miclle/cybertrack/artifact/README.md

# 制作过程与样机展示

33 张照片和 3 段视频，记录零件准备、台架接线、底盘装配、内部布线、头部安装和样机展示。另收录 1 张项目展示封面。最新视频可在 B 站观看，其余两段视频可在本页播放；点击图片可查看原图。

[项目封面](#项目封面) · [视频](#视频) · [零件与台架](#零件与台架) · [底盘装配过程](#底盘装配过程) · [内部布线与头部安装](#内部布线与头部安装) · [样机多角度展示](#样机多角度展示) · [返回项目首页](../README.md)

## 项目封面

CyberTrack 项目展示封面：履带机器人与泡泡

[查看原图](cybertrack-cover.png) · 1365 × 768 PNG

用户于 2026-10-31 提供，用于项目展示与 README 封面；按原文件保存，未裁切或重绘。该图单独作为展示素材，不计入下方 33 张制作照片；实物表现与验证依据见对应照片、视频及[工程记录](../docs/current-status.md)。

## 视频

### 最新样机演示 · 2026-11-01 收录

用户提供的 B 站视频原始文件，仅重命名；文件名中的日期为收录日期。

[在 B 站观看](https://www.bilibili.com/video/BV1BRx466E1b/) · [下载原始视频](cybertrack-prototype-demo-2026-11-01.mp4)

### 样机地面演示 · 6 分钟

样机在地面上的移动、转向与泡泡效果展示，完整时长 6 分 0.6 秒。

https://github.com/user-attachments/assets/127dc3f1-0a8f-4abf-b4e5-f43b6fe16fb7

[下载原始视频](cybertrack-prototype-demo-6min.mp4)

### 面包板与水枪台架 · 16 秒

面包板、供电及水枪支路的台架画面，完整时长 15.7 秒。

https://github.com/user-attachments/assets/1ba10a7c-4fc7-466d-b656-b33c0fb86081

[下载原始视频](breadboard-water-gun-bench-16s.mp4)

## 照片

照片编号是阅读顺序，不代表拍摄时间；原微信文件名中的时间不作为拍摄日期。

### 零件与台架

零件与工具、水枪模块、双电机台架，以及履带框架试装。

<table>
  <tr>
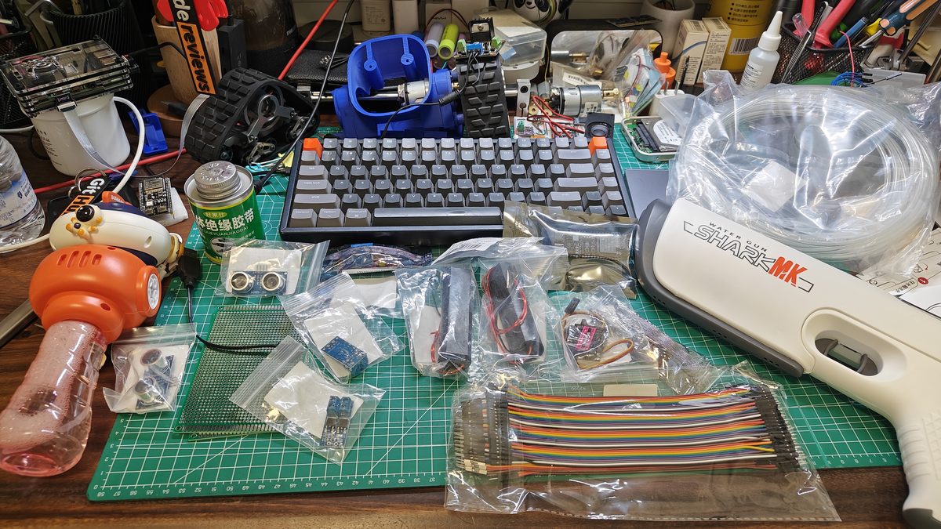
[picture p8: artifact/previews/01-parts-and-tools.jpg]
01 · 零件与工具
    <td width="50%" valign="top"><br>01 · 零件与工具</td>
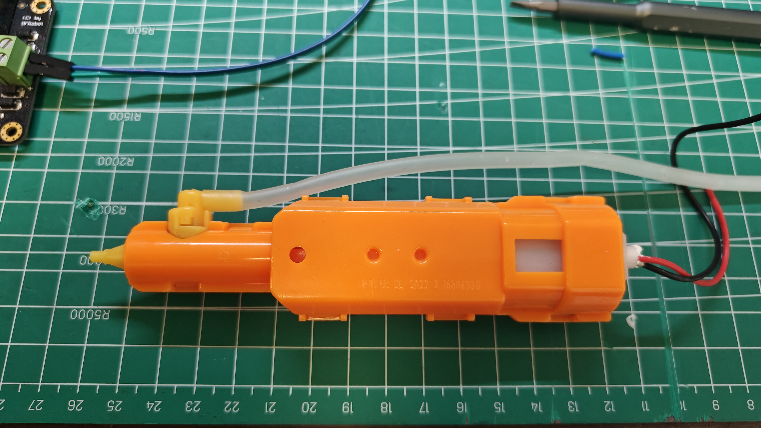
[picture p9: artifact/02-water-gun-module.jpg]
02 · 水枪模块
    <td width="50%" valign="top"><br>02 · 水枪模块</td>
  </tr>
  <tr>
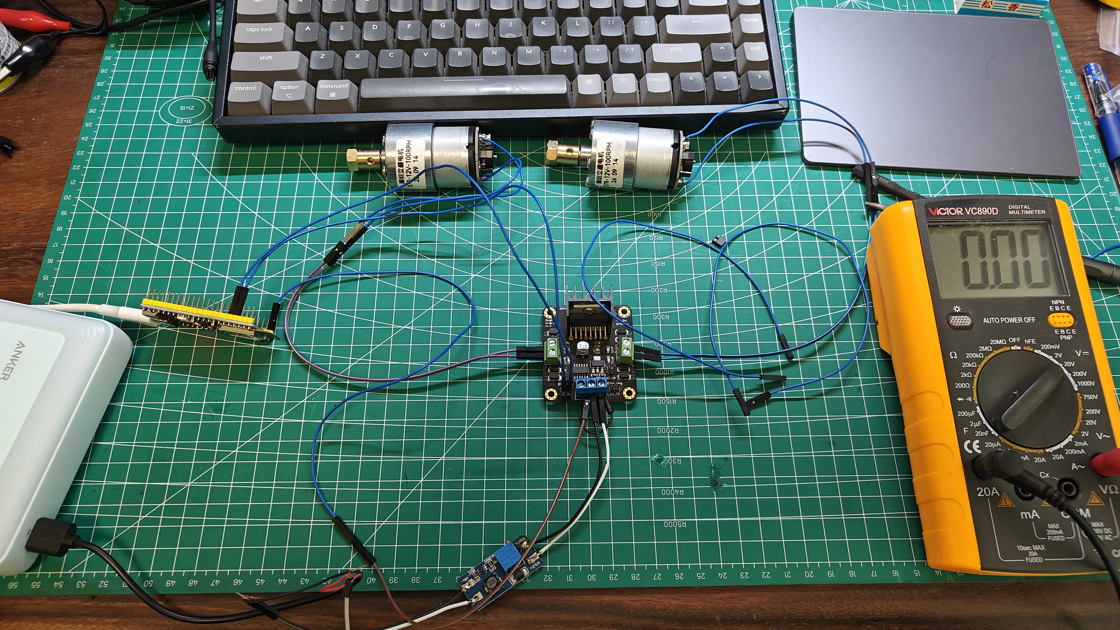
[picture p10: artifact/03-dual-motor-bench.jpg]
03 · 双电机台架接线
    <td width="50%" valign="top"><br>03 · 双电机台架接线</td>
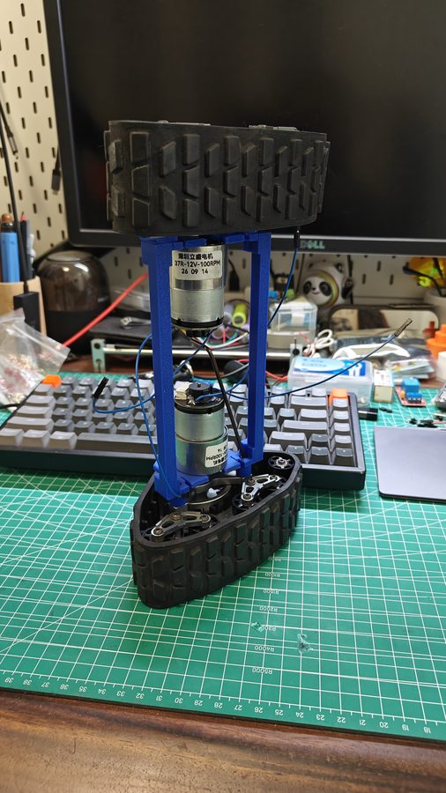
[picture p11: artifact/previews/04-track-frame-upright.jpg]
04 · 履带框架竖放
    <td width="50%" valign="top"><br>04 · 履带框架竖放</td>
  </tr>
  <tr>
    <td width="50%" valign="top"><a href="05-track-frame-top.jpg">05 · 履带与双电机俯视</a><br>05 · 履带与双电机俯视</td>
  </tr>
</table>

### 底盘装配过程

保留不同视角和连续装配步骤，展示底盘内的安装与接线过程。

<table>
  <tr>
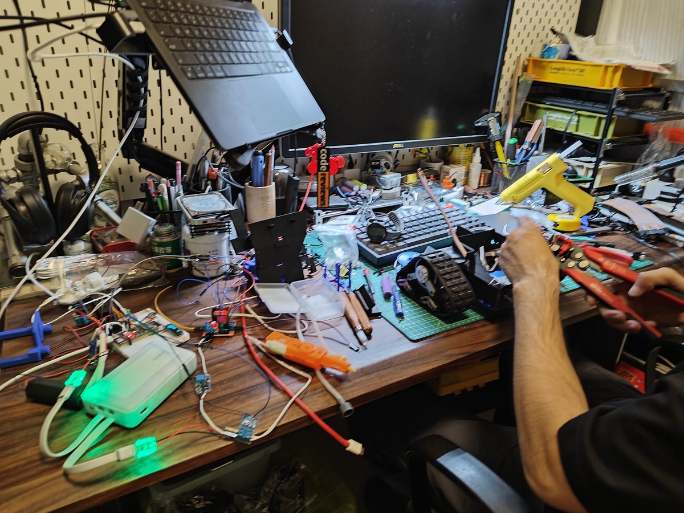
[picture p12: artifact/previews/06-chassis-assembly-01.jpg]
06 · 底盘装配过程 01
    <td width="50%" valign="top"><br>06 · 底盘装配过程 01</td>
    <td width="50%" valign="top"><a href="07-chassis-assembly-02.jpg">07 · 底盘装配过程 02</a><br>07 · 底盘装配过程 02</td>
  </tr>
  <tr>
    <td width="50%" valign="top"><a href="08-chassis-assembly-03.jpg">08 · 底盘装配过程 03</a><br>08 · 底盘装配过程 03</td>
    <td width="50%" valign="top"><a href="09-chassis-assembly-04.jpg">09 · 底盘装配过程 04</a><br>09 · 底盘装配过程 04</td>
  </tr>
  <tr>
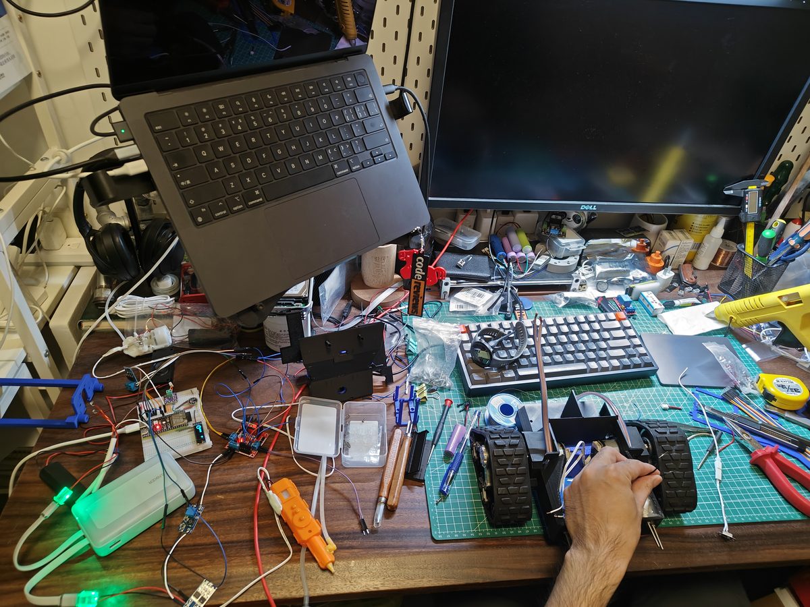
[picture p13: artifact/previews/10-chassis-assembly-05.jpg]
10 · 底盘装配过程 05
    <td width="50%" valign="top"><br>10 · 底盘装配过程 05</td>
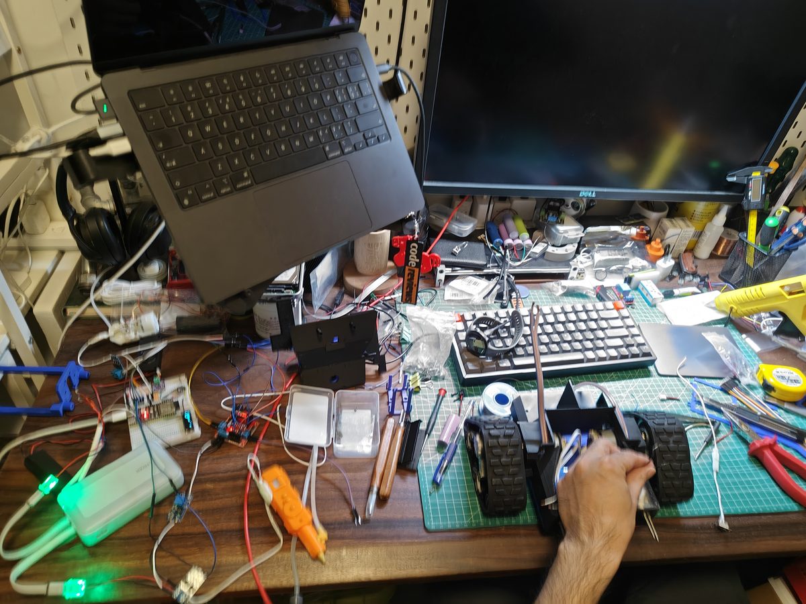
[picture p14: artifact/previews/11-chassis-assembly-06.jpg]
11 · 底盘装配过程 06
    <td width="50%" valign="top"><br>11 · 底盘装配过程 06</td>
  </tr>
  <tr>
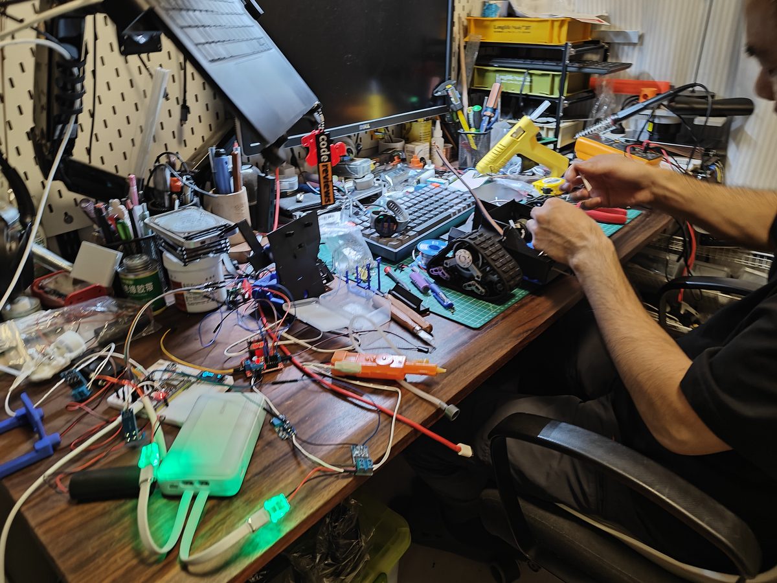
[picture p15: artifact/previews/12-chassis-assembly-07.jpg]
12 · 底盘装配过程 07
    <td width="50%" valign="top"><br>12 · 底盘装配过程 07</td>
    <td width="50%" valign="top"><a href="13-chassis-assembly-08.jpg">13 · 底盘装配过程 08</a><br>13 · 底盘装配过程 08</td>
  </tr>
  <tr>
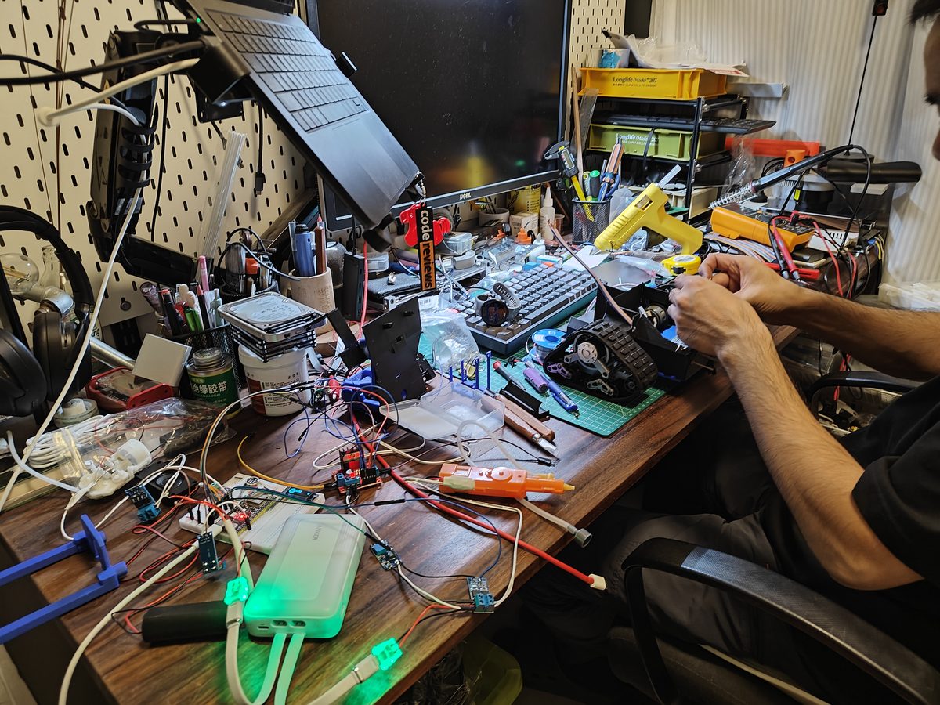
[picture p16: artifact/previews/14-chassis-assembly-09.jpg]
14 · 底盘装配过程 09
    <td width="50%" valign="top"><br>14 · 底盘装配过程 09</td>
    <td width="50%" valign="top"><a href="15-chassis-assembly-10.jpg">15 · 底盘装配过程 10</a><br>15 · 底盘装配过程 10</td>
  </tr>
  <tr>
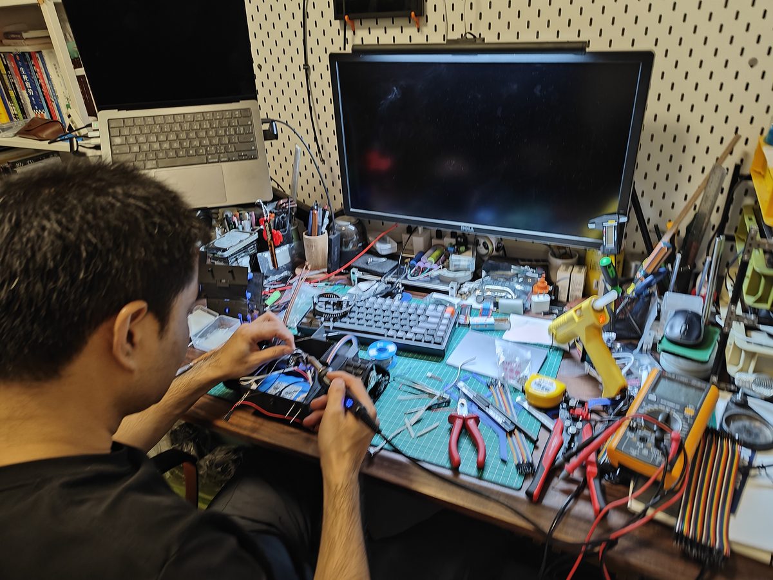
[picture p17: artifact/previews/16-chassis-assembly-11.jpg]
16 · 底盘装配过程 11
    <td width="50%" valign="top"><br>16 · 底盘装配过程 11</td>
    <td width="50%" valign="top"><a href="17-chassis-assembly-12.jpg">17 · 底盘装配过程 12</a><br>17 · 底盘装配过程 12</td>
  </tr>
  <tr>
    <td width="50%" valign="top"><a href="18-chassis-assembly-13.jpg">18 · 底盘装配过程 13</a><br>18 · 底盘装配过程 13</td>
    <td width="50%" valign="top"><a href="19-chassis-assembly-14.jpg">19 · 底盘装配过程 14</a><br>19 · 底盘装配过程 14</td>
  </tr>
  <tr>
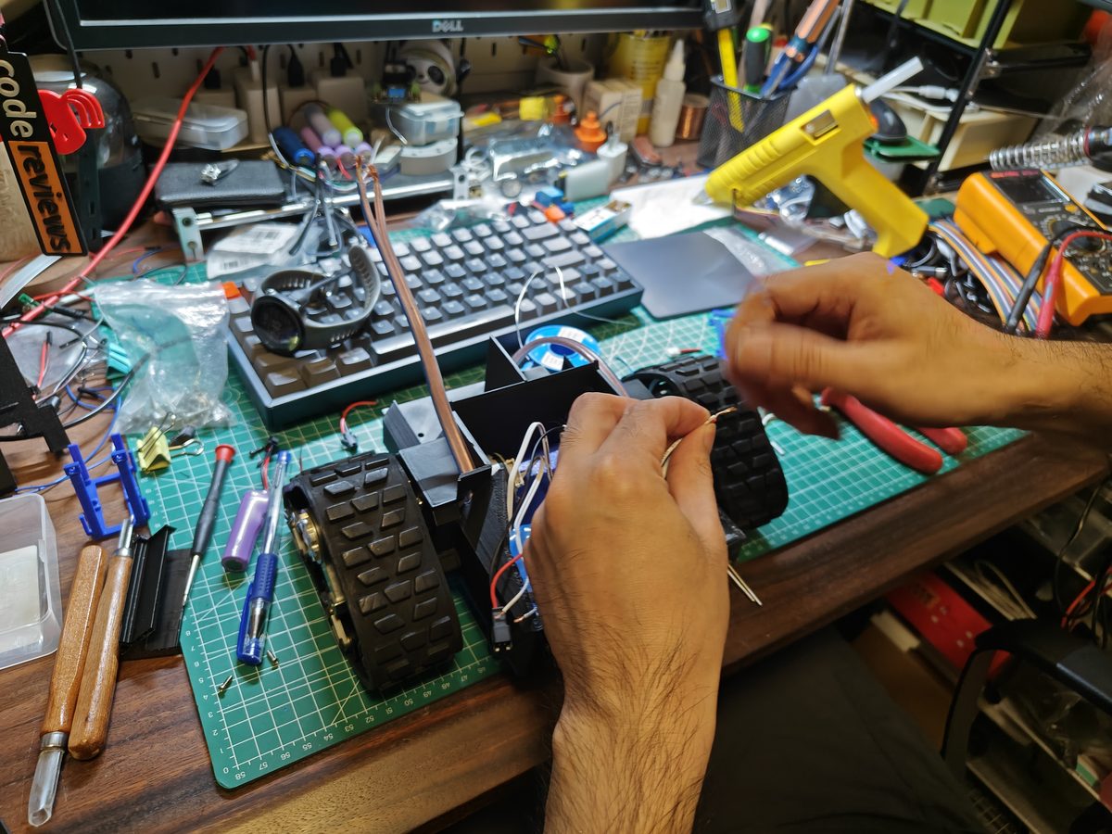
[picture p18: artifact/previews/20-chassis-assembly-15.jpg]
20 · 底盘装配过程 15
    <td width="50%" valign="top"><br>20 · 底盘装配过程 15</td>
    <td width="50%" valign="top"><a href="21-chassis-assembly-16.jpg">21 · 底盘装配过程 16</a><br>21 · 底盘装配过程 16</td>
  </tr>
  <tr>
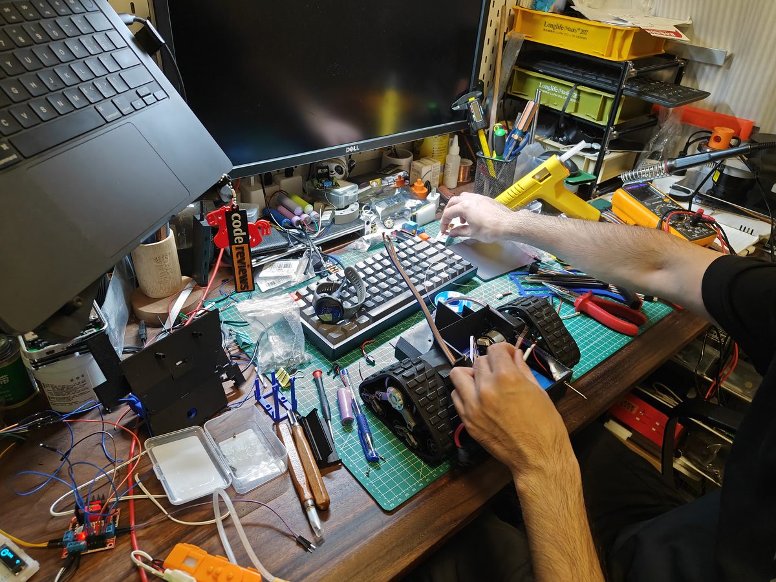
[picture p19: artifact/previews/22-chassis-assembly-17.jpg]
22 · 底盘装配过程 17
    <td width="50%" valign="top"><br>22 · 底盘装配过程 17</td>
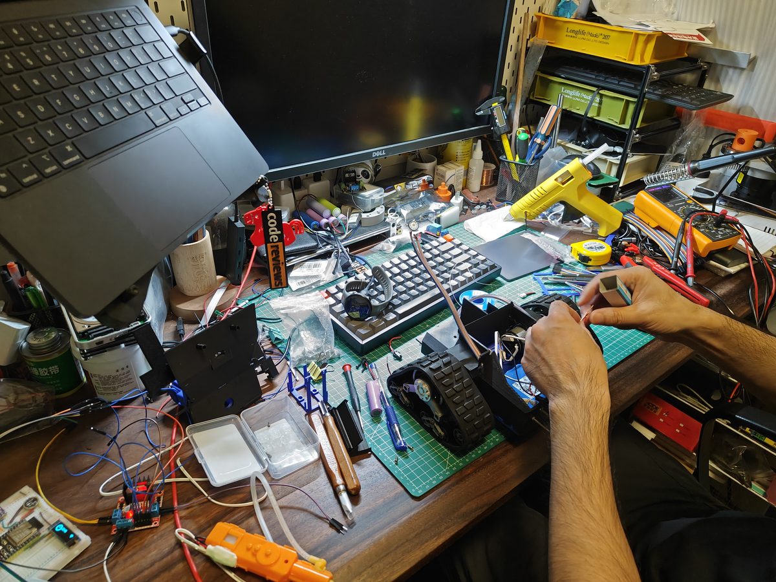
[picture p20: artifact/previews/23-chassis-assembly-18.jpg]
23 · 底盘装配过程 18
    <td width="50%" valign="top"><br>23 · 底盘装配过程 18</td>
  </tr>
</table>

### 内部布线与头部安装

底盘内部布线特写，以及头部面包板与扬声器的安装位置。

<table>
  <tr>
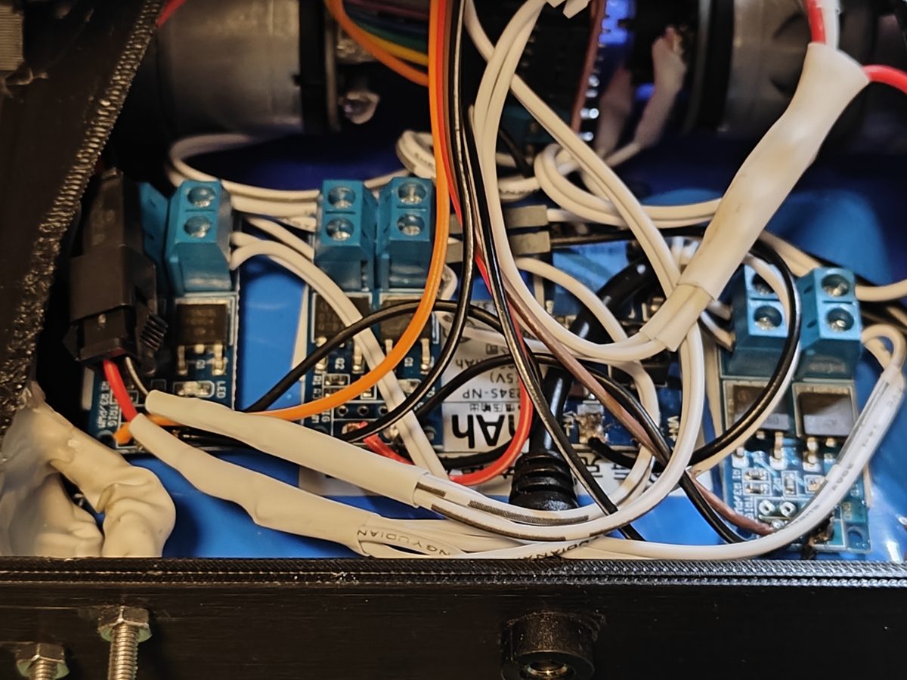
[picture p21: artifact/previews/24-chassis-wiring-detail.jpg]
24 · 底盘内部接线特写
    <td width="50%" valign="top"><br>24 · 底盘内部接线特写</td>
    <td width="50%" valign="top"><a href="25-chassis-wiring-overview.jpg">25 · 底盘内部接线全貌</a><br>25 · 底盘内部接线全貌</td>
  </tr>
  <tr>
    <td width="50%" valign="top"><a href="26-head-breadboard-installation.jpg">26 · 头部面包板与扬声器安装</a><br>26 · 头部面包板与扬声器安装</td>
  </tr>
</table>

### 样机多角度展示

工作台与地面上的样机，从正面、两侧、背面和前上方观察整体布局。

<table>
  <tr>
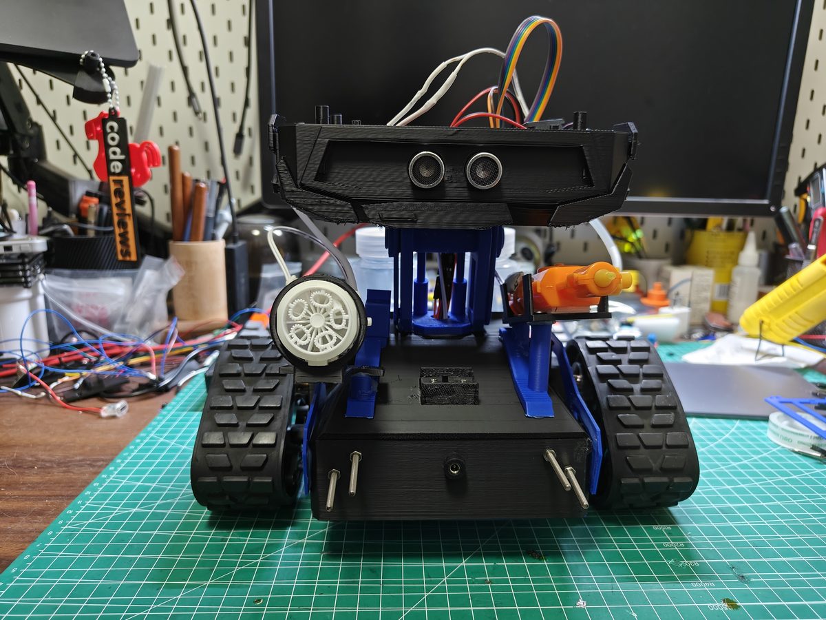
[picture p22: artifact/previews/27-prototype-front-workbench.jpg]
27 · 工作台样机正面
    <td width="50%" valign="top"><br>27 · 工作台样机正面</td>
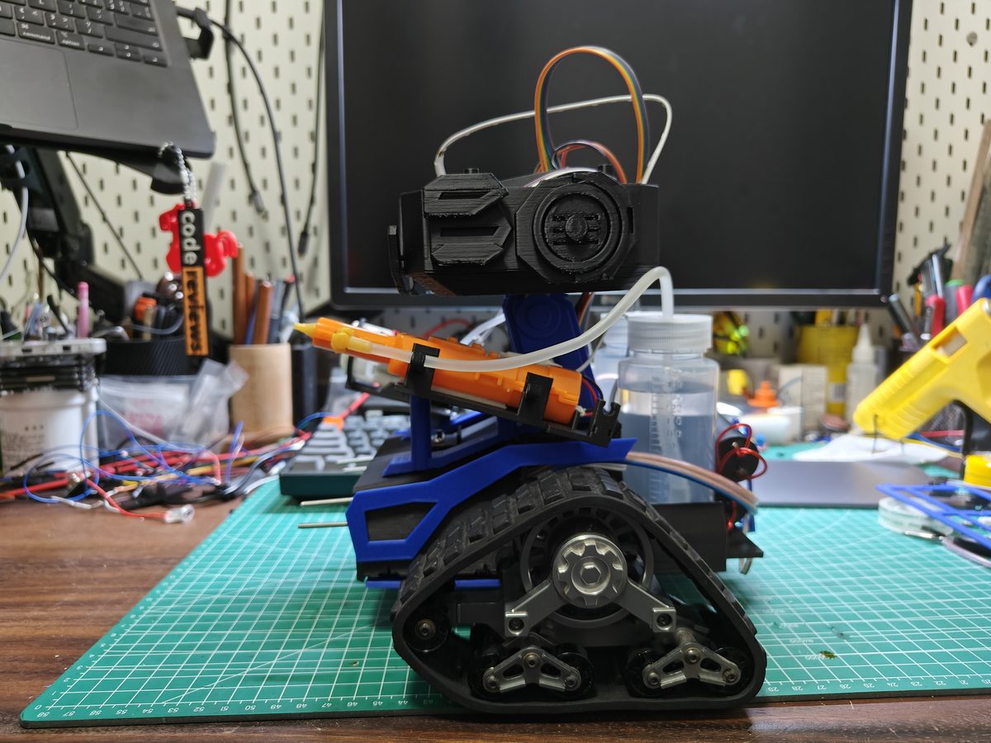
[picture p23: artifact/previews/28-prototype-water-gun-side.jpg]
28 · 样机水枪侧面
    <td width="50%" valign="top"><br>28 · 样机水枪侧面</td>
  </tr>
  <tr>
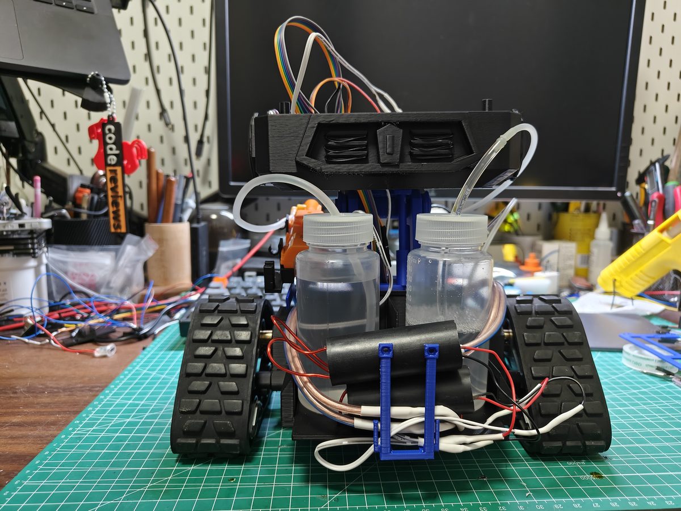
[picture p24: artifact/previews/29-prototype-rear-reservoirs.jpg]
29 · 样机后部双液体瓶
    <td width="50%" valign="top"><br>29 · 样机后部双液体瓶</td>
    <td width="50%" valign="top"><a href="30-prototype-bubble-gun-side.jpg">30 · 样机泡泡枪侧面</a><br>30 · 样机泡泡枪侧面</td>
  </tr>
  <tr>
    <td width="50%" valign="top"><a href="31-prototype-front-floor.jpg">31 · 地面样机正面</a><br>31 · 地面样机正面</td>
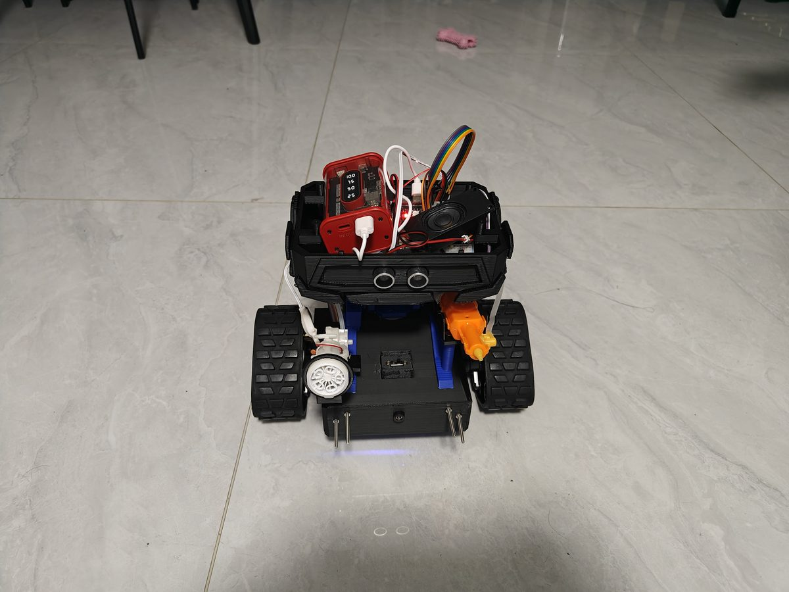
[picture p25: artifact/previews/32-prototype-front-high-angle.jpg]
32 · 地面样机前上方视角
    <td width="50%" valign="top"><br>32 · 地面样机前上方视角</td>
  </tr>
  <tr>
    <td width="50%" valign="top"><a href="33-prototype-rear-floor.jpg">33 · 地面样机背面</a><br>33 · 地面样机背面</td>
  </tr>
</table>

## 原始文件与展示副本

照片和三段原始视频内容保持不变。[素材清单](media-manifest.json)保留原文件名、新文件名、画面说明、字节数和 SHA-256，可回溯并校验文件。

页面使用 `previews/` 中的轻量 JPEG 预览图，按原比例缩至不超过 1200 × 900 像素，不裁切画面；点击预览图可打开原图。

两段播放器均使用 GitHub 附件，保持完整时长与音轨。长视频副本保留原 H.264 / AAC 流，不重新编码，只将 MP4 索引前置并将 H.264 level 标记从 6.0 修正为 3.1。短视频副本将 HEVC 转为 H.264，保留 1280 × 720 分辨率、30 fps 与原 AAC 音轨，并将 MP4 索引前置，以改善浏览器播放兼容性。

影像展示制作过程与当时样机表现；画面不能确定具体固件版本、供电配置、电流、温升或停止时延，不替代[项目验证记录](../docs/verification-plan.md)。
