miclle/cybertrack/firmware/README.md

# 固件

更新：2026-11-01。当前处于样机联调与整机验证阶段；面包板最新记录部署为 **`2.0.3-ct73`**，源码与应用版本一致。[ct73 部署记录](esp32-audio/startup-ct73.json)核对仅应用写入、配置保持、两次启动联网与输出全关，未启动执行器；真人语音、实际动作和整机负载待验。历史 ct21 的四方向反馈继续保留，不代替本轮验收。

当前面包板支持网页与语音控制、行走／喷水／泡泡／点火低压 MOS 四路独立控制、组合动作及狂暴模式；网页冲突优先，BOOT 与全部停止关断各路。电机为 60–100% PWM、默认 100%，左右桥映射为 B／左、A／右。功能与部署见[面包板工程](esp32-audio/README.md)、[局域网控制](../docs/lan-control.md)和[效果控制](../docs/effects-control.md)。逻辑状态不是执行器反馈；低压控制实现不代表高压、绝缘、液体共存或 EMC 验收。

当前功能、工程差异、模块职责、MCP 工具的入参／出参／错误、内部 C API 与板级回调见[固件能力与接口手册](CAPABILITIES.md)。使用时须核对具体工程与版本：当前面包板、历史独立台架与通用控制核心的同名工具、GPIO 和授权规则不能混用。

## 部署、台架与样机证据

| 范围 | 已有记录 | 尚未验证的边界 |
|---|---|---|
| 历史单模块与 ct2–ct6 台架 | 独立电机空载、MOS 五秒喷水；面包板语音状态／停止、喷水、四方向空载及 BOOT 停止，详见下文历史记录 | 旧版本、旧接线和旧电源结果不能直接作为当前整机验收；电流、定量温升、带载停止和失效行为仍需实测 |
| ct7 历史并发台架 | 行走与喷水组合及分开下令、两种独立截止顺序、BOOT 全停与语音停止均有回执和现场反馈，见[并发记录](../docs/validation/bench.md) | 断网现场测试延期；回执中的软件时长不等于实物停止时延，也不证明当前四路组合负载通过 |
| ct13–ct21 功能演进与部署 | 后续加入泡泡／点火、长按、狂暴模式；ct20 提高 PWM，ct21 修正左右桥映射。最新[软件检查](esp32-audio/verification-ct21.json)与[部署记录](esp32-audio/startup-ct21.json)分别保存 | 历史无负载或 HTTP 检查不能替代新占空比的速度、电流、温升及整机故障验证 |
| 当前样机运行 | 已有制作过程、样机实拍和约六分钟落地行走、转向、泡泡展示，另有喷水台架短片，见[影像记录](../artifact/README.md)；ct21 四方向正常另有用户反馈 | 视频未绑定完整固件／电源配置，不能据此确认全部验收项；机械停止距离、完整供电、连续运行、语音噪声及故障矩阵仍开放 |

当前电源基线为辰克 5 V 电池包及 12 V 升压电机支路，历史充电宝的电压／功率观察不沿用为新电源通过。2026-10-27 角色别名、纠错与静默执行规则已更新，真实语音回归仍待完成，见[角色维护与回归](../docs/agent-role.md)。分项证据与整机退出条件统一见[验证计划](../docs/verification-plan.md)。

## 工程范围与历史台架

以下通用核心及无负载工程独立维护；面包板已部署能力不代表通用核心的完整认证、持久化与板级适配已完成。

固件可与机械设计并行推进。当前已实现可在电脑上编译的 C11 控制核心、F1 离线 MCP 协议适配，以及 F2a 与板型无关的启动／运行层、输入处理、有界接收队列、分片／连接流程模拟和假板卡测试，已新增可烧录的[ESP32-S3 无负载检查工程](esp32/README.md)，复用控制核心验证启动与 PSRAM，并接入板载 BOOT 的无负载停止输入；该无负载工程不控制执行器；另见下文独立 MOS 台架的水枪单次实测。独立路线和退出条件见[实施计划](PLAN.md)，消息边界见[协议契约](PROTOCOL.md)，F2b 所需输入见[开发板资料清单](BOARD-INFO.md)。

无负载检查工程固定 ESP-IDF v5.5.1，主控已指定 ESP32-S3 N16R8，见[采购记录 P07](../hardware/procurement.md)。[COREBOARD 原理图、排针和尺寸](../hardware/components/ESP32-S3-N16R8/README.md)已整理；该无负载工程的实物修订版、焊装及后续完整板级适配仍待核对；面包板音频与执行器 GPIO 已在独立工程配置，不能照搬到本工程。Flash／PSRAM 已识别为 16 MB／8 MB，无负载配置为 Flash DIO 40 MHz、PSRAM Octal 40 MHz；具体实测结果见[实物核对](../hardware/components/ESP32-S3-N16R8/physical-verification.md)。

**历史台架（2026-10-25）**：[L298N 电机台架](esp32-motor-bench/README.md)升级为 `0.3.2-l298n-dual-10s`：A 路 GPIO4／5／6→ENA／IN1／IN2，B 路 GPIO7／8／9→ENB／IN3／IN4。`1`／`2`／`3` 选择 A／B／AB 后另发 a 和 f／r（AB 另支持 x／y 两种反向组合）；约 60% PWM，每次 10 秒，组间至少停 3 秒，s／BOOT 或任一路故障关闭两路；重启默认未选择。双路软件测试／编译通过，B 路接线及六脚静态关闭已获用户确认，此前 0.3.1 的 3 秒版 8 组空载组合已获用户确认：单路互不干扰、方向符合预期、正常停止且无异响或异常发热；随后一次双路 BOOT 提前停止及松开不恢复也获用户确认。0.2.1 两次 40%／10 秒反转均正常停止，第二次用户读到母线启动和运行约 12 V，见[40% 反转记录](esp32-motor-bench/reverse-40pct-verification.json)。60%／10 秒反转已获用户确认：启动和运行母线约 12 V，转动比 40% 更快、更顺畅，正常停止，无异响、异常发热或重启，见[60% 记录](esp32-motor-bench/reverse-60pct-verification.json)。电流／定量温升、扭矩及机械带载停止未验收。 用户已确认双路 60%／10 秒空载正转正常启停，启动、运行中及临近停止母线均约 12 V，电机和 L298N 无明显发热、无异响或其他异常；这是万用表读数与主观发热观察，电流和定量温升仍未测。

**历史台架（2026-10-24）**：新增[独立 MOS 台架工程](esp32-mos-bench/README.md)：GPIO4 持续高电平单次 5 秒（0.1.1，用户要求延长），串口 a／g 触发、s／BOOT 停止；主机策略测试和 ESP-IDF 编译通过，已烧录并在引脚空接下取得一次命令及关闭回执。与电机工程互斥使用 GPIO4；用户已观察控制端 0 V→约 3 点几伏→0 V，并确认一次 5 秒正常喷水及自动停止。带载参数、重复性与失电／复位边界仍待验证。

## 本地编译与验证

要求 C11 编译器、CMake ≥3.16，运行测试另需 Python ≥3.9。JSON 解析器已随源码固定版本保存，构建无需联网或硬件。在仓库根目录执行：

```sh
cmake -S firmware -B build/firmware-host -DCMAKE_BUILD_TYPE=Debug
cmake --build build/firmware-host
ctest --test-dir build/firmware-host --output-on-failure
```

Clang／GCC 可在首次配置时加 `-DCMAKE_C_FLAGS='-fsanitize=address,undefined -fno-omit-frame-pointer'`。构建输出位于已忽略的 `build/`；测试使用虚拟时间，不等待真实动作时长。测试记录见[主机验证](tests/README.md)。仅编译 C 库时使用 `-DBUILD_TESTING=OFF`，无需 Python。

## 通用控制核心已实现的边界

本节描述 `src/` 的通用核心。单活动槽位与本地使能契约不用于概括当前面包板的四路并行行为。

- `include/cybertrack/control.h` 与 `src/control.c`：`BOOT → DISARMED → READY → ACTIVE`，停止／故障进入锁定状态；上电无输出，本地使能后才能提交动作。
- 行走、水枪、泡泡共用一个活动槽位，不排队、不组合；本地期限到达时撤销逻辑输出。停止幂等；松开停止或故障消失都不会自行恢复动作。
- 会话断开／替换撤销使能；活动中断线锁定故障。校验动作类型、方向、速度档、时长、会话、序号、开始执行期限及计时溢出；时钟回退撤销输出。
- 限制值为零即能力不可用。测试数值仅为合成用例，不是台架建议值，也不构成可用的硬件配置。
- `include/cybertrack/protocol.h` 与 `src/protocol.c`：MCP 封装、初始化／发现／调用、严格 JSON 参数校验、有界原响应缓存、模拟传输会话与新鲜度门槛。停止优先于缓存及动作时效检查；远程接口不能使能。新解析与缓存重读内存失败会撤销逻辑输出、保留原缓存并要求本地重新使能，已通过逐次分配失败注入。
- `include/cybertrack/runtime.h` 与 `src/runtime.c`：启动先关断、单轮本地事件优先、周期时限与输出应用、条件喂狗、运行层错误锁定及响应抑制。板级回调契约与尚未验证项见[运行层](RUNTIME.md)；没有默认板型实现。

- `inputs.h`／`inputs.c`：逻辑输入去抖、停止／故障立即断言与已观察脉冲锁存；`inbox.h`／`inbox.c`：4 槽消息副本、原始元数据保持、断线优先及溢出关闭。详见[运行层契约](RUNTIME.md)。

- `link.h`／`link.c`：两层分片、连接与握手完成门槛、接收／发送超时、退避重连、发送失败关闭。通过假传输连接实际运行层，契约见[接收边界与连接流程](TRANSPORT.md)。

核心产生逻辑目标，独立协议层负责 JSON 解析，运行层通过板级回调应用目标；无负载检查工程已使用 ESP-IDF 时钟和 FreeRTOS 调度运行控制核心；该无负载工程仅 GPIO0 用作临时停止输入；通用核心的完整运行层、执行器 GPIO／PWM、网络鉴权尚未移植。左右轨道正值均表示车体向前，左转暂定左右反向原地转向；这是通用核心待板级验证的控制策略。通用核心速度档与实际 PWM、速度没有预设换算；面包板 ct21 的映射与四方向反馈见上文。

## 适配层必须遵守的接口契约

以下为通用核心的接入契约，真实认证与持久化后端仍待完成；面包板适配层的当前行为及限制见其工程文档。

1. 控制器由单一任务串行拥有；API 要求有效控制器指针，`ct_submit` 对空请求返回错误。中断和网络回调只投递事件；本地停止／故障事件先于正常动作处理，不能积压在音频或请求队列后面。硬件切断独立有效。
2. 使用本地单调毫秒时钟调用 `ct_tick`，每轮处理事件后应用当前输出；正常完成必须有周期调度，核心本身不创建定时器。最大调度间隔、输出写入耗时、任务卡死及看门狗行为在板级阶段验证，主机测试不能证明 ≤100 ms 停止延迟。
3. 自检成功后调用 `ct_boot_complete`。`ct_local_enable` 仅来自本地明确事件；物理停止持续按下或故障仍存在时禁止恢复。网络禁止调用使能 API。驱动输出失败应调用 `ct_set_fault` 并执行板级关断。
4. `session=0` 表示无连接。使用 `ct_protocol_open` 分配连接代次，`ct_protocol_close` 处理断线；切换时丢弃旧队列，不得把旧请求重新标记为新会话。离线测试可使用合成会话，不能因此放开真实设备。
5. `sequence` 为适配层分配的会话内严格递增序号，不等同于 JSON-RPC ID。F1 已按会话／ID 缓存原响应，重传不会再次提交核心；16 槽响应按 FIFO 淘汰，启动期过滤器跨重连保留，已淘汰／已记录的动作 ID 拒绝，停止仍有效。过滤器可能误拒绝新动作，不能通过清空记录恢复旧命令。跨复位接入必须在首个 CONNECT 前绑定[持久化存储](PERSISTENCE.md)，通过 logged 入口核验独立锚点和恢复日志，先保存 ID／会话、日志与锚点再使用；失败锁定动作，复位不恢复使能或输出。核心独立保留 `CT_REPLAY` 防线。只读／停止不再增加永久位；纯只读 ID 淘汰后可用于新意图。已有历史不可清位，离线迁移只向空白目标完整复制，见[容量策略](CAPACITY.md)；独立锚点控制后端原子切换并拒绝旧版本，见[切换契约](ATOMIC-SWITCH.md)。
6. `expires_at_ms` 来自设备预先签发的窗口时间加 `max_queue_ms`；等于当前时间即过期，首次接收、出队或重试不得刷新。窗口同时绑定原始会话和使能代次，稳定意图 ID 独立于 JSON-RPC ID 并在动作前持久化，换 RPC ID 不能重放。`ct_action_proof` 默认全零；正式认证证据源尚未接入，该核心的真实动作不得开放。动作结束期限独立为接受时间加 `duration_ms`。见[新鲜度与意图契约](FRESHNESS.md)。
7. JSON 类型和数值已在协议层先校验后转换，额外字段拒绝。通用接收队列已实现；独立状态／停止工程已接入 WSS 和平台令牌，动作认证新鲜度及完整硬件凭据保护仍待实现。接入必须遵守[协议契约](PROTOCOL.md)，不能从 JSON 接收可信元数据。
8. 使用运行层时，通过 `ct_runtime_step` 串行传递连接、断线、消息或空闲事件，不绕过运行层直接改动控制器／协议。只有该轮返回 true 后才能发送响应；返回 false 表示运行层已锁定，需处理故障并重新启动。看门狗和物理切断不能由本轮回调成功替代验收。

后续板级工程记录构建环境、依赖版本、板型、电源与引脚映射、编译／烧录／恢复命令。模块职责见[架构](../docs/architecture.md)，平台工具边界见[灵矽接入方案](../docs/architecture.md)。面包板已实现经授权的点火低压 MOS 控制；高压接线、通电及安全验收不由这些软件记录覆盖，边界见[效果控制](../docs/effects-control.md)。

通用核心尚缺的板级输入补齐期间，可按[离线工作清单](PLAN.md#不依赖实物的后续工作)继续推进。解析资源故障、接收边界／连接模拟和长时会话压力验证已完成。跨复位持久化接口与掉电模拟也已完成；命令新鲜度窗口及跨会话意图策略已完成离线测试；独立锚点、原子后端切换与回滚拒绝已完成主机模拟；[本地维护恢复](RECOVERY.md)可转移锚点对应的完整历史，当前快照缺失时可用[独立日志](RECOVERY-LOG.md)恢复精确匹配锚点的完整历史，领取尝试前的过渡日志使候选准备期间也保持恢复证据；首次登记、带日志切换及日志恢复先写目标证据再选择，尚未打开会话或写首份过渡记录时也可恢复，无完整证据时继续锁定；新增[四槽日志冗余](REDUNDANCY.md)，以双份精确证据覆盖单槽损坏及轮换中断，冲突或无当前证据仍锁定；后续接入服务端认证与稳定意图映射、真实存储与锚点驱动及升级迁移契约；音频／升级故障模型按输入条件推进。

## 历史记录：灵矽联网与面包板 ct2–ct5

2026-10-24 新增[独立 ESP-IDF 联网工程](esp32-linx/README.md)，完成设备绑定、WSS／MCP 发现及状态／停止真实调用；[实测记录](../docs/validation/bench.md)包含回执和证据边界。0.1.0 阶段没有动作或音频能力，原 MOS 台架工程单独保留。0.2.0 新增独立的本机单次授权水枪通道，正式核心动作仍关闭；已完成 5 秒自动停止、BOOT 提前停止及松开不恢复的带载功能检查，未开放自主动作或音频。

面包板的[适配层](esp32-audio/README.md)保留“小D”的原语音、OLED 与绑定。ct2 状态／停止语音联调已通过；ct4 增加 GPIO18 五秒输出并取消逐次按键授权，BOOT 仅停止。功率断开信号检查与带载结果分开，此前未喷水已定位为控制端两线接反，用户纠正后反馈测试正常；带载 BOOT 提前停止及松开不恢复已获用户确认，见[面包板喷水记录](../docs/validation/bench.md)。

2026-10-24 后续时长调整：面包板 ct5 改为按用户指定时长执行，单次最多 30 秒，保留 BOOT／语音停止及断线关断；明确要求喷水但未指定时长时默认一次 1 秒，不循环补足超限请求。此调整仅适用于面包板，原固定五秒台架结果保留为历史证据；ct5 语音验证及 30 秒带载边界见[喷水记录](../docs/validation/bench.md)。

## 历史记录：面包板 ct6 集成

ct6 新增 L298N 双路四方向、1–3000 ms 限时／约 60% PWM，与原 GPIO18 水枪互斥；BOOT、停止与断线统一关闭。同板部署迁线及该阶段基本台架联调已完成，四方向空载、实喷启停与 BOOT 停止有该次现场和回执证据；双路通电分别动作无误动观察，收尾功率已断开。当时断网延期，反向互斥、故障边界、定量电气及整机带载尚未验收，见[接线与验证](../docs/validation/bench.md)。

ct6 的跨动作互斥已由 ct7 并行策略替代，约 60% PWM 已由 ct20 提高到约 80%；ct21 已取得装车后四方向正常的用户反馈。上述 ct6 待办属于历史快照，现行未验证项以上文及整体验证计划为准。
