miclle/cybertrack/firmware/esp32-audio/README.md

# CyberTrack 面包板：小D 语音与四路控制

**ct78 应用已部署：已移除泡泡剧场的草稿、编辑、确认、模板、离线排演与 compose 工具。** 语音组合动作、序列调度与停止保护保留。2026-11-03 已[仅应用烧录并核验](../../docs/validation/ct78-deployment.md)，线上角色未同步；下方旧版本段落保留当时证据，不代表现行接口。[本次验证](../../docs/validation/theatre-removal.md)

ct73 候选扩展四路组合／序列及既有别名的成功确认匹配，保留点火超限提示；十二条定向实际 STT 严格 10/12，五条成功组合新增抑制 277 包。70／87 原生夹具、18 组软件检查与完整构建通过，未部署。[范围与失败](../../docs/validation/four-lane-feedback.md)

ct72 候选补齐既有喷水／泡泡／点火别名及狂暴模式的成功确认播放，按通道独立时长核验；复用 88 条真实 STT 轨迹，仅新增抑制普通点火的 64 包，超限提示保留。未部署，规则分析播报仍待修。[范围与证据](../../docs/validation/effect-alias-feedback.md)

ct71 候选增加完整否定句写入拒绝和空闲草稿保护；活动／等待时始终保留全停，修正了按当前文本挡住迟到停止的初版。46 组普通／消毒器、24 次实际 STT 与最终兼容重放、十七组软件检查及构建完成，未部署。[边界与证据](../../docs/validation/negative-input-admission.md)

ct70 候选独立修复机器人 MCP 原始零字符截断，保留十二项工具、字符串步骤、角色及合法停止。16 组准入普通／消毒器回放、88 条历史请求兼容、十六组软件检查和完整构建通过；未部署。[范围与证据](../../docs/validation/mcp-raw-json.md)

ct68 候选增加基于本轮 STT 的泛化动作澄清门禁，拒绝可识别的首次猜测执行，保留草稿编排、查询、全停和可信网页；继续包含 ct67 相对改稿约束。公开工具与角色未改，未部署。[范围和验证](../../docs/validation/vague-action-admission.md)

ct66 候选同步完成 MCP 全停与回执，不留二次排队回调；分配回执失败时仍先关闭输出。公开工具与角色未改，最近部署仍是 ct45。[调度与验证](../../docs/validation/stop-dispatch.md)

ct63 候选扩展普通组合／序列及目标速度的成功确认播放匹配，只有完整原话、参数和成功回执一致才抑制音频。已有 STT 事件回放抑制 216 个新增确认包、保留 397 个状态／否定／澄清包；未部署。[验证与范围](../../docs/validation/plan-feedback.md)

ct62 候选按识别输入代际阻止失败后的自动动作重试／补做，停止与查询保留，新输入恢复；已完成构建与主机回放，未部署。[验证与边界](../../docs/validation/voice-input-guard.md)

ct46 增加短指令成功播报控制、设备状态解释和改稿前读版本检查。[构建与软件证据](verification-ct46.json) · [隔离平台验收](../../docs/validation/lingxi-ct46.md)

**2026-11-01 ct77 已部署：** [普通测距滴声连续确认](../../docs/validation/range-beep-confirmation.md)要求连续三个有效近距样本，过滤孤立／双样本跳值；停车仍立即响应，对话暂缓保留。已仅应用部署，用户已确认偶发滴声明显减少、效果可以。

**2026-11-01 ct75 已部署：** HTTP 控制在 cJSON 解析前复用原始零字符检查，补齐 Unicode 零转义截断缺口。旧版反例、实际 HTTP 原生回归与完整构建已留证；已完成[仅应用部署与无动作 HTTP 检查](../../docs/validation/ct75-deployment.md)，Wi-Fi／用户设置保持，PHY 校准及连接令牌变化单独记录；不修改语音或动作策略。见[校验说明](../../docs/validation/http-zero-admission.md)。

**2026-11-01 ct74 已部署：** 用户选择对话期间暂缓普通滴声、结束按实时距离恢复。普通提示改用独立 PCM、空闲入队与对话／语音包到来时取消，不清空或拒收云端语音；紧急停车告警仍优先。完整构建与音频原生通过；[仅应用部署](../../docs/validation/ct74-deployment.md)、ct73 回退核对、配置保持、两次启动与二十条零输出检查通过，现场听感和偶发滴声另验；见[策略与证据](../../docs/validation/dialogue-range-beeps.md)。

**2026-11-01 ct73 已部署：** 在用户切断执行器功率后仅写 `0x20000` 应用，保存经设备校验的 ct45 回退文件与配置备份；写入前后配置及非应用区校验通过，首启 NVS 仅 WebSocket token 更新，两个已存网络与用户配置保持。两次启动版本／联网、网页全文一致及二十条状态回读通过，零动作；全片读取超时不算完整备份。角色只读核对一致且未修改，实机带载和真人语音待验。见[部署记录](startup-ct73.json)和[验收入口](../../docs/validation/ct73-deployment.md)。

**ct43 历史引入、已随 ct45 部署：** 新增家长上手帮助与只读状态解释，保存最近一次适配器动作回执供网页和语音查询。不会新增启动或自动重试。线上回复另行验证，详见[功能与边界](../../docs/status-explanation.md)和[验证记录](verification-ct43.json)。

**2026-10-30 ct42 已部署：** 距离滴声只取决于新鲜有效距离，不受自动避障开关、前进锁定或行走状态影响；待机、后退和转向也会提示。40–50 cm（不含 50）每 800 ms 一声，小于 40 cm 每 400 ms 一声；至少 50 cm、无效或过期读数安静。自动避障仍默认关闭，只控制小于 15 cm 停前进／至少 20 cm 解锁。 已仅应用烧录、平台 5999 字符保存回读并重启联网；两组 Wi-Fi 和用户配置保持，启动仅刷新 WebSocket 会话令牌。两次开机均默认关闭，HTTP 开关两态通过；18 次有效测距、零驱动失败、零执行器启动，启动日志记录 2 次滴声播放事件。见[验证](verification-ct42.json)和[部署记录](startup-ct42.json)；实际听感、对话并发及停车距离分别验证。

**2026-10-30 ct41 已部署：** 网页新增默认关闭的“自动避障”开关，设备端状态 `proximity.auto_avoidance_enabled` 同时作用于网页、语音单项／组合及序列。仅开启时有效距离小于 15 cm 停止并锁定前进，至少 20 cm 解锁；关闭清除距离锁定但不恢复旧动作。测距和前进滴声保留。设置只保留本次开机，网页重连不重置，重启恢复关闭；本轮已仅应用烧录、平台保存回读并重启联网；两组 Wi-Fi 和用户配置保持，启动时仅 WebSocket 会话令牌刷新。 验证见[ct41 记录](verification-ct41.json)。

ct40 已完成完整编译和仅应用烧录：OLED 待机底行显示当前 `IPv4:8080`，对话结束后恢复；断网清除旧地址，重新联网更新。48 个锁定组件缓存已恢复并核验原哈希，选定 OLED 构建使用其中 47 个（排除仅供其他开发板使用的 image_player），ESP-IDF 为 v5.5.1。应用及非应用区域校验通过，首次启动后 61 条 NVS 记录、两组 Wi-Fi 和整个应用前区域逐字节保持。用户确认手机已能打开控制页面、屏幕 IP 显示正常，测试符合预期。此前网络不可用时进入配网模式，配置回读仍未变化；用户恢复原网络后重启，首次认证超时后自动重试连接第一组并进入正常待机，串口记录零启动／输出全关。语音结束后的地址恢复和反复重连稳定性待验证，见[验证](verification-ct40.json)和[部署记录](startup-ct40.json)。

ct39 已部署：100% 速度下未指定时长的左右转默认改为 880 ms，单项、组合和序列一致；指定／共享时长优先。平台保存回读、应用哈希、配置区保持和重启联网检查通过，启动数为 0；用户随后确认“880 ms 测试效果符合预期”，精确计时与完整语音回归仍待验证。见[验证](verification-ct39.json)和[部署记录](startup-ct39.json)。下方 ct38 的 900 ms 为历史记录。

ct38 已部署：100% 速度下未指定时长的左右转默认改为 900 ms，单项、组合和序列一致；指定／共享时长优先。平台保存回读、应用哈希、配置区保持和重启联网检查通过，启动数为 0；真人语音及实物转向计时待测。见[验证](verification-ct38.json)和[部署记录](startup-ct38.json)。下方 ct37 的 800 ms 为历史记录。

ct37 已部署：语音 100% 速度（含省略速度）的左右转，未指定时长时默认 800 ms，适用于单项、组合及序列每步；明确指定／共享时长优先。平台角色保存回读一致，仅应用烧录、配置区保持并重启联网；11 次状态回读输出全关、启动数 0。真人语音及实物转向计时待验证，见[构建验证](verification-ct37.json)和[部署记录](startup-ct37.json)。

ct36 已部署，将停止阈值改为小于 15 cm、解锁改为至少 20 cm；40–50 cm 每 800 ms 一声，15–40 cm 每 400 ms 一声，近障碍停止后只响三声。见[规则](../../docs/ultrasonic-ranging.md#ct3615-cm-停止阈值)和[验证](verification-ct36.json)。已仅应用烧录并保持配置区、平台角色保存回读一致后重启联网；11 次有效测距、无驱动失败、执行器启动数为 0，设备返回 150／200 mm 阈值，见[部署记录](startup-ct36.json)。2026-10-30 用户确认提示音和距离阈值调整“测试效果符合预期”，已记录于部署文件；定量停车距离及专项回归仍分别记录。

ct35 已部署，将距离语音改为前进时的短提示音：40–50 cm 每 800 ms 一声，30–40 cm 每 400 ms 一声，小于 30 cm 立即停前进并响三声后安静。待机、后退、转向不持续提示；35 cm 解锁不续走保持。已仅应用烧录、配置区保持；平台角色保存并重新打开逐字一致，随后设备重启联网。启动后 11 次测距均有效、驱动失败数及执行器启动数均为 0，见[部署记录](startup-ct35.json)；实机听感待验证。见[规则](../../docs/ultrasonic-ranging.md#ct35前进距离提示音)及[验证](verification-ct35.json)。

ct34 已仅应用部署并保持配置，复位启动后连续有效测距，驱动失败数及执行器启动数为 0；见[部署记录](startup-ct34.json)。本版增加测距冷启动等待、具体故障阶段与 1–8 秒退避恢复；初始化或接收超时不再直接结束任务。清理失败保留资源并明确报告，避免不安全复用。软件验证见[ct34 记录](verification-ct34.json)，一次用户确认的冷上电复测已通过，8 次有效测距且无驱动失败／重启，见[记录](cold-start-ct34.json)；用户随后确认电脑 USB 与独立电池均多次重新上电且测距正常（用户反馈，未逐轮采集遥测），详见[故障与恢复契约](../../docs/ultrasonic-ranging.md#ct34冷启动故障诊断与局部恢复)。角色源和网页布局保持 ct33。

ct33 已部署，配置区保持、平台角色保存回读并重启联网，执行器启动次数为 0；见[验证](verification-ct33.json)与[部署](startup-ct33.json)。新增本地 50／30 cm 提醒和前进保护，覆盖语音、网页和动作序列；声音由独立任务播放，控制任务不等音频。原始有效读数参与判定，35 cm 解锁且不自行恢复。见[规则与验证](../../docs/ultrasonic-ranging.md#ct33本地距离提醒与前进保护)。

2026-10-29 用户确认当前测距与网页优化“测试效果符合预期”，记录于 [ct32 现场反馈](startup-ct32.json)。下方各版本的待测说明保留其当时状态；本次整体反馈不代替电平、测距精度或干扰的定量验证。

**ct32 组间距与底部停止栏已部署（2026-10-29）：** 滑块标签改为“设定速度”；喷水／泡泡／点火／狂暴模式组间增加随窗口高度变化的间距，组内按钮保持。全部停止与状态提示固定在底部并适配安全区，以实际底栏高度为内容预留空间。320×568、375×600、390×667、390×844、1280×720 检查均无滚动条和底栏遮挡；极矮窗口仍可自然滚动。网页回归、构建及应用部署通过，配置区保持、板端页面一致、执行器启动数为 0，见[验证](verification-ct32.json)与[部署记录](startup-ct32.json)。

**ct31 紧凑控制页已部署（2026-10-29）：** 顶部四路固定名称，下方单行仅保留方向／剩余时间、持续、冷却或故障，移除重复动作名称和网页／语音来源。喷水、泡泡六键各排一行；行走速度仍在方向键左上角，测距移至右上角。按可用高度压缩间距，触控区域至少 44 px；320×568、375×600、390×844、1280×720 模拟窗口均无横向／纵向滚动条，320×568 的待命与移动高度一致。不隐藏溢出，文字放大或极矮窗口仍可自然滚动。主机网页回归、构建、仅应用烧录、配置保持及板端页面核对通过，见[验证](verification-ct31.json)和[部署](startup-ct31.json)。

**ct30 距离显示精简已部署（2026-10-29）：** 距离栏仅保留“前方距离”和整数厘米（如 `176 cm`），移除下方说明及“约”前缀；没有有效数据、异常、过期或断线统一显示 `-`。保留 ct29 显示滞回、200 ms 轮询和 500 ms 新鲜度判断，原始测距与提示词不变。网页回归、构建、仅应用烧录、配置保持及板端页面一致性核对通过，见[验证](verification-ct30.json)和[部署记录](startup-ct30.json)。

**ct29 网页优化已部署（2026-10-29）：** 全页禁止选中文字和长按文字菜单；实际行走速度固定在前进键左侧、左转键上方，移除顶部标题中的速度数字。距离显示加入 2 cm 滞回与 350 ms 小变化更新间隔，变化达到 10 cm 立即更新；有效测距时空闲轮询改为 200 ms，异常／超过 500 ms 仍立即清空。控制驱动和 ct28 提示词保持。网页回归、双尺寸布局及构建通过；仅应用烧录、配置保持、网页与启动全关已核对，见[验证](verification-ct29.json)和[部署记录](startup-ct29.json)。手机实物长按及显示体验待用户复测。

**ct28 已部署（2026-10-29）：** 按用户指定的 3.3 V、IO1→TRIG、IO2←ECHO 实现头部测距、网页距离与语音状态查询，不做自动避障。已仅应用烧录、配置区保持、平台角色保存回读并重启联网；实时状态取得有效回波，网页与源码一致。未发送执行器启动请求，真人语音与距离精度待测。见[测距说明](../../docs/ultrasonic-ranging.md)、[验证](verification-ct28.json)及[部署记录](startup-ct28.json)。

ct27 速度控制：默认 100%、60–100% 指定速度、网页实时滑块，运行中语音目标调速，以及每次加减 10 个百分点；软件与构建已通过，提示词已保存回读，已仅应用部署并重启联网。见[速度接口与验证](../../docs/action-sequences.md#速度与时长)。ct26 为上一部署基线。

ct24 在 GPIO18 保留输出并启用输入回读；水路结束后串口 `WATER_PAD` 报告独立数字高低采样、与电机重叠时的采样及关闭电平。采样不改变动作策略，细节及测量边界见[诊断记录](../../docs/action-sequences.md)。现有 `physical_feedback=false` 仍表示没有执行器物理效果反馈；数字引脚读回不是水流或电压测量。

ct23 增加网页“左转＋喷水，各 3 秒”对照入口，调用现有组合 HTTP 接口；语音九工具、角色源、GPIO、230/255 PWM 和调度逻辑沿用 ct22。此版本提供同时启动的网页测试入口，未将现场不喷水问题标记为修复。见[动作序列与现场记录](../../docs/action-sequences.md)。

核对日期：2026-10-29。

**ct27 历史部署：`2.0.3-ct27`**。配置区保持、启动联网、GPIO18 空闲低电平和设备网页一致检查通过；闲置速度 80／60／100% 均接受，59% 拒绝，最终恢复 100%，执行器启动计数为 0。见[验证](verification-ct27.json)和[部署记录](startup-ct27.json)。ct26 滑块及语音加减速已由用户确认；ct27 用户反馈速度测试符合预期，移动中单独“全速”已由串口确认 60% → 100%、方向与原截止不变，见[现场回归](role-full-speed-ct27.json)。其余方向、停止／否定／查询等按分项证据验收。

**ct21 方向修正记录：** 2026-10-27 用户报告基本组装完成，前后正常、左右转相反。输出层将左右履带映射改为 B／左、A／右，保留每路正负极性、204/255 PWM 和逻辑方向语义；网页、语音、组合动作及狂暴模式共用修正。主机与构建结果见[ct21 验证记录](verification-ct21.json)，已仅应用烧录、配置区逐字节保持一致，启动联网与输出全关已核对，部署检查未启动执行器；见[部署记录](startup-ct21.json)。用户随后实测确认左转、右转、前进、后退均正常；该现场反馈不扩展为停止距离、电流和温升验收。

## 当前能力与验证范围

源码与最近记录的应用部署均为 `2.0.3-ct78`，仓库角色候选仍待同步，保留按已保存顺序连接 Wi-Fi，基于 `bread-compact-wifi`／`xiaozhi 2.0.3`，保留语音、OLED、唤醒、音量与说话按键。十一个 `self.tank.*` 工具为 `get_status`、`stop`、`move`、`water`、`move_and_water`、`bubbles`、`ignition`、`frenzy`、`sequence`、`adjust_speed`、`set_speed`，完整参数与状态见[当前接口手册](../CAPABILITIES.md#当前面包板-ct21-接口)。

| 功能 | 当前规则 |
|---|---|
| 前方测距与保护（ct42） | 3.3 V、IO1/TRIG、IO2/ECHO；约 100 ms 采样，500 ms 过期；不足 50 cm 独立滴声；停车开关默认关，开启时 15／20 cm 停前进／解锁，无自动绕行 |
| 行走／转向 | 按指定整数毫秒执行（1–2147483647 ms，协议范围）；默认 100% PWM（255/255），支持 60–100%，1 kHz；B／左、A／右；不提供距离或角度闭环 |
| 顺序与同时 | `sequence` 一次最多 16 步；一步内同时启动、各路独立截止，全步结束并满足间隔后下一步；整单验证，停止／断线／故障／网页抢占取消全部后续步骤 |
| 喷水／泡泡 | 各自定时 1–30000 ms；网页可按住持续，两路互不排斥 |
| 点火低压 MOS | GPIO21 一路控制两只模块，定时 1–5000 ms；关闭后至少间隔本次实际软件 ON 时长，无长按持续接口 |
| 网页与语音 | 自动连接，行走／喷水／泡泡长按独立续租，租期 600 ms、松开停本路；同通道网页优先，保留冷却；行走／喷水／泡泡停止后间隔 200 ms |
| 狂暴模式 | 网页与语音均支持，总时长 1–30000 ms；左转、喷水、泡泡持续，点火最多一秒脉冲与等长关闭间隔；全部停止、BOOT、来源会话失效、断网或故障取消 |
| 反馈与重放边界 | 回执为逻辑状态，`physical_feedback=false`；音频会话内共享 128 个动作 RPC ID，不承诺跨重启持久化防重放 |

当前已基本打印、装配并进入样机联调，[制作与运行影像](../../artifact/README.md)展示落地行走、转向、泡泡及独立喷水台架。ct7 两路并发台架和 ct21 四方向现场反馈已完成；视频没有绑定完整固件／电源配置，不能替代当前四路组合负载、停止距离、电流、定量温升、持续运行或完整断网／复位／OTA／看门狗故障验收。辰克 5 V 电池包与 12 V 升压支路须单独验证，旧电源和 60% PWM 结果不沿用。点火低压软件实现不代表高压、绝缘、液体共存或 EMC 通过；真人口述狂暴模式及最新角色别名／静默规则仍待验证，见[整体验证计划](../../docs/verification-plan.md)与[角色回归](../../docs/agent-role.md)。

ct22 软件验证见[验证记录](verification-ct22.json)。唯一角色源已压缩至平台 6000 字符限制内（5401 字符），保存、重新打开回读一致；设备在保存后重启至 ct22 并联网，真人语音回归仍待执行。PWM 从 204 提至 230 为本轮实现选择，新档位与长时行走的实际速度、停止、电流及温升尚未验证。序列契约和用户示例见[ct22 说明](../../docs/action-sequences.md)。

## 历史部署与阶段记录

以下按版本保留当时行为和证据；其时限、接线候选和未完成描述只适用于相应阶段，当前规则见上表。

**ct20 历史部署：`2.0.3-ct20`**。用户反馈移动偏慢，电机 PWM 由 154/255（约 60%）提高为 204/255（约 80%），频率仍为 1 kHz；前进、后退、转向及狂暴模式共用该值。状态 `logical_outputs.left/right` 同步为 −80/0/80，表示方向与标称占空比，不是实测速度。停止、超时、冷却和失租规则保持。新占空比的实机速度、电流和温升待验证；历史 60% 结果不沿用为 80% 验收。

ct20 主机回归与 ESP-IDF 完整编译通过，见[验证记录](verification-ct20.json)。已仅应用刷写、配置区逐字节保留，启动联网、网页内容与最终输出全关已核对，见[ct20 部署记录](startup-ct20.json)。

**ct15 历史手机布局基线**。针对手机竖屏压缩状态区、方向键和区块留白，保持按钮至少 44 px；在 412 × 800 等五种模拟视口下全页无溢出，见[ct15 部署记录](startup-ct15.json)。仅样式与版本变更，控制逻辑沿用 ct14，手机刷新显示待现场确认。

**ct14 历史功能与无负载验证**。喷水、泡泡各有 1／3／5／10／30 秒和按住持续共六个按钮，三路长按可并行，松开仅停本路。泡泡定时及语音上限为 30 秒；当时点火保持 5 秒／间隔 3 秒，间隔规则已由 ct17 替代。ct14 已仅应用刷写、平台保存回读，实机 HTTP 双路长按超过 30 秒、独立松开／失租与网页操作通过，见[部署记录](startup-ct14.json)。

**ct13 历史部署**。新增泡泡 GPIO17 和双点火共用 GPIO21，两路各最多五秒，四路可独立并行；见[ct13 效果控制](../../docs/effects-control.md)。2026-10-25 已仅应用刷写、保留配置并同步平台角色，见[ct13 部署记录](startup-ct13.json)。以下 ct12 操作说明保留：打开网页自动连接、长按显示计时，没有接管／释放按钮或组合开关；行走和喷水独立、网页与语音并用，冲突网页优先，两路停止后均间隔 200 ms。部署与验证见[局域网控制说明](../../docs/lan-control.md)。

此适配层用于现有 `bread-compact-wifi` 面包板，基于本机已验证的 `xiaozhi 2.0.3`。已完成历史联调的 `2.0.3-ct6` 将双路 L298N 电机与 GPIO18 水枪接入同一灵矽设备，保留语音、OLED、唤醒词、音量和触摸说话按键。用户已确认迁至同一块面包板；已完成仅应用刷写、启动联网及平台角色同步，见[部署记录](startup-ct6.json)；迁线及基本台架四方向／喷水／BOOT 联调已完成，当时实际装车方向标定、断网及完整供电／故障验收尚未完成；ct21 后续已取得装车四方向正常反馈，其余未验证项保留。接线、分阶段检查与最新状态见[电机／水枪集成](../../docs/validation/bench.md)。旧 ct4／ct5 水枪实测保留在[喷水记录](../../docs/validation/bench.md)。

**ct7 历史并发部署**：用户已要求行走和喷水可同时进行。该版本为 `2.0.3-ct7`，独立计时／冷却，增加 `move_and_water` 同时启动工具；BOOT 和停止仍全停。ct7 已仅应用刷写、平台角色回读并重启联网，核心并发台架回归与断功率收尾完成，完整供电／整机验收仍待完成；软件与部署证据见[并发动作说明](../../docs/validation/bench.md)。上段 ct6 及以下历史验收不能替代 ct7 并发实测。

## 来源与配置证据

普通多 Wi-Fi 的本地配置入口为 `secrets/wifi.json`，格式、校验和导入方法见[多 Wi-Fi 配置](../../docs/wifi-configuration.md)。`prepare.py --wifi` 是可选构建入口；填写文件后仍需重新构建和刷入设备。2026-10-30 已部署 `2.0.3-ct39-wifi-order3`，按保存顺序尝试；第一组手机热点已两次连接成功，中间一次认证阶段超时后成功回退第二组。两组配置回读匹配，最终连接第一组，见[构建验证](verification-ct39-wifi-order3.json)和[部署记录](startup-ct39-wifi-order3.json)。热点反复重连稳定性仍待验证。

- 上游：[`78/xiaozhi-esp32`，`e8ed16bb42ed9b199cbc9376011653e5037de8d8`](https://github.com/78/xiaozhi-esp32/tree/e8ed16bb42ed9b199cbc9376011653e5037de8d8)。
- 本机原构建 ELF SHA-256：`f7e8809ce981ee4182fb6c3eb15b20aa785111c7f1e4b1e2f059e4debc813b45`，与面包板完整 Flash 中的应用描述一致；原 `xiaozhi.bin` 的 2,531,056 bytes 也与备份 `0x20000` 起的数据逐字节一致。
- 原 `sdkconfig` 固定在 `sdkconfig.baseline`，其有效配置与 ct2 构建逐项比较无差异；ct3 至 ct6 仅在导出源码配置中将 tick 改为 1000 Hz、任务看门狗改为 2 秒及 panic；原依赖版本在 `dependencies.lock` 中。使用本机原组件缓存的独立副本，避免下架组件引起依赖升级。
- ESP-IDF v5.5.1；ESP32-S3 N16R8；SSD1306 128×32；独立输入／输出 I2S；输入 16 kHz、输出 24 kHz；原唤醒模型保留。
- 原上游 checkout 及其中已有 Kconfig 修改没有被改动。源码导出和构建都在本仓库忽略的 `build/` 下进行。

## GPIO 配置

音频引脚来自原镜像对应的板级源码与配置，执行器引脚来自当前输出驱动；桥身份和完整接线未独立逐线测量，不能以软件配置代替电气验收。

| 用途 | GPIO |
|---|---|
| 麦克风 WS／SCK／DIN | 4／5／6 |
| 扬声器 DOUT／BCLK／LRCK | 7／15／16 |
| OLED SDA／SCL | 41／42 |
| 板载 LED | 48 |
| BOOT：本地停止 | 0 |
| 水枪 MOS TRIG/PWM（ct3 起） | 18 |
| 泡泡 MOS（已部署；有出泡影像，逐线核对及完整电气验收待完成） | 17 |
| 双点火共用 MOS（低压控制已部署；接线与高压验收待完成） | 21 |
| L298N A：ENA／IN1／IN2（ct21 映射右轨） | 8／9／10 |
| L298N B：ENB／IN3／IN4（ct21 映射左轨） | 11／12／13 |
| 按住说话按键 | 47 |
| 音量增加／减少 | 40／39 |

**GPIO4 已被麦克风占用，不能照搬水枪板的 GPIO4 接线或固件。** ct3 取消 BOOT 原对话／启动配网回调，由独立任务读取。待机时先语音唤醒建立会话，明确口述喷水和时长即可请求一次最长 30 秒输出。BOOT 按下即取消／停止，松开不恢复；新的语音指令可在按键释放及冷却结束后再次启动。独立功率切断仍须保留。

上游示例 `LampController` 会占用 GPIO18 并注册开灯工具。本适配不实例化它，ct2 替换为两项 CyberTrack 工具；ct3 由受限喷水任务使用 GPIO18，音频与显示板级定义保持原样。

## ct2 历史工具语义

- `self.tank.get_status`：读取本板 CyberTrack 控制核心的逻辑状态。初始 `DISARMED`；能力全部关闭，`physical_feedback=false`、`actuator_backend=not_installed`。
- `self.tank.stop`：在同一个序列化主任务内调用 `ct_stop`，进入 `FAULT/stopped` 并清除逻辑输出；重复调用仍保持锁定。不终止 TTS、不禁用屏幕，不声称实体停止或已控制另一台设备。
- 两项工具只接受空参数；额外参数在执行前拒绝，schema 标明 `additionalProperties=false`。不提供 GPIO、喷水、行走、泡泡或重新使能工具。
- 回执带本板 MAC、随机启动标识、单调递增请求序号及运行时间，便于对照平台真实工具调用。状态不会在重新开始对话时自动解除停止；重启后仍为不可动作的 DISARMED。
- 复用 `firmware/src/control.c`，通过 `apply_overlay.py` 复制到临时构建目录，不另写一套动作状态机。

## ct5 历史工具语义

- `self.tank.water` 只接受整数 `duration_ms`，范围 1–30000 ms；不再暴露 permit，不要求长按 BOOT。必须是明确的喷水指令；状态查询不会喷水。角色将秒数转换为毫秒，超过 30 秒按 30 秒执行并说明；明确要求喷水但未说明时长时由角色填写 1000 ms，不追问、不沿用历史请求。工具参数仍必须显式提供 duration_ms，固件不自行补默认值。固件拒绝零、负数、非整数和超出 30000 的参数，不自动分段。
- `get_status` 与 `stop` 只接受空参数。状态报告本板水枪逻辑输出，`local_authorization_required=false`、`physical_feedback=false`。主动停止为 `STOPPED/fault=stopped`，不是硬件损坏；故障仍为 FAULT。
- 复用 `esp32-linx/main/water_policy.c` 的截止与冷却策略，新增 `water_request_timed` 接口允许 1–30000 ms；原 `water_request` 的固定 5000 ms 行为不变，授权函数仅在本地请求执行时原子调用，不作为用户操作门槛。`water_guard.h` 校验网络接收时的就绪状态，并为队列创建内部票据；停止、BOOT、断线取消所有待执行票据，超过 5 秒未执行的请求拒绝。
- 同一音频会话最多记住 128 个喷水 RPC ID，重复 ID 拒绝，不逐出旧 ID；表满拒绝进一步喷水，新会话重新开始。内部票据跨会话不复用；不宣称跨重启持久化防重放。
- 独立优先级 10 控制任务每 5 ms 检查 BOOT、连接与期限。截止由本次 duration_ms 决定，上限 30000 ms，活动时不续时，结束后冷却 1 秒。BOOT 释放需稳定 30 ms；松开或恢复网络本身都不启动动作。
- 停止在网络接收时立即关断，再通过主任务返回回执。已检测的 Wi-Fi／WebSocket 断线、复位与升级均关闭输出。活动输出期间控制任务不进行显示、日志、网络或堆分配。

ct3 的逐次物理授权流程和 ct4 的固定五秒要求已被用户明确取消，历史结果保留在[喷水验证记录](../../docs/validation/bench.md)。用户已确认控制线纠正后喷水测试正常，带载 BOOT 提前停止及松开不恢复也已确认。上述结果属于 ct4 五秒配置；ct5 已通过功率断开的 1／7 秒及 40 秒请求限为 30 秒的语音核验，用户确认音频／屏幕正常，不能推导 30 秒带载已通过。真实断网故障矩阵、独立硬件切断和完整供电验收仍未完成，软件输出回执本身不证明有水流。

## ct6 历史工具与统一控制

- 新增 `self.tank.move({"direction":"forward","duration_ms":1000})`。方向仅接受 `forward/backward/left/right`，整数时长 1–3000 ms，固定 1 kHz／8 bit duty=154（约 60%）。角色默认一秒，超三秒请求三秒并说明；不把距离或角度换算成时间。A 候选左、B 候选右，正负极须按车体前进方向核对，当时不是实车标定；ct21 已修正为 B／左、A／右并取得四方向正常反馈。
- `self.tank.water` 保留 1–30000 ms，未说时长填 1000；工具描述与角色统一。两类动作互斥，共用 128 项会话 RPC 记录、内部票据与截止时间；接受一个动作即取消其他已排队票据，忙碌请求不延迟补做。
- `self.tank.stop`、BOOT、已检测的 Wi-Fi／会话断开、重启／升级入口同时撤销两类动作和待执行票据。BOOT 松开稳定 30 ms 后也不恢复；ct6 原电机停止后冷却 3000 ms、喷水停止后 1000 ms；ct12 将面包板两路统一为 200 ms，必须另有新指令。
- GPIO8–13 为 ct6 的面包板分配，后续部署沿用，与独立台架 GPIO4–9 不同。LEDC timer 2／channel 2、3 避开上游 LED／背光的 timer 0、1／channel 0；原 I2S、OLED 与 GPIO18 不变。
- 切换方向前先关闭两路使能及水枪；任何 GPIO／PWM API 错误锁定 `output_fault`，尝试关闭全部输出并将使能重置为普通 GPIO 低，不自动重试动作。
- 控制任务维持优先级 10、5 ms 周期，活动循环没有显示、网络、日志或堆分配。LEDC API 使用带优先级继承的互斥锁串行化，避免在自旋临界区调用可能取 RTOS 锁的驱动。
- 四工具共用状态：`logical_outputs.left/right` 为 -60/0/60 的逻辑方向与标称占空比，`water` 独立布尔值；`move_direction` 为当前方向或 `none`。`remaining_ms` 和 `last_duration_ms` 对应共享动作，`starts_this_boot` 计两类动作；`max_duration_ms=30000` 保留水枪上限，`move_max_duration_ms=3000` 为电机上限。无编码器、水流或物理停止反馈。
- 网络参数严格拒绝缺参、额外参数、非法方向、非整数值与越界时长。动作只有内部 `result=accepted` 才算接受；硬件 API 失败返回 `output_fault`，接受后尚未应用就被本地条件取消返回 `cancelled_before_output`。上游 MCP 外层成功不足以判定动作成功。

## 重现构建

2026-10-30 已恢复本机 ct40 环境，可直接复用导出源码进行增量构建：

```sh
export PATH="/Users/miclle/.espressif/python_env/idf5.5_py3.13_env/bin:$PATH"
source build/toolchains/esp-idf-v5.5.1/export.sh
idf.py -C build/xiaozhi-ct40-src -B "$PWD/build/firmware-ct40" build
```

恢复来源为固定上游提交与仓库锁定的组件哈希。下架的 `image_player 1.1.0~1` 后续从上游历史、原发布清单与 manifest 重建并通过完整哈希核验；它只用于未选中的 `esp-hi`，本次已完成的 OLED 构建未引用它。恢复后的完整缓存位于 `build/xiaozhi-ct40-src/locked_components/`，构建记录见 `verification-ct40.json`。本次没有导入 Wi-Fi 文件；直接使用设备已有配置并保留连接顺序。`prepare.py` 的无 `--wifi` 路径也应用顺序补丁，不重写 NVS。

以下原始导出流程仍需原 ELF 及其组件缓存：

源码导出使用支持 tarfile data filter 的 Python（历史构建使用 3.14）；ESP-IDF 仍固定 v5.5.1。需保留原始源码 checkout、原构建 ELF 及组件缓存；不要求联网下载替代版本。`prepare.py` 要求一个尚不存在的导出目录（默认 `build/xiaozhi-audio-src`，可用 `--target` 指定），不会覆盖已有导出或修改原 checkout。

```sh
# 先激活 ESP-IDF v5.5.1 的 Python 环境与 export.sh。
python firmware/esp32-audio/prepare.py /path/to/original/xiaozhi-esp32 --target build/xiaozhi-ct21-rebuild-src
sh firmware/esp32-audio/test.sh
node firmware/esp32-audio/tests/web_ui_test.mjs
python firmware/esp32-audio/tests/run_mcp_tests.py --source build/xiaozhi-ct21-rebuild-src
python firmware/esp32-audio/tests/run_display_tests.py --source build/xiaozhi-ct21-rebuild-src
idf.py -C build/xiaozhi-ct21-rebuild-src -B "$PWD/build/firmware-ct21-rebuild" build
```

上述目录是重新导出的示例名称，须确保尚不存在；实际版本由 `apply_overlay.py` 设置，本次文档同步未重新构建或烧录。

应用分区是 `ota_0`，起点 `0x20000`、大小 `0x3f0000`，与水枪台架分区不同。更新前需核对设备 MAC、分区表、OTA 选择及已有备份；已有 ct21 部署仅写该应用，不执行完整 `idf.py flash`，不覆盖引导、NVS、OTA 数据或 8 MB assets。

## 验证与观察

`test.sh` 运行 ASan／UBSan 主机检查，验证 ct2 只读核心，以及 ct5 可变时长启动、截止边界与非法时长拒绝、忙碌／冷却拒绝、BOOT／停止取消排队请求、断线、复位、重复 RPC、队列过期和时钟故障。ct7 覆盖独立并发计时／冷却、组合原子拒绝、同路排队取消、另一通道输出连续性，以及实际输出类全部初始化／组合状态转换 API 单故障注入。`run_mcp_tests.py` 从已导出源码提取实际 MCP 校验块，使用 ESP-IDF cJSON 检查参数边界。当前脚本还覆盖四路效果、会话／租约及狂暴模式；ct21 软件报告记录了 56 个输出状态与故障矩阵、网页脚本、MCP／HTTP 检查和 ESP-IDF 构建通过，见[报告](verification-ct21.json)。以上是对应报告的历史测试结果，本次未重跑；不能代替实物停止或完整端到端语音验收。

`monitor.py --port <设备串口> --log build/audio-private/session.jsonl` 只监听和筛选 CT_AUDIO 回执、运行状态及少量启动信息，不发送串口命令，不保存原始串口日志或录音。平台工具记录和用户现场音频／屏幕观察共同构成语音联调证据。详见[验证记录](../../docs/validation/bench.md)。

## 平台角色配置

灵矽智能体管理名称为“CyberTrack”（原名“彩菊”），助手昵称为“小D”；设备绑定沿用。角色介绍以仓库中的 [role-prompt.txt](role-prompt.txt) 为唯一维护源，用于灵矽角色配置的“角色介绍”字段，昵称使用 `{{assistant_name}}`。角色为机灵、友好、利落的 CyberTrack 机器人小助手，聚焦动作与状态，通常一句话回答；去掉“开启／关闭输出”等工程话术，不接明显的背景谈话，不展开无关话题。动作和停止成功后静默执行；仅超限调整、失败、拒绝或结果不确定时简短说明，唤醒与状态查询正常回应。动作别名与受限的“饭店→放电”纠错以角色源为准；均检查真实工具回执，未知能力不假装执行。音色和模型保持现有选择。平台提示保存后需重启设备生效；修改昵称不会更改固件唤醒词“你好小智”。提示词不是固件动作限制的替代品。

维护、平台同步、回滚和语音回归要求见[智能体角色与提示词](../../docs/agent-role.md)。不要在其他文档复制整份角色介绍；此处仅概述行为。

平台意图识别已由分离模式调整为统一模式，用于让聊天模型直接选择工具；原分离模式下泛称“查询状态”曾误选通用设备信息工具。统一模式下相同说法已正确调用 CyberTrack 工具，停止和停止后查询也已实测通过；详见验证记录。这是 ct2 阶段的有限样本结果，不保证所有表达方式。

## 历史网页与模式验证

ct8 当时的测试另覆盖网页租约／控制权、来源切换与语音防重放、短时动作窗口、HTTP Host／Origin／鉴权／限流／读取边界与发送失败释放，以及页面模拟设备交互。测试使用实际会话类、JSON 解析器和 HTTP 处理函数；HTTP 传输／显示由桩替代，不能证明真实 Wi-Fi、手机后台或声音连续性。见[当前记录](../../docs/lan-control.md)。

ct9 新增长按 15 秒的软件连续性、600 ms 截止、续租／松开乱序与重放、BOOT 期间不可签发动作窗口、滑出／指针取消／后台及在途请求取消。语音仍限三秒；长按持续带载与真实松开停止时延尚未验收。

## ct17 狂暴模式

历史版本 `2.0.3-ct17`。网页提供 5／10／30 秒模式，持续左转、喷水、泡泡和 1 秒点火／至少等长间隔，整体截止最多 30 秒；四路均就绪后整体启动，全部停止、BOOT、会话失效、断网及故障取消，不自动恢复。普通点火停止后也至少等待本次实际软件 ON 时长，替代历史固定三秒。ct17 当时未增加语音狂暴入口；ct18 随后增加 `self.tank.frenzy`。协议见[网页说明](https://github.com/miclle/cybertrack/blob/c25b0af729bd216b69779db2bba75f32f9475cdd/docs/lan-control.md#ct17-狂暴模式)，源码哈希、构建和主机证据见 [verification-ct17.json](verification-ct17.json)。

ct17 已仅应用刷写并保留配置；启动／联网、实际页面全文一致、能力字段、手机视口及最终全关／释放均已核对。该次部署检查的实机 `starts_this_boot=0`，未触发狂暴或点火，动作时序证据来自主机测试。见[部署记录](startup-ct17.json)。

## ct18 语音狂暴模式

历史版本 `2.0.3-ct18`，新增 `self.tank.frenzy`，默认五秒、单次最多三十秒，参数仅整数 `duration_ms`。与网页共用调度，语音连接关闭取消；网页心跳／释放不控制语音模式。票据重复、过期、取消或同路忙碌不补做，全部停止仍全关。验证与部署分别见 [verification-ct18.json](verification-ct18.json) 和 [startup-ct18.json](startup-ct18.json)。

ct18 已仅应用烧录、保留配置，并在角色保存后重启联网。启动日志含 frenzy 工具，实机状态包含模式来源／时长字段，页面与源码一致，最终全关并释放，动作启动次数为 0。该模式尚未完成真人口述或完整带载验证。见[部署记录](startup-ct18.json)。

## ct19 网页提示修复

历史版本 `2.0.3-ct19`。底部动作成功提示跟随设备最新状态更新，全部结束后显示“动作已结束。”，并行时显示仍在运行的动作；错误／停止提示不被普通轮询覆盖。该次变更的动作后端及角色源与 ct18 一致；后续 ct20／ct21 和角色更新见当前状态。

ct19 已仅应用烧录并保留配置，启动联网及实际页面与源码一致已核对，最终全关并释放。该次部署检查的实机没有启动执行器；四类按钮提示转换通过本地模拟设备浏览器验证，见[部署记录](startup-ct19.json)。

## ct33 补充验证

运行 `sh firmware/esp32-audio/test.sh`、`node firmware/esp32-audio/tests/web_ui_test.mjs`；导出工程后，再运行 `python3 firmware/esp32-audio/tests/run_mcp_tests.py --source build/xiaozhi-ct33-src` 和 `python3 firmware/esp32-audio/tests/run_audio_tests.py --source build/xiaozhi-ct33-src`。音频测试执行实际导出的方法，控制解码中途和播放排空的并发时序；实物声音、回波稳定性及机械停止另验。
