miclle/cybertrack/firmware/esp32-motor-bench/README.md

# L298N 双电机 GPIO 台架测试

核对日期：2026-10-27。本工程保留独立 COREBOARD 台架源码 `0.3.2-l298n-dual-10s`，下方烧录、供电状态和动作观察均为 2026-10-25 历史，不表示设备现在仍连接或处于该版本。现用面包板已部署 ct21，电机 GPIO8–13、80% PWM；不得套用本页 GPIO4–9。当前辰克电池、接线及未验证项见[电机台架记录](../../docs/motor-bench.md)与[面包板工程](../esp32-audio/README.md)。

2026-10-25 双路 10 秒命令已执行一次：用户确认上电、万用表准备好后，选 AB、使能并仅发一次 f（约 60% PWM）。主机命令到关闭日志约 10.09 秒，收到两路关闭回执，随后追加 s 再确认关闭；未见 BOOT、错误或重启记录。用户已确认双路 60%／10 秒空载正转正常启停，启动、运行中及临近停止母线均约 12 V，电机和 L298N 无明显发热、无异响或其他异常；这是万用表读数与主观发热观察，电流和定量温升仍未测。用户已断开 12 V、USB 保持连接，本次短时空载功能检查通过。见[运行及用户反馈记录](dual-10s-run-verification.json)。下方准备记录保留当时状态。

2026-10-25 双路 10 秒观察版准备完成：用户确认 12 V 断开、USB 保持连接；0.3.2 已通过主机 ASan／UBSan 回归与 ESP-IDF 编译，备份原应用后仅写入新应用，哈希校验通过。启动确认 60%／10000 ms，只发送 s 并收到 `DISARMED outputs=OFF target=NONE`，观察 5 秒无异常，串口保持连接。未发送选择、使能或动作命令，当时尚未执行双路 10 秒电压／发热实测，后续结果见页首。见[启动检查](startup-verification-dual-10s.json)。

当前源码版本 **`0.3.2-l298n-dual-10s`**，ESP-IDF **v5.5.1**，仅用于原 **ESP32-S3 N16R8／COREBOARD 台架板**。GPIO4／5／6 控制 A 路，GPIO7／8／9 控制 B 路；可单独选择 A、B 或 AB。当前所有动作均为 **1 kHz、约 60% PWM（154/256）、10 秒单次脉冲**，没有自动循环。当时按用户要求准备的 AB 双路正转已完成，结果见页首；此前 0.3.1 的 3 秒组合和 BOOT 实测单独保留，不与 10 秒结果合并为带载验收。

2026-10-25 双路 BOOT 检查：用户确认上电准备好后，只发送一次 a／f 请求 AB 正转（约 60%、最长 3 秒）。约 0.65 秒后收到 `DISARMED outputs=OFF target=AB BOOT held`，早于自动截止；松开回执仍关闭，之后超过 5 秒未重新使能，最后追加 s 并确认关闭。以上时间来自主机日志，不是物理停止时延；用户已确认两台在按 BOOT 后提前停止，松开后持续不转，无异常；12 V 已断开，USB 保持连接。本次双路空载 BOOT 提前停止／松开不恢复子项通过。见[本次 BOOT 记录](dual-boot-stop-verification.json)。

2026-10-25 已按用户授权发送一套 8 组组合命令（60% PWM、每组 3 秒），每组均收到关闭回执，最后另发 s 并确认两路关闭，期间未见 BOOT、错误或重启记录。串口观察的命令至关闭日志间隔约 3.01–3.04 秒，组间停顿超过 3 秒；不是物理停止时延测量。用户随后确认 12 V 已断开、USB 保持连接，8 组均正常：单路测试时另一台不转，各组转向符合预期，两台正常停止，无异响或异常发热。本次 60%／3 秒空载组合检查通过；当时双路运行电压、电流、定量温升未测；后续 10 秒电压观察见页首记录；随后完成的 BOOT 提前停止见页首记录；见[组合命令与回执记录](combinations-verification.json)。下方烧录准备段落保留当时状态。

2026-10-25 组合版本烧录检查：用户确认 12 V 断开、两台固定空载、USB 保持连接后，备份原应用并仅写入 0.3.1，哈希校验通过。串口确认 60%／3000 ms，只发送 s 并收到 `DISARMED outputs=OFF target=NONE`，继续观察 5 秒无使能或错误回执，串口保持连接。未发送选择、使能或动作命令；当时尚未执行组合动作，见[本次启动记录](startup-verification-combo.json)。

用户确认两台同规格 12 V、100 rpm 的 37R-520 已固定、输出轴空载、不安装履带，驱动 12 V 已断开。此前单路 200 ms 正转、40%／10 秒反转和 60%／10 秒反转有用户观察记录；这些与已完成的 0.3.1 双路短时检查均不证明双路 10 秒运行或机械带载能力通过。软件验证见 [verification-dual-10s.json](verification-dual-10s.json)，真实烧录／动作另记。独立台架不开放网络／语音，不适用于现有面包板，不冻结整机 GPIO。

2026-10-25 双路烧录检查：用户确认 B 路接线完成、旧 ENB 接地线移除、仅 COM USB 接通且 12 V 断开。仅应用烧录及哈希校验通过，启动为 0.3.0／60%／200 ms，唯一发送 s，收到 `DISARMED outputs=OFF target=NONE`；串口保持连接，未发送选择／使能／方向命令。当时未测六脚静态电压，见[历史启动记录](startup-verification-dual.json)。随后用户已确认六脚上电前后均近 0 V、两台始终不转，见[接线检查](dual-wiring-verification.json)；当时尚未进行 A／B 隔离和双路动作检查。

## 供电与跳帽

- 改线时断开驱动 12 V、ESP32 USB 和其他所有电源。运行时主控先启动、驱动最后上电；结束先断驱动，再拔 USB／复位／重新打开串口。
- **ENA、ENB 常高跳帽都取下**，控制线接实际使能信号针，不接另一侧 5 V 针。双路接线前必须拆掉旧单路方案中的 **ENB→GND 线**；若 IN3／IN4 之前接地，也先移除这些接地线。不能让 GPIO 输出与 GND 短接。
- 此用户实物的独立板载稳压跳帽保留，+12V 输入约 12 V，+5V 输出约 5 V 已获用户万用表观察。**+5V 留空，不接 ESP32 或其他电源**。这是本块板的空载检查，不替代整板额定和温升验证；新板不得只照方位猜接线。
- 建议在 ENA、ENB 各加 10 kΩ 外部下拉；没有外部下拉时，软件无法保证复位／下载／主控失电时低电平，不进行驱动带电的复位或拔 USB 测试。BOOT 是软件停止输入，不能替代独立切断 12 V。
- 动力回流从驱动 GND 直接返回升压电源，不经过 ESP32 排针、USB 或面包板。该轮使用旧充电宝＋MT3608 的 12 V 支路；当前已换辰克 5 V 电池包，仍保留升压支路，但需重新核对输入能力与负载表现。不提高母线补偿驱动压降。
- 只测试两台输出轴空载电机；编码器线分别绝缘、不接，其他执行器不接。该轮旧电源的 5 V／3 A 参数及升压功率预算不能证明双电机额定负载可用，也不适用于辰克电池，见[供电预算](../../docs/power-and-interfaces.md)。

## 接线表

ESP32 以 **GPIO 丝印**定位；下列 J1 编号仅对应[原板图纸](../../hardware/components/ESP32-S3-N16R8/README.md)，不是 GPIO 编号。GPIO8／9 不紧邻 GPIO7。

| ESP32／电源 | L298N | 说明 |
|---|---|---|
| GPIO4（J1-4） | ENA 信号针 | A 路 PWM |
| GPIO5（J1-5） | IN1 | A 路方向 1 |
| GPIO6（J1-6） | IN2 | A 路方向 2 |
| GPIO7（J1-7） | ENB 信号针 | B 路 PWM；拆掉旧 ENB 接地线 |
| GPIO8（J1-12） | IN3 | B 路方向 1 |
| GPIO9（J1-15） | IN4 | B 路方向 2 |
| ESP32 GND | 驱动 GND | 与动力电源负极共地 |
| 电机 A 两根动力线 | OUT1、OUT2 | 两端都不是固定地 |
| 电机 B 两根动力线 | OUT3、OUT4 | 两端都不是固定地 |
| MT3608 OUT+／OUT− | +12V／GND | 可直接切断 12 V；+5V 留空 |
| 电脑 USB | ESP32 COM USB | UART0，115200 baud |

接线完成后，先仅 USB 启动、驱动保持断电，检查 ENA、IN1、IN2、ENB、IN3、IN4 对驱动 GND 均近 0 V。确认后主控保持运行、两台电机固定且轴空载，再给驱动上电；两台均应保持不转，复测六个控制脚及 +5V。若任一电机自行转动，立即断开 12 V。用户在单路已测过的 ENB 接地状态，不能代替新 GPIO7 控制 ENB 的上电检查。

## 命令与 10 秒观察流程

| 单独发送的字符 | 行为 |
|---|---|
| `1` | 选择 A，撤销已有使能，不动作 |
| `2` | 选择 B，撤销已有使能，不动作 |
| `3` | 选择 AB，撤销已有使能，不动作 |
| `a` | 已选通道时打开 3 秒使能窗口；输出仍关闭 |
| `f`／`r` | 在使能窗口内启动所选通道，一次 10 秒、约 60% PWM |
| `x`／`y` | 仅 AB 已选且已使能时，x=A 正 B 反、y=A 反 B 正；其他选择拒绝并撤销使能 |
| `s`／按 BOOT | 同时关闭两路并撤销使能；松开 BOOT 不恢复 |

启动后 `target=NONE`，必须先选通道。选中的通道在正常停止后保留，但每次动作必须重新 `a`；重启后恢复 NONE。运行中收到通道选择、方向或其他非换行字符都停止两路，不执行切换；冷却至少 3 秒，期间请求不会排队。不能粘贴 `3af`，必须逐个发送并检查回执。

1. 驱动断电下打开串口，确认 `BENCH READY 0.3.2-l298n-dual-10s A=4/5/6 B=7/8/9 PWM=1000Hz/60% pulse=10000ms`。只发 `s`，应为 `BENCH DISARMED outputs=OFF target=NONE`。
2. 完成上述六路静态电压检查，接好并固定两台空载电机，主控稳定运行后再给驱动上电，两台均应不转。
3. 本次仅准备一次双路正转：单独发送 3、检查 target=AB，再单独 a、检查 ARMED，3 秒内发送 f；运行最长 10 秒。用户确认上电且两台不转后才执行，不自动重试或连跑全部组合。
4. 在 12 V 断开时将万用表置直流电压档，黑表笔接驱动 GND、红表笔接 +12V，固定表笔避免短路；记录启动、运行和临近停止的母线电压。观察两台转动、停止与异常，若有测温仪可记录驱动散热器及电机外壳运行前后的温度和环境温度。无温度数值时只记录主观异常，不能称为定量温升通过。两次动作之间至少停 3 秒且两轴完全停稳；实际重复前仍需结合温度和用户观察。无转动、错误通道、异响、掉压、重启或异常发热时立即停止并断开 12 V，中止剩余组。BOOT／s 同时停止两路；主机执行组序列时发现 BOOT、提前停止、错误、重启或回执缺失，应中止剩余组而不是重新使能。
5. 本次动作结束先断开 12 V，再处理 USB／串口；断电后再检查发热，避免接触运动件或可能烫手的散热器。10 秒空载观察不能证明热稳态或履带带载能力。固件自身只接受单次动作，不内置自动顺序循环。

下表仅为可用命令参考，不是本次自动执行顺序；所有动作键均已改为 10 秒上限。

| 编号 | 组合（电气方向） | 逐个发送 |
|---|---|---|
| 1 | A 正，B 停 | 1 → a → f |
| 2 | A 反，B 停 | 1 → a → r |
| 3 | A 停，B 正 | 2 → a → f |
| 4 | A 停，B 反 | 2 → a → r |
| 5 | A 正，B 正 | 3 → a → f |
| 6 | A 反，B 反 | 3 → a → r |
| 7 | A 正，B 反 | 3 → a → x |
| 8 | A 反，B 正 | 3 → a → y |

`f` 对所选桥分别设置 IN1/IN2 或 IN3/IN4 为 1/0，`r` 为 0/1；未选桥保持禁用且方向输入为 0。AB 的 f／r 取相同电气方向，x／y 取相反电气方向；是否对应机器人前进或转向取决于安装与接线，当前不声明车体方向映射。两路 PWM 依次更新，不声明物理严格同步启动。停止采用禁用桥，电机可能滑行。

## 编译与软件验证

```sh
export IDF_PYTHON_ENV_PATH=/Users/miclle/.espressif/python_env/idf5.5_py3.14_env
. /Users/miclle/esp/esp-idf/export.sh
idf.py -C firmware/esp32-motor-bench -B "$PWD/build/firmware-l298n-dual-10s" \
  -D SDKCONFIG="$PWD/build/firmware-l298n-dual-10s/sdkconfig" build
python3 firmware/esp32-motor-bench/tests/run_host_tests.py
```

构建目录独立保留，不覆盖单路 0.2.x 镜像。烧录前必须驱动及其他负载断电，并核对目标串口和现有分区表；备份原应用，优先仅写应用，不做全片擦除或 eFuse 修改。打开／切换串口可能复位，因此也必须驱动断电。

主机 ASan／UBSan 测试编译实际 `motor_bench.c`，模拟两路 PWM、六 GPIO、UART、BOOT 和时钟；检查 A／B 隔离、全部 8 种组合的 10 秒截止及第 9 秒 BOOT／s 提前停止、选择撤销使能、冷却、运行中切换拒绝、停止和松开不恢复、UART 故障、两个通道的初始化／方向／PWM／停止失败，以及一侧持续停止 API 失败时两侧 GPIO 回收。实物 API 持续故障仍需人工切断供能；模拟不证明物理停止时延或复位默认关闭。

任一路失败时尝试关闭两路 PWM，再回收两路使能 GPIO 并清零四个方向输入，锁定错误循环，不自动重启。正常停止先尝试禁用两桥，再改变任何方向输入。1 秒任务看门狗不能替代独立断电；串口断开也不保证被立即检测，动作仍受正常调度下 10 秒期限约束。

新验证见 [verification-dual-10s.json](verification-dual-10s.json)。以下 0.2.x 记录只属于历史单路测试；旧版 ENB 接地和 IN3／IN4 留空不能用于当前双路接线。Q05 和 V02–V04 保持未完成。

## 2026-10-25 原 0.2.0 驱动断电下烧录与启动／关闭检查

用户确认接线完成、ENB 接 GND、IN3／IN4 留空，L298N 12 V 已断开，原 N16R8 通过 COM USB 连接电脑。本机核对串口无其他进程占用、源码和应用哈希匹配已通过的测试记录；读取板上分区表，与新构建逐字节匹配。先备份将被覆盖的 245760 字节应用扇区，再以 115200 baud、esptool 4.12.dev2、no-stub 将 245360 字节应用写至 0x10000，收到 `Hash of data verified`。bootloader、分区表和 eFuse 未写入。

驱动持续断电，受控复位后读取：

```text
BENCH READY 0.2.0-l298n-bench GPIO4=ENA GPIO5=IN1 GPIO6=IN2 PWM=1000Hz/40% pulse=200ms
BENCH DISARMED outputs=OFF
```

第二行是唯一发送的串口字符 `s` 的回执；没有发送 `a`、`f`、`r`。之后观察 5 秒未见再次启动或错误，结束后关闭串口。结构化证据与本机日志哈希见 [startup-verification.json](startup-verification.json)；原 [verification.json](verification.json)保留烧录前的软件验证快照。

这只证明应用烧录、启动及软件关闭回执。未测 GPIO／ENA 实际电压，未给驱动接通 12 V，未测试电机、BOOT 实体输入或带载停止；不能把 `outputs=OFF` 当成电气／机械验收。后续重新打开串口仍需驱动电源断开。

## 2026-10-25 200 ms 首测及 10 秒观察版本

用户报告：ESP32 3V3 约 3.3 V；驱动独立供电时 +12V 约 12 V、+5V 约 5 V，无异常；恢复控制线并给驱动上电后 ENA／IN1／IN2／ENB 均接近 0 V。电机固定、输出轴空载，先保持不转，随后明确授权一次 200 ms、约 40% PWM 点动。串口只发送一次 a 和 f，收到自动 DISARMED／outputs=OFF；用户断开 12 V 后确认电机短暂转动后停下，无异响或其他异常。见 [first-pulse-verification.json](first-pulse-verification.json)。上述是用户现场观察和串口回执，不是波形、电流、温升或机械停止时延测量。

用户随后要求测试反转并将观察时长延长至 10 秒。0.2.1 保持原接线、PWM 和停止路径，只把每次 f／r 的期限调整为 10000 ms；每次仍须 a 使能，并在 3 秒内单独发送方向键，停止后至少等 1 秒且轴完全停稳。主机回归覆盖两个方向的 10 秒截止及第 9 秒的 s／BOOT 提前停止；烧录和实物动作分别记录，不继承 200 ms 首测结论。

在用户确认 12 V 已断开、USB 保持连接后，已备份旧应用扇区并仅写入 0x10000 起的 0.2.1 应用，哈希校验通过，bootloader／分区表／eFuse 未写入。重新启动后确认 `pulse=10000ms`，只发送一次 `s` 并收到 `DISARMED outputs=OFF`，串口保持连接；未发送使能、正转或反转。见 [startup-verification-10s.json](startup-verification-10s.json)。该次烧录检查没有执行动作；之后的两次反转见下方记录。

## 2026-10-25 40% 反转结果与 60% 对比版本

0.2.1 两次反转均分别发送一次 a／r 并收到自动关闭回执。用户首次确认方向相反、约 10 秒后停下，无异响、异常发热或重启；第二次专门观察母线电压，用户确认启动和运行均基本保持 12 V，正常停止且无异常，每次结束均已断开 12 V。万用表不能排除短暂压降，也未测扭矩／电流／温度，见 [reverse-40pct-verification.json](reverse-40pct-verification.json)。

0.2.2 按用户要求把 duty 从 102 调至 154（8 bit，约 60%），正反转都适用；维持 1 kHz、单次 10000 ms、3 秒使能及至少 1 秒冷却，必须轴完全停稳才能换向。60% 对比需重新观察母线、方向、停止和异常情况，不继承 40% 的实物结果。

0.2.2 已在用户确认 12 V 断开时备份旧应用扇区并完成仅应用烧录，哈希校验通过。启动确认 `PWM=1000Hz/60% pulse=10000ms`，只发送 s 并收到 `DISARMED outputs=OFF`，串口保持连接；该次启动检查未发送使能或方向命令；后续 60% 实物对比见下方记录。见 [startup-verification-60pct.json](startup-verification-60pct.json)。

60% 对比：单独发送一次 a／r，收到 `DISARMED outputs=OFF`；用户随后确认 12 V 已断开，启动和运行母线均基本保持 12 V，较 40% 转动明显更快、更顺畅，正常停下，无异响、异常发热或重启。见 [reverse-60pct-verification.json](reverse-60pct-verification.json)。该反馈只覆盖此次空载反转及万用表观察，不代表已测扭矩、温度、电流、启动瞬态或带载停止，也不替代 BOOT／双通道验收。
