miclle/cybertrack/hardware/model/drive-fit-fixture/l298n-gap-study/README.md

# L298N 与 30 mm 电机尾部间距布局检查

> 后续输入已更新：用户确认插线后厚 28.5 mm，本目录 27.5 mm 初步研究仅作历史记录。当前固定、接线和模型见[0.57 紧凑支架](../../l298n-compact/README.md)。

2026-10-26。输入是用户实测：两台电机相对尾部最近硬质凸起（含编码器／接头）的净距为 **30 mm**。用户已确认 VF01 的电机／履带静态试配没有问题。此目录是独立布局研究，未修改正式总装和部件资产，不提供可打印支架或制造放行。

## 检查结论

优先候选为 **L298N 绕整机 Z 轴转 90°，让 27.5 mm 厚度朝两台电机；安装架改为前后端导向／底部承托，取消现有两侧夹紧结构和旧顶盖吊柱**。电机、履带固定位置保持。

| 项目 | 结果 |
|---|---|
| 原驱动板朝向 | 横向 43.5 mm，在本次居中尾部检查盒下发生重叠；不是对实物接触位置的断言 |
| 原托架直接随板转 90° | 横向仍占 41.5 mm，不能沿用 |
| 驱动板平放到电机上方 | 检查的 Z70.5…98 mm 位置与顶盖、线束及颈架打印件相交 |
| 新竖装朝向 | 板卡 X−13.75…13.75、Y−21.25…22.25、Z32…78.2 mm |
| 前后导向／承托候选 | 外包络 27.5 × 47.2 × 50.7 mm；单一有效实体，体积 1,935 mm³；没有固定螺钉和夹持锁定机构 |
| 静态及向下取出 | 在假设范围内无实体重叠；拆底盖及其螺钉后，板卡＋承托候选沿 −Z 连续 80 mm 扫掠无重叠；不包含待设计的安装紧固件、真实插头和线束 |
| 最近名义余量 | 居中尾部检查盒每侧 1.25 mm；电池检修盖、底盖、底盘各 0.5 mm；功能模块托盘 0.75 mm |

前端导向柱需沿整个高度避让电池检修盖，只有底部开缺口仍会阻挡下取。本候选前导向厚 1.2 mm、后导向厚 2 mm，底部承托厚 1.8 mm；这些是空间分配，未验证打印强度。旧吊柱从研究中的顶盖形状移除，新吊接／锁紧机构尚未设计；不能把导向承托候选称为已经完整固定的安装架。

## 实测与假设边界

- 后续用户报告两台电机从安装面到尾部凸起均为 **57 mm**，支持按对称安装面居中布置。CAD 安装面 X±73，相距 146 mm，按两侧 57 mm 推导净距为 **32 mm**；与直接测得的 30 mm 相差 2 mm。测量精度和实物安装面间距未确定，继续采用较小的 **30 mm** 检查，不直接归因于打印收缩。
- 研究继续用 X15…26.2 与 X−26.2…−15 的盒子表示尾部占用；相对 57 mm 长度与名义安装面得到的 X±16 尾端，每侧额外向内预留 1 mm；Y±18.5、Z31.5…68.5 沿用旧电机外包络作为检查假设，并非编码器尺寸。实际凸起、接头可能超出这个范围。
- 若间隙中心偏移 c 而驱动板不跟随，最小横向名义余量为 `1.25 − |c| mm`。偏移 1.25 mm 即无余量，相等的 57 mm 报值支持居中候选，但不提供测量误差范围。调整板卡位置后应重跑全部检查。
- L298N 的 46.2 × 43.5 × 27.5 mm 为此前用户提供的整体尺寸，是否包含全部端子、散热器及焊脚仍待核对。前后导向与实际 PCB 安全接触区也待确认。
- 转向后，原来面向左右的电机端子改朝前后，现有接线预留不能原样沿用。下沿电源／控制插头、顶部散热空间与实际工具路径仍待补齐。
- 原有 L298N 布局／安装架的几何通过记录基于旧电机占位，不能作为本次实物尾部间距下的完整适配证据。

## 测量口径（两台均已反馈 57 mm）

保持电机装在 VF01 上，尺子与电机长轴平行。起点是 **蓝色支架贴着金属电机的安装面**，终点是 **朝中间伸出的最远硬质编码器／接头端部**；不计蓝板厚度、输出轴和可弯电线。照片上方电机从蓝板向下量，下方电机从蓝板向上量。分别记录两个长度，用于确定 30 mm 间隙中心，而不是再次量两尾之间的 30 mm。

## 文件与复现

- [原生布局研究](L298N-30mm-layout-study.FCStd)：两只原电机占位、假设尾部检查盒、转向板卡及导向承托候选，未加入完整周边总装。
- [审计记录](audit.json)：源模型 SHA-256、原方案／备选碰撞、候选间隙、连续扫掠、保存回读与源文件未变检查。
- [生成脚本](../../../../scripts/check_l298n_measured_gap.py)：在 FreeCAD Python 中导入并运行 `build()`；只读主总装，输出到本目录。

没有更新 BOM 或正式布局决定：本轮没有替换采购件，推荐调整尚未冻结。独立长度已补齐，沿用 30 mm 保守间隙。完整吊接／夹紧、接线和工具空间设计仍待完成；2 mm 尺寸闭合差保留为试配核对项，再输出局部试配件。

[57 mm 尺寸核对记录](dimensional-reconciliation.json)保留推导与实测差别；此前 `audit.json` 是原检查快照，未改写其几何检查输入或时间证据。
