miclle/cybertrack/hardware/procurement.md

# 硬件采购清单

核对日期：2026-10-27。商品链接及原始资料由用户提供；本表区分商品资料、已有实物／使用记录与订单状态。当前电源是辰克 5 V 电池包，P11 A110M 仅保留历史；当前控制器沿用现有面包板，不把 P07 独立台架板的购买链接当成整组订单证明。

已有[打印、基础装配和样机运行影像](../artifact/README.md)，不再统一记为采购准备阶段。未提供的订单数量、价格、实购选项和到货清点继续保留为未确认；影像不能确认各器件的商品 SKU，也不绑定完整固件／供电配置。台架分项及样机运行不等于完整电气、机械或整机验收。

历史网页核对：2026-10-23 已通过浏览器读取 P01–P07、P09–P11 共十项商品页及相关参数图、P07 技术附件和 P11 使用说明。逐项参数、来源、原图及冲突见[采购网页核对记录](procurement-web-review.md)。P08 淘宝页被站点安全策略拦截，详情未读取。网页所选项不等于订单规格；商家标称不等于实物验收。P07 的本地资料及已完成的实物／ROM 核对另见[板卡记录](components/ESP32-S3-N16R8/README.md)，当时的网页核对不替代或撤销这些证据。

## 商品记录

下列链接是已归档的来源，不表示当前在线库存、价格或选项；本次未重新核价或执行采购。P 编号保持原记录，辰克替换电源及未编号物料另列，避免覆盖 P11 历史。

| 编号 | 用户提供的名称／规格 | 商品链接 | 关联 BOM | 采购数量 | 订单／到货状态 |
|---|---|---|---|---|---|
| P01 | 大功率 MOS 管场效应管 | [京东 10228983831884](https://item.jd.com/10228983831884.html) | H14，水枪／泡泡／共用点火三路开关 | 未提供（设计需求3块） | 已有 JZ-MOS 实物照片和水枪台架；泡泡有运行影像；订单、库存及三块逐一核对未完成 |
| P02 | 继电器模块 | [京东 10230035601565](https://item.jd.com/10230035601565.html) | H14，功率开关候选 | 未提供 | 未提供 |
| P03 | MG90S 9G 经典舵机 14 克升级金属齿轮款 180 度 | [京东 10228541898631](https://item.jd.com/10228541898631.html) | H18 | 未提供 | 未提供 |
| P04 | 超声波测距模块 | [京东 10229075026760](https://item.jd.com/10229075026760.html) | H19 | 未提供 | 已有用户提供的探头尺寸；订单／到货清点未提供，未接入固件测距 |
| P05 | 电弧脉冲直流 1000KV 脉冲逆变式发生器点火线圈模块 | [京东 10229050271068](https://item.jd.com/10229050271068.html) | H11 | 未提供 | 未提供 |
| P06 | DC-DC 升压模块 MT3608 2A 升压板 | [京东 10229848918045](https://item.jd.com/10229848918045.html) | H13 | 未提供（设计需求1块） | 已有实物尺寸及调至12 V的历史台架记录；订单／数量未提供，完整负载能力未验收 |
| P07 | ESP32-S3 开发板 N16R8（Type-C 接口／已焊排针） | [天猫 1004509737151 · SKU 5996933277834](https://detail.tmall.com/item.htm?id=1004509737151&skuId=5996933277834) | H06，独立台架板资料 | 订单数量未提供 | 已有实物、照片及 USB／ROM／PSRAM 核对；当前面包板整组与该板分开识别 |
| P08 | 履带 | [淘宝 617360208971](https://item.taobao.com/item.htm?id=617360208971) | H01 | 未提供 | 样机已有履带装配与运行影像；订单、实购规格及与此商品的对应关系未确认 |
| P09 | 一体高压脉冲连发水枪 | [京东 100219050685](https://item.jd.com/100219050685.html) | H09 | 未提供 | 已有拆出枪体照片／实测尺寸、喷水台架及样机安装记录；订单数量与完整适配未确认 |
| P10 | 电动泡泡机 | [京东 100330535866](https://item.jd.com/100330535866.html) | H10 | 未提供 | 已有主体照片、更新尺寸和样机出泡影像；订单数量与完整适配未确认，见[部件记录](components/bubble-gun/README.md) |
| P11 | 历史 ANKER A110M 充电宝；120 × 73 × 31.5 mm、373 g 为原资料 | [京东 100219039159](https://item.jd.com/100219039159.html) | 原 H12，已由辰克电池替换 | 未提供 | 旧电源资料及台架保留历史；订单／数量未提供，不作为当前电源采购选型 |
| P12 | DC-DC 降压电源模块；型号待核实 | [淘宝 559262129625](https://item.taobao.com/item.htm?id=559262129625) | H14，水枪／泡泡3.7 V支路 | 订单数量未提供（当前使用需求2块） | 已有5 V输入／3.7 V输出反馈；2026-10-26用户确认两块已集成到各自枪体，完整带载能力仍待验 |
| P13 | 何健弓 L298N 电机驱动板模块 | [京东 10231029535273](https://item.jd.com/10231029535273.html) | H03，替换 DF-MD V1.3 | 未提供（BOM 需求 1 块） | 已有实物照片及用户台架反馈；未提供订单／数量 |
| P14 | 150 mL透明储液瓶；商品图下直径48.8 mm、含盖高114 mm | [京东 100222905645](https://item.jd.com/100222905645.html) | H23，清水／泡泡液独立瓶 | 未提供（设计需求2只） | 已有商品尺寸图及样机双瓶背包影像；P14订单／实物对应关系未确认，见[部件记录](components/bottle-150ml/README.md) |

[BOM](BOM.md) 中 H11 的需求数量为 2 个、H13 为 1 个、H06 当前为一套现有面包板、H09 和 H10 各为 1 套，不等于本次订单数量。P01、P12 当前用途已定：三块 MOS 分别控制水枪、泡泡、两只点火共用一路，两块降压板分别用于双枪；这些是需求／使用记录，不换算为未提供的订单数量。水枪历史台架采用 P01 在前、P12 在后，P02 仍未分配负载。

H01 需要左右各一组履带组件；P08 商品按单侧还是左右成套销售、是否包含轮组和安装件尚未确认，因此不直接将需求数量换算为下单数量。

P07 新链接替代原京东采购链接，页面标注 DevKitC-1；用户补充的板级原理图标注 ESP32-S3-COREBOARD，包内另有 V1.4 图纸，不能直接当作乐鑫官方板的同版资料。`ESP32-S3开发板.pdf` 实际为芯片规格书 v2.2，已与板级原理图分开记录。

## 当前替换电源与未编号物料

| 关联 BOM／图纸 | 已知状态 | 订单与选型缺口 |
|---|---|---|
| H12 辰克电池 | 2026-10-25 用户已替换旧电源；[铭牌及实物照片](components/ck-5v-battery/README.md)：CK18650-1234S-NP、5 V，用户尺寸116 × 70.5 × 19.5 mm | 购买链接、订单数量／价格未提供；持续／峰值输出、保护、接头用途／极性与重量待核，不沿用 A110M 的45 W／15 W／373 g |
| H15／SW1 拨动开关 | 已有[照片与尺寸](components/power-switch/README.md)，A1 为低电流请求触点设计候选 | 型号、直流额定、三脚触点关系及订单未确认，不能据外形选为主功率开关 |
| H15／SW2 执行器切断 | 用户已确认只切执行器供能、主控继续运行 | 型号、额定、安装位置、残余储能及恢复行为未验收；订单未提供 |
| H15a／SW3 外接 BOOT | 常开自复位干接点跨 GPIO0／GND 的设计需求 | 按钮型号、低电流触点、螺纹／尺寸及实物安装未确认；不计为已购买 |
| H16 现有螺丝／其他紧固件 | 冠盖4颗＋托盘4颗采用用户现有 Ø2.5／含帽长8.6／帽径3.9×厚1 mm螺丝 | 已有螺丝不等于 M2.5 机牙定型；导孔与保持力待验；其余数量按现行 BOM 核对，不叠加历史压框／嵌件 |
| R1–R6、R7–R9、F1–F7、U2／U3 | R1–R6 六路电机下拉已选10 kΩ、±1%、至少0.1 W，封装目标0603；其余仍待定 | [A1 参数清单](schematic/parameter-confirmation.md)是设计依据，未提供采购或安装完成记录；ERC／网表通过不等于元件定型或制造放行 |

当前使用[29件 Lean打印包](model/lean-print/README.md)；三块 MOS 改胶固、两块降压板在枪体内，五个旧效果板压框取消。L298N 支架采用0.57底盖承载方案，候选螺钉／螺母见[BOM H22](BOM.md)。打印件、需求数量与采购订单分开统计，历史34件及各版紧固件合计不作为现行补购清单。

## 电机与旧驱动板到货历史（2026-10-24）

以下驱动板到货与台架反馈仅属于旧 DF-MD，不转移到 P13；37R-520 的到货记录保留。2026-10-25 当前 H03 已改为[何健弓 L298N](components/L298N/README.md)，旧板退出选型并保留故障记录。

2026-10-24 用户确认 H02／37R-520 与 H03／DF-MD V1.3 已到货，并选择充电宝＋MT3608 开始首轮台架准备。未提供本次到货数量和新的购买链接，不据此关闭版本、跳线、针序或供电验证。接线前输入及单电机测试顺序见[电机台架准备](../docs/validation/bench.md)。用户随后确认有万用表，MT3608 输出已调至 12 V，电机已测试能转；独立断电手段、DF-MD 驱动及负载能力仍待核实。

## P13 驱动板替换（2026-10-25）

**替换与历史台架记录。** 当前仍选用P13；后续ct21四方向获用户确认，0.57采用28.5 mm插线包络及底盖承载支架。下方早期分项与尺寸不代替当前完整负载和接线空间验收。

用户指定何健弓 L298N 模块替换 DF-MD V1.3。商品页包含 TB6612FNG 混合详情，不能作为所选 L298N 参数依据。用户已提供实物照片并报告供电／静态关闭电压正常，一次 200 ms 空载转动后停止无异常；用户于 2026-10-25 补充长 46.2 × 宽 43.5 × 高 27.5 mm，尺寸包含范围与孔位、额定电流、定量温升及机械带载能力待补；双路空载和 BOOT 实测见台架记录，见[部件记录](components/L298N/README.md)。H03 需求仍为 1 块；本任务未执行下单，实际订单和数量未提供，不沿用旧板到货或故障结论。

## 与设计衔接

当前分配以[接线总表](../docs/wiring.md)和[电源接口](architecture/README.md)为准，低压控制已部署至 ct21；下表保留商家标称、历史局部修订与实测的区别，未确认项不因已有样机而关闭。

| 编号 | 当前记录的用途／约束 | 后续需核对 |
|---|---|---|
| P13 | 何健弓 L298N；用于左右两台有刷电机，H03 当前选型 | 核实整板供电／稳压跳线、两路使能与四路输入、3.3 V 兼容、默认关闭、尺寸包含范围／孔位／散热；旧 DF-MD 台架程序不可直接使用 |
| P01 | 成品双 MOS 模块；页面标称 DC 5–36 V、3.3–20 V 高电平触发、PWM 0–20 kHz，33 × 17 mm／4.9 g；实物 JZ-MOS 的[六类端子](components/jz-mos/README.md)已确认 | 具体芯片、实物高度／孔位、3.3 V 驱动损耗、默认状态、感性负载保护及散热条件 |
| P02 | 页面选中 1 路 5 V 红板；系列图标称光耦、高低触发可选，50 × 25 × 18.5 mm | 实物 5 V 版本与图中 24 V 丝印冲突；逻辑阈值、线圈电流、默认状态及直流感性负载能力 |
| P03 | 页面选中 MG90S、14 g 金属齿轮、180 度款；安装位置和用途未定 | 实购版本、供电、运行／堵转电流、外形、输出花键、舵盘与安装孔；不得套用同页 SG90 等其他型号参数 |
| P04 | 页面选中 HC-SR04 单芯片 3–5.5 V；通用详情标称 2–400 cm、15°、45 × 20 × 15 mm；2026-10-24 用户提供[双圆柱 Ø16、总宽 42、离面板高 10.3 mm](components/ultrasonic/README.md)，中心距推导为 26 mm | 0.26 CAD 按前脸外表面暂定高度基准，双圆柱已更新；实物面板基准与整板包络待补；通用图的 3.3–5 V／5 V 与所选版本不同；核对实物供电、ECHO 电平、孔位及用途，不默认自动避障 |
| P05 | 当前为前方双火花需求、本体在背包两侧；早期输入3–6 V，后续用户指定共用一块 MOS、5 V、单次最多5秒 | 用户于 2026-10-24 更新尺寸为 Ø25.5 × 70 mm、2 个圆柱包络预装，未补充测量依据；页面选中“1000KV”，参数表却写“400KV”，尺寸及功率单位混乱；真实封装、引线、输出及正式资料仍未核实；GPIO21低压控制已部署，A1仍保持JP2断开、U10／J9不安装，高压验收未完成 |
| P06 | MT3608 已用于历史12 V电机台架，当前仍保留该升压支路 | 页面标称输入 2–24 V、输出 5–28 V；尺寸表 36 × 17 mm 与图中 30 × 17 mm 冲突；用户后续实测37 × 18 × 6 mm，见下方尺寸补充。12 V 连续／瞬态能力、效率、散热及保护待核实，“2A”无工况条件 |
| P07 | 已收到正反面照片，用户实测 63.6 × 28.2 × 13.2 mm；双 USB 枚举和 ROM 存储识别见[实物核对](components/ESP32-S3-N16R8/physical-verification.md) | 实物 PCB 版号、稳压器／串口桥完整型号、GPIO3／IN-OUT 焊装与射频通路；无负载启动与 PSRAM 读写已通过；COM 连接／高速读取异常原因、供电能力和安装净空仍待核对 |
| P08 | 对应左右履带组件，用于车体行走 | 具体规格、单侧／成对售卖、套装内容、尺寸、材料、驱动接口与安装孔；核对与轮组、track-mount 及联轴器的匹配，不因商品链接认定尺寸一致 |
| P09 | 对应前向喷水口与脉冲喷水需求；名称按“一体高压脉冲连发水枪”记录 | 页面选中可自吸水全自动脉冲款，整枪 392 × 62 × 155 mm、约 350 mL；2026-10-24 用户拆解实测发射枪长 138.5 × 最粗处宽 33.2 × 厚 24.6 mm、带管宽 38.5 mm，前端较细，见[尺寸与照片](components/pulse-water-gun/README.md)；独立模型保持不变；历史0.18采用上仰5°，后续0.39改为15°；已有喷水台架及安装影像，完整倾斜工况及滴液倒流未验；用户于 2026-10-24 确认工作电压 3.7 V；分段轮廓、允许电压范围／电流、既定5 V→MOS→枪体内P12→3.7 V支路的带载参数、接口、扳机依赖和完整关断行为仍待核实，14 m 射程仅为商家宣传 |
| P10 | 对应前部泡泡机；用户于2026-10-24确认正面看左泡泡、右水枪，沿用自带风扇需求 | 页面选中旋转太空泡泡机充电款，整件 90 × 90 × 235 mm、USB 充电；用户于 2026-10-24 确认工作电压 3.7 V；2026-10-24 用户补充[主体尺寸与 4 张照片](components/bubble-gun/README.md)：枪口最外端 Ø31.5 mm、历史总高 35.8 mm、总长 67 mm；2026-10-26尾壳高更新为35.9 mm（不含6.8 mm薄片），承托至尾顶42.7 mm为推导；历史0.15改为正面看左侧前置泡泡枪，保留水枪所在一侧；0.18 改为整体前圆环＋后25长／6宽、前10宽阶梯槽，当时两枪上仰5°候选，后续改15°；泡泡枪用胶辅助固定，已有样机出泡影像；薄片高6.8不额外下凸，枪口底离平面4.7与原总高推导存在0.4差异，宽35.8与固定面仍为假设；主体最大宽度、端点／凸起范围与安装管线空间待测；允许电压范围、电流、液箱、风扇、倾斜限制及排液待核实 |

**旧 A110M 历史资料（2026-10-23，已替换）：** 用户补充当时 H12／P11 充电宝资料：购买链接为[京东 100219039159](https://item.jd.com/100219039159.html)，外形长 120 × 宽 73 × 厚 31.5 mm，产品净重 373 g。尺寸由用户提供；当时独立读取页面确认 ANKER A110M、74 Wh、净重标称 373 g，页面尺寸另写 119.9 × 73.4 × 31.4 mm，与现有尺寸并列保留。说明书给出 USB-C 单路最高 45 W，但多端合计仅 5 V／3 A／15 W；完整档位见[网页核对记录 P11](procurement-web-review.md#p11--h12anker-a110m-充电宝)。实际输出能力、协议协商、端口线缆空间及重量仍需实测。用户要求重充电宝放在较低位置，并确认输出口位于 120 × 31.5 mm 长侧面；具体端口 X/Z、插头与按键位置仍待测。当时 CAD 保持已认可的前下方低位平放位置，不代表已完成实物安装或稳定性验收。

MG90S 的采购记录不自动确定头舱旋转或喷水口俯仰方案；超声波模块也不自动确定避障策略。补充用途后，再同步机械布局、接口和固件需求。

后续可在本表补充所选规格、实际数量、含税单价、订单日期及到货核验；不记录账号、收货地址、支付信息等个人资料。

## 2026-10-24 降压与 MOS 台架补充

**历史记录。** 以下保留首次测试条件；后续已有5秒喷水／自动停止、面包板集成和并发分项，见[MOS台架](../docs/validation/bench.md)与[集成记录](../docs/validation/bench.md)。这些结果不转移为辰克电池或整机四路负载验收。

P12 的两张用户附件、端子和选压说明已保存至[降压板记录](components/dc-dc-buck/README.md)。商品页被站点安全策略拦截，未读取。该阶段实测反馈为 5 V 输入、3.7 V 输出，不是最初讨论的 3.3 V；负载有无、输出电流和持续时间尚未提供，不认定带载能力通过。用户选择首测 3.7 V 水枪，并确认 ESP32 已与 DF-MD 断开、引脚无连接线。MOS 端子资料补读及分阶段执行见[MOS 台架记录](../docs/validation/bench.md)。

用户进一步澄清水枪台架供电顺序为 **5 V→P01 MOS→P12 降压至 3.7 V→水枪**。MOS 接在降压板前，撤销此前 MOS 由 3.7 V 供电的假设；该澄清不改变器件数量，不表示已完成带载验收。

## 液路使用方式补充（2026-10-24）

**历史需求确认，现行沿用分支与未验证项。** 此处液路护口不等于后来取消的上下独立电气线束护口。

用户确认P09水枪和P10泡泡枪均可自吸，整机0.28统一采用顶部插入吸管，取消后部及舱侧穿管。该确认属于用户输入，不改写商品页原始规格证据；顶部护口、固定、通气防溅件和泡泡管真实规格仍需选型／试配，不新增外置泵采购项。

## 2026-10-25 成品储液瓶候选（P14／H23）

**历史商品资料。** 样机已有双瓶背包装配影像，但未据此确认P14订单、材料或逐项尺寸／保持力验收。

用户指定两只150 mL瓶子，补充[京东100222905645](https://item.jd.com/100222905645.html)及[商品尺寸原图](components/bottle-150ml/reference/jd-100222905645-150ml-dimensions-20261025.png)。图示规格为150 mL透明，下直径48.8 mm、含盖高114 mm、瓶口内径30 ± 0.2 mm、贴标高82.4 mm、总重量18 ± 1.5 g；均为商品图标称，未实测。网页本次不可访问，未核验在线选项或页面参数；品牌、材料、订单及到货状态仍未提供。

48.8 mm仅标注为下直径，不能据此确认整瓶／瓶盖最大外径；贴标高不等于已确认的夹持长度。0.35完整圆柱包络保持原建模假设，本次仅更新文档，不重建CAD。来源和原图哈希见[部件记录](components/bottle-150ml/README.md)；螺钉、软垫、瓶盖接管与补气防溅件仍为候选，详见[BOM H23](BOM.md)。

### P06 尺寸补充（2026-10-25）

用户实测 MT3608 长37×宽18×厚6 mm，独立包络及回读见[部件记录](components/MT3608/README.md)。用于 L298N 的12 V电机支路；本次不新增数量、订单或电气验收。
