miclle/cybertrack/docs/mechanical.md

# 机械设计基线

当前0.50将点火模块桶座与完整环带合并到双瓶背包，移除顶部倒L压件及分体紧固件，见[一体收纳说明](effects-mount.md)。保留0.49将左右镂空底座侧框后端各延长30 mm，见[后伸记录](#049-左右镂空底座侧框后伸)；0.48已更新[新电池、前舱入线与第三块MOS](ignition-routing.md)，原0.47外沿路线撤销；0.42已合入[背包外侧夹持与薄承板固定](effects-mount.md)，保持前斜坡外表面；保留[0.41面包板浅托盘](breadboard-tray.md)：整组100×85×36包络、侧耳浅托盘，头部外形保持。沿用[0.39双枪上仰15°](#039-双枪上仰15)，保留[0.37头舱整体上移25 mm](#037-头舱整体上移25-mm)。下文各历史修订中的绝对高度保留当时基准；当前头舱各坐标较0.36增加25 mm，现行接口位置见[装配说明](assembly.md)。

## 外形与布置

CyberTrack 采用具有角色感的机器人轮廓：左右双履带作为行走底座，分层固定颈架托起切面头盔，头舱下方颈架左侧布置朝前发射枪，后背共用壳体整合两个液体区，两路吸管均从液舱顶部插入，经两侧连接前置双枪；正面看左泡泡、右水枪；新5 V电池包暂沿用前下方平放，头舱电子区与后背液体区分开。前方效果线位置及前舱入线通孔为机械候选，完整高压接口未定。

首版采用固定朝前喷水口和固定头舱是当前假设；MG90S 的具体用途未定，旋转／俯仰机构待明确。初步概念允许用明确标注的空间分配假设探索外形，但不据此冻结外壳、接口或打印文件。

## 部件资料与布局基准

布局输入为 [37R-520 电机资料](../hardware/components/37R-520/README.md)、[track-mount 安装件](../hardware/components/track-mount/README.md)和[采购清单](../hardware/procurement.md)中各模块的实物尺寸。整机长度、宽度、高度、履带间距和电机轴高尚未定版，需在部件资料补齐后确定。

设计坐标约定为 **X 向左、Y 向后、Z 向上**，前方为 −Y；尺寸单位 mm。左右名称以车体朝前时为准。独立部件导入总成时显式记录放置变换，不把部件局部坐标当作整机坐标。

track-mount 的参考记录为 65 × 38 × 11 mm，测量值、推导值与缺口形状假设见其尺寸文档。该尺寸不是底盘净空或整机包络，实物试配仍需单独完成。

## 部件与安装约束

- **履带**：保持每条履带本身的尺度与轮组相对关系；新布局如需改变左右间距，应整体平移模块并同步电机安装，不能拉伸履带造型。实购物料的齿形啮合、张力和承载能力待验证。
- **电机**：37R-520 的偏心出轴、前安装孔、编码器尾部和线缆空间都是约束。图纸标称与尺寸占位不能直接用于加工定版。
- **track-mount**：保留独立模型及尺寸记录，区分测量值、计算值和缺口形状假设；先做试配。
- **底盘／检修盖**：根据安装基准、装配顺序和维护路径设计机器人承载底板、液体仓、电子仓和上壳。
- **联轴器／紧固件**：图片中的名义尺寸不是确认过的配合规格；螺纹深度、啮合量、工具路径和防脱待测。

## L298N 驱动板尺寸输入（2026-10-25）

用户提供何健弓 L298N（H03／P13）模块尺寸：**长 46.2 × 宽 43.5 × 高 27.5 mm**，见[部件记录](../hardware/components/L298N/README.md)。0.33 独立包络按原始长宽高建模，整机竖装使长沿 +Z、宽沿 −X、高沿 −Y；尺寸是否包含散热器、焊脚及端子突出部分待确认。孔径／孔距待实测，0.34 已增加可拆托框及线缆／通风／维护候选空间；整机位置为 X±21.75、Y−4…23.5、Z32…78.2 mm，实物安装未验收。

## 扬声器尺寸输入（2026-10-24，历史独立布局）

0.40改用整组面包板包络，下列独立占位、距离及专项仅为历史证据，不证明当前组内适配。

用户提供扬声器尺寸：**长 69.5 × 宽 31.5 × 高 16.5 mm**，同步记录于 [BOM H08](../hardware/BOM.md)。CAD 的 `AudioModule` 已替换为该扬声器矩形包络，长沿 X、宽沿 Y、高沿 Z；保留原音频区的 XY 中心及 Z146 底面，范围 X±34.75、Y−72.75…−41.25、Z146…162.5 mm。

[扬声器专项检查](../hardware/model/archive/reports/speaker-fit-audit.json)确认包络完全位于头舱内，无实体或预留空间重叠；距托板 0.5 mm、头壳最近约 2.482 mm、前部面罩 5.25 mm、上方剩余电子占位 5.5 mm、天线审查区 3.15 mm。以上为 CAD 名义距离，安装孔位、线缆及接口突出范围、固定垫与声孔仍待确定；不代表实物安装或声学验收。新包络完全包含于旧音频占位内，未扩大原维护路径包络；本次没有重新执行整机拆卸路径检查。

## 超声波模块尺寸输入（2026-10-24）

用户提供双圆柱 **Ø16 mm、总宽 42 mm、离面板高 10.3 mm**，见[原始尺寸与结构化记录](../hardware/components/ultrasonic/README.md)。按等径圆柱并排、42 mm 为两端外沿总宽推导，中心距 **26 mm**、圆柱间净距 **10 mm**。10.3 mm 保留用户“离面板高度”的定义；基准面尚未明确，不作为整模块总厚度。

0.26 CAD 已用 Ø16 × 10.3 mm 双圆柱替换旧造型，占位中心 X±13、Z163 mm。后端暂按前脸外表面 Y−81 mm，前端 Y−91.3 mm；此面板基准是布局假设。原孔补回并改为双 Ø16.6 候选孔，单边间隙 0.3 mm；状态条移到 Z172.5…173.5 mm。详见[专项检查](../hardware/model/ultrasonic-fit-audit.json)。PCB 长宽厚、探头相对板边位置、安装孔及背面／接头空间仍未建模，整板固定与实物安装待核对。

2026-10-25 补充[0.41 超声波与面包板集成](ultrasonic-head.md)：借用通用45×20平面预算，增加候选1.6 mm PCB、4 mm背面、接头与Ø4线束空间。向后10 mm接头与面包板冲突；假设探头内退3.5 mm、接头向上，静态可共存。整盘拆出还需托盘前缘中央49×2 mm让位并先收置线束。头壳、孔位、冠盖外形保持，探头突出量改变。原始部件尺寸不改；候选已合入0.41，但不能替代实测板型、安装基准与固定设计。

## 采购网页新增尺寸输入

2026-10-23 [网页核对](../hardware/procurement-web-review.md)得到商家尺寸：P01 MOS 33 × 17 mm（高度缺失）；P02 一路红板 50 × 25 × 18.5 mm、Ø3.1 孔、孔距 44.5 × 20.5 mm；P04 通用 HC-SR04 图 45 × 20 × 15 mm（与所选单芯片版对应待核对）；P06 MT3608 长度 30／36 mm、宽 17 mm 两种图表冲突。当时均未替换实物安装基准。2026-10-25 MT3608 已有用户实测37×18×6 mm，当前包络按实测更新，见[独立部件](../hardware/components/MT3608/README.md)。

P09 完整水枪长 392 × 宽 62 × 高 155 mm、约 350 mL；P10 完整泡泡机 90 × 90 × 235 mm。这些是带壳玩具尺寸，不是拆出的泵、风扇或液箱尺寸，不能装作已匹配旧Ø32×70 mm液体占位（0.28另扣除Ø8吸管通道，0.35已用150 mL成品瓶包络替换）。内部组件包络、独立控制和拆装方案未明确前，不冻结背包／前脸或打印文件。

P11 页面尺寸 119.9 × 73.4 × 31.4 mm、净重 373 g；现有用户尺寸和 CAD 为 120 × 73 × 31.5 mm。保留两种来源，本次不改 CAD；应核对实物最大包络、线缆和净空，尤其网页宽度比当前包络大 0.4 mm。

## 水枪拆解实测输入（2026-10-24）

用户拆出发射枪实测长 138.5 × 最粗处宽 33.2 × 厚 24.6 mm，带水管宽 38.5 mm；前端较细，分段尺寸未测，见[部件尺寸与照片](../hardware/components/pulse-water-gun/README.md)。这些是发射枪尺寸，不是储水区尺寸；0.12 已独立安排发射枪与喷水储水区并更新软管候选，详见文末；固定、线尾和实际软管弯曲空间仍需另加；长度端点、宽厚对应面、接口和孔位仍需核实。

## 泡泡枪主体尺寸输入（2026-10-24）

用户提供枪口最外端圆形直径 **31.5 mm**、主体总高度 **35.8 mm**、总长度 **67 mm**，见[部件记录、结构化尺寸与 4 张原图](../hardware/components/bubble-gun/README.md)。枪口直径不等于主体最大宽度；尺寸端点及凸起包含范围、安装基准、管线弯曲与插拔空间仍待核实，不从照片比例推算。该主体与完整商品及独立液箱分开记录，尺寸归档时未修改 CAD；随后新增0.14主体候选，见下节，实物适配仍未验证。

### 0.14 历史尾部主体候选（已由0.15替代）

已生成[独立泡泡枪模型与专项记录](../hardware/components/bubble-gun/README.md)，按原始三项尺寸建模；宽35.8及内部轮廓为假设。原出口端中心 (24,91,76) 的完整审查包络与7个对象干涉；保留液舱，改为外置枪口端中心 (24,153,81)，朝+Y。完整空间 X6.1…41.9、Y86…153、Z60.95…96.75 无超阈值重叠，最近0.95 mm；后抽100连续扫掠与其他17组维护路径对它的检查通过。整机长增至282 mm。

本轮未设计固定件或真实线管，原后护甲开孔保留，密封与排液待设计。结论只适用于假设宽度的主体空间，不是实物安装通过。

## 后续建模顺序

1. 充电宝外形已知 120 × 73 × 31.5 mm，产品净重 373 g（用户转述商品参数，见[采购记录 P11](../hardware/procurement.md)）；继续核对实物重量，补其端口及线缆空间；补齐履带、升压板、水枪、泡泡机及音频件尚缺的尺寸、重量和安装基准；何健弓 L298N（P13）已有上述用户尺寸，继续补尺寸包含范围、重量和孔位。
2. 先放双履带及动力组件，再放重件、液体容器和模块维护路径；检查满液与空液两种重心。
3. 角色外壳围绕真实组件布局生成，喷水口及头舱不进入履带运动区，后出风口远离电子仓开口。
4. 水箱与泡泡液容器独立，提供加注、拆洗、排液和软管弯曲空间；评估倒车、坡度和转向时的溅液路径。
5. 检查电机装入、履带固定螺钉工具路径、检修盖拆出与电源拔插，不只检查静态碰撞。
6. 保存新整机后重新回读，检查几何有效性、包络、干涉和装配路径；随后才生成打印候选。

## 初步整机模型（2026-10-23）

已生成 [CyberTrack.FCStd](../hardware/model/CyberTrack.FCStd) 及[视图和验证记录](../hardware/model/README.md)。双履带、电机、轴、联轴器及安装件来自独立动力部件包，左右分别整体沿 X 平移 +14／−14 mm，内部相对位置和尺度不变，旧底盘与检修盖不进入新模型。原始混合参考和旧提取脚本已从项目移至系统废纸篓，可恢复；保留忽略规则，生成器不依赖原目录。

造型 0.6 保留切面头盔、暗色双探头、分体眉甲和颊甲，将头壳宽度由 136 增至 164 mm、前端向 −Y 延伸 16 mm；头颈整体下沉 4 mm，头壳底面 Z=136 mm，喷水口调整至 X=44、Z=145 mm。颈部仍采用固定开窗双层支架、阶梯横梁套和后斜撑；前舱上缘内收，前部顶盖降低 20 mm，侧框与前护甲随低轮廓重建。后脑保留内嵌护框与封闭浅槽饰条并匹配新宽度；沿用共用切面背包、中央脊甲和斜面底座后护甲。顶部两个封闭造型翼只是外观，不是火花模块外壳、电极或安装接口。参考与取舍见[造型方向](style-direction.md)。

0.6 保留已认可的低位电源布局：120 mm 沿 X、73 mm 沿 Y、31.5 mm 沿 Z，在 X±60、Y−96…−23、Z33…64.5 的前下舱平放。左右动力整体外移各 14 mm，电机、联轴器和安装耳同步；前舱下部宽 132 mm；上缘两侧切斜收窄，前缘顶盖 Z69…72，向颈架 Z90…93、后背 Z94…97 过渡。两个液体假设包络各 Ø32 × 70 mm，保持 X=−24／+24、Y=49、Z43…113；电子区原位保留，音频区由电源上方移入头舱 X±36、Y−75…−39、Z146…167，保留 72 × 36 × 21 mm 分配。旧电源假设包络不再使用。除充电宝外形外，未知模块尺寸仍是设计分配，见[模型说明](../hardware/model/README.md)；真实一体模块可能要求重新调整布局。没有实现液路穿过颈架、线束、密封、舵机或活动关节。颈部的轴套和斜撑均是固定概念结构，套筒不代表新增液压或电动推杆。

0.7 保持上述头壳、前脸、颈架、前舱和五个设备包络原位，重做中央检修盖为阶梯隆起装甲，增加向外下倾的左右顶甲、低矮中央脊甲及封闭后部错层饰片。侧面原护板上叠加上、下太阳穴护甲及半环外护弧，保留圆形内芯尺寸。所有新增外观均位于原整机宽 228 × 长 202.5 × 高 203 mm 范围内；头部最大宽度约 179 mm、头壳宽 164 mm、壳底 Z=136 mm 不变。装甲分缝和饰片不代表已设计的密封或通风结构。

0.8 在上述外观内深化检修结构：电源下取托盖及独立插头检修小盖、整体上取冠盖和设备托板、独立补液盖及 Ø14 通道、中央干区线束和侧边喷水软管。充电宝的长侧面有输出口为用户新确认信息，设计朝后；具体端口位置与插头仍待实测。完整操作顺序、紧固候选和路径检查范围见[结构与装配候选](assembly.md)。

充电宝包络中心仍为 Z=48.75 mm，电源与五个原设备占位未移动，整机外包络不变。新的孔、支座、护口及补液通道是装配候选；连续拆装扫掠、手部／工具空间、实际重量、满／空液稳定性、液体隔离、密封及真实器件适配仍未通过。

## 主控实测包络输入

ESP32-S3 到货板由用户实测为含天线总长 63.6 × 板宽 28.2 × 焊针后总高度 13.2 mm，见[实物核对](../hardware/components/ESP32-S3-N16R8/physical-verification.md)。后续主控实体布局采用该整板包络，另外预留固定、USB 插头、线缆弯曲和射频净空；不把原图纸 63.39 × 27.94 mm 当作实物外形。该数据不等于主控／驱动／电源共用电子分配区尺寸；0.9 保留原电子分配区，尚未用该实测数据建立独立的主控安装结构。

## 0.9 电弧模块预装包络

按用户于 2026-10-24 指定的 Ø20 × 80 mm 暂定外形，在头舱左右各放置一个圆柱。轴线沿 Y，起点分别为 (±68.5, -66, 158)，末端 Y=14；两包络的 Z 范围为 148…168。此尺寸不是厂商确认或实物测量。顶部脊翼仍为装饰，不是电极。

为保持托板上取，主托板宽度由 118 调整为 116 mm，左右边缘各收窄 1 mm；四个原固定孔中心不动，主控和音频分配区及充电宝位置不动。模块占位与托板通道的几何余量仅用于碰撞检查，不是电气安全间距。先拆冠盖和托板，再将左右占位各向中间移动 24.5 mm、上提 85 mm；该动作不含固定件和引线。模块夹持、独立隔舱、绝缘、引线出口与实际检修均未设计定版。

## 0.10 顶部效果位置

两条后掠脊翼改为带封闭凹槽的护框，左右中心线 X=±51.5，单处外包络 16 × 47 × 11 mm，Y=-16…31、Z=192…203。槽平面 8 × 25 mm，浅色衬面配橙色端部标识，形成可辨认的顶部效果区域。仅局部调整侧顶甲与护框的接合面；头身比例、整机外包络、原固定孔位、内部双模块及低位电源不变。

全部新增件随冠盖整体拆装；凹槽、标识和护框尺寸均为造型分配，不是电极或放电间距，不新增高压引线及驱动。材料、固定工艺、防护与绝缘未定。图纸新增第 13 页的局部轴测、俯视尺寸和维护说明。

## 0.11 实测主控与小托架

主控按实测63.6 × 28.2 × 13.2 mm横向放置，USB朝−X、天线朝+X，范围X−39.6…24、Y−23.1…5.1、Z163.6…176.8。PCB、针排及端口层高为设计假设，不作为完整实物重建。原主控／驱动／电源大占位拆分为独立主控和前上方70 × 25 × 13 mm待定区；后者尚未证明可装入实际驱动、升压和开关板。音频区原位不动。

大托板原四孔保持，后缘局部扩至Y=17，新增四柱支承小托架。两排母座候选承接焊针，增加带0.5间隙的可拆防脱压架，不在开发板上增孔。母座／针排只采用图纸排距，不假定触点与机械接口已经匹配。直头USB、尾线导向、天线审查区和拆卸顺序见[装配说明](assembly.md#esp32-s3-主控托架与维护)。

全部外观零件、低位电源、履带、音频及电弧模块保持原位；天线与USB服务空间独立于实体碰撞检查。图纸第14–15页补主控总包络、固定候选、局部分解及服务空间。尚需实测PCB面高度、排针长度／排距、USB中心与插头包络、天线边界和实际RF通路，再做母座与防脱试块。

## 0.11.1 电弧模块尺寸修订

用户于 2026-10-24 将外形更新为直径 25.5 mm、长度 70 mm，替代 0.9 的 Ø20 × 80 mm 占位，未补充测量依据。两个模块保留原轴线 X=±68.5、Z=158、前端 Y=-66，长度沿 +Y，末端变为 Y=4；Z 范围 145.25…170.75，X 范围分别为 55.75…81.25 与 −81.25…−55.75。

新包络与头壳相交，右模块另与两处 USB 线尾审查区相交约 6.485 mm³；原静态检查、电子托板／左右模块／两路 USB 共五组拆卸路径及主控服务空间检查未通过；旧版本的通过记录不适用于新尺寸。0.11.1 仅更新尺寸和证据，不修改头壳、托板或其他部件；该版布局及拆卸路径待重新设计。固定、引线和通电集成仍未设计。

## 0.11.2 双模块布局与拆卸路径

保留 Ø25.5 × 70 mm，两轴线改为 X=±65.5、Z=156.5、Y=-66…4，各向内移 3 mm、下移 1.5 mm；X 范围为 52.75…78.25 与 −78.25…−52.75，Z143.75…169.25。主托板宽 116 → 104 mm；四个固定点及内部支柱由 X±55 改为 X±49.5，Y=-30／0 不变，以保留托板上取通道。主控与 USB 审查区、音频、低位电源及外轮廓保持不变。

在先移去冠盖、断线／拔 USB、移去设备托板之后，每只模块先抬升 2 mm，向内平移 24.5 mm，再继续上提 83 mm；总上提 85 mm。先抬升用来避开留在下壳上的托板支柱。双模块各检查 24 个离散姿态及三段裸圆柱连续平移扫掠，另一只模块保留作障碍物。静态、USB 线尾审查、13 组维护动作共 184 个离散姿态及这两条连续扫掠通过 CAD 检查。其他维护组仍仅为离散姿态；模块夹持、引线、工具空间、结构强度与实物操作尚未验证。

本轮原生模型最短几何距离：两模块到头壳均为 0.75 mm，右模块到两处 USB 线尾审查区均为 0.55 mm；这些数值未扣除实物尺寸公差、夹具或受力变形，也不是电气安全间距。

## 0.12 水枪实测包络与布局

[独立水枪模型](../hardware/components/pulse-water-gun/PulseWaterGun.FCStd)依据用户实测长 138.5、最粗处宽 33.2、厚 24.6、带管宽 38.5 mm 建立；前段较细，分段长度、喷嘴和接头形状均为示意假设，未从照片反推接口尺寸。矩形最大包络沿全长单独检查，不利用假设的缩径判定通过。

原前脸喷口位置 (44, -89, 145) 的两种横截面朝向均与头壳、音频区、托板、左侧电弧模块等相交。0.12 候选将总成放在头舱下方、颈架左侧：喷嘴端中心 (52, -117, 117)，前方 −Y，长沿 Y、宽沿 X、厚沿 Z、接管朝 +X；最大包络 X35.4…73.9、Y−117…21.5、Z104.7…129.3。此朝向和长度端点是布局假设，安装前需核实。

取消原短喷口并封回前脸相关开孔；软管沿颈架前下方横穿至水枪侧面，绕开本地停止按钮占位。充电宝、履带、主控、音频、电弧模块和托板位置不变。含水枪整机包络为宽 228 × 长 213 × 高 203 mm，比 0.11.2 向前多 10.5 mm。

最大包络无超阈值重叠；最近几何距离为颈架端盖 1.40 mm、背包壳约 2.53 mm、头壳 6.70 mm，不含管路连接面，不是制造或电气安全余量。断开软管及未建模引线、释放待设计夹持后，沿 −Y 抽出 150 mm 的完整包络连续扫掠通过；其余 13 组维护动作的整段包围盒扫掠对水枪包络也通过。静态、USB／天线及 14 组 192 姿态检查通过，详见[模型记录](../hardware/model/README.md)。

固定支架、引线、软管内外径与真实弯曲半径、测量误差、密封和承载仍未确定；当前是空间布局候选，不是完整可安装总成或打印定版。

## 0.13 水枪托架、线管预留与拆装（历史基准）

当前姿态见文末 0.18；以下尺寸按上仰前模块坐标表达。

为加入夹持结构和尾线转弯，水枪相对 0.12 向左外移 3 mm、向前移 12 mm，喷嘴端中心改为 **(55, -129, 117)**。最大带管包络 X38.4…76.9、Y−129…9.5、Z104.7…129.3；整机宽 228 × 长 225 × 高 203 mm。原始部件 FCStd、STEP、照片及部件回读保持不变，水枪在整机中仅更新刚体放置；主控、托板、电弧模块、音频、充电宝和履带不移动。

固定候选采用前开口托架、两道侧拆压盖和软垫。托架底板厚 3 mm（Z100.7…103.7），左肩梁新增两个 Ø10 一体立柱，基座螺钉中心 X42.5、Y−60／−18；两个 M3 级螺钉将托架固定到立柱。压盖中心 Y−62／−10，各用一个朝外操作的横向 M3 级螺钉；内侧插在压唇下，松开后沿 +X 抽出。上、下垫各 1 mm，内侧垫 0.6 mm，均为未压缩的名义接触；不在水枪原壳钻孔，也不采用照片中用途未知的孔。

压盖与上垫侧抽通道名义间隙 0.2 mm，后止挡距枪尾 0.5 mm。后止挡下托片保持 3 mm 厚，与枪底留 1 mm；前向保持仍依赖压盖软垫摩擦，夹紧力、脉冲载荷、防滑、软垫耐水和打印公差未验证。螺钉与嵌件只有简化几何，长度、螺纹、材料、嵌入工艺和紧固扭矩未定。

水管外径暂按 4 mm、中心弯曲半径 8 mm，以相切直线／圆弧表达，另检查直径 8 mm 的路线空间。路线改从颈架前下方 Y−80、Z99.5 横穿，在枪外侧接到示意接头；湿舱通过孔候选直径 9 mm。侧接管另留沿 +X 退出 30 mm、直径 16 mm 的操作包络。

尾线束暂按 Ø3、中心弯曲半径 8 mm，从枪尾向后再转至外侧，另留 Ø8 路线空间。候选插头包络为 16 × 10 × 10 mm，沿 +X 拔出 16 mm；尾线开放导向鞍有扎带槽，扎带和实际抗拉方式待选。路线预留在导向鞍处允许有意夹持区重叠，实际 Ø3 线束仍单独检查；不能据此证明抗拉。

拆卸顺序：断电排液 → 断开水管和尾线插头、释放导向鞍扎带 → 两颗压盖螺钉向 +X 退出 20 mm → 两道压盖连上垫向 +X 抽出 50 mm → 枪体沿 −Y 抽出 150 mm。若需拆空托架，先从前方用短臂内六角拆下两个基座螺钉，再上提 2 mm、向 +X 移出 60 mm。压盖批头预留 Ø10 × 30；基座内六角预留端部 Ø3、杆部 Ø6、前伸臂 40 mm，仅覆盖工具杆，不包含手掌和把手转动。

当前 603 对静态候选、17 组共 224 个离散维护姿态、USB／天线、水枪最大包络、8 项线管／工具服务空间均通过 CAD 检查。水枪前抽、两颗压盖螺钉和两组压盖／上垫连续扫掠，以及空托架分材料块的保守连续扫掠通过；其余 13 组维护动作对水枪最大包络的整段包围盒检查通过。线管柔性变形、手部可达、夹持强度、密封和实物操作均未验收，详见[整机回读](../hardware/model/readback.json)。

## 0.18 双枪上仰与整体圆环

正面看左泡泡、右水枪，两枪采用上仰 5° 候选，水枪旋转后整体前移 10、下移 4 mm 避让头壳。泡泡枪口中心 (−55, −126.65, 115.75)，水枪口中心 (55, −137.16, 122.61) mm；朝前方向为 (0, −0.996195, 0.087156)。肩梁承托面与紧固孔随倾角重建，储液端保持，枪侧软管重接。独立枪体资产不变。

[部件与固定说明](../hardware/components/bubble-gun/README.md)记录整体环孔径 34、外径 39、厚 3 mm，径向间隙 1.25，无分缝和前环螺钉；保留两颗基座紧固。后槽名义 6×25、前宽 10，净宽 6.4／10.4，前段长 19 为假设；增加槽端导入斜面和前后止挡。槽底垫 0.6。用户使用热熔胶／胶水辅助固定，胶点保持可清除并避开内部运动件；胶材、兼容性及保持力未验证。

先断电排液、清胶、断开插头和软管，再在模块坐标中绕圆环中心抬尾 15°、后退 10、上抬 3、向 −X 移 90；反向安装。主体路径检查 102 个离散姿态（转动 0.5°、后移／抬升 0.5 mm、侧移 2 mm），不作为连续转动证明。空底座卸两颗螺钉后沿倾斜底板法向抬 6、向 −X 移 90；螺钉与底座另做保守连续扫掠。前环不需要工具。

泡泡管 Ø4、尾线 Ø3、中心 R8，各留 Ø8 空间；接管沿模块后方拔 25，插头向 −X 拔 16。水枪仍按完整最大包络沿枪轴前方取出 150；双压盖侧拆方式保持。停止按钮前方 Ø12 指端空间保持，不包括整手。所有装拆位移均随所属模块坐标变换，世界位置见报告 `gun_pitch`。

平放时枪口底离平面 4.7 mm 是用户测量，薄片 6×25×6.8 不向下额外凸出；31.5+4.7=36.2 与原总高 35.8 的 0.4 差异保留。倾斜后不将 4.7 当作世界竖直间距。前底轮廓、薄片偏置、真实宽度、工作倾角、出泡／喷水、滴液倒流、胶粘和结构强度均待实测。

检查数量与结果以[当前回读](../hardware/model/readback.json)为准；CAD 检查不代表制造或实物装配验收。

## 0.19 移除旧后部滴液唇

泡泡枪前置后，按用户确认移除旧后向出口下方的滴液唇，并取消后护甲对应布尔切槽，恢复该处连续表面。后部液管通孔、前置双枪及线管保持原布局；此修改不构成湿舱排液设计或密封验证。前部停机滴液／倒流和后部湿舱最低点排液仍待验证，变化范围见[逐对象核对](../hardware/model/archive/reports/rear-drip-removal-audit.json)。

## 0.20 后护甲小型穿板孔

旧后向泡泡出口 Ø31 圆孔补回，仅留同轴 Ø9 液管穿板孔候选：轴向 +Y，中心 X24、Z76，护甲 Y74…82 mm。现有候选 Ø4 液管和 Ø8 路线预留不变，孔壁到路线预留单边余量 0.5 mm；孔径不是已选护套或密封件的安装规格。两枪与液舱保持；实际管径、护套装配、密封、防磨与湿舱排液仍待验证。见[逐对象及穿孔检查](../hardware/model/archive/reports/rear-hose-port-audit.json)。

## 0.21 后部遗留清理与对称切面

泡泡液舱侧壁旧 Ø25 出口收为同轴 Ø9 管孔候选，轴向 +Y、X24／Z76；外护甲 Ø9 孔及液管路线保持。液舱管孔是几何预留，接头、密封和防磨未定。后底座移除单侧 `RearBaseInset` 与三条 `RearBaseLouver`，补回对应护甲凹槽，使主造型切面对称；单侧功能管孔保留。后脑、上部双嵌板、中央脊甲及底部饰条保持。

生成代码取消旧泡泡出口短颈、扩口、护框的先建后删流程及旧枪位重算；当前装配不再维护已退出的后向出口。当前变化见[后部清理核对](../hardware/model/archive/reports/rear-symmetry-audit.json)，历史布局证据仍保留在历史报告。

## 0.22 按裸枪实测截面收紧支架

夹持尺寸采用裸枪最粗处 **宽 33.2 × 厚 24.6 mm**，总长仍为 138.5 mm；**带管宽 38.5 mm 只用于管路和外部避让，不作为夹具宽度**。保留现有双枪上仰 5°、水枪枪口中心 (55, −137.16, 122.61) mm、安装柱及管线位置。

上仰前的模块坐标中，外侧夹壁由 X77.5 收至 X72.2，压盖及横向紧固件同向收进 5.3 mm。两侧硬壁净距 34.4 mm，左右各贴 0.6 mm 软垫后净距为 33.2 mm；上下硬面净距 26.6 mm，各贴 1 mm 软垫后净高为 24.6 mm。主底板由宽 44.7 收为 39.4 mm，压盖由宽 45.5 收为 40.2 mm；尾线导向支臂仍向外延伸，不把其外廓计作夹持宽度。两道夹持带中心仍为 Y−62／−10，底板仅承托粗段，喷嘴和前端接管不被夹住；粗段起止和实际接触面仍需实测。

校核分开进行：完整 138.5 × 33.2 × 24.6 mm 裸枪长方体检查夹具及整机；完整 138.5 × 38.5 × 24.6 mm 带管长方体检查夹具以外的整机障碍，示意接头另查。前抽路径分别以裸枪长方体、接头包围盒做连续扫掠，并保留带管长方体对外部障碍的连续扫掠。该结果不证明未知接头位置或任意沿程 38.5 mm 宽截面都能穿过夹具；前端接头轴向位置是照片建模假设。

两道夹持带均从保存几何回读软垫间宽 33.2、高 24.6 mm。侧拆压盖、枪体前抽、空托架拆卸及线管／工具预留重新检查，结果见[整机回读](../hardware/model/readback.json)。软垫按未压缩名义接触建模，未把零间隙当作已实现预紧；材料、公差、夹紧力、反复拆装与带液防滑仍需试块验证。旧 0.18 支架 STL 是历史试配件，不包含本次收窄；该试打包及专用导出脚本已于 2026-10-25 移除，可从 Git 提交 `b83c388` 查阅。当前支架须按现行模型重新导出并验证。

## 0.23 水枪底部双面软胶固定

本节为历史记录，挡板与水管按下文 0.24 更新。

用户选择用双面软胶直接固定水枪底部。取消两道侧拆压盖、横向螺钉／嵌件、压盖工具空间、高夹壁与上／侧软垫；保留开放式底托、两处后定位挡、尾线导向鞍及两颗 M3 级底托基座螺钉。基座螺钉只固定底托，不锁住枪体；后挡仅定位，枪体保持力由胶粘承担。

底托主板 **宽 35.2 × 长 74 × 厚 3 mm**，相对 33.2 mm 裸枪宽度每侧外伸 1 mm；尾线支臂另计。两片胶区各暂按 **31.2 × 20 × 1 mm**，模块坐标中心 Y−62／−10，避开基座螺钉的 Ø6 操作孔。1 mm 是厚度假设，未选胶带型号；参数 `ADHESIVE_THICKNESS` 改变底托高度与安装承托面以保持枪位，改厚度后须重新检查。两胶区与示意枪底名义接触面积约 595.73／598.82 mm²，这只是 CAD 接触面积，不是粘接强度。

现有水枪位置、5°上仰、泡泡枪、后部结构和线管路线保持。拆卸顺序为：断电排液 → 断管断线并释放导向鞍 → **充分解除底部粘接** → 沿倾斜底板法向抬起 2 mm → 沿枪轴前方取出 150 mm。若拆空底托，再卸基座两螺钉，沿底板法向抬 2 mm、向 +X 移出 60 mm。脱胶方法、剥离力、工具及手部可达没有通过本次几何检查。

完整 138.5 × 38.5 × 24.6 mm 带管最大矩形对底托与整机进行静态及两段连续扫掠，不再需要给压盖单独排除宽度。当前 727 对静态检查、16 组 232 个离散维护姿态、主控／双枪专项均通过，水枪的 6 项线管／基座工具空间和空底托保守连续扫掠通过。胶的真实厚度、表面适配、耐水、温度、脉冲载荷下保持力及重复拆装待实测；不能把底托无碰撞当作固定性能通过。旧带压盖 STL 和 0.22 检查记录仅作历史参考。

## 0.24 左右定位挡板与外侧托管座

用户要求保留左右挡板，底部继续采用双面软胶，不恢复压盖、横向紧固或侧垫。两对挡板位于模块坐标 Y−62／−10，各长 12、高 20、厚 2 mm；净宽 **34.4 mm**，相对实测 33.2 mm 枪体每侧留 **0.6 mm**。主底板调整为 **38.4 × 74 × 3 mm**；胶厚仍暂按 1 mm，枪位与 5°上仰保持。

用户新提供水管外径 **5 mm**。在外侧前挡板增加一体托管座：槽径 **5.6 mm**、轴向长 **6 mm**、外径 **8.6 mm**，上方开口，名义径向余量 **0.3 mm**。托座中心为模块坐标 (78.2, −64, 117)，背面紧贴外侧挡板，不设伸出支臂；喷水管全程按 Ø5 重建，绕外侧回到托座再接枪前侧。中心弯曲半径 8 mm 仍是假设，泡泡管 Ø4 保持。

拆卸时断电排液，断开接管并将软管从托座向上提起，断尾线、释放导向鞍，充分解除底部粘接后，沿模块 +Z 抬 2、沿 −Y 前抽 150 mm。空托架连同挡板和托管座卸基座螺钉后上提 2、向 +X 移出 60 mm。托管座是开放承托，未设置卡扣，不作为抗拉固定验收。

重新检查完整裸枪 138.5 × 33.2 × 24.6 mm 对夹具和整机，完整带管 138.5 × 38.5 × 24.6 mm 对夹具以外整机，示意接头单独检查；以上分别进行静态和解除粘接后的两段连续扫掠。Ø8 路线审查区只在托管座处允许有意重叠，实际 Ø5 管仍参与全机碰撞检查；托座处 6 mm 直管段另做向上 10 mm 的精确连续扫掠，不能据此证明整条软管的柔性拆卸。接头轴向位置、公差、抗折、胶粘保持和实物拆装仍待核实。

## 0.25 双托管槽与一体尾线导向鞍

按用户补充，在外侧后挡板也增加托管槽，与前托槽同为 Ø5.6、长6 mm、上方开口且紧贴挡板。两槽中心采用模块坐标 (78.2, −64, 117) 与 (78.2, −12, 117)，间距52 mm；喷水管实测Ø5，从接头沿水枪外侧经过两个托槽，再向后接回液舱，取消底部横穿和下方回绕。中心R8仍为待试配的设计假设；后方横接段抬到Z130候选以避开尾线导向鞍、插头操作区和颈架。

尾线开放导向鞍与扎带槽直接融合到 `WaterGunCradle`，取消独立 `WaterGunLeadGuide` 对象，开放槽和两条扎带槽保留。底托、左右挡板、后定位挡与尾线导向鞍成为一个实体，枪体仍靠底部双面软胶固定。两处水管托槽分别保留CAD名称用于审查，制造合并需包含 `WaterGunHoseSupport` 和 `WaterGunHoseSupportRear`。

拆卸先断管并从两个上开口槽释放软管，再断尾线、释放扎带和底部粘接，随后沿模块+Z抬2、沿−Y前抽150 mm。分别检查两个托槽处6 mm直管段上提10 mm的连续扫掠；尾线Ø8审查区只豁免一体导向鞍的具体材料，底托其余区域和实际Ø3线束仍检查。完整软管柔性拆装、胶粘与扎带保持力、公差及实物适配尚待验证。

## 0.27 后护甲单体镜像确认（历史，管孔由0.28封回）

`RearBaseArmor` 的前后截面统一从 +X 半侧参数镜像生成。前截面 Y74：最大宽94、高63（Z34…97）；后截面 Y82：最大宽84、高53（Z40…93）；前后深度8 mm。X=0是镜像面，中央脊甲座保持居中。只有Ø9液管孔按实际功能保留在X24、Z76。

原0.26单体几何已满足镜像对称，本次将其固定为生成规则和保存回读门槛。核对时只在分析副本补孔，再比较整实体、16个完整表面与顶点；覆盖轮廓、各斜面和脊甲座。图纸第22页增加单体背视、侧视和镜像基准；检查不是制造或强度验收。

## 0.28 顶部插管与完整对称后护甲

用户确认两枪均可自吸。水枪吸管轴线X−24／Y49、泡泡吸管X24／Y49，沿+Z从顶部拔插；模型管端Z45，相对原舱底基准Z40留5 mm，尚未确定真实储液底面及最低可用液位。顶部既有Ø14补液通道保留，导向塞、外盖和把手新增同轴Ø9贯通候选孔；Ø8路线预留到孔壁最小0.5 mm。喷水管Ø5为实测，泡泡管Ø4、两路R8弯曲仍为假设。

喷水顶部中心线升至Z149、经Y70和X99转向前枪；泡泡升至Z161、经X−99转至前枪，两路错层。水枪后托槽前的转弯移至模块Y6，以保留托槽处直管；两托槽与枪体位置保持。背面不布管：后护甲Ø9孔、泡泡舱侧孔及水舱／共用壳体侧向走管切口全部补回。后护甲完整实体关于X=0镜像对称，无孔洞豁免。液体区占位扣除Ø8吸管通道，仅表示空间分配，不是实测容量。

开任一补液盖前须抽出两路顶部吸管；随后沿原上6、后12、再上34 mm路径取盖。CAD检查覆盖移除管路后的盖组，未模拟软管柔性抽出或手部操作。自吸能力不代表当前吸程、首次引液、漏气、液位范围、通气防溅、管口固定及倒流已验证。顶部接口仍为候选，不是完整密封／可制造液箱。

## 0.29 动力固定与前后等宽底盘

2026-10-25 用户要求保留 Trackduck 的电机／底盘／履带固定方式和接口参数，左右动力各外移14 mm不变；随后确认下部前后统一132 mm宽，上缘保留切面收腰。0.28的四个独立长安装耳和Ø40避让孔未构成完整固定结构，已由本节取代。

`LowerTub`将两侧电机端面固定板、履带连接柱、上半电机护罩和连接壁融合为一个实体。后侧下部外缘X±66，Z48以上斜收，Z76回到X±48；原前电源位置、上部头舱、颈架、双枪和后护甲保留。下底盘的132宽不包含向履带伸出的功能固定座；整机仍宽228。

[只读接口基准](../hardware/components/drive-interface/README.md)只保存参考功能端部及示意螺钉，不保存整套旧底盘。端面X±73、板厚4、齿轮箱中心Z50、输出轴中心Z57、Ø31分度圆和Ø3.4孔保持；每侧四个完整承压座配四颗端面示意螺钉，下方两孔被13 mm向下开槽切开，不计承压座。端面固定承担电机壳体反扭矩，底部盖不承担电机安装孔。

TrackMount最近面X±87，端面间距14；前后孔距56.2、中心Z37.4。连接柱保留Ø3.4通孔、Ø5.8×3沉孔和Ø6.2送入通道；四颗履带示意螺钉与来源几何一致。前侧经电源拆出空间装入，后侧隔板补局部通道，不能仅靠同轴通孔推定装得进去。

左右各新增一个独立电机检修盖，外缘X±67.3，位于履带最内侧X±68以内。中部底板Z28…30.8、厚2.8；四个凸台上端Z38与固定底盘承压。左盖孔中心为X22.5/Y±16、X64/Y±22，右盖X取负；Ø3.4通孔、Ø5.8沉孔、Ø2.6×8候选底孔沿用参考紧固参数，盖形及固定点适配当前空间。盖和螺钉均可直接下取，不依赖拆掉另一侧动力。

电源包络保持X±60、Y−96…−23、Z33…64.5；托盖后排螺钉由Y−34移到−40，前排仍−85、X±63.5不变，为前履带螺钉装入槽保留壁厚。新增20处M3级示意紧固：电机端面8、履带4、盖8；连同已有28处，共48处候选固定点（不含履带内部参考紧固件），不能据此直接采购。

[生成模块](../scripts/drive_mount.py)与[独立检查](../scripts/drive_mount_check.py)分别负责重建及保存实体核对；[专项报告](../hardware/model/archive/reports/drive-mount-0.29-audit.json)区分参考差集、承压座、连通性、完整履带采样、连续扫掠、工具杆和反例。几何连接不代表强度：材料、打印方向、四座受力、螺纹拔出、防松、振动／疲劳、蠕变、真实电机尾部及线缆空间仍须实测。

## 0.30 一体底盖与内退电机托座

按用户授权优化维护：保留动力30件的几何和左右各14 mm外移、132 mm等宽下部，以及电机端面X±73、PCD31/Ø3.4、轴线Z57、履带面X±87和56.2孔距。电机固定端面板从一体底盘中分离，变为`MotorCarrierL/R`；原四颗电机端面螺钉不移位，随电机托座取出。履带固定柱、托座轴向止挡及承力外框留在`LowerTub`。

每侧托座有前后两处底部锁紧点，左右镜像：左前X64.5/Y−32.8/Z32、左后X28/Y23.8/Z34。侧轨、前低位外伸耳和后承压垫为一个实体，前耳从电源内托架局部缺口下方通过。底盘内腔及上部局部护罩为28 mm内退、80 mm下取留出空间；所有螺钉、材料、截面承载和定位公差仍为候选。

四块外部检修盖合并为一块`BottomServiceCover`：X±65.8、Y−96.8…40、Z26…28.8，六处固定X±63、Y−75/−55/37。盖底比0.29下降2 mm；履带最低几何平面仍为Z0。电源包络X±60、Y−96…−23、Z33…64.5不变；内部独立承托架Z31…32.8，增加中间连接肋并为电机托座前耳避让，四处电源固定位置保持。底盖不承托电源或履带。

0.30结构现由0.31取代；当前路径前提与操作步骤见[装配说明](assembly.md#032-简化一体底盘与电机维护)。真实联轴器释放、编码器尾部、线束停放及手柄空间仍需实物核对。生成与检查分别见[drive_service.py](../scripts/drive_service.py)、[drive_service_check.py](../scripts/drive_service_check.py)；0.29的固定接口基准仍为只读，不覆盖部件资产。

0.30电源内托架的四颗螺钉增加Ø7/Ø2.8×0.5 mm候选承压垫圈，扩大螺钉头到托架的承压面积；托架下取通道同步清除旧台阶。垫圈规格、材料和实物承载待试配。

## 0.31 一体承力框架与紧凑端板

0.30的细长托座由本节取代。取消两条长53、截面3.9×4的侧条和前后远端固定耳，尤其移除1 mm前耳连接片。`MotorEndPlateL/R`只保留电机端面和两个短脚：X向60…77（右侧镜像），总长17；端面基准仍X±73、厚4、PCD31/Ø3.4，每侧四个完整电机座。端板上部Y±20.7、Z44…72，下部收窄为Y±16，避让固定承压台阶；两脚Z31…37，在锁紧孔周围保持6 mm厚且无头部沉孔。

`LowerTub`包括连续侧壁、斜收肩部、顶梁、脚部承压台阶及外侧止挡。侧壁主要区X63.2…77、Y±20.7…±27、Z43…67；顶部收窄以避让履带上缘，顶梁Z72…75。两侧承压面、顶面与端板名义接触，外侧止挡限制向外轴移。锁紧点X±64.5/Y±19.5、台阶Z37；M3级螺钉夹紧厚脚并参与向内防脱，Ø2.6盲底孔与简化螺杆长度待定工艺验证。

前后下底盘仍宽132 mm，无需加宽。电机、轴、联轴器、履带安装件及完整履带30件位置／几何保持，仍相对来源左右各14 mm外移。电源、内托架、一体检修盖及上部组件保持原位。移开线束并解除联轴器锁定后，电机连端板、轴和四颗端面螺钉内退28、下取80；两侧完整履带和电源不拆。新形状必须以当前保存实体重新检查，不能继承0.30路径结果。

当前为结构及装配候选：零名义间隙接触没有计入材料、公差和预紧；连续框架和加厚短脚不等于强度验收。反扭矩、冲击、疲劳、螺纹保持和实物拆装仍未验证。参见[0.31历史动力专项](../hardware/model/archive/reports/drive-mount-0.31-audit.json)与[0.31历史范围审计](../hardware/model/archive/reports/drive-service-0.31-change-audit.json)。

新增承压台阶保留原履带螺钉内侧Ø6.2头部／工具通道，避免一体加强后阻断初装。履带螺钉内退35.5再下取80，前颗需先拆电源；本侧完整履带向外60按1 mm采样。电机端面螺钉在履带总成未装时可向外装卸；这些初装检查与日常电机免拆履带的路径分别记录。

左右电机组件内退和下取的保守整组包围盒扫掠，到充电宝／内托架的名义间隙下界分别为0.2／0.4 mm；退轴后轴端到履带内缘为1 mm。这些余量未扣除制造误差和变形，尤其0.2 mm不能当作已通过工艺公差的实物装配保证。

## 0.32 简化一体底盘

用户明确选择一体化优先，接受换电机前移开本侧履带。电机固定面直接融合入`LowerTub`，取消两只独立端板、4颗端板锁紧螺钉、端板短脚、承压台阶及外侧止挡配合。原电机端面X±73／厚4、PCD31／Ø3.4、四完整安装座、13宽下开槽和全部履带接口保持；左右动力仍各外移14，底盘前后132等宽。

为可拆托座增加的两道跨舱横梁不再生成。`FrontBulkhead`和没有设备安装点的水平内隔板`BatteryRoof`取消；外顶盖`KeelLid`保留。`RearBulkhead`后湿舱隔板、`WetDivider`双液舱中央隔板、电源内托架及其承托条／固定柱／垫圈均保留，按范围审计核对几何不变。保留这些承托件是为了现有部件的支承，不凭材料强度假设取消。

维修前先断线、拆一体盖和电源内托架，为前履带螺钉腾出操作通道；本侧履带两螺钉内退35.5再下取80，履带总成向外60。移去4颗电机端面螺钉后，电机连轴沿原XY位置直接下取80；不再存在内退端板动作及其0.2 mm电源侧通道要求。详细步骤见[当前装配说明](assembly.md#032-简化一体底盘与电机维护)。

材料／打印方向／变形／螺纹／疲劳及实物工具仍待验证；未以“3D打印材料强度足够”替代承载证据。模型、图纸和[当前动力报告](../hardware/model/drive-mount-audit.json)只证明对应范围内的几何、固定面及装配路径。后湿舱隔板保留不等于真实液体隔离或密封验收。

### 电机输出端与下开槽间隙

2026-10-25 用户提供穿过固定面开口的电机输出端外径 **Ø11.9 mm**，并确认保留 **13 mm** 槽宽及顶部 **Ø13 mm** 圆弧。总名义间隙为 **13 − 11.9 = 1.1 mm**；居中时单边名义间隙为 **0.55 mm**。

此处为输出端避让／下取通道，电机仍由每侧四颗端面螺钉固定；不是紧配合定位孔。间隙未扣除打印误差、收缩、翘曲及装配偏心，需实物试配。Ø11.9 mm 为用户提供值，不替代商家标称的 Ø6 mm D 轴尺寸；本次未改写只读动力部件几何或改变 0.32 模型。

## 0.33 L298N 下部干舱竖装候选（历史基线）

独立完整矩形包络位于两台电机之间、后湿舱隔板前方；头舱电子分配不足以容纳该尺寸。下部平放会碰到原电源线占位，竖装后仅调整 `PowerCableRoute` 在干舱内的走线：Y=−14 上升至 Z=84，再到 Y=6 接原颈架通道。充电宝、插头占位、动力、外壳与后湿舱隔板保持原几何。

板卡与两台电机各相隔 4.45 mm，与后湿舱隔板相隔 1.5 mm，与底盖相隔 3.2 mm；最近为电源插头占位，间距 1.0 mm。几何检查见[专项报告](../hardware/model/l298n-fit-audit.json)，0.33 当时固定孔、支架、连接器朝向及散热所需空间尚未确定。这里的竖装只规定总包络方向，不推定内部散热器的位置。

裸包络拆卸方向为 −Z，下取 80 mm，前提是移去底盖和 6 颗底盖螺钉，并断开真实驱动线束、释放后续固定件；当前模型仅证明刚性包络的可达路径。其他维护动作保持原有前置条件。实物装拆、公差、热与液体隔离另验收。

## 0.34 L298N 可拆托框与吊架

正反面[原始照片](../hardware/components/L298N/reference/photos.json)确认四角孔、上端散热器、两侧电机端子、下沿电源／控制接口及背面焊脚。沿用 0.33 完整包络和位置，散热器端朝上、元件面朝前。孔径、孔距、PCB 平面和焊脚高度未测，设计四点可调边缘压块，不用照片比例补定板孔。所有夹垫接触点均需与实际 PCB 安全边缘核对。

`KeelLid` 增加两根一体吊柱及顶部止挡；独立 `L298NCarrier` 以两颗 M2.5 级螺钉固定在吊柱底部。托框底板厚 2 mm，后导柱截面 3×4 mm；背面中央开放，四角后挡垫、两片下沿垫及四片侧压垫为绝缘软垫候选。四颗 M2 级侧压螺钉在机外调节。顶部止挡距完整板卡包络 0.8 mm，不以散热器作为正常压紧面。

底盖增加两处 Ø5.6 螺钉头避让孔和两处 5×5 进风口；顶盖增加两处 5×3 排风口。进风总面积 50 mm²、排风总面积 30 mm²，空气预留与接线预留无体积交叠；这些是几何分配，不是风管、风量或温升证明。开口没有防水结构，后湿舱隔板未开孔。

左右电机端子各留 3.25 mm 宽侧廊，下沿电源／控制接口区为 32×11.5×10 mm；端子在托框抽出后接线／拧紧。实际线径、弯曲半径、插头和手指空间未确认。含托框和夹件的名义最小净距：电机各 2.96 mm、后隔板 0.50 mm、底盖 0.40 mm、充电宝 6.26 mm、原电源线 1.00 mm。后隔板及底盖间隙需要公差和实物试配。

[支架专项](../hardware/model/l298n-mount-audit.json)检查连续下取、锁紧件退出、直杆批头、底部接线入口、支承接触和四处通风开口；[变更范围](../hardware/model/l298n-mount-change-audit.json)对比 0.33。材料、螺纹、保持力、振动、防松、温升、实际接触与制造均未验收。

## 0.35 两只 150 mL 成品瓶背包

历史方案；当前结构及维护步骤由下方0.36替代。

2026-10-25 用户指定两个成品瓶，单瓶容量150 mL、直径48.8 mm、含盖高114 mm。按完整圆柱建立保守外包络；容量是用户提供的产品参数，不由外圆柱体积反推。最大直径是否包含瓶盖、瓶肩轮廓、尺寸公差、材料及瓶口尚未实测。旧Ø32×70液体空间分配被替代。

两瓶轴线X=−28／+28、Y=65，底Z40、含盖顶Z154；背包外壳X±58、Y35…95、Z34…158，上盖Z158…161、把手最高Z168，中央背脊至Y97。下湿舱地板延伸至X±58、Y31.5…95、Z31…34，顶盖后湿区同步避让；后湿舱隔板、中央隔板、头舱、前置双枪、电源和动力基准保留。前置驱动板仍在干舱，未变更其夹持或接口。

每瓶采用独立开窗底托（导向内径50.8）、1 mm底垫、两道1 mm侧向环垫及4 mm上限位垫。底托2颗M3级螺钉固定到湿舱底板；上盖另2颗M3级螺钉。孔、嵌件、软垫与瓶体接触均为候选，不能用CAD相切证明预紧、摩擦力或防松。后壳设两个20 mm宽指槽；每盖螺钉预留Ø8×50垂直工具空间。

喷水外管从(−28,65,154.5)进入顶部候选接口，上段Z181；泡泡外管从(28,65,154.5)进入，上段Z193。喷水Ø5为用户实测，泡泡Ø4及两路中心弯曲R8为假设。瓶内Ø8通道仅作为隐藏的审查空间，不削切完整瓶体包络，也不虚构瓶盖开孔；瓶盖接管、补气和防溅密封待瓶口资料后设计。

断电并抽出、移开两路软管；卸目标上盖2颗螺钉，上盖连上垫向上取出50 mm；从后指槽抓取瓶子，沿+Z抽出150 mm，在机外补液和清洗。底托维护先取瓶及底垫，再卸底托2颗螺钉。图示爆炸位移只用于读图。静态、整瓶连续抽出、盖板保守连续扫掠及工具空间结果见[双瓶专项报告](../hardware/model/archive/reports/bottle-backpack-0.35-audit.json)，整机回归见[回读报告](../hardware/model/archive/reports/bottle-backpack-0.35-readback.json)。

两瓶满液按水密度估算约300 g，不含瓶体与固定件，泡泡液密度未测；满／空和单侧耗空时的质心、倾覆、履带承载、软管真实拆装、首次引液、清洗、液体隔离和密封均待实物验证。本轮不作制造或儿童使用放行。

0.35最终CAD检查：整机外包络228 × 234.331 × 203 mm，较任务前长度增加12 mm、宽高不变。双瓶专项及整机静态、既有维护、驱动板／动力／双枪／主控／扬声器／超声波／后护甲／顶部供液检查均通过；[范围审计](../hardware/model/archive/reports/bottle-backpack-0.35-change-audit.json)记录27个原对象变化、26个新增、19个旧湿舱对象删除，其余287个原对象几何不变。历史维护路径采用各自离散或连续方法，未将采样结果升级为连续证明。FCStd为几何依据，STEP继续仅作布局交换。

### 150 mL瓶商品来源补充（2026-10-25）

用户补充P14 [京东商品100222905645](https://item.jd.com/100222905645.html)及[尺寸原图](../hardware/components/bottle-150ml/README.md)。图示下直径48.8、含盖高114、瓶口内径30±0.2、贴标高82.4 mm，总重量18±1.5 g；均为商品图标称，未实测。48.8不是已确认的整瓶最大外径，贴标高不是已确认的夹持段长度。0.35几何及原CAD检查结果保持不变；瓶盖和肩部实际外形需另核，不能以新增图片推定已有包络已覆盖所有凸出部位。

## 0.36 低位开放双瓶护舱

用户确认露出瓶口／瓶盖的低位方案。护舱外壳仍为X±58、Y35…95，Z34…124，外形116×60×90 mm；较0.35外壳124 mm降低34 mm。取消原上盖和把手后，打印护舱最高点由Z168降至Z124；以同一外壳底面Z34计算，含原盖／把手的高度由134降为90 mm。装瓶后的顶部仍为Z154，相对外壳底面总高120 mm，缩短的是护舱而非瓶体。瓶底仍为Z40、完整含盖顶Z154，外露包络30 mm；护舱覆盖瓶底以上84 mm。商品图82.4 mm是贴标高，不据此认定瓶肩高度或实际夹持长度。

清水瓶移到X=+28，泡泡液瓶移到X=−28，Y均65；两路分别向对应枪侧引出，上部中心线Z174，不横跨另一瓶。瓶子数量、容量、完整包络和两处安装位置的集合不变。底盘、前置双枪及其夹具、电源、电子与L298N结构不因本轮重新布局。

保留每瓶内径50.8的开窗底托、1 mm底垫与两道1 mm侧垫、两颗底托M3级候选紧固。取消打印上盖、上限位垫、把手、盖螺钉和嵌件。每瓶增加一条12×1 mm环绕绑带候选，位于Z108…120，经底托前侧导槽定位；后部搭接及拉片从护舱缺口操作。绑带依赖张紧与摩擦保持，**不是刚性向上止挡**，CAD相切不证明预紧和保持力。12×1为宽厚布局候选，实际采购长度、搭接长度和材料待试配。

日常补液意图无需拆螺钉：断电并处理残液 → 抽出并收置目标吸管 → 解开并收置目标绑带 → 从后侧抓取瓶体，向上抽出150 mm → 移到机外旋开原瓶盖补液、擦干后复装。另一瓶、绑带及其软管保留。盖上接头与通气结构尚未定，当前采用抽出吸管的维护候选，不宣称真实瓶盖已支持该动作或可原位旋盖。底托维护则需先取出瓶体和底垫，再卸其两颗底托螺钉。

[专项检查](../hardware/model/bottle-backpack-audit.json)覆盖完整瓶体静态相交、150 mm精确圆柱连续上取、保留另一管路的净距、目标软管仍连接时阻挡的负向检查、后抓取及绑带操作空间、底托螺钉／工具、名义承托接触。柔性抽管、绑带剥离／收置、手部握持与满瓶保持力未模拟；最大瓶径、肩盖实形、密封和稳定性仍需实物确认。整机证据见[回读](../hardware/model/readback.json)，范围见[0.35→0.36审计](../hardware/model/bottle-backpack-change-audit.json)。

0.36最终回读：328个对象有效，909对静态布尔检查无超阈值相交，16组既有维护共200个离散姿态及各专项检查通过；两瓶各自的150 mm连续上取与独立管路条件通过，另一侧管路最小净距分别29.6／29.1 mm。范围审计为32个对象变化、6个新增、18个移除、290个原对象几何不变。50张预览图和29页A3 PDF已同步；第9页为低位护舱与单瓶拆装，第23页为同侧供液。STEP回读有效且882个实体数量一致，但体积差0.262796 mm³超过0.01 mm³阈值，继续仅作布局交换，以FCStd为几何依据。

## 0.37 头舱整体上移25 mm

2026-10-25 用户要求头部整体上移25 mm，颈架与斜撑同步调整，并检查双瓶、管路及拆装空间。头壳、前脸、冠盖、托板、主控、扬声器、两只被动模块和USB／天线审查区共106个对象刚性上移；头舱尺寸及内部相对位置保持。固定颈架下部基准保持，开窗侧板延长，横梁和鞍座上移；斜撑重新确定倾角并延长，套筒下端沉入基座，鞍座两侧各扩1 mm接至侧板。中央电源线束上端延长25 mm，底部插头与L298N避让段原位。

头壳底面Z136→161，顶部Z203→228；含盖瓶顶仍为Z154，高度基准差7 mm。整机外包络为228 × 234.331 × 228 mm。双枪、双瓶、底盘、电源及动力保持，范围之外202个对象逐件几何比较不变；19个颈部对象及1条电源线束属于允许调整范围，部分下部连接柱仍原位。没有新增或删除对象，见[范围核对](../hardware/model/head-lift-change-audit.json)。

以下是完整头舱实体／设备包络至目标对象的最短几何距离；不包含头舱USB／天线服务空间，后者另作专项检查。瓶体仍是暂定Ø48.8×114完整圆柱，实际最大盖径未测。

| 检查对象 | 0.36名义净距 | 0.37名义净距 |
| --- | ---: | ---: |
| 清水瓶／泡泡液瓶 | 各7.60 mm | 各18.62 mm |
| 喷水实际Ø5管包络 | 6.81 mm | 20.73 mm |
| 泡泡候选Ø4管包络 | 9.05 mm | 10.93 mm |
| 喷水Ø8管路审查区 | 5.31 mm | 19.23 mm |
| 泡泡Ø8管路审查区 | 7.05 mm | 8.93 mm |
| 单瓶上取150 mm的连续扫掠空间 | 各4.60 mm | 各4.60 mm |

两瓶仍可在只移开目标吸管和绑带后沿+Z上取150 mm，另一瓶及其管路保留；本次重新检查连续圆柱扫掠、底托螺钉与工具、后抓取及绑带拉片空间。加高改善了安装状态下的净距，未扩大上取路径的前后水平间隙。实际抽管、柔性软管／绑带收置及整手操作仍未模拟。

最终保存回读328个对象有效，889对静态布尔检查无超阈值重叠，16组200个离散维护姿态及既有双枪、双模块、主控、驱动板、动力、扬声器、超声波、双瓶等专项通过。连续与离散检查仍分别表述，未将采样升级为连续证明。新增8处支撑接口的名义面接触核对通过；这不证明紧固、刚度或强度。检查见[0.37头舱间隙](../hardware/model/archive/reports/head-lift-0.37-audit.json)、[整机回读](../hardware/model/readback.json)和[范围核对](../hardware/model/head-lift-change-audit.json)。

模型、STEP、50张视图、同尺度前后对比及30页PDF已更新；第30页汇总本轮高度和间隙。STEP回读882个有效实体、包络一致，但体积差0.247529 mm³超过0.01阈值，继续仅供布局交换，以FCStd为几何依据。瓶盖／肩部最大外径、线管实物弯曲、颈架振动与强度、满／空／单侧空瓶稳定性、制造及物理装拆均未验收。

## 0.38 双枪上仰10°

按用户要求小幅增加两枪仰角，本轮由5°调整为10°候选。旋转中心及水枪前移10 mm参数保持；取消原下移4 mm，避免抬角后底托尾部与顶盖干涉。枪体、底托、胶垫、紧固件、尾线及模块服务预留随动，肩梁支柱顶面与孔轴重建，软管瓶端保持、枪端重新衔接；泡泡侧外部管段中心线由Z100降至96，避开插头拔出空间。独立枪体资料保持，已接受的头舱加高25 mm和颈架不变。

| 项目 | 水枪 | 泡泡枪 |
| --- | --- | --- |
| 喷口中心XYZ，mm | (55, −134.48, 136.03) | (−55, −123.81, 121.27) |
| 相对5°方案喷口增高 | 13.42 mm | 5.52 mm |
| 完整枪体审查包络至头舱 | 23.32 mm | 31.55 mm |
| 完整枪体审查包络至颈架 | 9.40 mm | 34.91 mm |
| 完整枪体审查包络至底盘顶盖 | 6.86 mm | 12.48 mm |

两枪前向单位向量为(0, −0.984808, 0.173648)。上述净距来自名义包络，不含制造公差，水枪底托至顶盖2.49 mm仍须实物试配。[保存几何范围核对](../hardware/model/archive/reports/gun-pitch-0.38-audit.json)确认46个枪组对象按5°→10°刚性变换、276个范围外对象不变；另重建2件肩梁及4件管路／审查区，没有新增或删除对象。两处肩梁与底托的名义接触面积约126.26／108.42 mm²，无体积重叠；接触面积不等于承载、胶粘或螺钉强度验收。

拆装步骤仍在倾斜前的模块坐标中定义，再变换至整机坐标。水枪先断电排液、断管断线、充分脱胶，沿底板法向抬2 mm后向枪前取出150 mm；空底托另退两颗螺钉、抬2后向+X移60。泡泡枪先清胶断管线，模块内抬尾15°、后退10、上抬3、向−X移90；其102姿态属于离散采样，未视为连续旋转证明。单瓶取出仍先移开自身吸管与绑带，另一瓶及管路保留。

实际水流射程、泡泡输出与飘行、允许工作倾角、滴液／倒流、软管弯曲、防拉脱、胶粘保持及实物拆装待试验；不能据CAD结果认定射程已增加。制造及物理装配未放行。

泡泡管实际包络至插头操作空间净距3.18 mm，Ø8管路审查区至同一空间1.18 mm，均无体积重叠；该值未包含真实接头、手部或软管变形。

最终保存回读328个几何对象有效，897对静态、16组200个离散维护姿态及双枪、双瓶、顶部供液、主控、动力等既有专项通过。水枪脱胶后取出与空底托维护采用各自连续扫掠，泡泡主体仍为102个离散采样；双瓶各自150 mm连续上取通过。头舱至两瓶18.62 mm、至喷水／泡泡管20.73／10.93 mm保持。50张视图、同尺度对比及31页A3评审PDF同步，第31页为仰角变化。STEP回读882个有效实体、包围盒一致，但体积差0.246789 mm³超过0.01阈值，继续仅供布局交换，原生FCStd为几何依据。

## 0.39 双枪上仰15°

用户已确认保留15°方案；两枪由10°改为15°安装候选，独立枪体资料不变。水枪旋转后仍前移10 mm，竖向偏移从0改为+3 mm，避免底托尾部逼近顶盖；泡泡外侧固定管段中心线从Z96降至94，以让出插头外拔空间。肩梁承托面、孔轴和枪端管路随姿态调整，头舱加高25 mm、颈架、底盘、双瓶与动力保持。

水枪喷口中心(55, −131.00, 148.17)，泡泡枪口中心(−55, −120.49, 126.52) mm；相对10°方案分别增高12.15／5.25 mm。前向单位向量均为(0, −0.965926, 0.258819)。安装与取出步骤沿用各自模块坐标，再按15°变换；泡泡主体抬尾15°的拆装动作是相对模块的另一旋转，不与安装仰角混用。

实际水流射程、出泡与飘行、倾斜带液运行、滴液／倒流、胶粘保持、柔性软管和实物拆装待验证；不认定15°一定射得更远，也不作为制造放行。10°候选证据保留在[0.38审计](../hardware/model/archive/reports/gun-pitch-0.38-audit.json)，当前范围检查见[0.39审计](../hardware/model/gun-pitch-audit.json)。

取瓶与水枪的交叉检查改用完整圆柱沿世界Z轴的连续扫掠，并在水枪局部坐标中核对。15°下旧方法把旋转后的圆柱及上取路径扩成轴对齐长方体，出现假重叠；新方法先确认瓶体等于完整名义圆柱、路径保持轴向，再构造解析扫掠。原双瓶专项继续独立检查。正向路径通过，真实阻挡反例能检出，非轴向路径会拒绝采用该证明；其余维护组仍用原保守AABB方法。

0.39最终保存回读328个对象有效，899对静态、16组200个离散维护姿态及既有专项全部通过。范围核对为46个枪组对象随姿态变换、276个范围外对象不变；两件肩梁及四件管路／审查区另行重建，无新增或删除对象。水枪／泡泡枪完整审查包络至头舱14.12／28.05 mm，水枪底托至顶盖2.94 mm；泡泡管本体至插头操作空间2.59 mm、Ø8审查区仅0.59 mm。肩梁与底托名义面接触129.38／107.93 mm²，无体积重叠；这些值不证明实际固定强度或手部操作。

模型、50张视图、10°／15°同尺度对比和31页A3评审PDF同步；第31页展示本轮仰角变化。整机外包络约228 × 228.517 × 228 mm。STEP回读882个有效实体，体积差0.246565 mm³仍超过0.01阈值，继续仅供布局交换，FCStd为几何依据。

## 0.40 面包板浅托盘

按用户批准的100×85×36整组包络重建头舱托盘；主体105×90、内区101×86、底厚2.5、围边高3，四孔X±57、Y−40／−5。外形、冠盖和其他机构保持，电弧模块暂不布置。尺寸、拆装、证据和未决项统一见[浅托盘记录](breadboard-tray.md)。

## 0.43 四块效果板固定

在0.42基础上补充浅凹座、四个独立防脱压框、8颗M2级候选螺钉及局部低压接线空间；头壳、背包夹持和前斜坡保持。板卡压框只覆盖假设空白边缘；承板沉台使电源上方最小名义余量为2 mm。详细候选尺寸、拆装顺序和证据见[说明](effects-mount.md)。

## 0.45 底盘前方效果线外观

按用户要求在底盘前方左右各加入两根封闭端效果线及根部护套。四根线沿前护甲斜边错开、向前略微上翘；线径、长度和护套均为造型假设，未开穿壳孔或设计内部高压路径、电极、驱动。原有412个对象保持，仅新增8个外观对象。位置、预览与CAD检查见[布局记录](effects-mount.md#2026-10-25-前方效果位置需求)。原装配PDF尚未同步0.45。

## 0.46 前方效果线加长

用户要求线再长一点，四根线的前伸长度由18增至28 mm，上翘斜率仍为4/18，因此抬高约6.22 mm；根部、护套、线体外观直径和其他零件保持。具体尺寸及边界见[布局记录](effects-mount.md#2026-10-25-前方效果位置需求)。

## 0.47 点火线走线空间（已撤销）

本节只记录被用户否定的历史候选，0.48已替代。用户提供单线外径1.5 mm，前端外观线同步修正；保留前伸28 mm、根部与护套。新增6个半透明走线空间，沿两侧外沿绕行，未开壳体孔或设计实体护盖。模块端接入与实际弯曲条件未定；底托侧拆前须移开本侧未来线束与护盖。方案比较、名义间隙与检查边界见[路线记录](ignition-routing.md)。

## 0.48 替换电源与前舱入线

采用用户尺寸116×70.5×19.5 mm的新电池包，原XY中心及底高保持为设计假设，顶部降12 mm。点火线不绕履带上方，前舱肩部入壳后从前脸出来；新增第三块P01独立托架。机械空间、拆装前提及未验项目见[详细记录](ignition-routing.md)。

## 0.49 左右镂空底座侧框后伸

用户要求左右镂空侧框向后多延长一些。本轮对 `KeelSideFrameL/R` 对称后伸30 mm：后端从Y8到Y38，延至背包前缘附近；保留原前部轮廓及镂空，厚度1.5 mm、最高Z90不变。后伸量为设计候选，非用户指定尺寸；每侧新增体积585 mm³，不删减原侧框材料。没有移动履带、电机、背包、点火路线或新增MOS安装位。

[专项视图](../hardware/model/side-frame-extension.png)以橙色突出侧框、半透明履带显示内侧结构；[侧视](../hardware/model/side-frame-extension-side.png)可查看后端轮廓。[变更检查](../hardware/model/side-frame-extension-audit.json)核对只修改两侧框、保留438个其他对象，以及与实体／预留空间的间距。整机静态、原维护姿态及动力／效果专项见[保存回读](../hardware/model/readback.json)。新增后段距履带肩齿最近0.5 mm，与原侧框最小名义间距相同；距点火走廊约4.92、背包壳8 mm。0.5 mm未计履带变形、打印偏差或装配误差，不代表实物间隙验收。材料、1.5 mm薄壁强度和实物公差尚未验收。

## 0.51 六组合并打印

按用户减少碎小件的要求，整合枪托、背包、底盘隔板、冠盖和固定颈架；冠盖四处连接筋、横梁间隙填平、颈架孔顶薄桥及湿舱内部接缝连桥为新增材料，双枪底托和背包三组只做布尔融合。具体范围、打印分件与保留拆装边界见[合并说明](print-consolidation.md)。头部下壳饰件及侧框留待后续打印工艺比较。

## 0.53 折面顶盖中央电源开关

按用户实测尺寸建立独立部件，并在原 `KeelLid` 中加入一体安装座、11.2 × 6.4 mm本体通孔和前后护边。用户明确不放左右侧面；本候选不改头部，孔组中心X0／Y−64，安装面Z81.1 mm。外部固定、上取维护与公差假设见[电源开关安装说明](power-switch.md)。

## 0.55：15根线净径10穿线通道

上下护口及颈架限位桥净径改为10 mm，下护口外径12.4/安装孔12.6；上护口随R10头部弯道成形。主线束从中央颈部经Z166板下到X60后上行至Z194，避免面包板包络，头壳/托盘做局部让位。PP06及源/交付FCStd、整机STEP同步，专项连续扫掠和维护回归见[报告](../hardware/model/cable-passage-audit.json)。PP02既有冲突与整机未通过状态保留，实物/强度/电气未验，详见[说明](cable-passage.md)。

## 0.56 泡泡枪尾壳高度

2026-10-26，用户确认尾壳35.9 mm不含底部薄片6.8 mm，并要求更新正式模型。薄片、前底部、枪口及15°安装变换保持；沿用承托面局部Z89.55，尾壳从Z96.35到Z132.25，总高度42.7为推导。主壳宽23／长44、外侧6×22凸部和内部避让仍是假设；原35.8总高作为历史输入留存。

只更新`BubbleGunGearcase`及高度随之变化的审查包络；六件合并打印件不改。保存回读、范围比较及当前尾壳静态检查见[专项报告](../hardware/model/bubble-tail-height-audit.json)。尾壳距槽壁0.30、右肩梁10.40、顶盖17.75、头壳24.38 mm；这些是名义CAD间隙。原PP02圆环与前枪壳仍相交约65.113 mm³，拆装路径未重新通过，不能据此作为实物或制造放行。

## 0.57 L298N 紧凑固定与接线

按用户 57／57 mm 电机长度、30 mm 直接尾距及 28.5 mm 插线厚度形成[固定与接线候选](../hardware/model/l298n-compact/README.md)。板卡 X±14.25、Y−21.25…22.25、Z36…82.2；名义尾部余量每侧 0.75 mm。修改局限于 L298N、底盖锁紧孔和顶盖吊柱／排气口；动力接口不变。PCB 接触、材料强度、线束柔性维护及热验证仍待实物。

### 2026-10-26 第 6 盘局部修正

效果板承板 9 处和点火 MOS 托架 2 处零厚度相切连接补为半径 0.35 mm 局部实体连接；孔位及 PCB 接触面保持。前舱侧甲/嵌条合并，薄胶背面让位 0.15 mm；双瓶识别条厚 0.8 mm。上下线束护口按用户要求从源档/交付模型移除。原五盘 22 件几何逐项保持，见[保护检查](../hardware/model/completion-print/native-preservation.json)和[补齐交付](../hardware/model/completion-print/README.md)。
