miclle/cybertrack/hardware/procurement-web-review.md

# 采购网页核对记录

核对日期：2026-10-23。对应[采购清单](procurement.md) P01–P11。已读取九个京东商品页及 P07 天猫商品页；P08 淘宝页被浏览器站点安全策略拦截，未读取详情。以下为**页面所选 SKU、商家参数与图示**，不新增订单、到货、实测或适配验收结论。P07 已有独立任务记录的实物／ROM 核对证据，继续以其板卡记录为准。没有把同页其他选项、评论中的尺寸或通用器件参数作为所选商品规格。

相关原图和充电宝说明书保存在 [procurement-2026-10-23](reference/procurement-2026-10-23/)，原始文件未修改，厂商标识及第三方权利保留。[来源与 SHA-256 清单](reference/procurement-2026-10-23/sources.json)记录每个保存文件的原始 URL。未保存账号、地址、购物车、订单或支付信息。网页价格受促销、会员及地区影响，未作为采购成本或成交价。

## 逐项资料与剩余缺口

### P01 / H14：双 MOS 功率开关模块

来源：[京东 10228983831884](https://item.jd.com/10228983831884.html)，京朔元器件专营店；选项“开关驱动模块”，属于成品模块，而非单只裸 MOS 管。

- 详情图标称：工作电压 DC 5–36 V；数字高电平触发 DC 3.3–20 V；支持 0–20 kHz PWM。
- 商家宣称常温持续电流 15 A、功率 400 W、辅助散热下最大 30 A；没有对应温升、导线／端子、占空比和保护条件，不能据此批准项目负载。
- 尺寸图：33 × 17 mm，质量 4.9 g；未给高度和安装孔基准。原图见来源清单 P01。
- 2026-10-24 补读已归档原图：控制焊盘可见 `GND` 与 `TRIG/PWM`；图示为双 MOS 并联的一路功率开关，不是两路独立控制。当前存档的详情图在“接线图”标题处结束，没有四个螺丝功率端子的定义，该次读取时实物端子仍须核对。用户随后提供[实物正反面](components/jz-mos/README.md)，已补齐 VIN+／VIN−／VOUT+／VOUT− 与控制端标识；实物证据独立存档，不修改商品原图。
- 待核实：MOS 型号、3.3 V 驱动下损耗、输入悬空／复位默认状态、感性负载保护和实物通断关系。网页“支持单片机”不等于 ESP32 板级接口已经验证。

### P02 / H14：1 路 5 V 红板继电器

来源：[京东 10230035601565](https://item.jd.com/10230035601565.html)，京朔元器件专营店；当前选项“1路 5V 红板”。

- 对应“一路红板”详情标称：光耦输入，触发电流 5 mA，可用跳线选择高／低电平触发；接口为 DC+、DC−、IN，以及 NO、COM、NC。这里仅记录接口名称，不指定实物针序或 GPIO。
- 图示外形 50 × 25 × 18.5 mm；4 个 Ø3.1 mm 孔，孔距 44.5 × 20.5 mm；图中声明手工测量存在误差。
- 详情宣称常开触点最大 DC 30 V／10 A、AC 250 V／10 A。缺少直流电机／泵负载的降额、寿命和浪涌条件；本项目不据此使用交流市电。
- 同页混有 12 V 低电平板、汇科 3 A 小板及多路板；一路红板示意照片的继电器本体印有 24 VDC，而所选商品为 5 V。不能把该照片当作实购线圈电压证明，也不能将其他小板的 3.3 V 触发说明移用到红板。
- 待核实：实物 5 V 版本、线圈耗流、3.3 V 逻辑阈值、上电／断线默认行为及负载分配。页面“断线不动作”为商家宣称，V04 仍需实测。

### P03 / H18：MG90S 180 度金属齿轮舵机

来源：[京东 10228541898631](https://item.jd.com/10228541898631.html)，京朔元器件专营店；选项“MG90S 14克升级金属齿轮款 180度”。

确认的商品描述为 MG90S、14 g、金属齿轮、180 度。“9G”同时出现在混合商品标题中的 SG90 描述，不能覆盖所选 MG90S 的质量记录。详情含 SG90、MG995／MG996R、DS3218 及其他微型舵机的参数表；明确写有 MG90S 与 SG90 安装尺寸略有不同。已保存这一说明及 SG90 参数表，后者只用于说明版本混用，不作为 MG90S 参数。

未取得可明确归属该 MG90S 选项的完整供电、堵转电流、扭矩和安装尺寸表；不套用 SG90 的 3–7.2 V、尺寸或其他舵机的电流。用途、数量、花键、舵盘附件和实物角度范围仍待核对。

### P04 / H19：HC-SR04 单芯片宽电压模块

来源：[京东 10229075026760](https://item.jd.com/10229075026760.html)，京朔元器件专营店；选项“HC-SR04 单芯片 宽电压 3-5.5V”。

- 通用详情图标称供电 DC 3.3–5 V、工作电流 15 mA、声学频率 40 kHz、量程 2–400 cm、测量角度 15°、测距精度可达 3 mm。
- 接口描述为 VCC、TRIG、ECHO、GND；TRIG 至少 10 µs 高脉冲，ECHO 为反映往返时间的 TTL 脉冲。实物针序及 ECHO 高电平幅值没有得到验证。
- 详情图尺寸 45 × 20 × 15 mm；作为候选包络资料，孔径及安装基准仍需实测。
- **版本冲突**：选项 3–5.5 V，详情参数 3.3–5 V，接线示意又写 5 V 且展示多芯片板。以上通用参数是否全部适用于“单芯片”版本待核实。不得以宽电压供电推定 ECHO 对 ESP32 的 3.3 V 输入安全。
- 测距用途及数量待用户明确；没有新增自动避障需求。

### P05 / H11：顶部效果模块

来源：[京东 10229050271068](https://item.jd.com/10229050271068.html)，京朔元器件专营店；选项“1000KV 高压发生器”，混合标题列 3–6 V 输入。

页面结构化参数却写型号“400KV”、外形 `0.65*0.26*0.22m`、重量 10 g、“功率”字段填 `3-6v`、“输出电流”填“无”。型号、单位和字段含义均存在问题，不自行修正小数点或将“无”解释成零电流。只登记商品身份和冲突；不将这些数值写为真实高压输出或封装尺寸，不形成高压接线、驱动或共装通电方案。原有单次 ≤5 s 是用户需求，不能由此推定安全。

### P06 / H13：MT3608 2A 升压板

来源：[京东 10229848918045](https://item.jd.com/10229848918045.html)，京朔元器件专营店；选项“MT3608 2A升压板（1只）”，不是同页 Micro USB、Type-C 或 SX1308 选项。

- 参数表／对应单板图：输入 2–24 V，输出标称 5–28 V；表下建议输出在 26 V 内使用。输入输出为焊盘。
- 表格将“2A升压板”输出电流写作“最大不能超过2A”，效率“大于93%”，但没有给出输入电压、输出电压、负载或散热条件。不能作为 12 V 连续 2 A 或实际效率保证。
- **尺寸冲突**：表格中无 USB 的“2A升压板”尺寸为 36 × 17 mm，对应 MT3608 单板图标注 30 × 17 mm；高度未给。不能选择其中一个数值冻结安装。2026-10-25 用户实测37×18×6 mm，当前[实物包络](components/MT3608/README.md)采用此值；网页原标注保留。
- 表格没有为 MT3608 明确承诺短路／过流保护；这些栏位只在 SX1308 列写“有”。不能移用另一芯片／板卡的保护功能。
- 待补：实物接头／焊脚与固定接触面、12 V 输出连续／启动能力、效率、温升、限流／欠压／掉电行为。选项中“1只”为销售包装描述，不是本次已下单数量。

### P07 / H06：ESP32-S3 N16R8

来源：[天猫商品 1004509737151／SKU 5996933277834](https://detail.tmall.com/item.htm?id=1004509737151&skuId=5996933277834)，欣薇旗舰店；选项 N16R8、Type-C、已焊排针，参数标注 DevKitC-1。

页面《ESP32-S3开发板.pdf》的[实际附件](https://itemcdn.tmall.com/attachment/icoss23833859548a67d5d3f11e22b5)已读取，封面为**乐鑫《ESP32-S3 系列芯片技术规格书》版本 2.2**，并非开发板原理图。与仓库已有[同名 PDF](components/ESP32-S3-N16R8/ESP32-S3开发板.pdf)的 SHA-256 一致：`8ccabd678b12afbc1f0e2650441d8acfb2e08f34855c032758e69fcda66764c4`。未重复覆盖原件。

页面还提供 [ESP32-S3 使用说明](https://www.bilibili.com/opus/1118333192381661202)与[开发板资料包](https://pan.baidu.com/s/1V5mnqy6XUB72in4goWnwVA?pwd=8889)入口；本次仅记录入口，未读取这两个外链内容。并行任务已完成[板卡资料与实物核对](components/ESP32-S3-N16R8/README.md)：两份 COREBOARD 原理图、尺寸图、实物照片及用户测量，双 USB 枚举和 ROM 存储识别已有记录。实物 1117 稳压器与图纸 U3 标注不同，PCB 修订、部分焊装及射频通路仍待核对。本次仅新增网页附件与本地芯片 PDF 的同一性证据，不把已经取得的板级资料列回缺失，也不以商品描述冻结项目 GPIO 或实际运行配置。

### P08 / H01：履带

来源：[淘宝 617360208971](https://item.taobao.com/item.htm?id=617360208971)。此次浏览器因站点安全策略拒绝读取详情；没有使用其他商品参数替代。规格、左右成套数量、轮组／安装件内容、尺寸、材料、驱动孔和与现有动力组件的匹配仍未知。

### P09 / H09：贝思奈全自动脉冲水枪

来源：[京东 100219050685](https://item.jd.com/100219050685.html)；已核对选中“【可自吸水】全自动脉冲水枪”。详情称“第五代脉冲水枪”，材质 ABS＋电子元件，储水约 350 mL，整枪标注长 392 × 宽 62 × 高 155 mm。图中说明为商家手工测量，具体以实物为准。

这是带壳、扳机和储水结构的完整玩具；本次未取得内部泵／电机总成尺寸、输入电压、启动／运行电流、连接器、软管口径及安装孔。商品“连发”与“自动吸水”不证明拆出内部部件后直接通电即可按项目要求自行脉冲喷水，扳机和内部控制依赖需核实。

详情另有 3 L/min 吸水、最远 14 m、满电射击 1000 次／60 min 续航及 IPX7 宣传；未提供对应测试报告，不用作本项目性能、防水或续航验收。结构化包装清单却写“公主城堡玩具屋”，类别写“抽拉型”，与所选商品明显不符，列为页面资料冲突，不作为套装内容。

### P10 / H10：贝思奈旋转太空泡泡机

来源：[京东 100330535866](https://item.jd.com/100330535866.html)；已核对选中“【新款】旋转太空泡泡机-充电款”。本次页面显示该选项暂时售完，只记录读取时状态，不推定已有订单。

详情称“太空泡泡棒”，ABS，USB 充电，整件 90 × 90 × 235 mm；带旋转 UFO／DIY 配件，背面一键启动、电动旋转出泡。原图已保存。

USB 充电不等于内部电机工作电压为 5 V，也不证明支持边充边运行。待补内部风扇／出泡总成、电池及控制板的额定数据、启动／运行电流、液瓶容量、内部包络、安装、倾斜和停机排液条件。现有“自带风扇、尾部后吹”仍为项目需求，网页外观和出泡宣传不构成该方向的整机验收。

### P11 / H12：ANKER A110M 充电宝

来源：[京东 100219039159](https://item.jd.com/100219039159.html)，Anker 京东自营旗舰店；页面选中双 C 线、2 万毫安／45 W、蓝色。参数表主色系却写“白色系”，因此颜色按选中项记录，订单／实物另核对。

- 页面型号／认证型号 A110M；电芯容量 20000 mAh、额定能量 74 Wh，另列“额定容量 12000 mAh”但该字段未附测试电压／电流，不能直接换算 12 V 输出容量。
- 净重 373 g，与用户转述一致，仍未实物称重。页面尺寸 119.9 × 73.4 × 31.4 mm；用户给定及 CAD 使用 120 × 73 × 31.5 mm。分别记录来源，不用网页数值覆盖用户测量或悄然修改 CAD。
- 商品页的[使用说明 PDF](https://storage.360buyimg.com/guarantee/5096b3ce2be211f1b9aa0c42a1bf7619.pdf)已完整读取，保存为 [P11-A110M-manual.pdf](reference/procurement-2026-10-23/P11-A110M-manual.pdf)。共 5 页，以下规格见第 5 页；PDF 未见明确型号／版本标记，与 A110M 的关联来自该商品页，需与实物说明书核对。

| 项目 | 说明书标称 |
|---|---|
| 内部电池容量 | 10000 mAh、7.4 VDC、74 Wh，两颗电芯串联；与“电芯容量 20000 mAh”口径不同 |
| USB-C 自带线／USB-C 端口输入 | 5 V／3 A、9 V／3 A、12 V／2.5 A、15 V／2 A，最大 30 W |
| USB-C 自带线／USB-C 端口输出 | 5 V／3 A、9 V／3 A、10 V／2.25 A、12 V／3 A、15 V／3 A、20 V／2.25 A，最大 45 W |
| USB-A 输出 | 5 V／3 A、9 V／2 A、10 V／2.25 A、12 V／1.5 A，最大 22.5 W |
| 多端输出合计 | **5 V／3 A，最大 15 W** |
| 连接／低负载说明 | 两条自带 USB-C 线，另有 USB-C 和 USB-A 口；说明书小电流模式用于 USB-A 低功耗设备，双击电源键启用／退出 |

说明书未给出各快充档位的具体协议映射、重新协商时序、小电流模式保持时长、关断阈值、输出回灌／制动承受能力。不能把标称 45 W 当作普通 USB 接线自动可用的功率，也不能把两端各 3 A 相加。

## 对现有设计的影响

1. **电源预算存在明确缺口**：若从 5 V 端或多端模式供电，15 W 上限按现有 85% 升压效率假设仅剩 12.75 W，低于双电机商家额定点 13.2 W，尚未计驱动、主控和效果。即使假设效率 93%，也只有 13.95 W；该效率不是实测，余量不足以支持整机通过。后续需核对单路协商取电／分配方案与 MT3608 12 V 工况；本次不改变既定“充电宝＋升压”方向，不新增接线或 GPIO。
2. **效果整件不能视为当前占位内的模块**：P09 长 392 mm，P10 高 235 mm；已有液体空间各 Ø32 × 70 mm 只是设计分配。拆取内部部件或重新布置需后续明确，当前不修改 CAD 或确认可装配。
3. **可用于准备核对，不能冻结接口**：MOS、继电器和测距模块已有页面参数；供电／逻辑阈值、默认状态、真实尺寸和版本仍需到货核对。各实物、电气、制造及儿童使用验收状态不变。

## 文档验证

18 个新增原始文件的 SHA-256 已逐一回读一致，10 份本次文档中的 68 个本地链接目标均存在；结果见[回读记录](reference/procurement-2026-10-23/readback.json)。`git diff --check` 通过。未运行硬件测试，也未修改 CAD、固件或既有部件原件。
