miclle/cybertrack/hardware/schematic/parameter-confirmation.md

# 原理图待确认参数与测量清单

修订 A1 · 2026-10-26。本页把已有证据、设计选择和实物待测项分开，供逐批补齐；不要求一次测完，也不据此启动任何现场动作。原理图、PDF 与工程入口见 [README](README.md)。

## 先提供这四组信息

| 优先级／编号 | 需要你提供什么 | 已经知道什么，不必重复 | 用来确定什么 |
|---|---|---|---|
| P0 / E01 | 辰克电池包的**持续输出电流、峰值电流及允许持续时间、保护阈值／恢复方式**；厂家确认的输出口／充电口用途、连接器型号及极性 | CK18650-1234S-NP、标注 5 V、116 × 70.5 × 19.5 mm 和容量已归档；不需重测外形 | F1／F3–F7、U2／U3、输入线束与总功率预算；容量不能代替电流能力 |
| P0 / E02 | 拨动开关的型号／购买规格、**直流额定电压与电流**；全断电后给三个焊脚临时标 A／B／C，记录每挡哪两脚导通。若已有独立断电器件，也提供型号 | 外形、挂耳、安装位置已知；**SW2 只切执行器，主控继续运行**已由你本轮确认 | SW1 触点映射、主电源控制与 SW2 选型；开关承载能力不能由外形或蜂鸣器推断 |
| P0 / E03 | 全部电源和负载断开后，记录每种 JZ-MOS 的 `VIN−↔控制GND`、`VIN+↔VOUT+`、`TRIG↔控制GND` 的电阻／通断，注明表笔方向和稳定读数；记录 P12 **EN 的现有接法、ADJ／固定焊盘状态、是否有可调电位器** | MOS 端子丝印、单路双 MOS、P12 端子含义和目标 3.7 V 已知；不要照外观补推芯片或直接桥接 3.3 V 档 | R7–R9、输入偏置、受控负极、P12 保留接法；电容和半导体会影响阻值，单次蜂鸣不等于原理图 |
| P0 / E04 | 已有低压测试若记录过：各支路输入端的电压、静态／运行电流、启动峰值及持续时间，按下表填写；没有测过可先写“未测” | 双电机额定点 13.2 W 是商家资料推导；旧电源短时空载和喷水观察不等于新电池实测 | 保险、开关、连接器、导线、铜宽和散热。先取得单路资料，再设计后续同源／并发验证 |

E01 优先向卖家取得对应型号说明，不需要通过主动触发电池短路、过流或深度放电去“测保护阈值”。E02／E03 只做断电识别；先断开电池、USB 和负载，确认电容已放电。若接头用途仍未知，不先猜充电／输出口再上电。

E04 是数据需求表，不是立即操作指令。后续低压测量按已有台架流程另行安排；电流档不能并接在电源两端。普通万用表可记录稳定读数，但不能把刷新缓慢的显示峰值记为启动瞬态。没有示波器或电流采集工具的项目保持未测。

| 低压支路 | 测量位置 | 需要记录的工况／数值 |
|---|---|---|
| 主控及原音频／OLED | 主控 `5Vin/GND` 支路输入 | 启动／联网、待机、语音播放时的 V、A；供电来源及线长 |
| MT3608＋L298N＋双电机 | 升压板 5 V 输入，同时记录 12 V 母线 | 单电机及双电机分别启动／运行的输入 A、母线最低 V；注明空载／实际载荷与持续时间，不用长时间堵转取数 |
| 水枪 MOS＋P12 | MOS 5 V 输入及 P12 输出对本路负极 | 启动／运行电流、3.7 V 带载值、停止后的残余输出／实际停止时间；液路工况另记 |
| 泡泡 MOS＋P12 | 同上，单独一套支路 | 同上；不沿用水枪的读数 |

**不要求点火模块带电测量。** 该支路继续保持 JP2 断开、实际负载未接；其厂商低压输入规格、允许工作周期等资料可补录，但本清单不安排高压接线或通电。此支路未放行前，不以零电流假设把整机四路预算判为通过。

## 随后补齐的实物信息

| 编号 | 信息／检查 | 影响与边界 |
|---|---|---|
| E05 | P13 L298N：断电后核对 ENA／ENB 跳帽两针中的信号针和 +5 V 针；控制端到芯片输入的连通、是否另有上拉；后续仅在已安排的低压台架核对主控断开、复位、失电时六路电平 | 六路 10 kΩ 是已选设计值，**未关闭整板默认关闭验证**。照片可辨识控制列顺序，不足以指定跳帽列上下两针的电气身份 |
| E06 | 若有必须复用的插头／线束，提供型号、端子方向和现有线规；后续记录实际安装后的长度与维护余量 | 若没有复用要求，连接器系列与设计针序由设计阶段选定，不需要你先替工程选型号；电流额定依 E04 |
| E07 | 当前开发板用到的针脚做最终逐线／通断核对；若要插接到载板，再测两排针距、针长、板底器件及插座高度 | 本轮已按现有照片补齐位置表，不再要求重拍来辨认同一批丝印。供应商 2.54 mm 节距／25.4 mm 排距不能替代当前板插接试配 |
| E08 | 原麦克风、功放、OLED 和按键的具体型号、供电电压与附加脚连接；扬声器阻抗／功率 | **保留现有整组接线时不阻塞本次模块级图**；只有重制头舱音频／显示载板时才需完整重建，不能把当前信号边界 X1 当成实际连接器 |
| E09 | 实物可用安装高度、突出焊点、接头和工具空间、线束弯曲及拆装余量 | PCB 板框／孔位先由现有 FCStd 布局设计，再与实物核对；不要求用户先设计板框。外包络不能自动生成模块焊盘或安装孔 |
| E10 | SW2 切断后的执行器残余电压、真实停机时间、主控是否维持运行；恢复供能时是否误动作 | 已冻结“只切执行器”的功能分支，器件和故障行为仍待验证。电机 EN 低是自由滑行停止，不是主动制动 |

## 本轮已直接完善的内容

| 对象 | A1 处理 | 证据类别／限制 |
|---|---|---|
| U1 外部引脚 | 给当前使用的 23 个引脚补上 `Lxx/Rxx` 位置，原理图 pin ID 仍为 `IO8` 等信号身份 | 当前面包板照片可见丝印／排针位置；不是通断或焊盘尺寸验收 |
| R1–R6 | 选为 **10 kΩ、±1%、额定功率至少 0.1 W**；封装目标 0603，原理图仍不带生产封装 | 基于 L298 芯片 TTL 输入参数的设计定值，需 E05 验证整板输入偏置与默认关闭 |
| SW2 | 从候选功能改为**用户确认：只切执行器供电，主控继续运行** | 本轮用户确认；开关型号／额定及残余储能仍未验 |
| SW3 | 保留常开自复位干接点，跨接 GPIO0 与 GND，不新增未经核实的外部 RC | 既有要求、板载 BOOT 和当前固件上拉；实际按钮型号／低电流触点待选 |
| L298N 接口 | 补充照片可见控制列顺序、跳帽核对限制及“EN 低为自由滑行”说明 | 照片与 ST 芯片资料；不表示整板机械／电气验收 |
| R7–R9、F1–F7、U2／U3 | 保留 TBD，并关联 E01–E05 的具体缺口 | 不把 L298 的电阻定值套到未知 JZ-MOS 输入，也不从电池容量选保险 |

### U1 当前用到的排针位置

观察方向：**元件面朝观察者、天线向上、两个 USB 向下**。L 为左排、R 为右排，从天线端到 USB 端依次计数 1–22。这是本图采用的位置代号，不是另一个新插头的针序。依据：[当前面包板原图](../components/breadboard/front-20261025.jpg)；供应商原理图仅交叉核对，不转移另一块板的实物验收。

| 用途 | 信号／位置 | 用途 | 信号／位置 |
|---|---|---|---|
| 主控供电 | 5Vin / L21；GND / L22 | 外接 BOOT | GPIO0 / R14 |
| 电机 A | ENA: IO8 / L12；IN1: IO9 / L15；IN2: IO10 / L16 | 电机 B | ENB: IO11 / L17；IN3: IO12 / L18；IN4: IO13 / L19 |
| 水枪 | IO18 / L11 | 泡泡／点火低压预留 | IO17 / L10；IO21 / R18 |
| 麦克风 | WS: IO4 / L04；SCK: IO5 / L05；DATA: IO6 / L06 | 功放 | DATA: IO7 / L07；BCLK: IO15 / L08；LRCK: IO16 / L09 |
| OLED | SDA: IO41 / R07；SCL: IO42 / R06 | 说话／音量 | IO47 / R17；IO40 / R08；IO39 / R09 |

### R1–R6 的定值依据

[ST L298 数据手册 DS0218 Rev 5](https://www.st.com/resource/en/datasheet/l298.pdf)表 4 给出输入／使能低电平上限 1.5 V、高电平下限 2.3 V，低电平输入电流列为 −10 µA，高电平输入电流最大 100 µA。按该表条件和电流量级估算：

- `10 µA × 10 kΩ × 1.01 = 0.101 V`，作为单个直接 TTL 输入的下拉选值依据。
- 以 3.3 V 与最小阻值 9.9 kΩ 计算，GPIO 额外下拉负担约 `0.333 mA`；加上表中 100 µA 输入电流约 `0.433 mA`。
- 按 3.6 V 校核电阻，`3.6² / 9900 ≈ 1.31 mW`，低于所选至少 0.1 W 的额定值。

这些是**设计计算，不是实测读数**。ST 表中条件与实际整板、温度、上电顺序可能不同；只有确认 P13 没有额外强上拉或缓冲、且实测电平符合要求后，才能完成整板验收。[ESP32-S3 数据手册](https://www.espressif.com/sites/default/files/documentation/esp32-s3_datasheet_en.pdf)的 VOH/VOL 注明高阻负载条件，本设计不拿其空载 VOH 保证外接负载下的电平。下拉靠近 L298N 接收端布置；任何输入被 MCU 持续驱高时，下拉都不能代替 SW2 切断。

## 可直接回填的记录

```text
E01 电池：持续 __ A；峰值 __ A / __ ms；来源 __；保护恢复 __；输出口 __；极性 __。
E02 拨动开关：型号 __；DC 额定 __ V / __ A；左挡导通 __；右挡导通 __；其他挡位 __。
E03 MOS：型号／数量 __；VIN−-控制GND __ Ω；VIN+-VOUT+ __ Ω；TRIG-GND __ Ω（表笔方向 __）。
    P12：水枪 EN __ / 调压状态 __；泡泡 EN __ / 调压状态 __。
E04 单路读数：负载 __；供电来源 __；测点 __；电压 __ V；运行 __ A；启动峰值 __ A / __ ms；仪表 __。
E06 需要复用的接插件／线束：__（没有则写“无，由设计选型”）。
```

本页记录资料缺口与闭合条件，执行进度仍以 [TODO](../../TODO.md) 为准；没有数据的项保持空白，不填估算值冒充测量。
