miclle/cybertrack/docs/decisions.md

# 设计决策与待补资料

| 决策 | 对制作和开发的影响 |
|---|---|
| 以双履带作为行走方式，固定头舱与前置双枪 | 造型采用分层切面头盔、颈架与低底盘。正面看左侧吹泡泡、右侧喷水，双枪按 15° 仰角候选试配。 |
| 头部保留整组面包板 | 麦克风、扬声器、屏幕和 ESP32-S3 共用可拆托盘。跨舱线束按净径 10 mm、15 根线预算，装配件以 FCStd 为准。 |
| 辰克 5 V 主供电，电机单独升压至 12 V | 主控与执行器分域，水枪和泡泡分别从受控支路降至 3.7 V。电流、温升、保护值和独立切断能力需实测。 |
| 云端理解意图，本地处理动作 | 灵矽通过受限 MCP 工具请求动作。网页同通道优先，本地 BOOT 与全停可中止，重连后需新指令。明确执行请求才调用动作工具；仅讨论或预览不启动。 |
| 普通测距提示连续确认（2026-11-01） | 用户选择保留滴声、过滤偶发跳值；连续 3 个有效近距样本才开放普通提示，重复控制 tick 不累加；远距、无效、过期或采样间隔超过 500 ms 后重新确认。停车仍使用单个新鲜读数。[ct77 修正与部署](validation/range-beep-confirmation.md) |
| 对话期间暂缓普通测距提示（2026-11-01） | 普通提示改为空闲 PCM 通知，对话和语音到来时撤未播放通知；结束只看实时距离，不补播。紧急停车告警仍抢占，距离阈值和动作保护不变。[ct74 候选](validation/dialogue-range-beeps.md) |
| 固定枪体与可拆背包 | 清水瓶保留，泡泡液瓶已撤出当前 CAD，替代供液容器待选。两侧桶座内径 35 mm。 |
| 两只点火线圈共用一个低压控制接口 | 软件单次最多 5 秒。A2 禁用该支路装配，高压、绝缘、液体共存及 EMC 待评估。 |

供电和连接关系见[硬件架构](../hardware/architecture/README.md)，机械依据见[装配指南](assembly.md)，角色和控制规则见[软件架构](architecture.md)。

ct62 候选把失败后的重试／补做约束放在设备端：按识别输入代际检查准入和回调，失败撤销待执行票据，查询与停止保留。新输入不清空 RPC 去重表，不更改已接受动作的截止时间。公开工具与角色源不变；网络迟到请求的关联限制及离线证据见[失败隔离](validation/voice-input-guard.md)。

ct68 候选进一步约束可识别的泛化动作：本轮 STT 没有命中动作／方向词时，执行器与调速回调返回 `action_unspecified`。这层只拒绝猜测执行，不给命中的词授权；查询、全停与可信网页保留。词义、否定、引用和指代归属未被完整解析。[边界与证据](validation/vague-action-admission.md)

2026-11-01 用户决定完整移除泡泡剧场。其组合效果与语音序列重叠，编辑与版本确认的成本尚无独立使用价值支持。保留共享序列调度、停止与失败隔离；移除专用接口、网页和离线编辑器。[实现与验证](validation/theatre-removal.md)

## 待补资料表

样机装配与运行进展不自动补齐尺寸和定量性能。Q03／Q04 的早期夹持及5°描述为历史；现行使用15°枪座、修正后的 PP02 和 Lean 固定方案。Q06 的独立裸板布局已由面包板整组替代，仍需验证真实接头、固定与装壳无线性能。

已从[采购网页](../hardware/procurement-web-review.md)取得十项页面资料，以下开放项优先补网页未提供的实物、工况和对应版本证据，不需要重复提供同一购买链接。

| 优先级／ID | 资料 | 最少内容 | 解锁的工作 |
|---|---|---|---|
| P0 / Q01 | 替换电池包 | 辰克CK18650-1234S-NP／5 V、116×70.5×19.5 mm已记录；输出电流、质量、接头、软线与保护行为待核，旧A110M限制不迁移 | 功率预算、固定、走线和重心 |
| P0 / Q02 | MT3608 升压板 | 已有商品链接；页面已选无 USB MT3608，标称输入 2–24 V；用户实测 37×18×6 mm；待核安装接口、“2A”条件、12 V 连续／峰值输出、保护及散热 | 驱动电源设计 |
| P0 / Q03 | 一体高压脉冲连发水枪 | 已有商品链接；页面已选可自吸水脉冲款，整枪 392 × 62 × 155 mm／约 350 mL；拆出发射枪实测长 138.5 × 宽 33.2 × 厚 24.6 mm、带管宽 38.5 mm 已记录；用户已确认工作电压 3.7 V；待补前段／喷嘴／接头／孔位、允许电压范围／电流、储水与液路及扳机／启停行为，0.12 已完成 CAD 包络与抽出路径检查；0.13 已补固定、线管及工具空间候选；继续核对夹持接触面、真实线管、材料、预紧和实物适配 | 喷水模块、前脸与液路结构 |
| P0 / Q04 | 电动泡泡机 | 已有商品链接；页面已选旋转太空充电款，整件 90 × 90 × 235 mm；用户已确认工作电压 3.7 V；用户于 2026-10-24 补充[主体尺寸与 4 张照片](../hardware/components/bubble-gun/README.md)：枪口最外端 Ø31.5 mm、总高 35.8 mm、总长 67 mm；0.15 改为正面看左侧前置泡泡枪，保留水枪所在一侧；0.18 改为整体前圆环＋后25长／6宽、前10宽阶梯槽，两枪上仰5°候选，泡泡枪用胶辅助固定；薄片高6.8不额外下凸，枪口底离平面4.7与原总高推导存在0.4差异，宽35.8与固定面仍为假设；待补最大宽度、测量端点／凸起范围、固定及管线空间、允许电压范围、内部总成电流、液箱与风扇、安装与倾斜限制 | 前部固定、出风与排液 |
| P0 / Q05 | 实物电机、L298N 驱动板、履带 | P13 已有照片、用户供电／静态电压、200 ms 正转及两次 40%／10 秒反转反馈，第二次反转母线约 12 V；0.2.2 的 60% 空载反转获用户正常反馈、母线约 12 V；用户已提供外形尺寸，0.3.2 双路软件回归／编译通过，B 路接线及六脚静态关闭已获用户确认；此前 0.3.1 的 3 秒版 8 组空载方向、隔离及正常停止已获用户确认，双路空载 BOOT 提前停止及松开不恢复已获用户确认，用户已确认双路 60%／10 秒空载正转正常启停，启动、运行中及临近停止母线均约 12 V，电机和 L298N 无明显发热、无异响或其他异常；这是万用表读数与主观发热观察，电流和定量温升仍未测；现已有 VF01 静态试配、样机装配影像及 ct21 四方向正常反馈；28.5 mm 插线包络、30 mm 尾距和底盖承载支架已建模；电流／定量温升、安装孔位、承载与带线检修待补 | 装车持续带载与维护验证；旧 DF-MD 证据独立留档 |
| P0 / Q06 | ESP32-S3 N16R8 主控板和音频 | 已收到正反面与实测三维外形，完成双 USB 枚举、芯片及存储识别、无负载启动和 PSRAM 读写；按[开发板清单](../firmware/BOARD-INFO.md)继续核对 PCB 版号、器件／焊装差异、射频通路、COM 初次连接及高速串口读取异常；0.11 主控布局待补 PCB 厚度与层高、排针长度、双 USB 中心、直头插头及线尾尺寸、母座固定和天线范围；停止和音频器件待补 | 无负载启动与零逻辑输出通过；F2b 实体关闭、停止与调度时限尚未验证 |
| P1 / Q07 | 产品目标 | 使用年龄、室内外、地面、最大尺寸／重量、期望速度／续航、预算 | 外观比例与验收目标 |
| P1 / Q08 | 喷水口／头舱自由度与 MG90S 用途 | 固定或需要旋转／俯仰；已列 MG90S 用于何处、数量及接口尺寸 | 确定机构与舵机布局 |
| 独立门槛 / Q09 | 火花模块正式资料 | 已有商品链接；待补实购规格、真实输出及储能／残余电荷、输入电流、封装、额定工作条件、供应商安全文件 | 决定是否继续评估；不阻塞普通低压功能 |
| P1 / Q10 | 超声波测距模块 | 页面已选 HC-SR04 单芯片；已记录[用户双圆柱尺寸](../hardware/components/ultrasonic/README.md)：Ø16、总宽 42、离面板高 10.3 mm，推导中心距 26 mm；0.26 CAD 已替换双圆柱并调整前脸，面板基准暂按 Y−81 外表面；待补实物面板基准、PCB／孔位／接头包络；2026-10-29 已指定 3.3 V、IO1/TRIG、IO2/ECHO，网页／语音测距；现行版本另有默认关闭的前进保护；版型冲突、数量及 ECHO 实物电平待核 | ct28 起已部署；实物电气和布局验收另行完成 |
| P0 / Q11 | MOS 管与继电器模块 | P01 已补 JZ-MOS 实物正反面及端子，首测负载为 3.7 V 水枪；P02 页面选中 1 路 5 V 红板；待完整器件型号、继电器实物版本、数量、最终负载分配、逻辑阈值、默认状态、散热／保护及直流感性负载额定条件 | 功率开关与接口设计 |

## 已发现的资料冲突

1. 历史旧板（已退出当前选型）：DF-MD 文件所在资料类别为 V1.3，原理图标题栏却为 V1.4；在线页面逻辑供电条目也分别出现 6–12 V 和 6.5–12 V。以实物版本与对应原理图确认，不能直接拍板跳线或接线。
2. 电机编码器同图两套六针定义互相冲突；电机动力端、编码器 VCC／GND／A／B 必须核实。
3. L 形电机支架图有 `6-Ø3` 与 `6-M3.5` 两种标注；它是可选附件资料，不等于 track-mount。
4. 六角联轴器图中“12 mm”对边／对角基准不清，中心孔“4 mm”不能直接认定 M4。
5. 安装件缺口深度与对称性未实测；尺寸 JSON 明确保留建模假设，不能由 CAD 反推成实物测量。
6. ESP32-S3 商品页称 DevKitC-1，图纸称 COREBOARD／V1.4，实物未见明确 PCB 版号；罩体为 S3 N16R8，稳压器标记 1117 3.3V 与图纸 U3 不同。用户实测整板含天线 63.6 × 28.2 × 13.2 mm 优先于图纸外形；双 USB 已分别枚举，COM 首次失败、翻转重插成功，原因待复查。GPIO35–37 保留给八线 PSRAM。详见[实物核对](../hardware/components/ESP32-S3-N16R8/physical-verification.md)。
7. 采购网页新增冲突：MT3608 尺寸表 36 × 17 mm／单板图 30 × 17 mm；HC-SR04 选项 3–5.5 V／通用图 3.3–5 V／接线图 5 V 且版型不同；继电器所选 5 V／系列图本体 24 V。详见[逐项记录](../hardware/procurement-web-review.md)。MT3608 当前实物包络已由2026-10-25用户实测37×18×6 mm取代网页尺寸假设。
8. P05 所选“1000KV”／参数表“400KV”，尺寸与功率单位异常；P09 包装清单写“公主城堡玩具屋”；P11 所选蓝色／参数表白色系。以上不通过自行猜测修正。
9. P07 页面名为“开发板”的 PDF 实为芯片规格书 v2.2；P11 页面尺寸 119.9 × 73.4 × 31.4 mm 与用户／CAD 的 120 × 73 × 31.5 mm 不同。保留证据来源，不自动更改板卡或 CAD。
10. P13 选中 L298N，但已读取详情图含 TB6612 说明；不混用其电压、接口、尺寸或程序。

ct70 独立提取原始 JSON 零字符拒绝，不推广未采纳的数组 schema。WebSocket／MQTT／SDK 字符串入口在参数准入前检查，错误归入本轮失败；合法停止与原字符串步骤保留。仅为编码边界防护，不代替意图解析。[证据与限制](validation/mcp-raw-json.md)

ct71 对有限完整否定句拒绝新写入，只在完全空闲时拦截误停清稿。初版试图拒绝活动状态下的否定 stop，但迟到请求缺少原始语句编号，已由五项停止优先反例否决；最终活动／等待全停、BOOT 和可信网页保留，不把定向模型成绩替代原验收。[证据](validation/negative-input-admission.md)
