miclle/cybertrack/docs/ultrasonic-ranging.md

# 头部超声波测距与前进保护

## ct77：普通滴声等待连续近距确认（已部署，用户确认听感改善）

2026-11-01 用户反馈偶发误判滴声太吵，并选择保留提示、过滤偶发跳值。普通滴声改为连续 3 个不同采样时刻的有效读数都小于 50 cm 后才允许播放；正常约 100 ms 采样时，从首个近距样本到确认约 200 ms，不是实测扬声器延迟。达到 50 cm、无效、未采样或过期立即撤销普通提示资格；相邻采样时刻倒退或间隔超过 500 ms 时从首个样本重新确认。相同快照的 5 ms 控制循环不重复计数。

确认后沿用 40–50 cm 每 800 ms、小于 40 cm 每 400 ms 的节奏；重新确认不重置已有节拍，不补播。ct74 的对话暂缓仍生效。避障继续直接使用原始新鲜读数，不等待三个样本；不足 15 cm 停前进、至少 20 cm 解锁不续走，停车三连音保持优先。网页／语音仍报告原始测距。

[实现与验证](validation/range-beep-confirmation.md)。这是声音抗偶发跳值措施，不证明传感器准确；连续错误近距仍可能提示。以下为历史版本与证据。

## ct42：距离提示音独立于开关与行走

普通滴声只看新鲜有效距离，待机、前进、后退、转向及前进锁定时均适用，不受自动避障开关影响：

| 有效距离 | 普通滴声 |
|---|---|
| 至少 50 cm | 安静 |
| 40–50 cm（不含 50） | 每 800 ms 一声 |
| 小于 40 cm（含小于 15 cm） | 每 400 ms 一声 |
| 未采样、无效或超过 500 ms | 停止普通滴声，不播放过期事件 |

开关、方向及停止状态变化不重置普通滴声节拍。自动避障开启时，小于 15 cm 仍立即锁定／停止前进，至少 20 cm 解锁但不续走；实际停前进的三连音优先，占用当前提示节拍，随后按距离继续滴声。关闭开关不自动恢复动作。声音沿用设备音量和现有本地优先播放路径，云端不重复提醒。

主机测试覆盖两种开关状态下的待机／后退／转向、距离边界、节拍、失效读数、停车三连音后恢复滴声，以及原网页／语音／序列保护；音频队列、MCP／HTTP 和完整构建通过，见[ct42 验证](../firmware/esp32-audio/verification-ct42.json)。已仅应用烧录、平台 5999 字符保存回读并重启联网；两组 Wi-Fi 和用户配置保持，启动仅刷新 WebSocket 会话令牌。两次开机均默认关闭，HTTP 开关两态通过；18 次有效测距、零驱动失败、零执行器启动，启动日志记录 2 次滴声播放事件。见[部署记录](../firmware/esp32-audio/startup-ct42.json)。日志事件不等于实际听感或对话并发验收；下方章节保留旧版行为与证据。

## ct41：自动避障开关（已部署）

网页速度滑块下方新增“自动避障”。每次开机默认关闭，不写入 NVS；浏览器刷新、释放、重连及语音／Wi-Fi 断线不会重置本次开机的设置。停止、BOOT、动作到期和断线停止仍生效。

- 关闭：距离读数不停止或锁定前进；已有距离锁定清除，已停止动作、旧长按和取消的序列不恢复。测距显示和查询保持；前进时小于 40 cm 每 400 ms 一声，40–50 cm 每 800 ms 一声，不播放停车三连音。
- 开启：沿用 ct36 阈值，严格小于 150 mm 停止并锁定前进，至少 200 mm 解锁；无效／过期样本不解锁。开启时已有新鲜近距离读数，会在同一请求回执前执行保护并撤销前进输出。后退／转向及独立效果保持原规则。
- 状态由设备端统一维护，网页长按、语音 `move`／`move_and_water` 及 `sequence` 共用；不存在独立语音开关。语音仅查询或遵循设置，修改开关在网页完成。
- HTTP `POST /api/action` 使用 `{"operation":"set_auto_avoidance","sequence":1,"window":1,"enabled":true}`，字段恰好四个，`enabled` 必须为 JSON 布尔值；沿用会话认证、一次性序号与状态窗口。回执 `proximity.auto_avoidance_enabled` 表示当前设置，`forward_blocked` 表示实际锁定。`capabilities.forward_protection=true` 表示支持此能力；历史 `capabilities.auto_avoidance=false` 仍表示不支持自动绕行，不是开关值。

主机控制、HTTP／MCP 和网页回归见[ct41 验证](../firmware/esp32-audio/verification-ct41.json)。已仅应用部署、平台角色保存回读一致并重启联网；网页和 HTTP 开关两态验证、18 次有效测距／零驱动失败／零执行器启动通过。两组 Wi-Fi 和用户配置保持，启动时仅 WebSocket 会话令牌刷新，见[部署记录](../firmware/esp32-audio/startup-ct41.json)。真人语音及带载停车待验证。下方为版本沿革。

## ct36：15 cm 停止阈值

用户将最短停止距离由 30 cm 调整为 15 cm。有效距离严格小于 150 mm 时立即停止并锁定前进，正在前进则响三声；恰好 15 cm 不新触发停止。解锁阈值同步为至少 200 mm（20 cm），保留 5 cm 回差，需新指令才可继续前进。

普通提示音保持仅前进时播放：40–50 cm（不含 50）每 800 ms 一声，15–40 cm（不含 40）每 400 ms 一声。有效样本、无效读数不解锁、独立效果及动作序列取消规则保持。状态接口同步 `stop_below_mm=150`、`release_mm=200`，网页沿用服务端锁定状态。

软件验证见[ct36 记录](../firmware/esp32-audio/verification-ct36.json)。ct36 已仅应用部署、配置区保持，平台角色保存回读一致后重启联网；11 次测距均有效、驱动失败数与执行器启动数均为 0，设备状态确认停止／解锁阈值为 150／200 mm，见[部署记录](../firmware/esp32-audio/startup-ct36.json)。2026-10-30 用户确认当前提示音和阈值调整“测试效果符合预期”，反馈已追加至部署记录；未提供定量停车距离或专项冷启动／对话并发结果。下方 ct35／ct33 阈值及待测项仅代表历史版本。

## ct35：前进距离提示音

本地距离语音改为短促提示音，仅在逻辑前进状态下提示；待机、后退和转向安静，不因障碍物在 30／35 cm 附近变化反复播报。

| 有效前方距离 | 提示与保护 |
|---|---|
| 至少 50 cm | 安静 |
| 40–50 cm（不含 50） | 每 800 ms 一声 |
| 30–40 cm（不含 40） | 每 400 ms 一声 |
| 小于 30 cm | 立即停止并锁定前进；若当时正在前进，快速响三声后安静 |

每声为 1400 Hz、80 ms 正弦音，边缘淡入淡出；三连音间隔 60 ms。声音复用现有扬声器及本地优先音频路径，不使用 TTS，不增加硬件。播放时沿用本地优先规则，会短暂打断云端音频；尚未实现混音。音量沿用设备设置，静音时不能听到。

5 ms 控制循环在推进后续动作步骤前更新前进保护，普通滴声再按动作截止、BOOT／断线等停止后的逻辑方向决定是否发声。距离小于 30 cm 的停止不等待声音，至少 35 cm 解锁但不续走；无效距离不解除已锁定前进。仅查询或已受阻的前进请求不会产生三连音。连续提示不补发错过的节拍，40 cm 附近切换间隔、短暂无效或远距离尖峰不会重置同次前进的节拍而连响。

测距无效、离开提示范围或停止前进后，不再产生普通滴声并取消尚未播放的普通声音；已开始的一声可播完。停车三连音为一次完整声音，不被随后待机状态清除。单槽队列严重提示优先，普通事件超过 250 ms、停车事件超过 1 秒直接丢弃，避免音频启动或阻塞后补播旧提醒。

本节取代 ct33 的距离语音和 5 秒播报冷却规则；30／35 cm 动作保护、测距冷启动恢复和网页保持。ct35 已仅应用烧录并保持配置区，平台角色保存后回读与仓库一致，随后重启联网；11 次测距均有效、驱动失败数与执行器启动数均为 0，启动日志未出现距离声音事件，见[部署记录](../firmware/esp32-audio/startup-ct35.json)。软件验证见 [ct35 记录](../firmware/esp32-audio/verification-ct35.json)，实机音量、节拍及对话并发听感待验证。

## ct34：冷启动故障诊断与局部恢复

2026-10-30，用户确认接线仍为 3V3/GND、IO1/TRIG、IO2/ECHO；独立 5 V 电池和电脑 USB 供电均出现冷上电后距离一直为 `-`，等待 10–20 秒不恢复，按 RST 后正常。在用户保留故障的同一次启动中，连续五次查询（运行约 35–38 秒）得到 `driver_error`、采样时间为空，执行器启动数为 0，见[ct33 故障记录](../firmware/esp32-audio/cold-start-failure-ct33.json)。这证明测距驱动进入故障，不足以区分初始化错误与 80 ms 接收完成超时，也不单凭此判定电池或模块损坏。

ct34 只修复测距生命周期，不改变引脚、电源方案、采样换算、网页平滑或 50／30 cm 前进保护：

- 首次 TRIG 拉低并配置后等待 1000 ms 再建立接收通道；这是容错选择，不是已测得的模块启动时间。
- GPIO／RMT 初始化或接收调用失败，以及 80 ms 没有接收完成通知，均立即撤销有效距离并记录具体阶段。成功清理后按 1、2、4、8 秒退避（上限 8 秒）重建接收通道；获得有效样本后回到 1 秒退避基线。
- 恢复顺序为 TRIG 拉低、禁用旧接收、删除旧通道、清除完成队列，然后等待重试。任务固定 CPU1，使安装的接收中断与任务在同一核，旧 ISR 返回后才会清队列；采样缓冲区贯穿任务生命周期。依据本地 ESP-IDF 5.5.1 的接收禁用／删除实现，旧通道停止前不复用缓冲区和完成队列。
- 清理失败时保留缓冲区及任务、停止重试并报告清理阶段，避免释放仍可能被接收器使用的内存或反复分配新通道。任务创建失败同样明确报告，不重启整机。其他动作任务、语音和网页继续各自原逻辑。
- `echo_high`／`no_echo`／`invalid_echo` 等普通测量无效仍按原周期继续检查，不触发密集重建；本方案不切断模块电源，也不能保证修复物理卡高的 ECHO。

`distance.driver` 是诊断对象，与当前 `distance.error` 分开：

| 字段 | 含义 |
|---|---|
| `last_failure` | 最近失败阶段；无历史为 `none`，可能为 `trig_low`、`trig_config`、`rx_create`、`echo_pull`、`rx_callback`、`rx_enable`、`rx_receive`、`trig_high`、`trig_end`、`rx_timeout`、`trig_cleanup`、`rx_disable`、`rx_delete`、`task_create` |
| `error_code`／`failed_at_ms` | 最近 ESP 错误数值及本次启动内的发生时间；接收完成超时为 `ESP_ERR_TIMEOUT` |
| `failures`／`restarts` | 失败次数／清理后进入新初始化尝试的次数，饱和计数 |
| `retry_delay_ms` | 当前故障安排的退避间隔；开始重试、恢复接收或停止自动恢复时为 0，不是倒计时 |
| `recovering` | 正在等待或尝试恢复；成功完成接收后为 false，即使样本是无回波等无效结果 |

最近故障记录在恢复后保留，不能把历史 `last_failure` 当作当前故障。当前距离是否可用仍只看 `valid/error/age_ms`。恢复期间不报旧距离，不能解除已锁定前进，也不恢复被取消动作。

主机故障注入验证瞬时初始化／接收失败恢复、持续失败退避、迟到完成事件清除、清理失败不重用资源，以及恢复期间旧数失效；原网页、MCP／HTTP、音频优先队列和动作保护回归通过。见[ct34 验证](../firmware/esp32-audio/verification-ct34.json)。ct34 已仅应用部署、配置区逐字节保持，复位启动后连续有效测距，驱动失败数及执行器启动数为 0，见[部署记录](../firmware/esp32-audio/startup-ct34.json)。随后用户确认完全断电再上电且未按 RST；新启动标识下，运行约 22.5–27.1 秒期间 8 次读取均有效（1417–1725 mm），驱动失败／重启计数为 0，执行器启动数为 0，见[一次冷启动复测](../firmware/esp32-audio/cold-start-ct34.json)。本次直接正常采样，没有触发自动恢复；该次遥测对应的电源来源未注明。随后用户确认电脑 USB 与独立电池均已多次重新上电且测距正常，反馈已保存于冷启动记录的 `user_followup`；具体次数未量化，也未逐轮采集遥测。两种供电的重复冷启动已获用户实测确认，实机故障恢复路径及原故障具体原因仍未验证。

## ct33：本地距离提醒与前进保护

2026-10-29 用户追加授权：有效前方距离 **小于 50 cm 语音提醒，小于 30 cm 语音提醒并停止前进**。ct28 的“只查询、不参与动作”约束在这一范围内由本节取代；仍不自动后退、转向、绕行或恢复动作。接线、采样与网页数字显示方式保持。

- 使用原始有效样本（20–4000 mm、年龄不超过 500 ms），不经过网页平滑。严格小于 500／300 mm 触发；恰好 50／30 cm 不新触发对应档。
- 小于 30 cm 后锁定前进，所有网页、语音、组合与序列入口共用限制。当前前进立即撤销，两路电机 PWM／方向输出关闭，取消长按续租及旧行走票据。前进中的序列取消后续步骤；未开始的前进步骤若仍锁定，整步不启动，序列取消。独立效果及当前步骤已启动的效果按各自原截止结束；后退、原地转向保留。
- 有效距离恢复至至少 35 cm 才解锁，需新的按键或语音指令，不恢复原截止、长按或取消的序列。锁定后无回波、异常、过期不能解锁；开机尚无有效距离时不凭空锁定。单个传感器失效和盲区因此不构成完整防撞保护。
- 普通提醒在有效距离恢复至至少 55 cm 后重新准备；各档播报至少间隔 5 秒，小于 30 cm 的升级提醒不受上一档冷却限制。停前进不受语音冷却影响。直接进入 30 cm 内只播严重档；持续停留不循环播报。
- 两段固定本地合成语音分别为“前方不足五十厘米，请注意。”和“前方太近，停止前进。”，无须联网或模型生成。单槽队列合并待播报事件，严重档优先；音频任务独立于 5 ms 控制任务。播报时清除排队的云端声音，暂时丢弃新到的普通播放包，播完恢复普通音频接收；不改变语音连接和动作归属。音量沿用设备设置，静音时无法听到提醒。
- 状态增加 `capabilities.forward_protection=true` 和 `proximity={forward_blocked,warn_below_mm:500,stop_below_mm:300,release_mm:350}`；受阻启动返回 `obstacle_blocked`，序列取消亦记录该结果。`auto_avoidance=false` 仅表示没有自动绕行；保护能力单独标识。网页只禁用前进，长按被撤销时释放本路，不因该正常停止释放其他网页通道。

名义采样周期约 100 ms，加回波收集和调度时间；5 ms 是控制任务周期，不是从障碍出现到机械停住的实测时延。声音可在前一段提醒完成后播出，停止无需等待音频。阈值、实物停车距离及正在说话时的听感需要现场验证。软件测试见[ct33 验证](../firmware/esp32-audio/verification-ct33.json)，已完成仅应用烧录、配置区保持和保存角色后的重启，见[部署记录](../firmware/esp32-audio/startup-ct33.json)。启动检查中 128／144 mm 样本对应前进锁定，后续 366／375 mm 样本对应解锁；执行器启动计数为 0。日志出现严重档播报调度，不代表听感通过。采样中间歇出现 `echo_high`，原因尚未定位，不能由本轮回执宣称稳定防撞。

## ct28 接入历史

2026-10-29，用户指定按 **3.3 V 供电、IO1 → TRIG、IO2 ← ECHO** 实现测距、网页显示和语音查询，不做自动避障。后续授权部署后，`2.0.3-ct28` 已仅应用烧录、平台角色保存回读并重启联网；配置区保持一致，实时状态取得有效回波。源码验证见[验证记录](../firmware/esp32-audio/verification-ct28.json)，部署与回执见[部署记录](../firmware/esp32-audio/startup-ct28.json)。

## 接线与证据范围

| HC-SR04 端 | 面包板端 | 设计用途 |
|---|---|---|
| VCC | 3V3 | 使用主控侧稳压 3.3 V，不接 5Vin、12 V 或效果 MOS 输出 |
| GND | GND | 主控共地 |
| TRIG | IO1 | 输出，初始化先置低，单次约 12 µs 高脉冲 |
| ECHO | IO2 | 输入，内部下拉；本轮按用户指定直连方案实现 |

这是已选的软件接入方案，不是实物接线或电平验收。GPIO 数字不是排针序号；按实物丝印核对。四根线在头部内连接，不增加头部至底盘信号线。主控侧 3V3 余量、实物针序、TRIG 阈值、ECHO 峰值、失电状态和装壳声学仍待核实；不要保留 ECHO 直连而将模块改成 5 V 供电。2026-10-30 已在 [A2 原理图第 6 页](../hardware/schematic/README.md)同步 3V3／GND／GPIO1／GPIO2 支路；原 A1 工程包作为历史保留。图纸和 ERC／网表检查不替代上述实物电平与接线验收。

[商品页](https://item.jd.com/10229075026760.html)选项为单芯片宽电压 3–5.5 V，参数图写 3.3–5 V，背面接线图却为多芯片／5 V；2026-10-28 已重新读取。页面没有明确该版本 ECHO 在 3.3 V 供电下的高电平幅值。供电范围是商家规格，3.3 V 直连为本次实施选择，均不能替代波形或对应版本电路证据。已有[原图归档与冲突记录](../hardware/procurement-web-review.md#p04--h19hc-sr04-单芯片宽电压模块)保持。

机械仍沿用[向上接头与托盘让位候选](assembly.md#头舱与穿线)，实际固定、针座与线束需核对。

## 采集与故障处理

- 独立 FreeRTOS 任务，优先级 2；不持有动作控制锁，不在优先级 10 的 BOOT／停止任务中等待回波。
- ESP-IDF 5.5.1 RMT RX 使用 1 MHz 时基、48 符号缓冲，过滤小于 2 µs 的毛刺；电平持续 25 ms 时结束接收。参考[官方 RMT 接口](https://docs.espressif.com/projects/esp-idf/en/v5.5.1/esp32s3/api-reference/peripherals/rmt.html)。没有新增外部驱动依赖。
- 初始化后等待 100 ms；采集周期目标约 100 ms，相邻触发至少间隔 100 ms，不因调度延迟补发密集脉冲。TRIG 脉冲由 GPIO 和 12 µs 短延时生成，实际脉宽及停止响应仍需设备波形验证。
- 接收完成最多等待 80 ms，覆盖回波及尾部低电平的结束判定。没有回波通常由 RMT 空闲结束报告；驱动没有按时完成则停用测距任务、关闭 TRIG、释放 RMT，并报告 `driver_error`，不会重启主控或锁死动作通道。
- 只接受一个连续高脉冲；多脉冲、缓冲填满、超过 10 ms 才到达的回波均判异常。采样前或结束时 ECHO 为高，报告 `echo_high`。未接模块与没有反射物不能仅凭超时区分。
- 使用名义声速 343 m/s：`distance_mm = round(echo_us × 343 / 2000)`。有效范围候选为 20–4000 mm，未做温度补偿或实物标定。毫米是传输单位，不宣称毫米精度或实物完整覆盖 4 m。
- 每次失败立即覆盖上一读数。超过 500 ms 的样本失效；不保留旧距离冒充实时值，不将无回波解释为无障碍。时间戳取 TRIG 脉冲结束的单调时钟。

驱动、解码与状态序列化分别在 [ultrasonic.cc](../firmware/esp32-audio/ultrasonic.cc) 和 [distance_reading.h](../firmware/esp32-audio/distance_reading.h)。ct28 当时保持 ct27 动作策略；ct33 开始距离参与上述前进保护，采集方式保持。

## 网页与语音接口

保留十一个工具。语音复用 `self.tank.get_status({})`，不增加动作工具；HTTP 状态和各动作回执均附带同一测距快照，读取不触发同步测量或等待回波。

```json
{
  "capabilities": {"distance": true, "auto_avoidance": false},
  "distance": {
    "valid": true,
    "distance_mm": 1000,
    "error": "none",
    "sampled_at_ms": 1200,
    "age_ms": 40,
    "echo_us": 5831,
    "max_age_ms": 500,
    "min_mm": 20,
    "max_mm": 4000,
    "auto_avoidance": false
  }
}
```

上例为契约示例，不是实机数据。`capabilities.distance` 表示固件有驱动，不证明模块已连接或正常。`physical_feedback=false` 继续表示没有执行器效果反馈，测距单独看 `distance`。

| `distance.error` | 含义 |
|---|---|
| `none` | 本次回波在候选量程内且样本新鲜 |
| `not_ready` | 尚未得到首次采样 |
| `no_echo` | 没有有效高脉冲，不代表前方畅通 |
| `echo_high` | 触发前或完成后 ECHO 仍为高 |
| `invalid_echo` | 多脉冲、迟到回波或缓冲溢满 |
| `out_of_range` | 回波宽度对应距离不在 20–4000 mm |
| `driver_error` | 任务、GPIO、RMT 初始化／运行或完成等待失败 |
| `stale` | 样本超过 500 ms 或时钟顺序不合法 |

无效时 `valid=false`、`distance_mm=null`；尚无采样时 `sampled_at_ms`、`age_ms` 和 `echo_us` 为 null。`echo_us` 在收到异常宽度时可保留用于诊断，不能当有效距离。`sampled_at_ms` 为本次尝试时间，不是“上一次成功”的时间。

ct31 网页在方向键右上角显示“前方距离”，与左上角的行走速度并列，有效值取整厘米；此前独立距离行已合并以减少页面高度。ct29 显示优化：相对当前显示值不足 2 cm 的变化保持显示；2–9 cm 变化最多每 350 ms 更新一次，达到 10 cm 立即更新，不使用缓慢追赶大变化的平均值。每个有效新样本仍更新新鲜度，错误／过期立即清空并重置显示滞回。启用测距时空闲轮询间隔从 500 ms 调为 200 ms，为样本年龄及网络往返留出余量；后台、断线、长按续租与停止策略保持。该滞回仅用于网页，原始测距与语音回执不变。ct30 进一步移除距离副文案与“约”前缀：有效时仅显示整数和 cm（如 `176 cm`），无回波、异常、未启用、过期和断线统一显示 `-`，原因仍保留在状态接口中。除了服务端年龄，网页保守计入整个请求往返时间，并设置本地过期定时器；后台恢复或迟到回执不能长期保留旧值。测距错误本身不新增锁定；ct33 已有前进锁定时，错误不解除该锁定。

唯一[角色源](../firmware/esp32-audio/role-prompt.txt)加入“前面有多远／测一下距离”查询规则：只引用最新成功回执中有效且不超过 500 ms 的距离，除以 10 换算厘米并说“大约”；否则说“暂时没有有效距离”。不沿用上轮对话数值、不判断道路畅通、不识别物体、不把前向距离当移动里程、不启动自动避障。为保留平台 6000 字符限制，压缩了介绍与重复示例，原动作边界保持。

## 验证与后续部署

主机测试覆盖 2 cm／4 m 边界、换算、噪声／无回波／高电平、缓冲满、500 ms 边界、64 位时钟、实际驱动适配层故障清理，以及网页旧版本兼容、乱序／延迟回执、本地过期、断线清除和不产生动作请求。沿用现有动作、MCP／HTTP 和网页回归；ESP-IDF 编译检查新驱动与原工程资源／依赖的静态兼容。通过范围见[ct28 验证记录](../firmware/esp32-audio/verification-ct28.json)。这些不是声学、电平或实机实时性验收。

已完成应用烧录、平台 5966 字符提示词保存回读及保存后重启联网。连续八次查询取得 1756–1764 mm 有效读数，释放会话时为 533 mm；无尺量参考，不能由数字变化推定精度。全部检查回执逻辑输出关闭、启动计数为 0，设备网页与源文件一致。真人语音查询仍待回归。首次硬件验证先断开执行器功率：核对 3.3 V 及 ECHO 波形、10／30／100 cm 平面目标、拔除模块与遮挡、无目标／斜面／软物体，再比较装壳前后及语音播放／Wi-Fi 期间的有效率、延迟、重启和停止响应。电机与其他低压负载干扰另分阶段验证；不包含高压点火测试。本轮未发送执行器启动请求，也未进行真人语音或带载测试。

## 用户测试反馈（2026-10-29）

部署后用户确认“测试效果符合预期”，作为本轮测距功能的现场反馈记录。未提供具体语音表达、网页／语音分项结果及对应回执，因此不将各语音边界用例全部标记通过；尺量精度、电平、装壳声学和负载干扰验证继续保留。见[部署与反馈记录](../firmware/esp32-audio/startup-ct28.json)。

## ct29 网页部署（2026-10-29）

全页禁选文字和文字长按菜单，实际速度固定在前进键左侧、左转键上方；短屏也保持该布局。模拟浏览器 390×844 与 320×667 在待命／移动时页面高度及全停按钮位置一致，无横向溢出。已完成网页回归、构建和仅应用烧录，提示词不变；实物手机手势与显示体验待复测。见[验证](../firmware/esp32-audio/verification-ct29.json)及[部署记录](../firmware/esp32-audio/startup-ct29.json)。

ct30 已完成网页回归、构建及仅应用部署；配置区保持、设备页面与源码一致，未启动执行器。见[部署记录](../firmware/esp32-audio/startup-ct30.json)。

## ct32 用户验收反馈（2026-10-29）

用户确认当前测距接入与网页优化“测试效果符合预期”，并授权提交和推送。此项记录整体验收反馈；具体异常、断线、不同手机安全区及定量电气／精度测试仍按各自证据判断。见[ct32 记录](../firmware/esp32-audio/startup-ct32.json)。
