miclle/cybertrack/docs/readme-status-20261027.md

# 2026-10-27 首页状态归档

历史文字，仅描述当时状态；链接已调整至当前归档位置。当前见 [current-status.md](current-status.md)。

## 当前状态

截至 **2026-10-27**，项目已进入**样机联调与整机验证阶段**。已有基本组装样机，制作过程及多角度实拍已归档，[6 分钟运行视频](#样机演示)展示了地面移动、转向和泡泡效果。最近一次有记录的面包板部署版本为 **`2.0.3-ct21`**，用户已现场确认前进、后退、左转、右转均正常；机械设计与打印包继续迭代，见[模型入口](../hardware/model/README.md)。

已有语音、水枪及停止功能的分项台架记录，四路控制与组合模式已有软件实现。样机照片、运行视频和四方向现场反馈分别记录了对应进展；整机供电、持续带载、停止性能和完整故障验收仍未完成，视频中的固件与供电配置也尚未逐项核对。

| 模块 | 已有进展 | 尚待验证／证据入口 |
|---|---|---|
| 语音交互 | 保留“小D”语音、OLED 和设备绑定；已有状态、停止及行走／喷水联调记录 | 新增泡泡、点火、狂暴模式的真人语音回归待完成；[角色维护](../docs/agent-role.md) · [语音记录](../docs/audio-board-validation.md) |
| 行走与喷水 | 样机视频已有地面移动与转向；ct21 修正左右履带映射后，用户确认四方向正常。水枪启停、BOOT 提前停止及 ct7 并发与独立截止已有台架记录 | 持续带载、不同工况方向回归、定量电流／温升、停止时延与距离仍待验证；[ct21 部署及现场反馈](../firmware/esp32-audio/startup-ct21.json) · [集成台架](../docs/breadboard-integration.md) · [并发记录](../docs/concurrent-actions.md) |
| 局域网控制 | 行走／喷水／泡泡长按、独立定时、四路全停与语音并用；动作结束后的页面提示已修复；ct21 部署已核对启动联网、页面与源码一致及输出全关 | ct21 部署检查未启动执行器；装车后的语音／网页并用、失联及故障回归仍需完整验证；[使用说明](../docs/lan-control.md) · [部署记录](../firmware/esp32-audio/startup-ct21.json) |
| 泡泡与点火 | 样机视频已有实际出泡画面；泡泡独立 MOS、双点火共用一块 MOS 的低压控制固件已实现，四路可并行、分别限时 | 泡泡持续运行、定时与提前停止、新通道接线仍待系统核验；底盘前方双火花的高压接线、安全、绝缘、液体共存及 EMC 未验收；[运行视频](#样机演示) · [效果控制](../docs/effects-control.md) |
| 狂暴模式 | 网页和语音均可请求限时组合：左转、喷水、泡泡及间歇点火，最长 30 秒 | 动作时序证据来自主机测试，真人口述与带载待验；[模式说明](../docs/lan-control.md#ct17-狂暴模式) · [语音接入](../docs/lan-control.md#ct18-语音启动) |
| 机械与打印 | 已有履带底盘、双枪、头部面包板及双瓶背包的基本组装样机和制作过程照片；CAD 与打印包持续迭代 | 实物装配记录不等于全部打印件验收；材料、朝向、支撑、公差、紧固、拆装和承载仍待系统验证；[制作与样机照片](../artifact/README.md#照片) · [现行模型与打印包](../hardware/model/README.md) · [历史合并检查](../hardware/model/print-consolidation-audit.json) |
| 电源 | 已换为辰克 5 V 电池包，保留 12 V 升压电机支路；水枪和泡泡工作电压为 3.7 V | 新电池输出、分线保护、组合负载与续航待核；旧电源台架结果不迁移；[电源方案](../docs/power-and-interfaces.md) · [电池资料](../hardware/components/ck-5v-battery/README.md) |

实拍记录制作与运行表现，用户反馈确认相应现场现象；主机测试覆盖软件逻辑，CAD 检查核对所建几何关系，台架记录只覆盖对应版本与工况。这些证据不能互相替代，也不构成完整的整机制造、电气或儿童使用验收。

接下来围绕现有样机收敛三方面：补齐打印件实物适配、紧固与拆装验证；测量新电源及各支路的电流、温升、停止性能和组合负载；完成装车后的方向、液路、语音与网页故障回归。具体任务与验收条件统一维护在 [TODO](../TODO.md) 和[实施及验收计划](../docs/verification-plan.md)。
