miclle/cybertrack/docs/power-and-interfaces.md

# 电源与硬件接口

**ct28 测距候选（2026-10-29）：** 用户指定由头部主控侧 3V3 给 HC-SR04 供电，IO1/TRIG、IO2/ECHO，接入网页和语音查询；不做避障；后续已授权并完成 ct28 烧录与平台更新。3V3 电流余量、实物 ECHO 电平和针序尚未验证；不改为 5 V 后保持 ECHO 直连。A1 未增加此支路，详见[测距说明](ultrasonic-ranging.md)。

ct27 新增速度控制：默认 100% PWM、60–100% 指定速度、网页动态滑块、语音目标调速和 10 个百分点加减；序列步骤可选 `speed_percent`。当前源码契约与验证见[速度控制](speed-control.md)，ct27 已仅应用部署并保持配置；下方历史速度描述不适用于 ct27。

2026-10-28 源码候选 ct22 将 PWM 提至 230/255（约 90%），行走按指定时长执行并支持序列；GPIO、1 kHz、电源拓扑和 BOM 无变更。ct22 已仅应用部署并保持配置；新占空比及长时动作的电流、母线、温升与停止另验，见[动作序列](action-sequences.md)。

核对日期：2026-10-27。当前电源基线为辰克 5 V 电池包，面包板最新有记录的固件部署为 `2.0.3-ct21`。基本打印、装配与样机运行已有记录，ct6／ct7 台架分项及 ct21 四方向反馈不等于当前电源或完整整机电气验收；见[集成记录](breadboard-integration.md)、[并发记录](concurrent-actions.md)和[样机影像](../artifact/README.md)。影像未绑定完整固件／供电配置。

[模块级原理图 A1](../hardware/schematic/README.md)已完成 ERC 与网表静态检查，供审图使用；输入保护 U2、主电源控制 U3、MOS 下拉和保险等仍有待定项。SW2 已确认只切执行器供能、主控继续运行，器件额定与实际切断行为未验收。下文分别记录当前方案、历史台架和未验证项。

2026-10-26 安装位置更新：水枪、泡泡枪的 P12 降压模块已由用户集成到各自枪体；底盘至枪体携带 MOS 控制后的 5 V，枪体内降至 3.7 V。此次仅变更机械布置，不改变已记录的 5 V→MOS→降压→负载顺序；12 V 电机升压模块仍在底盘。新枪体内位置、外露引线、接头及带载温升未提供测量，不据此增加假定几何。

2026-10-25 电源替换记录：用户已用[辰克5 V可充电锂电池包](../hardware/components/ck-5v-battery/README.md)替代原A110M充电宝；型号CK18650-1234S-NP、用户尺寸116×70.5×19.5 mm。新电源输出电流、保护、接头用途／极性及带载能力未知，铭牌容量不能证明供电预算。12 V电机升压方向保留；下文旧A110M参数与台架记录均为更换前证据，不迁移至新电源。

用户新增两只点火线圈共用一块P01、由ESP32-S3控制的需求；[CAD仅布置安装位](ignition-routing.md)。ct13 起已增加并部署 GPIO21 低压控制，当前 ct21 沿用；点火实际接线及高压验收仍未完成，见[效果控制](effects-control.md)；未实现高压接线。总输入电流、启动瞬态与MOS保护／关断能力需另评估。

历史 L298N 台架（2026-10-25）：H03 为 [P13／何健弓 L298N](../hardware/components/L298N/README.md)，充电宝＋MT3608 的 12 V 方向保留，旧 VD／VS 与 E1／M1 接法停用。[0.3.2 双路台架](../firmware/esp32-motor-bench/README.md)临时分配 A=GPIO4／5／6→ENA／IN1／IN2、B=GPIO7／8／9→ENB／IN3／IN4，约 60% PWM、单次 10000 ms，必须显式选择 A／B／AB 并使能。接 B 路前移除旧 ENB 接地线及可能存在的 IN3／IN4 接地线。六脚上电前后关闭电平已获用户确认，此前 0.3.1 的 3 秒版 8 组空载组合的单路隔离、方向与正常停止已获用户确认，用户已确认双路 60%／10 秒空载正转正常启停，启动、运行中及临近停止母线均约 12 V，电机和 L298N 无明显发热、无异响或其他异常；这是万用表读数与主观发热观察，电流和定量温升仍未测；以下是已有单路观察。用户报告静态 +12V 约 12 V、+5V 约 5 V、空闲 ENA／IN1／IN2／ENB 近 0 V；两次 40%／10 秒反转正常停止，第二次启动和运行母线均约 12 V。稳压跳帽保留、使能跳帽拔掉，+5V 不接 ESP32；60%／10 秒空载反转时，用户报告启动及运行母线仍约 12 V、转动更快更顺畅并正常停止，无异常。普通万用表未排除瞬态掉压，当前面包板已配置 GPIO8–13，不能套用本段独立台架 GPIO；复位默认关闭和电流／温升仍待验证。

历史 DF-MD 台架反馈（2026-10-24）：用户报告充电宝此前反复自动断开，更换输出口后重新供电。已按原参数再次发送单次点动并收到固件关闭回执；电机是否转动及新端口是否持续供电待观察。断开原因尚未确定，不将其直接等同于低负载策略或过流保护，供电验收仍未通过。

2026-10-24 用户确认：水枪和泡泡机的工作电压均为 **3.7 V**。这是用户提供的参数，尚未提供允许电压范围、启动／运行电流或完整定量带载测量结果。两支路按 3.7 V 规划供电，P12 降压板已有 3.7 V 输出记录，2026-10-26 用户确认已集成到各自枪体；保护器件及完整带载能力待核实，不直接接 5 V USB 或 12 V 电机母线。用户已澄清水枪台架实际为 5 V → P01 MOS → P12 降压至 3.7 V → 水枪。P01 接在降压板前，5 V 位于其商家标称 5–36 V 范围内；此前将 MOS 放在 3.7 V 侧的假设撤销。用户已确认本次 5 秒正常喷水、结束自动停止；开关损耗、降压启动与关断残余输出、带载电压／电流及温升仍待测量。

2026-10-24 用户报告新增 P12 降压模块接线测试得到 **5 V 输入／3.7 V 输出**，负载工况尚未提供；原图与选压方式见[部件记录](../hardware/components/dc-dc-buck/README.md)。本次按 3.7 V 效果电源记录，不作为 3.3 V 主控电源。用户选择水枪作为首个 MOS 测试负载，控制信号与开关验证见[MOS 台架测试](mos-bench.md)。

## 供电结构

ct24 诊断仅额外启用 ESP32 GPIO18 的数字输入缓冲，原输出能力、接线、驱动和 PWM 不变。板端高低采样用于核对喷水控制脚，不测量水枪支路电压、电流或 MOS 导通，详见[诊断边界](action-sequences.md)。

2026-10-28 用户确认当前执行器接法：电机升压板、水枪、泡泡枪、点火模块均共用同一个 5 V 电池输出。当天单独喷水正常，左转与喷水重叠时未出水，停转后才出水；固件记录两路同时活动且独立到期。共用输出、分线／回流压降及水枪支路输入列为优先测量对象，尚未确定根因，不能认定电池故障或并发供电通过。其他效果支路未在这组试验中启动，主控当前供电方式未确认。见[现场记录](action-sequences.md#2026-10-28-并发喷水现场反馈未解决)。

```text
辰克 5 V 电池包（输出口、极性与能力待核）
  └─ 输入保护／主电源控制与分配（A1 的 U2／U3 待选）
       ├─ 主控保护／检修断开 → 面包板 5Vin → 原音频／屏幕电路
       └─ SW2 独立执行器切断（功能已定，器件及实测未完成）
            ├─ 支路保护 → MT3608 升压 → 12 V → L298N → 左右电机
            ├─ 支路保护 → 水枪 P01 MOS → 枪体内 P12 → 3.7 V 水枪
            ├─ 支路保护 → 泡泡 P01 MOS → 枪体内 P12 → 3.7 V 泡泡机／自带风扇
            └─ 点火低压预留：5 V → 共用 P01 → 两只模块的需求
                 A1 审图装配保持 JP2 断开，U10／J9 为 DNP，不含高压接线
```

这是当前功能分支及 A1 设计边界，不是已完成接线或通电放行图。三块 MOS 各控制一路，两块 P12 分别位于水枪／泡泡枪体内；实际端接、线束、支路保护与额定值仍需核对。SW2 的残余储能、真实停止时间及恢复供能行为待测；BOOT 软件停止不能代替独立切断。见[原理图参数清单](../hardware/schematic/parameter-confirmation.md)。

辰克电池的接头用途、输出电流、保护及充电要求尚未完整核实，不能继承旧充电宝的端口档位或功率。主控仅使用已核实的稳压 5 V 入口，不能把 12 V 或未经确认的电池端子接入；不并联多个电源输出，USB 与外部 5Vin 的隔离／反灌仍待验证。

## 面包板与电机共用充电宝（2026-10-25）

本节保留更换电源前的已记录方案和链接锚点；新电源仅延续5 V分支方向，接头与实测结果不继承。

用户选择从充电宝同一 **5 V 输出**并联分出主控和电机升压两路，面包板日常通过 `5Vin + GND` 供电，省去主控端 Type-C 电源插头。此处“面包板”指当前集成 ESP32-S3、麦克风、功放和 OLED 的整组硬件；平台历史名称“彩菊”不是板卡型号。用户提供的[正面照片与针位核对](audio-board-validation.md#2026-10-25-面包板供电针位照片)支持识别电源脚，尚无本次改线或共用电源运行结果。

```text
充电宝 +5 V ──┬──→ 面包板主控 5Vin
              └──→ MT3608 IN+
充电宝 GND ───┬──→ 面包板主控 GND
              └──→ MT3608 IN−

MT3608 OUT+（调至 12 V）──→ L298N +12V
MT3608 OUT− ─────────────→ L298N GND
面包板主控 GND ──────────→ L298N GND（保留控制共地）
```

- 在电源分线处并联，主控与升压模块各有正负供电线；电机功率电流不经过主控排针、面包板电源轨或细控制地线。分线连接器、线径、额定电流与固定方式待选。
- 主控只接稳压 5 V，不接升压后的 12 V，不把 5 V 接到 `3V3`／GPIO；L298N 的 `+5V` 端仍不连接主控。麦克风、屏幕、功放沿用现有供电接线，不改接到新增的 5 V 分支。
- 共用一个充电宝不等于并接多个 USB 输出口；保持端口输出为 5 V，不使用会把该共用输入升至 9 V／12 V 的快充触发方式。
- 改线先断开全部电源；主控引脚供电时拔掉电脑 USB，USB 烧录前断开外部主控 5 V 并断开执行器功率。照片不能证明 USB 隔离或反灌保护，尚不支持双源同时供电。
- 保留电机／水枪功率支路独立断电手段。首次验证仍先让主控启动并确认输出关闭，再接执行器功率，收尾先断执行器；本图未画出开关和保护器件，不代表已选型。共同电源一次上电时的默认关闭、欠压及复位行为尚未验证。
- 水枪仍按 5 V→MOS→降压至 3.7 V→水枪连接；MOS 输出侧负极不得额外接回充电宝负极或主控 GND，避免绕过低侧开关。本次不改变其他效果支路。

同源后，电机启动和音频峰值会共同占用充电宝电流预算。下方 A110M 的 5 V／3 A 限制仅适用于旧电源；双电机输入预算仍需与新电池额定输出重新核对；不能用此前主控由电脑 USB 供电时的台架结果证明本方案稳定。首次先验证主控独立启动、联网、OLED 与语音播放，再分阶段接电机功率，记录主控入口 5 V、12 V 母线、输入电流、重启／断音／保护关断及温升。普通万用表读数不排除瞬态跌落；共用电源、带载、反复工作及完整故障验收均待完成，见[验证计划](verification-plan.md#面包板共用-5-v-电源专项2026-10-25)。

## 旧 A110M 页面说明书的供电限制（历史）

[商品页说明书](../hardware/reference/procurement-2026-10-23/P11-A110M-manual.pdf)第 5 页列出：USB-C 自带线／端口输出 5 V／3 A、9 V／3 A、10 V／2.25 A、12 V／3 A、15 V／3 A、20 V／2.25 A，最大 45 W；USB-A 输出 5 V／3 A、9 V／2 A、10 V／2.25 A、12 V／1.5 A，最大 22.5 W。**多端同时输出总计仅 5 V／3 A、15 W。**输入最大 30 W，与输出额定值分开。

单路快充档位需匹配协议协商，不能由普通接线自动取得。当时未选择协议取电器，采用充电宝＋升压方向；这些端口限制只适用于已替换的 A110M。说明书的小电流模式针对 USB-A 低功耗设备，双击电源键启用／退出；关断阈值、保持时间、端口插拔重协商及制动回灌行为仍待核实。

标称能量 74 Wh；说明书分别列电芯容量 20000 mAh 和电池组 10000 mAh／7.4 V，两者不能当作 12 V 容量。页面另列额定容量 12000 mAh，未附条件，不用于续航结论。

## 初步功率预算

下表引用 [37R-520 资料](../hardware/components/37R-520/README.md) 中 12 V、100 rpm、60∶1 对应行，实物版本仍待确认。

| 工况 | 两台电机电流之和 | 按 12 V 计算的电机输入功率 |
|---|---:|---:|
| 商家空载点 | 0.14 A | 1.68 W |
| 商家额定负载点 | 1.10 A | 13.20 W |
| 商家堵转点 | 2.80 A | 33.60 W |

堵转点仅用于保护与瞬态预算参考，不是持续运行工况，不要求以长时间堵转做试验。真实起动和转弯负载用受控短时测试测量。

`P_输入 ≈ (P_电机 + P_驱动损耗) / η_升压 + P_其他支路折算到输入端`

`I_输入 ≈ P_输入 / V_电池输出`

**计算示例，非选型结论**：若端口为 5 V、升压效率为 85%，仅把额定电机功率折算到输入端，就得到 `13.2 / 0.85 / 5 ≈ 3.11 A`；堵转标称点约 `33.6 / 0.85 / 5 ≈ 7.91 A`。二者均未计驱动损耗、主控和效果负载。5 V / 3 A 端口在这个假设下不能覆盖额定电机输入预算。**旧 A110M 的历史预算**：其说明书列出的 5 V 单路及多端总输出均有 15 W 上限；按上述效率计算输出仅 12.75 W，低于双电机额定点 13.2 W。不能以“充电宝 45 W”消除这一工况缺口；该结论是旧电源的资料预算，不是实物试验，也不适用于输出能力尚未知的辰克电池。

所选 L298N 对应的 L298 功率级存在压降和发热，**12 V 母线不代表电机端始终获得 12 V**。实测电机端电压、启动能力和温升后决定是否满足目标；不自行升高母线来补偿压降。芯片参数及限制见 [ST 数据手册](https://www.st.com/resource/en/datasheet/l298.pdf)。

容量与输出能力分别核对。续航估算使用 `有效能量 Wh / 平均输入功率 W`，有效能量受端口转换、低电量切断及负载影响；电池标称 mAh 不能直接当作 12 V 输出容量。当前不承诺续航时间。

## 需要补齐的电源数据

| 项目 | 必要数据 | 判定目的 |
|---|---|---|
| 辰克 5 V 电池包 | CK18650-1234S-NP、116 × 70.5 × 19.5 mm 已记录；持续／峰值输出电流及时间、保护阈值／恢复、接头用途／极性、重量与负载能力待核 | 确定输入保护、开关、保险及持续供电预算；不沿用 A110M 的参数 |
| MT3608 升压板 | 已选页面无 USB MT3608；标称输入 2–24 V、输出 5–28 V；用户实测37×18×6 mm，见[部件记录](../hardware/components/MT3608/README.md)；待核安装接口、“2A”工况、12 V 连续／峰值电流、效率曲线、散热、限流及欠压 | 启动、转弯与组合负载时是否掉压 |
| 电源线缆、接头与检修 USB | 额定电流、长度、压降、接头锁定与拔插空间 | 避免接口发热与接触中断 |
| 何健弓 L298N（P13） | 实物版本、整板电源入口、稳压及使能跳线、5 V 端方向、保护与散热器 | 不套用旧板 VD／VS 接法；未核实前不把 5 V 端并接 USB／ESP32 电源 |
| 水枪／泡泡机 | 用户已确认均为 3.7 V；待补允许电压范围、静态／运行／启动电流、允许连续工作时间 | 分配支路、开关、连接器和保护 |

后续验证需覆盖辰克电池满电与低电量、单／双电机启动、差速转向、效果启停、语音播放及 Wi-Fi 发射。检查升压启动、掉电重启、空闲自动关断、输出回灌／制动行为及热状态；具体测试方法按器件资料制定。

## 当前信号资源与待接入接口

| 接口 | 当前分配／资源 | 验证范围与缺口 |
|---|---|---|
| 双电机 | A：GPIO8／9／10→ENA／IN1／IN2；B：GPIO11／12／13→ENB／IN3／IN4 | ct6 已迁线并取得台架分项；ct21 为 A／右、B／左、约 80% PWM，四方向获用户确认；定量电气和默认关闭未验收 |
| 水枪／泡泡／点火低压 | GPIO18／17／21，各控制一块 MOS；点火两模块共用一路 | 固件已部署；水枪有台架、泡泡有影像，完整接线与负载另验；点火高压边界不变 |
| 麦克风／功放／OLED | I²S 输入 GPIO4／5／6，输出 GPIO7／15／16；OLED GPIO41／42 | 原音频／显示功能已有观察；具体模块供电与辅助脚尚未逐线核实 |
| 停止／电源控制 | 板载 BOOT 为 GPIO0；外接 SW3 为 GPIO0／GND 常开干接点方案；SW2 只切执行器供能 | 板载 BOOT 有分项结果；外接按钮、SW1／SW2 型号、触点及实际关断未验收，软件停止不能代替切断 |
| 双编码器 | 预期四路输入，未分配 GPIO | AB 针序、供电和输出电平待核，未接入闭环 |
| 超声波测距 | ct28 候选 IO1/TRIG、IO2/ECHO、3.3 V | 网页／语音查询，无避障；已部署，实物电平与针序待核 |
| MG90S／继电器 | 当前无整机 GPIO 分配 | 用途、针序、电平与负载尚未确定 |
| 电源监测 | 未选电压／电流传感器 | 无已确认 ADC／总线分配，不声明电量或过流遥测 |

完整端点与音频按键见[接线总表](wiring.md)。A1 的 R1–R6 已选为 10 kΩ、±1%、至少 0.1 W，属于六路电机下拉的设计值；尚未证明实物已安装或启动／失电默认关闭。MOS 的 R7–R9、F1–F7 及 U2／U3 仍待定，不能用电机下拉选值替代 MOS 输入验证。

[ESP32-S3 板卡记录](../hardware/components/ESP32-S3-N16R8/README.md)已补齐 COREBOARD 原理图与排针连接。N16R8 的 GPIO35–37 为八线 PSRAM 占用；GPIO19／20、43／44、48 分别涉及原生 USB、串口桥和 RGB，GPIO0／3／45／46 为启动绑带；这是独立 COREBOARD 板卡的资源约束，当前面包板 GPIO0 沿用 BOOT 停止输入。USB1／USB2 经二极管到 5 V 网，实物照片的稳压器标记为 1117 3.3V，与图纸 U3 不同；双 USB 枚举和 ROM 识别已通过，但 J1-21 的 IN-OUT 旁路焊装仍需确认；本次不批准多电源并接。当前面包板 GPIO 已按固件配置列于上表，但实物版本、焊装、逐线连接与外设默认状态仍须核对。[ESP32-S3 官方资料](https://www.espressif.com/en/products/socs/esp32-s3)仅证明芯片能力，不证明任意开发板引脚均可使用。

P01 为双 MOS 成品模块，页面标称 5–36 V、3.3–20 V 高电平触发和 0–20 kHz PWM；P02 页面选中 1 路 5 V 红板，光耦／高低触发切换为系列说明。P01 已用于历史水枪台架并取得一次 5 秒正常喷水／自动停止的用户观察，P02 负载尚未分配；仍需验证 3.3 V 逻辑阈值、默认关闭、驱动损耗和保护；不可仅凭商家 15 A／30 A 或触点 10 A 宣称负载适配。MG90S 供电及峰值电流仍缺少对应版本依据。

P04 选项为 HC-SR04 单芯片 3–5.5 V；通用图列 TRIG／ECHO、15 mA、2–400 cm，但同时存在 3.3–5 V 和 5 V、多芯片示意，不能冻结实物针序或直接认定 ECHO 的 3.3 V 兼容性。先核实电平再决定电平转换与 GPIO。P09／P10 网页资料对应完整玩具；用户已于 2026-10-24 确认水枪和泡泡机工作电压均为 3.7 V，允许电压范围和启动电流仍待核实；“USB 充电”不作为内部电机 5 V 额定值。

## 液体、干扰与前方火花效果

水枪、泡泡液分仓；排液不流经电池、电源板或主控，补液与清洗先断电。泡泡前吹需在姿态变化、停机与余液状态下验证，不将出风方向当作防水等级。

火花模块商品标称“1000KV”未获实测或正式技术资料支持，不将其写入绝缘设计额定值。3–6 V 只描述输入，≤5 秒只描述单次时间；输出电流、储能、残余电荷、占空比、触及防护及对无线／音频／控制器的影响仍未知。此部分待具备相关能力的人员评估；当前低压系统通电验证排除高压模块。

## 面包板水枪台架（2026-10-24）

**历史记录。** 以下描述该阶段方案或实测，不代表当前电源、完整线束或整机验收；仍有效的未验证项继续保留。

与原 GPIO4 水枪台架区分：`bread-compact-wifi` 面包板 GPIO4/5/6 为麦克风，7/15/16 为扬声器，41/42 为 OLED；本轮仅选择空闲排针 IO18 接 MOS TRIG/PWM、面包板 GND 接控制 GND。原水枪板控制线移除，不连接 MOS 输出侧负极到面包板地，以免绕过低侧开关。保留原 5 V→MOS→3.7 V 降压→水枪支路，不将功率电源并入面包板电源脚。

ct4 接受明确语音五秒请求，不再要求逐次 BOOT 授权；BOOT0 仅提前停止，松开不恢复，断线关闭输出。改线、烧录与复位时保持 MOS 5 V 断开。ct3 控制信号升高／归零已有用户测量反馈，此前 5 V 接回后未喷水；用户已确认 IO18 与 GND 在 MOS 控制端接反，纠正后测试正常。MOS 输入测得 5 V，带载 BOOT 提前停止及松开不恢复已确认，输出电压数值仍未提供，详见[面包板喷水记录](audio-water-validation.md)。该分配不冻结整机 GPIO，软件回执不等于负载得电。

2026-10-24 后续时长调整：面包板 ct5 改为按用户指定时长执行，单次最多 30 秒，保留 BOOT／语音停止及断线关断；明确要求喷水但未指定时长时默认一次 1 秒，不循环补足超限请求。此调整仅适用于面包板，原固定五秒台架结果保留为历史证据；ct5 语音验证及 30 秒带载边界见[喷水记录](audio-water-validation.md)。

## 顶部自吸液路接口（0.28）

**历史记录。** 以下描述该阶段方案或实测，不代表当前电源、完整线束或整机验收；仍有效的未验证项继续保留。

水枪和泡泡枪均可自吸（用户于2026-10-24确认），各自吸管从液舱顶部插入，经两侧连接前枪；后护甲和舱侧不再保留管孔。两路不合并，供电与控制接口保持原约定。喷水管外径5 mm为实测，泡泡管外径4 mm、中心弯曲半径8 mm、顶部贯通孔9 mm及路线预留8 mm为候选；孔径不是已选接头规格。

顶部通道穿过盖、导向塞和把手，仍需选择护口、固定及通气防溅方案，不能用封死储液舱的方式阻断补气。开任一盖前先处理残液并抽出两路吸管。真实吸程、接口气密性、干管起吸、液位范围、停机倒流、抗折及柔性拆装待实测；本轮没有增加外置供液泵。

## 0.33 驱动板机械布置与线束占位

**历史记录。** 以下描述该阶段方案或实测，不代表当前电源、完整线束或整机验收；仍有效的未验证项继续保留。

L298N 独立包络竖装于两台电机之间，见[部件布局](../hardware/components/L298N/README.md)。`PowerCableRoute` 保留原电源插头占位与头颈段，仅将下部 Ø6 示意线束改为 (0,−14,50) → (0,−14,84) → (0,6,84) → (0,6,142) → (0,−5,142) mm，以绕开新包络。此处不定义驱动板端子方向、GPIO、导线规格或电气连接；真实板卡引线、最小弯曲半径、固定与热隔离仍待验证。

## 0.34 接线与通风空间候选

**历史记录。** 以下描述该阶段方案或实测，不代表当前电源、完整线束或整机验收；仍有效的未验证项继续保留。

照片确认 L298N 散热器端在上、电机端子在两侧、电源／控制接口在下沿；板在整机中元件面朝 −Y。两侧预留 3.25 mm 宽引线廊，下沿预留 32×11.5×10 mm 接口区；断线入口朝底部，端子螺钉在托框抽出后操作。它们是几何空间，尚未用实际导线、插头或弯曲半径核验，不改变上文台架接线。

底部总 50 mm² 进风口与顶部总 30 mm² 排风口连接无遮挡空气预留；后湿舱隔板保持，开口未防水。CAD 无干涉不代表散热充分，需在实际供电、载荷、外壳和环境条件下验证温升。见[支架检查](../hardware/model/l298n-mount-audit.json)。

## 2026-10-25 面包板 L298N／水枪集成候选

**ct6 历史方案，后续已完成迁线及基本台架分项。** ct21 仍沿用六路 GPIO，但已采用约 80% PWM 和 A／右、B／左映射；互斥由 ct7 取代。

同一面包板候选分配 A=GPIO8/9/10、B=GPIO11/12/13，水枪 GPIO18 保留；两路 EN 跳帽取下，L298N +5V 不接主控电源脚，原电机 12 V 与 MOS 5 V 功率支路保留。改线／刷写时两功率均断开，不能照搬原电机台架 GPIO4–9。完整接线、逻辑共地、低侧 MOS 边界和分阶段验收见[集成记录](breadboard-integration.md)。ct6 互斥只限制动作，不等于两支路同时接电的预算、回灌或干扰验证通过。

## 2026-10-25 ct7 并发动作变更

**历史变更与分项完成记录。** ct7 后续已完成两种独立截止顺序、BOOT 与语音停止的并发台架；完整新电源与当前四路组合负载仍未验收。

ct7 允许电机与水枪同时负载，接线、GPIO 与既有 12 V／5 V→MOS→3.7 V 支路不变。本次用户授权功能并发；此前双路接电但分别动作的记录不能证明同时负载电源预算、回灌或干扰通过。见[并发动作说明](concurrent-actions.md)。

## 2026-10-25 ct8 局域网接口

**历史记录。** 以下描述该阶段方案或实测，不代表当前电源、完整线束或整机验收；仍有效的未验证项继续保留。

同一 ESP32-S3 增加 HTTP 8080 网页控制，页面、状态及动作均由设备提供，沿用现有 Wi-Fi 和 GPIO。新增网络会话不改变 L298N／MOS 接线、功率电压或时长上限；网页和语音共用输出与停止路径。接口与来源切换见[局域网控制](lan-control.md)。音频、网页和动作并行时的资源、停止时延及供电仍需板上验证。

## 2026-10-25 ct9 按住行走

**历史记录。** 以下描述该阶段方案或实测，不代表当前电源、完整线束或整机验收；仍有效的未验证项继续保留。

ct9 允许网页持续按住行走超过三秒，GPIO、约 60% PWM 和供电不变；语音限时不变。持续负载的电流、驱动温升、母线及停止表现未验收，既有三秒台架证据不替代长时间行走验收。详见[局域网控制](lan-control.md)。

## 0.40 面包板托盘的线束边界

**历史记录。** 以下描述该阶段方案或实测，不代表当前电源、完整线束或整机验收；仍有效的未验证项继续保留。

面包板整组按100×85×36规划，端口、屏幕／音频位置和天线边界待实物输入；旧裸板的USB／天线机械预留不再代表当前布局。头端Ø6候选电源线经托盘后部10 mm宽槽到板后侧；颈部以下路线保持。拆盘须断电并断开／收置对外线束，板内跳线可保留。槽与路线不代表真实接头、弯曲半径、应力释放或供电通过；不改变GPIO及固件接口。0.40当时未迁移电弧模块；0.42仅将本体和机械夹持移至背包外侧，不改变本文件的电气接口。见[浅托盘](breadboard-tray.md)。

## 0.42 效果模块机械位置

**历史记录。** 以下描述该阶段方案或实测，不代表当前电源、完整线束或整机验收；仍有效的未验证项继续保留。

[背包外侧本体夹持及底盘薄承板](effects-mount.md)已合入机械模型；两块MOS与两块降压板按水枪／泡泡枪各一套规划。未新增GPIO、针序、高压接线、驱动或启用流程；板卡端子、实际线束、绝缘与液体共存仍待核实。机械检查不提升既有电气验收等级。

## 0.43 效果板局部接线预算

**历史记录。** 以下描述该阶段方案或实测，不代表当前电源、完整线束或整机验收；仍有效的未验证项继续保留。

四块低压板的内外端预留候选接线区，中央5×4通道和两侧Ø3空间用于局部布线；方向、尺寸与实际端接尚未测量。不修改既有GPIO、MOS先于降压的台架拓扑或高压边界；未定义连接器针序、线径与电流额定值。拆盘先断开对外线束；见[机械边界](effects-mount.md)。

## ct13 固件接口候选（2026-10-25 后续）

**历史候选已部署。** 此标题保留旧链接；软件不再处于未刷写状态，当前 ct21 继续使用 GPIO17／21。

泡泡 GPIO17、两只点火共用 GPIO21 为新增源码分配；用户确认点火直接使用 5 V，单次最多 5 秒。泡泡仍为 3.7 V，独立 P01／降压支路待核；三路 MOS 分配详见[效果控制](effects-control.md)。四路软件允许同时运行，不等于辰克电池包、两只线圈总电流、MOS 保护／关断或整机同时供电通过。上文“未分配 GPIO／未实现驱动”属于此前机械范围，ct13 已完成低压 MOS 控制部署；泡泡后续已有样机出泡影像，逐线核对和完整电气验收仍未完成，点火高压接线与通电验收未完成。

## 2026-10-26 电源拨动开关

H15新增用户指定的[拨动开关](../hardware/components/power-switch/README.md)，实测机械尺寸已补齐到安装候选所需范围；0.53安装在[折面顶盖中央](power-switch.md)，靠近电池，本体下方保留局部线尾空间。型号、直流额定能力与三个焊脚的通断关系仍未知。后续 A1 已将 SW1 表达为低电流请求触点候选，主电源控制 U3 待选；SW2 的“仅切执行器”功能已确认，不能把两者当作同一已验器件。需核对实际电流与开关规格后确定连接，独立执行器供能切断验收保持未完成。

## 外接BOOT软件停止输入（2026-10-26）

外接常开自复位干接点连接面包板GPIO0与GND，与板载BOOT并联；低有效，固件已有输入上拉和全部动作停止处理。不能接5 V或MOS开关后的负极。选型必须适合低电流逻辑输入。0.54[机械与走线候选](boot-button.md)将按钮置于右肩内侧，线对经颈架后缘及中央通道到头舱后槽；板内GPIO0/GND末段、端子与接头须结合实物完成。GPIO0上电／复位低电平可能进入下载模式，按钮不是独立供能切断。已有板载 BOOT 分项不等于外接按钮已安装；外接接线、器件和带电验证仍无完整记录。

## 0.55：15根线共用通道（2026-10-26）

原13根跨头部/底盘清单加外接BOOT GPIO0/GND双线，按15根规划；净通道Ø10，BOOT包含在总空间预算内。原后槽终点改为头舱左侧X60/Y6/Z194，底盘交接位X0/Y6/Z84，末端排针/分线器仍待实物。图中点火两根仍悬空预留；不改变 ct13 以后已部署的低压控制或高压验收边界。材料、线径、接头、供电和EMC未验证，见[通道说明](cable-passage.md)与[15根接线图](diagrams/head-chassis-wiring-13.html)。

## ct20 电机占空比（2026-10-26）

ct20 历史部署将面包板电机 PWM 提高至 204/255（约 80%），GPIO8–13、1 kHz 频率及现有电源拓扑保持，BOM 无变更。状态方向／标称占空比为 −80/0/80。ct20 已仅应用刷写并保留配置；历史独立台架与面包板的 60% 电压、启停和主观温升记录不作为 80% 的供电验收，新档位带载电流、母线及温升待测。
