miclle/cybertrack/docs/lan-control-ct9.md

> ct9 历史记录；本文“当前”及验证状态均指 2026-10-25 的 ct9 阶段。当前 ct21 行为与未验证项以[局域网控制](lan-control.md)为准。

# ct9 局域网网页控制：按住行走

2026-10-25：用户要求在现有 ESP32-S3 上增加手机网页、定时动作、实时状态和全部停止，保留语音。随后用户要求方向键按住持续行走、松开停止。当前源码版本 `2.0.3-ct9`，替代未部署的 ct8 定时方向键；已完成软件验证、ESP-IDF v5.5.1 编译、仅应用分区烧录及平台角色回读。**实机无负载 HTTP／桌面网页通过；真实手机与语音现场联调待反馈，带载验收未完成**。ct7 已部署及台架记录、ct8 软件报告保留，不转移为 ct9 验收。

## 使用方式

1. 设备连接原有 Wi-Fi；手机位于同一可互通局域网。ESP32-S3 使用 2.4 GHz，手机可以处于路由器桥接的 5 GHz；访客隔离／客户端隔离会阻止访问。
2. 联网时 OLED 的消息区和本地串口 `CT_WEB` 显示 `http://<设备 IP>:8080`；既有语音消息可能覆盖屏幕显示。DHCP 换地址后使用新地址。
3. 浏览器打开该地址，直接点击“连接并接管”，无需配对码。设备必须没有活动动作，也不能已有另一网页控制者；拒绝时不抢占或排队。
4. 按下前进／后退／左转／右转即请求行走，持续按住维持同一方向；松开、移出原按钮、触控取消、丢失指针捕获或键盘焦点时立即发送行走停止请求。支持触屏、鼠标以及聚焦方向键后的空格／Enter；按键自动重复不会再次启动。一次只接受一个方向，换向须先松开，保留停止后 3 秒冷却。
5. 喷水仍选择 1／3／5／10／30 秒，单独点击执行。勾选“按方向键时，同时喷水”后，按下时原子启动持续行走与一次定时喷水；续租不续喷。松开仅停止行走，已开始的喷水继续至原截止时间；全部停止／后台／失联关闭两路。
6. 未行走时状态约每 500 ms 刷新；按住时由每次续租回执刷新，显示“按住行走”，不将 600 ms 租期显示成用户动作时长。底部“全部停止”、BOOT 和语音停止始终可以结束两路。关闭页面、锁屏、切后台或行走中窗口失焦会尝试停止并释放，重连／返回不自动续走，须重新接管并按下。

“松开停止”表示浏览器立即发出停止请求、设备处理后关断；网络和机械惯性使其不能等同于零延迟实体停车。停止包丢失时由设备端 600 ms 行走续租截止兜底，实际响应与停车时延待板上测量。

只支持 IP 地址访问，当前版本不启用 mDNS。8080 与原配网 HTTP 服务及控制端口分离。页面、CSS、JS 内嵌应用，无 CDN、字体下载、App 或独立服务器。取得 Wi-Fi 地址后，网页功能独立于云端语音会话；本地互联网断开仍可操作的设计需板上验证，云端语音仍依赖互联网。

## 控制权与输出约束

- 连接成功即取得单网页控制权。接管会取消应用队列里尚未执行的语音票据；原音频会话的已见 RPC ID 历史保留。网页序号独立，不占用语音的 128 项记录表。
- 网页接管期间语音对话、查询状态、全部停止保持；语音动作拒绝。网页释放后，已建立的语音会话可接受新的明确动作；没有语音会话时按原方式唤醒，不补做旧命令。
- 云端音频通道关闭／错误只撤销语音入口；网页接管时不因此停止网页动作。Wi-Fi 断开关闭两路、撤销网页会话并清除语音在线状态。重启／OTA 入口锁定全部动作；OTA 失败也不会自行恢复，需正常恢复流程。
- 网页控制权心跳租约 **2000 ms**；持续行走另有更短的 **600 ms** 截止。两者均由原优先级 10、5 ms 控制任务检查。控制权租约过期时停止并释放；行走租约过期时停止两路并取消长按，控制权可保留至原 2000 ms 截止。两者均取消相关待执行请求。停止响应仍受调度、驱动及硬件影响；2000 ms 是软件策略期限，不能声称是已实测的实体停止时延。
- 按住行走：浏览器等待上次回执后约 **150 ms** 发下一次续租；一次最多一个续租请求在途，短请求超时 400 ms。续租必须携带当前 `hold_id` 与设备回执的单次 `renewal`，重复或旧续租不能延长期限。600 ms 到期关闭两路且作废长按，状态心跳本身不能续走；续租只更新电机截止时间，不重复初始化 PWM、不增加启动计数、不改变喷水时长。停止后的迟到续租不能重启动作。
- 每次有效状态心跳签发新的 `window`；动作必须匹配当前窗口，且距签发不足 **1500 ms**。持续行走的开始请求进一步要求窗口年龄不足 600 ms。窗口只使用一次；动作序号必须严格递增，失败请求也消费序号。不缓存后补、自动重试或断线重放。STOP／BOOT 使已有窗口失效，防止滞留命令在停止后启动。
- 语音及保留的定时 HTTP 行走／转向仍为 1–3000 ms、约 60% PWM；网页长按在有效续租期间允许超过三秒持续运行，约 60% PWM 不变，连续带载／温升尚未验收。喷水 1–30000 ms。两路独立截止，行走冷却 3000 ms、喷水冷却 1000 ms；定时动作不续时，长按只延长当前同方向租期，不运行中换向；组合须全部就绪，否则整体拒绝。
- HTTP、语音、BOOT 共用同一带优先级继承的互斥锁与输出驱动。网页响应在释放锁后编码／发送，截止任务不做网络、显示、日志格式化或堆分配。HTTP 请求不进入语音应用任务队列。
- `logical_outputs`、方向、剩余时间、冷却等均为固件逻辑状态，无轮速／水流反馈。30 秒仍是软件上限，不代表完成 30 秒连续带载验收。GPIO、供电支路及高压实现边界保持原样。

## HTTP 接口

所有 API 均为 POST，`Content-Type: application/json`、`X-CyberTrack-Client: 1`；接管接口外还需要 `X-CyberTrack-Token: <token>`。只接受设备当前 STA IPv4 的 `Host: <IP>:8080`；提供 Origin 时必须精确同源。无 CORS／OPTIONS 放行，不支持通过域名或反向代理访问。

| 路径 | 请求体 | 行为 |
|---|---|---|
| `GET /` | 无 | 内嵌控制页面，不嵌入会话令牌 |
| `/api/pair` | `{}` | 无需 PIN，空闲时接管；返回 `result=ok`、128 bit 随机十六进制 `token` |
| `/api/state` | `{}` | 核验现有租约、续心跳、签发新窗口，返回状态；已超时的租约不能续活 |
| `/api/action` | 下列严格参数 | 校验当前来源、序号／窗口、类型／范围后执行；开始动作须 `result=accepted`，续租须 `renewed`，松开停止须 `ok` |
| `/api/stop` | `{}` | 全部停止并作废旧窗口，保留网页控制权；不受动作序号／窗口门槛约束 |
| `/api/release` | `{}` | 全部停止，释放控制权并撤销令牌 |

原定时动作与 `drive_start` 共有字段为 `operation`、`sequence`、`window`，其中后二者是 1–4294967295 的整数；序号由浏览器在该会话内递增，窗口来自最近一次状态响应。其他字段：

| operation | 额外必填字段 |
|---|---|
| `drive_start` | `direction`；可选 `water_duration_ms`（整数 1–30000）。没有行走时长参数；成功时 `drive_hold_id=sequence` |
| `drive_renew` | 只传 `operation`、`hold_id`、`renewal`，后二者为非零 uint32；不传 sequence/window/direction。成功必须 `result=renewed`，回执提供下一次 renewal |
| `drive_stop` | 只传 `operation`、`hold_id`；无窗口期限门槛，记录已取消的开始序号，避免松开包先于启动包到达后误启动。旧 hold 的松开包不停止较新的 hold；正常成功 `result=ok` |
| `move` | `direction`（forward/backward/left/right）、`duration_ms`（整数 1–3000） |
| `water` | `duration_ms`（整数 1–30000） |
| `move_and_water` | `direction`、`move_duration_ms`（整数 1–3000）、`water_duration_ms`（整数 1–30000） |

缺失、额外、重复字段及非整数／越界值拒绝。请求体最多 384 bytes，逐段接收，接收／发送 socket 超时为 1 秒；服务器最多两个客户端连接，配置栈 8192 bytes。超时不是端到端延迟保证，短时阻塞仍由独立租约任务兜底。

状态沿用 ct7 回执，并增加 `control_owner`（web/voice/none）、`window`、`move_cooldown_ms`、`water_cooldown_ms`、`boot_held`，ct9 另增加 `drive_hold_id`（0 表示未长按）、`drive_renewal`、`drive_lease_ms=600`。长按时 move_remaining_ms 是续租剩余，move_last_duration_ms 为初始 600 ms 租期，不表示总行走时长；语音仍按原定时语义读取自己的回执。`request_sequence` 是所有回执共享的启动期计数；页面忽略晚到的旧回执。会话令牌不出现在语音状态或动作日志中；轮询状态和持续行走续租不逐条打印日志。

HTTP 400 表示参数／请求体错误，401 表示无效或过期会话，403 表示 来源不符，409 表示接管失败，429 表示接管限流（全局最多每秒一次尝试）。通过传输验证后的动作拒绝可返回 HTTP 200，仍须检查 `result`：`stale_request`、`duplicate_request`、`not_ready_or_busy`、`drive_cancelled`、`output_fault` 等不表示执行成功。发送回执失败时尝试释放当前网页会话，无法检测的丢包由租约处理。前端发生请求异常后停止续心跳并尝试释放，不自动重试动作。

按用户的开发阶段要求，本版取消配对码：同一局域网内能访问设备的客户端均可在空闲时接管，没有身份认证。保留同源检查和内存会话令牌，用于单页面控制权、停止与续租，不作为局域网访问身份限制。采用 HTTP，无 TLS；页面令牌不写 URL、cookie 或 localStorage。

## 源码与构建

- [网页](../firmware/esp32-audio/web/index.html)：手机布局、连接、轮询、定时动作、全停、可见性／离线处理。
- [HTTP 服务](../firmware/esp32-audio/web_server.cc)、[参数校验](../firmware/esp32-audio/web_request.h)：设备页面与严格 API。
- [会话策略](../firmware/esp32-audio/control_sessions.h)：来源协调、租约、窗口、序号、失联及停止。
- [动作适配](../firmware/esp32-audio/cybertrack_tools.cc)：共用锁、截止任务、输出与状态快照；[动作策略](../firmware/esp32-audio/action_guard.h)保留原时限并分离语音票据与输出许可编号。
- [导出脚本](../firmware/esp32-audio/apply_overlay.py)：将网页生成为 Flash 常量 `web_page.h`，复制新源文件，版本 ct9；原上游 checkout 不修改。

重现步骤见[音频固件构建](../firmware/esp32-audio/README.md#重现构建)。构建目录为 `build/xiaozhi-ct9-src`／`build/firmware-ct9`，完整日志在 `build/ct9-build.log`。只有在核对实际设备、两路功率状态、分区和备份后才部署；不直接使用完整 `idf.py flash` 覆盖引导、NVS、OTA 数据或 assets。本轮已在用户确认电机 12 V／水枪 5 V 两路功率断开、USB 连接的条件下烧录和测试逻辑输出；未进行带载动作。

## 验证证据与待测

本轮软件结果：

- `sh firmware/esp32-audio/test.sh`：ASan／UBSan，通过既有状态／水枪／并发输出回归及新会话测试。新增长按覆盖 15 秒持续续租且只有一次启动、600 ms 精确截止、状态心跳不能续走、重复／迟到续租、先松开后启动的取消标记、旧松开不停止新动作、停止／BOOT／Wi-Fi／关闭／时钟回退作废长按、松开只停电机与冷却。此前覆盖离线局域网逻辑、语音关闭不打断网页、接管前票据取消且语音历史保留、不同来源输出许可不冲突、精确租约／窗口边界、序号重放、停止／BOOT 取消窗口、组合原子拒绝、Wi-Fi／关闭／时钟回退／输出故障。
- `python3 firmware/esp32-audio/tests/run_mcp_tests.py --source build/xiaozhi-ct9-src`：实际导出 MCP 参数块、实际网页 JSON 解析器、实际 HTTP 处理函数均通过 ASan／UBSan。HTTP 测试的传输／时钟／显示为桩，覆盖 Host／Origin、会话核验、无 PIN 接管及限流、独占接管、令牌更新与撤销、部分／超长／失败读取、非法 JSON 和响应发送失败释放。
- `node firmware/esp32-audio/tests/web_ui_test.mjs`：运行实际页面脚本，DOM／fetch 使用桩；覆盖启动回执前松开、续租在途时全停、触控取消、后台中断长按、旧回执不覆盖停止、断网显示未知、后台／接管竞态、会话过期及不自动重试／接管。测试需 Node.js，无额外 JS 依赖。
- 浏览器使用独立本地模拟后端：空格持续按下约 1.8 秒后松开，观察启动／续租／停止请求；鼠标持续按下约 4 秒（超过原三秒上限），同时启动十秒喷水，松开后行走为零、喷水剩余约六秒。模拟日志约 1814／4011 ms 不是实物停止时延。界面预览保存在 `build/ct9-ui/control-preview.png`，为模拟设备，不是板上运行。
- ESP-IDF v5.5.1 完整交叉编译与应用分区大小检查通过。最终镜像大小／SHA-256 与证据摘要见[软件报告](../firmware/esp32-audio/verification-ct9.json)。

尚未完成：OLED 地址可读性、真实手机 Safari／Chrome、触屏长按／滑出／多指、锁屏／后台计时行为、Wi-Fi 断开／重连与 AP 隔离、声音／唤醒／显示功能回归、网页与音频并行的内部堆余量／栈高水位／socket 峰值、真实停止时延及带载验收。无公网或 TLS 部署验收。

角色维护源已加入网页控制权规则，已按[角色同步流程](agent-role.md)保存到平台并回读一致，其他设置保持。接管期间语音动作拒绝／语音全停、释放后新动作及不补做旧请求的现场回归待反馈。

## ct9 部署与实机无负载复测

2026-10-25：已备份 ct7 应用及头部配置区，确认板卡、分区与 OTA 选择后，仅写入 `0x20000` 的应用。首次刷写后头部 128 KiB 与备份逐字节一致；首次启动后正常云端配置流程刷新了 websocket token，最终回读其余 59 个 NVS 条目、引导、分区、OTA 与 PHY 数据不变。没有擦除配置或写入 assets。修复许可编码后的有 PIN 中间镜像为 2,596,640 bytes，SHA-256 `c7743c2d85557a87f71e0207e9b4a359d4d7ca660fed02497471126f44b74133`；随后用户要求取消 PIN，最终镜像见部署记录。

首次实机动作被拒绝，定位到启用 newlib-nano 时不支持 `%032llx`，内部许可文本因此不合法。改为直接生成固定宽度十六进制编号，保留完整 64 位计数；主机与实际 HTTP 处理函数回归、重新编译和重刷后的实机复测通过。此问题说明主机通过不代表板上行为已验证。

真实设备 HTTP：持续行走日志约 4169 ms，续租只有一次启动；松开停止行走而定时喷水仍活动，全停关闭两路；不发送续租时两路在软件计时 603 ms 关闭，迟到续租拒绝。桌面浏览器连接实机后长按约四秒并松开，页面收到停止回执，串口记录约 3892 ms 逻辑活动；已释放控制权。以上是固件计时／回执，不是 GPIO 波形、机械停车时延或手机触屏证明。详细记录见 [startup-ct9.json](../firmware/esp32-audio/startup-ct9.json)。

用户随后要求取消配对码，已移除网页输入、固件校验、PIN 生成及显示并重刷。无 PIN 最终镜像 2,595,280 bytes，SHA-256 `7c1b86d99285d500ab406cfcc2cf2ceee6e84006c6186806928c15b60cf91654`；此次刷写前后头部配置区完全一致。实际设备无 PIN 一键接管／释放和完整 HTTP 长按／停止复测通过；手机与语音现场反馈仍待记录。

手机首次现场反馈为“操作、显示正常”，两路功率保持断开。串口确认四方向短动作与两次一秒喷水已接受并停止；方向活动仅 82–156 ms，不能作为四秒长按或后台停止通过。语音状态查询成功，首次语音行走发生在网页仍接管时，未启动；释放后语音行走、实际音频回复和手机长按需继续核对。
