miclle/cybertrack/docs/motor-bench.md

# 电机台架准备与历史记录

核对日期：2026-10-27。独立 L298N 台架的静态检查、单／双路空载运行和 BOOT 提前停止已完成相应分项，后续已迁至现有面包板并进入装车联调。当前源码与最新有记录的部署为 `2.0.3-ct21`；本页保留旧台架的接线、版本和原始观察，不把旧电源或空载结果转为整机验收。

## 当前进展与适用接线

| 阶段 | 已完成记录 | 适用范围 |
|---|---|---|
| 独立 L298N 台架（2026-10-25） | 0.3.1 的8组空载方向／单路隔离、双路 BOOT 提前停止及松开不恢复；0.3.2 的一次双路约60%／10秒正转，母线约12 V、无明显发热 | 独立 N16R8 板，A=GPIO4／5／6、B=GPIO7／8／9；普通万用表及用户观察，未测电流或定量温升 |
| ct6 面包板集成 | 电机六线迁至 GPIO8–13；四方向空载、GPIO18 水枪及 BOOT 分项完成 | 当时约60% PWM、互斥策略和供电条件，见[集成记录](breadboard-integration.md) |
| ct7 行走／喷水并发 | 组合与分开下令、两种独立截止顺序、BOOT 全停及语音停止已有台架记录 | 不等于当前四路组合负载或完整故障验收，见[并发记录](concurrent-actions.md) |
| ct21 装车联调 | 沿用 ct20 的204/255（约80%）PWM，修正 A／右、B／左；用户确认前进、后退、左转、右转正常 | [软件报告](../firmware/esp32-audio/verification-ct21.json)与[部署／现场反馈](../firmware/esp32-audio/startup-ct21.json)分开记录；桥身份未独立逐线核对，停止距离与定量负载未验 |
| 样机展示 | 已有打印、基础装配、落地移动与转向[影像](../artifact/README.md) | 影像未绑定完整固件／供电配置，不作为全部工况通过 |

当前面包板 A 路为 **GPIO8／9／10→ENA／IN1／IN2**，B 路为 **GPIO11／12／13→ENB／IN3／IN4**，1 kHz、8位 PWM。原独立台架 GPIO4–9 不能套用到面包板，GPIO4／5／6 已用于麦克风、GPIO7 用于音频输出。当前接线与跳帽边界见[接线总表](wiring.md)，旧程序的串口 a／f／r、10秒期限及人工使能流程不代表面包板控制接口。

当前主电源为辰克5 V电池包，MT3608→12 V→L298N 支路保留；旧 A110M 的端口能力、约12 V观察及主观温升不迁移到新电池。[A1 原理图](../hardware/schematic/README.md)已选 R1–R6 为10 kΩ、±1%、至少0.1 W的设计值；SW2 已确认只切执行器、主控继续运行，但电阻实际安装、器件额定、默认关闭及真实切断仍未验收。BOOT 软件停止不代替独立供能切断。

## 当前未完成项

- 辰克电池输出／保护、MT3608 负载能力、输入与电机端电压电流、启动瞬态、回灌、定量温升及热稳态；12 V母线不代表电机端始终为12 V。
- 当前约80% PWM的持续／重复带载、实际速度、转向负载、定量停止延迟与滑行距离；既有四方向反馈只关闭基本方向分项。
- 上电、复位、下载、主控失电／欠压、恢复供能及故障状态下的真实输出；SW2 独立切断、外接 BOOT 实物接线和恢复行为。独立串口台架的 s 带载提前停止仍无完整验证，不能用面包板语音停止替代。
- 编码器针序／电平／计数、联轴器锁紧、履带张力与磨损、线束检修及完整安装验证；真实断网停止／重连不恢复仍延期。

Q05、V02–V04 及整机验收保持开放，见[验证计划](verification-plan.md)。本次仅同步文档，未重新接线、烧录或触发动作。

## 独立 L298N 台架历史（2026-10-25）

以下“当前”“本次”“尚未执行”及 USB／功率通断状态均指对应记录时刻；后续完成结果见本页当前汇总与各阶段收尾，不表示设备此刻状态。原始时间、占空比和观测数值保持，未通过项目不回填为通过。

2026-10-25 双路 10 秒命令已执行一次：用户确认上电、万用表准备好后，选 AB、使能并仅发一次 f（约 60% PWM）。主机命令到关闭日志约 10.09 秒，收到两路关闭回执，随后追加 s 再确认关闭；未见 BOOT、错误或重启记录。用户已确认双路 60%／10 秒空载正转正常启停，启动、运行中及临近停止母线均约 12 V，电机和 L298N 无明显发热、无异响或其他异常；这是万用表读数与主观发热观察，电流和定量温升仍未测。用户已断开 12 V、USB 保持连接，本次短时空载功能检查通过。见[运行及用户反馈记录](../firmware/esp32-motor-bench/dual-10s-run-verification.json)。下方准备记录保留当时状态。

2026-10-25 双路 10 秒观察版准备完成：用户确认 12 V 断开、USB 保持连接；0.3.2 已通过主机 ASan／UBSan 回归与 ESP-IDF 编译，备份原应用后仅写入新应用，哈希校验通过。启动确认 60%／10000 ms，只发送 s 并收到 `DISARMED outputs=OFF target=NONE`，观察 5 秒无异常，串口保持连接。未发送选择、使能或动作命令，当时双路10秒电压／发热观察尚未执行；后续已完成一次空载观察，见上方运行记录。见[启动检查](../firmware/esp32-motor-bench/startup-verification-dual-10s.json)。

2026-10-25 双路 BOOT 检查：用户确认上电准备好后，只发送一次 a／f 请求 AB 正转（约 60%、最长 3 秒）。约 0.65 秒后收到 `DISARMED outputs=OFF target=AB BOOT held`，早于自动截止；松开回执仍关闭，之后超过 5 秒未重新使能，最后追加 s 并确认关闭。以上时间来自主机日志，不是物理停止时延；用户已确认两台在按 BOOT 后提前停止，松开后持续不转，无异常；12 V 已断开，USB 保持连接。本次双路空载 BOOT 提前停止／松开不恢复子项通过。见[本次 BOOT 记录](../firmware/esp32-motor-bench/dual-boot-stop-verification.json)。

2026-10-25 已按用户授权发送一套 8 组组合命令（60% PWM、每组 3 秒），每组均收到关闭回执，最后另发 s 并确认两路关闭，期间未见 BOOT、错误或重启记录。串口观察的命令至关闭日志间隔约 3.01–3.04 秒，组间停顿超过 3 秒；不是物理停止时延测量。用户随后确认 12 V 已断开、USB 保持连接，8 组均正常：单路测试时另一台不转，各组转向符合预期，两台正常停止，无异响或异常发热。本次 60%／3 秒空载组合检查通过；当时双路运行电压、电流、定量温升未测；后续 10 秒电压观察见页首记录；随后完成的 BOOT 提前停止见页首记录；见[组合命令与回执记录](../firmware/esp32-motor-bench/combinations-verification.json)。下方烧录准备段落保留当时状态。

2026-10-25 组合版本烧录检查：用户确认 12 V 断开、两台固定空载、USB 保持连接后，备份原应用并仅写入 0.3.1，哈希校验通过。串口确认 60%／3000 ms，只发送 s 并收到 `DISARMED outputs=OFF target=NONE`，继续观察 5 秒无使能或错误回执，串口保持连接。未发送选择、使能或动作命令；当时尚未执行组合动作，见[本次启动记录](../firmware/esp32-motor-bench/startup-verification-combo.json)。

2026-10-25 双路烧录检查：用户确认 B 路接线完成、旧 ENB 接地线移除、仅 COM USB 接通且 12 V 断开。仅应用烧录及哈希校验通过，启动为 0.3.0／60%／200 ms，唯一发送 s，收到 `DISARMED outputs=OFF target=NONE`；串口保持连接，未发送选择／使能／方向命令。随后用户已确认六脚上电前后均近 0 V、两台保持不转；当时尚未进行 A／B 隔离和双路动作检查，见[启动记录](../firmware/esp32-motor-bench/startup-verification-dual.json)。六脚静态供电检查见[接线记录](../firmware/esp32-motor-bench/dual-wiring-verification.json)，组合动作及后续用户反馈见页首记录。

## 独立双路台架历史：0.3.2（2026-10-25）

用户要求进入双电机测试，并确认两台同规格 12 V、100 rpm 的 37R-520 均已固定、输出轴空载、不装履带，12 V 已断开。[独立台架接线与流程](../firmware/esp32-motor-bench/README.md)：A=GPIO4／5／6→ENA／IN1／IN2，新增 B=GPIO7／8／9→ENB／IN3／IN4；第二台接 OUT3／OUT4，先全断电移除旧 ENB 接地线，两使能跳帽仍取下，独立稳压跳帽保留，+5V 不接 ESP32。GPIO8 是 J1-12、GPIO9 是 J1-15，按 GPIO 丝印定位。

0.3.2 启动 target=NONE，单独 1／2／3 选 A／B／AB，确认回执后另发 a，再在 3 秒内单独 f／r；AB 另支持 x=A 正 B 反、y=A 反 B 正。按用户组合观察需求，保持约 60% PWM，单次 10 秒、组间至少停 3 秒且轴完全停稳。该阶段原计划仅做一次 AB 双路正转10秒电压与发热观察，后续已完成并取得用户反馈，不沿用此前 8 组测试顺序，不循环或重试；固件自身不自动连跑。BOOT、提前停止、错误、重启或回执缺失中止剩余组。s／BOOT 和任一路故障关闭两路，运行中不能换通道或换向；电气方向不保证对应车体方向。

主机策略、实际六 GPIO／双 PWM 回归及交叉编译已通过，见[软件验证](../firmware/esp32-motor-bench/verification-dual-10s.json)。接线、烧录、B 路及双路物理检查分别记录；此前单路的方向、停止和母线观察不转移为双路通过证据。现有供电预算不支持直接宣称双电机额定负载通过，该阶段仅覆盖空载。六脚静态供电检查见[接线记录](../firmware/esp32-motor-bench/dual-wiring-verification.json)，组合动作及后续用户反馈见页首记录。

## 以下为单路 L298N 历史记录

以下 0.2.x 的三根控制线、ENB 接地及 10 秒时长只描述当时单路测试，不是后续独立双路或当前面包板接线。

## L298N 选型与单路台架历史（2026-10-25）

L298N 仍为当前选型；以下0.2.x接线与观察属于单路历史，不恢复旧 ENB 接地或套用到面包板。原27.5 mm裸板尺寸记录保留；后续安装采用[0.57 的28.5 mm插线包络与底盖支架](../hardware/model/l298n-compact/README.md)，不等于散热或装配验收通过。

用户指定以[何健弓 L298N 电机驱动板模块](../hardware/components/L298N/README.md)替换 DF-MD V1.3，关联 H03／P13。用户已提供实物照片，报告完成供电／静态控制电压检查及一次空载 200 ms 转动后停止；用户另提供长 46.2 × 宽 43.5 × 高 27.5 mm，数量、尺寸包含范围／孔位、额定电流及散热能力仍待核实。旧板故障与点动结果不转移到新板。

[L298N 台架程序与完整接线说明](../firmware/esp32-motor-bench/README.md)当时版本为 **0.2.2-l298n-bench**：原 ESP32-S3 N16R8 台架板 GPIO4→ENA、GPIO5→IN1、GPIO6→IN2；ENB 接 GND，IN3／IN4 本轮留空且 B 路不接电机，两路常高使能跳帽取下；独立板载稳压跳帽保留，+5V 不连接 ESP32。

程序每次先 `a`，3 秒内单独 `f`／`r` 请求一次 1 kHz、约 60% PWM、**10 秒**动作，之后冷却 1 秒且须等轴完全停稳；BOOT／s 停止、松开不恢复，先撤销 ENA 再改变双方向输入。10 秒来自用户在 200 ms 首测后的观察需求，不是新板持续负载能力验收。以上引脚仅为此独立台架分配，不冻结整机 GPIO，也不适用于现有面包板。

2026-10-25 用户报告：驱动独立及恢复控制线后的 +12V 约 12 V、+5V 约 5 V；ENA／IN1／IN2／ENB 均接近 0 V。0.2.0 发送一次 a／f 后收到自动关闭回执，用户确认电机短暂转动后停下、无异响或其他异常，并断开 12 V，见[首测记录](../firmware/esp32-motor-bench/first-pulse-verification.json)。随后按用户要求将期限改为 10 秒，0.2.1 主机 ASan／UBSan 策略、实际任务模拟 I/O、早期／第 9 秒停止及五处 API 故障回归和 ESP-IDF v5.5.1 编译通过，见[软件验证](../firmware/esp32-motor-bench/verification-10s.json)。0.2.1 已在驱动断电时完成[应用烧录及启动／s 关闭检查](../firmware/esp32-motor-bench/startup-verification-10s.json)，串口保持连接。随后用户已确认两次 40%／10 秒反转正常停止，首次方向与正转相反、无异响／异常发热／重启；第二次启动和运行母线基本保持 12 V，见[40% 反转记录](../firmware/esp32-motor-bench/reverse-40pct-verification.json)。按请求升级 0.2.2 至约 60% PWM，主机回归／编译以及[驱动断电下的烧录／启动／s 关闭检查](../firmware/esp32-motor-bench/startup-verification-60pct.json)均通过；随后完成一次 60%／10 秒反转，用户确认启动及运行母线约 12 V、较 40% 更快更顺畅并正常停止，无异响、异常发热或重启，且已断开 12 V，见[60% 记录](../firmware/esp32-motor-bench/reverse-60pct-verification.json)。带载 BOOT、电流／温升、扭矩和复位默认关闭未验收。

进入通电前需核实所选 L298N 的电源入口、5 V 端方向、稳压跳帽在 12 V 下的允许状态、使能信号针及 3.3 V 兼容，落实可独立切断供能。缺少外部下拉时只按主控先启动／驱动最后上电、驱动最先断电的台架顺序执行；不做驱动带电的复位／拔 USB 验收。本段是历史单路条件；独立双路工程入口见其 README，当前面包板以文首接线表和固件记录为准。

Q05、V02–V04 继续跟踪新板实物；当时沿用37R-520、充电宝＋MT3608的12 V母线及先单电机空载顺序；当前已换辰克电池并完成基本装车运行，完整负载与供电仍待验。旧方案如下，仅作历史记录。

## DF-MD 历史记录（已退出当前方案）

以下仅保存 2026-10-24 的旧板准备、接线及试验过程，所有“本轮／当前／后续”均指当时的旧 DF-MD 测试，不是新 L298N 或当前面包板的操作步骤。后续“首轮范围”至“结果记录”均属此旧板历史，DF-MD 保持断电、断线；未执行的按钮方案不因留档恢复为现行计划。完整点动、未转动及稳压异常反馈见[历史台架工程](../firmware/esp32-motor-bench/df-md-history.md)。

历史起始记录：2026-10-24。用户确认 DF-MD V1.3 和 37R-520 已到货，并选择充电宝＋MT3608 作为首轮测试电源。到货数量、标签、针序及电气状态尚未核验。用户随后确认有万用表、已将 MT3608 输出调至 12 V，且电机已测试能够转动；测试接法、负载、电流和持续时间未提供。当时尚未烧录电机程序；后续已烧录并点动，用户报告未转动及稳压通路异常，完整过程见[旧台架记录](../firmware/esp32-motor-bench/df-md-history.md)。

## 历史执行方案：DF-MD GPIO 单次点动

用户随后说明没有按钮和 10 kΩ 电阻，明确要求直接使用 ESP32-S3 GPIO 测试。已新增[独立台架程序、接线及烧录步骤](../firmware/esp32-motor-bench/df-md-history.md)：GPIO4 → E1，GPIO5 → M1；另一通道 E2／M2 接地。串口人工 a 后 f／r 触发一次约 40%、10000 ms 脉冲（0.1.2；按用户要求从 200 ms、1 秒逐次延长，用于万用表读数），BOOT／s 撤销使能。没有外部下拉时严格要求主控先启动、驱动电源后接通，驱动电源先断开；启动前／复位／失电电平未获保证。下方按钮方案保留为未执行的历史方案，本轮不采用。0.1.1 已烧录并执行 1 秒点动，用户报告 E1 短暂约 1.3 V、电机两端仍为 0 V且未转动；0.1.2 已在驱动断电下烧录，串口确认 10000 ms 配置和关闭状态，尚未执行 10 秒动作，实物驱动测试尚未通过。

## 首轮范围

**DF-MD 历史记录（已停用）。** 以下条件、计划和结果仅用于追溯旧板，不是当前测试步骤。

只接一台固定牢靠、输出轴无负载的电机，先测一路，再换另一台／另一路；暂不安装履带，不连接编码器及其他执行器。先验证默认关闭、短时单向转动、限时停止和本地断电，再验证停稳后的反转。双电机与整机带载另行验证。

现有 [ESP32 工程](../firmware/esp32/README.md)为 `0.2.0-boot-stop-check`，没有执行器 GPIO／PWM 或本地使能入口；本轮另建独立 GPIO 台架工程。BOOT 无负载停止通过不代表电机可直接接上运行；RST 和 BOOT 都不能替代独立切断电机供能。

## 接线前需要的实物信息

**DF-MD 历史记录（已停用）。** 以下条件、计划和结果仅用于追溯旧板，不是当前测试步骤。

| 项目 | 当前证据 | 下一步 |
|---|---|---|
| 驱动板 | 用户报告 DF-MD V1.3 到货；归档原理图标题为 V1.4 | 按用户要求先依据官方文档核对 VD／VS／GND 与跳线；丝印或布局不符时暂停对应接线，不以照片作为统一前置条件 |
| 电机 | 用户报告 37R-520 到货；资料为 12 V／100 rpm／60∶1 | 核对铭牌与六针插头朝向；确认两根动力线，不能按冲突资料猜线色 |
| 升压与供电 | 用户选定充电宝＋MT3608 | 用户确认有万用表且输出已调至 12 V；核对取电端口，独立断电手段仍需落实 |
| 主控 | 已完成启动、PSRAM、BOOT 无负载输入测试 | 沿用已验证 COM USB 供电／日志通路；电机信号 GPIO 待上述接口核实后分配 |

编码器资料的两套六针定义冲突见[电机记录](../hardware/components/37R-520/README.md)。仅确认动力线后才接 H 桥输出；未使用的编码器导线分别绝缘悬空，暂不供电、不接 GPIO。电机动力线中的任何一根都不能永久接 GND。

## 供电和控制连接边界

**DF-MD 历史记录（已停用）。** 以下条件、计划和结果仅用于追溯旧板，不是当前测试步骤。

以下只规定连接关系，不能替代按到货版型核对后的端子接线图：

- 充电宝选定端口 → MT3608 的已核实输入；MT3608 输出 → 保护及可独立操作的电机支路断电开关 → 驱动板电机电源端。
- 驱动板逻辑供电入口及跳线单独核对。[DFRobot 官方资料](https://wiki.dfrobot.com/dri0002)列 VD 为逻辑电源输入、VS 为电机电源，短接跳线会共用电源；页面对短接条件写“小于 12 V”，不能据此替到货板决定 12 V 时的跳线状态。VD 也不是 ESP32 的 3V3 输出接口。
- 主控先由电脑 COM USB 单独供电。主控 GND 与驱动控制地／电源公共地连接；电机大电流回路不经过 ESP32 排针、USB 线或面包板。连接前确认各电源地之间无异常电位差。
- 只连接已核实的控制信号和公共地；不把驱动板电源输出、MT3608 的 12 V 或未知高电平接入 ESP32 的 3V3、5Vin 或 GPIO。主控与驱动电源正极不并接。
- 官方接口 E1／E2 为 PWM 使能、M1／M2 为方向，E 为低时停止。到货板核对后落实两路使能在 MCU 未上电、复位和下载期间的硬件下拉／禁用措施，测量默认电平和反灌；不能只依赖软件初始化或内部下拉。
- [L298 官方数据手册](https://www.st.com/resource/en/datasheet/l298.pdf)的 TTL 输入说明只证明芯片接口特性，不能替代板上全部输入电路的 3.3 V 兼容核对。使能低停止不保证输出轴瞬时停住。

电源预算沿用[电源与接口](power-and-interfaces.md)：双电机商家额定点为 13.2 W，尚未计驱动与升压损耗；A110M 多端合计 15 W 和 MT3608 的“2A”均不能作为双电机供电已通过的证据。本轮单电机空载是缩小测试范围，不是已证明供电能力足够。

## 历史候选：按钮手动单通道测试（本轮不采用）

用户明确要求按文档继续。以下使用 [DFRobot 官方接口说明](https://wiki.dfrobot.com/dri0002)（2026-10-24 再次查阅），以实物可辨认的 VD／VS／GND、E1／M1、E2／M2 丝印为定位依据，不凭照片左右位置接线。文档控制高电平下限为 2.3 V，支持用 3.3 V 做手动输入测试；这不声明实物已经测通。

这是独立的手动直流逻辑测试，不运行项目动作程序，不分配 GPIO。ESP32 只通过 COM USB 供电并提供 3V3 和信号公共地。动作来自人工按下测试按钮；没有软件超时，不能作为固件停止验收。后续 PWM 测试仍按下一节实施。

全部断电后接线：

| 来源／端点 | 接到 |
|---|---|
| MT3608 OUT+（实测 12 V，不超过 12 V） | 经可直接断开的供电连接，分两支接 DF-MD 的 VS 和 VD |
| MT3608 OUT− | DF-MD 电源 GND |
| ESP32 GND | DF-MD GND；动力电流由前一条电源回线承担 |
| 已试转的电机两根动力线 | DF-MD 第一通道的两个电机输出螺丝端子 |
| DF-MD 控制排针 M1 | GND（首轮方向） |
| DF-MD E1 | 经 10 kΩ 电阻接 GND，保持默认低；另经常开瞬时测试按钮接 ESP32 的 3V3 |
| DF-MD E2、控制排针 M2 | GND；第二路电机输出不接 |

取下连接 VD／VS 的供电选择跳帽，采用上表分别供电接法；两根正线必须来自同一 MT3608 输出，不能各接独立电源。VD 是板上逻辑稳压器的输入，不是 3.3 V 控制信号。控制排针 M1 和电机输出端子不是同一接口。

1. 电机先不接，按钮保持松开。先上驱动电源，再接 ESP32 COM USB；万用表直流电压档检查 VD／VS 对 GND 约 12 V、E1 对 GND 约 0 V。按住测试按钮时 E1 约 3.3 V，松开回到约 0 V。未达到时不进入转动测试。
2. 全部断电后接单电机，固定机身、输出轴无负载。保持按钮松开，按同一顺序上电，电机应不转。若自行转动，立即断开驱动电源，核对通道和使能接线。
3. 人工短按测试按钮，首次约 0.5 秒即松开：按下时转动、松开时撤销驱动，轴可能继续滑行。此时是使能全开的短时测试，不是低占空比 PWM。无法可靠松开／断电时不做此步骤；不要用裸线反复碰接代替按钮和下拉。
4. 完全停稳并全部断电后，将控制排针 M1 从 GND 改接 ESP32 3V3，重复短按，电机应反转。每次重接前全断电；不要在转动中切换方向。
5. 结束时先松开按钮，再断驱动电源，最后断 USB。下一轮可以同样方式单独测 E2／M2 对应通道，原通道使能保持接地。

接线中不使用 ESP32 的 5Vin，12 V 不进入主控。编码器暂不接。若没有测试按钮或 10 kΩ 下拉，先完成电源端核对，保留 E1／E2 直接接地；不把使能悬空当作关闭。异常声响、无转动、升压保护重启或异常发热立即断电；不延长点动来尝试克服故障。

## 后续 GPIO／PWM 测试顺序和进入条件

**DF-MD 历史记录（已停用）。** 以下条件、计划和结果仅用于追溯旧板，不是当前测试步骤。

1. **全部断电核对**：拍照并标记实物版本、跳线、线序和极性；固定电机，移除输出轴上的松散附件。先确定额定匹配的线束、保护及可触及的电机断电开关。未确认动力线时不做试接。
2. **仅测升压板**：ESP32、驱动板和电机均与升压输出断开。核对输入极性，用万用表直流电压档测 MT3608 输出并调到 12.0 V；不假设电位器旋转方向，不按圈数估计电压。断电、重新上电后复测。空载稳定只关闭空载检查项，不代表能带电机。
3. **无电机验证控制链**：完成驱动版型、电源入口与跳线核对后，再接驱动逻辑和主控信号，保持电机输出端空置。测试程序必须上电不转、人工本地使能、一次有限时动作、停止锁定；不能循环自动正反转。测两路使能在上电、主控失电、复位、下载和停止时均保持禁止，并检查控制端无异常回灌。
4. **接单电机短时点动**：第 3 步通过后全断电接线；确认独立切断可用，再人工使能并请求一次低占空比短脉冲。首轮候选上限为 200 ms，具体 PWM 频率／占空比由实物与程序共同确定；这是测试参数，不是电机额定性能。无转动、异响、掉压或保护重启立即停机，不持续加占空比或反复堵转尝试。
5. **记录并逐项扩大**：记录电源输入、升压输出、驱动与电机端电压、电流及温升；测试超时／停止／复位不恢复动作。停稳后再改变方向。先分别测两台电机和两路驱动，随后再决定是否进入双电机测试。禁止运行中直接换向、为补偿驱动压降提高 12 V 母线或长期堵转。

万用表用于静态电压和极性检查，不能证明启动瞬态／PWM 波形通过。电流测量需正确串联和选择量程；电流档不得直接跨接电源。若缺少波形或电流测量设备，相应项目保持未测。出现供电重启或异常发热即中止本轮并查因，不借重新上电自动恢复动作。

## 结果记录

**DF-MD 历史记录（已停用）。** 以下条件、计划和结果仅用于追溯旧板，不是当前测试步骤。

| 项目 | 记录内容 | 当前结果 |
|---|---|---|
| 到货 | 型号、数量、标签和照片 | 用户确认两类器件到货；其余待补 |
| 电源 | 端口／取电方式、输入与输出电压、空载重启、负载及仪器 | 用户报告万用表已调到 12 V；负载压降、重启及瞬态未测 |
| 接线 | 实物版本、跳线、动力线、信号 GPIO、使能下拉和断电开关 | 未核实 |
| 默认关闭 | 上电、复位、下载、主控失电和供电恢复时的实体输出 | 用户报告接线后 E1／E2 对地均为 0 V；启动／复位等动态工况未测 |
| 单电机 | 通道、转向、PWM、时限、电压／电流／温度 | 用户此前报告电机单独测试可转；本次 DF-MD 一次 40%／200 ms 命令后用户报告未转，手转时驱动指示灯亮；原因待排查，电流／温升未测 |
| 停止 | 软件关断、独立切断、滑行、松开／复位不恢复动作 | 未测 |
| 编码器 | 针序、电源、输出电平和手转计数 | 本轮不接；未测 |

测试时追加日期、固件版本／哈希、仪器、环境和原始日志位置。仅在真实执行后更新通过状态；对应 Q05、V02、V03、V04，当前均不因到货而关闭。

用户随后授权一次串口点动；旧串口进程已结束，重连后出现启动日志，本次在使能前中止，未发送动作。须先断开驱动 12 V 再恢复稳定连接，详见[中止记录](../firmware/esp32-motor-bench/df-md-history.md)。

## 2026-10-25 后续：面包板集成

用户确认上述独立双电机＋L298N 测试已完成，选择迁至灵矽面包板，与 GPIO18 水枪集成。新 ct6 分配 A=8/9/10、B=11/12/13，与本页原台架 4/5/6、7/8/9 不同；原台架程序及记录保留。新接线、固件／平台部署和物理检查以[集成记录](breadboard-integration.md)为准，迁线及本轮基本台架功能检查已完成，后续 ct7 已完成并发台架，ct21 用户已确认装车四方向正常；持续带载、停止距离与定量电气验收仍未完成。
