miclle/cybertrack/docs/breadboard-integration.md

# 面包板集成：当前状态与 ct6 台架历史

核对日期：2026-10-27。当前源码与最新有记录的部署为 **`2.0.3-ct21`**，已完成基本打印、装配并进入样机联调。ct6 的迁线及单项台架、ct7 的行走／喷水并发台架均已有记录；当前八个 MCP 工具、四路控制、网页长按及狂暴模式见[固件接口](../firmware/CAPABILITIES.md#当前面包板-ct21-接口)。

| 集成进展 | 已有证据 | 证据边界 |
|---|---|---|
| ct6 同板集成 | 电机六根控制线迁至面包板 GPIO8–13，与 GPIO18 水枪共用设备；四方向空载、喷水及 BOOT 停止分项完成 | 历史约 60% PWM、互斥策略和当时供电条件，不作为当前四路负载验收 |
| ct7 并发台架 | 组合与分开下令、两种独立截止顺序、BOOT 全停及语音停止，见[并发记录](concurrent-actions.md) | 跨动作互斥要求已被替代；同路拒绝现场回归、定量电气和完整故障验收仍开放 |
| ct21 装车方向 | 输出层改为 A／右、B／左，保留每路前后极性和 ct20 的约 80% PWM；仅应用部署、配置保持，用户随后确认前后左右均正常 | 部署检查未启动执行器；桥身份未独立逐线核对，反馈不等于停止距离、电流或温升验收 |
| 当前样机 | [制作与运行影像](../artifact/README.md)已展示装配、落地行走／转向、泡泡及喷水台架 | 视频未绑定完整版本／电源配置，不能据此确认完整整机验收 |

ct21 的[软件检查](../firmware/esp32-audio/verification-ct21.json)与[部署／现场反馈](../firmware/esp32-audio/startup-ct21.json)分别保存。当前 GPIO 和供电以[接线表](wiring.md)、[电源方案](power-and-interfaces.md)为准；辰克 5 V 电池包替代旧充电宝，12 V 升压电机支路保留，旧电源结果不沿用。行走／喷水／泡泡间隔现为 200 ms，点火等本次实际软件 ON 时长；旧文中的三秒／一秒冷却属于 ct6／ct7 阶段，跨动作互斥只适用于 ct6。

## 当前仍待验收

- **网络与语音**：真实断网停止、重连不恢复仍按用户要求延期；现行同路忙碌／冷却拒绝、时长边界、重复／过期请求、排队撤销及最新角色别名／静默规则的完整现场回归仍待完成。ct7 已有语音停止分项，不等于所有通道或场景通过。
- **停止与故障**：定量停止延迟／滑行距离、功率接通时主控复位、失电、欠压、看门狗和独立供能切断。既有 BOOT 和语音结果不覆盖完整故障矩阵，万用表不能排除短脉冲。
- **装车与负载**：四方向基本功能已获用户确认，落地运行已有影像；实际速度、持续／重复负载、停止距离及当前四路组合负载仍需验证，桥身份和完整布线仍需逐线核对。
- **供电与环境**：辰克电池及当前接线的电压、电流、启动瞬态、回灌、定量温升、液体共存与 EMC；完整三十秒连续喷水、泡泡负载及点火开关适配仍未验收。短时无异常不等于整机电气或儿童使用验收，边界见[效果控制](effects-control.md)及[整体验证计划](verification-plan.md)。

本次只同步文档，未重新构建、烧录、接线或触发动作。

## ct6 历史集成范围

以下为 2026-10-25 的 ct6 计划、台架汇总与现场流水，保留当时参数和观察。“当前”“下一项”“尚未完成”均指对应记录时刻；后续完成项以文首和该阶段收尾为准，未通过／缺失回执的尝试不回填为通过。历史 USB／功率状态不代表设备现在的供电状态。

日期：2026-10-25。用户确认两台电机＋L298N 独立测试已完成，选择把六根控制线迁至现有 `bread-compact-wifi` 面包板，与 GPIO18 水枪共用灵矽 CyberTrack 设备；后续统一称“面包板”。软件目录 `firmware/esp32-audio/`、协议字段 `cybertrack_audio_board` 保持兼容，不代表另一块设备。

历史 `2.0.3-ct6` 的部署、迁线及该阶段基本台架联调已完成：语音控制双电机四方向、水枪定时启停与 BOOT 提前停止均有本次记录；两路功率同时接通、分别动作时未观察到另一机构误动。收尾状态全部关闭、启动计数 5；用户已断开 L298N 12 V 与 MOS 5 V，USB 保持连接。断网测试延期，整机带载与完整电气验收仍未完成。

## ct6 历史结果汇总（2026-10-25 收尾）

证据分为用户现场电压／运动／喷水观察、设备回执及平台工具记录；设备没有编码器或出水反馈，软件关闭不等于测得机械停止延迟。详细数据见[部署与实测记录](../firmware/esp32-audio/startup-ct6.json)，下文保留完整过程及不一致记录。

| 检查 | ct6 历史结果与范围 |
|---|---|
| 部署及平台 | ct6 应用刷写校验、配置保留、角色回读一致；声音与 OLED 正常 |
| 功率断开信号 | 七路待机近零；ENA／ENB 约 1.95 V，方向高电平约 3.25 V，MOS 高电平 3.18 V；定时归零及 IN1／IN3 转向组合符合预期，非 PWM 波形验收 |
| 停止与否定 | MOS／ENA／ENB 控制信号 BOOT 提前归零、释放不恢复；MOS 语音停止回执提前关闭；本句否定指令未触发动作 |
| 互斥 | 喷水中行走请求到达设备后工具失败，启动计数不增、ENA 为低、未补做；平台未显示具体 busy 码。反向互斥未实测 |
| 电机带电 | 固定空载前进／后退／左转／右转短时启停；A／B 相对前进方向符合组合。双路带电 BOOT 最终补测记录 reason=BOOT、动作持续 460 ms，用户确认两台停转且未恢复 |
| 水枪带电 | 一秒实喷自动停止；实喷 BOOT 提前停止回执持续 670 ms，用户确认停止且未恢复 |
| 两路供电、分别动作 | 电机动作时水枪不喷，喷水时两电机不转，声音／屏幕正常；仅本轮短时功能观察，不是电源预算、热或同时动作验收 |
| 上电与收尾 | 功率断开时 MOS 上电观察保持低；14:45:51 状态 ok／DISARMED／fault=none，left=0、right=0、water=false、remaining_ms=0、starts=5。用户确认两路功率均已断开，USB 保留 |

电机 BOOT 曾有一次 deadline 回执、一次观察器断开缺失回执；保留为未通过／无法核实的尝试，最后独立补测才完成原因核对。流水记录中的历史“待执行”描述以本汇总及后续证据为准。

ct6 收尾时未完成的反向互斥已被 ct7 并发要求取代，不再作为当前待测要求；ct7 后续已有带载语音停止分项，ct21 后续已有装车四方向反馈。定量停止、供电、故障及环境缺口继续保留在文首，不能因后续功能演进自动视为通过。

## 证据与实施边界

本节为 ct6 历史范围；下列“首版”和未开放能力不描述 ct21。

- 独立电机台架：用户已确认 8 组空载组合方向／隔离／正常停止、双路 BOOT 提前停止与松开不恢复，以及双路约 60%／10 秒空载启停和母线约 12 V；无明显发热／异响。电流和定量温升未测，见[原记录](motor-bench.md)。
- 水枪：ct4 有五秒喷水、到期停止和 BOOT 提前停止现场结果；ct5 有功率断开的可变时长语音检查；30 秒带载未验收，见[原记录](audio-water-validation.md)。
- 本次把已知功能整合到同一控制器，不把上述结果转移成新接线或整机行走通过。首版行走单次 1–3000 ms、固定约 60% PWM，喷水维持 1–30000 ms；两类动作互斥。没有组合负载、避障、距离／角度闭环、泡泡或高压控制。

## 后续供电变更（2026-10-25，待改线验证）

**历史方案记录。** 旧充电宝选择已被辰克 5 V 电池包替代，主控与升压支路同源供电的完整验证仍未完成。以下保留当时改线意图，不将其记为当前配置已实测通过。

用户选择充电宝同一 5 V 输出并联供主控 `5Vin/GND` 和 MT3608 输入，主控日常不插 Type-C。针位、分支图、独立功率断电、USB 供电切换及验证顺序统一见[电源方案](power-and-interfaces.md#面包板与电机共用充电宝2026-10-25)。以下历史记录中的电脑 USB 供电状态不改写；新方案尚未实测，原短时联调不能替代同源供电验收。

## 面包板接线候选

**ct6 历史迁线方案。** 后续迁线与基本信号检查已完成；下文 A／左、B／右只属当时假设，ct21 已改为 A／右、B／左。当前四路引脚与完整待核项见[接线表](wiring.md)，本节不作为再次迁线指令。

先断开 L298N 12 V 和 MOS 5 V，再断开主控供电后迁线；不带电插拔。原台架控制器的六根控制线全部移除，不把两块 ESP32 输出并联。

| 面包板 GPIO／端点 | 连接 | 说明 |
|---|---|---|
| IO8 | L298N ENA | A 路使能 PWM |
| IO9 | L298N IN1 | A 路方向 1 |
| IO10 | L298N IN2 | A 路方向 2 |
| IO11 | L298N ENB | B 路使能 PWM |
| IO12 | L298N IN3 | B 路方向 1 |
| IO13 | L298N IN4 | B 路方向 2 |
| GND | L298N GND | 逻辑共地，电机回流走原功率线 |
| IO18 | MOS TRIG/PWM | 保留原水枪控制线 |
| GND | MOS 控制 GND | 保留原控制地，不接输出侧负极 |

GPIO8–13 在已固定的板级源码中未被麦克风、扬声器、OLED、按键或 LED 使用，仍须确认实物排针空闲与丝印。GPIO4/5/6 是麦克风，GPIO7/15/16 是扬声器；不可沿用独立台架的 4/5/6 与 7/8/9 分配。

L298N ENA／ENB 常高使能跳帽均保持取下，沿用已测试的独立稳压跳帽状态；L298N +5V 不接面包板 5V／3V3。电机维持原 12 V 支路；水枪维持 5 V→MOS→3.7 V 降压→水枪。MOS 输出侧负极不额外接输入负极／面包板 GND，避免绕过低侧开关。不得将 12 V 或 3.7 V 接到 GPIO。

A 接 OUT1／OUT2，候选为车体左电机；B 接 OUT3／OUT4，候选为车体右电机。这里左右是机器人自身视角。`forward` 对应 A、B 的 IN1／IN3 高及 IN2／IN4 低；镜像安装时两侧轴从外部看可能相反。必须空载核对每侧带动车体向前的方向；需要交换某电机两根输出线时先断开所有电源。台架“正转”不自动等于车体前进。

两路使能没有外部下拉的既有条件仍需保留：面包板先启动并确认关闭，驱动功率最后接通、最先断开；内部下拉不能证明复位、启动前或失电时保持关闭。本轮不做功率带电的刷写／复位测试。

## 灵矽工具及停止

**ct6 历史接口。** 下列四工具、约 60% PWM、互斥和冷却参数保留供核对原回执；当前八工具与并行策略见[当前接口](../firmware/CAPABILITIES.md#当前面包板-ct21-接口)。

| 工具 | 参数 | 行为 |
|---|---|---|
| `self.tank.get_status` | `{}` | 查询两路电机、水枪、剩余时间及故障 |
| `self.tank.stop` | `{}` | 立即取消全部动作与排队请求，两路使能／方向和 MOS 关闭 |
| `self.tank.move` | `direction`、`duration_ms` | `forward/backward/left/right`；1–3000 ms；约 60% PWM |
| `self.tank.water` | `duration_ms` | 1–30000 ms；保留原 MOS 水枪 |

角色将明确动作但未说时长的请求设为一秒；超限只请求单次上限并说明，不分段补足。左／右为两电机反向的原地转向，不是角度控制。电机结束或停止后冷却三秒，水枪一秒；冷却时间不代表实测轴已停稳。两类动作互斥，忙碌请求拒绝且不排队补做。BOOT、停止和已检测断线均关闭所有动作，释放／重连不会恢复。

共享 128 项会话 RPC ID 记录和内部票据：一次接受会取消同时排队的其他请求；停止／断线取消旧票据，队列超过五秒拒绝。无跨复位持久化保证。输出 API 出错锁定，尝试全关，不自动重启或重试动作。状态、时限、错误字段详见[面包板适配](../firmware/esp32-audio/README.md)与[接口手册](../firmware/CAPABILITIES.md#面包板-ct6-接口)。

## ct6 历史验证顺序

以下是当时拟定的步骤，已执行部分见收尾和流水；不是要求回刷 ct6 或重做全部测试。跨动作拒绝与禁止同时动作已被 ct7 替代，当前缺口见文首。

1. 现场确认 L298N 12 V 与 MOS 5 V 均断开，GPIO8–13 空闲；两电机固定空载、不装履带，准备好能独立拔断功率的入口。断主控电源后迁线，接回面包板 USB，功率仍保持断开。
2. 识别面包板的串口／MAC／当前应用及 OTA 分区，保留原 ct5 备份；只更新核对后的应用分区，保留 NVS、设备绑定、OTA 数据和音频资源。启动核对 `ct6`、`READY` 和状态为全部关闭。不能给另一块台架板刷入此镜像。
3. 将 [role-prompt.txt](../firmware/esp32-audio/role-prompt.txt) 完整同步到现有 CyberTrack 的角色介绍并重新读取比对。昵称、音色、模型及绑定不改。按[角色流程](agent-role.md)重启加载；此时功率仍断开。
4. 功率断开：核对六路电机信号与 MOS 空闲为低；语音“查询状态”“前进一秒”“后退半秒”“左转”“右转五秒”“喷水”“喷水七秒”“停止”，验证参数、截止、回执与信号。另测行走中喷水拒绝、喷水中行走拒绝、否定句不动作、BOOT 提前停止及释放不恢复、断线停、旧请求不补做。状态／停止不应触发新动作，音频／OLED 保持正常。
5. 仅电机 12 V 接通、MOS 5 V 仍断开：从一次一秒空载动作开始，核对 A／B 与左右方向、到期停止和 BOOT 同停；每次等待轴完全停稳且至少三秒。方向异常或回执缺失先断功率，不连续试错。迁至面包板后的母线电压、音频干扰、电流与温升另记。
6. 断电机 12 V，只接水枪功率，重复一秒喷水、正常停止和 BOOT 提前停止。之后是否两支路同时接电须结合电源预算与前述结果单独安排；本版仍禁止动作同时运行。落地／履带带载另行验证。

## 软件验证

以下命令、导出目录及覆盖项记录 ct6 当时的验证；当前脚本已随功能演进，不能用当前源码重跑后声称复现 ct6。当前构建入口见[面包板工程](../firmware/esp32-audio/README.md#重现构建)，本次未重跑历史测试。

`sh firmware/esp32-audio/test.sh`：ASan／UBSan 的历史只读状态、水枪策略、统一动作策略及真实 GPIO／PWM 输出类测试。覆盖四方向、边界、冷却、互斥、同批票据取消、BOOT／停止／断线、过期／会话隔离与各初始化／启动／停止 API 单故障。

`python firmware/esp32-audio/tests/run_mcp_tests.py --source build/xiaozhi-ct6-src`：从实际导出代码提取 MCP 校验块，链接 ESP-IDF cJSON，检查类型、范围、方向、缺参／额外／重复字段和伪造内部票据。

ESP-IDF 编译与应用哈希记录见 [ct6 软件报告](../firmware/esp32-audio/verification-ct6.json)。主机模拟和交叉编译不是设备语音、电气、时延或实体停止验收。

## ct6 现场流水（历史快照）

以下逐条保留 2026-10-25 当时的下一步、临时未完成状态、原始数值及补核过程；迁线、四方向空载、喷水与 BOOT 分项后来已完成，不把流水中的等待描述重新列为当前任务。

## 现场准备确认（2026-10-25）

用户已确认 L298N 12 V 与 MOS 5 V 两路功率均断开，面包板 GPIO8、9、10、11、12、13 均空闲。尚未收到迁线完成确认；当前主机未枚举到 ESP32 串口，等待面包板数据连接。已复核 ct6 二进制及报告所列源码哈希一致，尚未执行设备读取、刷写、平台角色同步或动作。

## ct6 刷写与平台同步（2026-10-25）

用户确认两路功率断开、GPIO8–13 空闲，并连接面包板。COM 上两次 RAM stub 上传校验失败，未擦写 Flash；ROM 读取配置区成功。用户改接原生 USB 后 stub 上传及读取正常，完成 0x3f0000 字节 OTA0 分区备份，并确认应用前缀与已保存 ct5 镜像逐字节一致。

仅写入 0x20000 起的 ct6 应用，2,551,904 字节，esptool 哈希校验通过；写入前后 0x8000..0x1ffff 的 98,304 字节完全一致，引导、NVS、OTA 数据与 assets 未写入。12:27:26（上海时间）观察到 ct6、SSD1306 初始化与四工具 READY，12:27:31 联网待机；此观察期未见错误或重启。没有发送串口动作命令。

用户在内置浏览器登录原账号后，已保存 CyberTrack 新角色并重新打开逐字比对一致。保留当前昵称“小D”、音色“少年梓辛/Brayan”、deepseek-v4-flash、统一意图识别和设备绑定；音色是本次读取现状，未恢复成历史音色。设备页已上报 ct6。启动及平台证据见[部署记录](../firmware/esp32-audio/startup-ct6.json)。

迁线尚未确认；两路功率保持断开。下一项为用户语音“查询状态”，核对回执、声音与屏幕，再安排断电迁线和功率断开的控制电平检查。

### ct6 首次状态工具回执

12:27:54 与 12:28:03（上海时间）记录两次真实 `self.tank.get_status`，均返回 `ok`、`left=0/right=0/water=false`、`starts_this_boot=0`，能力包含 move 与 water。`STOPPED/stopped` 为停止状态，无 output_fault／clock_fault。此证据确认设备端状态工具联通及无动作目标，不代替引脚电压测量；声音／屏幕仍待用户反馈，尚未执行动作。

### 用户声音／屏幕反馈

用户确认 ct6 声音和屏幕正常，报告回复为“我是小 D，你的机器人小助手。”。该句是自我介绍，不作为状态问答通过；前述两次 get_status 回执仅证明工具调用成功，尚未与本次现场听到的句子建立对应。后续先唤醒并等待响应，再单独说“查询状态”以核对完整语音路径。迁线尚未收到完成确认。

### 状态问答对应关系核实

随后只读核对灵矽本设备 12:27–12:28 会话：自我介绍对应“你好，小智。”；12:27:54 与 12:28:03 的“检查一下状态。”均调用 `self_tank_get_status({})`，分别在 12:27:56 和 12:28:05 回复“待命中。”，与设备串口两条关闭状态回执对应。因此本次状态查询的转写→工具→平台回答子项通过，无需重复或修改提示词。用户确认声音／屏幕正常；动作、迁线、控制电平及带载验证仍未完成。

### 迁线完成，进入控制信号检查

用户确认已完成迁线，只接回面包板 USB，L298N 12 V 与 MOS 5 V 均保持断开。重新连接只读串口观察器，日志为 `build/audio-private/ct6-wiring-session.jsonl`；不通过串口复位或发动作。下一项先测 L298N ENA／IN1／IN2／ENB／IN3／IN4 对控制 GND，以及 MOS TRIG/PWM 对控制 GND 的静态电压；尚未取得读数，不认定实物信号检查通过。

### 迁线后静态信号检查

用户按直流电压档测量后报告“全部接近 0 V”：L298N 的 ENA／IN1／IN2／ENB／IN3／IN4 对 L298N GND，以及 MOS TRIG/PWM 对控制 GND，共七路。仅面包板 USB 供电，L298N 12 V 和 MOS 5 V 保持断开。精确电压未提供；此项为迁线后静态关闭信号检查，不包含动态 PWM、默认关闭的复位／失电边界或带载启停。下一项只做一次前进 3000 ms 的 ENA 控制电平观察。

### ENA 动态信号检查

用户保持两路功率断开，对 L298N ENA／GND 测得动作期间约 1.95 V，约三秒后自动归零，小D回复“好，前进三秒。”。串口于 12:42:10 接受一次 forward／3000 ms，left=60、right=60、water=false、starts=1；12:42:13 记录 deadline、software_on_ms=3000、outputs=OFF。此项确认 ENA 万用表电平变化及本次语音／工具／截止链路，不是 PWM 波形测量或电机带载验收；日志时长不是物理停止时延。下一项在相同断电条件下测 ENB，一次前进三秒；该工具仍同时请求两路，只有表笔观测目标切换到 B 路。

### ENB 动态信号检查

用户保持两路功率断开，测得 ENB 对 L298N GND 动作期间约 1.95 V，约三秒后自动归零，小D回复“好，前进三秒。”。串口于 12:43:28 接受 forward／3000 ms，left=60、right=60、water=false、starts=2；12:43:31 记录 deadline、software_on_ms=3000、outputs=OFF。本次 ENB 控制电平与截止检查通过，不扩展为方向脚、PWM 波形或电机／驱动带载通过。下一项固定表笔于 IN1／GND，分别观察一次前进与一次后退三秒，中间关闭后至少等待三秒；预期前进约 3.3 V、后退保持近 0 V，两者结束均归零。

### IN1 前进通过，后退执行证据待补

用户报告 IN1 前进时 3.25 V、三秒后归零；后退时全程近 0 V，结束后保持 0 V，两路功率仍断开。串口记录 12:44:23 forward／3000 ms accepted、starts=3，12:44:26 deadline／software_on_ms=3000；平台对应“前进3秒。”及正常回执。核对时平台和串口均未出现 backward 转写／调用／接受记录，因此只确认前进电平与截止；后退低电平保留为用户观察，不能据此认定后退请求已执行。下一步保持表笔在 IN1／GND，重新唤醒后明确请求一次“后退三秒”，核对回执及观察后再换 IN2。

### IN1 后退回执补核通过

用户重新唤醒后说“后退三秒”，小D回复“好，后退三秒。”，IN1 全程及结束后均接近 0 V；两路功率仍断开。串口于 12:46:47 接受 backward／3000 ms，left=-60、right=-60、water=false、starts=4、fault=none；12:46:50 记录 deadline、software_on_ms=3000、outputs=OFF。本次已补齐真实后退执行证据，与前次前进 3.25 V 后归零的观察合并，IN1 在这两次动作中的方向电平检查通过。此项仍只覆盖功率断开的信号检查。下一项测 IN2（GPIO10）对 L298N GND：后退三秒预期约 3.3 V 后归零，结束后至少等待三秒，再前进三秒预期全程近 0 V。

### IN2 前进／后退信号检查通过

用户报告 IN2 后退时约 3.25 V、三秒后归零；前进全程及结束后接近 0 V，小D分别回复“好，后退三秒。”“好，前进三秒。”，两路功率仍断开。串口于 12:48:45 接受 backward／3000 ms、left=-60／right=-60、starts=5，12:48:48 到期关闭；12:48:58 接受 forward／3000 ms、left=60／right=60、starts=6，12:49:01 到期关闭。两次均 water=false、fault=none，关闭记录均为 deadline／software_on_ms=3000／outputs=OFF。IN2 本次方向电平检查通过，不代表驱动带电或电机运动验收。下一项测 IN3（GPIO12）对 L298N GND：前进三秒预期约 3.3 V 后归零，结束后至少等待三秒，再后退三秒预期全程近 0 V。

### IN3 前进／后退信号检查通过

用户报告 IN3 前进时约 3.25 V、三秒后归零；后退全程及结束后接近 0 V，小D分别回复“好，前进三秒。”“好，后退三秒。”，两路功率仍断开。串口于 12:50:02 接受 forward／3000 ms、left=60／right=60、starts=7，12:50:05 到期关闭；12:50:11 接受 backward／3000 ms、left=-60／right=-60、starts=8，12:50:14 到期关闭。两次均 water=false、fault=none，关闭记录均为 deadline／software_on_ms=3000／outputs=OFF。IN3 本次方向电平检查通过，不代表驱动带电或电机运动验收。下一项测 IN4（GPIO13）对 L298N GND：后退三秒预期约 3.3 V 后归零，结束后至少等待三秒，再前进三秒预期全程近 0 V。

### IN4 前进／后退信号检查通过

用户报告 IN4 后退时约 3.25 V、三秒后归零；前进全程及结束后接近 0 V，小D分别回复“好，后退三秒。”“好，前进三秒。”，两路功率仍断开。串口于 12:50:54 接受 backward／3000 ms、left=-60／right=-60、starts=9，12:50:57 到期关闭，software_on_ms=2999；12:51:06 接受 forward／3000 ms、left=60／right=60、starts=10，12:51:08 到期关闭，software_on_ms=3000。两次均 water=false、fault=none，关闭原因均为 deadline、outputs=OFF。IN4 本次方向电平检查通过；至此 ENA／ENB 与 IN1–IN4 的上述功率断开信号观察均符合预期，不代表 PWM 波形、转向、驱动带电或电机运动验收。下一项保持两路功率断开，测 MOS TRIG/PWM（GPIO18）对 MOS 控制 GND，语音“喷水三秒”，预期约 3.3 V 后自动归零。

### MOS 三秒控制信号检查通过

用户报告 MOS TRIG/PWM 对控制 GND 待机接近 0 V，语音“喷水三秒”后升至 3.18 V，约三秒后自动归零，小D回复“好，喷水三秒。”，两路功率仍断开。串口于 12:52:00 接受 water／3000 ms，left=0／right=0、water=true、starts=11、fault=none；12:52:03 记录 deadline／software_on_ms=3000／outputs=OFF。本次 MOS 控制电平及喷水工具截止检查通过，不代表 MOS 带电或水枪实喷验收。下一项保留同一表笔位置和功率断开条件，语音“喷水五秒”，观察电平升高约一秒后按住 BOOT 约一秒再松开，核对提前归零、关闭原因及松开后至原定五秒结束再多两秒均不恢复。该停止检查尚未执行。

### MOS BOOT 提前停止及释放不恢复

用户报告小D回复“好，喷水五秒。”，电压升高后按下 BOOT 即归零，松开后持续接近 0 V，超过原定五秒仍未恢复；两路功率保持断开。串口于 12:53:18 接受 water／5000 ms，left=0／right=0、water=true、starts=12、fault=none；12:53:19 记录 ACTION_OFF reason=BOOT、software_on_ms=1250、outputs=OFF，确认提前关闭由 BOOT 触发。1250 ms 是软件动作持续时间，不是按键响应时延。核对时日志最后事件为 12:53:21，未见后续启动回执；超过原定时长不恢复的证据来自用户电压观察。本项仅确认功率断开的 MOS 控制信号停止，未覆盖实际喷水或电机停止。下一项测 ENA 对 L298N GND，语音“前进三秒”，电压升高后约半秒至一秒按住 BOOT 约一秒再松开，观察提前归零及超过原定三秒后不恢复；ENB 后续单独检查。

### ENA BOOT 提前停止及释放不恢复

用户报告小D回复“好，前进三秒。”，ENA 电压升高后按下 BOOT 即归零，松开后持续接近 0 V，超过原定三秒仍未恢复；两路功率保持断开。串口于 12:55:14 接受 forward／3000 ms，left=60／right=60、water=false、starts=13、fault=none；12:55:15 记录 ACTION_OFF reason=BOOT、software_on_ms=1515、outputs=OFF，确认提前关闭由 BOOT 触发。1515 ms 是软件动作持续时间，不是按键响应时延。核对时日志最后事件为 12:55:17.251，未见后续启动回执；超过原定时长不恢复的证据来自用户电压观察。本项仅确认功率断开的 ENA 停止信号，不扩展为 ENB 实测或电机机械停止。下一项将红表笔换至 ENB，黑笔保留 L298N GND，在相同功率断开条件下重复一次“前进三秒”及 BOOT 提前停止，观察释放后不恢复。

### ENB BOOT 提前停止及释放不恢复

用户报告小D回复“好，前进三秒。”，ENB 电压升高后按下 BOOT 即归零，松开后持续接近 0 V，超过原定三秒仍未恢复；两路功率保持断开。串口于 12:56:02 接受 forward／3000 ms，left=60／right=60、water=false、starts=14、fault=none；12:56:03 记录 ACTION_OFF reason=BOOT、software_on_ms=1145、outputs=OFF。1145 ms 是软件动作持续时间，不是按键响应时延。核对时日志最后事件为 12:56:05.901，未见后续启动回执；释放后不恢复同时有用户电压观察。本次 ENB 控制信号停止检查通过；至此 MOS、ENA、ENB 均分别观察到 BOOT 提前归零且释放不恢复，不代表同时采样、带载停止或停止时延验收。下一项保持功率断开，表笔移回 MOS 控制 GND／TRIG，语音“喷水十秒”，电压升高后说“停止”（需要时重新唤醒），核对 self.tank.stop、提前归零及不恢复；不按 BOOT，以区分停止来源。

### 语音停止工具提前关闭 MOS

用户报告先回复“好，喷水十秒。”，说“停止”后回复“已停止。”；MOS 电压在十秒到期前归零，之后持续接近 0 V、没有恢复，两路功率仍断开。串口于 12:56:53 接受 water／10000 ms、starts=15；12:57:01 实际调用 self.tank.stop，返回 ok、STOPPED、left=0／right=0／water=false，starts 仍为 15。12:57:02 记录 ACTION_OFF reason=stop、software_on_ms=8221、outputs=OFF。fault=stopped 为正常停止状态；8221 ms 是动作持续时间，不是语音停止响应时延。核对至日志最后事件 12:57:05.158，未见后续启动回执。此次功率断开的 MOS 语音停止检查通过。下一项测 ENA 对 L298N GND：请求“喷水二十秒”，回复后立即请求“前进三秒”，在喷水仍活动的窗口核对忙碌拒绝、ENA 保持低；随后语音停止，继续观察至原定二十秒结束后两秒，检查无排队补做。二十秒仅用于功率断开时留出语音操作窗口，不代表该时长带载通过。

### 喷水期间行走请求未执行，无补做观察

用户报告喷水二十秒后请求前进三秒，小D提示正在喷水、不能同时行走；随后停止获确认，ENA 全程及超过原定二十秒均接近 0 V，两路功率仍断开。设备于 12:58:08 接受 water／20000 ms、starts=16，12:58:19 收到 self.tank.move（RPC 20）。平台对应参数为 forward／3000 ms，显示“MCP工具调用失败”，随后回复“现在正在喷水，行走和喷水要分开操作，暂时不能前进。”；没有 move accepted 回执。结合已部署源码的忙碌 Claim 拒绝路径、喷水仍活动的时间窗口及动作计数未增，符合固件忙碌拒绝，非仅角色自行拒绝；平台未显示具体 busy 错误码，不将其记为已读到结构化 busy 回执。

12:58:28 喷水以 deadline 自动结束，software_on_ms=20001；12:58:37 才收到 stop 并返回 ok、全部关闭、starts 仍为 16。核对日志至 12:58:40.829 未见补做启动。此次停止晚于喷水截止，不重复计作提前停止通过。本项仅覆盖喷水期间请求行走及 ENA 低电平观察；反向互斥与 ENB 的独立测量未覆盖。下一项保持两路功率断开，测 IN1 对 L298N GND：左转三秒应保持近 0 V；关闭后至少等三秒，再右转三秒，应升至约 3.3 V 后归零。随后检查 B 路转向信号。

### IN1 左／右转向信号检查通过

用户报告 IN1 左转全程及结束后接近 0 V，右转时约 3.25 V、三秒后归零，小D分别回复“好，左转三秒。”“好，右转三秒。”，两路功率仍断开。串口于 13:00:03 接受 left／3000 ms、left=-60／right=60、starts=17，13:00:06 到期关闭；13:00:15 接受 right／3000 ms、left=60／right=-60、starts=18，13:00:18 到期关闭。两次均 water=false、fault=none，关闭记录均为 deadline／software_on_ms=3000／outputs=OFF。IN1 本次左右转向电平符合预期，不代表 B 路实测或实车转向通过。下一项测 B 路 IN3（GPIO12）对 L298N GND：左转三秒预期约 3.3 V 后归零，结束后至少等待三秒，再右转三秒预期全程近 0 V。

### IN3 左／右转向信号检查通过

用户报告 IN3 左转时约 3.25 V、三秒后归零，右转全程及结束后接近 0 V，小D分别回复“好，左转三秒。”“好，右转三秒。”，两路功率仍断开。串口于 13:01:02 接受 left／3000 ms、left=-60／right=60、starts=19，13:01:05 到期关闭；13:01:11 接受 right／3000 ms、left=60／right=-60、starts=20，13:01:14 到期关闭。两次均 water=false、fault=none，关闭记录均为 deadline／software_on_ms=3000／outputs=OFF。IN3 本次转向电平符合预期；结合此前 IN1 的独立测量，A／B 两路所测方向脚符合左右反向的逻辑，不代表同步波形、其余转向引脚或实车转向验收。下一项保持两路功率断开，表笔移至 MOS 控制 GND／TRIG，待机后语音“不要喷水，也不要前进”，观察至回复结束后五秒均为低，再语音“查询状态”，核对全关及 starts=20 未增加；否定指令检查尚未执行。

### 否定指令未触发动作

用户说“不要喷水，也不要前进”后，小D回复不会执行，查询状态回复“待命中。”；MOS 控制电压全程接近 0 V，两路功率仍断开。核对 13:01:15 后至日志最后事件 13:02:13.539，仅见 13:02:11 的 get_status，返回 ok、DISARMED、left=0／right=0／water=false、fault=none、starts_this_boot=20，与此前计数一致，未见 move／water 调用。本句否定指令不动作检查通过，不扩展为所有自然语言情形或所有引脚瞬态验证。下一项保持功率支路断开和 MOS 表笔位置不变，面包板 USB 断开五秒再接回，观察启动至联网待机控制电压是否保持近零；用户反馈后重新连接只读串口并核对新启动状态。此项尚未执行，万用表无法排除短暂毛刺。

### USB 重新上电及只读串口恢复

用户确认面包板 USB 断开五秒后接回，启动至联网待机期间 MOS 电压一直接近 0 V，声音、屏幕正常，L298N 12 V 与 MOS 5 V 仍断开。旧观察器已退出，重新在 /dev/cu.usbmodem1101 打开只读观察器，日志为 build/audio-private/ct6-repower-session.jsonl，未发送串口应用命令。13:04:21 收到 2.0.3-ct6、SSD1306 初始化与四工具 READY（GPIO18=LOW、BOOT=stop_all）；13:04:25 收到联网记录，13:04:26 进入 idle。以上时间为观察器接收时间，不作为实际断电／上电时刻。用户电压观察与启动日志已记录；新启动 get_status、boot_id 和 starts_this_boot=0 仍待语音查询确认。本项不排除短暂毛刺，也未测其余引脚的上电过程。

### 重新上电后的状态回执核实

用户唤醒并说“查询状态”，小D回复“待命中。”。13:05:03 的 get_status 返回 ok、left=0／right=0／water=false／bubbles=false、starts_this_boot=0、remaining_ms=0；boot_id 为 9a70ce8ecf859bbd，与此前 17957fcb941ef355 不同，确认新启动。STOPPED／stopped 为正常停止状态，不是 output_fault。结合此前用户 MOS 电压观察，此次上电后状态核对完成；并不扩展为全部引脚上电无毛刺或带载验收。后续断网停止检查需先明确面包板使用手机热点还是路由器 Wi-Fi，以便安排网络中断而保持 USB 和两路功率断开条件不变。

### 用户调整顺序：断网延期，先分支带电测试

用户明确要求断网后续再测，先开始电机和水枪测试。断网停止／重连不恢复保留为延期未验收，不作为本轮已通过项。接下来仅接通已独立测试的 L298N 12 V 支路，MOS 5 V 保持断开；面包板保持 USB 供电、联网待机，两电机固定空载、不装履带，功率断开入口可直接操作。上电待机确认不自转、声音／屏幕正常后，只请求一次“前进一秒”，观察两路启动、方向、约一秒断驱动后的停转及面包板是否重启。异常时先切断 12 V，不用语音停止替代独立断电，不带电改线。

电机结果核对后先断 12 V，再单独接原 MOS／3.7 V 降压水枪支路，安排一秒喷水；两路暂不同时接通，不进行落地行走。当前尚未收到功率接通或带电动作结果；反向互斥等其他未覆盖项继续保持未完成，不因调整顺序视为通过。

### 首次分支带电：双电机一秒启停通过

用户确认仅接通 L298N 12 V、MOS 5 V 仍断开；待机两电机不自转，语音“前进一秒”后两台均转动并约一秒后停止，小D回复“好，前进一秒。”，声音／屏幕正常且未重启。串口于 13:08:18 接受 forward／1000 ms，left=60／right=60、water=false、fault=none、starts=1；boot_id 仍为 9a70ce8ecf859bbd。13:08:19 记录 deadline／software_on_ms=1000／outputs=OFF。两台电机单次短时带电启停与回执对应通过；用户未报告各自旋转方向，不能认定车体前进方向已校准，也未测带载、电流、温升或组合供电。

当前最后确认功率状态为电机 12 V 接通、水枪 5 V 断开。下一步先断 L298N 12 V，保留面包板 USB，再仅接通原水枪 5 V→MOS→3.7 V 降压→水枪支路。水枪固定、喷口对准接水容器并避开电路，按既有供水方式准备；待机确认不喷水后仅请求一次“喷水一秒”，观察实际出水、约一秒后停止、声音／屏幕及有无重启。异常先断 MOS 5 V，不带电修改接线；该支路切换及水枪结果尚待用户反馈。

### 水枪单支路一秒实喷通过

用户确认电机 12 V 已断开、仅 MOS 5 V 接通，待机不喷水；“喷水一秒”后正常实喷并约一秒后停止，小D确认一秒，声音／屏幕正常且未重启。日志中 13:09:17、13:09:42、13:13:41、13:14:23、13:15:47 共五次 water／1000 ms accepted，starts 从 2 到 6，每次均 left=0／right=0、fault=none，并于约一秒后记录 deadline／software_on_ms=1000／outputs=OFF；boot_id 始终为 9a70ce8ecf859bbd。平台逐次核对均有新的“喷水一秒”转写及对应工具调用，不是将五次记作一次或自动重试。用户实喷反馈未逐次定位，不据此声称五次物理重复性验收。

本轮一秒实喷启停检查通过。下一项维持电机 12 V 断开、仅 MOS 5 V 接通，水枪固定且对准接水容器；请求一次“喷水三秒”，看到实际喷水约一秒后按住 BOOT 约一秒再松开，观察提前停止及超过原定三秒再多两秒仍不恢复。不必等待语音回复结束才按键；异常持续喷水时直接断 MOS 5 V。本轮实际喷水的 BOOT 停止尚待验证。

### 水枪实喷 BOOT 提前停止通过

用户确认“喷水三秒”后正常实喷，约一秒时按下 BOOT 即停止，松开后无恢复，超过原定三秒未再喷水，声音／屏幕正常；电机 12 V 仍断开，仅 MOS 5 V 接通。14:26:40 接受 water／3000 ms，left=0／right=0、water=true、fault=none、starts=7、boot_id=9a70ce8ecf859bbd；同一分钟记录 ACTION_OFF reason=BOOT、software_on_ms=670、outputs=OFF，明确早于三秒截止。670 ms 是软件动作持续时间，用户“约一秒”为现场估计，两者均不是按键至停喷延迟测量。核对时日志尾为 14:26:42.977，未见后续启动；超过原定时长不恢复来自用户实喷观察。本轮水枪单次带电 BOOT 停止及释放不恢复通过，不扩展为组合供电或定量停止性能。

下一项先断 MOS 5 V，再仅接通 L298N 12 V，面包板 USB 保持连接；两电机固定空载、不装履带。待机不自转后请求一次“前进三秒”，看到两电机转动约半秒至一秒后按住 BOOT 约一秒再松开，分别观察两台是否提前停转及超过原定时长再多两秒不恢复。异常先断 12 V；本轮双电机带电 BOOT 停止尚待验证。

### 双电机带电 BOOT 检查：回执显示到期关闭，需补核

用户确认 MOS 5 V 已断开、仅 L298N 12 V 接通，前进三秒时两台转动，按下 BOOT 后均提前停止、释放后超过原定三秒也无恢复，声音／屏幕正常。然而串口 14:28:00 接受 forward／3000 ms、left=60／right=60、water=false、fault=none、starts=8、boot_id=9a70ce8ecf859bbd，14:28:03 记录的关闭原因为 deadline，software_on_ms=2996，outputs=OFF，并非 BOOT。核对至日志尾 14:30:43.923 未见后续启动。

保留用户观察，但本次只能确认动作关闭与无恢复，不能将关闭归因为 BOOT；也不能仅据此判定按键硬件故障。双电机带电 BOOT 提前停止仍待核实，暂不进入后退检查。保持既有单支路供电和固定空载条件，再做一次“前进三秒”，一看到电机开始转动即按住 BOOT，不等语音回复、不额外等待一秒，保持约一秒后松开；观察两台停转及超过原定时长后不恢复，再核对关闭原因。若按键后任一台持续转动则直接断 12 V。

### 双电机 BOOT 补测：现场停止正常，串口观察中断

用户报告重新请求前进三秒，两台一开始转动即按住 BOOT，均立即停止、释放后超过原定三秒未恢复，声音／屏幕正常；MOS 5 V 仍断开，仅 L298N 12 V 接通。核对发现 ct6-repower-session.jsonl 最后事件仍为 14:30:43.923，没有本次新动作记录；观察器进程已退出，退出码 1，错误为 serial read failed: [Errno 6] Device not configured。端口 /dev/cu.usbmodem1101 当前可见，但观察器未自动恢复。

因此保留本次实物观察，关闭原因暂无法从日志确认；上一轮 deadline 记录不能套用于这次补测。日志缺失不等于按键或电机故障。当前电机功率仍由用户确认接通，尚未重新打开串口；下一步先断 L298N 12 V、保持 MOS 5 V 断开及面包板 USB 连接，再恢复只读观察器并核对状态，之后安排必要的补核。

### 线材限制下调整为双支路供电准备，观察器已恢复

用户说明现有 Type-C 分别供给 12 V 升压→L298N 与 MOS 5 V 水枪支路，因线材限制希望两路均通电。后续调整为两路功率可同时接通、动作仍逐项且由固件互斥；水枪保留原 3.7 V 下游降压，不能把调整顺序视为组合电源通过。用户随后确认两路功率已断开、面包板已接电脑。

只读观察器重新打开 /dev/cu.usbmodem1101，日志为 build/audio-private/ct6-dual-power-session.jsonl。14:37:56 收到 ct6，14:37:57 收到 SSD1306 与四工具 READY、GPIO18=LOW，14:38:01 联网，14:38:02 进入 idle。未发送串口应用命令；以上均为接收时间。当前两路功率保持断开，下一步语音查询状态以确认新会话全部输出关闭及启动计数，再安排接回两路功率、核对待机无自转／喷水及电机 BOOT 补测。此前缺失的 BOOT 日志无法通过此次重连追溯补齐；断网检查仍延期。

### 双支路通电前状态核实完成

用户查询状态得到“待命中。”，再次确认两路功率仍断开。14:38:37 get_status 返回 ok、STOPPED／stopped、left=0／right=0／water=false／bubbles=false、remaining_ms=0、starts_this_boot=0，boot_id=de51ee2dde9cd107。stopped 为正常停止状态；新启动状态全关已核实，观察器仍在运行。

下一步保留面包板与电脑 USB 连接不动，接回 L298N 12 V 与 MOS 5 V 两路既有功率支路；水枪固定朝接水容器、两电机固定空载、不装履带。先观察约五秒，确认无自转、无喷水且音频／屏幕正常，才请求一次“前进三秒”。看到电机开始转动即按住 BOOT 约一秒后松开，不等语音回复，分别观察两台提前停转、松开后至原定三秒结束再多两秒无恢复，水枪应始终不喷水。任一异常先断两路功率，不拔面包板 USB，以保留日志。此双支路通电与补测尚未执行，不能预记通过。

### 双支路供电下双电机 BOOT 提前停止补核通过

用户确认两路功率已接通，待机无电机自转、无喷水；前进三秒后两台转动，立即按下 BOOT 均停止，释放后超过原定三秒仍未恢复。水枪始终未喷水，声音／屏幕正常，USB 全程连接电脑。14:39:19 接受 forward／3000 ms，left=60／right=60、water=false、fault=none、starts=1、boot_id=de51ee2dde9cd107；随即记录 ACTION_OFF reason=BOOT、software_on_ms=460、outputs=OFF。此次明确补齐 BOOT 提前关闭回执，与实物停止观察一致。460 ms 为软件动作持续时间，不是按键至机械停止延迟；此前 deadline 和日志缺失两轮仍保留原记录，不回填为通过。

本次双支路供电、仅电机动作的短时测试通过，不等于完整组合电源、电流、温升或带载行走验收。当前两路功率均通电，下一项保持接线和 USB 不变、两电机固定空载、水枪对准接水容器，待轴停稳且距停止至少三秒后，仅请求一次“喷水一秒”。观察实际喷水后自动停止、两台电机全程不转以及音频／屏幕正常；此项尚未执行。

### 双支路供电下一秒喷水，电机保持静止

用户报告小D回复“好，喷水一秒。”，水枪正常喷水并约一秒后停止，两台电机全程不转，声音／屏幕正常，两路功率仍接通、USB 始终连接电脑。14:40:02 接受 water／1000 ms，left=0／right=0、water=true、fault=none、starts=2、boot_id=de51ee2dde9cd107；14:40:03 记录 deadline／software_on_ms=1000／outputs=OFF。本次单独喷水及电机保持静止与回执一致，不等于活动中请求另一动作的互斥验证，也不是完整组合供电验收。

下一项维持两路功率及 USB、固定空载和接水条件，停止后至少等待三秒，仅请求一次“后退一秒”，分别比较 A／B 电机与各自此前前进时的转向是否相反，并观察约一秒后停止、水枪全程不喷水。比较基于同一电机同一观察方向；未确认的方向不要猜测，也不据台架反转推定车体前进方向已校准。

### 双支路供电下一秒后退及反转观察通过

用户报告“后退一秒”后，两台电机均与各自此前前进时方向相反，约一秒后停止，水枪全程未喷水，小D回复“好，后退一秒。”，声音／屏幕正常，两路功率接通、USB 一直连接电脑。14:43:05 接受 backward／1000 ms，left=-60／right=-60、water=false、fault=none、starts=3、boot_id=de51ee2dde9cd107；随后记录 deadline／software_on_ms=1000／outputs=OFF。本次固定空载反转及定时停转符合预期，不等于车体前进方向或落地行走验收。

下一项仅请求一次“左转一秒”：A 路（OUT1／OUT2）预期与其此前前进方向相反，B 路（OUT3／OUT4）预期与其此前前进方向相同，约一秒后均停止，水枪不喷水。保持两电机固定空载和既有供电／USB，待轴停稳且距停止至少三秒再请求；A／B 按输出端子辨认，不按观看时的视觉左右推定，也不在通电时触碰或调整接线。

### 双支路供电下一秒左转方向组合通过

用户报告“左转一秒”后，A 路与此前前进方向相反，B 路与此前前进方向相同，两台约一秒后停止，水枪未喷水，小D回复“好，左转一秒。”，声音／屏幕正常，两路功率仍接通、USB 一直连接电脑。14:44:42 接受 left／1000 ms，left=-60／right=60、water=false、fault=none、starts=4、boot_id=de51ee2dde9cd107；14:44:43 记录 deadline／software_on_ms=1000／outputs=OFF。本次固定空载左转指令的方向组合和截止符合预期，不等于实车左转或转角验收。

下一项待轴停稳且距停止至少三秒，仅请求一次“右转一秒”：A 路（OUT1／OUT2）预期与此前前进方向相同，B 路（OUT3／OUT4）预期与此前前进方向相反，约一秒后两台停止、水枪全程不喷水。保持既有固定空载条件、两路供电和 USB，不带电改线。

### 双支路供电下一秒右转方向组合通过，进入收尾

用户报告“右转一秒”后，A 路与此前前进方向相同，B 路与此前前进方向相反，两台约一秒后停止，水枪未喷水，小D回复“好，右转一秒。”，声音／屏幕正常，两路功率仍接通、USB 一直连接电脑。14:45:13 接受 right／1000 ms，left=60／right=-60、water=false、fault=none、starts=5、boot_id=de51ee2dde9cd107；14:45:14 记录 deadline／software_on_ms=1000／outputs=OFF。本次固定空载右转指令的方向组合和截止符合预期。

本轮基本带电台架功能已有前进／后退／左转／右转、喷水定时启停及电机／水枪 BOOT 停止的分项证据，双支路供电下分别动作未观察到另一机构误动。下一项收尾：语音“查询状态”，核对全部输出关闭、remaining_ms=0、本启动 starts=5；随后断开两路功率，保留 USB 以读取回执，等待用户确认实际断电。当前不能记为已断电。断网测试依用户要求延期，反向互斥（行走中请求喷水）、全部边界语音回归、定量电源／温升及履带带载、实车方向验收仍未完成；不重复已通过短时动作来替代这些未测项。

### 本轮收尾状态与物理断电确认

14:45:51 get_status 返回 ok、DISARMED、fault=none，left=0／right=0／water=false／bubbles=false、remaining_ms=0、starts_this_boot=5，boot_id=de51ee2dde9cd107。用户听到“待命中。”并确认 L298N 12 V、MOS 5 V 均已断开，USB 仍连接电脑。状态查询未增加启动计数；软件输出全关与物理断电分别由回执和用户确认支撑。本轮基本台架功能联调收尾，未完成项见文首汇总，未进行提交或推送。
