miclle/cybertrack/docs/current-work-handoff.md

# Current Work Handoff

当前状态已更新为 [34 件六盘项目](../hardware/model/print-ready/CyberTrack-Ready-6plates.3mf)，当前 Bambu Studio 窗口为 CyberTrack-Ready-6plates。第6盘补齐12件，预计1小时30分、59.87 g；前五盘模型、工艺及G-code保持。用户明确取消上下两个线束护口，已从源档/交付模型移除。56处路径检查和GUI回读通过；外观件薄胶装配，详见[补齐记录](../hardware/model/completion-print/README.md)。以下五盘交付过程作为历史保留。

- **Status:** complete
- **Updated:** 2026-10-26
- **Repository:** /Users/miclle/github/miclle/cybertrack
- **Branch / Base:** main / main
- **Transfer:** local-only；未提交、未推送，保留其他任务修改

## Current delivery

用户要求处理剩余 PP01／PP02／PP03／LC04、修复问题模型、优化时间并追加到现有 Bambu Studio 项目。已完成：[22 件五盘项目](../hardware/model/print-ready/CyberTrack-Ready-5plates.3mf)在当前 Bambu Studio 窗口打开。第 5 盘共 4 件，预计 5 小时 24 分、264.39 g；全包约 21 小时 13 分、887.85 g。已观察到用户的第 1 盘正在打印；没有发送、暂停或停止打印。

## Changes and evidence

- PP02 保留安装孔／枪体位置，增加同心 Ø32.8 下缘避让，与原 Ø32 偏心孔形成复合孔口；静态枪壳最小间隙 0.65 mm。枪体相对底座 102 个离散拆装姿态无碰撞，不扩大成整机线束／手部维护验收。
- LC04 以两根 3 mm 内向筋连接原悬空安装柱，3 实体变为 1。四件均有效、单连通，当前静态实体／设备包络不相交。源档其他 432 个对象、交付模型其他 267 个对象签名保留。
- 0.28 mm、3 墙；PP01 保留 0.5 mm 经典墙线，其余三件 0.6 mm Arachne。33 个截面路径检查通过；无切片警告、执行路径碰撞检查，首层和所有层边界通过。保留失败候选记录，不把最快失败配置交付。
- 先用 GUI Save As 保存四盘当前快照；其几何／摆放／对象工艺与原四盘一致，保留设备及耗材参数同步变化。Save As 省略的原四盘 G-code 经验证后恢复，最终字节未变；只切片第 5 盘。
- 新项目已打开。GUI 保存回读 26 个网格体（22 件＋4 修改体）坐标最大差 3.87e-6 mm。正式文件保留缓存 G-code；GUI 检查快照不作为打印主交付。

见 [remaining-print](../hardware/model/remaining-print/README.md)、[五盘审计](../hardware/model/print-ready/five-plate-delivery-check.json)、[现场快照检查](../hardware/model/print-ready/current-snapshot-check.json)。整机 STEP 虽有效且实体数量一致，仍有 55.61 mm³ 体积差；FCStd 与本次单件打印导出为几何依据。实物公差、支撑清理、试装、承载和层向强度未验收。

## Preservation and operational notes

主工作区有大量并行任务未提交修改，不能整体回滚／暂存。原生修改前备份在 hardware/model/remaining-print/baseline。新增／调整的脚本已 py_compile，git diff --check 通过。没有新增提交或推送。

Bambu Studio 锁屏时 CLI 生成 G-code 可正常完成，导出带缩略图的 3MF 会等待图形环境；已停止仅属于本任务的等待进程。解锁后旧 GUI 曾在打印对话框内无响应，用户随后重启，当前只保留响应正常的新实例。未强制关闭用户进程。不要通过 AX 点击盘名称做普通选择，可能触发编辑和重复“盘 1 (…)”包装；正式磁盘文件的盘名正确，最后已重新打开正式五盘文件。后续先检查用户最新状态，不覆盖未保存操作。

FreeCAD 1.1.4 与 Bambu Studio 02.08.04.57；本任务已完成，无待接续实现。后续按实物反馈继续。
