miclle/cybertrack/docs/ultrasonic-head.md

# 0.41 超声波与面包板共存候选

**0.58 打印更新：** 超声波前脸面板和状态条已合入 PP07 整体头壳，探头孔仍为 Ø16.6、中心距 26 mm。冠盖和面包板托盘独立；拆除这两件、收置线束并解除模块固定后，候选传感器可后退 11 mm 再上提 70 mm，连续包络对新头壳无干涉。实际 PCB、针座及固定方法仍待确认，详见[头壳打印说明](head-shell-print.md)。以下为原候选尺寸依据。

2026-10-25。按用户要求将向上出线和托盘前缘让位合入主总装及图纸。头壳、前脸孔位、冠盖和四个托盘固定点保持；未实测部分继续标注为候选。独立U01研究副本已由本页、正式生成脚本和主模型专项报告替代。

本页保留0.41头部结构记录；0.43主总装保持这些头部几何，底盘增加板卡防脱压框与局部接线空间，见[当前结构](effects-mount.md)与[范围审计](../hardware/model/effect-board-change-audit.json)。

## 证据和假设

| 项目 | 数值 | 依据与边界 |
|---|---|---|
| 两探头 | Ø16、外沿总宽42、离“面板”高10.3 mm | [用户尺寸原话](../hardware/components/ultrasonic/dimensions.json)；“面板”是PCB还是机器人前脸尚未明确 |
| 中心距 | 26 mm | 由42−16计算；不是独立测量 |
| 通用商品整模块 | 45×20×15 mm | [P04页面归档](../hardware/procurement-web-review.md#p04--h19hc-sr04-单芯片宽电压模块)；所选单芯片版与通用多芯片图不一致，不能确认为实物尺寸 |
| 候选PCB | 左右45×上下20，厚1.6 mm | 45×20借用通用整模块的平面占位；1.6、板中心、板边与探头相对位置均为设计假设 |
| 背面元件占位 | 左右45×上下20，向后4 mm | 明确的空间预算；没有从标称总厚15反推元件高度 |
| 向后接头对比 | 左右12×后伸10×上下10 mm | 接头与服务占位假设，非实际插头 |
| 向上接头候选 | 左右12×前后6×向上8 mm | 顶边位置、方向、尺寸均待选型／测量；不表示现有板能够换向 |
| 线束候选 | Ø4空间管，向左侧交接区绕行 | 中心线和包络半径是设计预算；不证明线材弯曲半径、端接或实际面包板端口 |

没有从产品图片比例测量PCB或针座，也没有覆盖厂商原始资产、实物尺寸记录或电气接口。

## 安装基准的分支

0.40主总装把10.3 mm临时解释为“从机器人前脸表面量起”，探头后端Y−81、前端Y−91.3。若实物的10.3实际从PCB面量起，把PCB前表面也放在Y−81，会使PCB与现有前脸实体重叠。

0.41采用另一种**待确认假设**：PCB前表面位于Y−77.5，即前脸内表面Y−78后方0.5 mm。两个探头同步沿+Y内退3.5 mm，经原Ø16.6孔穿出；中心X±13、Z188不变，露出机器人前脸的长度变为6.8 mm。头壳、面板孔、冠盖外形不变，但探头突出量改变，不能说所有外观尺寸都不变。

PCB范围X±22.5、Y−77.5…−75.9、Z178…198；背面元件到Y−71.9。假设探头、PCB、背面器件相加总深度为15.9 mm，**不强行套进来源不确定的15 mm通用标称**。探头与PCB相接只代表候选基准一致，焊脚、真实连接和固定方式未建模。

## 共存结果

前脸内表面到面包板前缘共有8 mm前后空间。候选PCB前间隙0.5＋板厚1.6＋背面4，共占6.1 mm，剩余1.9 mm。若要求至少1 mm名义间距，背面元件预算不得超过4.9 mm；这个上限仍未扣实际公差和变形。

- PCB和4 mm背面占位可与100×85×36面包板静态共存，PCB到前脸0.5 mm、背面到面包板1.9 mm、背面到托盘上缘1 mm。
- 向后预留10 mm接头会侵入面包板8.1 mm，交叠972 mm³，不能按此候选直接装入。
- 顶边12×6×8接头占位可避开面包板；最紧处约为前脸0.5 mm、冠盖0.90 mm。Ø4线束候选沿前上方绕至X54、Y−58的侧边交接区，到面包板1.5 mm、到冠盖约1.60 mm。
- 该路线只到待定交接区，**没有确认与面包板实际接口连通**。端接共有体积归接头，线束包络从接头出口起，不通过忽略碰撞对来放行。

## 拆装条件

静态能放下不等于能把面包板整盘取出。原托盘前缘比面包板前缘多伸出2.5 mm，整盘上提时会扫到候选背面元件和向上接头；不能沿用0.40“已建模部件无阻挡”的结果覆盖新增超声波包络。

主模型的`ElectronicsTray`已增加**前缘让位**：前缘中央宽49 mm、向内2 mm，即X±24.5、Y−72.5…−70.5，去除该处底板和围边。四个固定点、托盘后槽、面包板位置和头部壳体外形保持。主模型只保留采用的几何；旧托盘、后插头等反例由检查脚本临时生成，不留为重复模型对象。

候选拆装次序：

1. 断电并移去冠盖，断开／收置外接线及超声波线束，释放四颗托盘螺钉。
2. 使用前缘让位后的托盘，面包板整组沿+Z上提85 mm；超声波PCB与接头占位可留在前脸位置。保持线束原路径会阻挡，必须先收置。
3. 若要拆超声波，待面包板整盘取出后，释放尚未设计的模块固定件，再将模块向后移11 mm使探头离开前脸孔，随后上提70 mm。

刚性包络检查覆盖整盘连续保守扫掠、超声波后退／上提连续扫掠；圆柱后退沿轴向精确延长，上提采用精确圆柱平移扫掠。保持面包板时先后退超声波会碰撞，是顺序反例。真实固定件、手指、线缆插拔与可抓握位置仍未建模；这不是实物拆装通过。

保存回读、静态和拆装结果见下列正式报告；检查覆盖四个探头分色实体、四处Ø8×90 mm工具杆、整盘和模块的连续扫掠，以及五类新增冲突反例。范围审计逐对象比较0.40：只允许四个探头分色实体内退、托盘前缘让位及四个候选占位新增，其他几何均须保持。

## 文件与复现

- [主总装](../hardware/model/CyberTrack.FCStd)、[总装与检修图纸](../hardware/model/CyberTrack-assembly-and-service.pdf)：第11–12页托盘与拆装、第18页探头、第25页共存候选；I组图卡标注各探头分色对象与未实测模块包络。
- [整机回读](../hardware/model/readback.json)、[超声波集成专项](../hardware/model/ultrasonic-integration-audit.json)、[完整探头检查](../hardware/model/ultrasonic-fit-audit.json)、[托盘专项](../hardware/model/breadboard-fit-audit.json)。
- [0.40→0.41范围审计](../hardware/model/ultrasonic-integration-change-audit.json)：保留头壳、前脸、冠盖、侧耳及后槽的几何比较证据。
- [共存布局](../hardware/model/ultrasonic-coexistence.png)、[侧视](../hardware/model/ultrasonic-side.png)、[整盘取出](../hardware/model/ultrasonic-service.png)。蓝色PCB、橙色背面元件、紫色接头、黄色线束、绿色面包板；侧视隐藏头壳，不是新开孔。
- [正式集成与专项生成脚本](../scripts/ultrasonic_integration.py)，由[整机生成入口](../scripts/build_tank.py)调用；[范围审计入口](../scripts/audit_ultrasonic_change.py)需提供保存的0.40基线。

```sh
PYTHONPATH=/Applications/FreeCAD.app/Contents/Resources/lib /Applications/FreeCAD.app/Contents/Resources/bin/python scripts/build_tank.py --render
```

结论限于候选空间。PCB／探头基准、实际板厚与背面深度、针座方向、接头尺寸、线材弯曲及板端位置仍须确认，模块固定件和手部空间仍待设计。不据此增加GPIO接线、供电或避障行为；制造、声学、RF、电气和实物安装均未验收。

## 0.41 验证与清理

0.41检查：309个几何对象保存回读有效；827对静态布尔检查无超阈值重叠；9组共96个离散维护姿态及既有专项通过。另有整盘／4颗螺钉连续扫掠、4处工具杆、超声波先后退11再上提70的连续扫掠；3个托盘反例及5个超声波集成反例均检出预期阻挡。范围审计确认300个保留对象几何不变，4个探头分色实体内退3.5、托盘仅前缘49×2让位，新增4个候选占位。头壳、前脸、冠盖、四个固定点和后槽保持。

当前图纸与主模型同步，全部对象图卡见第30页系统索引。0.41历史STEP为865实体，体积差约0.258 mm³；当前STEP数据见整机回读。交换格式仍不宣称几何等价，以FCStd为依据。

已清理19个被替代文件（独立U01模型、自动备份、报告、说明、5张视图、旧研究脚本及7张旧头部预览，另含2个已验证输出的自动备份），移除清单与哈希见[清理记录](../hardware/model/ultrasonic-cleanup-audit.json)。原始部件资料、历史范围证据、其他机构研究及并行固件工作保留。
