miclle/cybertrack/docs/breadboard-tray.md

# 0.41 面包板整组浅托盘

**0.55更新：**主线束已改为净径10、托盘下方转向左侧并在X60/Y6/Z194上行交接；原后槽保留但不再承载主线束上行。下文0.41后槽路线和间隙为历史记录，新路径与维护检查见[通道专项](cable-passage.md)。

2026-10-25。用户要求保留现有面包板与 ESP32-S3、扬声器、麦克风、小屏幕的接线，按左右 **100 × 前后85 × 高36 mm** 整组包络规划，保持头部外形，暂不考虑电弧模块。本页替代旧裸板托架、独立扬声器和电弧模块在头舱内的安装说明。

本页保留0.41头部结构记录；0.43主总装保持这些头部几何，底盘增加板卡防脱压框与局部接线空间，见[当前结构](effects-mount.md)与[范围审计](../hardware/model/effect-board-change-audit.json)。

100×85为用户提供的面包板平面尺寸；36为用户批准的规划高度，尚不是包含所有元件、插头和线束的实测总高。模型不虚构组内板卡、屏幕和音频器件位置，也不将原裸ESP32-S3的供应商资料套作现有面包板的安装接口。

0.41已将[超声波向上出线候选](ultrasonic-head.md)合入主模型和PDF，并增加托盘前缘中央49×2 mm让位；四个固定点和后槽保持。取盘前必须断开／收置超声波线束。新增包络及拆装已纳入本版检查，实物接口与模块固定仍待确认。

## 布局与固定

| 项目 | 0.41候选 |
|---|---|
| 整组包络 | `BreadboardEnvelope`；X−50…50、Y−70…15、Z174…210 |
| 浅托盘 | `ElectronicsTray`；主体105×90，内区101×86，单边0.5设计余量 |
| 承托与围边 | 底面Z171.5、承托面Z174，底厚2.5；围边高3，到Z177 |
| 四处侧耳 | 总宽122；孔X±57、Y−40／−5；孔距114×35，通孔Ø3 |
| 支柱与紧固件 | 四柱Ø7与头壳内部融合，上承台Z171.5；4颗M2.5级候选螺钉及嵌件，非采购定型 |
| 前缘让位 | 中央宽49、向内深2，X±24.5、Y−72.5…−70.5；去除底板及围边，避开超声波模块的上提扫掠 |
| 后部走线槽 | 宽10，X±5、Y1…17.5，向后开口；槽局部进入板底投影，其他底面承托保留 |
| 头端电源线 | Ø6假设包络，从颈部经(0,6,170)、(0,19,170)转到(0,19,190)，由板后侧进入组件 |
| 外形 | 冠盖、前脸、侧甲及头壳外部曲面保持；沿用0.40内部四柱，0.41头壳完整几何不变；探头突出量改变 |

旧小托架、排母、防脱压架、四个托板旧固定点、独立扬声器和前上方电子占位撤出当前模型；组内设备统一由完整包络表示。0.40当时移除了两个电弧圆柱；0.42本体已转至背包外侧机械夹持区。冠盖脊翼及非通电标识保留外观，不表示电弧功能已集成。

浅边只限制横向滑动。板底厚度与可接触边缘尚未知，不增加可能压住元件／跳线的假定压片。两处底座边缘防脱固定需在实物确认后细化；当前不能据此放行振动、翻转或行走试验。托盘材料、柱根强度、打印方向、嵌件和螺钉有效啮合未验证。

## 拆装顺序

1. 断电，卸4颗冠盖螺钉；整体冠盖沿+Z上取65 mm。
2. 断开并收置超声波及其他对外线束，保留面包板内部跳线；实际插头和松弛长度待试装。附近液管按既有整机维护前置条件收置。
3. 从板外四处侧耳上方操作，卸下4颗托盘螺钉；各沿+Z退出20 mm。
4. 承托托盘，连面包板整组沿+Z上提85 mm。不要通过跳线提拉；实际抓握空间另验。
5. 装回时先检查后槽线束没有夹在承台、孔位或冠盖分缝中，固定托盘后再接线并合盖。

上提路径不要求把组内元件逐一拆下，但不承诺对外线束不断开即可整盘取出。原裸板的USB拔插和天线审查区已撤销，不能沿用它们的通过结论；屏幕观察、麦克风收音、扬声器出声、USB插拔和整机RF需要现有实物布局输入。

## 几何证据与交付物

- [整机保存回读](../hardware/model/readback.json)：对象有效性、原生保存一致性、STEP交换检查、整机静态及既有维护回归。
- [浅托盘专项](../hardware/model/breadboard-fit-audit.json)：托盘／整组静态检查；整盘向上85 mm的连续保守扫掠；4颗螺钉连续退出；4处Ø8×90直工具杆；承台接触与3个反例。
- [0.41范围与外形核对](../hardware/model/ultrasonic-integration-change-audit.json)：逐对象比较0.40，头壳完整几何保持；[0.40历史范围审计](../hardware/model/breadboard-change-audit.json)保留原内部支柱变更依据。
- [布局](../hardware/model/breadboard-layout.png)、[俯视](../hardware/model/breadboard-top.png)、[托盘](../hardware/model/breadboard-tray.png)、[工具](../hardware/model/breadboard-access.png)、[上提](../hardware/model/breadboard-service.png)。
- [图纸来源与检查记录](../hardware/model/breadboard-drawing-audit.json)：现行修订号、来源哈希及视觉检查记录；[全对象覆盖记录](../hardware/model/assembly-annotation-audit.json)包含逐项页码。
- [总装及检修PDF](../hardware/model/CyberTrack-assembly-and-service.pdf)：第6页冠盖／托盘孔位、第10页面包板布局、第11页浅托盘、第12页整盘拆装；第18页探头、第25页超声波共存；H组图卡逐项标注面包板和托盘紧固关系。

0.40历史结果：305个几何对象回读有效；815对静态检查无超过0.01 mm³重叠；9组维护共96个离散姿态通过，另有整盘及4颗螺钉连续扫掠、4处工具杆与3个反例通过。289个保留对象几何不变；头壳差异局限于内部支柱，外部曲面差异为0。

整组包络到冠盖名义最小净距4 mm。后槽线束到头壳约1.16、到托盘约2.22 mm。后槽线束与面包板最小1 mm；其直角折线路径仅用于空间分配，不证明真实线缆弯曲或接头适配。连续扫掠使用包含全部规定姿态的保守棱柱并集；通过代表该刚性运动不穿透保留几何。工具只检查直杆，不含手柄、手指或扭矩操作。

反例要求保留冠盖或托盘螺钉时检出阻挡，以及组件高度增加5 mm时检出冠盖干涉。几何结果不能代替实物适配、制造公差、材料强度、线束应力释放、防脱保持、声学、RF、电气或儿童使用验收。

0.40历史STEP回读实体数865、包围盒吻合；体积差约0.258 mm³，超过0.01 mm³严格比较阈值，因此仍仅用于布局交换，以FCStd为几何依据。

## 0.41 验证与清理

0.41检查：309个几何对象保存回读有效；827对静态布尔检查无超阈值重叠；9组共96个离散维护姿态及既有专项通过。另有整盘／4颗螺钉连续扫掠、4处工具杆、超声波先后退11再上提70的连续扫掠；3个托盘反例及5个超声波集成反例均检出预期阻挡。范围审计确认300个保留对象几何不变，4个探头分色实体内退3.5、托盘仅前缘49×2让位，新增4个候选占位。头壳、前脸、冠盖、四个固定点和后槽保持。

当前图纸与主模型同步，原32页中的重复展示／历史对比已合并清理，逐项装配图卡按第30页索引查阅。0.41历史STEP为865实体，体积差约0.258 mm³；当前STEP数据见整机回读。交换格式仍不宣称几何等价，以FCStd为依据。

已清理19个被替代文件（独立U01模型、自动备份、报告、说明、5张视图、旧研究脚本及7张旧头部预览，另含2个已验证输出的自动备份），移除清单与哈希见[清理记录](../hardware/model/ultrasonic-cleanup-audit.json)。原始部件资料、历史范围证据、其他机构研究及并行固件工作保留。
