miclle/cybertrack/docs/style-direction.md

# CyberTrack 造型方向 0.10

2026-10-24 更新。用户明确纠正：玩具只使用履带，不必具有传统坦克外形；喷水、泡泡、语音等有个性的功能应共同形成鲜明角色。**当前采用履带交互机器人方向**，不再用传统炮塔、宽甲板和外伸枪管组织整机。

## 当前主参考

[用户第五张机甲参考](https://www.pinterest.com/pin/464855992806179472/)在浏览器中已查看：蓝灰色大头舱、橙色机械节点、外露关节和独立行走机构形成角色轮廓。Pin 页面显示发布者 Franky Von Reichenbach，但未核实原始作者身份。只采纳视觉语言，未下载原图、复制品牌或导入原作品模型。

0.3 已建立独立头舱、前倾固定颈架、双履带底座与后背双液体舱。用户认为仍偏呆萌，要求头部、机械连接和底座具有更强的机甲层次。0.4 按此反馈重建三个区域的实际几何，保留功能布局与动力基准。

## 0.5 后部统一与实测电源布局

用户认可 0.4 的前部方向，本轮主要深化背部。后脑采用六边内嵌框、中央脊甲、分体上护甲和封闭浅槽饰条。两个液体舱纳入共用切面背包，色彩缩减为维护盖和背部小识别条；斜面底座后护甲、中央脊梁、内凹饰板延续前胸的造型语言。0.15 按用户确认将泡泡枪放到正面看左侧，水枪保持画面右侧原位；两枪口前缘齐平，泡泡枪略低。0.18采用无分缝整体圆环＋后端阶梯槽，取消方框与后跨壳压盖；两枪同为上仰5°候选，水枪旋转后前移10、下移4 mm避让头壳，胶辅助固定。0.19移除旧后部滴液唇并补回其切槽；0.20补回旧出口 Ø31 大圆孔，仅留 Ø9 液管穿板孔候选，恢复后护甲大面。0.21取消后底座单侧饰板及三条盲槽、补回凹槽，使左右切面对称，保留实际需要的单侧管孔；泡泡液舱旧大孔同步收为Ø9候选。密封、前部滴液及湿舱排液仍待验证。

用户同时提供充电宝实测外形 **120 × 73 × 31.5 mm**，旧前下方假设舱放不下。用户进一步说明充电宝较重，0.5 因而采用前下方平放：120 mm 横向、73 mm 前后、31.5 mm 高，包络中心降到 Z=48.75 mm。两侧履带、电机及连接件分别整体外移 14 mm，为加宽前舱留出空间；两个液体区维持较低位置，继续纳入紧凑的共用背包。实测尺寸与布局假设分别记录，不以外观统一推导实物装入、重心稳定或液体隔离通过。

## 0.6 收紧前舱与强化头身比例

用户认可充电宝低位平放位置，但认为前舱宽大、头部偏小。本轮保留电源完整包络、两侧动力和后部液体布局；把前舱的音频占位移入头舱，为前部顶盖降低 20 mm 留出空间。前舱下部继续容纳 120 mm 宽的充电宝，上半部两侧向内切斜，前端采用低矮分体护甲，肩梁与镂空侧框沿新折面重建。

头壳最大宽度从 136 增至 164 mm，前端向前延伸 16 mm，头颈整体下沉 4 mm；同步重做宽前脸、侧面太阳穴护板及后脑分层。探头与耳部圆件保留直径，扩大头盔体量而不放大拟人眼睛。头部侧舱最大宽度约 179 mm，对应 132 mm 的前舱下部宽度，改变头轻底重的视觉比例。音频与主控的内部占位分别保留原尺寸，器件和声学仍待实测。

## 0.7 顶部装甲起伏与侧面叠层

保持 0.6 头身比例、前脸位置与低位电源布局。原有大面积平顶改以中央隆起检修装甲、低脊、左右外倾分片甲和后部错层饰片组织高低关系；分缝露出下层头壳，后掠脊翼继续控制最高点。太阳穴增加上、下叠层护片，原有暗色侧板从中露出；耳舱增加半环外护弧，形成护板、圆环、内芯的深浅关系。新细节控制在原有头部宽度及整机最高点以内，未扩张整机包络。

0.8 已建立整体冠盖上取方式，装甲连接工艺与密封仍待细化；后部饰片具有封闭底衬，不据此认定散热效果。

## 0.10 顶部双效果位置

将两条后掠脊翼拓宽为深色切面护框，顶部内凹槽配浅色封闭衬面、前斜面橙色条与后端橙色标识，让两处效果位置在外观上可辨认。保留原最高点、头身比例及低位电源，当时内部 Ø20 × 80 mm 模块占位保持原位（0.11.1 已按最新输入改为 Ø25.5 × 70 mm，0.11.2 已内移／下移解决 CAD 干涉，外轮廓不变）；新增几何归入冠盖维护组。槽及标识仅用于被动造型，没有电极、高压接线或驱动设计。

## 前部造型语言

- **头部**：壳体由多个切角截面连接成形，顶冠与下颌收窄；外层折线眉甲、六边内框、后退的传感器面板形成深度。缩小暗色探头、取消亮色圆眼圈，0.12 将完整发射枪移至颈架左侧、封回原喷口，减少眼睛与嘴的拟人表情。颊甲、侧面护罩、阶梯圆环和条孔内芯共同形成机械层次。
- **颈部**：保留头部下方空间，露出前倾开窗承力板、薄外层加强板、层间连接柱、横梁轴套及后斜撑。全部是固定几何，没有增加动作轴或推杆采购项。
- **底座**：保留中央设备分仓，外围采用切角轮廓、斜面肩梁、镂空侧框、六边胸部格栅和左右分体护甲；向履带基座收拢，延续头部折面语言。
- **轮廓与配色**：低后掠脊翼替代竖起双角，蓝灰色压暗，橙色集中在连接节点和识别条；后背保留液体区分色。

参考图中的双足、手臂及动作自由度未被引入。

## 功能驱动的造型

- **嵌入式双探头面板**对应 P04 超声波模块的候选位置，以窄深色面板代替发光大圆眼。用户于 2026-10-24 提供探头 Ø16、双圆柱总宽 42、离面板高 10.3 mm，按外沿总宽推导中心距 26 mm；0.26 已替换原中心距 58 mm 的造型占位，整体居中并把状态条移至探头上方；双孔 Ø16.6 为候选。离面板高度暂按前脸外表面解释，实物基准、安装孔径与整板形式待确认，见[尺寸记录](../hardware/components/ultrasonic/README.md)；不是摄像头或屏幕需求。
- **颈架左侧水枪**按实测总尺寸在 0.12 放入头舱下方，保持向前脉冲喷水；原前脸位置存在干涉，旧短喷口取消。软管候选已绕开停止按钮，外径与弯曲仍待实测；0.12 整机向前增加 10.5 mm；0.13 为压盖和尾线再前移 12 mm、外移 3 mm，现长 225 mm，外壳比例及其他设备位置不变。
- **头舱音频区域与两侧护罩**表达语音交流功能，实际器件及数量待选，不因两个侧面外观重复购买硬件。
- **共用背包内的双侧液体舱**分别表达喷水与泡泡液体区，泡泡从前部圆形枪口排出；0.36采用两只150 mL、Ø48.8×114含盖的成品瓶完整包络；90 mm低位护舱仅包住下部，顶部包络外露30 mm，后侧留抓取与绑带操作空间；水枪与泡泡枪主体保持前置。瓶肩、瓶盖接口及实物适配仍待确认。
- **低位平放电源区**按实测外形在前下方布置，音频区已移入头舱前部，主控等电子区原位保留。重量、满／空液体状态、前移后的整机质心及稳定性需要验证。
- **后掠脊翼效果位**通过护框、封闭凹槽和橙色标识表达顶部双效果位置；内部模块为暂定圆柱包络。两者均为被动占位，没有电极、高压接线或驱动，未实现放电功能。
- **外露颈架**当前是固定结构，MG90S 用途仍未确定，不能由圆形端盖推断可转动或舵机承载能力。

主色为蓝灰、深灰及橙色，液体舱用青色和紫色区分。移除 0.2 的宽肩甲板、前伸八角喷水头、外侧护甲及传统车体分层；原有履带、电机、轴、联轴器与安装件保持各侧尺度及内部相对位置，左右分别整体沿 X 外移 14 mm。

## 前两轮参考记录

以下四张均已在浏览器逐张查看，作为探索记录保留。它们不再把整机限定为工程车或坦克，也没有提供本项目的接口尺寸。

| 参考 | 曾采用的视觉要素 | 当前状态 |
|---|---|---|
| [黑色履带概念车](https://www.pinterest.com/pin/668714244706611936/) | 深色整块舱与集中前脸 | 保留深色前脸语言，弃用车体轮廓 |
| [がとりんぐ三等兵的履带运输车](https://www.pinterest.com/pin/614952524126964374/) | 分色、外露机械、模块组合 | 保留模块分区思路 |
| [ZUGV-1，Jinyi Zhu](https://www.pinterest.com/pin/563442603391992902/) | 紧凑工程车与侧护甲 | 0.2 曾使用；用户认为仍像传统坦克，0.3 已替换 |
| [An Improbable Future 概念车](https://www.pinterest.com/pin/554294666652569623/) | 米白／橙色舱体、顶部模块；页面标注 AI modified | 保留强调色思路，不沿用其舱体布局 |

0.7 造型已经提交保留。0.8 仅在原外形内增加检修分缝、紧固孔、承托及通路；头身比例、整机外包络及电源位置保持不变，详见[装配候选](assembly.md)。

当前模型、尺寸及验证边界见[模型说明](../hardware/model/README.md)。静态几何检查不能证明动态净空、实际模块适配、供电、液体、电气或使用安全。

0.27明确后护甲本体的X=0镜像基准：除实际单侧液管孔外，轮廓、斜面及中央脊甲座均镜像对称。图纸第22页显示单体，避免相邻部件或观察角度影响判断。

0.28将两路自吸管统一改为顶部插入、经侧面连接前枪，封回全部后护甲及舱侧管孔。后护甲轮廓、斜面和中央脊甲座成为完整镜像对称实体；顶部错层管路为功能候选，固定、防磨与实物外观仍待试配。此前“保留单侧液管孔”的描述为历史版本。
