miclle/cybertrack/docs/mos-bench.md

# ESP32-S3 与 MOS 模块台架测试

更新：2026-10-24。用户要求记录降压模块并开始 ESP32 控制大功率 MOS 模块的测试。P12 降压板已有用户报告的 5 V 输入／3.7 V 输出，原图、接线标识、选压说明与证据边界见[部件记录](../hardware/components/dc-dc-buck/README.md)。

## 当前状态

- 测试对象为采购 P01 双 MOS 成品开关模块，不能直接按裸 MOS 管栅极接线。
- 已准备[独立本地串口台架工程](../firmware/esp32-mos-bench/README.md)：临时 GPIO4，高电平触发，当前 0.1.1 单次 5000 ms（用户要求从 1 秒延长）；默认关闭，BOOT／s 停止，不接网络，不自动重试。
- 主机策略测试和 ESP-IDF 编译已通过；用户确认引脚空接后已烧录 MOS 镜像并通过写入哈希校验。已读到 MOS READY，并在引脚空接下完成一次 a／g、到期关闭及 s 回执；控制端电平已有用户观察；用户已确认本次 5 秒试喷正常喷水并自动停止；后续 BOOT 带载测试中按下立即停喷、松开不恢复，功率参数与保护仍待验证。原电机台架源码与历史记录保留。
- DF-MD 的既有记录包含稳压通路异常，保持断电、断线。MOS 测试不能借用 DF-MD 的输出电源或共用其控制接线。
- 当前实际顺序为 **5 V→P01 MOS→P12 降压至 3.7 V→水枪**，由用户澄清。P01 位于 5 V 侧，处于商家标称 5–36 V 范围内；此前 MOS 位于 3.7 V 侧的假设撤销。本次喷水及自动停止已获用户确认；供电电气参数、关断延迟与其他工况仍待验证。

## 已有接口证据与开始条件

1. 用户随后提供[实物正反面照片](../hardware/components/jz-mos/README.md)，已确认板背 JZ-MOS、VIN+／VIN−／VOUT+／VOUT− 和控制端 TRIG/PWM／GND，补齐此前商品截图缺失的端子定义。资料写双 MOS 并联，是一路开关。照片走线与低侧开关相符，实际通断、感性负载保护和后置降压板的启动／关断仍待核实。
2. 用户已选择 3.7 V 水枪为首测负载。先做无负载 GPIO 测量，再按实物接口和保护条件接水枪，不以 3.7 V 读数代替开关适配。
3. 用户已确认 ESP32 与 DF-MD 断开，ESP32 引脚无任何连接线；本次在该状态下复用 GPIO4 并烧录。后续接线或重连时重新核对当时的负载供电状态。

## 分阶段操作

### A. ESP32 无负载控制信号

只保留主控 COM USB，GPIO4 暂不接 MOS；降压板 3.7 V 不接 ESP32 电源或 GPIO。烧录后取得当前版本 `MOS READY 0.1.1`，发送 s 取得 `MOS DISARMED outputs=OFF`。测 GPIO4 对 ESP32 GND 的静态低电平。

在稳定串口上先单独 a，收到 ARMED 后 3 秒内单独 g：输出一次约 3.3 V 高电平，正常调度下 5 秒后回到低电平（0.1.1；此前 0.1.0 为 1 秒）。记录启动前、动作期间、结束后的读数和回执。普通万用表不能验证实际脉宽；读不到不能直接判 GPIO 故障，不自动延长或重复。s／BOOT 停止、松开不恢复另行验证。串口回执不是实际电压或电气时序证据。

### B. 当前实际接线：MOS 在降压板之前

用户澄清实际为 5 V→MOS→DC-DC 降至 3.7 V，并确认水枪已接在降压输出、供水准备好。此前建议的“降压板→MOS→水枪”顺序不适用于本轮，不要求把 MOS 输入改成 3.7 V。下面按丝印核对：

| 来源 | 接到 |
|---|---|
| 5 V 电源正极／负极 | MOS VIN+／VIN− |
| ESP32 GPIO4／GND | MOS TRIG/PWM／控制 GND |
| MOS VOUT+ | 降压板 IN+ |
| MOS VOUT− | 降压板 GND |
| 降压板 VO+（已调至 3.7 V）／GND | 水枪电源正极／负极 |

按照片推断为低侧开关。降压板 GND 和水枪负极位于 MOS 输出侧，**不能再连接 ESP32 GND、VIN−或另一路电源负极**，否则可能绕过开关；ESP32 GND 只接控制地。负载电流不经过主控。所有焊接／改线在断电下进行。

用户没有 100 Ω 电阻并明确要求直接测试，因此不再安排阻性测试负载，也不把购置电阻作为继续试喷的条件。水枪固定、供水就绪，电子板与水隔离；保留独立拔断 5 V 的手段。控制高电平窗口不等于喷水时长：降压板启动需要时间，输入／输出电容可能使关断后仍有短时输出；记录真实喷水和停止表现。感性负载保护、启动电流、温升与长时可靠性仍未验收。本轮不连接高压效果模块。

### C. 实物记录

逐次记录实际负载、接线、供电、电流／温升观测、GPIO 高低读数、负载两端电压、导通及停止表现。追加负载供电前先确认主控已启动且关闭；先切断负载供电，再复位、拔 USB、重连串口或烧录。内部下拉不保证启动／复位／失电关闭，BOOT 和软件期限不替代独立断电。

| 检查项 | 当前结果 |
|---|---|
| P12 输入 5 V、输出 3.7 V | 用户已报告；负载工况未提供 |
| ESP32 GPIO4 低／高／恢复低 | 用户报告接入 MOS 控制端后静态 0 V；一次 1 秒命令及关闭回执已取得；用户观察到约 3 点几伏，并确认结束回到 0 V；仅完成本工况下控制电平观察 |
| MOS 默认关断、导通压降、截止行为 | 用户确认接回 5 V 后保持停止、5 秒试喷结束后自动停止；压降及复位／失电边界未验 |
| P01 的供电顺序 | 已澄清为 MOS 5 V 输入、后置降压至 3.7 V；此前 3.7 V 直供假设撤销 |
| 水枪／泡泡机启动、停止、供电稳定性 | 用户确认本次 5 秒正常喷水并自动停止，单次功能检查通过；1 秒结果未单独确认，泡泡机未测 |

不据程序编译、串口回执或单次电压读数关闭 V04／V05／V06、P2 或 F2b。

## 2026-10-24 控制端接线后的首次 1 秒测试

用户确认 GPIO4→TRIG/PWM、GND 两根控制线已接好，MOS 功率输入未供电、水枪未连接；TRIG/PWM 对 GND 静态实测 0 V，并授权一次 1 秒测试。

16:16:29（Asia/Shanghai）起复用现有 `cybertrack-mos` 串口，未重新打开串口、复位或烧录。s→DISARMED，a→ARMED，仅发送一次 g，收到 DISARMED，追加 s 再次获得 `MOS DISARMED outputs=OFF`。固件配置为持续高电平 1000 ms；电脑观察命令至关闭回执约 1050.8 ms，含通信／日志读取延迟，不是实测电气脉宽。

记录：本机 `build/mos-bench-private/control-signal-20261024-161629.json`。用户随后反馈测试期间电压升至“3 点几伏”，记录为近似观察，不补定为精确 3.3 V，也不作为波形／脉宽测量；用户随后确认结束回到 0 V，完成该次 0 V→约 3 点几伏→0 V 的观察；指示灯未报告；没有重试，没有接通功率输入或水枪，不据回执认定 MOS 功率开关或水枪验证通过。

## 历史方案：MOS 功率输入静态检查（已被后置降压拓扑替代，不执行）

控制信号在 MOS 功率输入未供电、水枪断开的条件下已完成用户电压观察；不等于 MOS 带电或带载验证。用户要求继续，下一步保持水枪与 VOUT+／VOUT− 断开，仅核对 3.7 V 输入后的静态状态。

降压模块先断电再接线：P12 VO+→MOS VIN+，P12 GND→MOS VIN−，保留 GPIO4→TRIG/PWM 及 ESP32 GND→控制 GND。避免带电改线；若焊接或接线需要断开主控，先在功率电源断开下恢复 USB／串口并确认关闭，再接通降压板输入。功率电源最后接通，3.7 V 不接 ESP32 3V3。

在模块端测 VIN+ 对 VIN−（预期接近先前调好的 3.7 V）和 TRIG/PWM 对控制 GND（未发动作时预期接近 0 V）；异常掉压、发热或控制端电压异常时先切断降压板输入。这是在低于商家 5 V 下限的探索，不改写额定范围。当前尚无这一步接线或测量结果，不发送新的 g 动作。

开关输出在无负载时可能悬空，不能把空载输出电压当作可靠的导通／截止证据。后续可先使用已知阻性测试负载，例如 100 Ω、至少 0.5 W 的电阻跨 VOUT+／VOUT−：3.7 V 时理论电流约 37 mA、功率约 0.137 W；这是测试设计值，未确认用户持有或执行。接水枪前仍需核对感性负载保护与实际电源能力。

## 2026-10-24 MOS 上电后的单次命令

用户随后报告“MOS 已接通 5V”，说明没有 100 Ω 电阻并要求直接测试。按用户要求省略阻性负载步骤，不把购买／增加电阻作为继续测试的必需条件。此处 5 V 是用户最新报告，未取得 MOS VIN 的独立实测读数，不能仍按此前 3.7 V 计划记录为已执行。水枪沿用最近一次明确确认的未连接状态，用户没有报告新接入；执行前已说明本轮只测上电 MOS，若 VIN 为 5 V，接入 3.7 V 水枪前须断电改用相应供电，MOS 本身不降压。

16:21:48（Asia/Shanghai）起复用现有串口，s→DISARMED、a→ARMED，仅发送一次 g（固件 1000 ms），收到 DISARMED，追加 s 再次确认软件关闭。未重新打开串口、复位、烧录或自动重试。电脑观察 g 至关闭回执约 1031.2 ms，含通信与读取延迟，不是实测电气脉宽。

本机记录：`build/mos-bench-private/powered-mos-20261024-162148.json`。指示灯是否亮后熄灭等待用户观察，实际输出导通／截止与水枪启停仍未验证。未据命令回执认定功率开关通过。

## 2026-10-24 后置降压澄清与首次水枪命令

用户澄清降压板接在 MOS 后，随后明确确认水枪已经接在 3.7 V 输出、供水准备好，并授权一次 1 秒试喷。因此本轮实际为 5 V→MOS→DC-DC→3.7 V 水枪；此前担心水枪直接承受 MOS 的 5 V 输出不适用于这条接线。保留此前单次命令记录，但不将其负载状态推定为新的水枪结果。

16:23:20（Asia/Shanghai）起复用持久串口，s→DISARMED、a→ARMED，仅发送一次 g（0.1.0，1000 ms），收到到期 DISARMED，追加 s 再次取得关闭回执。电脑观察 g 至回执约 1033.5 ms，含通信／日志读取延迟，不是实际 GPIO 脉宽或喷水时间。未重连、复位或重复动作。记录：本机 `build/mos-bench-private/water-gun-20261024-162320.json`。

用户随后反馈“1s 太短，可以 5s”，未明确描述喷水／停止结果，不据此认定试喷通过。0.1.1 将单次期限改为 5000 ms，保留 3 秒使能、单次触发、1 秒冷却、s／BOOT 停止。用户已确认 MOS 的 5 V 断开、ESP32 USB 保持连接，允许更新；烧录和启动结果另记，接回供电后才执行 5 秒动作。

## 2026-10-24 5 秒版本与一次试喷命令

0.1.1 主机 ASan／UBSan 与 ESP-IDF 编译通过；在用户确认 MOS 5 V 断开下烧录并校验，串口确认 `pulse=5000ms` 和关闭回执，详见[工程记录](../firmware/esp32-mos-bench/README.md)。首次端口占用已解决，没有在供电接回后复位或重连。

用户确认 5 V 已接回、水枪保持停止、供水就绪并授权一次 5 秒试喷。16:27:40（Asia/Shanghai）起复用连接完成 s→DISARMED、a→ARMED、一次 g→到期 DISARMED、s→DISARMED。电脑观察动作命令至回执约 5049.5 ms，非实测电气或机械时间。本机日志：`build/mos-bench-private/water-gun-5s-20261024-162740.json`。

用户随后明确反馈：“水枪正常喷水，5 秒结束后也自动停止了”。结合本次命令／关闭回执，记录为本接线和固件配置下的单次喷水及自动停止功能检查通过。本轮不再自动触发；带载输出电压、电流、温升和停止延迟仍未测量，不代替 MOS 失电／复位关断或独立供能切断验收。

### 本次已确认结果

| 项目 | 结果与依据 |
|---|---|
| 测试日期／命令时间 | 2026-10-24 16:27:40（Asia/Shanghai）；用户在本次对话随后确认物理结果 |
| 实际供电顺序 | 用户确认 5 V→P01 JZ-MOS→P12 DC-DC 降至 3.7 V→水枪 |
| 控制程序 | ESP32-S3，0.1.1-mos-bench；GPIO4 持续高电平，单次软件窗口 5000 ms |
| 初始状态 | 用户确认供水就绪，接回 5 V 后水枪保持停止 |
| 喷水 | 用户现场观察：正常喷水 |
| 到期停止 | 用户现场观察：5 秒窗口结束后自动停止 |
| 软件证据 | 单次 g 后取得 DISARMED，追加 s 再取得关闭回执；没有循环或重试 |
| 结论 | 本次单次喷水／到期自动停止功能检查通过；V05 部分完成 |

电压 3.7 V 来自此前用户降压读数，并非本次带载电压曲线；5000 ms 是固件控制窗口，并非精密测得的喷水持续时间。未测启动／运行电流、掉压／纹波、温升、反复启停寿命、关断残余输出／滴液、当时尚未验证的 BOOT／s 带载提前停止、复位／失电与独立切断；后续 BOOT 子项结果见下节。本次不关闭完整 V04／V05、P2、F2b 或整机电气／安全验收，不扩展到泡泡机。

## 2026-10-24 BOOT 带载提前停止

沿用 ESP32-S3 `0.1.1-mos-bench`、GPIO4 高电平触发及 5 V→P01 JZ-MOS→P12 降压至 3.7 V→水枪的接线。复用已建立的串口，取得新的关闭回执后，按用户要求执行一次 5000 ms 上限的喷水命令，由用户在喷水过程中按 BOOT。本次未烧录、重连或复位，也没有自动重试。

测试脚本于 16:49:02.970（Asia/Shanghai）开始，预留 10 秒准备；约 16:49:13.062 发送唯一一次 g，约 16:49:15.477 收到 `MOS DISARMED outputs=OFF BOOT held`，早于 5 秒期限。随后发送 s，再次收到 `MOS DISARMED outputs=OFF`。原始命令与回执保存在本机忽略目录 `build/mos-bench-private/boot-stop-20261024-164918.json`，其中 physical_result 为采集时的待确认状态；现场结论由用户随后在本次对话中补充。

用户明确反馈：“按下 BOOT 就立即停止喷水了，松开后也没有恢复”。据现场观察和 BOOT 关闭回执，**本次带载 BOOT 提前停止、松开不自动恢复功能检查通过**。

| 检查项 | 本次结果 |
|---|---|
| 喷水过程中按 BOOT | 用户观察到立即停止喷水；固件报告 `BOOT held` 并关闭输出 |
| 松开 BOOT | 用户观察到没有自行恢复喷水 |
| 最终软件状态 | 追加 s 收到 DISARMED／outputs=OFF |
| 时间边界 | g 至 BOOT 关闭回执约 2415.5 ms，包含喷水等待、人手按键及串口开销；不是按键到停止的延迟 |
| 验证状态 | V04／V05 的本次带载 BOOT 子项通过，整体仍部分完成 |

“立即”是用户现场观察，未用仪器测量按键、电气关断和水流停止之间的延迟，不能换算为毫秒保证。s 在本轮用于关闭后的状态确认，没有验证 s 带载提前停止。重复性、复位／失电、独立供能切断、带载电流／电压、温升及残液／滴液仍待验证。
