miclle/cybertrack/firmware/BOARD-INFO.md

# 开发板资料最小清单（Q06 / F2b）

更新：2026-10-23。主控为[采购记录 P07](../hardware/procurement.md)的天猫 SKU 5996933277834：ESP32-S3 N16R8、Type-C 接口、已焊排针。用户补充资料已读取，完整结果见[COREBOARD 板卡记录](../hardware/components/ESP32-S3-N16R8/README.md)。本文件只保留当前进度与剩余输入，不再把已有原理图、引脚图和尺寸图列为缺失。

## 已收到并完成资料回读

| 项目 | 已有证据 | 后续边界 |
|---|---|---|
| 板级原理图 | COREBOARD／V1.4 图纸与实物照片均已读取；实物稳压器为 1117 3.3V 标记，与图纸 U3 不同 | 仍不能认定完全匹配 V1.4；PCB 版号和器件／焊装待核 |
| 引脚 | J1／J2 各 22 针表；GPIO35–37 为 N16R8 八线 PSRAM 占用 | 不是 CyberTrack 外设 GPIO 分配表 |
| 存储 | ROM 查询识别 ESP32-S3 rev v0.2、16 MB Flash、封装内 8 MB PSRAM（AP_3v3）；Flash eFuse 为 quad／3.3 V | ESP-IDF v5.5.1、Octal 40 MHz 初始化及 6 MiB 六模式读写通过；非全容量／长时测试 |
| 下载／复位 | USB 与 COM 分别枚举；COM 通过 no-stub ROM flash-id 查询及自动复位流程 | 已经 COM 115200 烧录并核验哈希、复位启动通过；高速读取曾报串口数据错误 |
| 尺寸 | 用户实测含天线总长 63.6 × 板宽 28.2 × 焊针后总高度 13.2 mm；图纸尺寸另存 | 固定方式、孔径、USB 插头与射频净空仍待验证 |

## 第一批：实物匹配与无负载启动

| 资料／核对 | 最少内容 | 用于确定 |
|---|---|---|
| 完整板名与正反面 | 正反面已收，罩体见 S3 N16R8、背面 ESP32-S3，未见明确 PCB 修订号；可见 PCB 天线与同轴座 | 继续核对完整板级版本及射频通路，不能由通用标记认定原厂 WROOM 身份 |
| 焊装选项 | GPIO3 的 USB-OTG／USB-JTAG 支路、IN-OUT 旁路、稳压与串口桥器件标识 | 启动默认状态、供电与反灌路径 |
| 主控供电与 USB | 本次仅 USB 连接；两接口枚举成功，COM 初次未枚举、翻转重插后成功 | 核对接触／方向、供电器件与旁路实际装配；枚举不代表电源带载通过 |
| 存储与启动检测 | ROM 查询与无负载固件烧录、启动和 PSRAM 读写已完成；未写 eFuse；详见[实物核对](../hardware/components/ESP32-S3-N16R8/physical-verification.md) | 无负载工程通过；后续验证完整运行层、停止输入、调度与看门狗 |

原理图、排针和标称存储资料已足以开展板级适配准备；实物匹配、本地停止与验证仍是 F2b 的退出条件。无负载工程固定 ESP-IDF v5.5.1，项目外设 GPIO 尚未分配，执行器能力全零。

## 第二批：开启真实本地停止输入前

| 资料 | 最少内容 | 解锁的工作 |
|---|---|---|
| 本地使能与停止器件 | 准备用板载按键还是外接按键；已有器件型号／照片；尚未决定则注明 | 按键资源、输入极性和去抖设计；不默认占用启动按键 |
| 独立停止方案 | 是否已有切断执行器供能的开关／电路，其型号与额定资料；仅软件按键不等于供能切断 | 停止接口与默认关闭的实物验收计划 |
| 主控供电与当前连接 | 计划用哪个接口供电；目前是否接了扩展板或其他外设，分别是什么；若未连接则注明 | 避免供电冲突和已占用接口误分配 |

不要求用户自行指定 GPIO。依据已整理的排针与保留资源，结合实物焊装和外围器件形成项目 GPIO 分配表。

## 可以稍后补，不阻塞无音频启动

麦克风、功放、扬声器的具体型号；开发板三维外形已实测，安装方式、USB 插头与天线净空用于后续机械适配。电机、MOS、继电器及液体模块资料用于 F3 单模块台架，不要求为了建立无负载启动工程一次补齐全部 BOM。

本板图纸已区分 CH343P 桥接 USB1 与原生 USB2；下载流程另参考[乐鑫串口连接说明](https://docs.espressif.com/projects/esp-idf/en/stable/esp32s3/get-started/establish-serial-connection.html)。不根据 USB 接口外形或通用芯片资料推定这块板的走线。

## 收到资料后的交付顺序

1. 用实物与已整理的图纸核对版本、焊装和接口，补齐版本化板卡记录。
2. 已固定无负载工程的 ESP-IDF v5.5.1、Flash DIO／PSRAM Octal 40 MHz 及 COM 下载配置；继续保留执行器能力全零。
3. 实现真实时钟、输入、输出关断和看门狗适配，检查构建内存占用。
4. 经授权的实物验证记录复位／启动默认状态、停止输入、实际任务延迟、看门狗行为和关断结果；通过后再进入各自负载台架。

不要把主机运行层检查或成功编译记为实物停止、电气或使用安全验收。
