miclle/cybertrack/hardware/schematic/CyberTrack-schematic.pdf

1 | 2 | 3 | 4 | 5 | 6 | 7 | 8

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
Size: A3 | Rev: A1 | F Date: 2026-10-26
KiCad E.D.A. 10.0.7 | Id: 1/5

### Title: CyberTrack / Power and isolation

File: CyberTrack.kicad_sch

Sheet: /

CyberTrack

MODULE INTERCONNECTION SCHEMATIC - NOT FOR FABRICATION

Retain existing ESP32-S3 board; TBD items are unresolved

Pin IDs identify signals, NOT physical header positions

ESP32-S3 and BOOT 文件: control.kicad_sch | Reserved ignition LV 文件: ignition-lv.kicad_sch Water and bubbles 文件: effects.kicad_sch Motor drive 文件: drive.kicad_sch

1

1

1 | 2

2 F6

TBD

1

GND GND

IN+ IN+ | OUT+ | OUT+ REQ_A REQ_A | REQ_B REQ_B

U3

MASTER POWER / TBD

A

A | B

B SW1

MASTER REQUEST / CONTACTS TBD

1

1 | 2

2 F4

TBD

1

1 | 2

2 F1

RATING TBD

IN+ IN+ | OUT+ | OUT+
RETURN RET | U2

PROTECTION / TBD

1

1

1 A

A | B

B JP1

CTRL SERVICE LINK

A

A | B

B SW2

ACTUATOR ISOLATOR / TBD

1

1 | 2

2 F2

TBD

1

OUT+ | OUT+
OUT- | OUT- BT1

CK18650-1234S-NP / 5 V

1

1 | 2

2 F7

TBD

1

1 | 2

2 F3

TBD

1

1 | 2

2 F5

TBD

5V_SYS

GND_SYS

5V_ACT

5V_SYS

5V_CTRL

5V_BUBBLE_IN

5V_ACT

GND_SYS

5V_ACT | 5V_IGN_FUSED

5V_SYS

5V_CTRL | 5V_MOTOR_IN

5V_ACT

5V_BUBBLE_IN

5V_ACT | 5V_MOTOR_IN

5V_WATER_IN

GND_SYS

GND_SYS

5V_WATER_IN

PWR_FLAG marks intended supply paths for ERC only; it is not measured power evidence.

OPEN JP1 for USB service. Do not power USB and 5Vin together.

All four action groups may run concurrently.
Fuse / wire / connector ratings require a measured input budget.

BATTERY: output polarity / continuous current / protection not verified. Charging port excluded.

### 01 POWER INPUT AND DISTRIBUTION

SW1: low-current request candidate; contact mapping TBD.
Do not route the total load through the unverified slide switch.
U2/U3: selection, thresholds, reverse current and fail-off design are unresolved.

A1 design candidate. Protection / switching blocks are NOT implemented circuits.

SW2: ACTUATORS ONLY; controller remains powered (confirmed).
Device rating TBD; no MCU required to open. Re-arm / stored energy unverified.

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
### Title: CyberTrack / ESP32-S3 and BOOT

File: control.kicad_sch

Sheet: /ESP32-S3 and BOOT/

CyberTrack

MODULE INTERCONNECTION SCHEMATIC - NOT FOR FABRICATION

Retain existing ESP32-S3 board; TBD items are unresolved

Pin IDs identify signals, NOT physical header positions

MIC_WS_[L04] | IO4 MIC_SCK_[L05] | IO5 MIC_DATA_[L06] | IO6 AMP_DATA_[L07] | IO7 AMP_BCLK_[L08] | IO15 AMP_LRCK_[L09] | IO16 VOLUME_DOWN_[R09] | IO39 VOLUME_UP_[R08] | IO40 OLED_SDA_[R07] | IO41 OLED_SCL_[R06] | IO42
TALK_INPUT_[R17] | IO47 U1B

Existing ESP32-S3

A

A | B

B SW3

BOOT / NO MOMENTARY

AMP_BCLK AMP_BCLK

AMP_DATA AMP_DATA | AMP_LRCK AMP_LRCK | MIC_DATA MIC_DATA | MIC_SCK MIC_SCK | MIC_WS MIC_WS | OLED_SCL OLED_SCL | OLED_SDA OLED_SDA | TALK_INPUT TALK_INPUT VOLUME_DOWN VOLUME_DOWN

VOLUME_UP VOLUME_UP

X1

RETAINED ASSEMBLY

5Vin_[L21] 5Vin | GND_[L22] GND | BOOT_/_IO0_[R14] IO0 | MOTOR_A_EN_[L12] | IO8 MOTOR_A_IN1_[L15] | IO9 MOTOR_A_IN2_[L16] | IO10 MOTOR_B_EN_[L17] | IO11 MOTOR_B_IN1_[L18] | IO12 MOTOR_B_IN2_[L19] | IO13 BUBBLE_EN_[L10] | IO17 WATER_EN_[L11] | IO18
IGNITION_EN_[R18] | IO21 U1A

Existing ESP32-S3

MOTOR_B_IN1

5V_CTRL

GND_SYS

IGNITION_EN

BUBBLE_EN

WATER_EN

GND_SYS

MOTOR_A_EN

MOTOR_B_IN2

MOTOR_A_IN1

MOTOR_A_IN2

MOTOR_B_EN

BOOT_STOP_N U1A and U1B are the SAME board. USB, regulator, reset, radio and on-board LED remain inside U1.

Source: action_outputs.h + cybertrack_tools.cc (ct19).
Retained peripherals: bread-compact-wifi/config.h.
Firmware pin identity does not prove physical wiring.
A1: no PCB transfer; see parameter-confirmation.md (E01-E10).

X1 is a LOGICAL interface, not a new 11-pin connector. Existing mic / amplifier / OLED / buttons retain their wiring. Peripheral power and auxiliary pins are not reconstructed.
Do not infer module VCC or speaker grounding from this sheet.

BOOT: dry contact to system ground; parallel to on-board BOOT. It stops software actions. It does NOT isolate actuator power. Holding BOOT during reset may select ROM download mode.
No external pull-up / RC values are frozen here.

PIN ID: IO8 = GPIO8; [L12] = photo-based header position. Component side facing you, antenna UP, USB DOWN.
L/R rows counted 1-22 from antenna to USB; verify continuity. No new encoder / ultrasonic / servo GPIO allocation.

### 02 EXISTING DEVELOPMENT BOARD AND RETAINED PERIPHERALS

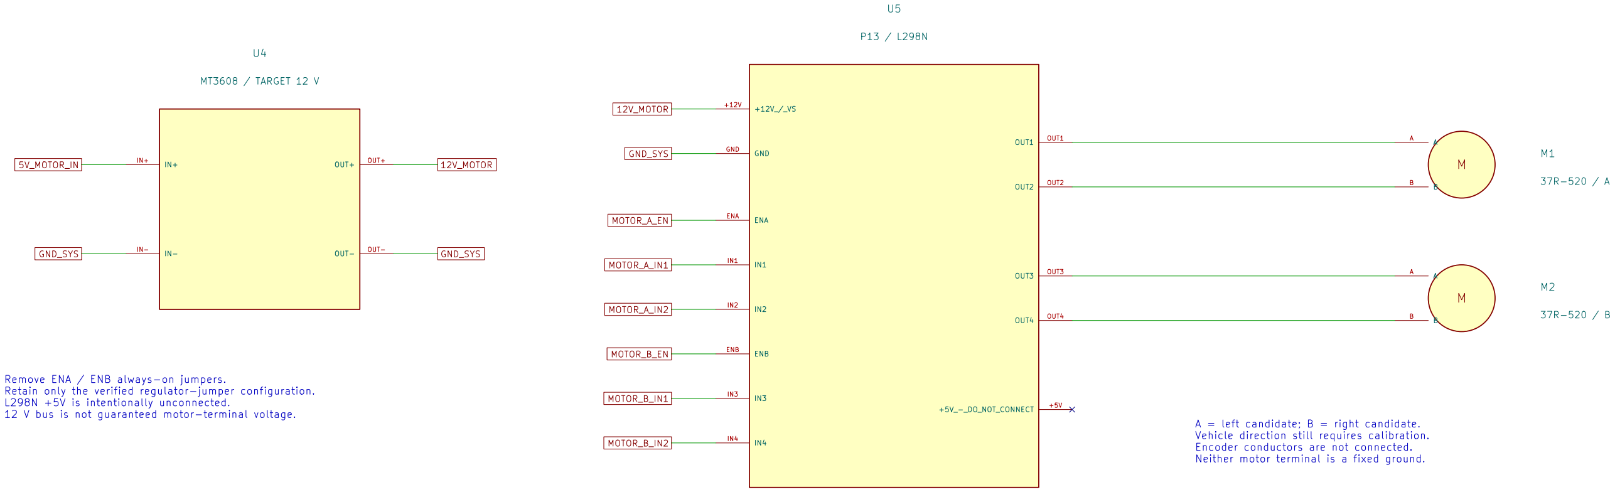
[picture p58: figure]
OUT+; OUT-; OUT- U4; MT3608 / TARGET 12 V; +5V_-_DO_NOT_CONNECT; ENA ENA; ENB ENB; GND GND; OUT1; OUT1 OUT2; OUT2 OUT3; OUT3 OUT4; OUT4 U5; MOTOR_B_IN1; MOTOR_B_IN2; 12V_MOTOR; 5V_MOTOR_IN; GND_SYS; MOTOR_A_EN; MOTOR_A_IN1; MOTOR_A_IN2; MOTOR_B_EN; Vehicle direction still requires calibration. Encoder conductors are not connected.; Remove ENA / ENB always-on jumpers.; L298N +5V is intentionally unconnected.

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
### Title: CyberTrack / Motor drive

File: drive.kicad_sch

Sheet: /Motor drive/

CyberTrack

MODULE INTERCONNECTION SCHEMATIC - NOT FOR FABRICATION

Retain existing ESP32-S3 board; TBD items are unresolved

Pin IDs identify signals, NOT physical header positions

1

1 2

2 R1

10k 1%

1

1 2

2 R5

10k 1%

1

1 2

2 R4

10k 1%

1

1 2

2 R3

10k 1%

1

1 2

2 R6

10k 1%

1

1 2

2 R2

10k 1%

MOTOR_A_EN | MOTOR_B_IN1
GND_SYS | GND_SYS

MOTOR_B_EN

GND_SYS | GND_SYS

MOTOR_A_IN1

MOTOR_B_IN2

MOTOR_A_IN2

GND_SYS

GND_SYS

R1-R6: 10k, 1%, >=0.1 W; target 0603. At L298 inputs; actual module bias / reset state still need E05.
ST L298 Table 4 sizing: 10 uA x 10.1k = 0.101 V; added GPIO load at 3.3 V <= 0.433 mA (table conditions). Photo control columns L to R: ENA, IN1, IN2, IN3, IN4, ENB; jumper contact identities need continuity check.
EN LOW = free-running stop, not active braking. Pull-downs cannot stop a GPIO stuck HIGH. Keep SW2 independent. New-supply current, thermal and reverse-energy tests pending; see parameter-confirmation.md for limits.

A = left candidate; B = right candidate.

Neither motor terminal is a fixed ground.

Retain only the verified regulator-jumper configuration.

12 V bus is not guaranteed motor-terminal voltage.

### 03 EXTERNAL BOOST CONVERTER AND DUAL H-BRIDGE

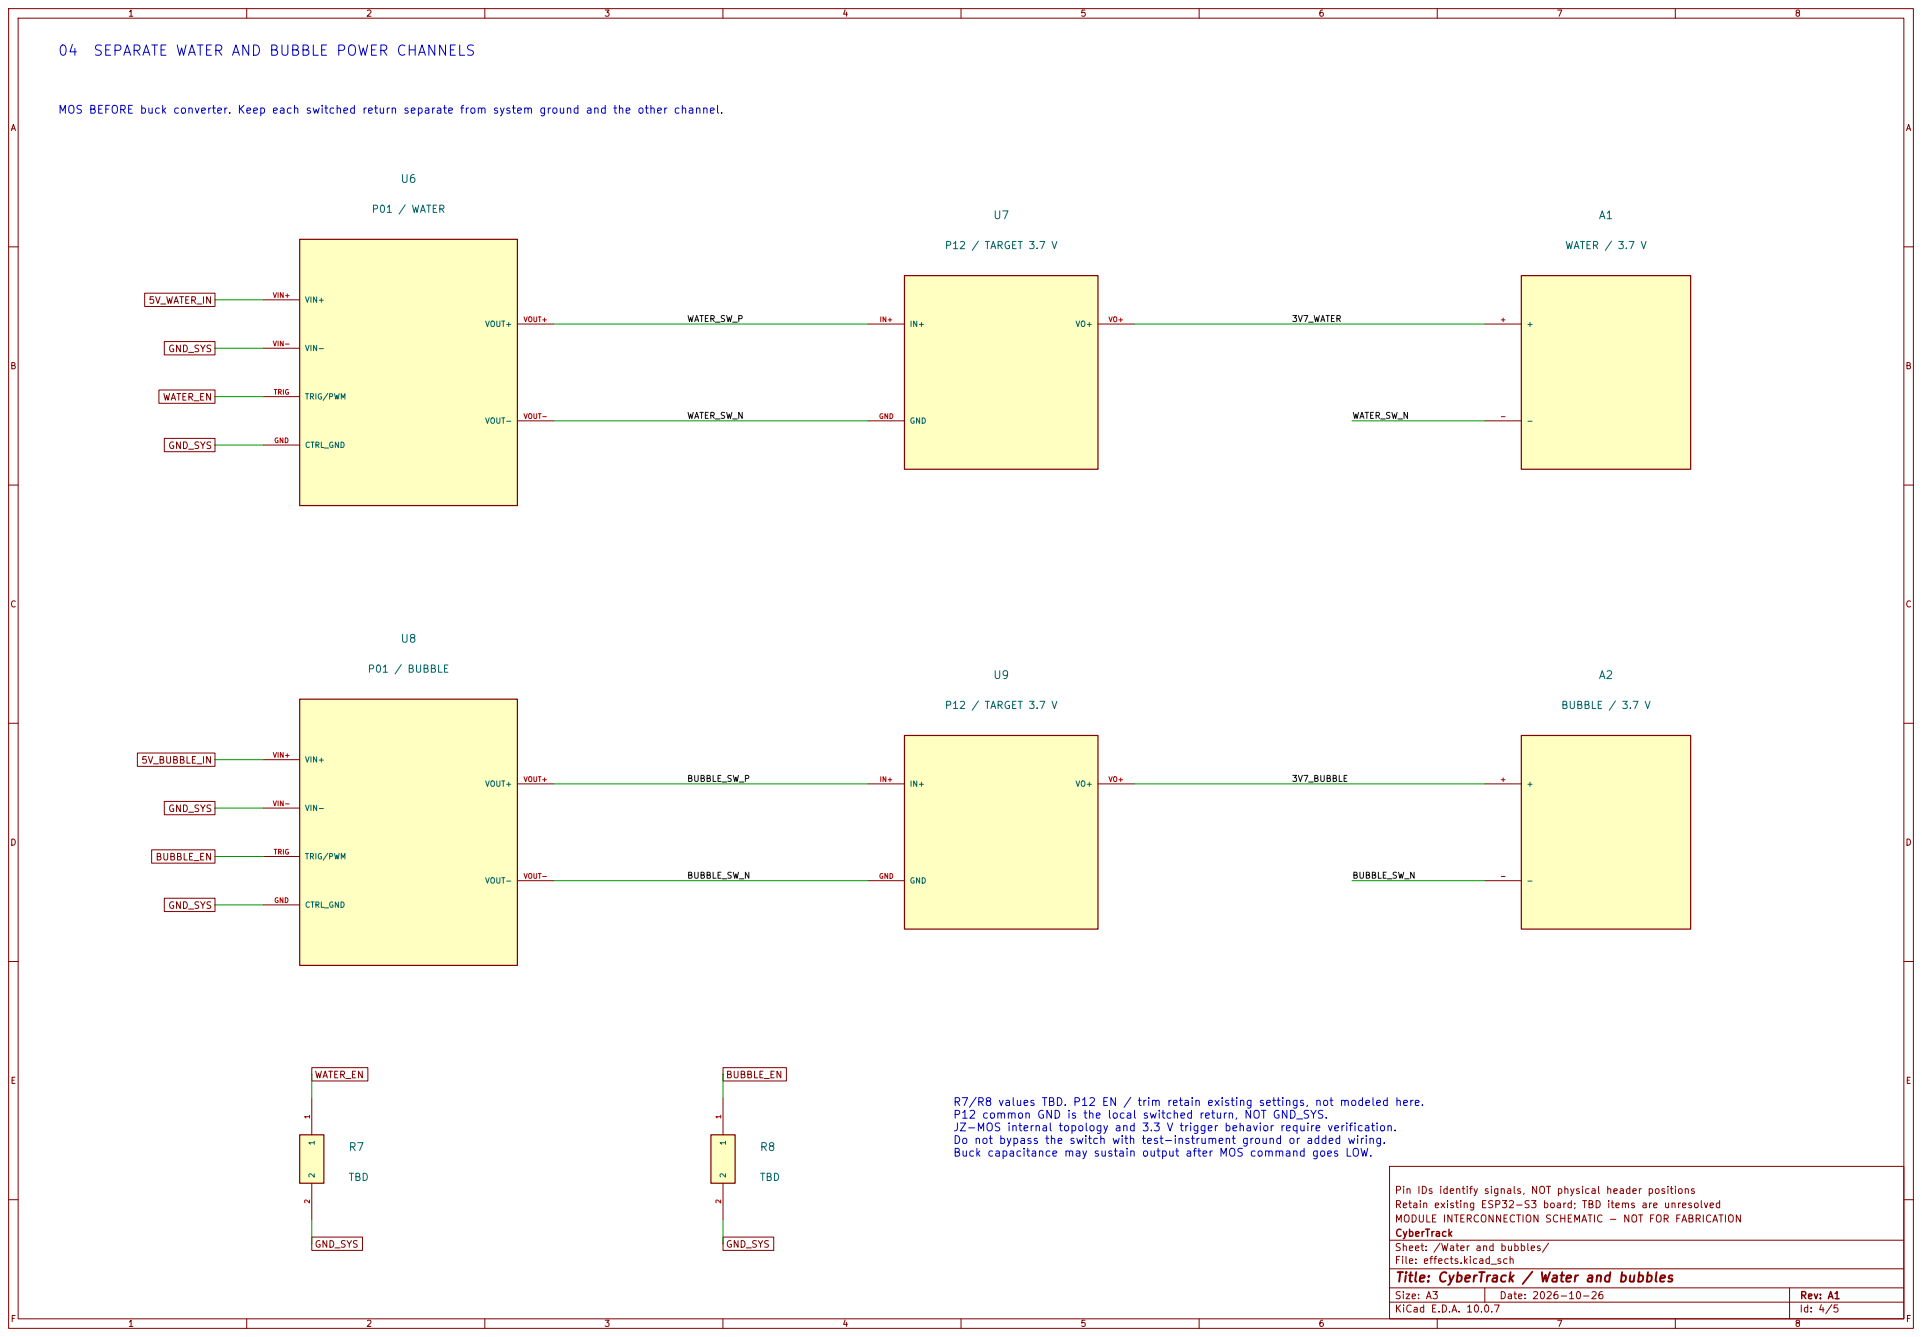
[picture p59: page 4]

04 SEPARATE WATER AND BUBBLE POWER CHANNELS

MOS BEFORE buck converter. Keep each switched return separate from system ground and the other channel.

P12 common GND is the local switched return, NOT GND_SYS.
JZ-MOS internal topology and 3.3 V trigger behavior require verification.
Do not bypass the switch with test-instrument ground or added wiring.
Buck capacitance may sustain output after MOS command goes LOW.

Pin IDs identify signals, NOT physical header positions
Retain existing ESP32-S3 board; TBD items are unresolved
MODULE INTERCONNECTION SCHEMATIC - NOT FOR FABRICATION
CyberTrack
Sheet: /Water and bubbles/
File: effects.kicad_sch
Title: CyberTrack / Water and bubbles

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
### Title: CyberTrack / Reserved ignition LV

File: ignition-lv.kicad_sch

Sheet: /Reserved ignition LV/

CyberTrack

MODULE INTERCONNECTION SCHEMATIC - NOT FOR FABRICATION

Retain existing ESP32-S3 board; TBD items are unresolved

Pin IDs identify signals, NOT physical header positions

1 A

A | B

B JP2

DNP / LEAVE OPEN

LV+_ONLY +

LV-_ONLY - | J9

LV RESERVE / DNP

CTRL_GND GND

TRIG/PWM TRIG

VIN+ VIN+

VIN- VIN-

VOUT+ | VOUT+
VOUT- | VOUT- U10

P01 / COMMON CONTROL / DNP

1

1 2

2 R9

TBD

5V_IGN_FUSED

5V_IGN_ISOLATED

IGNITION_EN

5V_IGN_ISOLATED | 5V_IGN_ISOLATED

GND_SYS

IGNITION_EN

GND_SYS

GND_SYS

IGNITION_SW_P

IGNITION_SW_N Firmware: GPIO21, single action <= 5 s; cooldown >= elapsed software ON time.

These are software rules, NOT thermal protection or physical stop evidence. R9 value, protection, input current, cut-off and EMC remain unresolved. PWR_FLAG is an ERC declaration for the optional supply, not a populated link.

JP2 OPEN and output harness absent for initial validation.
U10/J9 marked DNP in this review assembly.
One control channel is reserved for the shared MOS requested for two modules. Output pin numbers are logical +/- only; no connector or current rating is frozen.

No ignition-module HV circuitry, electrodes or HV wiring is included. This sheet authorizes no energization.

### 05 IGNITION LOW-VOLTAGE INTERFACE - DISABLED
