miclle/cybertrack/tools/lingxi-solution/README.md

# 灵矽参考材料包

ct78 已移除表演编辑与预览，参考包不再包含离线排演页面。旧 compose 语料和回放只用于复算历史证据，不代表当前工具或角色能力。

在仓库根目录执行 `python3 scripts/package_lingxi_solution.py`，生成 `output/lingxi-solution/` 下的本地 ZIP；不会上传、发布或更改灵矽账号。解压后从 `START_HERE.md` 开始。主持人另开 `tools/family-study/observer.html` 记录体验。在解压目录运行 `python3 scripts/review_lingxi_reference.py`，可离线核对清单所列文件并分别重算历史基线与 ct57 工具定义各两组真实平台调用的成绩，输出各自的偏差用例编号。`firmware_host_scores` 单列 ct61 原话＋完整固件主机的语义 78/80、编排 6/8，保留首次超时 C005 和额外查询 C008。解压重算仍显示未完成编号与未达门槛，不会用诊断重跑代替失败。三次并发冲突的回执审阅和各主机清单随包提供，完整 RPC 控制重放仍需完整 checkout。返回码 0 表示重算结果与原记录一致。

[明确文件清单](files.json)包含方案章节、亲子上手卡、现用工具契约、角色源、文本／口述用例、采集模板、语义评分器、停止记录分析器、工程修改记录工具、硬件架构、电源预算及模型辅助设计接入记录。`MANIFEST.json` 记录 Git 提交、所选文件是否存在未提交修改、清单之外各交付文件的 SHA-256、源码候选与最近部署应用各自的字节数和哈希。相同输入生成相同字节；已有输出不覆盖。

本包是参考材料，不是完整源码、可刷写固件或完整 CAD 分发。为控制材料范围，不含凭据、设备身份、录音、固件二进制或大体积模型；其他设计资料通过完整仓库继续阅读。文本名单需要人工复核，打包器不会证明任意文件内容都不含敏感信息。当前名单选用无账号配置的工程资料，不采集运行日志和本地 secrets。

198 件整机的本地界面与原生位置修改／恢复已有独立记录；整机宿主卡片消息闭环已完成；真实灵矽隔离文本联调及其失败项见[当前角色回归记录](../../docs/validation/lingxi-role-5991.md)，不能将工具准确率替代回复语义通过。家庭体验和硬件验收仍待完成。开发者可从此包开始检查能力契约、运行语义评分器、停止记录分析和电源预算；新增执行器必须在本地设备重新实现与验证，不由复制角色自动获得。

工程修改记录的开始／结束命令依赖完整 CyberTrack Git checkout；本参考包不包含 `.git`。模型辅助设计已从 CyberTrack 中拆出为 [SolidCue](https://github.com/miclle/solidcue)，使用时从其独立仓库获取源码；完整 CyberTrack checkout 中的 `scripts/solidcue.py prepare` 会按锁定版本下载到 `build/solidcue-src/`。整机扩展及修复已迁回 SolidCue 0.9.3；本包只含说明、锁定引用、来源、许可证与验证记录。测试使用独立临时仓库，不代表实际工程效率样本。

[ct57 完整回归](../../docs/validation/lingxi-ct57-full.md)与历史基线独立保存。包内 `scores` 是历史成绩，`candidate_scores` 是 ct57 工具定义的记录成绩，后者的回执仍由静态隔离夹具提供。

隔离联调的脚本、诊断集和说明随包提供；包内 `replay/` 只保留评分所需的元数据、用例编号、完成标记和工具调用。打包时逐一核对原始捕获哈希与语料哈希；完整回复与逐轮轨迹从仓库验证记录阅读。工具描述导出依赖完整 checkout 与 prepared 固件源码，联网捕获另需在获授权环境准备依赖和现有设备认证；包内不包含认证信息，也不会自动连接设备。

参考包另附[历史编排说明对照](../../docs/validation/history/compose-routing.md)、两份工具定义和十二次会话的审阅摘要。诊断版出现一次未给秒数就缩短草稿，未采纳。其原始压缩轨迹和完整离线诊断命令需要源码 checkout；包内固定集重算仍保留原成绩。

[模型选型记录](../../docs/validation/model-parameters.md)也随包提供：`qwen_scores` 复算 68/80 与 7/8，并列出漏停与禁止调用；`doubao_compose_scores` 复算 3/8，保留 C002、C007 的畸形参数失败。豆包的二十条语义是诊断子集，不是完整 80 条成绩。当前平台已恢复原 DeepSeek 配置。

ct62 的[单次识别失败隔离](../../docs/validation/voice-input-guard.md)及构建、主机来源和回放摘要已随包提供。八组合成边界与四条历史请求回放中，C005 拒绝后转用 sequence 被拦截，零启动。它们是设备控制候选的离线证据，不是新的模型成绩；`doubao_compose_scores` 继续保留原禁止调用。重跑控制回放需要完整 checkout、prepared 固件与主机编译器；该包仅核对保存材料的完整性。

参考包现在另以 `spoken_stt_review` 复算[真实 STT 驱动主机](../../docs/validation/ct62-stt-host.md)的二十条合成语音。十九条正常结束且工具匹配，V017 喷水没有结束事件，继续记未完成；转写十九条匹配。包内保留语音评分所需的文字与编码摘要，事件及实际 MCP 控制回放需要完整 checkout 和同摘要二进制。

ct63 的[组合／序列与目标速度播放匹配](../../docs/validation/plan-feedback.md)另有候选构建与离线回放摘要。同一批 STT 事件新增抑制 216 个确认包，397 个状态／否定／澄清包保留，30 条合成不一致均保留音频。未新增模型会话，不覆盖此前语音成绩或未完成 V017；重跑播放策略需要完整 checkout 与同版 C++ 回放器。打包器要求当前源码候选的构建记录实际包含在清单内。

[成功回执收敛试验](../../docs/validation/compact-model-receipts.md)没有进入主线：离线工具文本字节减少约 61%，八条平台编排却为 5/8，C006 误调用停止并清除草稿。`compact_receipt_scores` 保留这些失败；实验补丁、来源清单和复核工具供独立研究，该试验结束后恢复 ct63。

[停止说明对照](../../docs/validation/stop-negation.md)的 ct65 诊断未采纳。第七组 `stop_negation_scores` 重算语义 77/80、编排 6/8；V064 误停和 V079 擅自前进仍标为禁止调用，八条明确停止正确不会抵消失败。包内附十二条补充语料与复核脚本；原始轨迹及完整控制重放仍需 checkout，该试验结束后恢复 ct63。

ct66 引入的[即时停止回执](../../docs/validation/stop-dispatch.md)已附八组实际 MCP 调度回放、分配失败及十三组统一检查摘要。公开工具与角色未改；包内核对这些文件的完整性，完整控制回放需 checkout。它不新增模型评分，七组既有文本和 STT 未完成记录保持，最近部署仍为 ct45。

[状态话术十四次对照](../../docs/validation/stop-role-qualifier.md)未采纳，原角色已恢复。包内附审阅、历史角色快照及[灵矽联调复现材料](../../docs/validation/platform-tts-feedback.md)，它们不新增第八组完整成绩；原始压缩轨迹和完整 MCP 重放仍需 checkout，材料尚未代发。

ct67 的[历史相对改稿记录](../../docs/validation/history/relative-draft-duration.md)及语料、十三组原生回放、二十条真实 STT 定向审阅已随包提供。终态 20/20 与严格调用 14/20 分列，六条额外查询保留，在线样本没有触发实际澄清拒绝；拦截依据为原生协议／历史请求回放。原始两轮压缩轨迹和完整二进制控制复核仍需 checkout。它不替代旧二十条语音或真人指标，也不新增完整固定集成绩。

ct68 的[含糊动作门禁](../../docs/validation/vague-action-admission.md)附二十六组原生对照和二十条真实 STT 审阅：严格调用 16/20，终态 20/20，三次在线猜测执行被拒绝，八条含糊输入零启动。模型错误与一次多余查询继续保留，不将设备拒绝计作语义正确。包内只核对这些文本材料完整性；原始两轮压缩轨迹与完整控制重放仍需 checkout，不新增第八组固定成绩，不替代真人或板上验收。该记录对应 ct68 候选，最近记录部署仍为 ct45；当前候选以包内版本表为准。

[意图分流角色对照](../../docs/validation/intent-routing-role.md)另附原／候选角色快照、72 次调用与播报审阅及恢复回读。两组均 29/36，各有禁止调用，停止静默均 0/6，未采纳。该文本主机仅使用占位识别输入，不运行真实 STT 词类门禁；原始轨迹与完整控制重放需 checkout。本包核对材料完整性，七组固定文本成绩及旧 STT 未完成记录保持不变。

[模拟识别原话](../../docs/validation/capture-recognized-input.md)改进已随包提供：新文本采集默认注入原话，分别复核旧占位、新模拟文本和真实 STT。二十四条新会话终态匹配，严格调用 20/24；两次猜测动作拒绝和两次多余查询分列，不当作 ASR 或新固定集成绩。包内含输入来源单测，原始轨迹与完整控制重放仍需 checkout。

[原生数组步骤对照](../../docs/validation/native-step-inputs.md)另附两组共 176 次文本审阅、工具／角色快照、构建与恢复记录及可回读的 26 文件实验补丁。基线 77/80、5/8，候选 75/80、4/8，全部回执和终态重放一致；候选未采纳，试验结束时恢复 ct68；当前候选以包内版本表为准，最近部署仍为 ct45。包内核对所存文本材料完整性，不新增固定评分组；原始压缩轨迹、完整 MCP 重放与诊断重建需要 checkout 及对应主机。新增线格式校验的离线测试也随包提供，实际捕获参数不通过语义夹具转换“修正”。

[ct70 原始 JSON 准入](../../docs/validation/mcp-raw-json.md)另附 16 组实际 MCP 与消毒器回放、旧 ct68 对照、原始 SDK 入口说明及 88 条历史请求兼容记录。工具与角色保持，候选未部署，原七组模型成绩及 STT 未完成记录不变。包内核对材料完整性；控制／SDK 回放需完整 checkout 与工具链。

[ct71 否定输入保护](../../docs/validation/negative-input-admission.md)附最终 46 组普通／消毒器摘要、初版五项停止反例、24 次真实 STT 和最终兼容审阅。严格工具 23/24、控制状态 24/24，一次误停被拒绝；活动／等待全停保留，过程播报及原固定模型门槛不变。原生完整记录和原始平台事件无损压缩留在源码仓库，包内仅校验文本材料完整性；不新增固定评分组。

[ct71 完整语音回归](../../docs/validation/full-stt-ct71.md)另以 `full_speech_scores` 复算原 80／8 条合成普通话经真实 STT 的结果，严格工具 77/80、6/8；八条明确停止正确，V064 禁止调用仍失败。逐字转写 76/80、8/8，三条数字书写与一条同音分别说明，不把它直接称为整机识别率。最小重放保留实际识别文字、完成标记和工具，不含原始音频或完整 RPC 事件。七组历史文本及旧 STT 的未完成 V017 保持，不用新采集覆盖。

[ct72 效果播放](../../docs/validation/effect-alias-feedback.md)提供构建、逐包及合成不一致摘要；完整 88 条原事件仅新增抑制普通点火 64 包。包内核对材料，C++ 包级播放和完整控制重放需完整 checkout；没有新平台会话或设备部署。评分器及本地中继测试交付后，参考包现有 98 项离线测试，完整源码现为 124 项。

[协议字段／none 对照](../../docs/validation/tts-protocol-observation.md)随包提供摘要与恢复依据：17 条定向会话不增加完整评分，none 候选统一异常且漏停，已恢复原 low。表情 thinking 不能作为内部推理过滤器；完整字段／RPC 回放仍需 checkout 与固定主机。

[模型工具轮中继原型](../lingxi-relay/README.md)的源码、环境变量名配置样例、本地 HTTP／SSE 夹具测试及未采纳依据已随包提供。17 项新增测试只使用回环服务，不访问外部模型或设备；工具后分析、工具轮必要限制和缓冲时延门槛继续保留，不新增模型成绩。

[ct73 四路组合播放](../../docs/validation/four-lane-feedback.md)附十二条实际 STT 的定向摘要：严格 10/12、逐字转写 11/12，F004 共享时长及 F010 识别／漏调用失败保留。五条匹配成功组合新增抑制 277 包，五十条不一致保留音频，原 88 条计数不变；本包核对摘要，完整 RPC／包级重放需 checkout 与固定二进制，不增加完整模型评分组。

[离线配置核对工具](../../docs/validation/nvs-config-review.md)随包提供，使用本机 ESP-IDF 解析已有未加密 NVS 快照。默认报告所有差异；本包只含合成夹具和脱敏比较报告，不含 SDK 或设备配置，未设置 `IDF_PATH` 时对应测试跳过。它不连接设备或更改部署。
