miclle/cybertrack/docs/agent-role.md

# CyberTrack 智能体角色与提示词

2026-11-03 用户后续授权已完成 [ct78 仅应用部署](validation/ct78-deployment.md)。本次未修改或重新回读平台角色；下述 5999 字符角色仍是待同步候选，语音失败项不因烧录关闭。

2026-11-01 完成[停止与时长定向修正](validation/ct78-stop-duration.md)：最终角色两轮定向集均 16/16，原 35 轮回归中的 S01／T04 已通过；完整集仍为 33/35，保留“快一点”漏调用与 STT 丢失“先别执行”两项阻塞。试验结束恢复原平台 5991 字符角色并重开核对，无设备操作。

**当前源码角色：5999 字符，ct78 候选，尚未正式上线。** 停止先分清对象，每次新动作停止指令均须取得本轮 stop 回执；时长依次取明确值、同一步共享值和默认值。组合动作、序列、暂不执行和拒绝后的新输入规则保留。最近线上回读仍为旧 5991 字符角色，须在剩余问题收敛后与 ct78 固件配套验收。下方旧版本联调为历史证据。[移除剧场](validation/theatre-removal.md) · [首次回归](validation/ct78-voice-regression.md)

历史 5991 字符角色明确区分正在执行的序列与未开始的草稿，并要求先检查三个网页长按标识，再判断是否有固定结束时间。保存前核对线上旧角色，保存后重新打开并逐字校验；该次纯角色同步后的面包板仍为 ct45，八份回执均为零启动、输出全关。[平台与设备记录](../firmware/esp32-audio/role-cancel-hold-ct45.json) · [原话和失败记录](validation/status-role-focus.md)

5917 字符版本按问题选择要播报的状态。只问方向或速度时只回答该项，询问剩余时长时以回执采样时刻为准；网页长按的租期不能当作预计停止时间。控制台保存并重开回读 5917 字符，原面包板应用 ct45 已重启并回到待机。[平台回读与原板检查](../firmware/esp32-audio/role-query-focus-ct45.json)

**上一次 ct45 联调反馈修正（2026-10-31）：** 角色调整为 5998 字符，SHA-256 `79662d7d2e4540a6f448a0b2330cecad2ba49f0ee2d59d1430f5279f96a677ac`。补充非法草稿直接拒绝、含糊时长澄清、旧回执不猜停止原因及解除保护不续走；压缩重复说明以满足 6000 字符上限。平台保存重开逐字一致，设备仅重启、未重烧，输出全关且零启动，见[角色同步记录](../firmware/esp32-audio/role-feedback-ct45.json)。[本轮复测](validation/lingxi-ct45-role-feedback-20261031.md)工具为 77/80，编排 5/8；成功静默、部分解释和新表达仍未通过，不以保存成功代替验收。

2026-11-01 角色只读回读与原 5991 字符源一致，设备现已部署 ct75（本次沿用 ct74 的平台回读记录，未新回读或保存）；[ct74 本地音频修正](validation/dialogue-range-beeps.md)按用户选择在对话期间暂缓普通滴声，未修改角色源或工具定义。最新真人后台保留状态未先查询及多余结尾等问题；软件音频修正不等于模型语义已通过。

## 维护源与名称

完整角色介绍的唯一维护源为 [role-prompt.txt](../firmware/esp32-audio/role-prompt.txt)，已纳入 Git 跟踪。该文件是可直接粘贴到灵矽“角色介绍”字段的 UTF-8 纯文本，不添加版本标题、维护说明或测试记录。版本和差异由 Git 管理；本页记录维护流程，其他文档只链接原文，不复制正文。

| 项目 | 当前约定 |
|---|---|
| 灵矽智能体管理名称 | CyberTrack，原名“彩菊”，沿用现有面包板绑定 |
| 助手昵称 | 小D，角色中的 `{{assistant_name}}` 对应平台昵称 |
| 固件唤醒词 | “你好小智”；更改管理名称或昵称不会更改唤醒词 |
| 角色 | 机灵、友好、利落的双履带机器人小助手，主要响应指令、报告状态 |
| 当前能力 | ct78 源码为十一个工具（含独立距离提示音及可选前进保护）、四路独立控制、网页与语音并用及狂暴模式；见[当前接口](../firmware/CAPABILITIES.md#当前面包板-ct21-接口)，分项证据不等于完整现场回归 |

历史联调中的“彩菊”指当时的智能体名称，不批量改写历史证据。ct2 阶段的音色名称“彩菊姐姐”与智能体名称是不同配置，当时未随重命名修改；后续音色变更见版本沿革，最新平台回读为“少年梓辛/Brayan”。

ct55 在调速票据被拒绝时提供请求时刻的未移动、Wi-Fi 离线、语音链路离线或关机状态。选择错误信息与请求票据共用控制锁，其他拒绝保留通用说明。角色按明确回执回答，模糊错误不能推断具体原因。[构建检查](../firmware/esp32-audio/verification-ct55.json)

ct62 候选在设备端按识别输入隔离失败：本轮失败后拒绝后续动作、调速与改稿，查询和停止可用，新输入恢复。角色仍须解释拒绝、不自动重试；新增防护不能代替首个工具的意图判断或抑制虚假回复。角色源与公开工具参数保持不变，未新增平台保存或设备部署。[验证与限制](validation/voice-input-guard.md)

ct63 候选进一步核对普通组合、序列和目标速度的完整原话、工具参数与成功回执，匹配后抑制确认音频；不发起动作或改变角色。已有二十条事件的五条新增匹配抑制 216 个确认包，397 个状态／否定／澄清包保留，30 条不一致变体均不静默。[范围与回放](validation/plan-feedback.md)

ct61 播放策略扩展明确时长的喷水／泡泡短句，要求本次唯一工具参数、成功回执的操作与时长均匹配。支持的时长书写范围见验证记录，未知或多意图原话保留语音；超限和时长不符不会静默。喷水说明同时区分 1 ms 下限和未指定时的 1000 ms 默认值。[构建检查](../firmware/esp32-audio/verification-ct61.json)

ct60 的泡泡工具说明强调先将超三十秒请求的参数设为 30000，不能以口头说明上限代替合法参数。设备端范围校验继续拒绝越界，捕获工具可用同段 MCP 校验代码核对参数。[构建检查](../firmware/esp32-audio/verification-ct60.json)

ct57 将绝对与相对调速的票据拒绝作为明确的工具结果返回。传输 `isError=false`，内部 `result=rejected`，不能判断为动作成功。未分配票据时直接返回，不进入动作回调。原有角色源和接受条件继续适用。[构建检查](../firmware/esp32-audio/verification-ct57.json)

ct56 的调速工具说明要求按明确错误中的状态解释，通用错误只说明未确认，拒绝后不建议试动。线上回复另见[原因解释对照](validation/speed-rejection.md)。

ct54 的调速工具说明区分单独“全速”和“全速前进”。单说“全速”等四种明确短句时，设备核对本轮调速请求、100% 目标、成功回执中的实际设置和故障字段，再抑制随后的语音确认。多工具调用、提前开始的回复及拒绝继续交给播放通道。[候选构建与检查](../firmware/esp32-audio/verification-ct54.json)

ct51 候选在设备播放端识别明确的全停短句，包括“停止行走”“取消序列”和“取消正在执行的表演”。只有当前调用、回执操作和成功结果匹配，且无异常时，才抑制后续确认音频。“不要取消序列”、取消未开始的草稿、故障或尚未收到成功回执的回复继续交给播放通道。[候选构建与检查](../firmware/esp32-audio/verification-ct51.json)

## 修改与平台同步

2026-11-01 [精简角色对照](validation/concise-role.md)已完成：首轮严格调用改善，但复测漏停并虚假回复已停止，候选未采纳。仓库与平台恢复原 5991 字符角色，保存重开逐字一致，模型参数未变；没有重启设备。[最新平台恢复记录](../firmware/esp32-audio/role-concise-restored-ct75.json)

1. 先编辑 `role-prompt.txt`，说明要改善的行为，并检查工具名称、参数、单位和回执字段是否与[面包板实现](../firmware/esp32-audio/README.md)一致。语气优化不能无意改变执行条件、时长或停止语义。
2. 审阅原文差异。保留真实回执优先、失败不自动重试、普通动作默认一次 1 秒（100% 速度的左右转默认 880 ms）、狂暴模式默认 5 秒；行走按指定时长（协议整数毫秒范围 1–2147483647）、喷水／泡泡及狂暴模式最多 30 秒、点火最多 5 秒、四路独立计时、同路忙碌拒绝、本地停止优先和未接入能力不假装执行等约束。实际能力发生变化时，连同相关实现、说明和验证项一起更新。
3. 在用户授权的配置同步范围内，将原文完整复制到现有 CyberTrack 智能体的“角色介绍”，保存后重新打开，逐字核对（仅忽略末尾换行）。不要覆盖昵称、音色、模型或设备绑定等无关配置。平台操作与 Git 提交、推送分别遵循用户授权。
4. 平台直接修改也必须回存同一文件，并先比较差异；有两边并行修改时合并语义，不盲目覆盖任一侧。禁止只在控制台维护正式版本。
5. 按平台提示重启设备加载配置，再做相关语音回归。记录提示词 Git 提交或 SHA-256、固件版本、验证日期、受测表达、工具回执和用户现场观察；区分“仓库已修改”“平台已核对”“设备已验证”。

纯角色调整通常无需烧录；提示词不会自动随固件构建部署到灵矽。固件工具描述也是模型输入，变更时应检查与角色规则的冲突。ct6 历史变更曾将工具描述与角色统一为明确动作未说时长时传入 `duration_ms=1000`；该阶段已记录指定时长、四方向、状态／停止、否定及单向互斥；跨动作互斥已被 ct7 并发取代；默认时长、上限等完整语音回归仍待补齐。提示词不能取代固件参数校验、截止计时、BOOT 提前停止和断线停止。

## 语音回归清单

下表是预期，不是已通过记录。动作相关测试先保持 L298N 12 V 和 MOS 5 V 功率供电均断开，结合工具回执和设备日志核验；仅查看聊天回复不足以证明工具执行。带载测试另按[喷水验证记录](validation/bench.md)准备和记录。

| 用户表达／场景 | 预期行为 |
|---|---|
| “你叫什么名字？”／“小D” | 自称小D或简短回应，不调用动作工具 |
| 单纯唤醒／呼唤连续数次 | 每次只用一句自然回应，适当变化，不连读多条例句，不调用状态或动作工具，不声称已自检 |
| 唤醒并说“发射”／“检查状态” | 直接处理请求，不先加问候；动作成功静默执行，状态先查询再回答 |
| 待命／主动停止后／多路活动／持续动作／狂暴模式的状态查询 | 按最新回执自然组织一到两句；待命不等于硬件全部正常，活动通道分别报时，持续动作不编造截止时间，狂暴模式按模式字段报告 |
| 状态查询失败／冷却／故障／缺少电量或液位数据 | 如实说明，不用“准备好了”等话术掩盖异常或编造数据，不主动重复查询 |
| “走的是哪个方向？”／“还要走多久？” | 先查询，前者只答实际返回的方向，后者说明查询时对应通道的剩余量；已停时如实说明 |
| “查询状态” | 调用状态工具，依据最新回执简短回答，无喷水调用 |
| “喷水”／“喷一下”／“再喷水” | 一次水工具调用，明确传入 1000 ms，不追问、不沿用上次时长 |
| “喷水七秒”／“喷水半秒” | 分别传入 7000／500 ms，按指定时长调用，成功后静默 |
| “喷水四十秒” | 只请求 30000 ms，说明单次最多三十秒，不分段续喷 |
| “停止”／“停止所有动作” | 立即调用停止，不先查询；再查状态应与停止回执一致 |
| “不要喷水”／“现在有没有喷水？”／明显背景谈话 | 不触发喷水；状态问句只查状态 |
| “停止说话” | 结束回复，不误作喷水请求 |
| “前进”／“后退半秒”／“左转”／“右转五秒” | 一次 move，分别 forward/1000、backward/500、left/880、right/5000；按原时长执行 |
| “左转”／“右转”／“全速左转”／“100% 速度右转” | 空闲时一次 move，left/right、880 ms、100%；全速带方向按规则先查状态 |
| “80% 速度左转”／“60% 速度右转” | 一次 move，对应速度、1000 ms |
| “左转一秒”／“全速右转半秒” | 一次 move，分别 1000／500 ms，不改为 880 ms |
| “左转并喷水”／“前进五秒，然后右转并喷水” | 组合／后续序列步：转向 880 ms、喷水 1000 ms，各自截止 |
| “右转，同时喷水两秒” | 明确共享时长，两路均 2000 ms |
| 80% 转向中说“全速” | set_speed=100，保留原截止，不重新计时 880 ms |
| “向前一米”／“左转九十度” | 说明只能按时间控制，请用户给出时长，不擅自换算 |
| “边走边喷” | 一次 move_and_water，默认 forward、两路各 1000 ms；成功后静默，查询时再报各自状态 |
| 行走中请求喷水／喷水中请求行走 | 只请求另一通道，已有动作的时长和输出不变 |
| 同路仍活动时重复请求／组合请求遇一路忙碌 | 拒绝，不续时、不换向、不部分执行或补做 |
| “不要前进”／“现在在转吗？” | 不触发行走，后者只查状态 |
| “吹泡泡”／“点火” | 分别调用 bubbles／ignition，默认 1000 ms；明确请求才动作，不能把工具接受当成实测出泡或火花 |
| “发射”／“开炮”／“放电”（含“一下”） | 分别按喷水／吹泡泡／点火理解，调用 water／bubbles／ignition，各一次 1000 ms |
| “发射三秒”／“开炮十秒”／“放电两秒” | 分别请求 water/3000、bubbles/10000、ignition/2000 |
| “发射四十秒”／“开炮四十秒”／“放电八秒” | 分别限为 30000／30000／5000 ms，说明上限，不分段或续时 |
| “停止发射”／“停止开炮”／“停止放电” | 立即调用统一 stop，不先查询或启动动作 |
| “不要发射”／“不要开炮”／“不要放电” | 不启动任何动作 |
| “还在发射吗”／“开炮结束了吗”／“现在在放电吗” | 仅调用状态工具，按对应通道实际回执回答 |
| “发射是什么意思”／引用或背景谈话中的“开炮”“放电” | 不触发动作；不把别名理解为其他能力或狂暴模式 |
| “闪电”／“护盾”／“打火”／“电击”及各自“一下” | 各一次 ignition/1000，成功静默，不启动狂暴模式 |
| “开枪”／“射击一下”／“开枪射击” | 一次 water/1000，同义词不重复调用，成功静默 |
| “护盾两秒”／“电击八秒”／“射击四十秒” | ignition/2000、ignition/5000、water/30000；后两项只说明上限 |
| “停止电击”／“关闭护盾”／“停止射击” | 直接统一 stop，成功静默 |
| “不要闪电”／“别打火”／“不要开枪” | 不启动动作 |
| “护盾结束了吗”／“还在射击吗” | 只查状态，再正常回答 |
| 对机器人说“饭店”／“饭店一下”／“饭店两秒”／“开启饭店” | 仅独立动作短句且无餐饮语义时纠正为放电，分别 ignition/1000、1000、2000、1000，成功静默 |
| “饭店八秒”／“不要饭店”／“停止饭店”／动作语境中的“还在饭店吗” | 分别限为 ignition/5000 并说明、无动作、统一 stop、仅查状态 |
| “去饭店”／“找饭店”／“附近的饭店”／“饭店吃饭”／“饭店是什么意思” | 不触发动作；不将餐饮、词义、引用或背景谈话纠正为放电 |
| “闪电是什么意思”／天气闪电／游戏护盾／含义不明的饭店句子 | 不触发动作，必要时只澄清 |
| “前进并射击”／“开枪并开启护盾” | 前者一次 move_and_water，各1000；后者 sequence 一步 water_ms=1000、ignition_ms=1000；整单接受后静默，拒绝不拆分补做 |
| 前进／喷水／吹泡泡／点火／组合／狂暴模式／停止成功 | 不输出确认文字或播报，不把“静默”等字样作为回复；仍检查回执，失败不能静默 |
| “前进并发射” | 一次 move_and_water，forward、两路各 1000 ms；不得额外启动点火 |
| “吹泡泡八秒”／“点火八秒” | 泡泡请求 8000 ms；点火仅请求 5000 ms 并说明上限、不分段，停止后等实际通电时长的间隔内拒绝新点火 |
| “不要吹泡泡”／“现在在点火吗？” | 不启动；状态问句只查询 |
| “发射”／“开炮”／“放电”成功回执 | 原名和所有别名成功后均静默；调用前不确认，结束后不播报 |
| 一次请求多种动作／同一请求出现重复回执 | 成功后静默；仅汇总异常或限制，不因重复回执再次执行或播报 |
| “发射四十秒”成功／“停止”成功 | 前者仅说明“单次最多三十秒。”，后者静默，不另加动作确认 |
| 网页在线但没有动作时发出语音指令 | 不因网页在线自行拒绝，按正常规则调用工具并检查回执 |
| 网页持续行走／喷水／泡泡期间语音查询状态 | 根据非零 hold_id 说明对应动作持续运行，不把短租期读作总剩余时间或承诺即将结束 |
| 网页占用同路时语音请求／持续动作期间语音停止 | 依据实际回执简短说明占用，不自动补做；停止始终直接调用统一 stop |
| 工具拒绝、超时或结果不确定 | 不声称成功，不自动重试；不把指令接受说成实测出水 |
| 行走或喷水中按 BOOT，随后松开 | 本地提前停止且不恢复，以设备和现场结果为准 |

所有回答保持简短、与机器人角色相关；不出现“已开启输出”“已关闭输出”等面向用户的工程话术。无需每次修改都重跑全表，按改动选择相关用例；改变动作理解或参数映射时，至少覆盖状态、默认时长、指定时长、上限、停止和否定表达。

### ct28 测距语音待测

- “前面有多远／测一下距离”：仅 `get_status({})`；有效毫米值换算厘米并报“大约”，不触发动作。
- 无回波、未接模块、信号异常、数据超过 500 ms、旧固件缺字段：答暂时没有有效距离，不沿用上一轮数字，不说前方畅通。
- “前面有障碍就停”：说明在网页开启自动避障；不声称已切换。“自动绕开”：说明无自动绕行，不建立动作循环；明确“停止”仍直接调用 stop。
- 网页开关关闭／开启后分别语音请求前进、边走边喷和含前进的序列：按同一设备状态执行；开启时近距离拒绝／停止前进，独立效果保留。关闭及距离恢复不补做旧动作。
- 待机、后退、转向或前进锁定时，分别开启／关闭自动避障并靠近物体：设备只按有效距离滴声，云端不重复提醒；仅开启时停车，关闭后旧动作不恢复。
- “自动避障开了吗”：只查 get_status，按 proximity.auto_avoidance_enabled 回答；缺字段不猜。
- 行走中询问距离不续时、不换向；否定、引用、背景谈话不启动动作。原停止、全速和组合规则保留；平台保存回读及设备重启完成，口述回归待做。

## 回滚

通过 `git log -- firmware/esp32-audio/role-prompt.txt` 查看历史，提取需要的旧版本并与当前原文比较。确认仍兼容当前固件工具和动作限制后，按上述同步流程恢复平台配置并验证；不要为回滚提示词重置整个工作区或设备配置。已保存的旧提示词不代表与新固件自动兼容。

ct65 [停止说明对照](validation/stop-negation.md)未采纳：角色未改，虽八条明确停止直接正确，固定语义仍有误停和含糊请求擅自前进。说明、候选版本已恢复 ct63，后续继续核验模型工具准入与过程播报，不以提示词替代设备守卫。

ct66 [即时停止回执](validation/stop-dispatch.md)只调整固件调度，公开工具、角色及平台配置不变。校验后的 stop 同步完成并回复，不因新识别轮次误报失败或留下二次停止回调；旧动作和查询继续隔离。这不是新的模型语义或真人静默成绩，候选未部署。

[状态话术限定对照](validation/stop-role-qualifier.md)临时为状态段增加六字，角色 5991→5997→5991，十四次定向会话后恢复。停止静默仍为 0/3、C008 仍有过程文字，没有采纳或扩大固定集；原始误改和恢复证据均保留。

ct68 [含糊动作门禁](validation/vague-action-admission.md)对有限的泛化动作类别返回 `action_unspecified` 与 `clarification_facts`，要求澄清具体动作而不换工具补做。拒绝不意味着原有动作已停止，也不是草稿保存回执。明确停止保持优先。角色和十二项公开工具未改，未部署；模型误停和过程播报继续待修。

[意图分流角色对照](validation/intent-routing-role.md)临时将角色 5991→5990→5991，72 次文本会话后未采纳；严格匹配均 29/36，候选仍擅改半秒且停止仍有 TTS 确认。仓库、平台保存回读和原参数均已恢复，未重启或刷写；这些是占位输入的主机诊断，不是实际 STT 门禁或真人成绩。

[原生数组研究](validation/native-step-inputs.md)曾将序列参数说明从字符串改为数组（5991 → 5994 字符）。完整固定集退步，未采纳；源码角色与平台保存重开均恢复为原 5991 字符。没有新增设备重启或部署记录，不能把实验角色当作当前契约。

ct70 的原始 JSON 零字符拒绝不修改角色或十二项工具；畸形请求锁定本轮失败，模型不得换工具补做。现有输入代际隔离、合法停止与新输入恢复保留，原误停和过程播报门槛未因此关闭。[验证](validation/mcp-raw-json.md)

ct71 返回 `input_negated`／`negation_facts` 时，本次写入或空闲误停没有执行；不得称停止／保存成功或换工具补做。原角色与公开工具定义不变。设备活动／等待时仍优先全停，不能依最新文本推断迟到 RPC 的原始意图。[实际 STT、失败初版与最终边界](validation/negative-input-admission.md)

[ct71 原 80／8 完整语音链路](validation/full-stt-ct71.md)使用原 5991 字符角色，前后只读回读一致，无平台保存或设备重启。严格工具 77/80、6/8，设备拒绝一次否定误停；停止确认、改稿旁白和规则分析仍存在。思考参数的页面值不能代替模型真实请求和扬声器验收。

ct72 [效果确认播放](validation/effect-alias-feedback.md)只扩展已有角色别名和模式的端侧匹配，不改角色或工具。普通点火的 64 个确认包可抑制；超限、拒绝、澄清和 C005 规则分析仍保留。没有平台保存或设备重启，不能当作模型已遵守静默规则。

[协议字段／none 对照](validation/tts-protocol-observation.md)未改角色；候选参数导致八条统一异常，已恢复原值并新连接核验停止。通过页面修改时，应等待模型对话框真正关闭后再保存，看到“配置保存成功”并返回列表后重开回读；编辑框显示新值或点击返回不构成保存证据。设备原会话与新建隔离会话分别记录，本轮不以参数保存冒充设备重启或刷写。

[模型工具轮中继](validation/llm-tool-round-relay.md)是未采纳的本地原型，仓库角色、十二项工具及平台配置未改。它不改变意图或设备授权；工具后分析与工具轮必要限制仍需独立验收，不得用中继隐藏文字来宣称模型语义正确。真实接入继续遵守保存、重开回读、版本关联和分层回归流程。

ct73 [四路组合播放](validation/four-lane-feedback.md)不改角色或工具，仅按既有动作别名扩展端侧匹配。定向集的共享时长误解和“护盾／互顿”转写失败独立保留，不以抑制确认代替模型语义，不增加新的同音纠错。平台前后只读核对一致，没有保存或设备重启。
