miclle/cybertrack/docs/current-status.md

# CyberTrack 当前状态

ct78 应用已于 2026-11-03 [仅应用部署](validation/ct78-deployment.md)，两次启动联网及二十条零输出回读通过。仓库 5999 字符角色仍待同步；平台最近记录为 2026-11-01 恢复的旧 5991 字符角色，本次未修改或重新回读平台。[停止与时长修正](validation/ct78-stop-duration.md)的两轮定向语音集均 16/16，原 S01／T04 已通过；完整集仍为 33/35，“快一点”漏调用及 STT 丢失“先别执行”后误启动继续保留。固件更新不代表角色或语音验收通过。[剧场退役](validation/theatre-removal.md)

核对日期：2026-11-03。机器可读版本入口为 [firmware/current.json](../firmware/current.json)，检查命令 `python3 scripts/check_firmware_current.py`。`last_recorded_deployment` 保留应用部署记录，独立的 `last_recorded_role_sync` 记录角色回读关联或后续纯角色同步，避免将重启冒充烧录。检查器核对源码版本与构建记录，以及角色同步所对应的已部署版本。可用下列命令分别核对两份本地应用文件的字节数和 SHA-256。省略参数时只检查记录；两种方式均离线运行。

```sh
python3 scripts/check_firmware_current.py --source-bin build/firmware-ct78/xiaozhi.bin --deployed-bin build/firmware-ct78/xiaozhi.bin
```

| 项目 | 当前依据与状态 |
|---|---|
| 源码基线 | `2.0.3-ct78` 应用已部署，角色候选待同步：移除独立剧场、草稿、compose 与网页编辑／确认；保留语音组合、序列、四路独立截止及停止保护，新增仅讨论／暂不执行的有限拒绝检查。继承 ct77 测距提示连续确认及现有音频、协议保护。 |
| 最近记录的部署 | [ct78](../firmware/esp32-audio/startup-ct78.json)；2026-11-03 仅应用写入、配置保持、两次启动联网及二十条零输出回读通过；未更新平台角色 |
| 最近角色核对 | [2026-11-01 回归后恢复](validation/evidence/ct78-stop-duration/platform-restored.json)：原 5991 字符角色保存重开逐字一致，模型参数未变；ct78 部署时未新增平台回读 |
| 软件验证 | [ct78 本地构建与回归](../firmware/esp32-audio/verification-ct78.json)，[范围与边界](validation/theatre-removal.md)；旧版本记录保留在各验证专题，不作为新角色或现行模型验收。 |
| 角色 | [唯一角色源](../firmware/esp32-audio/role-prompt.txt)，5999 字符候选，尚未同步；平台最近回读仍为旧 5991 字符角色。 |
| 运动 | 四方向，60–100% PWM、默认 100%；全速转向省略时长为 880 ms，其他普通动作默认 1000 ms；无编码器里程计 |
| 并发与序列 | 四路独立截止，序列最多 16 步；步骤内并发，步骤间串行；取消不恢复 |
| 测距 | IO1/TRIG、IO2/ECHO，约 100 ms 采样、500 ms 过期；无效不报旧距离 |
| 距离提示音 | ct77 连续 3 个有效近距样本才提示，远距／无效／过期重置确认；已部署，用户确认偶发滴声明显减少。小于 50 cm 提示；40–50 cm 每 800 ms，小于 40 cm 每 400 ms；与动作及停车开关独立 |
| 前进保护 | 网页开关默认关闭；开启时小于 15 cm 停前进／至少 20 cm 解锁，解锁不续走；无自动绕行 |
| 网页 | `http://<设备 IP>:8080/`；单网页会话，长按租期 600 ms；同通道网页优先 |
| 电源 | 辰克 5 V 电池包、12 V 升压电机支路；旧电源测试不迁移 |
| 机械 | [当前模型](../hardware/model/README.md)，Lean／Ready 各 27 件、6 盘；须按各自说明切片 |
| 实物 | 已有样机及分项现场反馈；当前整机持续负载、停止性能、可靠性及完整语音回归未验收 |
| 只读帮助 | ct43 引入、ct45 已部署[上手与回执解释](status-explanation.md)，不自动执行或重试；线上隔离解释已运行，发现猜测和恢复表述偏差；见[联调结果](validation/lingxi-ct45-20261031.md) |
| 剧场退役 | ct78 已删除独立编辑入口和草稿协议；设备已更新 ct78；角色同步及配套验收仍待完成。 |
| 新改进 | [执行计划](improvement-plan.md)，部署不等于实物验收 |

ct45 部署检查的 39 条状态／操作回执全部输出关闭、动作启动计数为 0；草稿创建、单步修改、旧版本拒绝、删除、取消、停止／会话释放失效及重连不恢复通过。未提交有效表演确认，未触发执行器。提示音调度日志不是听感验收；电平、机械停止及效果反馈继续以专项实测为准。2026-10-31 用户暂时无法配合实机测试。

2026-11-01 用户恢复现场配合；[ct73 部署与第一轮验收](validation/ct73-deployment.md)已进入实机阶段。两次启动各十条状态回读输出全关、启动计数为 0，网页与源码逐字节一致；写入前后配置及非应用区校验通过，首启后仅 WebSocket token 更新。随后已取得架空行走、BOOT 提前停止及首条真人语音的分项反馈，见下文；量化停止、完整语音回归及组合负载仍未完成；ct74 听感的后续反馈与用户跳过项见下文。

2026-11-01 首项架空行走诊断未通过：60% PWM、500 ms 前进有一次 accepted／逻辑动作，但用户明确反馈两侧履带均未转动。用户随后确认手机为 100%；同样 500 ms 定时请求在 100% 下复核，两侧转动并随后停止。60% 未转原因未定；已全停并保留[完整失败及参数／路径对照入口](validation/ct73-deployment.md#首项现场结果未通过)，未增加正式停止矩阵通过数。

ct73 架空单路 BOOT 诊断：截止前检测到按下与逻辑全关，松开后约三秒状态保持全关；用户确认实际立即停下且松开未恢复。它是单次功能观察，不代替双来源矩阵、机械停止时延或距离测量。

旧版本参数及证据保留在各专题的历史章节；当前能力以本页、[接口手册](../firmware/CAPABILITIES.md)与源码交叉核对。

2026-11-01 [ct74 部署](validation/ct74-deployment.md)完成：用户断开执行器功率后仅应用更新，ct73 回退核对、配置保持、两次启动及二十条零输出状态通过；角色只读回读一致。第一轮用户确认空闲有滴声、监听／回复暂缓且回复不卡；结束恢复、移远不补播及再次靠近三项由用户选择跳过，本轮不再请求，不计验收通过。空旷偶发滴声和完整停止矩阵未关闭。

2026-11-01 [历史设备草稿回归](validation/history/device-drafts-20261101.md)完成 27 次请求：保存、单步修改、旧版本／窗口／序号拒绝、会话释放及租期到期均符合预期；23 条控制状态零启动、输出全关。最近部署记录 ct74，本轮未独立读取运行版本；开机时刻估算与部署记录存在偏移，原因未知。有效表演及跨来源现场项目仍未验收。

2026-11-01 [ct75 部署及 HTTP 校验](validation/ct75-deployment.md)完成：两次启动、二十条零输出回读与二十二次无动作协议请求通过。首次 NVS 比较失败已保留；复核两个 Wi-Fi／用户设置保持，变化仅有连接令牌和 PHY 校准数据，校准变化原因未定。不重开已跳过的听感项目。

## 统一软件检查

真实灵矽隔离文本联调：首轮 76/80，角色修正后 77/80（96.25%），8 条编排仍匹配 5 条；只读解释 4/8 满足全部要求，45 条成功静默均未达成。见[最新复测](validation/lingxi-ct45-role-feedback-20261031.md)。无前缀诊断单独保留，未替代首轮成绩。真实设备网页、草稿 300538 ms 到期和六类非法输入拒绝均保持零启动。完整边界见[联调记录](validation/lingxi-ct45-20261031.md)。

运行 `python3 scripts/verify_improvements.py --source build/xiaozhi-ct78-src` 可复核当前适用的本地软件检查；具体命令和证据见 [ct78 退役验证](validation/theatre-removal.md)。当前停止矩阵为 13 类场景，每类五个偏移；不再包含已退役的网页表演序列。历史十八组检查、124 项测试及 88 条语料成绩按其采集版本保留，不替代当前直接动作回归。

模型设计工具已从 CyberTrack 中拆出，由 [SolidCue](https://github.com/miclle/solidcue) 独立维护，本仓库保留接入与验证资料。整机扩展及相关修复已迁回 SolidCue 0.9.3，具体提交见 [lock.json](../tools/solidcue/lock.json)。[迁回回归](../tools/solidcue/verification-migration-20261101.json)覆盖软件测试、198 件模型副本的无界面原生修改／保存重开／恢复，以及隔离服务同步；下述桌面与 GUI 验收仍为旧内置 0.9.2 的历史证据，不作为 0.9.3 的新验收。要检查外部模型设计工具，请在依赖已准备的环境运行 `python3 scripts/verify_improvements.py --source build/xiaozhi-ct78-src --model-design`。执行锁定上游提供的测试、插件 bundle 和合成宿主界面回归；统一报告记录外部仓库版本及其源码哈希，排除依赖、研究数据及生成文件。命令不安装插件、不调用正在运行的模型服务，也不代表桌面宿主消息或 FreeCAD GUI MCP 已验收。首次依赖准备见[模型设计工具](../tools/solidcue/README.md)。

模型辅助设计的[真实 GUI 验收](../tools/solidcue/verification-gui-20261031.json)已完成：198 件整机中冠盖上移 8 mm 后恢复，修改与恢复均经 FreeCAD GUI MCP 保存重开核对；同一本地页面更新到 r7，正式模型未改。无界面快照材质顺序修复通过 GUI 回读。后续[真实宿主卡片验收](../tools/solidcue/verification-host-20261031.json)已完成评论保存／宿主接受、MCP 读回与回执，以及同一卡片 r7 → r8 → r9 更新／恢复。随后[真实消息驱动验收](../tools/solidcue/verification-message-20261031.json)完成：尚未处理的 r9 评论通过 `mcp_app` 独立触发本轮，冠盖上移 4 mm 后恢复，GUI 保存重开与同一卡片 r9 → r10 → r11、最终回执均通过。I11 接入已验收；单次真实链路不代表制造或实物通过。

ct62 [真实 STT 合成上行](validation/ct62-stt-host.md)二十条中十九条正常结束且工具匹配，喷水一条未收到结束事件；转写十九条匹配。全部输入事件、MCP 回执与终态离线重放一致。播放策略抑制 248 个确认包，组合／序列和目标速度仍有 216 个确认包待处理。该记录使用无设备主机，不更新板上 ct45 或真人成绩；完整改进测试现为 81 项通过。

ct63 [组合与目标速度播放匹配](validation/plan-feedback.md)复用上述二十条真实 STT 事件，新增抑制 216 个确认包，总计 464 个；397 个状态／否定／澄清包保留，30 条合成不一致均不静默。十二组软件检查和完整构建通过，未新增平台会话或部署。前段 ct62 包数与未完成 V017 保留为历史依据。

随后[成功回执收敛试验](validation/compact-model-receipts.md)虽减少约 61% 样本回执字节，平台编排仅 5/8，且 C006 误调用停止，因此不采纳。实验 ct64 仅保留源码补丁和证据，没有进入当前候选或部署；当时恢复 ct63。采集器新增显式继续未完成批次的选项，失败记录与默认中止行为保留。

[停止说明对照](validation/stop-negation.md)也未采纳：ct65 诊断语义 77/80、编排 6/8，八条明确停止直接正确，但 V064 误停、V079 擅自前进；106 次文本会话全部结束。本次说明和版本恢复至当时 ct63，角色未改、未刷写。十二组软件检查含 86 项改进测试通过，不能替代模型禁止调用门槛。

ct66 [即时停止回执](validation/stop-dispatch.md)完成八组调度回放及回执分配失败注入。旧版已立即关输出，但排队回调可能误报输入变化或再次停止；新版同步完成并回复，旧动作／查询继续隔离。十三组本地检查和完整构建通过，公开工具与角色未改，未部署。

[状态话术限定对照](validation/stop-role-qualifier.md)完成十四次实际平台文本会话：两组严格匹配均为 6/7，三条停止均仍有 TTS 确认，候选仍含英文／规则分析。六字限定未采纳，仓库与平台原 5991 字符角色均已恢复并重开回读；ct66 候选、ct45 部署记录保持。

历史 ct67 [相对改稿门禁](validation/history/relative-draft-duration.md)将可识别且整句未量化的相对请求在设备端要求澄清，同轮补做隔离、查询／全停及可信网页保留。十三组原生回放通过；二十条合成上行的真实 STT 与终态均匹配，严格调用 14/20，六条多查状态。在线样本未尝试修改，实际拦截依据为原生回放。最终十四组检查与完整构建通过；意图／数值归属、过程播报及现场验收仍未完成，未部署。

ct68 [泛化动作门禁](validation/vague-action-admission.md)补充首次猜测执行约束：二十六组原生通过；二十条真实 STT 合成上行均结束、转写与同观测时刻终态均匹配，严格调用 16/20。三次在线猜测动作被拒绝，八条含糊请求零启动；另一次多余查询及过程／停止确认播报仍待修。完整构建与十五组软件检查通过；普通明确口令和创意草稿保留，未部署。

[意图分流角色对照](validation/intent-routing-role.md)的 72 次原话文本诊断未采纳：两组严格工具均 29/36，各有一次禁止调用；候选仍猜半秒，明确停止静默均 0/6。已恢复平台和仓库原角色及参数，ct68／ct45 不变。本批主机使用占位识别文本，ct67／ct68 的真实 STT 门禁不参与；完整路径不能由主机标签推断。

[文本模拟识别输入](validation/capture-recognized-input.md)已接入采集器，默认文本主机先等待输入，再注入原话，与历史占位和真实 STT 分开标记。二十四条新会话及终态均完成／匹配，严格调用 20/24，两次猜测动作被拒绝、两次多查状态保留；另复核旧占位和 STT 样本，未改写历史成绩。十五组软件检查含 93 项通过；固件、角色、平台配置及 ct45 部署不变。

## 原生数组研究收尾（2026-11-01）

[ct69 原生数组对照](validation/native-step-inputs.md)两组共 176 次文本会话完成，基线 77/80、5/8，候选 75/80、4/8；完整回执／终态均复算一致，候选因两组退步及禁止调用未采纳。十六组诊断软件检查通过不能抵消模型失败。主线源码已恢复 ct68，平台 5991 字符原角色和模型参数保存重开一致，板上最近记录仍为 ct45；实验以经 26 文件回读的补丁保留。独立 JSON 截断准入修复、误停、过程播报与原现场项目继续待完成。

ct70 独立完成[原始 JSON 截断准入修复](validation/mcp-raw-json.md)：普通及消毒器主机的 16 组通过，旧 ct68 同矩阵有 11 项不满足新约束；既有 88 条平台请求的回执和终态保持。完整构建和十六组统一检查通过，工具与角色未改，未部署；不提升原模型语义或现场成绩。

ct71 的[否定输入保护](validation/negative-input-admission.md)完成最终 46 组普通／消毒器、迟到／等待停止、分配失败和 BOOT 检查；24 次实际 STT 定向会话严格 23/24、控制状态 24/24，一次误停被拒绝。活动停止拒绝初版因五项反例撤回，最终版对全部实际捕获回执／终态复算一致。工具与角色未改，未部署；原模型语义、活动否定、过程播报和现场验收继续未完成。

[ct71 原 80／8 完整语音链路](validation/full-stt-ct71.md)已执行一次：全部结束，严格工具 77/80、6/8；八条停止正确，V064 误停被拒绝，V033／V075 多查询。四条逐字转写差异中三条是数字书写、一条“调／掉”同音，不能混称四条识别失败。88 条完整回执／终态均重放一致；包级回放发现普通点火仍放行 64 个确认包。固件／平台不变，原模型、播报与现场门槛继续未完成。

ct72 [效果确认播放](validation/effect-alias-feedback.md)复用完整 88 条实际 STT 轨迹，仅新增抑制普通点火的 64 个确认包；其余 85 条逐例计数保持，所有超限提示保留。81 条合成不一致均保留音频，原生夹具涵盖既有别名、模式及并发通道时长。源码候选更新，板上仍 ct45，模型语义及过程播报仍未完成。

最新[灵矽参考材料包](../tools/lingxi-solution/README.md)单列 `full_speech_scores` 复算 ct71 原 80／8 语音成绩，附 ct72 播放摘要；最近参考包 98 项包内离线测试通过；完整源码现有 124 项测试通过。历史文本及 ct62 未完成 V017 保留，包内最小评分轨迹不包含完整 RPC 事件。

[协议字段与参数对照](validation/tts-protocol-observation.md)完成 8+8 条实际 STT 和恢复后的独立停止：`action=thinking` 不能区分有效限幅提示；临时 none 导致统一异常并漏停，未采纳，原 low／角色已保存重开恢复。原固定集与 ct72／ct45 版本保持，过程播报仍未解决。

[模型工具轮中继原型](validation/llm-tool-round-relay.md)完成 17 项本地 HTTP／SSE 与策略测试，尚未采纳或接入平台。工具后分析仍放行，工具轮限幅文字也可能丢失，整轮缓冲时延未测；未更新模型成绩、固件或部署。

参考材料包已纳入中继源码、配置样例及 17 项回环 HTTP／SSE 测试，解压后共 98 项离线测试。样例只含环境变量名，原模型评分与未采纳条件保持，材料包不启动或绑定线上服务。

ct73 [四路组合播放匹配](validation/four-lane-feedback.md)完成十二条定向实际 STT：严格工具 10/12、逐字转写 11/12、完整回执／终态重放一致，新增抑制五条成功组合的 277 包，50 条不一致均保留。F004 共享时长误解、F010 识别与漏调用保留；原 88 条播放计数不变，18 组软件检查与构建通过，未部署。

参考包已纳入 ct73 十二条定向语音的摘要、失败、来源和播放对照；仍为 98 项包内测试，完整控制／音频包重放需要 checkout 与固定二进制，不新增完整评分组。

2026-11-01 用户再次暂缓实机验收，继续离线语义优化；ct76 未刷写。[精简角色对照](validation/concise-role.md)未采纳并恢复原配置；定向成绩不替换原固定集，未增加实际 STT／扬声器或实物成绩。
