miclle/cybertrack/docs/action-sequences.md

# 行走调速与动作序列

一次请求可以让行走和喷水同时开始、分别结束，也可以编排最多 16 步。普通语音直接请求动作。不提供编辑、保存或预览表演；“只预览”“先别执行”等请求不得转成动作。

## 速度与时长

2026-10-30 ct39 已部署：未说时长时，100% 速度（含省略速度）的左右转默认 880 ms；60–99% 转向、前进／后退及其他普通动作仍默认 1000 ms。单项、组合及序列每步均适用，明确指定或同一步明确共享的时长优先；组合中的喷水默认仍为 1000 ms。平台保存回读一致、设备仅应用更新并重启联网；用户确认 880 ms 测试效果符合预期，完整语音回归仍待逐项验证，见[角色维护](agent-role.md)及[部署记录](../firmware/esp32-audio/startup-ct39.json)。

`speed_percent` 为 60–100 的整数，省略为 100。`以 80% 的速度前进五秒` 对应 forward、5000 ms、80；`以 60 的速度左转三秒` 对应 left、3000 ms、60。最快为 100，不能把百分比当作实测轮速、距离或转角。超范围、非整数或无明确数值的绝对速度先澄清，不擅自截断。0 不作为移动速度；停止仍走统一停止或网页松开。

电机频率仍为 1 kHz，8 bit duty 使用 `(speed × 255 + 50) / 100` 整数换算：60 → 153、70 → 179、80 → 204、100 → 255。默认由 ct25 的 230 提至 255。同方向调速只更新 LEDC 占空比，不拉低使能、不改方向或脉冲其他通道；换向仍先关闭两路使能。任何输出 API 失败仍锁定全停。GPIO18 诊断保留。60% 下限来自用户动力不足的现场反馈，并非定量轮速或负载校准。

## 语音工具

| 工具 | 速度参数 | 行为 |
|---|---|---|
| `self.tank.move` | 可选 `speed_percent`，默认 100 | 指定速度执行原定时长 |
| `self.tank.move_and_water` | 可选 `speed_percent`，默认 100 | 仅影响行走，喷水保持原定时长 |
| `self.tank.sequence` | `steps_json` 每步可选 `speed_percent` | 五个动作字段仍必填；各步速度独立，省略为 100；全句指定速度由提示词填入各行走步骤 |
| `self.tank.set_speed` | 唯一字段 `speed_percent`，60–100 整数 | 直接设置当前移动目标速度；不启动、不改方向、不续时、不影响其他通道 |
| `self.tank.adjust_speed` | 唯一字段 `delta_percent`，仅允许 10 或 −10 | 对当前移动增减 10 个百分点，结果限制在 60–100；不启动、不改方向、不续时、不影响其他通道 |

“加速、加快速度、快一点”调用一次 `adjust_speed`／10；“减速、减慢速度、慢一点”调用一次／−10。例如 70 → 80，不是乘 1.1；100 加速仍为 100，60 减速仍为 60。接受后静默，拒绝不重试。停止或序列等待间隔中拒绝，不能用 `move` 补启动。票据绑定当前行走的启动计数及语音会话，重复 RPC、停止后迟到、跨步骤迟到均不能再次调速。

调速适用于当前语音、网页和狂暴模式的移动；序列只改变当前步骤，后续步骤保持原定速度。网页正在行走时，语音加减速同步更新网页速度偏好和显示，但不更新长按租期，仍由原网页续租或松开停止。语音启动新移动仍遵循网页同路优先；当前移动的绝对及相对调速均允许此交互。

“减速到 60%”“加速到 80”“速度调到 70”调用一次 `set_speed` 设置目标，不连续调用相对调速，不重新启动行走。单独“全速／最快／最大速度／调到全速”均调用 `set_speed` 设置当前速度 100%，不追问方向或时长；空闲时不启动。“全速前进／后退／左转／右转”先查询状态：空闲调用 `move` 启动对应方向，左右转默认 880 ms、前进／后退默认 1000 ms，显式时长优先；正在同方向移动只调到 100%，原截止不变；不同方向不自动停止换向。仅明确移动语境的“全速后台”按后退纠错；软件后台等语境不触发动作。

## 网页滑块

方向键上方新增“网页速度”滑块，范围 60–100%，新网页控制会话默认 100；重新连接恢复默认，不写入 NVS。闲置时设置仅影响后续网页动作，不启动电机；网页行走或狂暴模式中设置立即修改其电机输出，不改变到期时间、长按 ID／续租序号、动作启动计数或效果输出。语音自己的指定速度与序列步骤不会被闲置网页的偏好覆盖。

滑块每次以新鲜状态窗口提交 `POST /api/action`：

```json
{"operation":"set_speed","sequence":1,"window":1,"speed_percent":80}
```

须使用现有会话令牌及 Host／Origin 校验；整数、字段数、窗口与请求序号校验不变。此操作返回 `ok`，不是启动动作的 `accepted`。不增加单独端点。快速拖动只保留最新待提交值，串行提交；停止、隐藏、断线使过时请求失效，不重试或回放。持续行走的续租不等待滑块请求。

状态提供 `speed_min_percent=60`、`speed_max_percent=100`、`capabilities.speed_control=true`、`web_speed_percent` 和 `move_speed_percent`。后者为当前行走设置百分比，未移动为 0；`logical_outputs.left/right` 为带方向的 −100…100 设置值。滑块依据设备回执同步，移动状态额外显示当前百分比。旧固件缺少能力时滑块禁用。

## 序列工具与执行契约

`self.tank.sequence` 仅接收字符串 `steps_json`，内容为 1–16 个步骤组成的 JSON 数组。上游工具属性仅支持标量，因此使用 JSON 字符串；调用时应正规 JSON 编码，不直接传数组。每步必须包含以下五个动作字段，仅另可选填行走速度 `speed_percent`，不接受缺失、重复或额外字段：

| 字段 | 范围／语义 |
|---|---|
| `direction` | forward/backward/left/right；本步不行走时为 none |
| `move_ms` | 0 或 1–2147483647；none 时必须为 0，否则必须大于 0 |
| `water_ms` | 0–30000 |
| `bubbles_ms` | 0–30000 |
| `ignition_ms` | 0–5000 |

0 表示本步不用该通道，各时长必须为整数；每步至少一个通道。字符串最多 4096 字节，拒绝尾随内容。先校验整单再签发会话内一次性票据；执行前复验，并要求四路均空闲、冷却结束且没有网页活动通道或狂暴模式。单次接受保留四路，期间新的独立语音动作拒绝；网页正常连接、心跳和释放不会取消语音序列，有效网页动作请求优先取消整单并返回 `voice_preempted`，不会立即启动网页动作，需间隔结束后新指令。

同一步所有通道在同一互斥区更新、同一轮应用输出，逻辑上原子接受或拒绝；GPIO 写入仍是顺序 API 调用，不承诺物理边沿严格同步。各通道独立截止；全部停止并满足冷却后才开始下一步。行走／喷水／泡泡停止后至少间隔 200 ms；点火关闭间隔至少等于实际软件 ON 时长。步骤间隔由设备控制，不需要模型等待或再发工具调用。控制循环只访问固定 16 步存储，无 JSON 解析或堆分配。延迟 tick 不补赶遗漏动作或缩短间隔。

统一停止、BOOT、语音连接关闭、Wi-Fi 丢失、关机／升级入口、输出故障、时钟倒退及网页抢占均取消当前和全部后续步骤；松开／恢复连接不恢复。票据过期、重复、取消及忙碌不自动重试。不能借序列分割一个超限效果或擅自循环。

## 回执与验证边界

`result=accepted` 仅表示序列开始。状态含 `sequence_active`、`sequence_step`（从 1 开始）、`sequence_steps`、`sequence_result`（idle/running/waiting/completed/cancelled）及 `sequence_max_steps=16`。间隔中仍为 ACTIVE；最后一步结束即 completed，不要求等待最终冷却结束。历史进度保留供查询，新序列开始时重置。`remaining_ms` 只代表当前通道的最大剩余时长，不能作为整条序列倒计时。网页显示序列执行、等待或取消状态。

## 现场记录

ct24 直接语音组合与后续并发步骤均观察到喷水。左转一秒、喷水三秒时，两路分别在 1001 ms 和 3001 ms 关闭。另一次运行中语音停止取消了后续步骤。首次出水仍观察到轻微滞后，精确时差与原因待测。[现场日志](../firmware/esp32-audio/field-ct24.json)

ct27 现场反馈确认运行中调速生效。单独说“全速”时记录到 60% → 100%，行走启动计数和原截止时间保持。ct39 的全速左右转默认时长获得用户反馈，地面转角和停止距离另行量测。[ct27 调速记录](../firmware/esp32-audio/role-full-speed-ct27.json) · [ct39 部署与反馈](../firmware/esp32-audio/startup-ct39.json)
