miclle/cybertrack/docs/improvement-plan.md

# CyberTrack 产品改进执行计划

2026-11-01 范围变更：I06／I07 已由用户取消；下方逐版本记录为历史证据，不要求恢复已退役功能。

启动日期：2026-10-31。目标是让陌生用户容易上手、语音准确、玩法可重复、整机可靠，并将 SolidCue 接入原生 CAD 设计流程。项目名称继续使用 CyberTrack。

用户已授权本计划的实现、关联文档、必要验证及分阶段提交；2026-10-31 后续更新目标，明确增加分阶段 Git 推送授权。公开发布、部署或代发招募消息不由推送授权自动扩展。2026-10-31 用户确定首批用户为家长陪同的亲子用户，并说明暂时无法配合实机测试，因此先完成独立的软件与设计工具工作，现场项保持待验证。高压点火接线及通电测试不在本计划范围内。

2026-11-01 用户恢复现场配合，确认主控独立供电并在切断执行器功率后明确授权 ct73 部署。现已完成仅应用写入与无动作回读；[现场阶段](validation/ct73-deployment.md)继续采集短动作、停止、语音组合与负载，不改变原退出条件。

## 执行与完成条件

状态以本表为准，TODO 链接本计划；当前交付依据与缺失条件见[交付核对表](validation/delivery-audit-current.md)。软件实现、主机测试、平台配置、设备部署、真人体验和物理验收分别记录。文档或测试工具完成不能将对应实机项标为完成。

| ID | 范围及交付物 | 完成条件 | 当前状态 |
|---|---|---|---|
| I01 | 首批用户定位、5 人体验脚本与结果表 | 至少 3 人主动重复同一玩法；形成实际定位判断 | [离线观察单与按家庭统计方法](validation/README.md#从五份原始观察复核两项指标)已具备；实际五组试用与定位判断待现场 |
| I02 | 开机到首次动作的上手卡、状态与故障指引 | 5 人中至少 4 人在约定网络条件下 3 分钟内独立使用并停止 | 上手卡与网页帮助已随 ct45 部署；设备页面回读通过，真人项待完成 |
| I03 | 80 条文本语义用例、20 条真人语音用例及独立评分器 | 固定集工具参数准确率 ≥95%；禁止动作样本误启动 0；真人另报 | 最新[原 80／8 合成普通话全链路](validation/full-stt-ct71.md)为 77/80、6/8，八条明确停止正确，V064 模型禁止调用仍失败。[ct73 定向播放](validation/four-lane-feedback.md)12 条严格 10/12，不替换固定集；真人拾音、成功静默和扬声器待验。历史对照与当前缺口统一见[交付核对表](validation/delivery-audit-current.md) |
| I04 | 按来源区分的停止／断网／恢复矩阵、采集与分析工具 | 每条件至少 5 次；旧动作不恢复；输出及机械停止分开测 | ct45 与 ct51 的[17 类固件回放](validation/stop-trials.md#已部署版与候选版的固件主机回放)各通过五个触发时刻；网页静默断线在租期内仍可能进入下一步。现场记录按配置独立统计，当前为空 |
| I05 | 电源、续航、成本记录及计算工具 | 3 次相同典型流程的真实记录；额定限制明确，成本有来源 | 已有电源预算、同工况续航汇总、采购实付与报价分账及 [Lean 六盘耗材／机时估算](../hardware/model/lean-print/README.md#打印一套需要多少耗材)；实际料价、采购、装配与三次续航实测待补 |
| I06／I07 | 已取消：独立表演编排及模板 | 2026-11-01 用户决定退役，不再作为交付门槛 | 组合动作与序列保留；见[退役验证](validation/theatre-removal.md) |
| I08 | 基于真实回执的“为什么没动”解释 | 原因覆盖、缺数据不猜测、无额外启动／重试 | 只读帮助已部署；ct47 三轮定向回复均正确说明驱动故障处置、步骤间等待和草稿喷水限制。[ct49 时序对照](validation/lingxi-ct49.md)中三次时长回复均标明采样时刻，[新角色](validation/status-role-focus.md)三轮方向原题均只答前进，后退与速度问法仍会多报另一项。[ct50 三轮对照](validation/lingxi-role-5991.md)中长按结束时间解释 3/3，定时动作仍推测播报时已停。真人和实物反馈待验。[故障定向记录](validation/lingxi-ct47.md) |
| I09 | 补液、清洁、取瓶、电池及线束维护基线 | 最慢两项耗时降低 ≥30%；10 次拆装与故障记录 | 当前整机已回读[清水瓶上提 150 mm 路径](../hardware/model/water-bottle-service.json)，清水管需先收妥。[维护计时与拆装分析](validation/README.md#维护与修改效率)区分实物、模拟和来源不明的观察。真实记录为空，最慢两项及结构修改须待实物基线 |
| I10 | 当前版本真源、统一检查、修改效率记录 | 当前／历史不混淆；命令可复现；5 次真实修改数据 | 当前版本、源码／部署应用摘要检查、十八组统一检查与分阶段交付已具备。37 条技术记录闭合，完整实际效率样本仍为 0/5；未知人工／等待／返工字段不以提交间隔补算。[本轮核对](validation/delivery-audit-current.md) |
| I11 | 仓库内模型设计工具、整机评论与位置研究、单件参数修改／恢复 | FCStd 为依据；独立副本；版本／目标／非目标校验；本地 UI 与宿主卡片证据分列 | 已完成接入验收：0.9.2、198 件整机，真实宿主消息独立触发 GUI 修改／保存重开／恢复，同一卡片 r9 → r10 → r11 及最终回执通过；源码、截图与历史单件验证已交付 |
| I12 | 电源、保护、噪声／回流、接口、部件造型及最佳实践硬件架构 | 完成 H01–H06 交付与检查；电气／装配／负载实测独立验收 | 架构、电源预算工具、接口／回流及来源矩阵已交付；实物／定值待验证 |
| I13 | 灵矽实体机器人解决方案章节、参考交付包与分层证据 | 明确平台价值、真实链路及可复制方法；实际调用／家庭体验分别验证 | [参考包](../tools/lingxi-solution/README.md)可分别复算七组历史文本与完整 STT 评分，保留禁止调用、漏停、超时及畸形参数；98 项包内测试通过。模型失败、家庭和实际效果仍待收敛；[当前核对](validation/delivery-audit-current.md) |

## 灵矽解决方案主线（I13）

2026-10-31 用户强调比赛主要目的是为灵矽提供解决方案。CyberTrack 的 AI 交互以灵矽为基础，不能在展示中淡化平台关联。新增[独立方案章节](lingxi-solution.md)，覆盖亲子场景、语音到设备链路、工具与角色契约、云端／本地职责、硬件与维护、分层验证、可复用交付包、推广假设与平台反馈建议。

交付条件：README 有醒目独立章节；事实与规划分列；参考接入／角色／设备／硬件／验证材料能相互追溯；实际平台调用与用户体验证据另行完成。原方案、规划功能和对平台的建议不混写，不声称官方认证或合作。

## 硬件架构专项（I12）

2026-10-31 用户追加：架构设计同时覆盖软件和硬件，纳入电源规划／管理、元器件造型及有来源的社区硬件架构实践。本专项是持续目标的组成部分，与 I04／I05／I09／I11 交叉引用，不另立一套验收真源。

| 子项 | 明确交付物 | 退出条件 |
|---|---|---|
| H01 电源架构 | 当前 5 V 电池、主控、12 V 电机和效果支路的电源树；静态／启动／组合负载预算；未知项清单 | 每个预算标明实测／规格／推导／假设；不得用容量或模块广告功率代替供电通过 |
| H02 电源管理与保护 | 上电默认关闭、欠压／复位行为、主控保活与独立执行器断电、保险／反接及连接器选型依据 | 与现有 A2 图纸、实际模块版本和待选 U2/U3 一致；定值／封装未确认不标制造放行 |
| H03 噪声与回流 | 电机／效果／音频供电与地回流图、去耦位置、线束分区及测点 | 不跨接受控 MOS 回流；噪声假设有可区分的测量方案；软件日志不代替电源波形 |
| H04 接口与维护 | 接口控制表、实际针序／电压／方向／线径／端接／应力释放、独立拆装单元 | 接线表、原理图、固件和 CAD 引用一致；未知实物针序不猜定 |
| H05 元器件造型 | 部件包络／真实外形／禁布与维护空间分层，机械参数来源与公差记录；SolidCue 单件适配 | 只读部件不覆盖；FCStd 为依据；不从照片比例补接口尺寸；装配验证与几何检查分列 |
| H06 最佳实践与取舍 | 官方设计指南、开源社区参考的来源／版本／许可与采纳矩阵 | 每项写适用条件、实际采纳点和验证方式；不复制未知来源设计或把参考平台参数直接移植 |

实物缺失项保持待验，先交付架构、接口、预算计算及检查工具。硬件接线、采购、制板与高压测试不因规划条目自动执行；依现有授权和证据分阶段推进。

## 分阶段交付

1. **基线与验证入口**：I10，收敛当前能力，保留历史记录，建立阶段证据。
2. **上手、语义与回执解释**：I02、I03、I08，同时准备 I01、I04、I05、I09 的真实采集材料。
3. **模型辅助设计工具**：I11。支持整机可见形状预览、评论、静态零件位置研究及单实体参数修改；任意草图、约束装配和跨版本拓扑编辑不在当前支持范围。
4. **组合动作与停止回归**：保留直接语音序列，核验并发截止、取消与不恢复；I06／I07 已取消。
5. **硬件架构与设计收敛**：I12，联合 I04／I05／I09／I11，先形成电源树、预算、接口与部件建模依据，再决定实际器件或结构变更。
6. **现场收敛**：完成前述现场项目及实际结构改进；用户具备条件后执行，不提前声称总体目标完成。

每阶段提交仅包含本范围文件，并记录检查命令、结果及限制。编译与主机检查不自动刷写设备或更改在线角色。当前已部署版本见[当前状态](current-status.md)，源代码发生变化时须更新候选状态。

## 产品与原创性

家长负责首次连接、动作启动和停止，孩子可参与命名、语音互动和观看；具体年龄与使用环境待用户研究明确。首轮亲子体验不包含点火；当前样机不宣称已通过儿童使用验收。

核心体验围绕小D 的角色、履带与泡泡效果；电路工作台和芯片模拟器不是本阶段产品目标。SolidCue 是用户已有的独立工具，本项目新增价值是将空间评论、原生修改、回读和恢复接入 CyberTrack 单件设计；不将既有上游能力描述为本项目从零实现。

用户体验指标是探索目标，未达标应修改假设而非补造结果。性能和成本以实测与实际采购为准；不得凭百分比 PWM 承诺轮速、角度或位移。

## 阶段 1 验证（2026-10-31）

`python3 scripts/verify_improvements.py --source build/xiaozhi-ct42-src` 已通过版本元数据、差异格式、现有控制主机回归、实际 MCP／HTTP 适配和实际音频适配检查。日志位于本地忽略目录 `output/improvements/checks/20261030T161832987845Z/`（UTC）。本阶段未改固件行为、未重新交叉编译、未部署或触发执行器。历史能力原文保留在 `firmware/CAPABILITIES-history.md`。

## 阶段 2 材料与评测入口（2026-10-31）

已提供[亲子上手卡](quick-start.md)、[验证材料](validation/README.md)、80 条文本工具语义用例、20 条口述引用及评分器。`python3 -m unittest discover -s tests/improvements -v` 的 5 项测试通过：缺例／重复拒绝、禁止动作单独门槛、名称与默认值归一、参数类型区分、口述索引完整性。合成数据仅用于评分器单元测试，不是模型识别结果；线上模型与家庭试用尚未运行。README 已突出已实现及规划亮点。

## 阶段 3 SolidCue 原生接入（2026-10-31）

已交付[固定版本与操作入口](../tools/solidcue/README.md)。独立电池承托垫研究件通过原生参数修改／恢复、旧指纹拒绝、六面映射和版本拒绝；生产 FCStd 哈希未变。插件构建／bundle 协议检查通过。真实桌面评论、原生工具调用与同卡片更新待 FreeCAD MCP 连接和插件重载，不以合成评论代替。

## 阶段 5 硬件架构初版（2026-10-31）

已交付[硬件架构](../hardware/architecture/README.md)与带证据来源的电源预算工具，覆盖 H01–H06 的设计资料。对照 A2 保留 U2/U3、保护定值、SW2 额定及实际针序等未闭合项；未知电流不会按零计入，也不从电芯容量推续航。真实数据六场景均显示数据不足，算术／缺项／重复计入／非有限值／峰值比较回归通过。未改生产模型、原理图定值或现场接线。

## 灵矽参考材料交付（2026-10-31）

`python3 scripts/package_lingxi_solution.py` 通过明确文件清单生成本地 ZIP，包含角色、能力契约、上手卡、语义评测、硬件与 SolidCue 接入材料，附逐文件哈希与证据范围；不上传、不部署。清单隔离、路径与符号链接拒绝、哈希和确定性测试通过。该材料包不含完整源码／CAD 或真实模型／家庭验收结果，完整方案按 I01–I13 继续推进。

## 阶段 2 交互与状态解释（2026-10-31）

ct43 候选新增[上手帮助与状态解释](status-explanation.md)，将当前状态和最近动作请求分开陈述，不猜测未细分原因、不启动或重试。固定记录及实际 Reply 回归、网页原脚本与三种视口浏览器检查通过；完整编译与文件哈希见固件证据。ct42 仍是最近记录部署，本次不更新平台角色或刷写。

## 阶段 6 现场记录分析入口（2026-10-31）

I04 新增[停止记录与离线分析](validation/stop-trials.md)：17 个来源／阶段案例，每配置各 5 次；输出延迟、机械停止与距离独立统计，来源隔离错误和旧动作恢复单独报告。相同事件不得换编号充当多次，缺测不按零值，软件模拟不计物理覆盖，五条成功不能掩盖额外失败或未闭合记录。9 项新增合成回归通过，含 85 条空白记录生成和已有文件保护；仓库真实记录为空，不能将工具交付视为现场验收完成。参考材料包已包含分析器及其测试。

## 阶段 1 工程记录补齐（2026-10-31）

I10 新增[实际修改记录](validation/engineering-log.md)：开始时记录当前提交和 UTC，结束时绑定新提交与验证文件哈希；同一提交不重复计数，不覆盖旧记录，不把墙钟时间当人工或模型等待。7 项新增回归覆盖缺值、重复、时钟倒退、哈希变化与证据缺失。历史阶段未实际计时，保持未知，当前完整样本为 0，不声称效率改善比例。

同轮复核 SolidCue：固定 checkout／构建可用，FreeCAD RPC 拒绝连接；桌面工具报告 Mac 锁屏。已请求解锁后继续检查，未修改生产模型或重建已有研究件。桌面卡片与同卡片原生修改／恢复仍待完成。

## 阶段 3 实际插件安装（2026-10-31）

发现此前只构建而未安装 SolidCue。本轮已将固定 checkout 登记为本机 marketplace，安装并启用 0.8.0，启动使用 CyberTrack 独立目录的本地服务。新增[实际安装检查](../tools/solidcue/README.md)，核对缓存字节、13 个工具、UI 资源和实时状态；未调用写工具，文档仍为空。FreeCAD RPC 仍未连接，本对话尚无重载后的 SolidCue 工具，真实卡片不以 SDK 协议通过替代。安装过程已开始真实工程计时，未观测的人工／模型等待仍留空。

## 早期验收快照（2026-10-31）

[逐项交付核对](validation/delivery-audit-20261031.md)保留 I01–I13 的全部完成条件。ct45 源码／二进制与验证记录匹配，SolidCue 已安装并完成协议检查；真实平台、家庭、停止、供电和维护记录仍缺，完整工程样本 0/5。桌面锁屏与 FreeCAD RPC 未连接已连续复核；需恢复桌面连接及后续现场条件才能推进剩余关键路径。此段记录当时条件。此后模型设计已通过本页 I11 所列宿主验收，灵矽真实平台隔离联调见 I03 和 I08。

## 整机模型辅助设计扩展（2026-10-31）

用户追加要求：README 聚焦 CyberTrack 自身价值，使用完整整机在工具中调整的真实截图。I11 扩展为整机浏览、按零件／面评论、独立研究副本原生位置调整与恢复；静态零件不宣称任意尺寸可参数化。源码位于 `tools/model-design/`，保留来源和 Apache-2.0 许可证；原单实体 STEP 验证接口继续保留。

新增退出条件：完整可见整机实载、真实卡片评论绑定目标、FreeCAD 原生修改、非目标零件保持、同卡片更新／恢复、原始 FCStd 哈希不变、README 真实操作截图。整机网格只作设计预览，不以此宣称 STEP 往返、干涉、装配或制造通过。

### 整机本地闭环与交付证据

0.9.2 已安装。198 个可见零件加载；在实际本地 UI 保存冠盖评论，FreeCAD 主机进程执行 Z=0 → 8 → 0 mm；MCP 发布使同一页面更新 r3 → r4 → r5。保存后回读确认全部原生指纹恢复，其他 197 件预览不变，正式 FCStd 哈希不变。整机截图进入 README，29 项核心测试、打包、合成宿主界面与实际安装协议检查通过。见[验证记录](../tools/solidcue/verification-assembly-20261031.json)。

- [x] 仓库内交付源码、固定来源和许可证，完整整机本地展示与真实截图。
- [x] 版本绑定评论、原生位置修改、同一本地页面更新、保存回读与恢复。
- [x] 解锁并恢复 FreeCAD RPC；真实 GUI MCP 修改／恢复后保存、重开，198 个指纹和 217 个显示状态一致；本地页面 r5 → r6 → r7。修复无界面快照材质归档顺序并以真实 GUI 回读验证，见[GUI 记录](../tools/solidcue/verification-gui-20261031.json)。
- [x] 重载 0.9.2，实际宿主卡片保存冠盖评论、显示消息已被接受；经 MCP 显式读回与回执后，GUI 修改／恢复发布到同一卡片 r7 → r8 → r9，保存重开及非目标校验通过。README 使用宿主 r8 实拍，见[宿主记录](../tools/solidcue/verification-host-20261031.json)。
- [x] 真实 `mcp_app` 消息独立触发尚未处理的 r9 冠盖评论；原生 Z=0 → 4 → 0 mm，GUI 保存重开、197 件非目标保持、原卡片 r9 → r10 → r11 及最终 AI 回执通过。迟到的已完成 r7 评论只核对历史并回执，未重复执行。见[消息驱动验收](../tools/solidcue/verification-message-20261031.json)。I11 在上述已声明的静态零件位置研究范围内完成；不扩张为任意参数化或制造验收。
- [ ] 亲子体验、供电、停止、维护与儿童使用现场验收继续按原表推进；截图与 CAD 检查不替代这些验收。

## 统一软件检查扩展（2026-10-31）

I10 增加 `--model-design`，将仓库内模型设计核心测试、插件打包和合成宿主界面纳入统一检查；准备树与工具依赖先校验，源码哈希排除依赖、研究数据和生成物。`python3 scripts/verify_improvements.py --source build/xiaozhi-ct45-src --model-design` 的 10 项命令全部通过，报告记录 64 个模型工具源码文件，见本地 `output/improvements/checks/20261031T013311167713Z/report.json`。无效准备树在执行前拒绝且不产生半成品报告。此记录不增加真实平台、桌面宿主或现场验收结论。

## ct45 部署与无动作设备验收（2026-10-31）

用户明确授权继续部署与灵矽联调。已核对原 ct42、分区与 OTA 选择，备份应用／配置，仅写 `0x20000` 应用区；回读校验通过，其余 Flash 区域保持。两组 Wi-Fi 及用户配置保持，启动仅刷新 WebSocket 令牌。5994 字符角色保存重开逐字一致，其他可见配置保持。两次启动联网、设备网页源码及 39 条零启动回执已核对；草稿创建、单步修改、旧版本拒绝、删除、取消、停止／释放失效及重连不恢复通过。见[部署证据](../firmware/esp32-audio/startup-ct45.json)。未提交有效表演确认；平台模型调用、真人与带载项目不因此关闭。

## ct45 平台隔离联调与设备补验（2026-10-31）

[完整记录](validation/lingxi-ct45-20261031.md)保留固定集、无前缀诊断、夹具缺陷修正及逐条回复审阅。真实设备草稿在 470 次采样后按五分钟失效，六类非法输入拒绝，始终零启动。80 条工具匹配达标不关闭成功静默／解释语义；编排仍未达标，后续以针对性修正和完整回归收敛，不放宽评分。

## ct45 角色反馈修正（2026-10-31）

5998 字符角色已保存回读并重启，固件仍为原 ct45。草稿禁用通道拒绝与含糊时长澄清的实际行为改善；版本查询顺序、静默和部分故障解释仍未通过，见[修正与独立复测](validation/lingxi-ct45-role-feedback-20261031.md)。纯角色同步与固件烧录分别记录，不能因同步成功关闭模型验收。

## 停止说明对照（2026-10-31）

I03／I06／I13 的 ct65 说明诊断已完成 106 次隔离文本会话。固定语义 77/80、编排 6/8，八条明确停止正确；出现 V064 误停和 V079 含糊请求擅自前进，因此未采纳。主线恢复 ct63，平台角色不变、未部署；十二组软件检查通过不代表模型门槛通过。[原始记录、恢复及下一步](validation/stop-negation.md)

## 即时停止回执修复（2026-10-31）

I04／I08／I10 增加 ct66 候选：已校验的全停同步完成并回复，不再留下第二次排队回调。八组实际 MCP 调度、回执分配失败与十三组统一检查通过；十二项公开定义与角色不变。旧动作／查询代际隔离保持，最新部署仍为 ct45；模型含糊误动作与实体停止验收未完成。[证据与命令](validation/stop-dispatch.md)

## 相对改稿设备约束（2026-10-31）

I03／I06／I08 增加 ct67 候选，对可识别且无量化片段的相对改稿要求澄清，同轮补做隔离继续有效。十三组原生回放、十四组软件检查通过；二十条定向合成语音转写／终态均匹配，严格调用 14/20，在线未尝试猜测修改。量化归属、未知表达、误调停止和过程播报仍待修，不将该门禁当作完整意图理解；候选未部署。[范围、证据与复核](validation/history/relative-draft-duration.md)

## 泛化动作的首次执行约束（2026-10-31）

I03／I04／I08 增加 ct68 候选，针对可识别的泛化动作类别拒绝首次猜测执行，保留草稿编排、查询、全停和可信网页。二十六组原生、十五组软件检查与完整构建通过；二十条定向合成语音实际转写和终态均匹配，严格调用 16/20，三次猜测执行在回调被拒绝。模型猜测和一次多余查询仍是失败；词语归属、误停、过程播报及部署／现场验收继续未完成。[范围与复核](validation/vague-action-admission.md)

## 意图分流角色对照（2026-10-31）

I03／I06／I08 的 72 次文本对照未采纳。两组严格匹配均 29/36；基线误停清稿，候选误猜半秒，停止均不静默。原角色与参数已保存恢复；ct68 候选与 ct45 部署不变。下一阶段优先改进工具输入结构及播报出口的定位，继续保留所有原验收门槛。[完整边界](validation/intent-routing-role.md)

## 文本诊断输入链路（2026-10-31）

I03／I06／I10 增加模拟识别原话，实际主机语义门禁现参与新的文本诊断；历史占位、模拟原话、真实 STT 分别标识。二十四条会话复算一致、预期终态均匹配，严格工具 20/24，两次猜测动作被拒绝，另两次多查询；模型失败保留。十五组检查及 93 项改进测试通过。后续验证编排数组 schema 与实际解析，原模型、部署及现场退出条件不变。[实现与边界](validation/capture-recognized-input.md)

## 原生数组步骤评估（2026-11-01）

I03／I06／I10／I13 的[结构化步骤研究](validation/native-step-inputs.md)已完成：两组各 80／8 条真实平台文本会话，均使用模拟识别原话及固定实际 MCP 主机；基线 77/80、5/8，候选 75/80、4/8，完整回执及终态全部重放一致。候选不满足事先不退步门槛，未采纳，主线恢复 ct68、平台恢复原角色与参数。诊断源码、构建、软件证据和全部失败保留；JSON 零字符截断准入另行提取验证。原语义、播报、设备及家庭退出条件不变。

I03／I04／I06／I10 的 [ct70 编码准入修复](validation/mcp-raw-json.md)已独立交付候选：16 组普通／消毒器回放通过，原 SDK 字符串入口和 88 条历史兼容有证据；构建和十六组软件检查通过。参数／草稿不因零字符前缀被误接受，合法停止保留；未部署，原模型及现场退出条件不变。

I03／I04／I06／I10／I13 的 [ct71 否定输入保护](validation/negative-input-admission.md)完成最终 46 组原生／消毒器和 24 次真实 STT 定向验证。严格工具 23/24、控制状态 24/24；活动停止拒绝初版因五项反例撤回，最终重放全部捕获一致。只完成否定写入与空闲草稿保护，活动／等待全停保留；原固定集、过程播报、部署与现场退出条件保持。

I03／I06／I13 的[原 80／8 语音链路](validation/full-stt-ct71.md)已完成：合成普通话经真实 STT，固定实际 ct71 主机，全部结束，严格工具 77/80、6/8，八条停止通过；88 条完整回执／终态复算一致。V064 误停被拒绝仍计失败，数字书写与“调／掉”同音分别说明，模型、扬声器和现场退出条件不变。

I03／I08／I10 的 [ct72 效果播放匹配](validation/effect-alias-feedback.md)已补齐既有别名及模式，并改用通道独立时长；完整 88 条回放仅新增抑制普通点火 64 包，81 条不一致保留音频。模型、角色与平台不变，最近部署仍 ct45，规则分析和物理验收继续未完成。

I03／I06／I13 增加[协议字段与 none 对照](validation/tts-protocol-observation.md)，候选不兼容表现和恢复证据均保留；`action=thinking` 不作为音频过滤依据，过程播报仍需模型与 TTS 之间的明确出口，原退出条件不变。

I03／I06／I13 的[工具轮播报中继原型](validation/llm-tool-round-relay.md)已完成本地 HTTP／SSE、完整工具参数及工具结果闭环测试；尚未配置真实模型／托管。最终分析、必要限制和时延反例作为采纳门槛，17 项本地测试不关闭原目标。

I03／I08／I10 的 [ct73 四路组合播放](validation/four-lane-feedback.md)已完成候选：70／87 原生、十二条实际 STT（严格 10/12）、新增抑制 277 包及五十条不一致保留；原 88 条计数、工具、角色与平台不变。十八组检查及构建通过，F004／F010 和过程播报继续失败，未部署，不关闭模型与现场门槛。

I04／I10 的 [ct75 HTTP 零转义校验](validation/http-zero-admission.md)补齐网页请求被 cJSON 截断为合法前缀的缺口；旧版原生反例和修正后的 HTTP 回归保留，完整构建通过。软件阶段结束时源码候选 ct75、设备为 ct74；ct74 首轮对话听感反馈及用户跳过的后三项记录保持，该阶段未安排重测或新部署。

2026-11-01 用户随后授权 ct75 仅应用部署，已完成[配置比较、两次启动和 22 次无动作 HTTP 检查](validation/ct75-deployment.md)。首启的严格 NVS 比较失败保留，复核 Wi-Fi／用户设置保持、PHY 校准与连接令牌变化明确列出；合法查询／取消／空闲停止可用，未重新安排已跳过的听感检查，也未扩大物理验收。
