miclle/cybertrack/docs/lingxi-solution.md

# 灵矽亲子机器人解决方案

ct78 已移除独立表演编辑与预览；下方 ct45–ct77 评测均为旧版本历史证据，不代表 ct78 已完成线上语音验收。

CyberTrack 的 AI 交互基于灵矽。项目面向家长陪同的亲子用户，把灵矽的语音与智能体能力连接到可观察、可停止、可维护的实体机器人，探索从对话体验到硬件产品交付的完整路径。本章是比赛方案主线；技术接入细节见[灵矽接入](architecture.md)和[角色维护](agent-role.md)。

以下区分当前实现、开发计划和对平台的建议。不代表灵矽官方产品承诺、认证、商业合作或量产验收。

## 1. 从“能聊天”到“共同创作”

核心场景是家长和孩子共同提出、理解并观看机器人行为。当前源码支持语音对话、状态查询、行走、喷水、泡泡与组合动作；一句话可表达先后与同时关系，由本地序列执行器调度。

灵矽承担自然语言理解、角色表达与工具选择，CyberTrack 将其转为有限、可验证的设备行为。价值假设是让不懂编程的家庭也能参与机器人创作，而不是要求孩子记忆全部按钮或开发接口。通过五组家庭的独立上手与主动重玩行为验证，尚未获得这些用户结果。

## 2. 当前实际接入链路

```mermaid
flowchart LR
  Family[家长与孩子的语音] --> Device[ESP32-S3 音频设备]
  Device <--> Lingxi[灵矽语音与智能体]
  Lingxi --> MCP[同一设备会话的 MCP 工具]
  MCP --> Guard[设备参数校验／来源仲裁／截止与取消]
  Web[手机局域网网页] --> Guard
  Stop[本机 BOOT／全部停止] --> Guard
  Guard --> Outputs[履带与效果低压控制]
  Guard --> Receipt[逻辑回执与测距状态]
  Receipt --> Lingxi
  Device --> Expression[扬声器／OLED]
```

日常设备路径不需要电脑代理或另建用户云服务。电脑用于开发、验证及 SolidCue 辅助设计，不能将设计工具的存在误写成机器人运行依赖。

现用 `esp32-audio/` 基于固定小智版本，保留设备绑定、音频、OLED 与唤醒路径，提供十一个 `self.tank.*` 工具。当前部署依据见[状态入口](current-status.md)；独立联网台架的认证与许可机制不是当前面包板的部署事实。

## 3. 让模型调用稳定落地：明确的能力契约

| 问题 | CyberTrack 的做法 | 可复用交付物 |
|---|---|---|
| 自然语言有别名、否定、引用和歧义 | 角色规定语义与默认值，模型只选择受限业务工具；含糊时澄清 | 版本化角色源、80 条工具语义回归集 |
| “先做／同时做”容易被多次调用打乱 | 一次提交有界序列，设备负责步骤内并发与步骤间时序 | 序列参数、解析、取消与独立截止测试 |
| 网络或模型重试可能重复动作 | 参数、来源、请求时效及会话内重复校验；失败不自动补做 | 工具返回约定与过期／重复测试 |
| 返回成功容易被理解为物理完成 | 区分传输成功、请求接受、逻辑运行和物理反馈 | 状态字段、错误分类与真实结果话术 |
| 云端延迟不应阻塞本地停止 | BOOT、截止、断线处理与近距离保护在设备执行 | 本地控制实现和实机验收矩阵 |

上述机制限制的是软件行为，不能替代器件保护或物理停止性能验收；现用会话防重放不承诺跨启动持久化。

## 4. 家长陪同体验与角色设计

家长负责连接、启动、停止与设备管理，孩子参与提议、修改和观看。首次亲子流程不含点火或狂暴模式。具体年龄、场地、隐私说明与适用性需通过后续研究和实物验收确定；不能因角色友好或使用陪同就宣称儿童使用通过。

对灵矽落地的贡献是可复用的场景角色、工具约束、家庭上手卡和异常对话素材，进度见[执行计划](improvement-plan.md)。

## 5. 软件与硬件共同定义可交付的设备

模型工具表达“移动”“吹泡泡”等业务能力，不暴露任意 GPIO。电机驱动、电源分域、受控回流、保护、线束和维护结构由设备工程约束。更换模块时，须同步接线、固件、原理图、部件模型与验证，不以提示词掩盖电气差异。

[I12 硬件架构专项](../hardware/architecture/README.md)已交付电源树、负载预算工具、保护与断电、音频噪声、接口和部件造型的设计资料；定值与实物证据继续闭合。SolidCue 接入提供带位置与版本的三维评论和受限原生修改，服务硬件迭代；它是设计工具，不是灵矽现有云端 CAD 功能。

这使解决方案可以交付“设备能力契约＋角色＋参考硬件＋验证方法”，而不止一段提示词和演示视频。

## 6. 联网、异常与日常使用

当前已实现普通多 Wi-Fi 按顺序尝试、OLED 地址、局域网网页控制及断线停止规则。云端语音和局域网页面是并列入口，云端不可用时不能假装继续完成 AI 对话；已有局域网条件下的网页控制另按实际连接状态使用。

ct43 引入的[基于真实回执的“为什么没动”网页解释](status-explanation.md)已随 ct45 部署：按确定规则报告已知占用、冷却、受阻、取消或异常，不自动启动或重试。灵矽语言解释另有隔离诊断，仍发现原因猜测和恢复暗示；不能把网页确定规则的通过外推为模型已经遵守。工程采集需要区分设备联网、云端会话、模型工具选择、控制接受和物理输出，才能定位灵矽落地过程中具体在哪一层失败。

## 7. 用可复现证据帮助方案推广

| 验证层 | 记录什么 | 不应替代什么 |
|---|---|---|
| 文本工具评测 | 模型标识、角色哈希、输入上下文、工具名／参数、禁止动作错误 | 真人语音识别、物理执行 |
| 合成普通话上行 | 同一批原话分别比对平台转写和工具调用，定位同音字、额外查询和播报问题。[20 条实测](validation/synthetic-uplink.md)、[单说“全速”的工具与播放对照](validation/full-speed.md)、[明确拒绝信息的解释对照](validation/speed-rejection.md)、[拒绝结果返回格式](validation/admission-envelope.md) | 麦克风收音、方言、扬声器和实机动作 |
| 真人语音 | 识别文本、噪声条件、工具与回执、分段时延 | 任意家庭和全部口音泛化 |
| 本地主机／编译 | 参数、并发、取消、断线及真实适配代码测试 | 带载、温升、停止距离 |
| 设备与硬件 | 固件版本、电源／负载、输入与输出时间、异常和测量方法 | 量产及儿童使用认证 |
| 用户体验 | 独立上手、求助次数、主动重玩、家长使用场景与顾虑 | 已证实的购买意愿或商业规模 |

历史 5991 字符角色配合 ct45 工具，固定集严格匹配 78/80，八条明确停止均直接全停，编排匹配 7/8。[历史角色回归](validation/lingxi-role-5991.md)

较早一次 ct45 角色复测中，固定文本的工具匹配为 77/80，编排为 5/8，状态解释为 4/8。真人语音与整机动作另行验证。样例、回执和失败原因见[复测记录](validation/lingxi-ct45-role-feedback-20261031.md)。

ct46 将执行回执转为设备端可验证的播报判断，并用同一组输入重复检验灵矽选工具的稳定性。336 条隔离文本会话及失败样例见[ct46 联调记录](validation/lingxi-ct46.md)。ct47 在设备回执中给出草稿通道及驱动故障处理说明，后续 48 次定向会话的结果见[ct47 联调记录](validation/lingxi-ct47.md)。

## 8. 可复用方案包与推广路径

已提供[参考材料打包工具](../tools/lingxi-solution/README.md)，通过明确清单导出角色、契约、评测和架构资料，并附文件哈希与证据范围。评审者可在解压目录执行 `python3 scripts/review_lingxi_reference.py`，离线复现两组工具调用成绩并定位失败用例。固件构建和最近部署的版本及哈希分别列在包内清单中。

1. **体验包**：家长上手卡、角色介绍、三个短表演、可见的取消／停止方式与演示脚本。
2. **设备接入包**：固定上游版本、工具能力清单、参数及回执、GPIO／电源／接口说明和安装配置。
3. **验证包**：文本／真人用例、主机检查、固件与提示词版本、故障矩阵和实际证据。
4. **设计包**：FCStd、打印清单、原理图、BOM、维护说明与 SolidCue 整机模型上的零件点选、原生修改与恢复。

推广顺序为现有样机 → 小规模陪同体验 → 维护与成本收敛 → 可复现参考方案；教育活动、展览互动或其他执行器变体作为后续验证方向，不将其列为已经支持的产品。价格、付费方式和批量成本需要实际数据，不预设市场规模或成本节省比例。

[完整固件主机](validation/firmware-host.md)把平台工具选择连到同版参数门、MCP 回调和控制守卫，用原话输入复核接受、拒绝、计时及终态。对灵矽接入者，工具与角色可在电脑上先完成协议和逻辑联调，再进入现场采集。十一组软件检查与实际平台原话回归分别记录，当前为语义 78/80、编排 6/8，三次网页并发改稿均拒绝旧版并保留新稿。参考包可离线重算两组成绩，保留超时和未达门槛；完整控制回放仍需完整 checkout。硬件观察仍单独验收。

[模型选型对照](validation/model-parameters.md)复用相同角色、工具与控制主机，分别检查工具准确率、明确停止、禁止动作、草稿变化和回复语义。定向六次通过后，完整回归仍暴露漏停和含糊误启动，因此未采纳新模型并恢复原配置。参考包保留这些失败，可离线重算，帮助接入者把模型配置验证纳入工程交付；真实音频与设备表现继续分开验收。

ct62 的[输入失败隔离](validation/voice-input-guard.md)进一步把失败后不重试／补做放到设备端；即使模型换用另一项合法工具，当前轮次也不能继续启动。历史 C005 请求回放已拦截 sequence 补做，查询与停止仍保留；真实输入时序与首个调用的意图准确率须另外验证。

## 9. 给灵矽平台的反馈建议（非当前平台事实）

- 提供可导入导出的角色、工具契约和版本绑定，减少平台配置与固件不一致。
- 提供无执行器的工具试运行与回归环境，允许捕获模型调用而不驱动硬件。
- 在日志中关联设备会话、模型调用、设备接受和完成／取消回执，方便定位延迟及失败。
- 支持按设备实际能力展示工具，清楚表达“未连接／未验证／暂不可用”。
- 为方案提供分层验收模板、异常样例与参考硬件版本，避免把演示通过当成可交付。

本轮[真实隔离联调](validation/lingxi-ct45-role-feedback-20261031.md)进一步暴露两类需求：工具参数正确仍可能伴随重复播报；设备本地不恢复，语言却可能暗示自动续走。建议平台把工具调用、执行回执和对外播报分开记录，提供可验证的成功静默机制；原因与恢复条件优先来自确定的设备状态契约，模型表达不得覆盖“不自动恢复”等事实。禁止动作、绕过确认、错误恢复暗示分别设验收门槛，不用平均准确率抵消。

以上为基于 CyberTrack 开发过程提出的待验证建议，不声称平台已有或将承诺提供，也不擅自向第三方发送反馈。

## 可交给平台复核的联调反馈

现有[过程播报与含糊改稿复现材料](validation/platform-tts-feedback.md)提供原话、角色／工具／参数、实际 MCP 回执、TTS 与音频事件、草稿终态和复核命令。十四次对照已恢复原配置，不将临时角色保存当成部署或修复。材料明确区分平台播报出口、模型语义与设备守卫，供协作定位；尚未代发外部工单。

ct67 [历史相对改稿记录](validation/history/relative-draft-duration.md)补充一个可复用分工：实际 STT 形成有限的未量化相对请求标记，本地在修改前拒绝猜测，拒绝事实供模型追问，家长网页确认继续独立。十三组原生回放与二十条实际 STT 审阅分列；量化归属、未知表达、误调停止和过程播报仍未解决，不将局部门禁宣传为完整自然语言理解。

ct68 的[首次含糊动作保护](validation/vague-action-admission.md)进一步给出“灵矽理解、设备核验、回执澄清”的实际例子：二十条合成语音经过真实 STT 与实际 MCP 主机，三次模型猜测前进均被设备拒绝，八条含糊输入零启动；严格调用仍为 16/20，错误没有被守卫效果抵消。普通明确动作保留。开发者可以复用输入代际、拒绝事实和分层回归方法，不能把有限中文词类当作通用语义引擎。

建议平台在工具请求中携带对应 STT 的输入编号，并将拒绝原因、追问文本和播报事件串联起来，方便区分“模型未澄清”“设备已拦截”和“播报仍误导”。当前本地守卫只能关联设备已收到的输入代际，网络迟到请求的原话归属仍需协议支持。这是接入建议，尚未向平台提交，也不声称现有平台已提供。

[意图分流角色对照](validation/intent-routing-role.md)又提供一个不应采纳的实例：72 次文本会话没有提升严格调用，候选仍擅改半秒且朗读过程，原配置已恢复。交付材料区分工具判断、设备拒绝与语音出口，并明确占位识别输入不等于 STT 已参与。可复算失败和如实注明覆盖范围，也是让灵矽方案可维护的一部分；不能用角色已保存或单项示例更短代替产品验收。

[模拟识别输入](validation/capture-recognized-input.md)补齐了可复用的诊断环节：原话在新文本主机中形成输入代际和局部语义标记，与实际 ASR 分开标识。二十四条平台会话复算一致，两次模型猜测被设备拒绝；严格工具仍为 20/24。开发者能在不接执行器时检查控制回执，再独立验证 ASR 和现场效果，避免把占位主机误当成完整语音链路。

## 模型与播报出口的本地研究

[工具轮播报中继原型](../tools/lingxi-relay/README.md)把带工具的中间轮与普通最终回复分开，提供实际 HTTP／SSE、本地两轮工具结果闭环与失败不重试验证，供研究灵矽自定义 LLM 的播报出口。它尚未接入平台，日常设备路径保持直连；需要推理历史的模式、最终分析文字、必要限制保留和额外时延仍是采纳门槛。夹具和真实模型效果分列，[已知反例](validation/llm-tool-round-relay.md)保留，不能作为已修复或已部署的方案承诺。
