miclle/cybertrack/docs/concurrent-actions.md

# 面包板并发动作：当前状态与 ct7 台架历史

核对日期：2026-10-27。当前源码与最新有记录的部署为 **`2.0.3-ct21`**，支持行走、喷水、泡泡、点火低压 MOS 四路独立控制及有界狂暴模式。ct7 已完成行走／喷水的基本并发台架；下文保留它的原始回执和现场反馈，不能作为当前四路完整验收。

## 当前并发规则与进展

| 项目 | 当前状态 | 与 ct7 历史的区别 |
|---|---|---|
| 普通定时动作 | 行走 1–3000 ms；喷水／泡泡 1–30000 ms；点火 1–5000 ms，四路独立 | ct7 只有行走／喷水；当前泡泡与点火接口已部署 |
| 电机与间隔 | 1 kHz、204/255（约 80%）PWM，B／左、A／右；行走／喷水／泡泡间隔 200 ms，点火等本次实际软件 ON 时长 | ct7 约 60% PWM、A／左与 B／右假设、行走三秒／喷水一秒冷却均为旧规则 |
| `move_and_water` | 两路均就绪才整体接受，独立到期关闭；参数仍为 `direction/move_duration_ms/water_duration_ms` | 保留 ct7 原子接受语义，不承诺电气边沿精确同步 |
| 网页与模式 | 三路长按可并行，喷水／泡泡失租只停本路，行走失租撤销网页来源动作；网页／语音狂暴最多三十秒 | 普通定时语音不续时；点火无长按接口。狂暴的有界循环不是普通动作自动重试 |
| 停止与来源 | BOOT／全部停止／Wi-Fi 断开全停；网页／语音会话关闭取消相应来源，模式按来源取消；松开／重连不恢复 | ct7 仅语音两路规则不能概括当前来源隔离 |
| 回执 | `logical_outputs.left/right` 为 −80/0/80，另有 water/bubbles/ignition；后端为 `concurrent_motor_effects_bench` | `remaining_ms` 为四路最大剩余值；模式另读 `frenzy_remaining_ms`，`physical_feedback=false` |

完整规则与参数见[当前接口](../firmware/CAPABILITIES.md#当前面包板-ct21-接口)、[局域网控制](lan-control.md)和[效果控制](effects-control.md)。普通同路定时请求仍不续时、不排队；会话内 128 项 RPC 记录不提供跨启动持久化防重放。2026-10-27 角色别名及成功静默规则已更新，真实语音回归仍待完成，见[角色维护](agent-role.md)。

ct21 已仅应用部署并保留配置，启动联网、输出全关已核对，部署检查未启动执行器；用户随后确认前进、后退、左转、右转正常，见[部署与反馈](../firmware/esp32-audio/startup-ct21.json)。当前基本打印和装配已完成，[样机影像](../artifact/README.md)展示落地运行、转向、泡泡及喷水台架；影像未绑定完整版本／电源配置，不能代替新电源、约 80% PWM 和四路组合负载验收。

当前待验收项见文末。以下 ct7 参数、软件测试与回执均为历史证据；流水中的“下一项”“尚未执行”和供电状态仅指当时，不要求重做后文已有结果的分项。本次只同步文档，未重新构建、烧录或触发动作。

## ct7 历史变更（2026-10-25）

2026-10-25：用户要求取消行走与喷水之间的互斥。此决定替代 ct6 的跨动作拒绝规则，ct6 已完成的台架记录保留为历史证据。ct7 当时不改接线、功率上限、速度或通用控制核心；只升级现有面包板适配与灵矽角色。

## 行为

**ct7 历史行为。** 当前时限、冷却、占空比和新增通道以上文为准。

- 行走／转向 1–3000 ms，固定约 60%；喷水 1–30000 ms。各自独立计时与冷却（行走 3000 ms，喷水 1000 ms）。
- 一路活动或冷却不阻止另一路新动作；同一路仍拒绝续时、重复启动和运行中换向，不排队补做。
- `move`、`water` 保留原入参。新增 `self.tank.move_and_water`，参数仅为 `direction`、`move_duration_ms`、`water_duration_ms`，分别使用原范围。两路都就绪才一起接受；任一路忙碌、冷却或参数错误，整个组合拒绝，不执行一半。
- 组合工具在同一次固件回调中启动两路，而非等待两次云端调用；不声明电气边沿精确同步。缺时长的明确组合请求由角色各填 1000 ms，“边走边喷”未说明方向默认前进。
- BOOT、语音“停止”（包括只说停止喷水／行走）、已检测断线、重启／升级及输出 API 故障仍关闭全部动作并取消待执行票据。松开／重连不恢复。此版没有独立停止某一路的工具。
- 同一会话共享 128 项 RPC ID 记录，票据绑定目标通道；启动只取消与本次通道重叠的排队票据，另一通道票据可执行。5 秒过期、跨会话票据失效、表满拒绝保持。

## 输出与回执

本节描述 ct7 输出和回执结构，保留两路字段、旧后端名与历史日志语义。

输出驱动仅修改变化的通道：开始／结束喷水不重设电机使能，电机开始／结束不拉低 MOS。变更电机方向时先关两路 EN；任一 GPIO／PWM API 错误仍锁定并尝试全部关闭。

| 字段 | ct7 含义 |
|---|---|
| `logical_outputs.left/right`、`water` | 可同时非零／为 true；没有轮速和水流反馈 |
| `capabilities.move_and_water` | true，组合启动工具可用 |
| `move_remaining_ms`、`water_remaining_ms` | 两路各自剩余时间 |
| `move_last_duration_ms`、`water_last_duration_ms` | 两路各自最近一次接受的时长 |
| `remaining_ms` | 两路剩余时间的最大值，兼容汇总字段，不用于单路倒计时 |
| `last_duration_ms` | 最近接受请求的时长；组合请求取两时长最大值 |
| `starts_this_boot` | 两路启动次数之和，单路请求加 1，组合请求加 2 |
| `log_events_dropped` | 非阻塞关闭日志队列溢出数量；非零时日志证据可能不完整 |
| `actuator_backend` | `concurrent_motor_water_bench` |

控制任务仍为 5 ms 周期和优先级 10。关闭事件包含 `channel=move/water`、原因、该路软件运行时间以及关闭时另一通道状态；通过固定长度、非阻塞队列交给低优先级日志任务，避免一路停止时串口阻塞另一路截止检查。日志时间不是实物停止时延。

## 验证状态

以下为 ct7 的历史软件及台架结果，软件检查未在本次文档同步中重跑；当前软件与构建证据另见[ct21 报告](../firmware/esp32-audio/verification-ct21.json)。

主机 ASan／UBSan 已通过两种加入顺序、独立截止／冷却、组合原子拒绝、同路拒绝、票据与停止／BOOT／断线／时钟故障。真实输出类的组合状态转换矩阵检查另一通道不被重写，逐个注入初始化和状态转换 API 故障并核对全部关闭。导出 MCP 校验块链接 ESP-IDF cJSON，检查组合与单项参数边界、缺参、额外字段和内部票据注入。

设备应用刷写与平台同步已完成。ct7 核心并发台架回归已完成：组合及分开下令、两种独立截止顺序、BOOT 全停与语音停止均有固件回执和用户现场反馈。15:16:46 收尾回执确认输出全关、启动计数 20，用户确认两路功率已断开。完整供电与其他验收仍开放，详见文末。断网现场测试按用户要求延期。

两种独立截止顺序先取得功率断开软件回执，随后已完成对应带载观察；按用户要求跳过重复断电电压测量。ct7 当时尚无电流、温升、欠压、落地带载行走和液体／EMC 验收；后续已有样机落地运行及 ct21 四方向反馈，定量负载、停止和环境验收仍未完成。

## 部署记录

**ct7 历史部署。** 下文保存当时版本、镜像、角色哈希及设备状态，不是 ct21 的部署说明。

已按用户最后确认的两路功率断开状态进行更新。设备身份、分区表及 OTA 选择与 ct6 一致；完整备份 0x3f0000 字节应用分区，前缀与已部署 ct6 镜像逐字节一致。仅写入 0x20000 起的 ct7 应用，2,555,424 字节，esptool 哈希校验通过；0x8000..0x1ffff 配置区前后逐字节一致，未写引导、NVS、OTA 数据或 assets。

灵矽角色已保存并重新打开，与仓库原文一致，昵称小D、音色少年梓辛/Brayan、模型 deepseek-v4-flash 等配置保留。保存后重启，14:59:11 观察到 ct7、SSD1306 和五工具 READY，含 move_and_water、concurrent=true；14:59:17 联网待机。未发送任何串口动作命令；部署当时尚未进行实际同时负载，后续语音台架结果见下文。

证据：[软件报告](../firmware/esp32-audio/verification-ct7.json)、[部署记录](../firmware/esp32-audio/startup-ct7.json)。私有备份位于忽略的 secrets/ct7-20261025；提示词 SHA-256：`abe532fe83e95d92d2e77221041a70d993c2b86a8525e479f85de1f35338d0fd`。

## 首次组合语音回执（两路功率断开）

2026-10-25 15:05:56，用户说“同时前进一秒并喷水三秒”，小D回复“好，前进一秒，同时喷水三秒。”用户确认两路功率仍断开、USB 持续连接，声音和屏幕正常。

串口记录 `self.tank.move_and_water`，RPC 5、请求序号 1、启动标识 `2ab7aa942de75849`，结果 `accepted`，行走 1000 ms、喷水 3000 ms，逻辑输出 `60/60/true`，`fault=none`，启动计数 2（组合两路各加 1）。接受回执中日志丢弃计数为 0。

- 15:05:57：`channel=move reason=deadline software_on_ms=1003 move=OFF water=ON`。
- 15:05:59：`channel=water reason=deadline software_on_ms=3003 move=OFF water=OFF`。

已核对行走先关闭、喷水继续并随后独立到期关闭的软件回执；这些时长不是实物停止时延。本次未测 GPIO 连续性，也未给功率支路通电。下一项为“同时前进三秒并喷水一秒”，核对相反截止顺序；之后继续输出测量、BOOT 全停与同路拒绝回归。

## 相反截止顺序回执（两路功率断开）

2026-10-25 15:06:40，用户说“同时前进三秒并喷水一秒”，小D回复“好，前进三秒，同时喷水一秒。”用户确认两路功率仍断开、USB 持续连接，声音和屏幕正常。

同一启动标识 `2ab7aa942de75849`，RPC 6、请求序号 2，组合请求 `accepted`，行走 3000 ms、喷水 1000 ms，逻辑输出 `60/60/true`；`fault=none`，启动计数 4，接受回执中日志丢弃计数为 0。

- 15:06:41：`channel=water reason=deadline software_on_ms=1001 move=ON water=OFF`。
- 15:06:43：`channel=move reason=deadline software_on_ms=3002 move=OFF water=OFF`。

两种独立截止顺序的软件回执均已核对；未据此确认 GPIO 电压连续性或实物停止时延。下一项保持功率断开，测 MOS 控制端相对共地的电压，使用前进 1 秒／喷水 3 秒组合，观察行走关闭时 MOS 是否仍保持高电平并在喷水到期后归零。万用表观察不能排除短暂毛刺。

## 首次同时通电动作（15:09）

用户要求跳过重复断电测量，进入短时同时通电台架测试；MOS／ENA／ENB 并发电压连续性测量尚未进行，不记为通过。2026-10-25 用户确认 L298N 12 V、MOS 5 V 均接通，待机不自转、不喷水；说“同时前进一秒并喷水一秒”后两台电机和水枪同时动作，约一秒后全部停止，小D回复“好，前进一秒，同时喷水一秒。”声音和屏幕正常、未重启，USB 持续连接。

15:09:07 接受 `move_and_water`，请求序号 3，行走／喷水均 1000 ms，逻辑输出 `60/60/true`，启动计数 6，`fault=none`，日志丢弃计数为 0。启动标识仍为 `2ab7aa942de75849`。两路关闭事件均为 `reason=deadline software_on_ms=1002 move=OFF water=OFF`；打印时间不同不代表物理停止先后。

本次证据支持一次短时同时带载动作及自动停止，不代表电流、供电波形、温升、反复带载或落地行走验收。下一项为同时前进／喷水三秒，动作刚开始立即按 BOOT，核对两路提前停止、松开不恢复与 `BOOT` 停止原因；随后验证带载下不同截止时间。

## 同时带载 BOOT 全停（15:09:46）

用户说“同时前进三秒并喷水三秒”，观察到两台电机与水枪同时动作，立即按 BOOT 后全部停止；松开后及超过原定三秒均未恢复。两路功率仍接通、USB 持续连接，声音和屏幕正常。

请求序号 4 的组合请求接受，两路时长均 3000 ms，启动计数 8，启动标识仍为 `2ab7aa942de75849`，`fault=none`，接受回执中日志丢弃计数为 0。两路关闭事件均明确记录 `reason=BOOT software_on_ms=388 move=OFF water=OFF`。388 ms 是软件动作持续时间，不是 BOOT 停止响应时延。截至日志 15:09:50.194609，未见此后新增动作接受记录；超过原期限未恢复由用户现场观察支持。

下一项继续同时带载下的独立停止：前进 1 秒／喷水 3 秒，确认电机先停而喷水持续到三秒；随后核对相反顺序。无须重做已完成的逐路断电测量。

## 带载行走先停、喷水继续（15:10:57）

用户确认两路功率接通、USB 持续连接，说“同时前进一秒并喷水三秒”后，两台电机约一秒后停止，水枪继续至约三秒后停止；小D回复“好，前进一秒，同时喷水三秒。”声音和屏幕正常。

组合请求序号 5 接受，启动标识仍为 `2ab7aa942de75849`，启动计数 10，`fault=none`，接受回执中日志丢弃计数为 0。关闭事件为：

- `channel=move reason=deadline software_on_ms=1002 move=OFF water=ON`。
- `channel=water reason=deadline software_on_ms=3002 move=OFF water=OFF`。

带载下电机先停、喷水继续的现场观察与回执一致；未测电气波形、电流或温升。下一项为前进 3 秒／喷水 1 秒，验证喷水先停时电机继续转动。

## 带载喷水先停、行走继续（15:11:55）

用户确认两路功率接通、USB 持续连接，说“同时前进三秒并喷水一秒”后，水枪约一秒后停止，两台电机继续至约三秒后停止；小D回复“好，前进三秒，同时喷水一秒。”声音和屏幕正常。

组合请求序号 6 接受，启动标识仍为 `2ab7aa942de75849`，启动计数 12，`fault=none`，接受回执中日志丢弃计数为 0。关闭事件为：

- `channel=water reason=deadline software_on_ms=1000 move=ON water=OFF`。
- `channel=move reason=deadline software_on_ms=3000 move=OFF water=OFF`。

至此两种带载独立截止顺序均有现场观察与固件回执支持，同时带载 BOOT 全停也已核对。下一项检查分开下令：先喷水，在喷水活动期间另发前进一秒，核对单项工具能加入另一活动通道；该项尚未执行。同路拒绝仍只有本版主机测试证据，未记为现场通过。

## 分开下令重叠运行与语音停止（15:12–15:14）

用户报告十秒喷水因请求延迟，来不及说停止就到期；改为“喷水三十秒”后，后续行为符合预期。串口实际记录三轮十秒喷水加一秒前进（请求序号 7–12）：行走均在喷水仍活动时接受，喷水剩余分别为 1920、3312、2686 ms；行走均在约一秒后到期关闭且喷水仍开启，三轮喷水分别在 10003、10001、10002 ms 到期关闭。十秒轮次不能记为语音提前停止通过，延迟也未拆分为纯网络、识别或回复耗时。

最后一轮请求序号 13 接受喷水 30000 ms，序号 14 接受前进 1000 ms，此时喷水剩余 23959 ms、输出为 `60/60/true`。电机在 `1002 ms` 到期关闭，喷水仍保持。序号 15 为 `stop`，返回 `ok`、`STOPPED`、`fault=stopped`（主动停止状态），两路输出均关闭、各自剩余时间为零；喷水关闭事件为 `reason=stop software_on_ms=12712`。因此实际软件喷水持续约 12.7 秒，不能记为三十秒连续带载验证。

启动标识仍为 `2ab7aa942de75849`，启动计数 20，最终回执日志丢弃计数为 0。用户对后续行为作总体符合预期的确认，本轮未额外报告声音／屏幕细节，不补写这些观察。

本次功能变更的核心台架回归已覆盖组合与分开下令、两种独立截止顺序、BOOT 全停及语音停止。停止追加重复动作，下一步断开两路功率、保留 USB，并查询状态完成收尾。同路拒绝现场回归、断网（用户延期）、完整供电／电流／温升和落地行走等仍单独列为待测，不以核心回归完成替代这些验收。

## 本轮收尾与剩余验收（15:16:46）

用户确认 L298N 12 V、MOS 5 V 均已断开，USB 仍接电脑；查询状态后小D回复“已停止，正在待命。”请求序号 16 的 `get_status` 返回 `ok`，`left=0/right=0/water=false/bubbles=false`，总剩余时间及两路各自剩余时间均为 0，启动计数仍为 20，启动标识仍为 `2ab7aa942de75849`，日志丢弃计数为 0。`STOPPED/fault=stopped` 保留上次主动停止状态，不表示新增输出故障。以上是固件逻辑输出回执，功率断开由用户确认。

本轮完成：

- ct7 主机 ASan／UBSan、输出转换与故障注入、生成 MCP 参数检查和交叉编译；应用刷写及配置保留、平台角色回读。
- 两路同时启动、一秒到期全停；前进 1 秒／喷水 3 秒及相反顺序，另一通道继续运行。
- 同时动作时 BOOT 提前全停，用户确认松开及原期限后不恢复。
- 喷水期间分开下令前进一秒；随后语音停止成功，收尾输出全关且启动计数未增加。

## 当前剩余验收

ct7 收尾时的缺口按后续证据更新如下；已完成的装车四方向基本功能与运行影像不再列作“尚无记录”，但不提升为整机验收。

- 现行版本同路忙碌／冷却拒绝、时长／重复请求等现场回归，以及新增效果、狂暴和最新角色别名／静默的真人语音验证；ct7 主机结果不能代替当前实物结果。
- 断网／重连现场测试，按用户要求延期。
- 当前接线与固件的复位、欠压、失电、OTA／看门狗和独立功率切断；辰克 5 V 电池包与 12 V 升压支路的供电波形、电流、定量温升及反复负载。旧电源与约 60% PWM 证据不沿用为当前通过。
- ct21 已有四方向正常反馈、样机已有落地运行影像；桥身份逐线核对、定量速度／停止距离、持续落地负载、四路同时负载、液体隔离及 EMC 等整机验收仍未完成。
- 完整三十秒连续喷水带载验证仍未完成：ct7 该次三十秒是请求上限，实际在约 12.7 秒被语音停止。

功率断开时的逐路电压连续性测量按用户要求跳过，不记为通过；已取得两种带载实际动作连续性观察，但未测短暂电气毛刺。

分项完成不替代整机退出条件，完整验收以[验证计划](verification-plan.md)为准；点火低压软件能力不代表高压、绝缘或液体共存安全验收。
