miclle/cybertrack/firmware/PLAN.md

# 固件独立实施计划

更新：2026-10-24。依据当前 R03–R05、R07、R09，先实现可在电脑上验证的控制行为，再接入板卡和平台。机械造型、液体模块外壳与全部采购资料无需阻塞 F0–F1；真实执行器输出需要相应硬件资料及台架证据。

| 阶段 | 工作及交付物 | 依赖／退出条件 | 当前状态 |
|---|---|---|---|
| F0 主机控制核心 | C11 状态机、逻辑输出、停止锁定、参数限制、会话／序号／本地时效检查、虚拟时间测试 | 不依赖开发板；编译和异常场景测试通过，缺配置时能力关闭 | 已完成，见[测试记录](tests/README.md) |
| F1 离线协议适配 | 严格解析候选工具参数；状态／停止／受限动作映射；JSON-RPC 原结果缓存、会话及排队时限；模拟断线与消息用例 | 已复核官方封装与错误；未知工具、负数、超大数、重复 ID／不同参数、过期消息、跨本地使能排队消息均有测试结果 | 已完成离线实现及测试；见[协议契约](PROTOCOL.md)，未接入真实平台 |
| F2 板级启动与本地停止 | ESP-IDF 工程、版本化板配置、单调时钟、控制任务、输出默认关闭、停止／本地使能、看门狗及故障上报 | Q06 具体主控板、存储配置、原理图与引脚；停止电路已核对；先禁用执行器完成编译、烧录、复位及停止测试 | 部分完成：F2a 通用运行层、输入处理及有界接收队列通过主机／假板卡测试；F2b 已建立[ESP-IDF 无负载工程](esp32/README.md)，启动和 PSRAM 检查结果见[实物记录](../hardware/components/ESP32-S3-N16R8/physical-verification.md)；板载 BOOT 无负载停止锁定及 RST 后未使能已通过，专用停止／使能、供能切断、输出、调度时限与看门狗仍未验收 |
| F3 单模块低压台架 | 电机方向／速度档映射；水枪、泡泡供能窗口；校准每项限制 | 电机依赖 Q01–Q02、Q05；水枪／泡泡另依赖 Q03–Q04、Q11。逐个开放能力；测量停止、时限、电流、发热与失效行为 | 待实物；不必等待完整外壳 |
| F4 联网与语音 | 配网／绑定、WSS、音频、只读工具，再开放通过台架的动作 | Q06 音频器件与平台账号；绑定／握手／录放音先保持动作关闭。动作联调依赖 F3 对应能力通过 | 已完成 MCP 接收／连接生命周期离线模拟；真实绑定、WSS、hello 与音频尚未接入 |
| F5 整机与故障验收 | 电机噪声下语音、断线／重启／OTA、输出故障、组合负载 | P1–P5 对应证据齐备；组合能力另行开放，记录实际机械停止距离 | 待实现 |

F0–F1 不冻结 GPIO、连接器针序、SDK、音频器件或实际速度／时长上限。MG90S、超声波用途未定，不添加空驱动；顶部高压效果不设置接口或驱动。

## 当前实现验收与下一步

F0 覆盖八组场景：上电／复位、动作期限与互斥、停止与故障恢复、会话与重放、非法参数、无配置能力关闭、计时异常、方向及边界。结果只证明电脑进程中的逻辑行为。

F1 已完成 24 个协议测试方法及其中的参数子用例、500 次确定性消息变异。包含严格整数校验、16 槽 FIFO 原响应缓存、32 KiB 启动期防重放过滤器、停止优先与使能代次检查。过滤器跨连接保留，旧动作 ID 在响应淘汰或重新使能后仍不能执行；只读请求持续处理。碰撞会保守拒绝新动作，真实流量容量和服务端 ID 兼容性仍待 F4 评估。

解析资源故障已补齐：默认分配路径不变，增加启动期可选分配器；新解析或缓存重读内存失败撤销逻辑输出并要求本地重新使能，原缓存与序号不变。主机测试包含 17 类请求、138 次逐点注入、20 次连续失败和假板卡关断联测。CTest 23/23 通过；测试样本中临时 JSON 请求字节峰值 41736，协议对象 137448 字节，均为当前主机 ABI 观测值。

F2a 已完成[通用启动与运行层](RUNTIME.md)：先关断再自检、本地使能边沿、周期期限与调度检查、输出应用及失败关断、条件喂狗、运行层故障锁定；现有 16 组假板卡场景通过。新增与电平无关的输入去抖／已观察脉冲锁存（5 组测试），以及 4 槽完整消息接收队列（4 组测试）。尚无真实线程、定时器、中断捕获、ESP-IDF、GPIO 和硬件看门狗。

接收边界与连接流程已完成[离线实现](TRANSPORT.md)：回调切片与 TEXT／CONT 消息组装、首片元数据保持、连接／握手／分片／发送期限、退避重连及旧事件隔离、发送失败关闭。14 组假传输场景与 376 个穷举切分用例通过；真实 TLS、hello 校验及 SDK 事件映射仍待接入。

长时会话已完成 5 组压力场景：163522 次协议调用、20000 个动作意图、100000 次状态查询、500 次恢复及 40502 次重放检查。无旧动作重新执行，临时分配台账归零；虚拟时钟推进 120520500 ms，不是实际运行时长。误拒绝与饱和边界见[测试记录](tests/README.md#长时会话与缓存压力)。

开发板实物核对期间，继续按下表推进离线工作；F2b 已有供应商原理图、排针和尺寸，可开展适配准备，仍需确认实物版本与焊装。移植前需核对板级内存与任务调度：当前主机协议适配器对象约 134 KiB，解析器仍使用堆分配。F4 的网络新鲜度证据源、鉴权及真实传输尚未实现；没有可验证的新鲜度依据时仅允许只读状态与停止，真实动作保持关闭。

Q06 的供应商原理图／排针、存储标称和下载通路已补齐；正反面、实测外形、模组丝印、USB 枚举及存储识别已补齐；仍需板级修订版、焊装和天线核对、停止器件，分批清单见[开发板资料](BOARD-INFO.md)。电机和效果台架分别等待各自资料。总体验收仍以[实施及验收计划](../docs/verification-plan.md)为准。

## 不依赖实物的后续工作

以下为可独立交付的工作顺序；不把离线模拟记为真实平台或硬件通过。

| 顺序／工作 | 可先实现和测试的内容 | 仍需的输入或后续验收 | 状态 |
|---|---|---|---|
| 1. 本地输入处理 | 停止／故障立即断言、释放去抖、已观察短脉冲保留到读取；使能稳定释放后重新按下；时间回退失败 | GPIO 极性、实际去抖参数、中断捕获与电路响应待板级核对 | 本轮完成；5 组单元场景及运行层联测通过 |
| 2. 有界消息交接 | 深拷贝消息、FIFO、首次接收元数据不变；断线清队列；溢出／超长失败关闭；拒绝旧连接回调 | 真正的并发同步、控制任务唤醒、网络关闭及延迟实测 | 本轮完成；4 组单元场景及运行层联测通过 |
| 3. 解析资源故障 | 注入 JSON 分配失败，覆盖解析与缓存比较路径，检查无输出／无泄漏；统计最大帧及缓存资源 | 无需硬件即可完成故障测试；板上堆／栈预算仍需目标构建 | 已完成：17 类逐次扫描、138 次失败注入、配置／持续失败／恢复及运行层联测通过 |
| 4. 接收边界与连接流程 | 两层分片组装、超限／关闭、握手完成门槛、超时、退避重连和发送失败处理 | 已复核官方事件与平台流程；实际 SDK 映射、TLS／真实 hello 校验、WSS 与绑定另验收 | 离线完成：14 组联测与 376 个切分用例通过，见[传输契约](TRANSPORT.md) |
| 5. 长时会话策略 | 16 槽响应 FIFO、启动期过滤器；动作／只读压力、淘汰、饱和、重连和丢响应恢复 | 已验证同启动期旧 ID 不重放；真实服务端 ID／重试行为和目标容量仍待验证；跨复位接口见 5a | 离线完成：5 组压力测试通过；不承诺无限期可用性；RAM 模式只覆盖同次启动 |
| 5a. 跨复位与会话恢复 | 双槽持久化接口、接受前写入、会话代次保留、掉电／损坏／丢响应及假板卡联测 | 真实 Flash／NVS 的同步语义、时延／磨损、分区绑定、旧镜像回滚和维修迁移仍待验证 | 离线完成：278 次存储中断、256 次损坏、264 次动作写入故障、200 次连续复位；残缺历史锁定动作 |
| 5b. 命令新鲜度与意图策略 | 限时窗口、会话／使能绑定、独立稳定意图 ID、双身份持久化、输出前截止检查 | 真实服务端认证与内容绑定、稳定意图生命周期及板级时延仍待验证 | 离线完成：窗口单测、5 组集成模拟、72 次写入中断和分片／丢响应联测；见 [FRESHNESS.md](FRESHNESS.md) |
| 5c. 防重放容量与迁移 | 只读零永久开销、全量复制历史与会话到空白目标、拒绝清位、迁移中断及连续迁移模拟 | 已有历史位不删除；真实分区选择／切换、Flash 时延和回滚保护另验收 | 离线完成：恢复语料误拒绝从 413/500 降至 34/500；迁移故障与重放检查通过，见 [CAPACITY.md](CAPACITY.md) |
| 5d. 后端原子切换与回滚保护 | 独立锚点、精确版本绑定、接受前锚点提交、完整复制后原子选择、旧后端／旧镜像拒绝 | 锚点本身不可回滚且绑定设备；实际驱动、耐久性、时延和固件降级限制待验收 | 离线完成：6 组存储单测与 5 组协议／运行层联测、176 次切换中断、50 次连续切换；见 [ATOMIC-SWITCH.md](ATOMIC-SWITCH.md) |
| 5e. 中断后的维护恢复 | 当前锚点快照校验、损坏双槽中的完整历史提取、空白目标重建与原子选择、再次掉电及恢复后使能检查 | 无日志模式没有当前完整快照时拒绝；新增独立恢复证据见 5f；实际维护入口／授权、Flash 时延另验收 | 离线完成：5 组存储单测、4 组协议联测；176 次恢复中断、50 次连续恢复及 1239 次拒绝检查，见 [RECOVERY.md](RECOVERY.md) |
| 5f. 当前快照缺失的恢复证据 | 独立双槽完整日志、唯一尝试 epoch、领取前过渡记录、准备期连续恢复、精确锚点恢复、日志／主快照／恢复再次掉电 | 实际日志隔离、锚点 epoch-only CAS、擦写预算、时延和本地维护授权待验收 | 离线完成：8 组存储单测与 7 组协议／运行层联测，动作／会话各 352 次日志中断、100 次准备中断后恢复及 100 次原连续恢复，见 [RECOVERY-LOG.md](RECOVERY-LOG.md) |
| 5g. 首次接入与选择后的证据连续性 | 初始日志先于登记，attach 核对或补种，切换／恢复目标日志先于选择，刚选中即丢失主快照及连续恢复 | 旧无日志存储在 attach 完成前仍依赖完整主历史；真实锚点／日志隔离、时延及本地授权另验收 | 离线完成：5 组存储与 4 组协议联测，首次登记／切换／恢复日志切点、100 次无会话恢复及 100 次切换后立即连续恢复；见 [RECOVERY-LOG.md](RECOVERY-LOG.md) |
| 5h. 恢复日志冗余与损坏容错 | 显式四槽双副本、逐字节一致性、单槽损坏／不可读、轮换与补齐中断及主快照缺失恢复 | 四槽物理隔离、同步预算、磨损与共同失效待验收；读容错不降低双份写入门槛 | 离线完成：6 组存储和 4 组协议场景通过，含 1056 次轮换中断叠加损坏、100 次连续双重恢复及 7524 次拒绝检查，见 [REDUNDANCY.md](REDUNDANCY.md) 及[验证记录](tests/README.md#恢复日志冗余与损坏容错验证) |
| 6. 音频与升级故障模型 | 格式明确后模拟音频缓存欠载／溢出；升级流程明确后验证中断和重启保持禁止动作 | 音频协议／编码和升级方案是前提；编解码质量、分区／回滚与录放音仍需平台或板卡 | 条件就绪后开展，不添加空驱动 |

上述 1–5h 不产生网络新鲜度证据，也不解除默认禁止动作。后续优先对接服务端认证与稳定意图映射、实际存储／升级迁移契约、音频格式及升级方案，再推进第 6 项；F3 的实际速度、供电、停止距离及组合负载测试必须留到实物台架。

跨复位防重放两阶段均已完成：独立[持久化接口](PERSISTENCE.md)、动作接受前持久化、跨启动会话代次、存储失败诊断／停止以及掉电恢复联测。绑定存储后旧动作不因复位恢复；损坏记录锁定而不回退。原 RAM 模式保留给离线测试，真实动作要求通过 logged 入口成功绑定持久化后端、独立锚点及恢复日志，并提供新鲜度证据；真实 Flash／NVS 另验收。

### 命令新鲜度与跨会话意图策略（离线完成）

已完成设备限时窗口、独立稳定意图 ID、协议／传输元数据及持久化去重接入。窗口先于新意图签发，首片、排队、重试不能刷新；延迟、换 RPC ID、续发窗口、重连、复位和 72 次持久化中断模拟通过，输出前复核存储时延造成的过期。契约和认证边界见 [FRESHNESS.md](FRESHNESS.md)。

### 防重放容量优化（离线完成）

已完成只读／停止不增加永久记录的优化，动作及稳定意图历史不删除。相同压力语料恢复阶段误拒绝从 413/500 降至 34/500，40502 次重放检查无新动作。旧数据不自动清位；完整迁移接口已通过 168 次中断、50 次连续迁移及 441 次迁移相关重放检查，见 [CAPACITY.md](CAPACITY.md)。

### 后端原子切换与回滚保护（离线完成）

已实现独立锚点接口、首次登记／启动核验、每次会话／历史写入前的锚点版本预留和写入后的最终确认，以及完整迁移后的原子选择。旧后端、旧对象和同后端旧快照均拒绝；选择中断以锚点为唯一恢复依据，介质与锚点不一致时锁定动作。23/23 主机回归通过，176 次动作级切换中断、50 次连续切换及 732 次拒绝检查未恢复旧动作。真实锚点、防固件降级与存储时延仍待验收。

### 持久化中断后的维护恢复（离线完成）

维护接口重新读取当前锚点及实际介质，不使用故障对象的缓存。当前快照完整、另一槽损坏时可复制完整历史到独立空白目标并原子选择；无日志模式锚点已超前而当前快照缺失、或有效历史相互矛盾时拒绝，保留动作锁定。176 次恢复过程故障、72 次原始写入中断、8 次原始锚点失败、50 次连续恢复及 1239 次拒绝检查通过，未恢复旧动作。23/23 主机回归通过；当前快照缺失窗口现由下述独立日志覆盖，原无日志入口仍保持严格拒绝。

### 当前快照缺失时的独立恢复证据（离线完成）

先持久化当前历史的过渡日志，再领取尝试 epoch，保留过渡记录并准备新候选，之后才预留主快照版本；恢复只读取与当前锚点四个字段完全匹配的日志。旧候选、旧日志、半写日志不能代替当前历史；领取尝试后新候选未写完时，主快照也可完全缺失。双槽按完整锚点定位当前记录，不再由数据版本奇偶定位；重复匹配与读取错误拒绝。存储单测覆盖 352 次日志中断、72 次主快照中断、12 次锚点失败、168 次恢复目标中断、88 个单比特损坏；协议／运行层另覆盖动作与会话各 352 次日志故障、176 次原恢复故障、100 次原连续恢复、100 次准备阶段中断后主快照丢失／恢复（其中 25 次恢复再次中断），以及 6 种输出顺序，未恢复旧动作。23/23 ASan／UBSan 回归与 Release 纯库检查通过。详见 [RECOVERY-LOG.md](RECOVERY-LOG.md) 和[验证记录](tests/README.md#独立恢复日志验证)。实际介质与锚点防回滚、写入寿命、同步时延、维护授权及板级断电仍待验收。

### 首次接入与后端选择后的恢复连续性（离线完成）

`ct_replay_store_enroll_logged` 先写完整初始日志再登记全零锚点；已有锚点的 attach 校验完整位图，缺少日志时从已核验主历史补种，不重复生成相同键。带日志切换和日志恢复在目标双快照完成后，先写入／回读目标日志，再提交选择；源精确匹配槽在准备期间保留。目标被选中后无需等待会话开启、save 或首份过渡记录，就可以在主快照丢失时再次恢复。

5 组存储测试覆盖首次登记、旧存储接入、切换各 176 个日志故障，220 个恢复日志故障、22 个锚点故障和 100 次无中间会话保存的恢复。4 组协议联测覆盖登记／切换各 176 个日志故障、220 个恢复日志故障、168 个目标主快照故障、22 个锚点故障，以及 100 次切换后立即连续两次恢复；旧 ID、换 ID 旧意图、延迟会话和重标会话证明均拒绝，历史逐字节完整保留。验收计数见[验证记录](tests/README.md#首次接入与目标选择连续性验证)。旧无日志入口仍为兼容路径，不提供独立日志连续性保证；真实 Flash、锚点与介质隔离及断电时延仍待验收。

### 恢复日志冗余与损坏容错（离线完成）

显式四槽模式以 `{0,1}`／`{2,3}` 两组交替保存完整证据，每组两份记录。领取尝试、预留数据版本、首次登记和选择新后端之前，目标两份记录均须持久化并回读。单槽损坏或不可读时仅使用精确匹配锚点的剩余完整副本；相同键不同历史、跨组重复键、两份当前记录均失效或只剩旧版本时继续锁定。attach 可以在完整主历史核验后补齐损坏副本，中断不覆盖剩余证据。

日志对象 32872 字节，另需调用方提供 32768 字节比较缓冲；四槽介质 131264 字节，无新增动态分配。改变历史的 save 写四份日志、八次日志 sync，锚点 CAS 仍为两次。双槽模式仅保留兼容，不允许在故障后自动降级；实际驱动、共同故障域、磨损、时延与实物断电须另验收。存储与协议故障矩阵、连续恢复及旧动作拒绝计数见[验证记录](tests/README.md#恢复日志冗余与损坏容错验证)。

本轮完整 23/23 ASan／UBSan 回归通过，Release 四个库均未包含测试注入符号，56 项源码 SHA-256 已同步。
