miclle/cybertrack/docs/images/model-design/whole-model-gui-adjusted.png

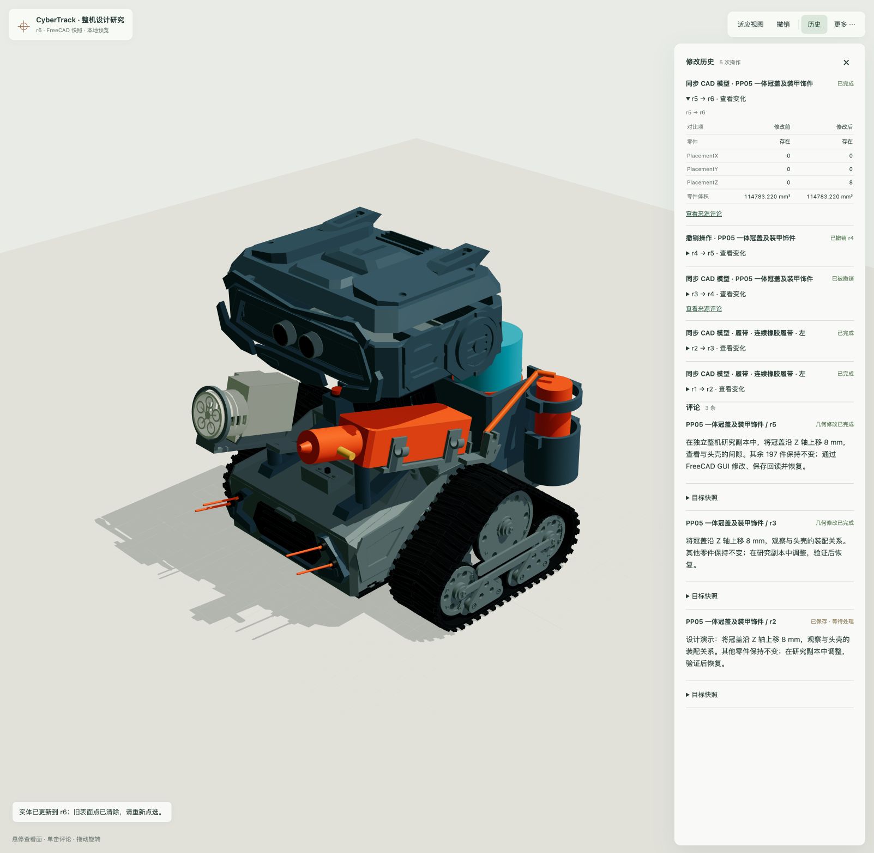
docs/images/model-design/whole-model-gui-adjusted.png
