miclle/cybertrack/hardware/components/37R-520/images/vendor-motor-specifications.png

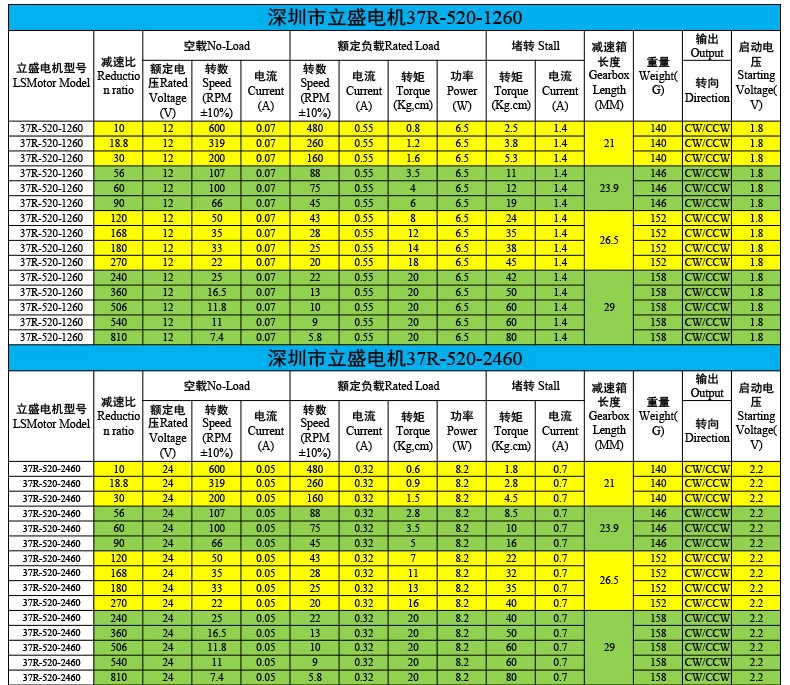
hardware/components/37R-520/images/vendor-motor-specifications.png
