miclle/cybertrack/hardware/model/arc-layout.png

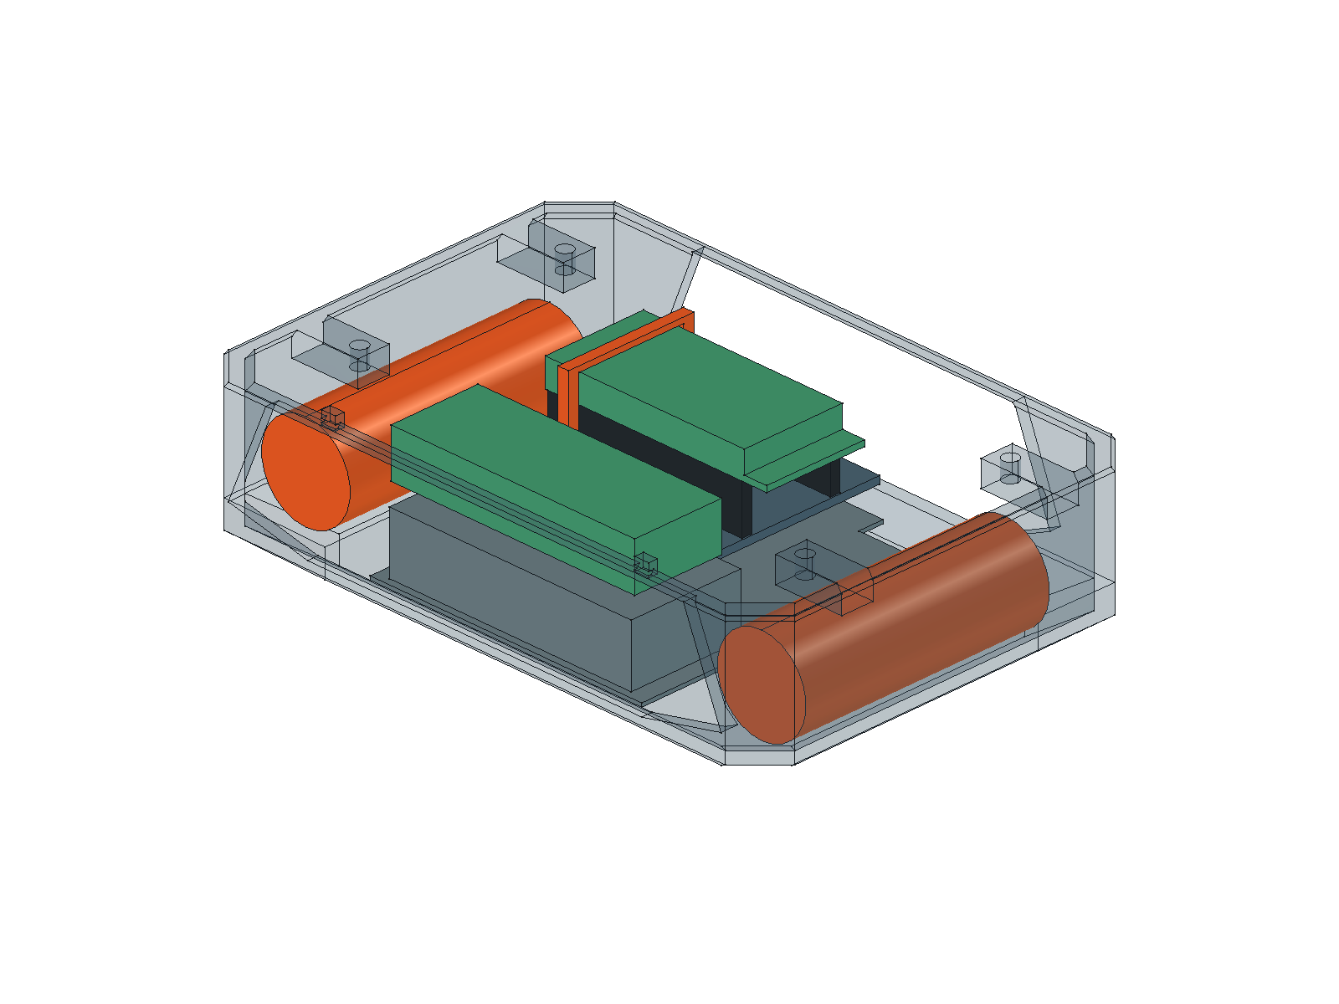
hardware/model/arc-layout.png
