miclle/cybertrack/hardware/model/arc-top.png

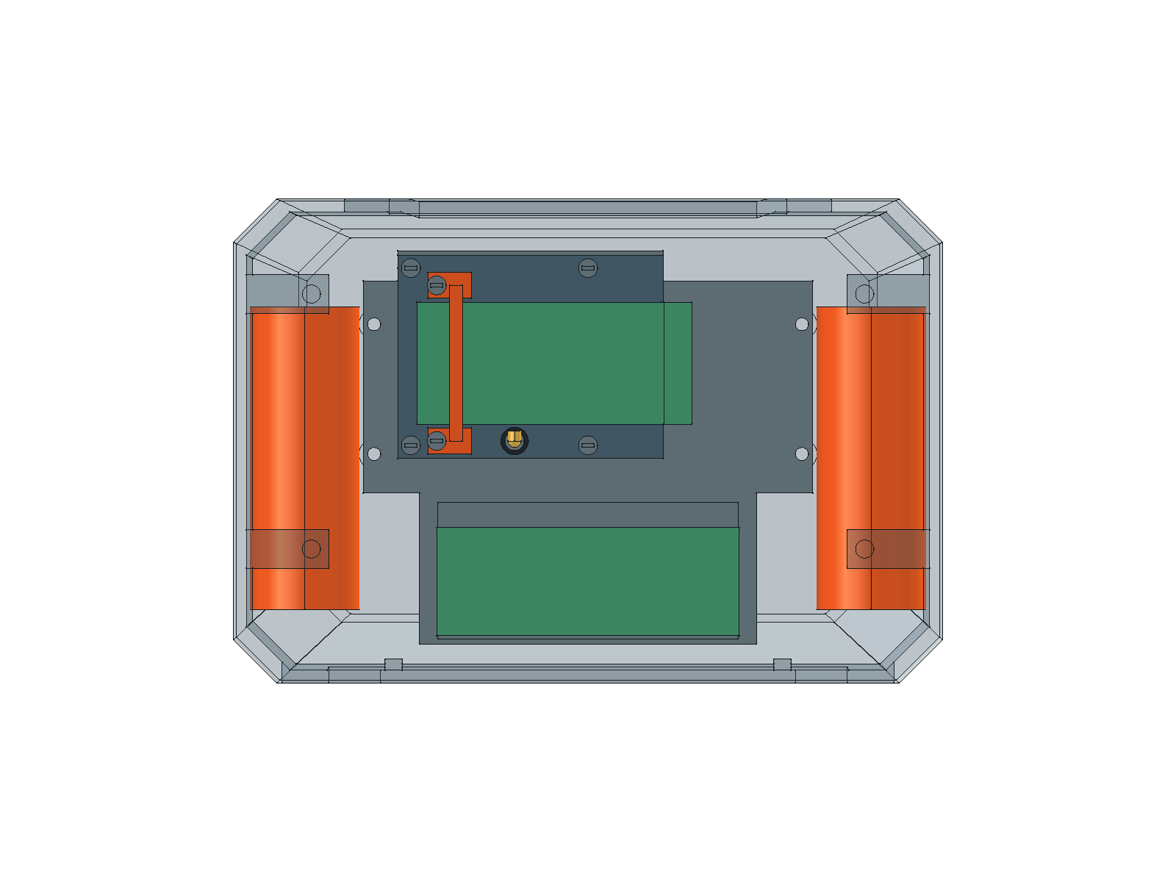
hardware/model/arc-top.png
