miclle/cybertrack/hardware/model/breadboard-access.png

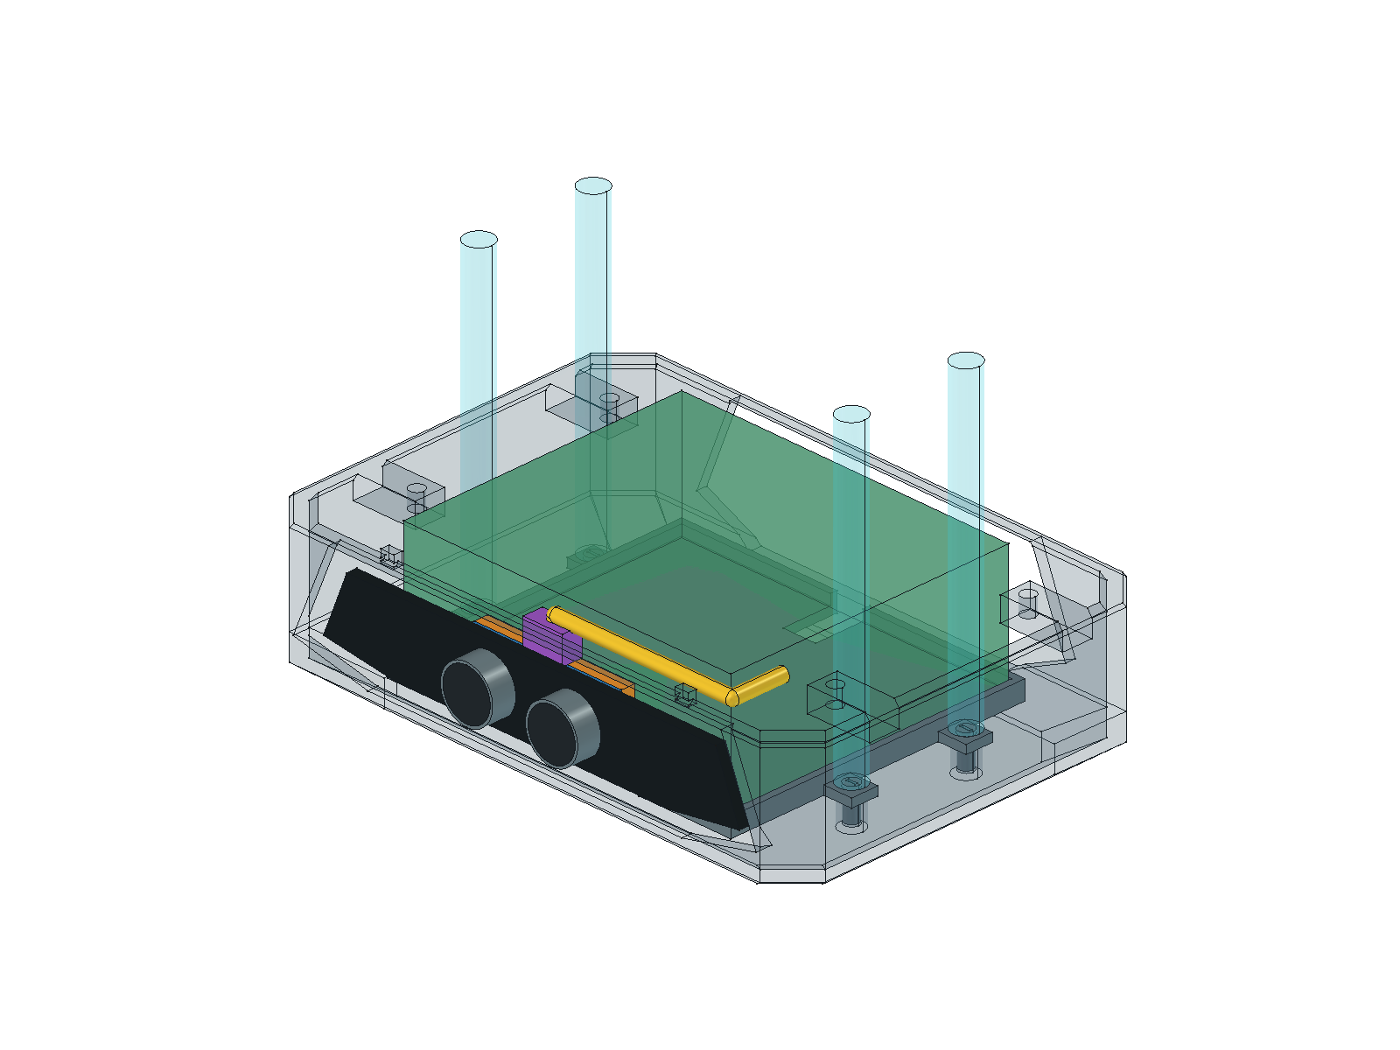
hardware/model/breadboard-access.png
