miclle/cybertrack/hardware/model/breadboard-service.png

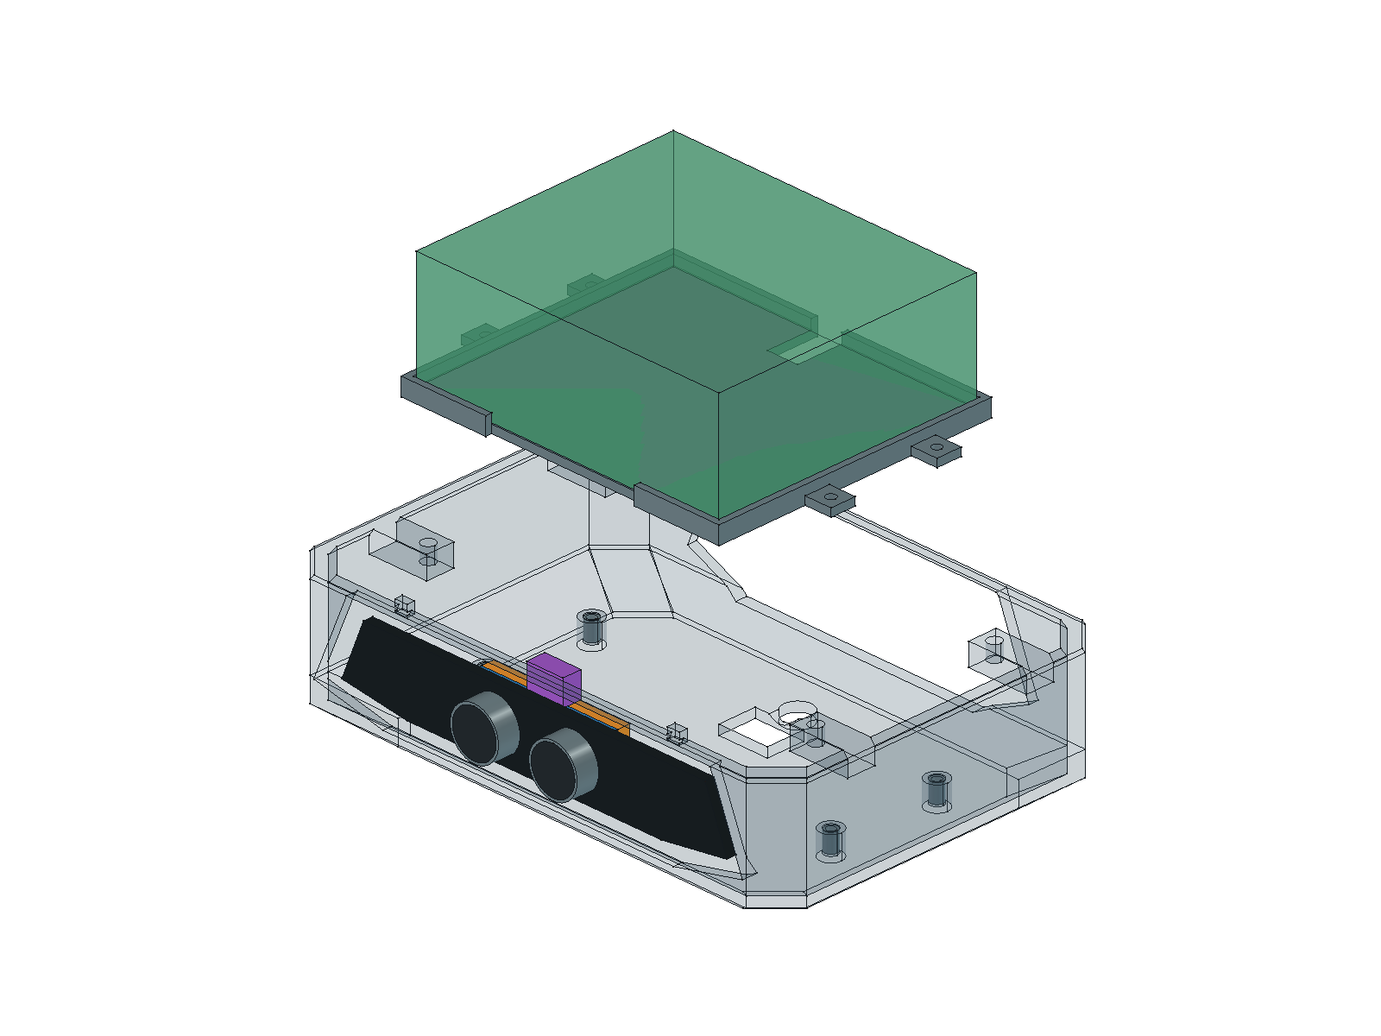
hardware/model/breadboard-service.png
