miclle/cybertrack/hardware/model/breadboard-top.png

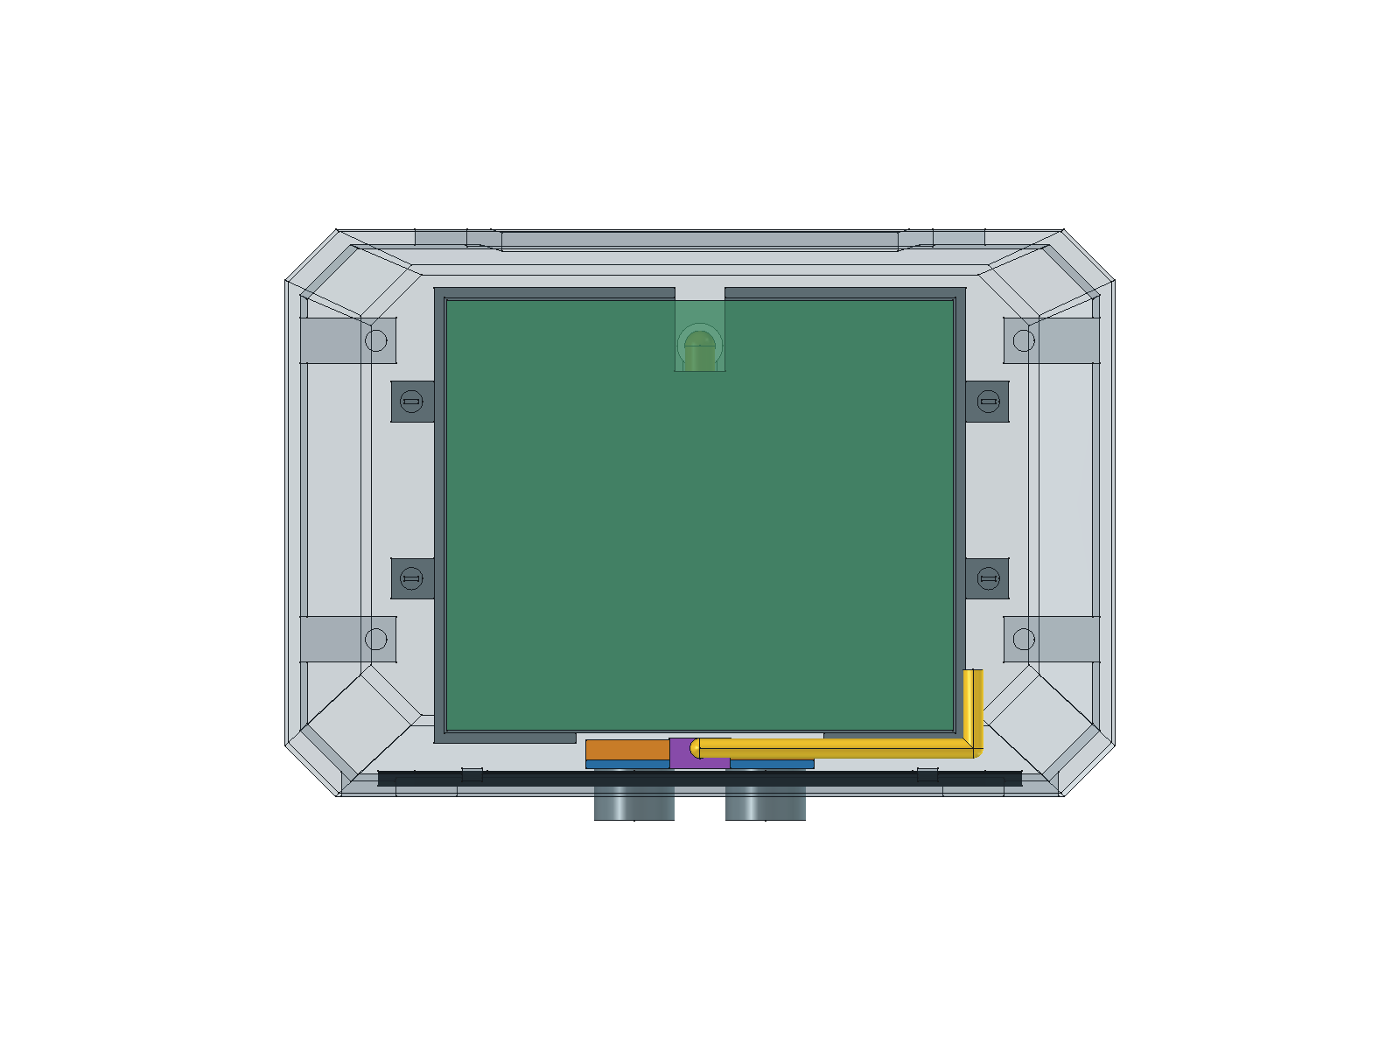
hardware/model/breadboard-top.png
