miclle/cybertrack/hardware/model/breadboard-tray.png

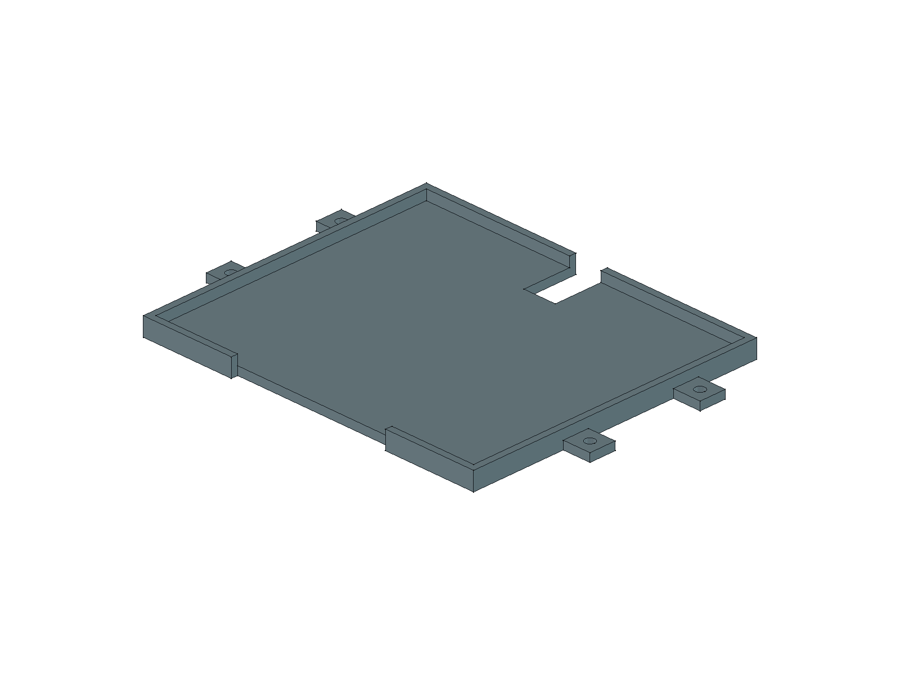
hardware/model/breadboard-tray.png
