miclle/cybertrack/hardware/model/bubble-gun-clearance.png

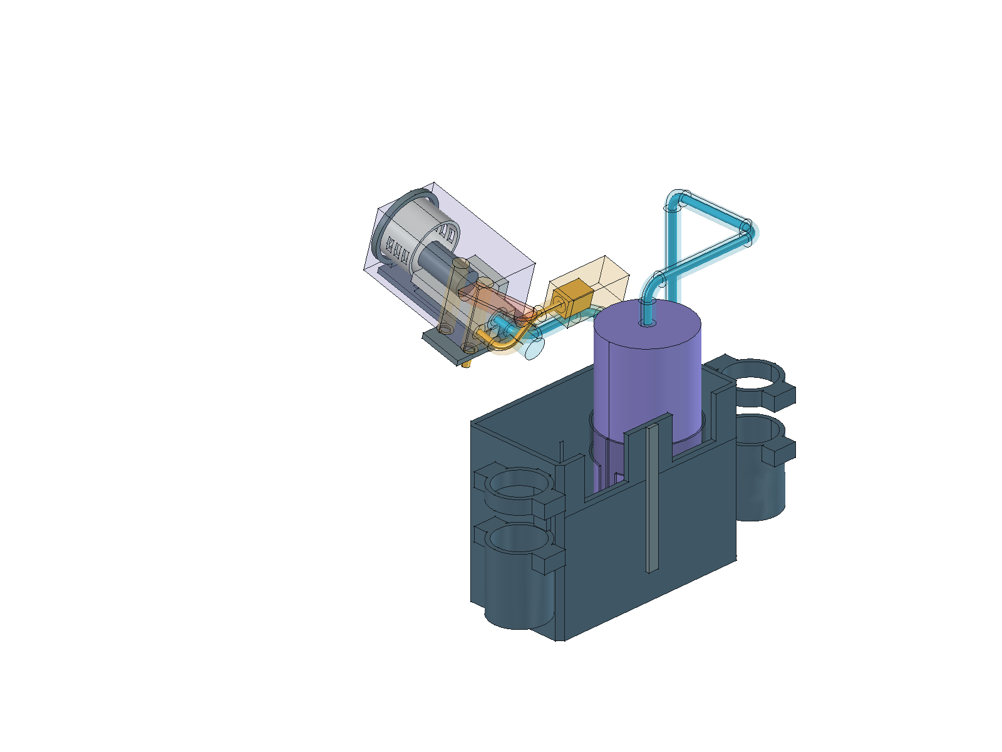
hardware/model/bubble-gun-clearance.png
