miclle/cybertrack/hardware/model/bubble-gun-side.png

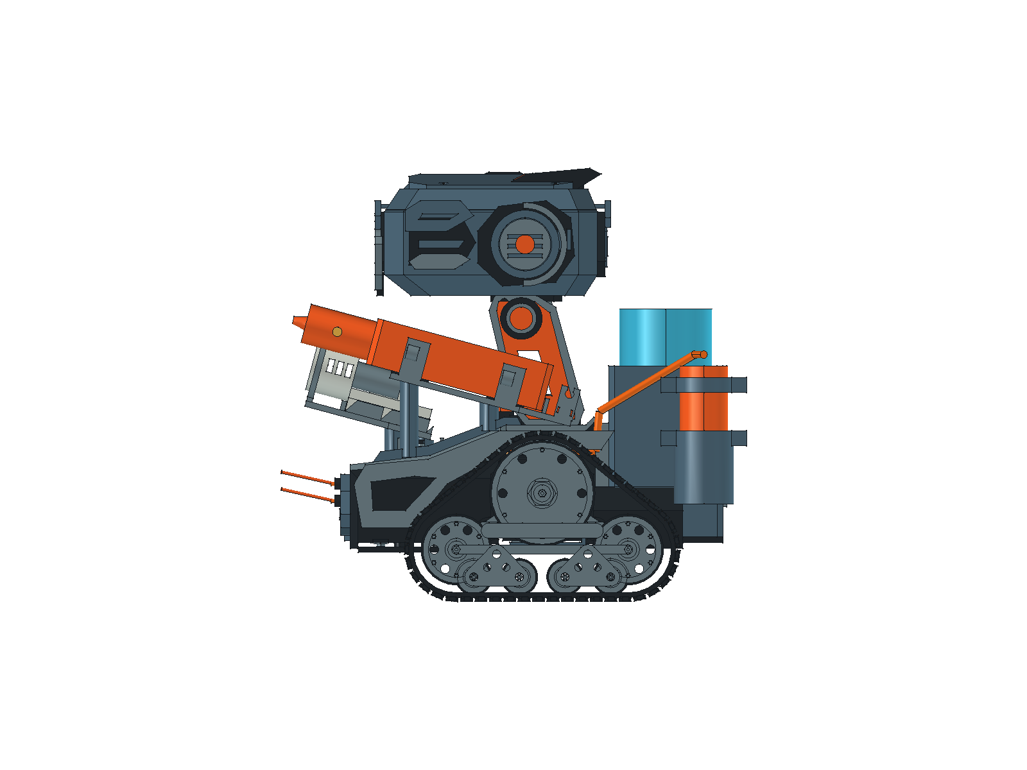
hardware/model/bubble-gun-side.png
