miclle/cybertrack/hardware/model/bubble-gun-tail-height.png

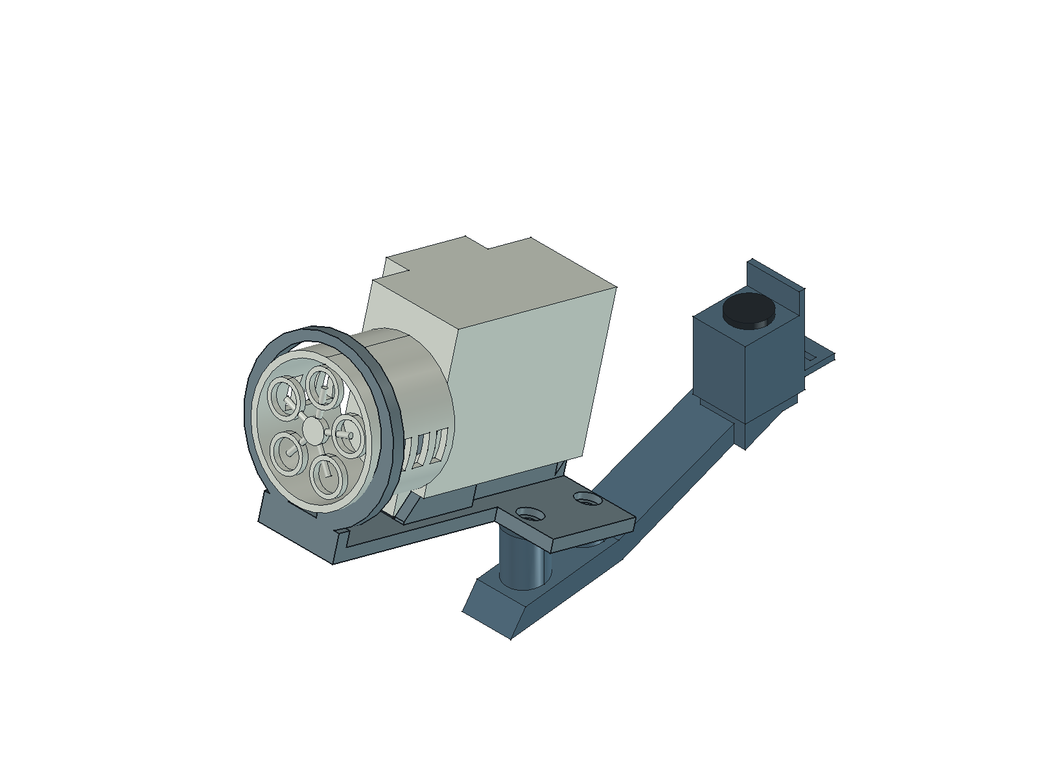
hardware/model/bubble-gun-tail-height.png
