miclle/cybertrack/hardware/model/bubble-tail-clearance-review.png

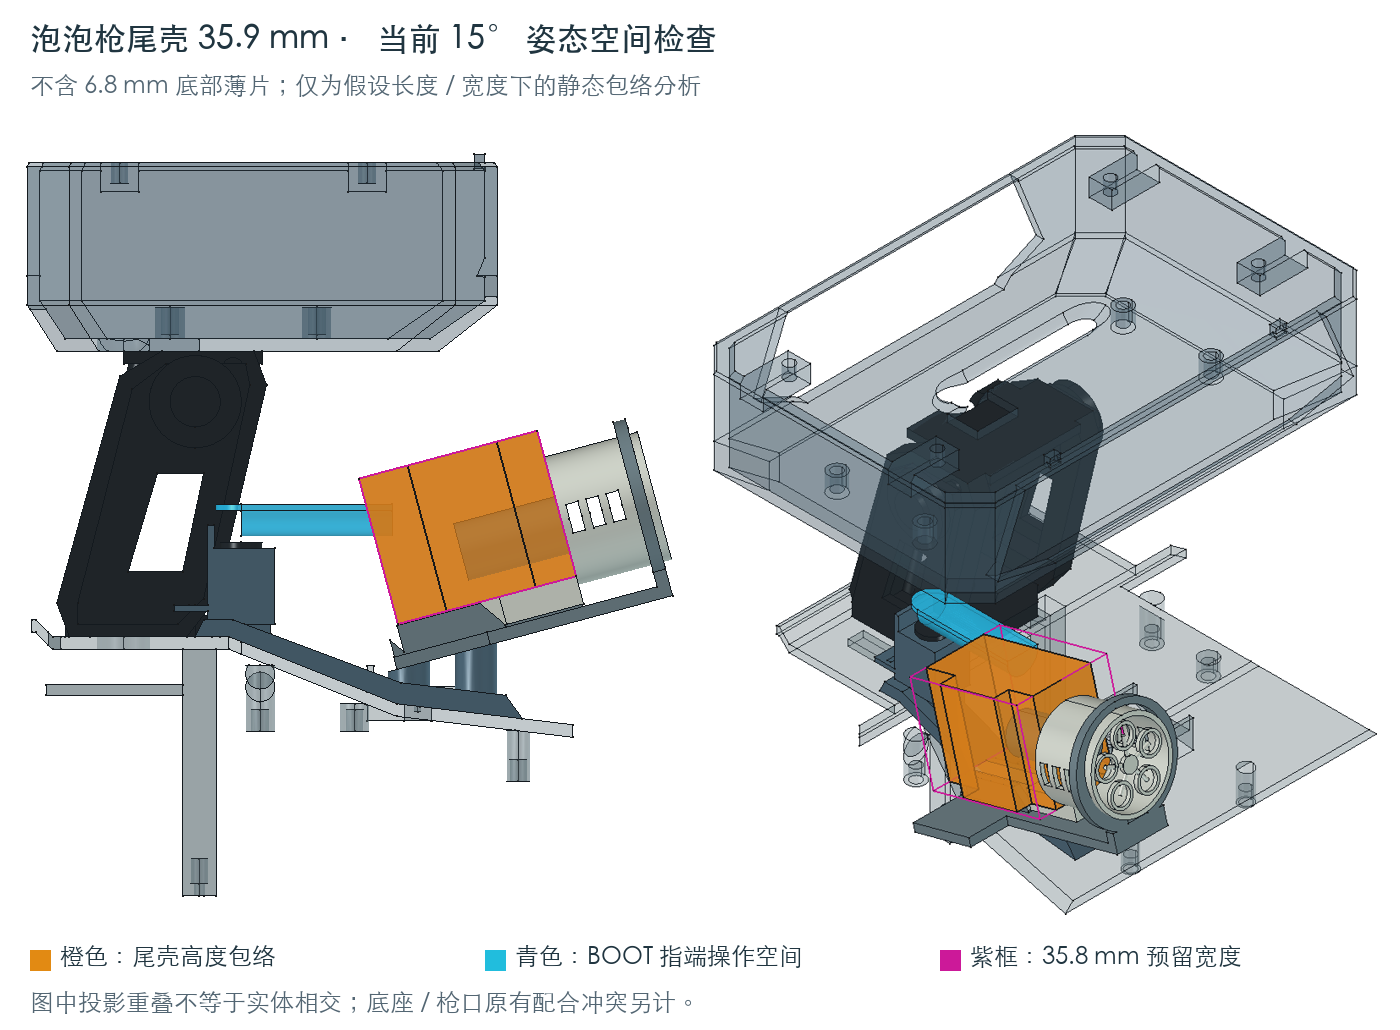
hardware/model/bubble-tail-clearance-review.png
