miclle/cybertrack/hardware/model/comparisons/0.35-to-0.36/rear-before-after.png

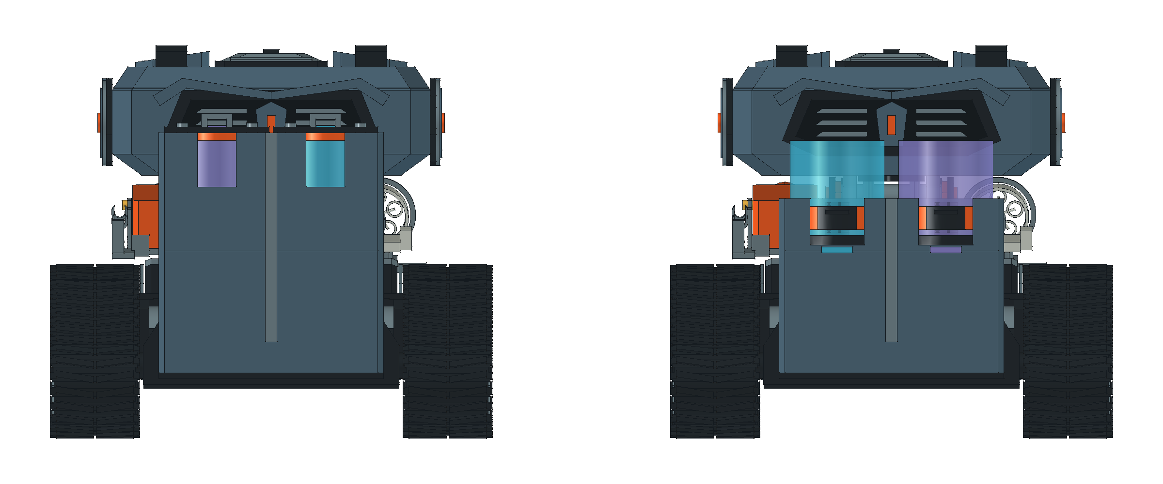
hardware/model/comparisons/0.35-to-0.36/rear-before-after.png
