miclle/cybertrack/hardware/model/comparisons/0.35-to-0.36/side-before-after.png

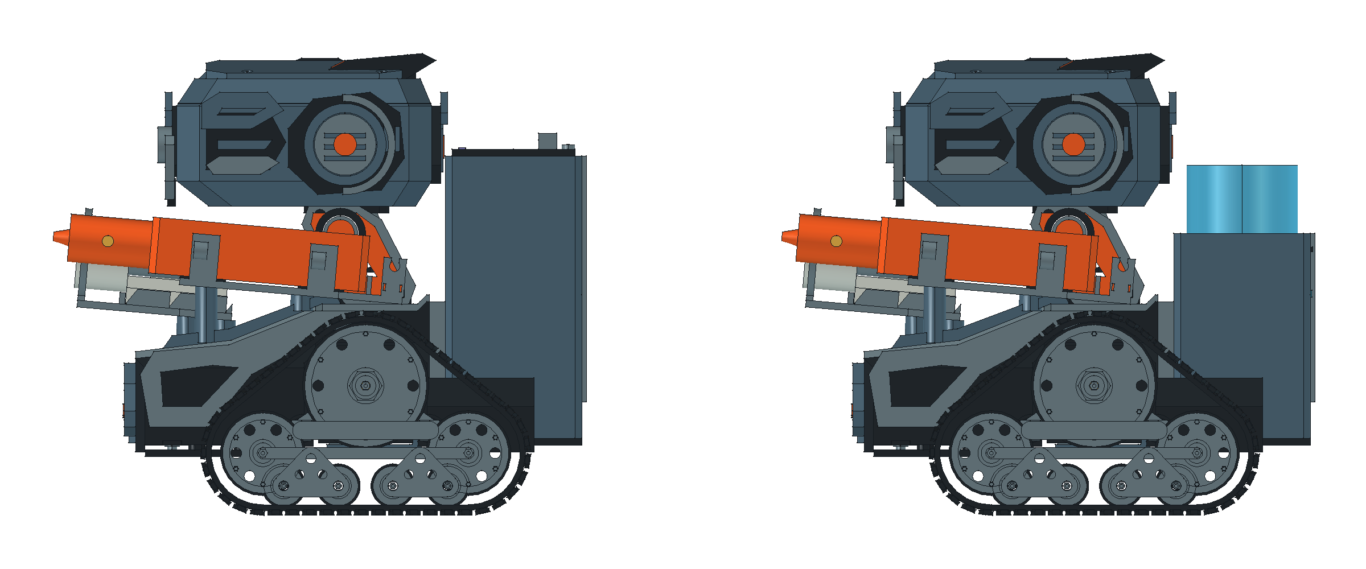
hardware/model/comparisons/0.35-to-0.36/side-before-after.png
