miclle/cybertrack/hardware/model/comparisons/0.36-to-0.37/side-before-after.png

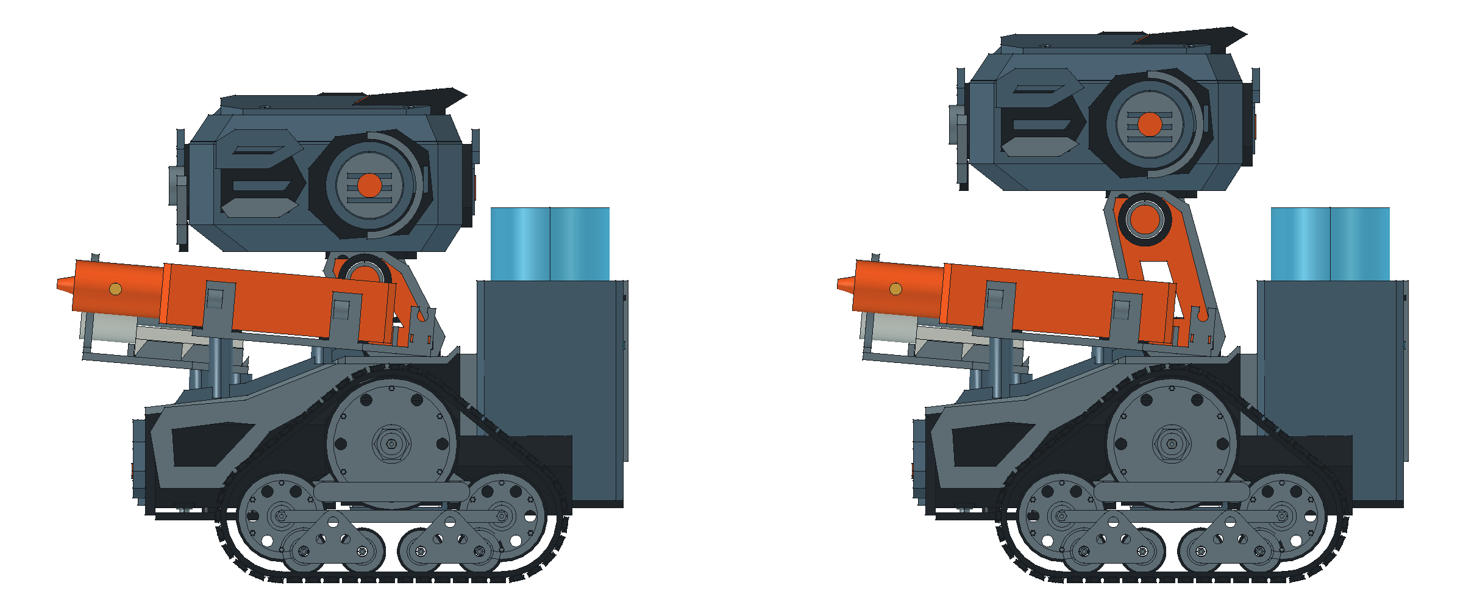
hardware/model/comparisons/0.36-to-0.37/side-before-after.png
