miclle/cybertrack/hardware/model/comparisons/0.38-to-0.39/side-before-after.png

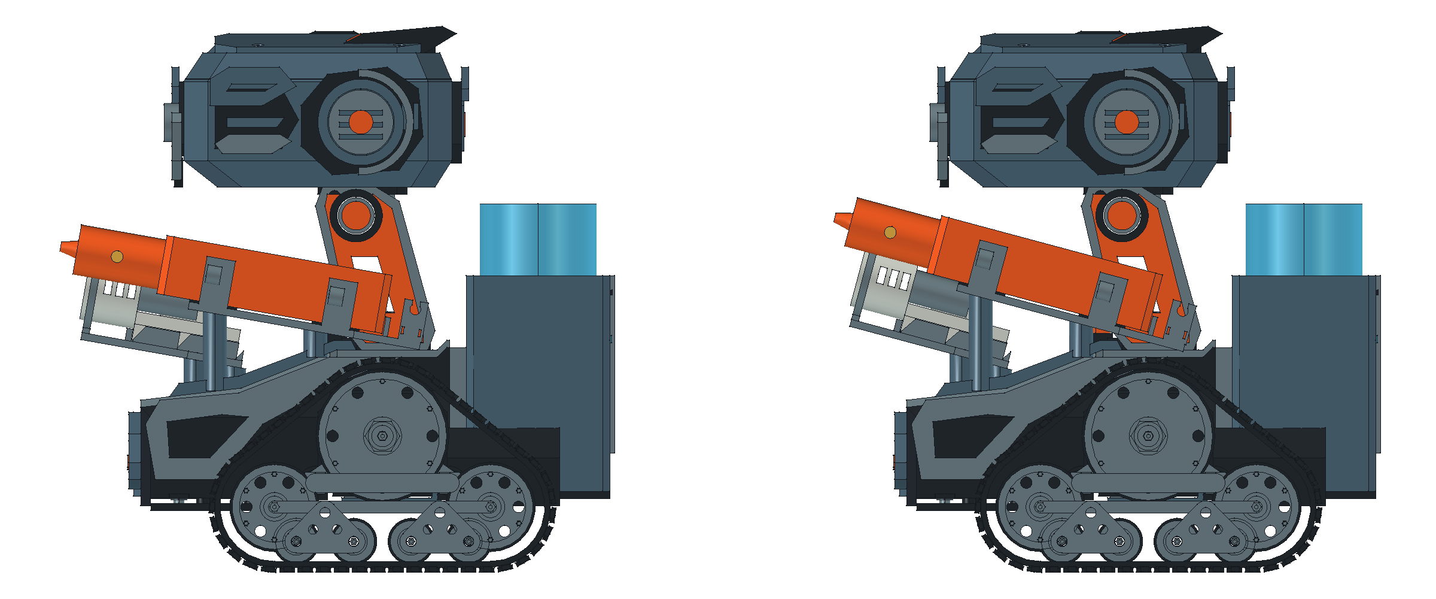
hardware/model/comparisons/0.38-to-0.39/side-before-after.png
