miclle/cybertrack/hardware/model/container-garage/appearance-closed-open.png

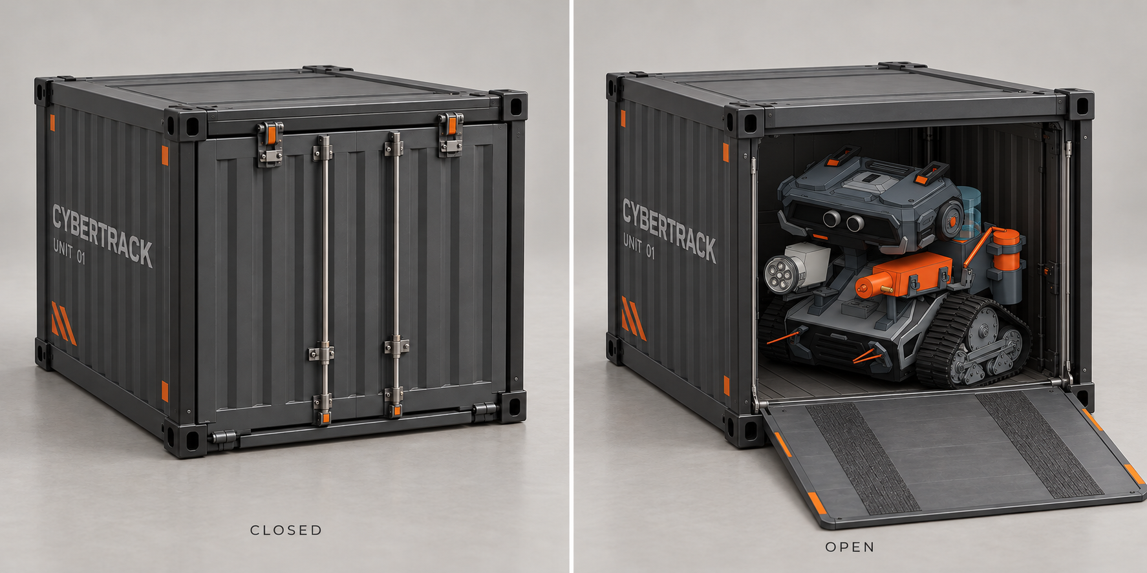
hardware/model/container-garage/appearance-closed-open.png
