miclle/cybertrack/hardware/model/container-garage/front-clearance.png

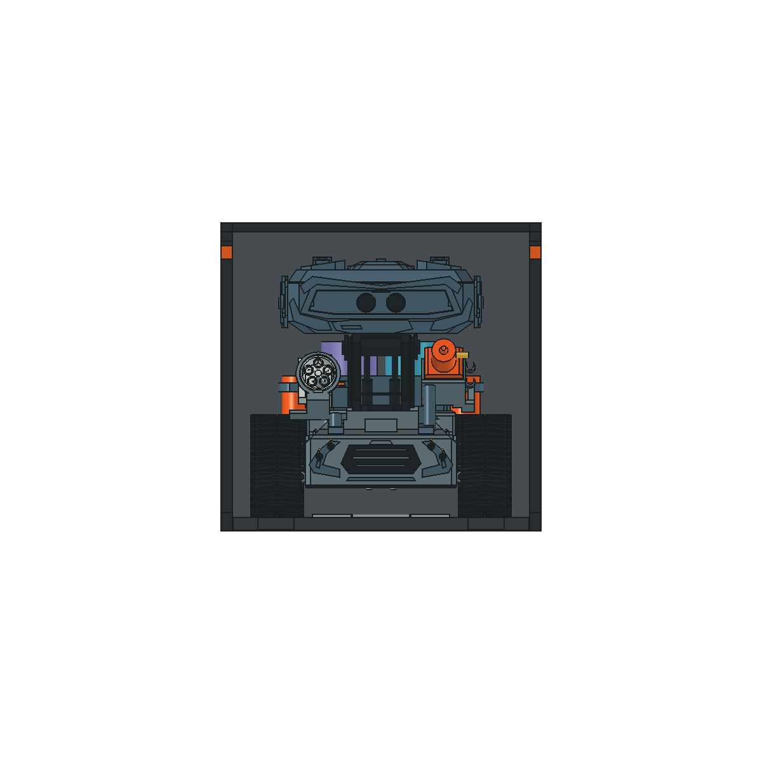
hardware/model/container-garage/front-clearance.png
