miclle/cybertrack/hardware/model/controller-access.png

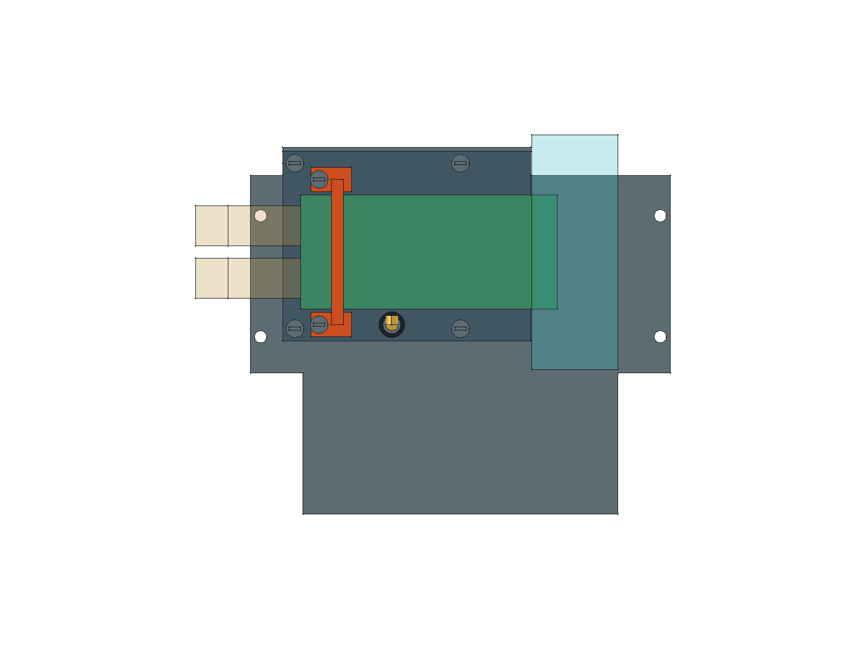
hardware/model/controller-access.png
