miclle/cybertrack/hardware/model/controller-service.png

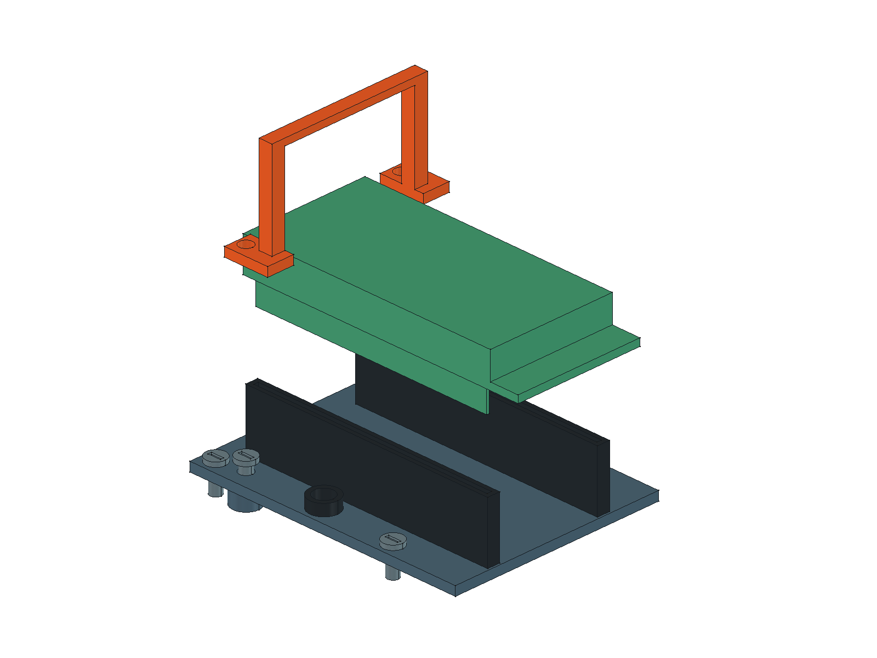
hardware/model/controller-service.png
