miclle/cybertrack/hardware/model/crown-effects-top.png

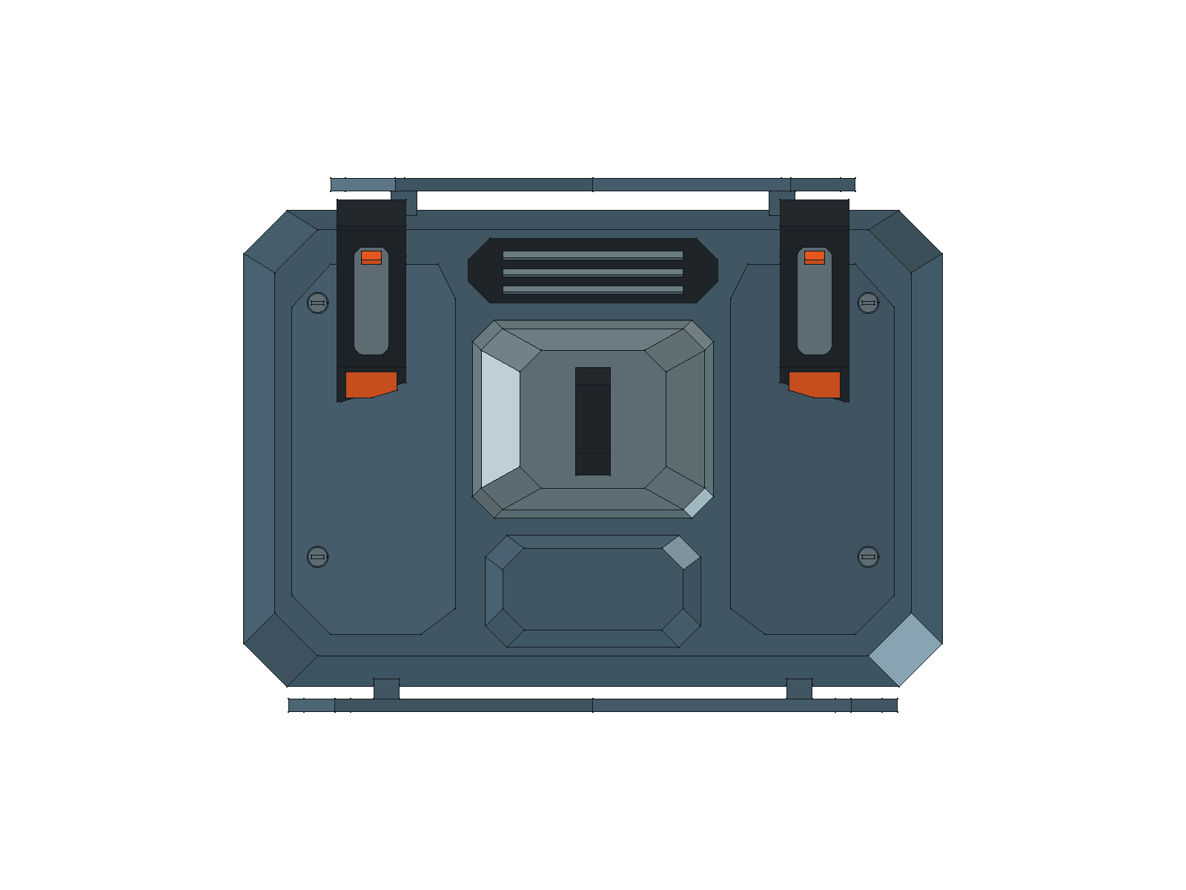
hardware/model/crown-effects-top.png
