miclle/cybertrack/hardware/model/drive-bottom.png

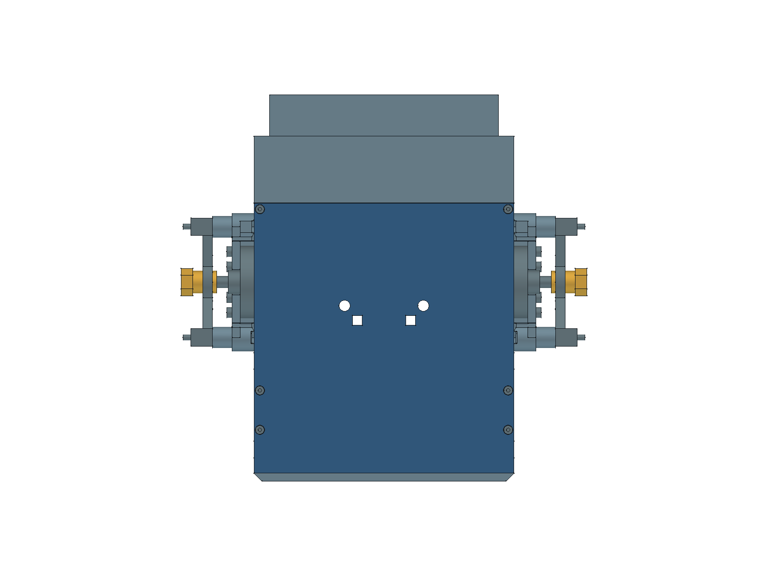
hardware/model/drive-bottom.png
