miclle/cybertrack/hardware/model/drive-fit-fixture/l298n-gap-study/layout-comparison.png

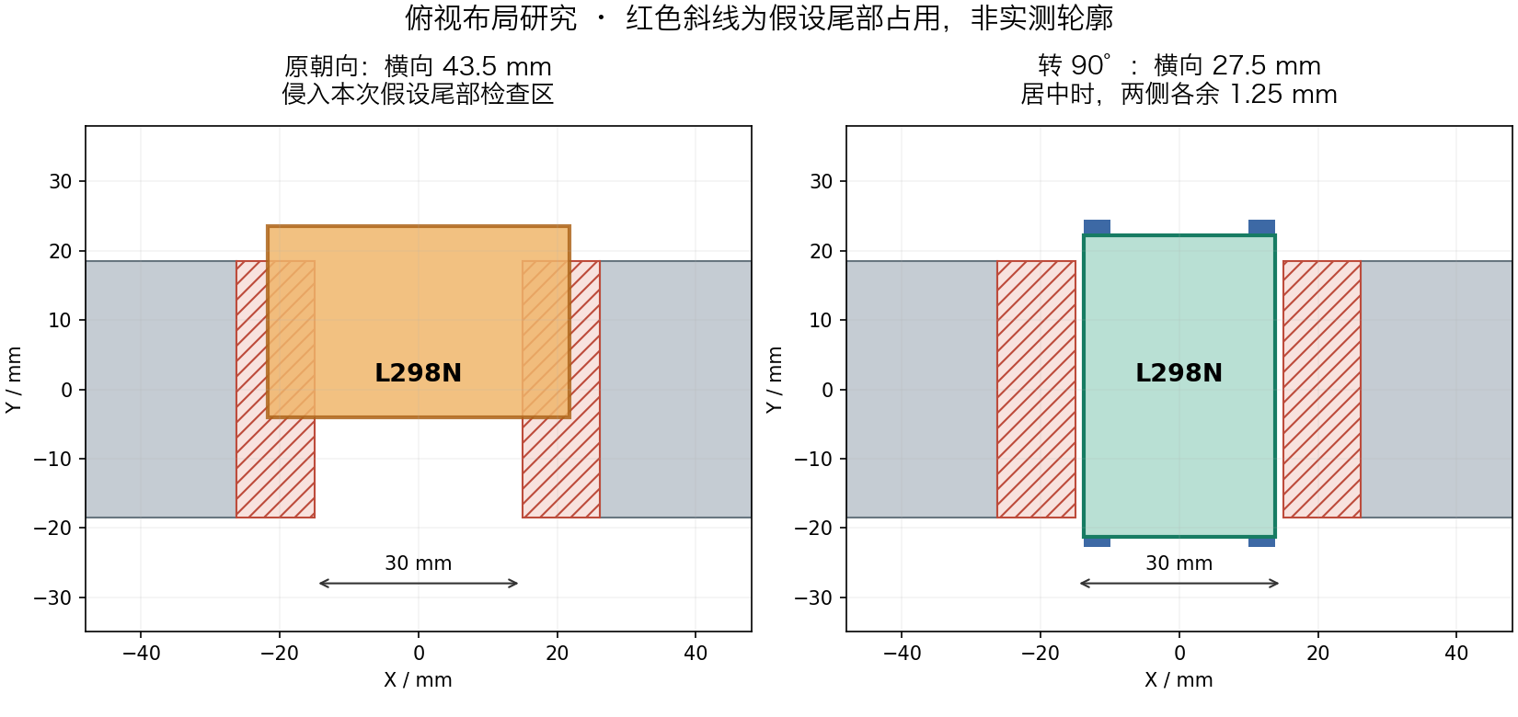
hardware/model/drive-fit-fixture/l298n-gap-study/layout-comparison.png
