miclle/cybertrack/hardware/model/drive-frame.png

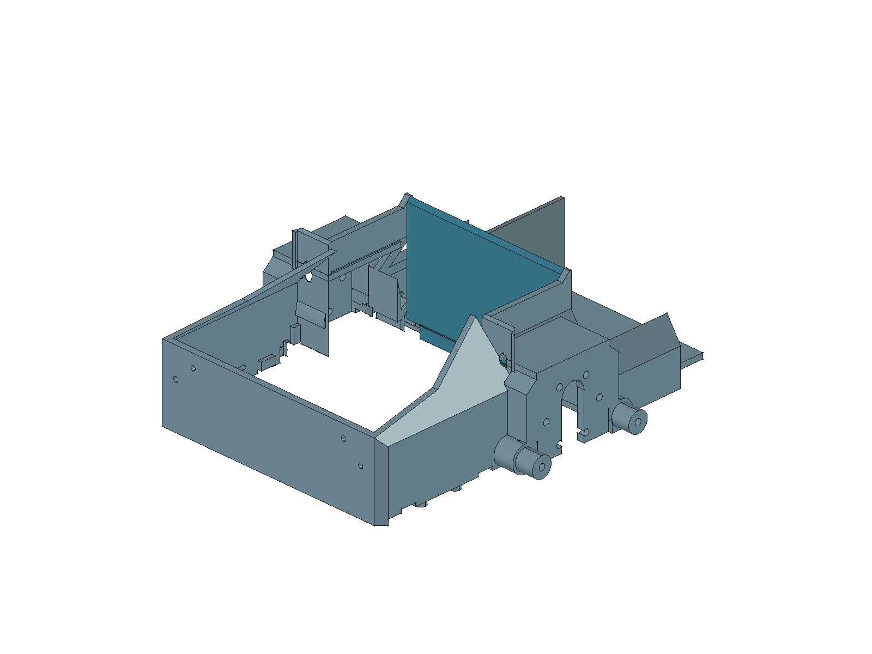
hardware/model/drive-frame.png
