miclle/cybertrack/hardware/model/drive-integrated-face.png

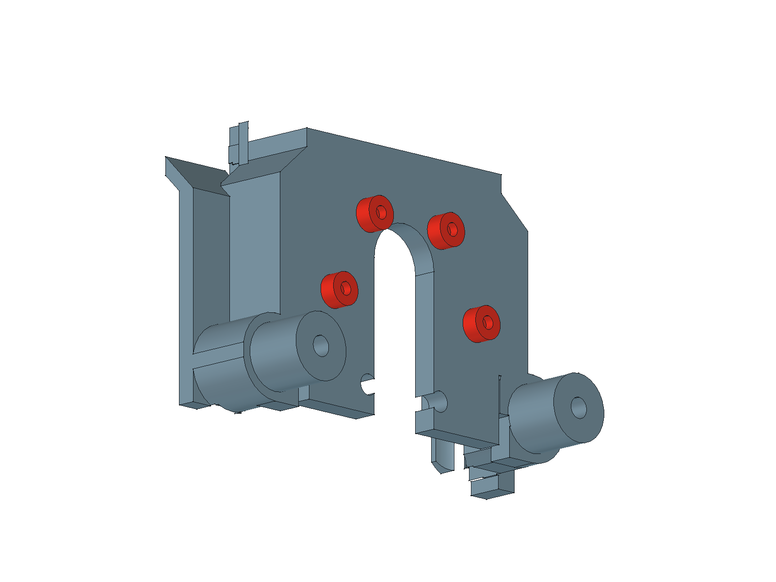
hardware/model/drive-integrated-face.png
