miclle/cybertrack/hardware/model/drive-service.png

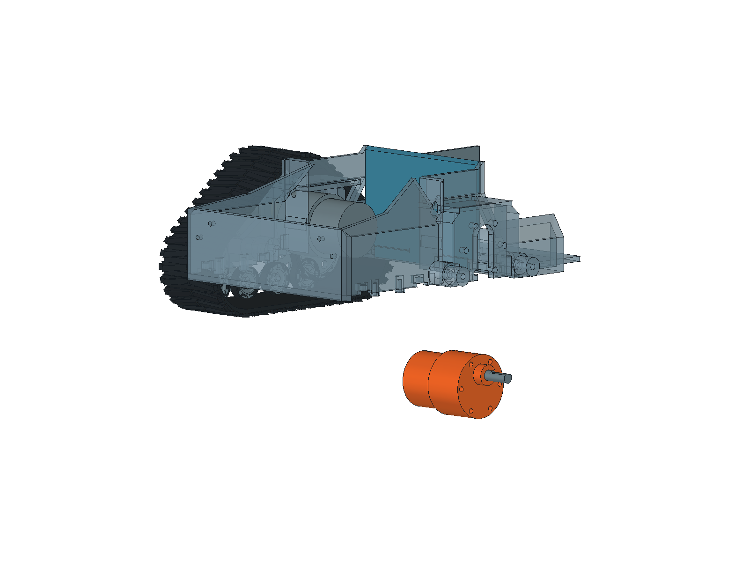
hardware/model/drive-service.png
