miclle/cybertrack/hardware/model/effects-housing.png

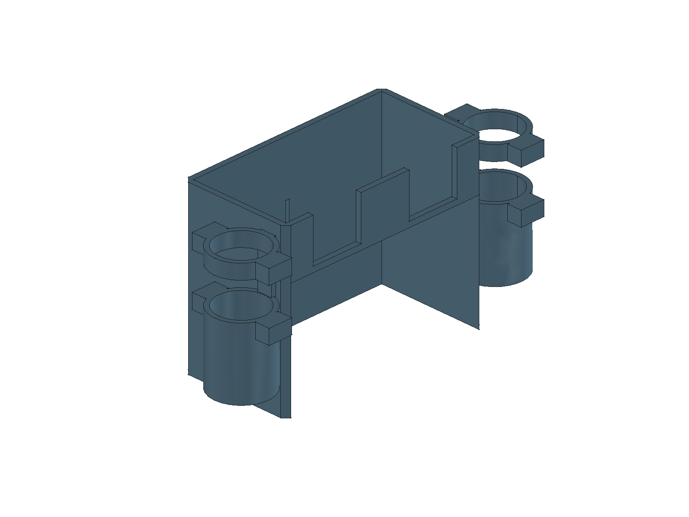
hardware/model/effects-housing.png
