miclle/cybertrack/hardware/model/effects-tray-service.png

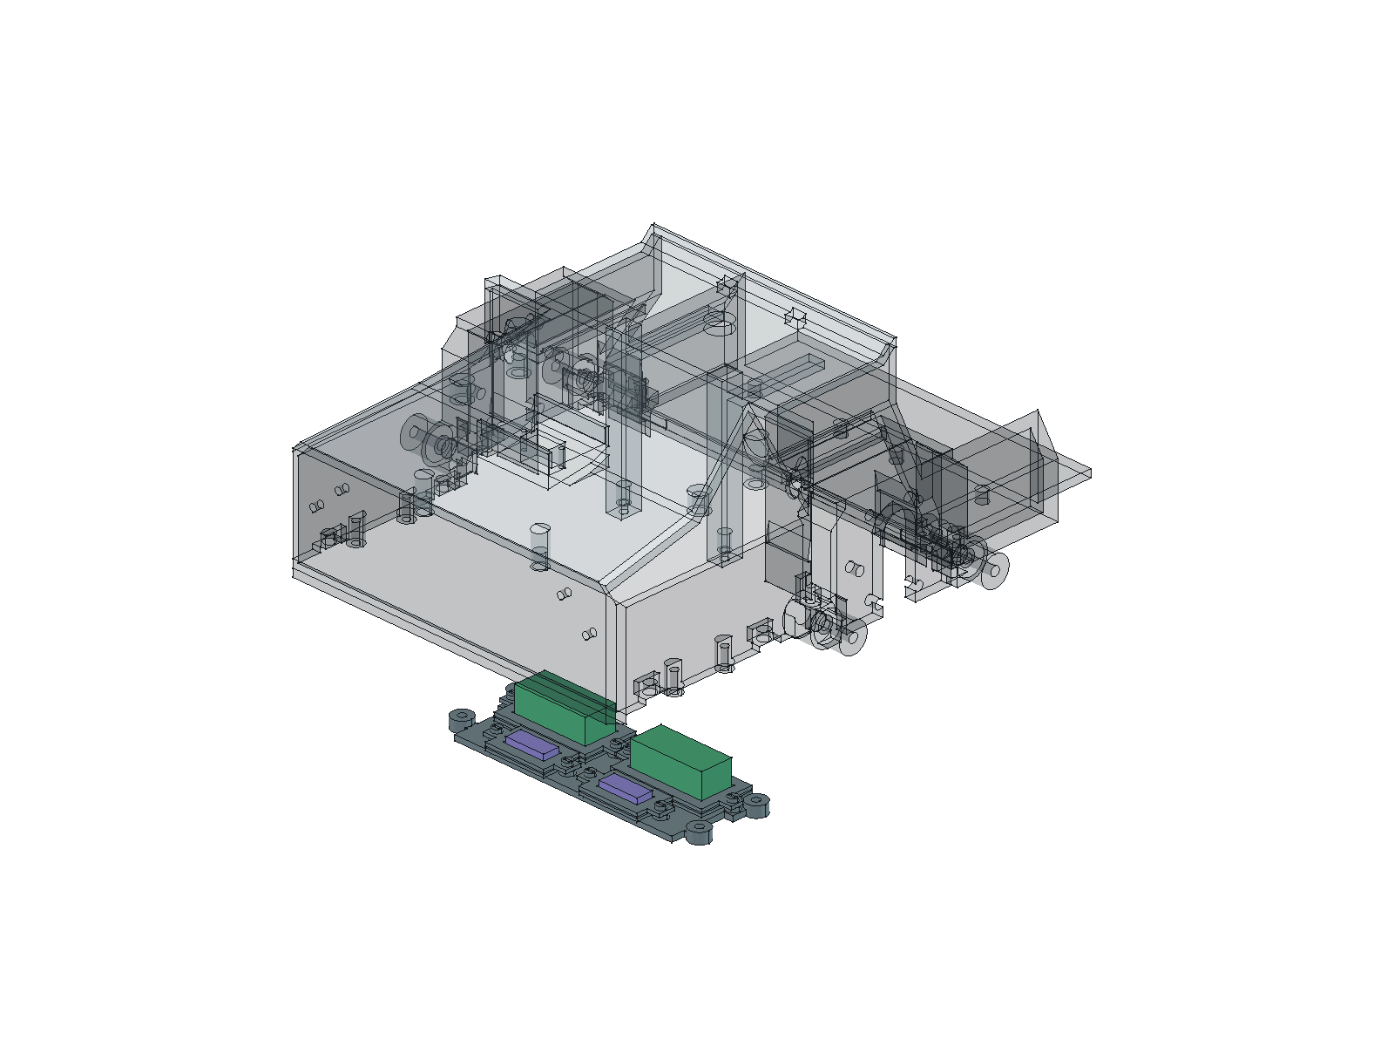
hardware/model/effects-tray-service.png
