miclle/cybertrack/hardware/model/l298n-compact/slicing/plate-preview.png

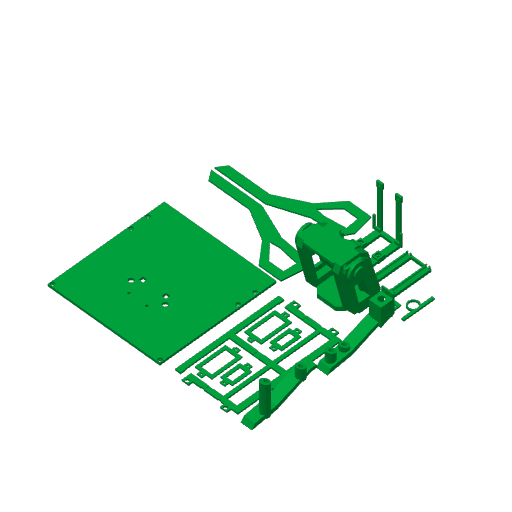
hardware/model/l298n-compact/slicing/plate-preview.png
