miclle/cybertrack/hardware/model/l298n-top.png

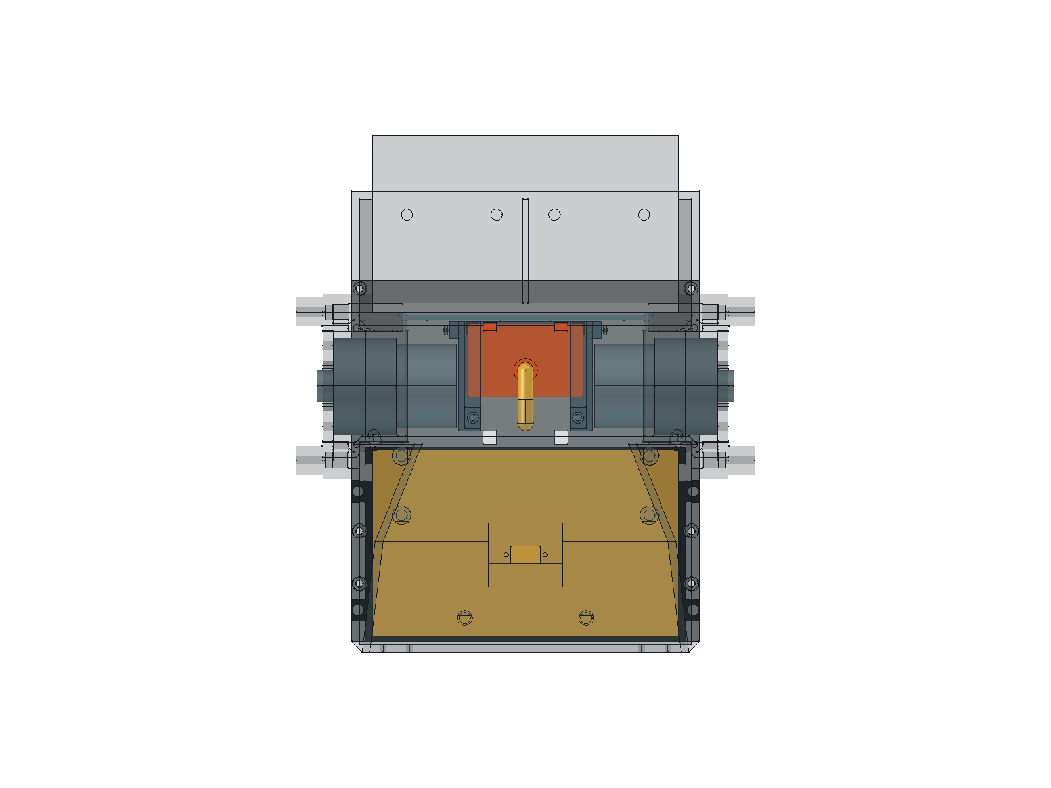
hardware/model/l298n-top.png
