miclle/cybertrack/hardware/model/power-switch-top.png

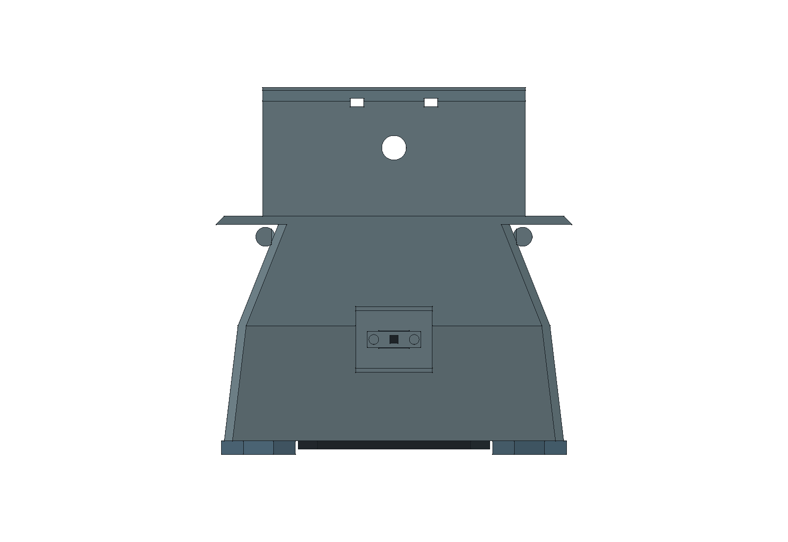
hardware/model/power-switch-top.png
