miclle/cybertrack/hardware/model/right.png

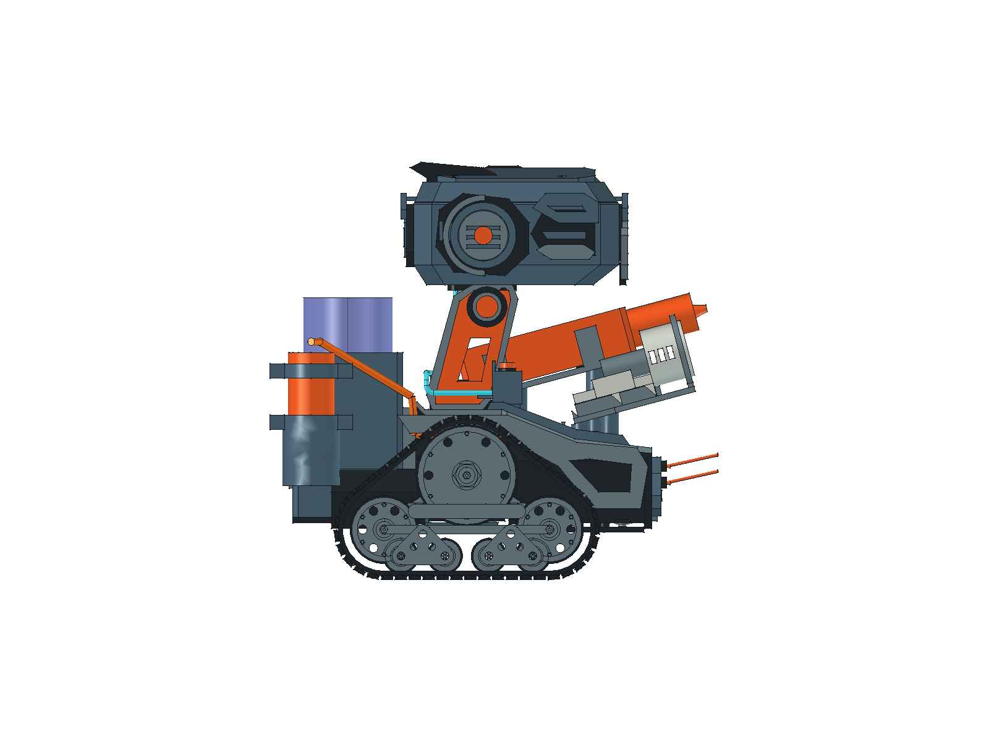
hardware/model/right.png
