miclle/cybertrack/hardware/model/routing.png

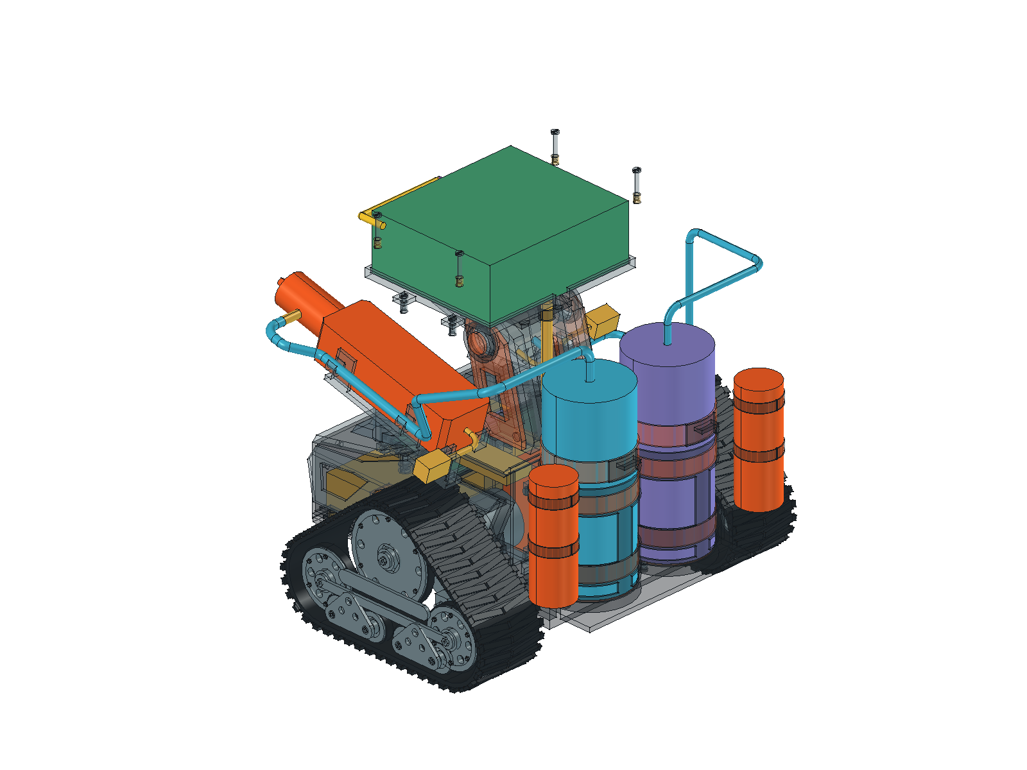
hardware/model/routing.png
