miclle/cybertrack/hardware/model/ultrasonic-front.png

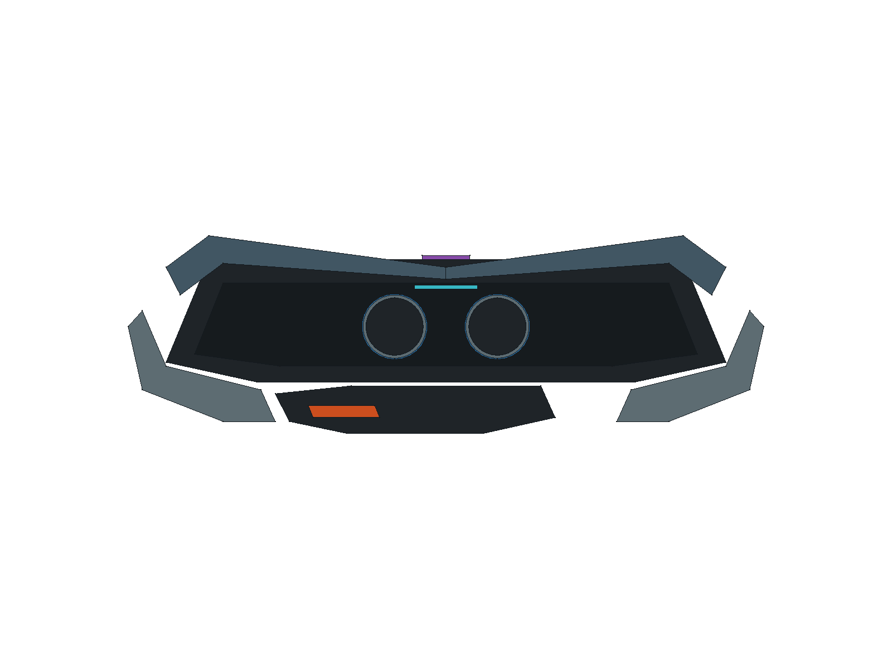
hardware/model/ultrasonic-front.png
