miclle/cybertrack/hardware/model/ultrasonic-layout.png

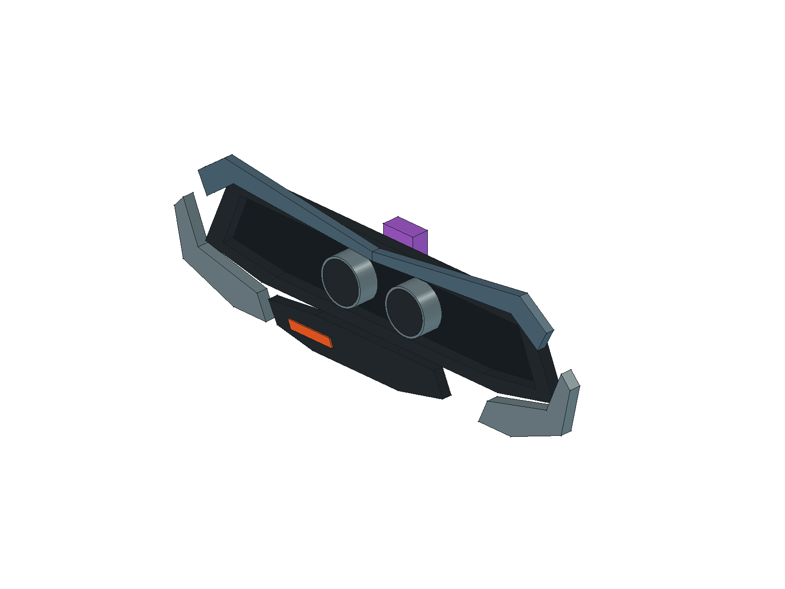
hardware/model/ultrasonic-layout.png
