miclle/cybertrack/hardware/model/ultrasonic-side.png

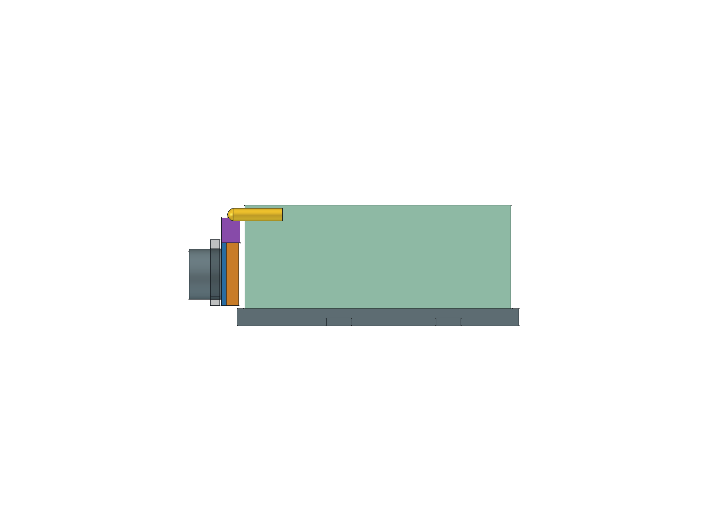
hardware/model/ultrasonic-side.png
