miclle/cybertrack/hardware/model/water-gun-service.png

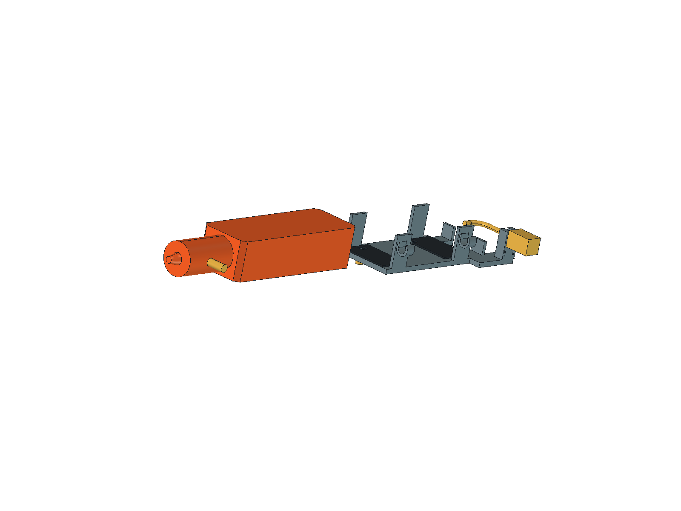
hardware/model/water-gun-service.png
