miclle/cybertrack/hardware/model/water-gun-spaces.png

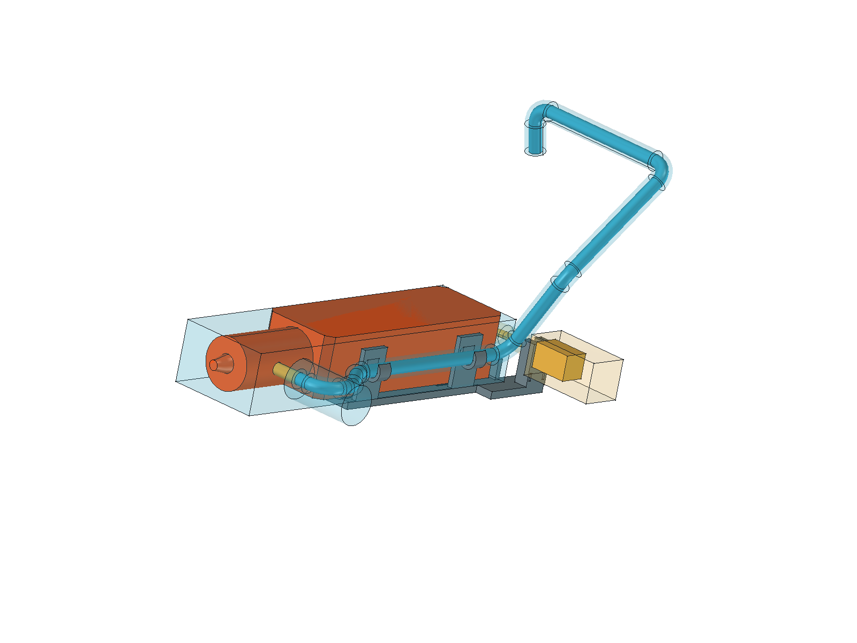
hardware/model/water-gun-spaces.png
