miclle/cybertrack/hardware/components/L298N/README.md

# 何健弓 L298N 电机驱动板模块

更新：2026-10-25。用户指定此模块替换 DF-MD V1.3，作为 CyberTrack 左右两台 37R-520 有刷电机的当前驱动选型。BOM H03 需求为 **1 块**，采购编号 **P13**；用户已提供实物照片及首轮台架反馈；订单数量、机械安装和完整电气适配尚未确认。

## 商品来源与证据

- 用户指定：[京东商品 10231029535273](https://item.jd.com/10231029535273.html)。2026-10-25 通过浏览器读取，店铺为“京元工业品专营店”，品牌栏为何健弓，已选选项为“L298N电机驱动板模块”。
- 同页另有“TB6612FNG电机驱动板【未焊排针】”。已读取的商品详情图出现 TB6612 说明、接口及示例资料，属于混合系列内容，不能套用于本次 L298N。
- 本次未取得与所选 L298N 版型明确匹配的整板原理图、尺寸图及电气额定条件，不从主图比例估算孔位或沿用其他商家的板尺寸。
- [ST L298 数据手册](https://www.st.com/resource/en/datasheet/l298.pdf)，DS0218 Rev 5，2023-10；2026-10-25 核对芯片引脚与电气特性。它是芯片资料，不证明该商品整板的供电、连续电流、保护或散热能力。

## 尺寸输入（2026-10-25）

用户提供模块尺寸：**长 46.2 × 宽 43.5 × 高 27.5 mm**，对应上述京东商品及 L298N 选项。来源为本次用户输入，未注明测量方式，不标作厂商图纸或实测认证值。

这三项尺寸作为后续布局输入；是否包含散热器、板底焊脚和端子突出部分尚未说明。PCB 单独尺寸、安装孔径／孔距及真实接头／线弯／散热净空仍待核实；正反面照片已确认器件分布；独立模型按长 X、宽 Y、高 Z 建立；0.33 整机改为下部干舱竖装，0.34 支架与接线／通风候选见后文。未完成实物安装验收。

## 接口迁移边界

| 项目 | 当前约定 | 待确认 |
|---|---|---|
| 驱动用途 | 1 块双桥驱动左右两台有刷电机 | 实际通道对应、方向及负载能力 |
| 系统电源 | 充电宝＋MT3608，目标 12 V 电机母线 | 整板电源入口、逻辑稳压电路、12 V 工况及保护 |
| 控制预算 | 按 L298 芯片 Enable A/B、Input 1–4，暂留 2 路 PWM 使能＋4 路方向输入 | 常见板标记 ENA/ENB、IN1–IN4；本商品端子、引出方式及跳线须核实；整机 GPIO 未分配，独立 N16R8 双路台架暂用 A=GPIO4/5/6、B=GPIO7/8/9 |
| 默认停止 | 两路使能在启动、复位、下载及主控失电时保持禁用 | 实物使能跳线与下拉；软件初始化不能替代硬件默认状态 |
| 逻辑兼容 | 芯片数据手册给出 TTL 输入 | 板上输入电路、3.3 V 控制兼容、控制端回灌与电源时序 |
| 5 V 端与跳线 | 未核实前不将其与 ESP32／USB 电源正极并接 | 5 V 端输入／输出方向、稳压跳线与 ENA/ENB 使能跳线分别核对 |
| 机械安装 | 用户提供长 46.2 × 宽 43.5 × 高 27.5 mm；已建立独立包络及 0.34 竖装托框候选 | 尺寸包含范围、PCB 外形、孔径／孔距、接头、线缆、散热及空间的实物适配 |

旧 DF-MD 的 E1／M1 两线台架已停用。[当前 0.3.2 双路工程](../../../firmware/esp32-motor-bench/README.md)使用 A=GPIO4／5／6→ENA／IN1／IN2，B=GPIO7／8／9→ENB／IN3／IN4，约 60% PWM、单次 10000 ms；显式选择通道后另行使能，任一路故障或停止都关闭两路。双路软件回归／编译通过，六脚上电前后静态关闭已获用户确认，此前 0.3.1 的 3 秒版 8 组空载组合已获用户确认：单路互不干扰、方向符合预期、正常停止且无异响或异常发热；随后一次双路 BOOT 提前停止及松开不恢复也获用户确认；旧 ENB 接地线必须在全断电时移除，两使能跳帽保持取下。用户已报告静态电压、200 ms 正转和两次 40%／10 秒反转正常停止；第二次反转启动和运行母线约 12 V，见[40% 记录](../../../firmware/esp32-motor-bench/reverse-40pct-verification.json)。60%／10 秒空载反转已获用户正常停止反馈，母线约 12 V，较 40% 更快更顺畅且无异常；双路电流／定量温升和带载能力待测。[旧 DF-MD 记录](../../../firmware/esp32-motor-bench/df-md-history.md)独立留档。 用户已确认双路 60%／10 秒空载正转正常启停，启动、运行中及临近停止母线均约 12 V，电机和 L298N 无明显发热、无异响或其他异常；这是万用表读数与主观发热观察，电流和定量温升仍未测。

L298 功率级的压降与发热仍需评估，12 V 母线不保证电机端为 12 V；不能用芯片极限参数宣称整板两路连续电流能力。充电宝多端功率、MT3608 实际能力及双电机负载预算仍按现有电源记录核验。

## 替换状态

- DF-MD V1.3 已从当前 BOM、需求、架构和接口方案退出；2026-10-25 移除旧部件目录，原始 PDF／图片可从 Git 提交 `163fa48` 查阅。[旧板故障及台架记录](../../../firmware/esp32-motor-bench/df-md-history.md)继续保留，不作为新板规格或通过证据。
- 0.33 已新增独立 `L298NEnvelope` 并安排在下部两台电机之间；头舱剩余电子分配保留，旧 DF-MD 证据不继承。
- 新板台架软件适配及主机模拟／交叉编译已完成；用户已报告供电、静态关闭电压和一次 200 ms 空载动作；双路空载 BOOT 提前停止及松开不恢复已获用户确认；实物安装、复位默认关闭、机械带载停止及热验证仍未完成，统一跟踪 [TODO 的 Q05](../../../docs/TODO.md)及[验收 V01–V04](../../../docs/verification-plan.md)。

## 独立包络与整机位置（0.33 建立，0.34 沿用）

- [独立原生模型](L298N-envelope.FCStd)、[独立 STEP](L298N-envelope.step)与[回读记录](readback.json)：单一 46.2 × 43.5 × 27.5 mm 完整长方体，原点在最小角；不推定板厚、散热器、端子或安装孔。
- [整机模型](../../model/CyberTrack.FCStd)中的 `L298NEnvelope` 以比例 1 导入；局部长轴 +X→整机 +Z、宽轴 +Y→−X、高轴 +Z→−Y，局部原点移至 (21.75, 23.5, 32) mm。世界包络 **X±21.75、Y−4…23.5、Z32…78.2 mm**。
- 候选位置为下部干舱中央、两台电机之间、后湿舱隔板前侧。头舱剩余 70 × 25 × 13 mm 占位不足以容纳该板；下部平放与原电源线占位相交，因此选择竖装并调整示意电源线绕行。
- 电源插头占位保持，Ø6 示意线束在 Y=−14 上升至 Z=84，再到 Y=6 接原颈架路径。不是实物线束弯曲半径、端子朝向或电气接线定版。
- 名义净距：两侧电机各 **4.45 mm**、后湿舱隔板 **1.5 mm**、底盖 **3.2 mm**、电源插头占位 **1.0 mm**。以上为裸包络净距；0.34 已添加支架，含夹件的净距见下节；当前包络不能作为制造件。
- 拆下底盖及其 6 颗螺钉、断开实际驱动线束并拆下 0.34 托框的两颗锁紧件后，裸包络沿 −Z 下取 80 mm；[专项检查](../../model/l298n-fit-audit.json)记录静态、预留空间与连续下取扫掠，[范围核对](../../model/l298n-change-audit.json)确认其他部件保持。

下部干舱竖装候选

CAD 净距与扫掠结果不代表温升、散热、绝缘、固定强度、公差或实物装拆通过。整机 STEP 沿用排除 `envelope`／`clearance` 的外观导出约定，板卡包络在整机 FCStd 中；需要单板交换时使用上述独立 STEP。

## 用户正反面照片（2026-10-25）

原图已无损保存：[正面](reference/user-front-20261025.png)、[背面](reference/user-back-20261025.png)；来源、原始文件名、像素尺寸与 SHA-256 见[图片清单](reference/photos.json)。照片确认四角安装孔、上端散热器、两侧电机端子、下沿电源／控制接口及背面焊脚突出；不按图片比例补定孔径、孔距、PCB 尺寸或焊脚高度。

## 0.34 可拆固定候选

照片确认的朝向用于布局：散热器端朝 +Z，元件面朝 −Y，背面朝 +Y，两侧电机端子朝 ±X，下沿电源／控制接口朝底部检修口。照片没有补充精确的 PCB 平面、焊脚高度、孔径或孔距，因此独立包络不改形，采用四点可调边缘夹持；夹垫对应实际 PCB 安全边缘与否仍需试配。

[整机支架记录](../../model/README.md#034-l298n-支架与拆装)及[检查报告](../../model/l298n-mount-audit.json)包含托框、顶部一体吊架、接线及通风预留。完整托框组件距电机各 2.96 mm、后隔板 0.50 mm、底盖 0.40 mm、充电宝 6.26 mm、原电源线 1.00 mm。托框从底部整组取出，端子螺钉在机外操作。没有将照片、CAD 检查或空载台架观察作为热、夹持强度或制造验收。

## 插上控制线后的厚度与固定更新（2026-10-26）

用户实测从背面最突出焊脚至正面散热器或插头最外端的最大总厚度为 **28.5 mm**，取代本次装配检查中原来的 27.5 mm 厚度。旧独立包络不覆盖，新[接线包络修订](revisions/connected-28.5-2026-10-26/readback.json)沿用原长 46.2／宽 43.5，仅更新厚度。固定更新为[底盖承载托架与可拆上压框](../../model/l298n-compact/README.md)，原 0.33/0.34 位置和固定数据为历史记录；真实 PCB 接触面与端子局部位置仍未建模。
