miclle/cybertrack/hardware/components/power-switch/README.md

# 电源拨动开关

2026-10-26，用户要求为机器人安装图示电源开关，并补充以下实测尺寸。对应 BOM H15；[原始照片](reference/physical-20261026.jpg)按上传字节保存，来源与 SHA-256 见 [sources.json](sources.json)。不按照片网格或比例推算接口尺寸。

| 尺寸 | 用户实测输入 |
|---|---:|
| 含两侧挂耳的总宽度 | 19.5 mm |
| 挂耳下方本体宽度 | 10.6 mm |
| 厚度 | 5.8 mm |
| 挂耳安装面至底部，含焊脚 | 8.3 mm |
| 两挂耳孔中心距 | 14.8 mm |
| 挂耳孔径 | 2.6 mm |
| 拨柄宽 × 厚 | 2.9 × 2.9 mm |
| 拨柄总行程 | 6 mm |
| 拨柄顶端高出挂耳安装面 | 4 mm |

照片可见金属外壳、两侧挂耳、黑色拨柄和三个焊脚；型号、触点接通关系与额定参数未确认。挂耳厚度、挂耳在厚度方向的完整外形、焊脚位置及焊接后尺寸未知。当前建模假设挂耳厚0.5 mm、厚度方向包络5.8 mm，孔位与拨柄行程居中对称；本体用连续含脚包络，未虚构单个焊脚。

## 独立模型与安装

[FCStd](PowerSwitch-envelope.FCStd)与[STEP](PowerSwitch-envelope.step)保留部件本地坐标：X为厚度、Y为总宽及拨动方向，Z为安装面向外，以挂耳下表面为安装面Z=0；主体最低Z=−8.3，挂耳暂占Z0…0.5，拨柄最高Z=4。拨柄显示在行程中点，仅用于展示，不代表实际存在中间挡位。[回读报告](readback.json)记录双格式几何检查。

用户要求容易操作且彼此不干扰，并明确排除左右侧面，可考虑头顶、头后面或底盘折面顶盖。0.53采用**底盘折面顶盖中央**，孔组中心X=0、Y=−64 mm，安装面Z=81.1 mm；位置与固定结构见[安装说明](../../../docs/assembly.md#电源开关与停止按钮)。滑动方向沿整机X轴，开关从外侧落入本体通孔，两颗塑料用自攻螺丝从上方固定，不用内部螺母。安装座与原折面顶盖一体。

## 电气与验证状态

用途为电源开关；是否直接承载整机电流仍待具体型号的直流额定电压／电流、触点关系和整机启动／运行电流核对。照片和外形尺寸不能证明其总电源切断能力，既有独立执行器断电要求保留。具体接线未定，实物安装、通断、操作手感和温升未验证。
