miclle/cybertrack/hardware/components/dc-dc-buck/README.md

# DC-DC 降压模块（P12）

记录日期：2026-10-24。关联 H14 主控与效果支路稳压／开关。

商品：[淘宝 559262129625](https://item.taobao.com/item.htm?id=559262129625)。商品页因站点安全策略未读取；下面仅引用用户提供的两张商品说明图片和用户口述实测，不推定芯片型号、输入范围、电流或保护功能。

## 图片与接口

- [背面图片](board-back.png)：可见 `VO+`、`GND`、`IN+`、`EN`，以及 `ADJ`、12 V、9 V、5 V、3.3 V、2.5 V、1.8 V 选择焊盘。
- [接线与选压说明](voltage-selection.png)：`VO+` 为输出正极，`GND` 为输入输出公共负极，`IN+` 为输入正极，`EN` 为使能。图片说明默认可调；固定输出时断电切断红圈内默认连接，再桥接所选电压的一对焊盘。
- 两张附件按原字节保存，第三方标识／权利保留；来源、SHA-256 见 [sources.json](sources.json)。这些是商品示意，不是实物焊接状态或仪表读数照片。未覆盖任何已有只读部件资产。

3.7 V 不在图示固定档位中。尚未确认用户实际采用可调模式还是其他设置，不把先前讨论的 3.3 V 焊盘操作记录为已执行。EN 的默认偏置、有效电平和允许范围未提供，不自行规定其接法。

## 用户实测记录

| 项目 | 2026-10-24 记录 |
|---|---|
| 输入 | 用户报告 5 V |
| 输出 | 用户报告接线测试成功，输出 3.7 V |
| 原目标 | 对话最初询问 5 V → 3.3 V；实际最新反馈为 3.7 V，不能写成 3.3 V 验证通过 |
| 测量工况 | 仪表、测点、负载有无／电流、持续时间未提供；不自行标注为空载或带载 |
| 后续用途 | 作为已确认额定 3.7 V 的水枪／泡泡机效果支路供电候选；不能接 ESP32 的 3V3 或 GPIO |
| 验证边界 | 一次用户报告的电压读数；纹波、启动压降、连续／峰值电流、温升、限流／短路保护、掉电行为仍待测 |

用户已澄清实际接线为 5 V→P01 MOS→本降压板→3.7 V 水枪，MOS 位于降压之前，5 V 在其标称 5–36 V 范围内。此前假设 MOS 直接由 3.7 V 供电不适用于本轮。MOS 关断后降压板电容可能保留短时输出，GPIO 窗口不等于水枪实际动作时长，需观察启动及停止。下一步见 [MOS 台架测试](../../../docs/mos-bench.md)。
