miclle/cybertrack/hardware/components/ESP32-S3-N16R8/README.md

# ESP32-S3 N16R8 开发板资料

记录日期：2026-10-23。对应 [P07／H06](../../procurement.md) 的[天猫商品及 SKU 5996933277834](https://detail.tmall.com/item.htm?id=1004509737151&skuId=5996933277834)：N16R8、Type-C 接口、已焊排针，店铺为欣薇旗舰店。商品页标注 DevKitC-1；所附板级图纸标注 ESP32-S3-COREBOARD，不能直接当作乐鑫官方 DevKitC-1 的同版原理图。

本目录保存用户提供的原始资料，第三方标识与权利不变。供应商图纸回读与[到货板核对](physical-verification.md)分开记录：已收到正反面照片、用户实测 63.6 × 28.2 × 13.2 mm，且已完成两个 USB 口枚举、ROM 芯片及 Flash 识别，以及 CyberTrack 无负载启动、8 MB PSRAM 初始化和 6 MiB 六模式读写。板级版本与电气验收仍未确认；原始资料未改写。

## 来源与版本

| 资料 | 内容及本次读取范围 | 使用边界 |
|---|---|---|
| [独立原理图](ESP32-S3-SCH.pdf) | 1 页，图示标题 ESP32-S3-COREBOARD，Revision 为占位符 | 未明确实物修订版 |
| [包内 V1.4 原理图](ESP32-S3-SCH-V1.4.pdf) | 1 页，图示标题 ESP32-S3-COREBOARD V1.4；从用户提供的 `ESP32-S3开发板N16R8焊接.rar` 同名成员原样提取 | 与独立 PDF 字节不同；本次核对的电源、USB、J1/J2、按键、RGB 连接一致，不宣称全图逐元件等价 |
| [毫米图](ESP32-S3-Metric.pdf)／[英寸图](ESP32-S3-inch.pdf) | 各 1 页，板轮廓、排针及天线伸出尺寸；英寸图实际以 mil 标注 | 无整板高度、孔径、公差和安装孔尺寸；不按图片比例补数值 |
| [芯片规格书](ESP32-S3开发板.pdf) | 实际为《ESP32-S3 系列芯片技术规格书》v2.2，共 83 页；核对封面、§2.3.5 第 26 页、§3 第 32–34 页 | 文件名不是内容类型；不能替代板级图纸 |
| [模组型号对比](ESP32-S3-WROOM系列型号对比.png) | N16R8 的 Flash／PSRAM 容量、总线类型和模组尺寸 | 模组尺寸不是整块开发板尺寸 |
| [商品封面](封面图.jpg) | N16R8 焊针款、CH343、板宽与排针尺寸；注明天线版本可能按批次变化 | 照片不是到货实物，不能据此固定天线版本 |

毫米图、英寸图和模组对比图与上述 RAR 内同名成员的 SHA-256 一致。原始资料校验见 [readback.json](readback.json)。本地原压缩包、安装程序、通用固件和例程不进入项目交付：压缩包含下载日志与工具，例程含网络连接配置，未运行或烧录；仅原样提取本次需要的 V1.4 PDF。原包及例程保留在本地。

另核对乐鑫官方 [ESP32-S3-WROOM-1／1U 规格书 v1.8](https://www.espressif.com/sites/default/files/documentation/esp32-s3-wroom-1_wroom-1u_datasheet_en.pdf) 第 3 页型号表及第 12 页表 3-1 脚注 b：N16R8 为 16 MB Quad SPI Flash、8 MB Octal SPI PSRAM；GPIO35–37 被八线 PSRAM 占用。该官方资料用于模组限制，不证明实购物料版本。

## 原理图回读

以下是两份板级原理图的连接，不代表实物逐网匹配；到货板稳压器标记为 `1117 3.3V`，与图纸 U3 标注不同。方位参照尺寸图：元件面朝向观察者，天线在上、两个 USB 口在下。

| 电路 | 图纸连接 | 对后续适配的意义 |
|---|---|---|
| 主模组 U4 | ESP32-S3-WROOM-1；供电网 VDD33；EN 网 CHIP_PU | 实物罩体仅见 S3 N16R8；可见 PCB 天线和同轴座，实际射频通路及原厂模组身份未确认 |
| USB1，图示左口 | Type-C → CH343P（U2）→ U0TXD／U0RXD，即 GPIO43／44；带 TX/RX 指示灯 | USB 转串口下载／日志通路；外设不要与桥接芯片争用 UART0 |
| USB2，图示右口 | Type-C D− → GPIO19，D+ → GPIO20 | 原生 USB 通路，GPIO19／20 需预留；具体 USB 功能依固件和启动设置 |
| 自动下载 | CH343P 的 DTR／RTS 经 Q1/Q2（SS8050-G）连接 CHIP_PU／GPIO0 | 资料支持自动复位／下载电路，COM 枚举、ROM 自动连接及无负载固件烧录／复位已通过 |
| BOOT | 按下将 GPIO0 接地，C8 标注 104 | 与启动绑带共用，不能默认作为本地使能键 |
| RST | 按下将 CHIP_PU 接地；R8 为 10 kΩ 上拉，C7 为 1 µF，C9 标注 104 | 板上复位键；不等于独立切断执行器电源 |
| RGB | GPIO48 经名为 RGB 的 0 Ω 电阻接 U1 DI；U1 标注 XL-5050RGBC-WS2812B，5 V 供电 | GPIO48 为板载灯资源；不分配给执行器。例程目录名虽含 38，源码 LED_PIN 实为 48 |
| 5 V → 3.3 V | U3 标注 CJ6107A33GW，5V 网输入，VDD33 输出 | 供电通路已知；可用电流和散热能力不能由型号或原理图直接判定 |
| USB 供电隔离 | USB1 VBUS 经 D1 到 5V 网；USB2 VBUS 经 D2 到 5V 网 | 不据此批准双口并供或带载，仍需核对实物器件和装配 |
| 排针 5Vin | J1-21 经 D3 到 5V；IN-OUT 的 0 Ω 支路与 D3 并联 | 电阻装配会改变反灌路径；确认实物前不混接 USB 与外部电源 |
| GPIO3 选项 | 图中有 USB-OTG 0 Ω 接地支路、USB-JTAG 0 Ω 经 R11 10 kΩ 上拉支路 | 不能从图纸判定实际焊装选择；实物需核对，GPIO3 暂不分配 |

手动下载的资料级顺序为按住 BOOT、按下并释放 RST、再释放 BOOT；芯片规格书第 33 页要求下载启动时 GPIO0=0 且 GPIO46=0。这是资料说明，尚未对本板执行。图中没有批准任何 GPIO 直接驱动电机、水枪或泡泡机。

## 排针表（图纸连接，不是项目 GPIO 分配）

J1 为左排、J2 为右排，各 22 针；从天线侧向 USB 侧编号 1→22。数字是连接器针号，不是 GPIO 号。J1 的 RST 丝印对应 CHIP_PU／EN。背面视图须镜像，不可直接沿用左右。

| 针号 | J1 左排 | J2 右排 |
|---:|---|---|
| 1 | 3V3 | GND |
| 2 | 3V3 | U0TXD / GPIO43 |
| 3 | CHIP_PU / EN | U0RXD / GPIO44 |
| 4 | GPIO4 | GPIO1 |
| 5 | GPIO5 | GPIO2 |
| 6 | GPIO6 | GPIO42 |
| 7 | GPIO7 | GPIO41 |
| 8 | GPIO15 | GPIO40 |
| 9 | GPIO16 | GPIO39 |
| 10 | GPIO17 | GPIO38 |
| 11 | GPIO18 | GPIO37 |
| 12 | GPIO8 | GPIO36 |
| 13 | GPIO3 | GPIO35 |
| 14 | GPIO46 | GPIO0 |
| 15 | GPIO9 | GPIO45 |
| 16 | GPIO10 | GPIO48 |
| 17 | GPIO11 | GPIO47 |
| 18 | GPIO12 | GPIO21 |
| 19 | GPIO13 | GPIO20 |
| 20 | GPIO14 | GPIO19 |
| 21 | 5Vin | GND |
| 22 | GND | GND |

资源限制：

- **GPIO35、36、37：N16R8 八线 PSRAM 占用，不可作为外设 GPIO**；即使通用板图画到排针也不能使用。
- GPIO0、3、45、46：启动绑带，先保留；GPIO45 的电压选择还受 eFuse 影响，不能仅凭外部电平推断存储电压。不得为验证本资料改写 eFuse。
- 2026-10-24 用户授权无电机测试例外：GPIO0／板载 BOOT 在正常启动及 PSRAM 自检完成后临时作为低有效停止输入；不是本地使能键或最终停止电路，不按住 BOOT 上电／复位。
- GPIO19、20：原生 USB；GPIO43、44：CH343P 与 UART0；GPIO48：板载 RGB。
- GPIO39–42：默认 JTAG 功能资源，是否释放待调试方案确定。
- GPIO1、2、4–18、21、38、47：图纸中引出、且不在上述占用集合内的后续候选；仍须结合外围电平、复位状态、音频接口与实物版本分配，当前没有项目级 GPIO 表。

## 尺寸与安装基准

以下均为供应商图纸标称值。使用板自身坐标描述，不改变整机 X 向左、Y 向后、Z 向上的坐标约定；装入整机时另行定义转换。

| 项目 | 数值（mm） | 证据／解释 |
|---|---:|---|
| 底板长 × 宽 | 57.15 × 27.94 | 毫米图板轮廓；英寸图 2250 × 1100 mil |
| 含图示天线伸出的总长 | 63.39 | 毫米图自天线顶端到 USB 侧板边；英寸图 2495.63 mil 换算约 63.389 |
| 两排针中心距 | 25.40 | 毫米图；1000 mil |
| 单排首末针中心距 | 53.34 | 22 针的 21 个间隔；2100 mil |
| 排针节距 | 2.54（推导） | 53.34 ÷ 21，不是另行测量 |
| 端针中心至对应板端 | 各 1.91（图纸圆整） | 英寸图 75 mil = 1.905；57.15 − 53.34 = 3.81，解释两端圆整误差 |
| 针排中心至相邻长边 | 1.27（推导） | (27.94 − 25.40) ÷ 2，依尺寸图对称布局 |
| 图示天线纵向伸出底板 | 6.24（推导） | 63.39 − 57.15；不适用于未核对的另一种天线版本 |
| WROOM-1 模组外形 | 18.0 × 25.5 × 3.1 | 型号对比图；**不是整板厚度** |

尺寸图未给出独立螺钉安装孔、排针孔径、PCB 厚度、焊针后总高度、USB 插头和线缆空间、公差。不能把排针孔当作已确认的螺钉孔，也不能将 57.15 mm 当作含天线的总长。后续整板包络优先采用用户实测 **63.6 × 28.2 × 13.2 mm**（含天线总长 × 板宽 × 焊针后总高度）；图纸值保留作对照。安装、插头和射频净空另行验证。本次未修改整机 CAD 占位。

## 已补齐与仍待核对

已补齐：原理图两版本、44 针连接表、板载占用、USB／下载与供电通路、毫米与 mil 尺寸、存储规格和限制。结构化摘录见 [board-data.json](board-data.json)。

到货核对已补：正反面照片、S3 N16R8 丝印、用户实测三维外形、USB／COM 分别枚举，以及 ESP32-S3 rev v0.2、16 MB Flash、封装内 8 MB PSRAM 识别。COM 首次未枚举，翻转重插后成功，原因未定。

仍待：PCB 版本与器件差异、GPIO3／IN-OUT 焊装与通断、射频通路、安装方式、PSRAM 全容量／长时测试、Flash 全片测试、供电能力、专用停止／使能器件和音频器件。后续清单见 [Q06／F2b](../../../firmware/BOARD-INFO.md)。资料整理通过不代表 F2b 或实物验收完成。

2026-10-24 已完成[板载 BOOT 无负载停止验证](boot-stop-verification.md)：两次按下锁定、松开不恢复、人工 RST 后未使能。仅用于临时输入验证，未进行执行器关断或独立供能切断验收。
