miclle/cybertrack/hardware/components/track-mount/README.md

# track-mount 履带安装件

部件文件：[FCStd](TrackMount.FCStd)、[STEP](TrackMount.step)、[预览](preview.png)、[正视图](front.png)、[尺寸图](dimensions.jpg)、[尺寸记录](dimensions.json)、[本次回读](readback.json)。

本项目需要左右各一件。尺寸记录和模型几何用于布局，实物尺寸与安装配合仍待核对。

| 类别 | 参数 |
|---|---|
| 记录的测量值 | 总宽 65 mm、总高 38 mm、板厚 4.9 mm、安装柱宽／深各 8.8 mm、总高 11 mm（含板厚） |
| 记录的测量值 | 安装孔 Ø3.2 mm、中央孔 Ø19 mm、开口总高 24 mm、缺口宽 10 mm、上部圆形区域高度 28 mm |
| 推导值 | 柱居中假设下孔距 56.2 mm；柱高出板面 6.1 mm |
| 建模假设 | 28 mm 高度按完整外圆直径解释；缺口按上下对称圆弧建立；未测过渡圆角省略 |
| 未解决 | 缺口深度、缺口对称性、实际圆角、配合公差及承载 |

JSON 中记录尺寸协调依据，`measured` 与 `derived`、`modeling_assumptions` 分开存放。后续以真实安装基准重新核对孔距、孔径、缺口和联轴器间隙，随后更新验证记录。
