miclle/cybertrack/hardware/model/print-parts/PP07-slicing/README.md

# PP07 头壳切片检查

**当前打印入口：** [29 件 Lean 六盘项目](../../lean-print/README.md)。本页为优化过程记录；重复独立工程和原始 G-code 已清理，参数、对比结果和检查报告保留。

**历史头部交付：** [头部三件快速打印方案](head-set-speed/README.md)。头壳单盘约4小时9分，冠盖＋托盘共盘3MF（历史中间文件 `Head-Crown-Tray-PLA-Basic-FAST.3mf`，已清理）约3小时24分；共两盘约7小时33分、308.39 g。三件均已优化并完成切片／关键路径检查，冠盖四处螺丝座局部100%填充、4墙，托盘保留3墙。下面独立件7小时10分／50分记录为历史基线。

**新增更快候选：PLA Basic 宽线快速版 3MF（历史中间文件 `PP07-P2S-PLA-Basic-wide-fast.3mf`，已清理）**。按用户继续缩短时间的要求，采用 0.28 mm、两圈 0.60 mm 宽墙，预计 **4 小时 9 分／154.3 g**；模型几何保持，关键截面轨迹已抽查，实际强度与配合仍待首件确认。另保留三圈宽线方案（历史中间文件 `basic-028-3walls-wide.3mf`，已清理）（约 4 小时 45 分）及原三圈细线快速版（历史中间文件 `PP07-P2S-PLA-Basic-fast.3mf`，已清理）（约 5 小时 19 分）。完整参数对比与边界见[快速打印记录](speed-study/README.md)。以下是原 Generic PLA／0.20 mm 基线及独立件记录。

已切片 3MF（历史中间文件 `PP07-P2S-PLA-0.20.3mf`，已清理）包含头部下壳、前脸和固定装饰，冠盖与托盘另打。重新切片时须核对实际材料与热床类型。本轮只准备本地文件，没有发送或启动打印。

- P2S／0.4 mm 标准流量喷嘴，Generic PLA，纹理 PEI。
- 开口向上，179 × 122.5 × 55.1 mm；4圈墙、15%陀螺仪填充、0.20 mm层高、5 mm外侧brim、无筏层。
- 自动树状支撑；**关闭“仅在打印板生成”**，允许从模型表面生成支撑；顶部间隙0.20、XY间隙0.35 mm、2层顶部接触面。
- 预计约 **7小时16分、177.1 g**，含支撑等耗材，属于切片估算。
- 切片成功，无未支撑悬空警告；STL闭合、单连通且无非流形边。输入哈希与三种摆向比较见[报告](report.json)，原始切片结果见[result.json](result.json)。支撑实际清除、孔径、外观和层间强度仍需打印检查。
- 从头舱上开口及外侧清理支撑；避免以薄格栅、颊甲作撬点。接收柱导孔、柱顶及盖板承压面需清理干净。

先打 [Ø2.0／2.1／2.2导孔试拧件](../Head-ScrewFitCoupon.stl)，使用同材质和墙层参数，确认现有螺丝适配；当前大壳导孔为Ø2.1候选。完整结构与装拆条件见[头部打印说明](../../../../docs/head-shell-print.md)。

独立件采用相同材料与工艺参数切片：托盘 3MF（历史中间文件 `Tray.3mf`，已清理）底面朝下，约 50 分钟／26.4 g；试拧件 3MF（历史中间文件 `Coupon.3mf`，已清理）约 19 分钟／3.1 g。两者均无未支撑悬空警告，精确输入与结果见[independent-parts.json](independent-parts.json)。

配套冠盖 3MF（历史中间文件 `Crown.3mf`，已清理）保持装饰面朝上，内侧树状支撑，约 7 小时 10 分／131.7 g，无未支撑悬空警告。内部支撑从开放底面清理；尚未比较全部可能摆向。

CLI日志中的`Invalid T command (T65535)`来自本机附带P2S官方结束G-code模板中的AMS退料段；未改写该模板。它与悬空警告不同，不能把CLI成功视为实机执行验收。最终保留该诊断及原始日志。
