miclle/cybertrack/hardware/model/print-parts/PP04-slicing/README.md

# PP04 正式底盘打印文件

**当前打印入口：** [34 件六盘项目](../../print-ready/README.md)。本页为优化过程记录；重复独立工程和原始 G-code 已清理，参数、对比结果和检查报告保留。

## 历史比较：时间优化版

使用 PP04-P2S-PLA-FAST.3mf（历史中间文件 `PP04-P2S-PLA-FAST.3mf`，已清理）。对比 16 组切片参数后，选取无悬空警告且最快的候选；预计 **4 小时 49 分钟、161.07 g**，相对原版 5 小时 20 分钟／174.71 g，节省约 **31 分钟（9.7%）和 13.65 g（7.8%）**。原版参数和结果保留作对照。

- **保留**：完整网格与摆放、0.24 mm 层高、0.20 mm 首层、3 层墙、顶部 5 层、底部 4 层、10% 填充密度、支撑顶部接触面 2 层、支撑 Z／XY 间隙、机器与耗材配置，以及 Generic PLA 的 12 mm³/s 流量限制。
- **调整**：普通支撑改为 snug 贴合式，支撑本体间距从 2.5 增至 5 mm；内部稀疏与实心填充线宽改为 0.6 mm，稀疏填充改为立方体。外墙、内墙和顶面线宽保持。
- **检查**：11,898 个顶点与 23,900 个三角面逐项相同；网格无修复、无悬空警告，首层支撑／brim 在平台内。检查左右电机端面、履带安装柱和外侧检修盖安装柱，共 12 处关键截面的挤出路径；优化版采样材料覆盖率最低约 92.7%，原版最低约 88.4%。四处历史内侧柱位置在当前 CAD 中无材料，未将空区域计作通过。
- **边界**：截面路径检查证明采样位置有材料，不等于实际层间结合、承载、支撑拆除或装配验收。图示是从 G-code 提取的四个模型高度截面，不是全层连续性证明；独立高度的支撑层可能未出现在这些模型截面图中。

[参数对比与时间报告](speed-study/report.json) · [关键截面检查](speed-study/critical-path-check.json) · [几何与配置检查](speed-study/package-check.json) · [路径对比图](speed-study/toolpath-comparison.png)

下文为原版配置记录；打印优化版以本节及 FAST 项目内设置为准。

2026-10-26 从当前正式总装 `PrintLowerTub` 重新导出，尺寸 **174 × 196 × 66 mm**，一个连通实体。原生模型含两个封闭内腔，故网格有三个闭合边界分量；检查无非流形边，切片器未修复网格。导出没有修改 CAD。

打开 PP04-P2S-PLA-0.24.3mf（历史中间文件 `PP04-P2S-PLA-0.24.3mf`，已清理） 使用已保存的摆放、支撑和切片；[STL](../PP04-LowerTub.stl) 本身不包含打印设置。

- P2SC 沿用已确认的 Bambu Lab P2S、0.4 mm 标准流量喷嘴配置；Generic PLA，纹理 PEI 板。发送前匹配实际耗材和热床板。
- 保持整机轴向、最低面朝下，XY 居中，不缩放。
- 层高 0.24 mm，首层 0.20 mm，精确 Z 高度；3 层墙、10% 陀螺仪填充、顶部 5 层、底部 4 层。
- 普通自动支撑，允许从模型表面生成（不限热床），阈值 30°；顶部间隙 0.24 mm，XY 间隙 0.35 mm，顶部接触面 2 层；外侧 3 mm brim。
- 切片估算 **5 小时 20 分钟、174.71 g PLA**，275 层。未发送打印。

树状支撑仅热床、树状支撑不限热床和翻面方案分别有 6、2、10 处无法支撑警告；所选普通支撑方案无此警告。首层连同支撑与 brim 的 XY 范围为约 X36.91–219.09、Y25.44–230.56 mm，位于 256 mm 平台内。已核对切片结果、嵌入 G-code 一致性和网格修复统计；未完成 GUI 逐层工具路径复核，实际支撑拆除、刚度和打印配合仍待本次打印确认。

CLI 的 T65535 诊断来自沿用的 P2S 官方结束代码，与已打印 VF01 使用的配置一致；本次未修改机器起止代码。切片返回成功。详见 [报告](report.json)、[导出检查](export-check.json) 和 [切片结果](result.json)。

**此文件仅包含 PP04 底盘主体及湿舱隔板。底盖、顶盖和 L298N 支架是独立件，不包含在本盘中。** 最新 L298N 配套件见 [LC01–LC04 目录](../../l298n-compact/README.md)。
