miclle/cybertrack/hardware/model/print-parts/PP07-slicing/speed-study/README.md

# PP07 快速打印候选

**历史优化记录。** 当前打印使用 [29 件 Lean 六盘项目](../../../lean-print/README.md)的第 5 盘头壳。以下独立 3MF 已清理，保留参数和检查结果；需复现时从对应 Git 修订恢复，不作为现存直接打印文件。

2026-10-26。用户明确不追求精细外观，要求在结构完整前提下尽量缩短打印时间，并确认耗材为 PLA Basic。本轮按拓竹 PLA Basic、现有 P2S 0.4 mm 标准流量喷嘴准备；未假定已有 0.6 mm 喷嘴。

用户继续要求缩短时间后，新增宽线快速候选 3MF（历史中间文件 `PP07-P2S-PLA-Basic-wide-fast.3mf`，已清理）：预计 **4 小时 9 分、154.3 g**，相对原版缩短约 3 小时 7 分（42.8%）。采用 0.28 mm 层高，两圈 0.60 mm 宽墙（名义约 1.2 mm）、填充／内部实心／顶面线宽 0.60 mm、支撑线宽 0.50 mm。其余沿用下表快速版。宽线减少走线次数，也会使小细节更粗；不把名义墙厚当作与三圈细墙等强的证明。

若保留三圈墙，另有三圈宽线候选（历史中间文件 `basic-028-3walls-wide.3mf`，已清理），墙线宽 0.50 mm、名义约 1.5 mm，预计 **4 小时 45 分、166.2 g**。

原三圈细线快速版 3MF（历史中间文件 `PP07-P2S-PLA-Basic-fast.3mf`，已清理）的参数与结果仍保留：预计 **5 小时 19 分、158.3 g**。所有时间均为切片估算，未发送打印。

| 设置 | 快速版 |
|---|---|
| 材料 | 本机附带的 Bambu PLA Basic @BBL P2S 完整继承预设 |
| 标准喷嘴最大体积流量 | 21 mm³/s；原 Generic PLA 为 12 mm³/s |
| 层高／首层 | 0.28／0.20 mm |
| 墙层数 | 3 圈 |
| 顶／底层 | 各 3 层，名义 0.84 mm；首层仍为 0.20 mm |
| 填充 | 8% 立方体 |
| 支撑 | 自动树状、默认样式、支撑墙 1 圈；允许落在模型上 |
| 支撑接触间隙 | 顶部 0.20 mm、XY 0.35 mm，接触面 2 层 |
| 朝向及底边 | 开口朝上、5 mm 外侧 brim |

STL、连接筋、螺丝柱、孔位和装配尺寸均未改变；导出 3MF 的完整嵌入顶点／三角形序列与原验证项目逐项相同。切片成功，无未支撑悬空警告。粗层高会增加斜面台阶和孔边粗糙度，实际层间强度、导孔试拧和支撑清除尚未验证，不能把保留几何等同于实物强度保证。

| 对比 | 耗时 | 用料 |
|---|---:|---:|
| 原版：Generic PLA，0.20 mm，4 圈墙 | 7 小时 16 分 | 177.1 g |
| 仅改为 PLA Basic，保留原工艺 | 6 小时 32 分 | 179.9 g |
| 原快速版：PLA Basic，0.28 mm，3 圈细墙 | 5 小时 19 分 | 158.3 g |
| 同工艺减为 2 圈墙 | 4 小时 57 分 | 137.0 g |
| 3 圈 0.50 mm 宽墙，扩大填充及支撑线宽 | 4 小时 45 分 | 166.2 g |
| **2 圈 0.60 mm 宽墙，扩大填充及支撑线宽** | **4 小时 9 分** | **154.3 g** |

第一轮直接减为两圈细墙只省约 22 分钟，所以当时保留三圈墙。后续宽线方案获得更明显收益。另测普通支撑、苗条／混合树状支撑、更疏支撑及“仅关键区域”支撑，未获得更快结果。这里是已测试候选中的取舍，不声称穷举所有工艺。

宽线两圈方案无未支撑悬空警告，嵌入网格与原版完全一致。对输出 G-code 的八个螺丝柱和十二处连接中部截面另做抽查：八个柱的环形区域在近似挤出宽度栅格检查中覆盖完整，十二处连接均存在实体打印路径；下颌与颊甲仍包含稀疏内部，不能称为实心连接。检查不覆盖所有层、两条周圈接缝带的完整轨迹，也不是力学或实物验证，详见[抽查结果](basic-028-2walls-wide/path-check.json)。复现入口为 `scripts/check_head_print_paths.py`。

## 再次提速比较：维持 4 小时 9 分方案

用户再次要求提速后，新增 4 组比较，均不改 STL、名义墙数／线宽及顶底层厚度：

| 新尝试 | 切片时间 | 用料 | 取舍 |
|---|---:|---:|---|
| 树状支撑线宽增加到 0.60 mm | 4 小时 8 分 48 秒 | 157.4 g | 仅省约 35 秒，用料增加 |
| 同时改 8% 直线填充 | 4 小时 8 分 42 秒 | 157.4 g | 仅省约 42 秒，用料增加 |
| 0.60 mm 普通支撑 | 4 小时 59 分 45 秒 | 194.8 g | 更慢且更重 |
| Arachne 可变线宽墙 | 3 小时 57 分 19 秒 | 149.0 g | 连接截面材料覆盖减少，不作为默认方案 |

Arachne 仍无悬空警告，八个螺丝柱抽查截面保持覆盖；但下颌一处抽查截面的近似材料覆盖从 51.7% 降到 48.5%，前脸两处从约 99.8% 降到 67.6%／75.6%。未通过本轮既定的单截面覆盖大于 50% 筛查条件。该阈值只是保守筛查，不是经过标定的强度合格线；这些结果也不表示零件必然断裂。考虑用户优先要求结构完整，本轮不为约 12 分钟收益将 Arachne 设为默认，仍使用上方 4 小时 9 分版。失败筛查原样保存在[路径抽查报告](basic-028-wide-arachne/path-check.json)。

完整 19 组实测参数、输入哈希、时间和警告见[报告](report.json)，各子目录保留输入／已切片 3MF、原始结果及日志。复现入口为 `scripts/compare_head_print_speed.py`；可传入报告中的候选名称，仅重跑指定项。PLA Basic 继承参数保存在相应子目录的 `resolved-filament.json`。

本次仅优化头壳。后续其他零件也优先采用粗层高，但墙数、支撑和摆向应按各件承力及装配面单独确定。
