miclle/cybertrack/hardware/BOM.md

# 硬件清单

2026-10-27：泡泡液瓶组撤销，H23 当前仅保留清水瓶及其固定件；点火筒内径35／外径40 mm，原8片侧软衬撤销、2片底垫保留。模块数量与规划包络未改；见[背包修订](../docs/backpack-35mm.md)。

2026-10-27 独立车库已按用户要求改为[11 件全打印制作候选](model/container-garage/printed/README.md)：角舱 4、顶盖 4、门片 2、旋转门闩 1，10 盘预计约 1.733 kg PLA。五金候选为 M3×12 沉头 4、M3×12 圆柱头 4、M3×8 2、M3×40 半牙轴 2、M3×16 门闩轴 1；普通螺母 10、防松螺母 3、平垫 6，另需适配耗材的胶。门根／前缘厚 8／2 mm、铰链孔 Ø3.4。替代前轮板材、Ø2.8 销轴和两只顶搭扣方向，不改机器人本体 BOM。具体螺钉头型、半牙长度、打印公差、胶强度和带载试验未验收，不作为已适配的采购清单。

核对日期：2026-10-27。当前为样机联调与整机验证阶段，已有打印、基础装配、地面运行和泡泡展示，见[制作过程与样机影像](../artifact/README.md)。当前控制器是现有 `bread-compact-wifi` 面包板，最新有记录的固件部署为 `2.0.3-ct21`；P07 独立台架板的核对记录不等于面包板的订单或实物版本证明。需求数量、实物观察、采购数量与验收状态分开记录。

当前安装基线（2026-10-26 变更）：两块 P12 降压模块仍在整机内，但已由用户集成到水枪／泡泡枪体；底盘取消其安装位及两条板边垫。取消 5 个打印压框、10 颗压框螺钉及 10 个短嵌件候选；三块 MOS 采用用户选择的热熔胶固定，保留 MOS 板边支承垫及承板／托架的 6 处吊装紧固接口。MT3608 电机升压模块和 L298N 固定结构继续保留。当前打印包为 29 件（不等于逐件实物验收数量），见[精简清单](model/lean-print/README.md)。历史紧固件合计不作为现行采购数量。

状态：需求／资料清单，**不是可直接下单的定版 BOM**。数量为本项目需求，不代表库存数量。金额和功耗待实际型号确认；已知质量参数见表内记录，其余待补。

用户提供的商品名称、链接及采购状态统一记录在[硬件采购清单](procurement.md)。商品已列入采购资料不等于已下单或适配通过。2026-10-23 的[网页核对记录](procurement-web-review.md)补充十项页面资料；下列网页参数均为商家标称。

| ID | 部件 | 数量 | 已知条件 | 待补齐／状态 |
|---|---|---:|---|---|
| H01 | 左右履带组件 | 2 组（左右各一组） | P08 有商品链接；样机已有履带装配与地面运行影像 | 订单规格及数量、单侧／成套售卖、套装内容、尺寸与接口对应关系仍待核；张力、磨损、材料及耐久未验收 |
| H02 | 37R-520 编码器减速电机 | 2 | 2026-10-24 用户确认到货，订单数量待核；已有双电机台架及 ct21 四方向反馈，资料对应 12 V、100 rpm、60∶1 | 实物标签、尾部尺寸、插头针序、实测电流 |
| H03 | [何健弓 L298N 电机驱动板模块](components/L298N/README.md) | 1 | 2026-10-25 用户指定替换 DF-MD V1.3；P13 对应京东 10231029535273，选项为 L298N；用户提供长 46.2 × 宽 43.5 × 高 27.5 mm；0.34 裸包络及旧托框保留历史；当前 0.57 采用 28.5 mm 插线包络和底盖承载支架，见 H22；正反面原图已保存 | 已有供电／静态关闭、单路正反转、8 组双路空载组合、BOOT 提前停止与双路 60%／10 秒正常启停反馈；以上为历史台架，后续 ct21 四方向已获用户确认；订单数量、尺寸包含范围／孔位、额定条件、电流、定量温升及完整带载能力待核实 |
| H04 | track-mount | 2 | 参考记录 65 × 38 × 11 mm | 缺口深度／对称性和实物试配 |
| H05 | 六角联轴器 | 2 | 图片内孔 Ø6 mm | 六角对边、插入深度、紧定螺钉与防脱 |
| H06 | ESP32-S3 N16R8 主控板 | 当前面包板 1；独立台架板另列历史 | 当前沿用现有面包板，不新增一套板卡；以下为 P07 独立台架证据：已到货；用户实测含天线 63.6 × 28.2 × 13.2 mm（焊针后）；[实物核对](components/ESP32-S3-N16R8/physical-verification.md)已记录双 USB 枚举、ESP32-S3 rev v0.2、16 MB Flash 与封装内 8 MB PSRAM 识别 | 0.11 小托架属历史，当前为面包板浅托盘；PCB 层高、母座、端口和射频范围待实测／试装；PCB 版本、器件／焊装差异与射频通路仍待核对；独立板 PSRAM 初始化与 6 MiB 读写通过；当前面包板的同源供电和独立执行器切断未验收；GPIO35–37 保留给八线 PSRAM |
| H07 | 麦克风及输入电路 | 1 套 | 沿用现有面包板麦克风，已有音频联调记录，不重复采购 | 型号、供电与辅助脚、安装声孔及完整语音回归待核 |
| H08 | 功放／扬声器 | 1 套 | 沿用现有面包板功放／扬声器，已有播放观察；扬声器尺寸长 69.5 × 宽 31.5 × 高 16.5 mm（用户于 2026-10-24 提供） | CAD 扬声器包络已更新，头舱静态无重叠；功率、阻抗、接口、供电、功放尺寸、扬声器安装孔位与接线空间待补；完整实物适配未验 |
| H09 | 一体高压脉冲连发水枪 | 1 套 | 工作电压 3.7 V（用户于 2026-10-24 确认）；P09 选中可自吸水全自动脉冲款；整枪标称 392 × 62 × 155 mm、约 350 mL；[拆出发射枪实测](components/pulse-water-gun/README.md)长 138.5 × 最粗处宽 33.2 × 厚 24.6 mm，带管宽 38.5 mm | 前端较细，分段轮廓／喷嘴／接头／孔位待测；允许电压范围／电流、扳机依赖、储水与液路、安装及连续工作限制待核；历史 0.18 将枪口上仰5°候选，旋转后前移10／下移4 mm，并同步托架及线管预留；0.25 采用胶粘配左右挡板、外侧双托管槽及一体尾线导向，0.28水管由液舱顶部插入，经侧面接双托槽，喷水管外径实测5 mm；自吸能力由用户确认；后续安装姿态为15°，已有喷水台架记录；完整倾斜工况及滴液倒流未验；接触面、预紧保持力、线管真实尺寸与实物适配待验 |
| H10 | 电动泡泡机 | 1 套 | 可自吸（用户于2026-10-24确认），0.28吸管从液舱顶部插入；工作电压 3.7 V（用户于 2026-10-24 确认）；P10 选中旋转太空泡泡机充电款；整件标称 90 × 90 × 235 mm、USB 充电；[主体尺寸与 4 张照片](components/bubble-gun/README.md)：枪口最外端 Ø31.5 mm、历史总高 35.8 mm、总长 67 mm（用户于 2026-10-24 提供）；2026-10-26确认尾壳高35.9 mm（不含底部薄片6.8），当前承托至尾顶42.7 mm为推导，薄片和15°安装姿态保持 | 历史 0.15 改为正面看左侧前置泡泡枪，保留水枪所在一侧；0.18 改为整体前圆环＋后25长／6宽、前10宽阶梯槽，当时两枪上仰5°候选，后续改15°；泡泡枪用胶辅助固定，已有样机出泡影像；薄片高6.8不额外下凸，枪口底离平面4.7与原总高推导存在0.4差异，宽35.8与固定面仍为假设；主体最大宽度、端点／凸起范围、安装及管线空间待测；允许电压范围、内部模块电流、液箱、前向出风、排液及连续工作限制；USB 充电不等于电机额定 5 V |
| H11 | 前方双火花效果模块（本体在背包两侧） | 2 | 早期用户给定输入 3–6 V，后续指定两模块共用一块 MOS、5 V 输入、单次 ≤5 s；商品称“1000KV”；采购记录 P05；2026-10-24 用户更新尺寸为 Ø25.5 × 70 mm 预装，未补充测量依据；历史 0.10 顶部效果护框与标识仅为造型占位；2026-10-25效果需求改为底盘前方左右各两根线、共四根，本体仍在背包两侧；0.45 CAD加入4根封闭端外观线及4个护套占位；0.48用户给定单线外径1.5 mm，CAD改为前舱入壳并新增共用P01 MOS安装位；实际线材型号、端部及固定件规格未定，不据此新增采购项 | 选项“1000KV”与参数表“400KV”及尺寸单位冲突；GPIO21 低压固件已部署；真实输出、安全／EMC 未核实，A1 保持 JP2 断开、U10／J9 不安装（DNP），不进入高压通电验收 |
| H12 | [辰克5 V可充电锂电池组](components/ck-5v-battery/README.md) | 1 | 用户指定替代原充电宝；CK18650-1234S-NP，用户尺寸116×70.5×19.5 mm；铭牌5 V、额定12400 mAh（5 V）、典型62.16 Wh；0.48低位平放候选 | 持续／峰值输出电流及时间、重量、接头用途／极性／尺寸、软线和保护行为待核；旧P11功率与质量不沿用，供电未验收 |
| H13 | DC-DC 升压模块 MT3608 | 1 | P06 页面选中无 USB MT3608 2A／1 只；标称输入 2–24 V、输出 5–28 V，目标母线 12 V，已有调压及电机历史台架记录 | 用户实测 37 × 18 × 6 mm，见[独立包络](components/MT3608/README.md)；安装接触面／接头待核；“2A”条件、12 V 连续／峰值能力、效率、散热及保护待核实 |
| H14 | 效果支路降压／开关及未分配继电器 | P01 需求 3；P12 需求 2；P02 未定 | P01 双 MOS 成品板，实物 JZ-MOS [端子已核对](components/jz-mos/README.md)，标称 5–36 V、3.3–20 V 触发；P02 选中 1 路 5 V 红板；P12 降压板用户报告 5 V 输入／3.7 V 输出，见[记录](components/dc-dc-buck/README.md) | P01 已分配水枪／泡泡／两只点火共用各一路；P12 两块已由用户集成至各自枪体；P02 仍未分配负载。订单数量、具体芯片／实物版本、逻辑阈值、默认状态、散热与保护待核；P12 连续／启动供电能力与保护待验，水枪台架为 5 V→P01→P12→3.7 V 水枪，单次 5 秒喷水及自动停止已获用户确认；降压瞬态、带载参数与重复性待验 |
| H15 | 物理停止、总开关及保护 | 1 套 | 用户指定[拨动开关](components/power-switch/README.md)：总宽19.5、耳下宽10.6、厚5.8、含脚高8.3、孔距14.8／孔径2.6、拨柄2.9方形／行程6／突出4 mm；0.53折面顶盖中央外装，候选Ø2×6塑料用自攻螺丝2颗，无螺母 | A1 将 SW1 定为低电流请求触点候选；SW2 已确认只切执行器、主控继续运行，器件另选；挂耳厚度及紧固件为候选；焊后尺寸、直流额定能力、触点关系、实际手感与供能切断待核；不视为电气选型通过 |
| H15a | 外接 BOOT 按钮及信号线 | 按钮1、配套螺母1、两根绝缘线及固定件 | 常开自复位无灯干接点；[0.54右肩一体安装座候选](../docs/boot-button.md)，Ø7.3孔与Ø7杆体等均为未选型预算；连接GPIO0／GND，复用当前固件 | 按钮型号、低电流触点、尺寸／螺纹／行程、线径／接头／余量与实物适配待核；软件停止不替代独立断电 |
| H16 | 接头、线束、紧固件、防松与密封件 | 待按现行装配逐项核对 | 历史 0.43 合计为 M2.5 级32、M3级20、M2级12处，已不适用；当前已取消5个效果压框及10套螺钉／嵌件、旧外半夹环8套紧固件、冠盖／托盘8个嵌件及上下独立线束护口。头部8颗用用户现有 Ø2.5 螺丝；L298N 改用 H22 清单，见[装配说明](../docs/assembly.md) | 不按历史合计叠加下单；保留电源内托架4片 Ø7/Ø2.8×0.5 候选垫圈、液路护口、拉带与补液垫需求。线径、针序、材料、头型、长度、螺纹、密封及保持力待核；现有螺丝不等于已确认 M2.5 机牙 |
| H17 | 设备底座、头舱、固定颈架、前脸与后背舱 | 1 套 | 已有样机打印与基础装配；当前制造分组见29件 Lean 清单。历史 0.32下底盘前后132等宽，上缘收腰；一体电机固定面／侧壁／顶梁，取消前干舱隔板与电源上内隔板，保留后湿舱隔板、一体底盖和独立电源内托架；上部造型和电源包络保留，未定版 | 打印公差、承载、紧固保持、真实线束维护与液体隔离未验收；不按源特征重复打印或采购 |
| H18 | MG90S 舵机 | 待定 | P03 页面选中 MG90S 14 g 金属齿轮／180 度；同页其他舵机参数不混用 | 用途、安装位置、数量、供电、堵转电流及接口尺寸 |
| H19 | 超声波测距模块 | 待定 | P04 选中 HC-SR04 单芯片 3–5.5 V；通用图标称 2–400 cm、45 × 20 × 15 mm；用户于 2026-10-24 提供[双圆柱尺寸](components/ultrasonic/README.md)：Ø16、总宽 42、离面板高 10.3 mm；按外沿总宽推导中心距 26 mm | 面板基准、PCB／背部／接头包络及孔位待补；0.26 CAD 已更新双圆柱及前脸候选，面板基准暂按前脸外表面；详情 3.3–5 V／5 V 与选项冲突；本阶段用途为网页／语音前向测距；按用户指定 3.3 V、IO1/TRIG、IO2/ECHO 实现 ct28，已部署并取得有效回波；实物版本、数量和 ECHO 电平待核实，见[接入说明](../docs/ultrasonic-ranging.md) |
| H20 | 主控排母与检修 USB-C 线 | 排母 2 条 × 22 位；线缆按检修需要确定 | 供应商图纸针距 2.54 mm、两排中心距 25.4 mm；用户确认直头 USB-C；CAD 为连续槽和 18 × 10 × 8 mm 插头候选包络 | 排母型号／高度／尾针与托架固定、插头和线尾实测待补；非下单规格；不默认双 USB 同时供电 |
| H21 | 水枪胶粘底托、侧挡板与托管座 | 底托 1；M3 级基座螺钉／嵌件各 2；双面软胶暂按 2 片；扎带及可分离插头待选 | 用户选择底部双面软胶；底托、侧挡板与托管结构现已并为 PP01，不逐件重复采购／打印。历史 0.25 底板38.4×74×3、侧挡板净宽34.4，前后双Ø5.6托管槽、中心距52；尾线导向鞍／扎带槽与底托一体；喷水管实测Ø5，胶厚暂按1 mm，详见[固定与托管](../docs/mechanical.md#025-双托管槽与一体尾线导向鞍) | 胶材、实际厚度、表面适配、耐水、温度、保持力、脱胶和基座紧固规格待核实；不是加工或下单规格 |
| H22 | L298N 底盖承载托架与上压框 | 托架／上压框各1；M2.5×8 螺钉及螺母各2；M2×4 螺钉及 M2 薄螺母各2；绝缘垫按接触位置核对 | 当前 [0.57 紧凑支架](model/l298n-compact/README.md)替代顶盖吊架；薄螺母对边4／厚1.2 mm为 DIN 439 设计包络。旧0.34的2套锁紧件／嵌件、4套侧压件／螺母及10片垫为历史，不叠加采购 | 实际件尺寸、PCB 接触、夹紧力、螺纹、防松、耐温、公差与带线检修待验；规格为设计候选，不是订单或适配通过记录 |
| H23 | 成品储液瓶与背包固定件 | 当前清水瓶1只；底托1、可释放绑带1；M3级候选螺钉／嵌件各2；底垫1、侧环垫2 | P14 [京东100222905645](https://item.jd.com/100222905645.html)；[商品原图](components/bottle-150ml/README.md)标称下直径48.8、含盖高114、瓶口内径30±0.2、贴标高82.4 mm、总重量18±1.5 g；0.36按Ø48.8×114完整圆柱假设，护舱高90、顶部包络外露30；历史样机双瓶影像不代表当前清单；2026-10-27泡泡液瓶组从CAD与打印导出移除，新泡泡液供液方案未指定；订单与精确实物规格未核 | 整瓶／瓶盖最大外径、瓶口螺纹、肩部、实物尺寸、瓶材、垫材及压缩、绑带长度／张紧与保持力、紧固规格、接管与通气密封待核实；不是下单或加工放行 |

**历史供电分配（2026-10-25，旧 A110M）：** 原共用方案中面包板主控从充电宝 5 V 输出经两根电源线接 `5Vin/GND`，与 H13 升压模块输入并联，方案见[电源接口](../docs/power-and-interfaces.md#面包板与电机共用充电宝2026-10-25)。H16 需包含适配电流的分线连接件及两路独立正负供电线，型号、线径、长度、数量与固定待定；H15 的独立执行器断电需求保留。主控采用板载稳压，不使用 P12 的 3.7 V 效果输出供电。USB 线保留检修用途，不因日常改用引脚供电取消。新接线尚未实测，不新增采购完成或电气通过状态。

当前继续核对现有件、订单与实物版本，并完成样机分项验证。辰克电池供电能力、MT3608 工况、MOS 适配、保护及开关额定、舵机用途、测距模块实物电平、线束和紧固规格仍待确认；水枪／泡泡／共用点火三路 MOS 用途已定，不再列为未分配。A1 的主控／执行器供电分支与 SW2 功能见[电源接口](../docs/power-and-interfaces.md)。

CAD 的部件占位与本表采购规格分开管理，见[整机模型](model/README.md)。电源外形已采用用户实测尺寸，朝向与装配仍为候选；独立主控板外包络采用用户实测；当前面包板100 × 85 mm为用户输入，36 mm总高仍为规划；液瓶按用户指定含盖外形建立完整包络，瓶口细节、剩余电子区及主控内部层高／连接器仍是设计假设；装饰件、安装耳和示意孔径也不构成采购批准。

## 2026-10-25 控制连接补充

**历史变更记录。** 本节数量、位置和“本轮”按当时修订解释；后续替换见文首及现行物料行，未验证项继续保留。

H03／P13 L298N 与现有水枪改为由同一面包板控制，物料数量不变；新增六根控制连接及逻辑共地的需求，线材、端接和固定规格待实物确认。当时 GPIO8–13 为候选，后续 ct6 已迁线并完成基本台架，当前 ct21 沿用；GPIO18 水枪保留；跳帽与电源边界见[集成接线](../docs/breadboard-integration.md)。不把六根控制线误算为功率线，也不合并电机 12 V 与水枪 3.7 V 支路。

## 2026-10-25 ct7 并发动作变更

**历史变更记录。** 本节数量、位置和“本轮”按当时修订解释；后续替换见文首及现行物料行，未验证项继续保留。

ct7 同时动作不增加器件、不改变供电电压和引脚；现有充电宝、升压、降压、MOS、接头和导线的同时负载能力仍须实测。见[并发动作说明](../docs/concurrent-actions.md)。

### 0.37 头舱加高的结构影响

**历史变更记录。** 本节数量、位置和“本轮”按当时修订解释；后续替换见文首及现行物料行，未验证项继续保留。

头舱整体上移25 mm；颈架侧板、外加强板、斜撑／套筒、承托鞍座和沉座须使用0.37几何。中央电源线束上端路由延长25 mm，实物线长及余量仍需量装；主控、双枪、双瓶数量和候选紧固点数量保持。颈架强度、支撑接触、材料与满／空瓶稳定性须实测，不据此下单或放行制造。

### 0.38 双枪上仰的结构影响

**历史变更记录。** 本节数量、位置和“本轮”按当时修订解释；后续替换见文首及现行物料行，未验证项继续保留。

器件数量及枪体／胶粘固定方式保持，肩梁承托面和孔轴按10°安装姿态更新；管路及尾线重新核对实际长度、弯曲和防拉脱。不得用旧5°姿态的整机固定件直接代替当前候选，独立部件外形资料不变。实际射程、允许工作倾角及胶粘保持尚待验证。

## 0.39 双枪上仰的结构影响

**历史变更记录。** 本节数量、位置和“本轮”按当时修订解释；后续替换见文首及现行物料行，未验证项继续保留。

器件和候选紧固件数量保持；肩梁承托面、孔轴采用15°几何，水枪基准较0.38上移3 mm，泡泡管路下绕2 mm。原独立部件资产不变，真实软管长度、胶粘保持及倾斜带液运行待试配。

## 2026-10-25 ct8 局域网控制

**历史变更记录。** 本节数量、位置和“本轮”按当时修订解释；后续替换见文首及现行物料行，未验证项继续保留。

网页服务复用现有 ESP32-S3 N16R8、Wi-Fi 和 OLED，不增加控制板或其他采购件，GPIO 与功率支路不变。页面不依赖外部服务器；软件和板上验收边界见[局域网控制](../docs/lan-control.md)。

## 2026-10-25 ct9 按住行走

**历史变更记录。** 本节数量、位置和“本轮”按当时修订解释；后续替换见文首及现行物料行，未验证项继续保留。

ct9 长按行走不增加采购件或改变 GPIO／功率支路；持续负载时间不再受网页三秒按钮限制，原驱动与电源的长时间电流／温升验收仍待完成。详见[局域网控制](../docs/lan-control.md)。

## 0.40 面包板整组与托盘

**历史变更记录。** 本节数量、位置和“本轮”按当时修订解释；后续替换见文首及现行物料行，未验证项继续保留。

H06主控、H07音频相关元件与H08扬声器沿用现有面包板接线；面包板100×85为用户提供平面尺寸，总高36为规划包络，不是实测整组。新增一件浅托盘及四颗M2.5级候选螺钉／四嵌件，替换原托板四固定点，并取消旧主控小托架及压架六紧固件；不重复采购一套板卡／扬声器。托盘材料、螺钉长度、嵌件及底座防脱件未定。H11保留采购资料，本轮模型不布置电弧模块，也未迁至底盘。详见[浅托盘](../docs/breadboard-tray.md)。

## 0.41 超声波候选占位

**历史变更记录。** 本节数量、位置和“本轮”按当时修订解释；后续替换见文首及现行物料行，未验证项继续保留。

H19仍沿用现有模块资料，不另购重复模块。PCB 45×20×1.6、背面深4、向上接头12×6×8和Ø4线束仅为空间预算，不能作为已定采购规格；针座方向、线端和模块固定件待实测。浅托盘增加前缘49×2让位，四颗螺钉及嵌件数量不变。见[共存与拆装](../docs/ultrasonic-head.md)。

## A02 底盘效果模块空间规划

**历史变更记录。** 本节数量、位置和“本轮”按当时修订解释；后续替换见文首及现行物料行，未验证项继续保留。

用户要求水枪、泡泡枪的MOS和降压板都放底盘。本候选按两块P01类MOS＋两块P12降压板分配空间；两套数量为布局假设，不代表已购置或电气选型完成。降压板用户新尺寸为20×11×5 mm，MOS通用平面33×17、总高暂按12 mm；端子和线束另待核实。H11两只Ø25.5×70裸本体占位转为底盘候选，未增加高压引线或驱动。见[独立A02记录](../docs/effects-mount.md#方案沿革与清理)。

A03更新：用户否定A02外观，H11裸本体候选改在背包左右外侧；两套效果板仍在底盘，数量与尺寸依据不变。改为74×33×2 mm薄承板候选，原A02前盖及抬高舱体不再作为推荐结构；真实夹持件、板卡固定及线束物料待定。见[A03记录](../docs/effects-mount.md#方案沿革与清理)。

## 0.42 夹持与薄承板固定

**历史变更记录。** 本节数量、位置和“本轮”按当时修订解释；后续替换见文首及现行物料行，未验证项继续保留。

正式模型增加4件可拆外半夹环（上侧2件带顶限位）、8片0.5 mm软衬候选、2片1 mm底垫，以及1件四耳薄承板；内半夹环、连接肋和底托并入背包护壳，4根承板支柱并入顶盖。新增12颗M2.5级候选螺钉与12个配套嵌件，其中夹环8套、承板4套；真实标准件型号、螺纹、长度、材料和安装工艺未定。结构紧固点总数由44变为56，不含成品履带内部参考件。MOS／降压板自身固定件和真实线束未列为已定物料。见[结构与拆装](../docs/effects-mount.md)。

## 0.43 效果板固定补充（候选）

**历史变更记录。** 本节数量、位置和“本轮”按当时修订解释；后续替换见文首及现行物料行，未验证项继续保留。

新增4个开窗防脱压框、每板两条0.5 mm边垫（共8条）、8颗M2级螺钉及8个短嵌件。底座凹座、侧限位和压框柱与承板一体；承板四点仍为4颗M2.5级螺钉及4嵌件，调整孔位并增加沉台。整机候选结构紧固点合计64处：M2.5级32、M3级20、M2级12。连接器、线材、材料及实际标准件未选定；空间包络不计为已采购件。见[说明](../docs/effects-mount.md)。

## 0.48 电源替换与点火开关安装

**历史变更记录。** 本节数量、位置和“本轮”按当时修订解释；后续替换见文首及现行物料行，未验证项继续保留。

H12更新为辰克电池包，旧P11保留采购历史。H14新增一块与水枪／泡泡机同款P01，供两只点火模块共用；模型合计三块MOS、原两块降压板数量不变，购置数量仍待核。第三板仅增加独立可拆托架、两条支承垫、压框、两颗M2级压框螺钉及两颗M2.5级吊装螺钉／对应嵌件候选；不下达采购或通电放行。完整机械范围见[0.48](../docs/ignition-routing.md)。

## ct13 控制用途确认

**历史功能变更，低压控制已部署。** 当前采购与实物验收状态见 H14，不将部署等同于点火硬件验收。

用户确认沿用三块 P01 分别控制水枪、泡泡、两只点火线圈；点火两只共用一块、用户指定 5 V 直接供电。泡泡仍按 3.7 V、独立降压规划，模型原两块 P12 数量不变。GPIO17／21 已随 ct13 部署并由 ct21 沿用；泡泡已有运行影像，购置数量和完整负载适配仍未确认，点火高压验收未完成；两线圈总电流、启动瞬态和 MOS 保护能力待核，见[效果控制](../docs/effects-control.md)。

0.49：H17左右镂空底座侧框后端各延长30 mm，数量仍为两件、厚度仍为1.5 mm；不新增器件或紧固件。后伸薄壁强度、材料与制造公差待验。

## 0.50 一体点火模块收纳

**历史变更记录。** 本节数量、位置和“本轮”按当时修订解释；后续替换见文首及现行物料行，未验证项继续保留。

H17双瓶背包合入两侧有底桶座、完整环带和连接耳，不新增独立打印件；顶部倒L压件随旧外半环撤销。相对0.49减少4件外半环、8颗M2.5级夹环螺钉及8个嵌件，8片侧软衬和2片底垫保留；上方历史夹具数量不再代表当前BOM。模块、电源与MOS数量不变，固定力、材料和制造待验，见[结构说明](../docs/effects-mount.md)。

## 0.51 合并打印候选

**历史变更记录。** 本节数量、位置和“本轮”按当时修订解释；后续替换见文首及现行物料行，未验证项继续保留。

本轮制造分件为PP01水枪底托、PP02泡泡底座、PP03背包外壳及桶座、PP04底盘及湿舱隔板、PP05冠盖、PP06固定颈架，各1件。覆盖58个CAD设计特征，不是全机完整打印清单，也不表示取消52个既定实物零件；采购设备、软垫、绑带和现有紧固件数量保持。见[分件清单](../docs/print-consolidation.md)与[打印文件](model/print-parts/README.md)。

## 2026-10-26 原理图 A1 设计增补

保留现有 ESP32-S3 开发板和外置功率模块。以下是[模块级原理图](schematic/README.md)的设计项，不是已采购或制造定版 BOM；证据和待测项见[参数清单](schematic/parameter-confirmation.md)。

| 图纸位号 | 数量／设计规格 | 状态与关联 |
|---|---|---|
| R1–R6 | 6；10 kΩ、±1%、额定功率至少 0.1 W；封装目标 0603 | L298N 六路输入下拉已定设计值；具体料号／封装未冻结，整板偏置与默认关闭待 E05 |
| R7–R9 | 3；阻值待定 | 三路 JZ-MOS 输入参数待 E03，不套用 L298N 定值 |
| SW2 | 1 套独立执行器断电器件；型号／直流额定待定 | H15 功能分拆：用户确认只切执行器，主控保持运行；与 SW1 总开关请求、SW3 BOOT 分开 |
| F1–F7、U2／U3、JP1／JP2及线束 | 按原理图位号保留；保险、保护／主电源电路、连接器待选 | E01–E04 输入预算和额定依据未齐；JP2 默认断开，点火支路不装配通电 |

## 0.55：15芯穿线空间更新

**局部修订记录，当前仍沿用的设计范围见文首及对应物料行。** 设计规格不等于已购数量或实物验收。

线束按原13根加BOOT双线共15根；上下护口已按2026-10-26用户后续要求取消；颈部限位桥1件保留，净径10 mm。PP06固定颈架和头壳/托盘/顶盖局部几何同步；线材、连接器与固定方式未定，不新增已采购项。见[通道说明](../docs/cable-passage.md)。

## 0.58 头壳打印与现有紧固件

**局部修订记录，当前仍沿用的设计范围见文首及对应物料行。** 设计规格不等于已购数量或实物验收。

新增PP07整体头壳1件（归并34个原特征并加14处连接，不重复采购／打印原装饰件）。H16头部冠盖4颗＋面包板托盘4颗明确使用用户现有螺丝：外径Ø2.5、含帽总长8.6、帽径Ø3.9、帽厚1 mm、帽底近乎平；帽下7.6 mm为推导。撤销对应8个旧候选嵌件，其他紧固点保持；上文全机M2.5级数量为历史候选，不能将这8颗登记为已确认M2.5机牙。Ø2.1自攻导孔、有效牙长与保持力仍待试拧，见[试件与配套冠盖](../docs/head-shell-print.md)。

## 0.57 L298N 支架紧固候选

**局部修订记录，当前仍沿用的设计范围见文首及对应物料行。** 设计规格不等于已购数量或实物验收。

H03 仍为一块 L298N。新增/替换支架配件候选：M2.5×8 螺钉 2、配套 M2.5 螺母 2、M2×4 螺钉 2、DIN 439 M2 薄螺母（对边 4／厚 1.2 mm）2，以及绝缘接触垫；替代原支架四点侧压件与两处吊柱嵌件，不作为叠加数量采购。实际件尺寸和适配待试装，详见[支架清单与来源](model/l298n-compact/README.md)。

**历史打印补齐（2026-10-26，已由29件 Lean替代）：** 五个装配件与九个外观特征合并后为第6盘12件，当时全打印清单34件；保留历史基线，不作为现行补打或采购数量。上下独立线束护口取消，不采购或打印；其他液路护口不在此次取消范围。饰件需另备适配PLA的薄层胶材；软垫、绑带及紧固件另备，见[装配详单](model/completion-print/README.md)。
