miclle/cybertrack/hardware/model/print-parts/print-parts.pdf

# 六组合并打印 · 保留原有机甲层次

CYBERTRACK / 0.51 / 2026-10-26

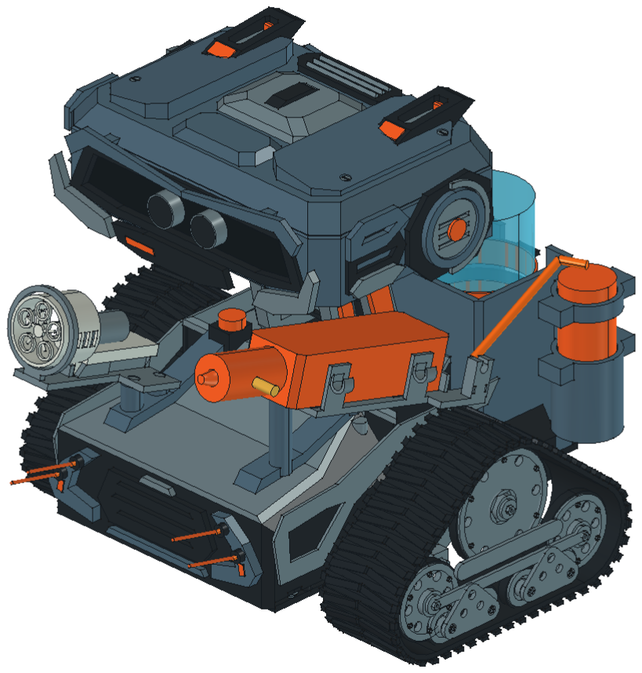
[picture p105: figure]

CAD连通性与装配评审；材料、层向、支撑、公差与实物验收未完成。 | 1 / 4

# 58个源特征 → 6个单实体候选

本轮六件，不是全机打印BOM。

### PP01 水枪一体底托

### PP02 泡泡枪一体圆环底座

### PP03 双瓶背包一体外壳及桶座

### PP04 一体底盘及湿舱隔板

### PP05 一体冠盖及装甲饰件

### PP06 一体固定颈架

双枪与背包保持原材料外形；冠盖增加背侧连接筋，颈架填平横梁间隙并补孔顶薄桥 ，底盘补湿舱内侧接缝。装甲台阶、凹槽、脊翼、主要外轮廓和检修分界保留。

原0.50装配图册用于识别源特征；本图册与0.51分件清单决定本轮打印范围。

# 合并打印件 · 几何与装配边界

CYBERTRACK / 0.51 / 2026-10-26

## PP01 水枪一体底托

外包络：46.70 × 100.27 × 46.55 mm

3个源特征 → 1个有效实体；STL闭合边界与CAD一致。

底托、两处托管槽合为一件。枪体、胶垫及肩梁独立，保留两颗基座螺钉。

STL仅居中落地，图示轴向不是已确定的打印朝向。

## PP02 泡泡枪一体圆环底座

外包络：50.00 × 67.35 × 59.67 mm

8个源特征 → 1个有效实体；STL闭合边界与CAD一致。

底座、前圆环、六段槽壁合为一件。保留穿环入槽与底座可拆路径，软垫独立。

STL仅居中落地，图示轴向不是已确定的打印朝向。

CYBERTRACK / 0.51 / 2026-10-26

## PP03 双瓶背包一体外壳及桶座

外包络：179.50 × 72.50 × 90.00 mm

3个源特征 → 1个有效实体；STL闭合边界与CAD一致。

背包壳、下后护甲和脊条融合；桶座原已一体。瓶底托、绑带、软垫和设备不并入。

STL仅居中落地，图示轴向不是已确定的打印朝向。

## PP04 一体底盘及湿舱隔板

外包络：174.00 × 196.00 × 66.00 mm

3个源特征 → 1个有效实体；STL闭合边界与CAD一致。

底盘与湿舱隔板融合并补内侧接缝；保留两处原有封闭内腔。底盖、电源内托架、顶盖和电 子托框独立。

STL仅居中落地，图示轴向不是已确定的打印朝向。

CYBERTRACK / 0.51 / 2026-10-26

## PP05 一体冠盖及装甲饰件

外包络：162.33 × 124.00 × 32.00 mm

22个源特征 → 1个有效实体；STL闭合边界与CAD一致。

四条宽6、高2 mm的背侧连接筋连接前后护甲。四颗冠盖螺钉保持，整体上取。

STL仅居中落地，图示轴向不是已确定的打印朝向。

## PP06 一体固定颈架

外包络：68.00 × 50.00 × 68.00 mm

19个源特征 → 1个有效实体；STL闭合边界与CAD一致。

横梁半径7.5改8 mm；外层板孔顶各补0.4 mm薄桥。外轮廓和中央走线保持，无活动关节。

STL仅居中落地，图示轴向不是已确定的打印朝向。
