miclle/cybertrack/hardware/components/37R-520/images/vendor-dimensions.png

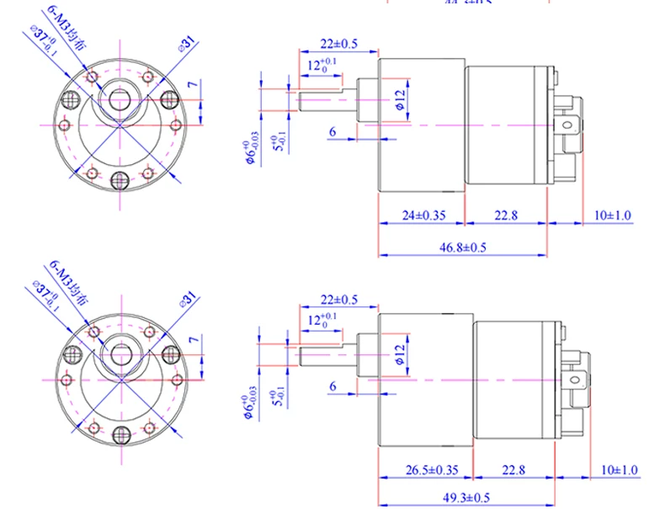
hardware/components/37R-520/images/vendor-dimensions.png
