miclle/cybertrack/hardware/components/breadboard/front-20261025.jpg

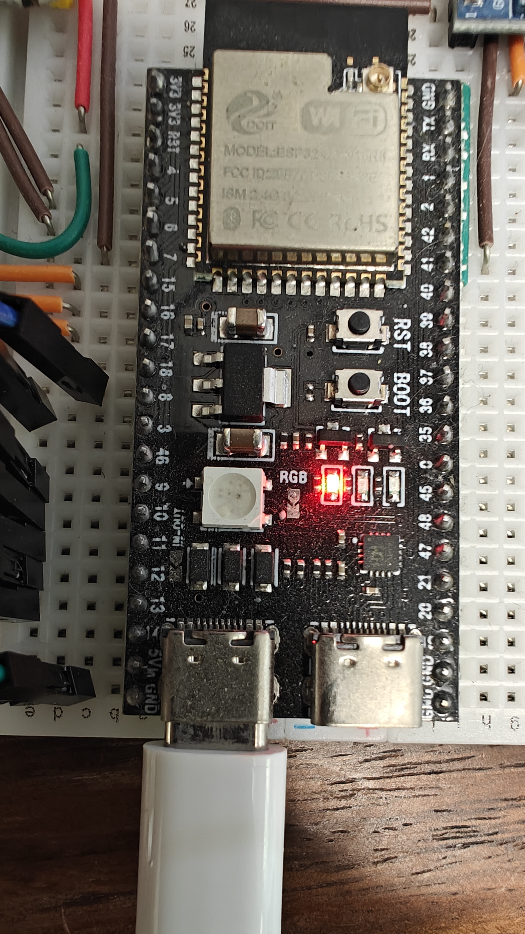
hardware/components/breadboard/front-20261025.jpg
