miclle/cybertrack/hardware/components/ck-5v-battery/reference/physical-20261025.jpg

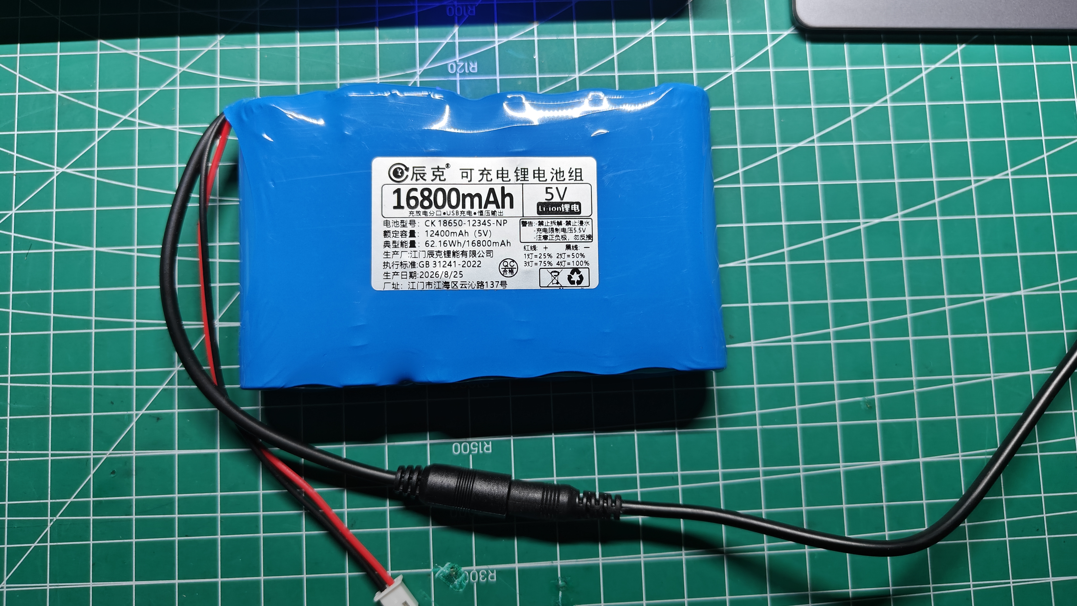
hardware/components/ck-5v-battery/reference/physical-20261025.jpg
