miclle/cybertrack/hardware/components/dc-dc-buck/voltage-selection.png

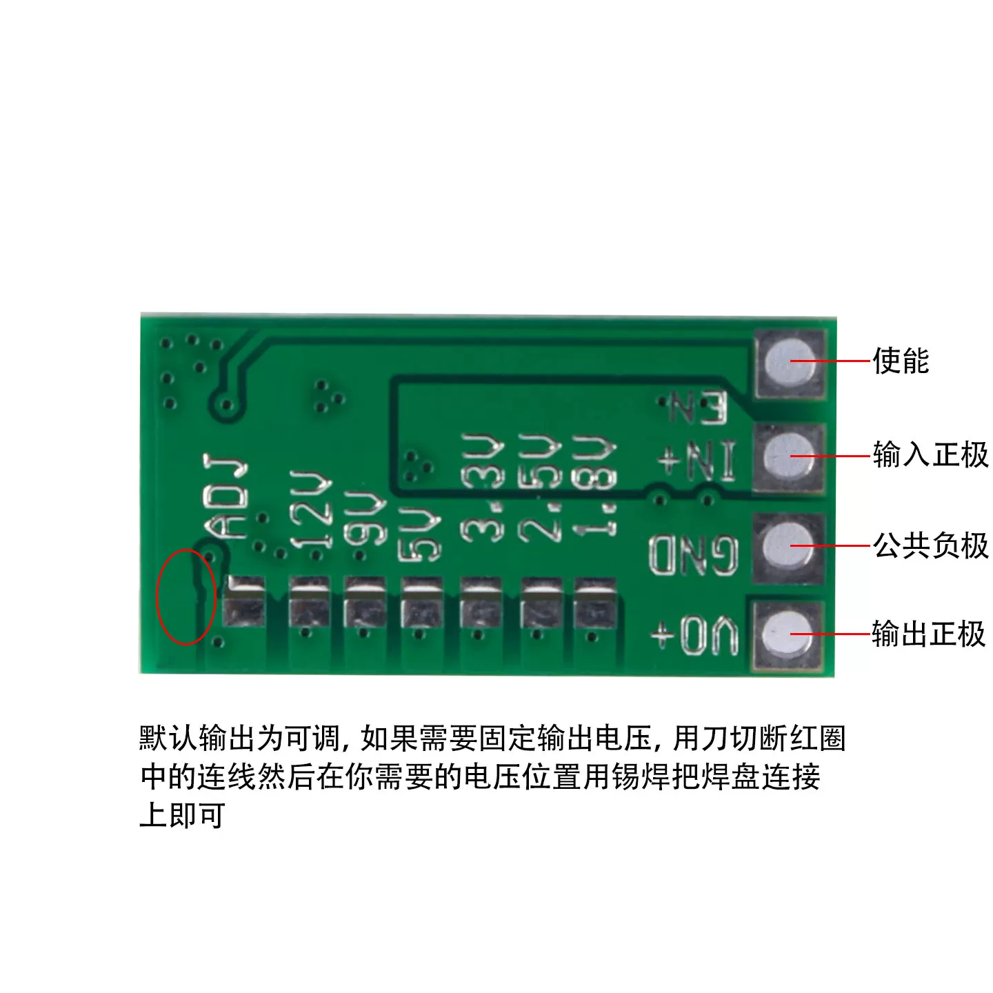
hardware/components/dc-dc-buck/voltage-selection.png
