miclle/cybertrack/hardware/components/DF-MD-V1.3/reference/DRI0002_CD.jpg

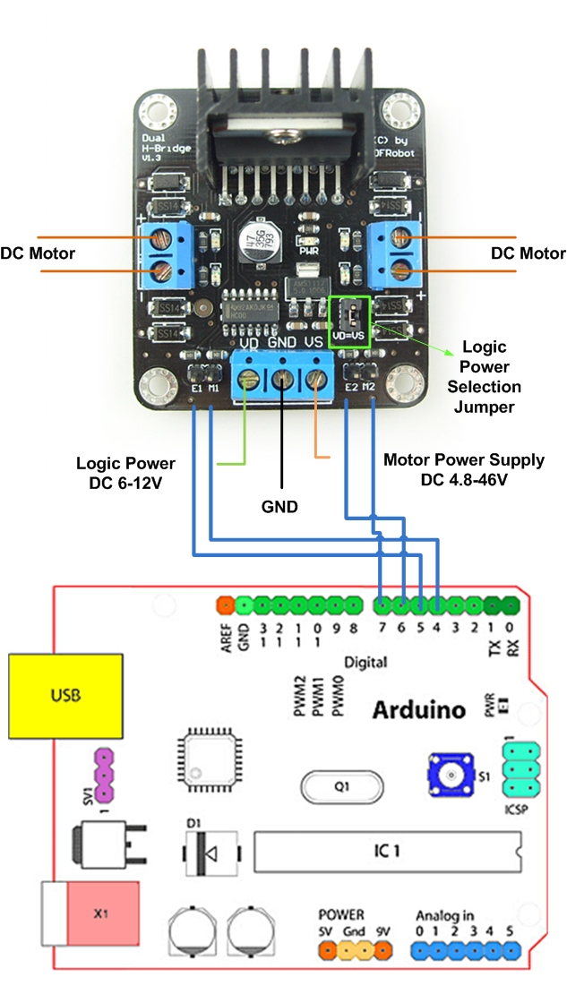
hardware/components/DF-MD-V1.3/reference/DRI0002_CD.jpg
