miclle/cybertrack/hardware/components/ESP32-S3-N16R8/ESP32-S3-back.jpg

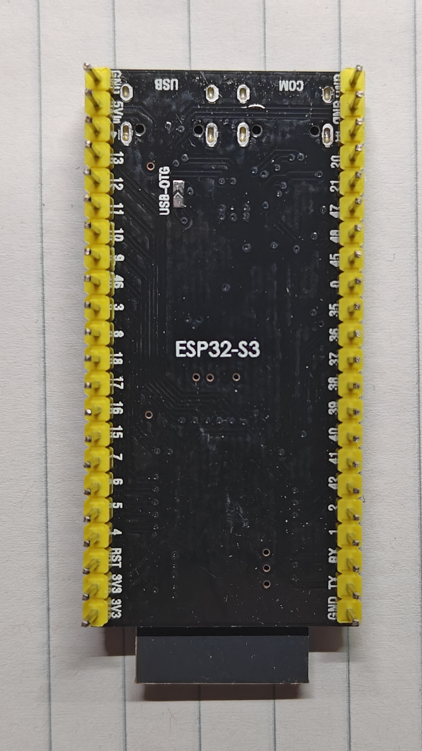
hardware/components/ESP32-S3-N16R8/ESP32-S3-back.jpg
