miclle/cybertrack/hardware/components/ESP32-S3-N16R8/ESP32-S3-WROOM系列型号对比.png

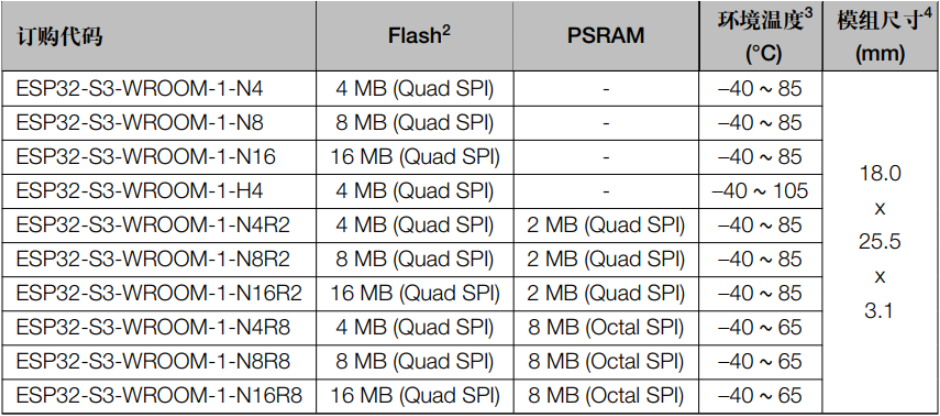
hardware/components/ESP32-S3-N16R8/ESP32-S3-WROOM系列型号对比.png
