miclle/cybertrack/hardware/components/jz-mos/physical-back-20261024.jpg

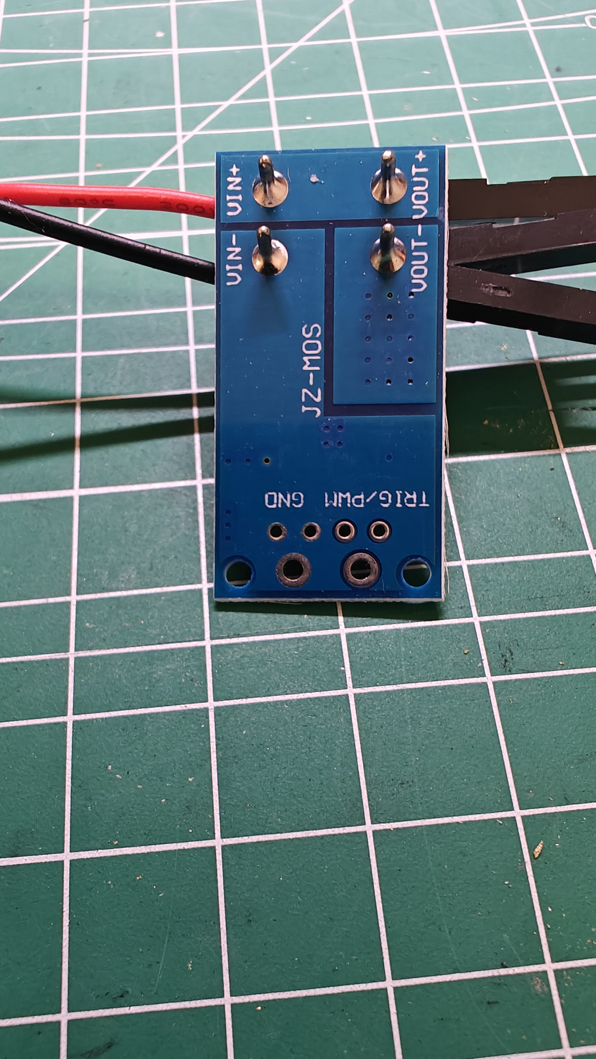
hardware/components/jz-mos/physical-back-20261024.jpg
