miclle/cybertrack/hardware/components/jz-mos/physical-front-20261024.jpg

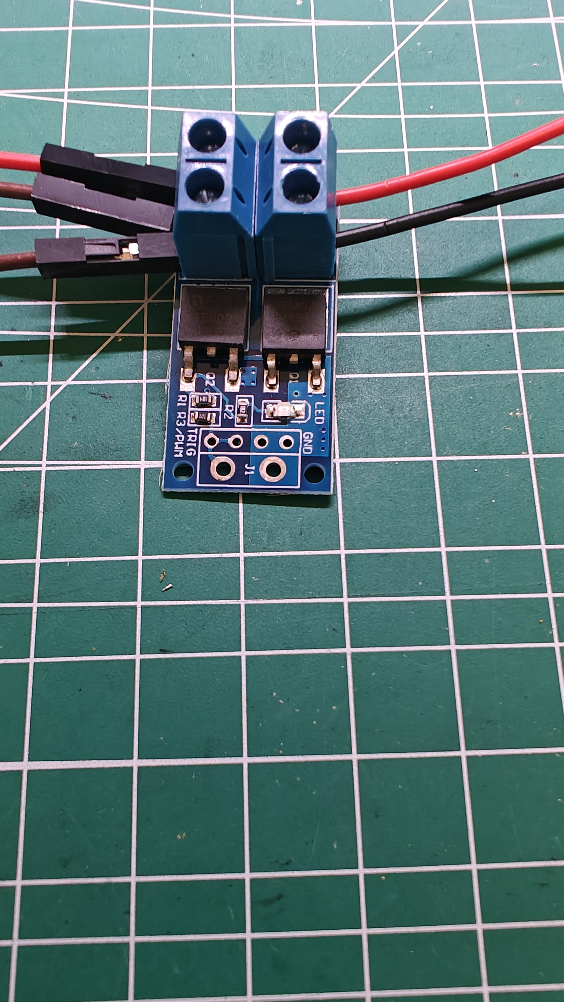
hardware/components/jz-mos/physical-front-20261024.jpg
