miclle/cybertrack/hardware/components/L298N/reference/user-front-20261025.png

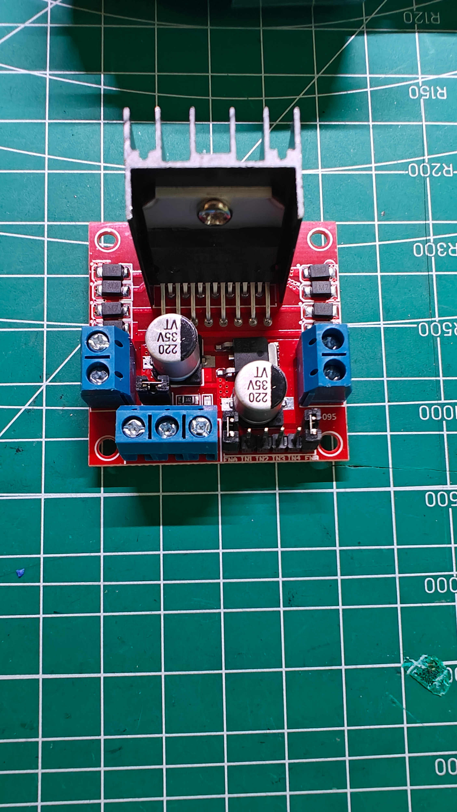
hardware/components/L298N/reference/user-front-20261025.png
