miclle/cybertrack/hardware/model/print-parts/PP01.png

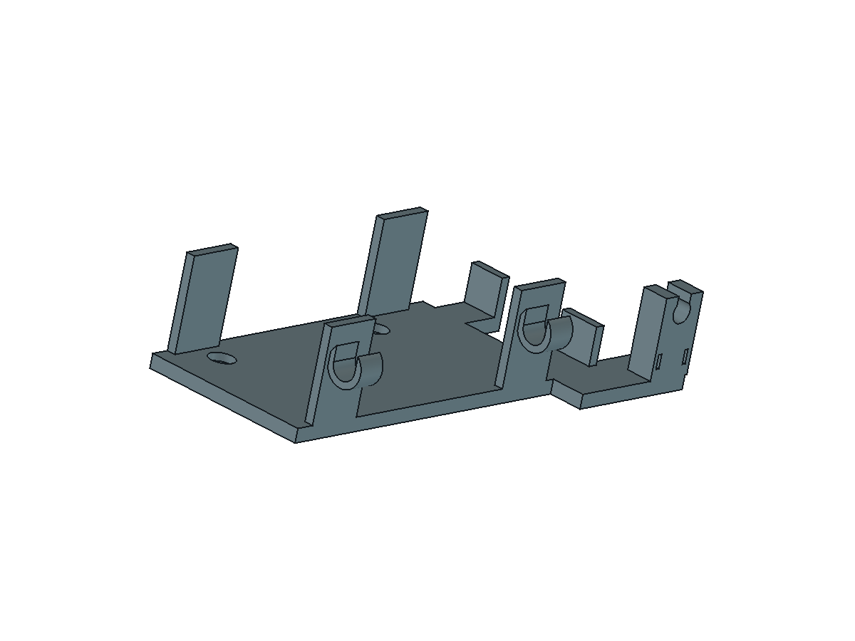
hardware/model/print-parts/PP01.png
