miclle/cybertrack/hardware/model/print-parts/PP02.png

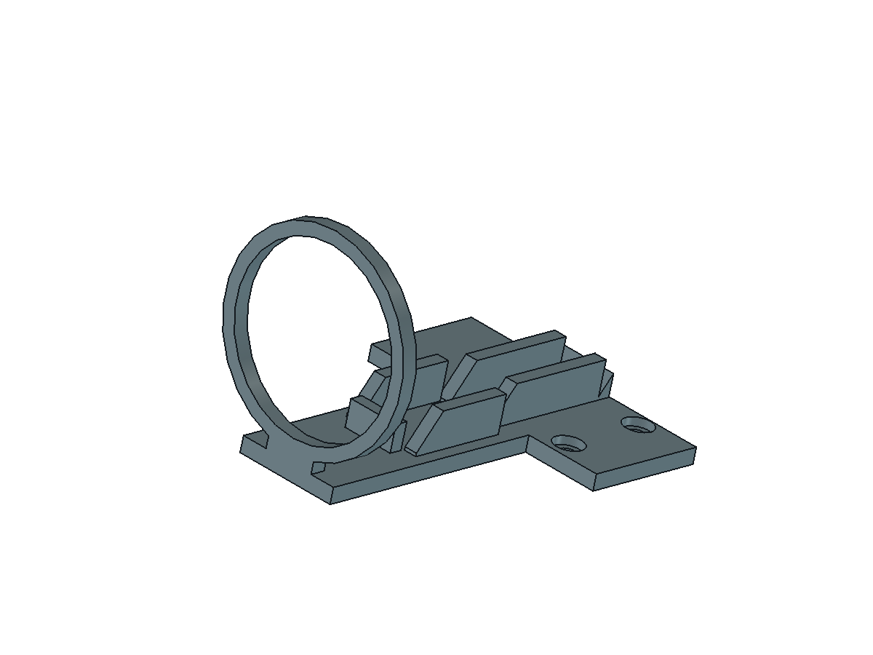
hardware/model/print-parts/PP02.png
