miclle/cybertrack/hardware/model/print-parts/PP03.png

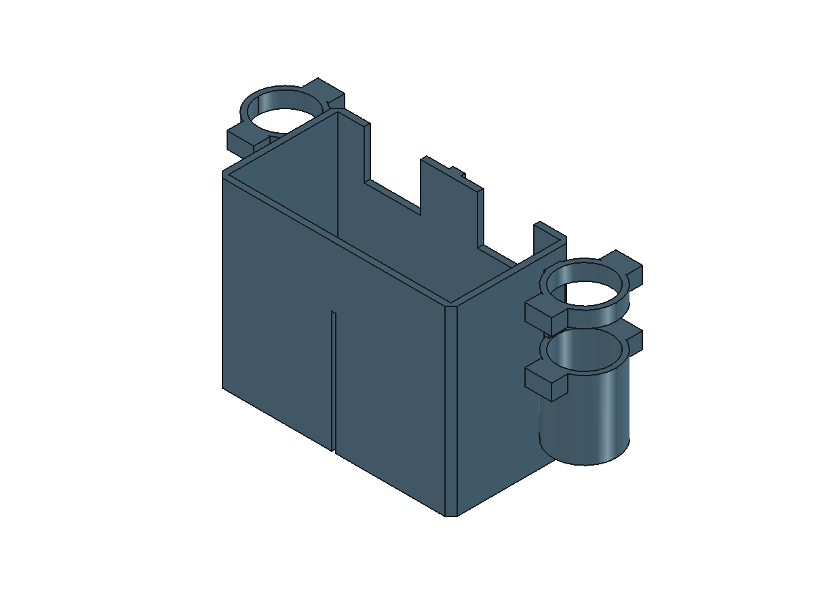
hardware/model/print-parts/PP03.png
