miclle/cybertrack/hardware/model/print-parts/PP04.png

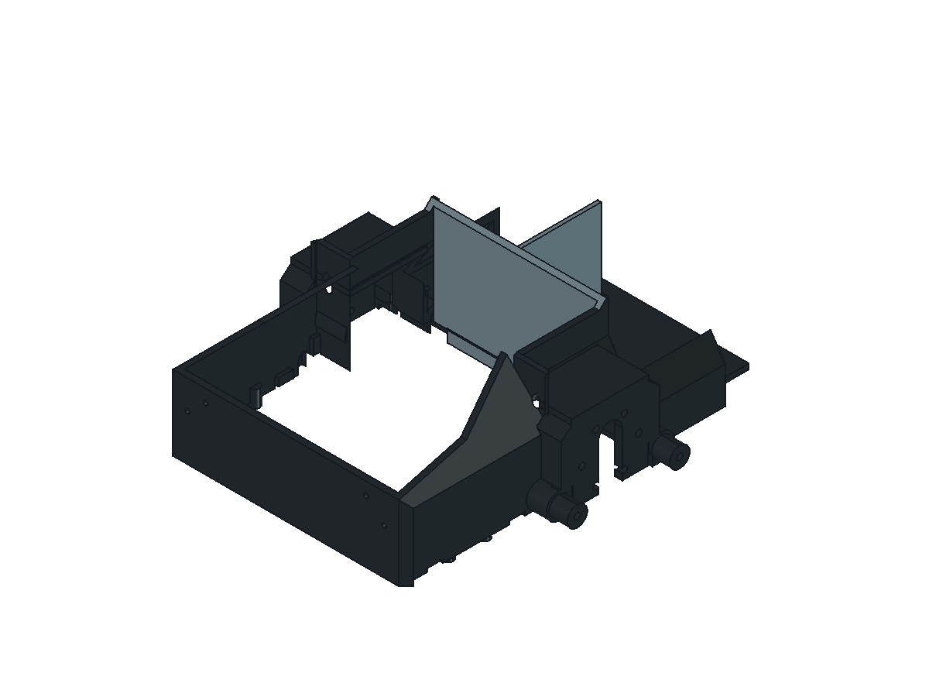
hardware/model/print-parts/PP04.png
