miclle/cybertrack/hardware/model/print-parts/PP05.png

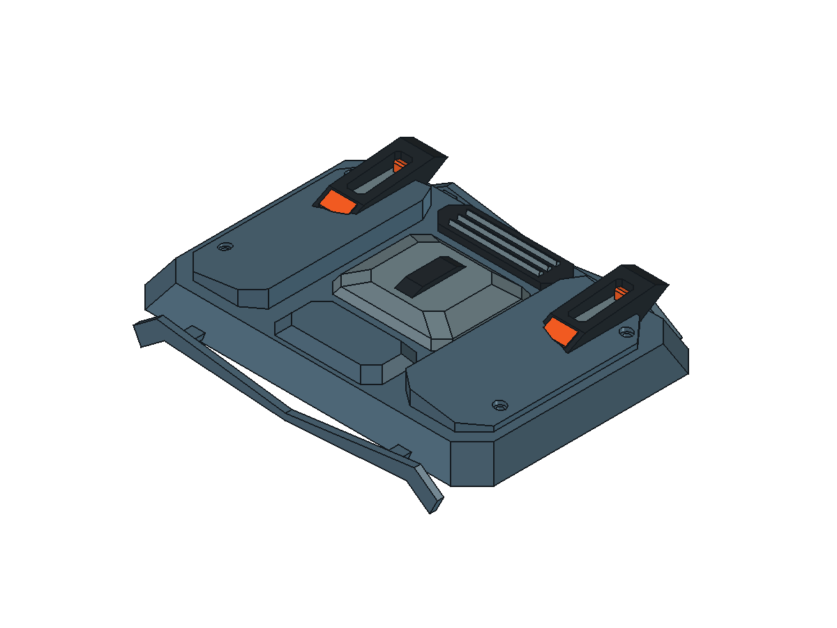
hardware/model/print-parts/PP05.png
