miclle/cybertrack/hardware/model/print-parts/PP07-slicing/head-set-speed/combined/first-layer-paths.png

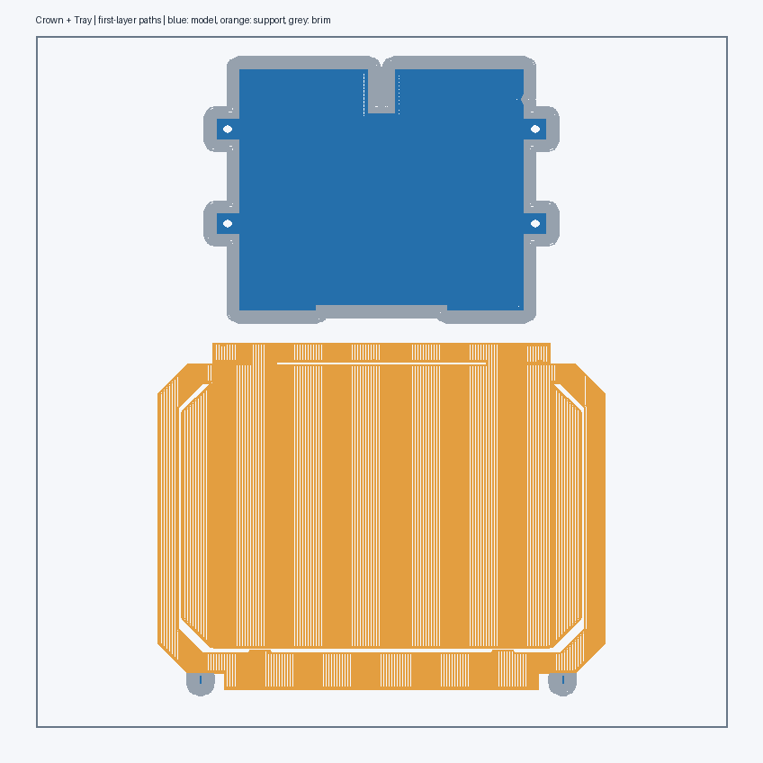
hardware/model/print-parts/PP07-slicing/head-set-speed/combined/first-layer-paths.png
