miclle/cybertrack/hardware/model/print-parts/PP07-slicing/head-set-speed/combined/plate-preview.png

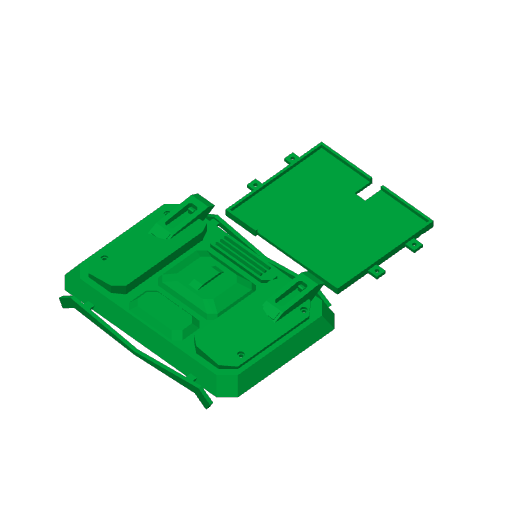
hardware/model/print-parts/PP07-slicing/head-set-speed/combined/plate-preview.png
