miclle/cybertrack/hardware/model/print-parts/PP07-top.png

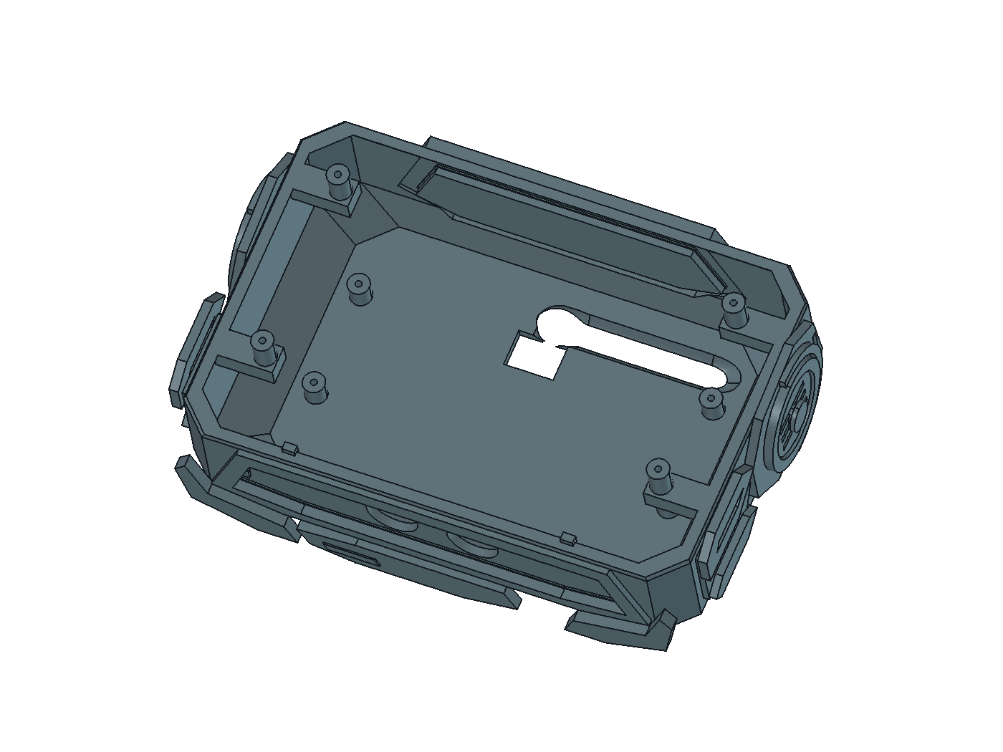
hardware/model/print-parts/PP07-top.png
