miclle/cybertrack/hardware/components/bubble-gun/BubbleGun.FCStd

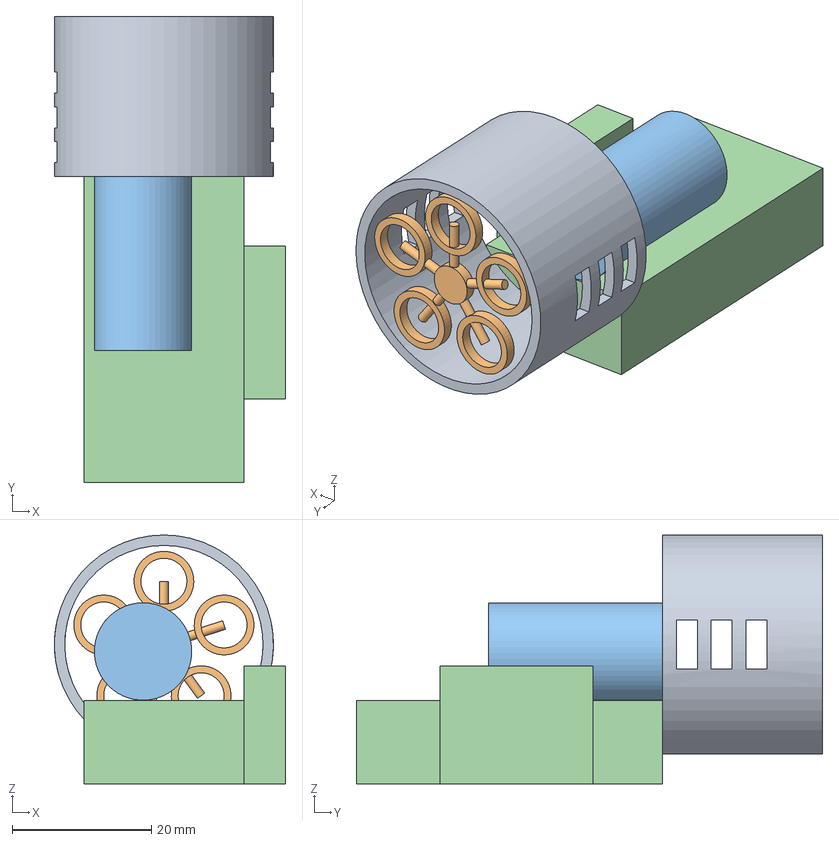
[picture p125: CAD file, 2026-10-24]
hardware/components/bubble-gun/BubbleGun.FCStd
33.2 x 67.0 x 35.8 mm
前端通风圆筒／枪口外径31.5
五环出泡盘示意
电机外形示意
后部机构壳／接口未测
