miclle/cybertrack/hardware/components/ck-5v-battery/Battery-envelope.FCStd

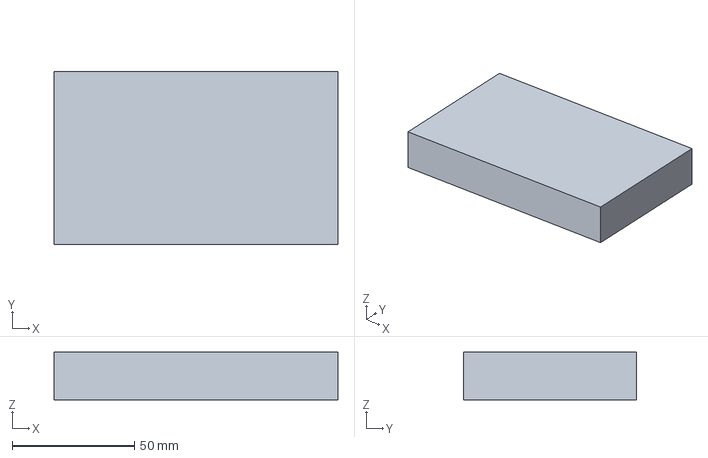
[picture p126: CAD file, 2026-10-25]
hardware/components/ck-5v-battery/Battery-envelope.FCStd
116.0 x 70.5 x 19.5 mm
