miclle/cybertrack/hardware/components/dc-dc-buck/DC-DC-buck-envelope.FCStd

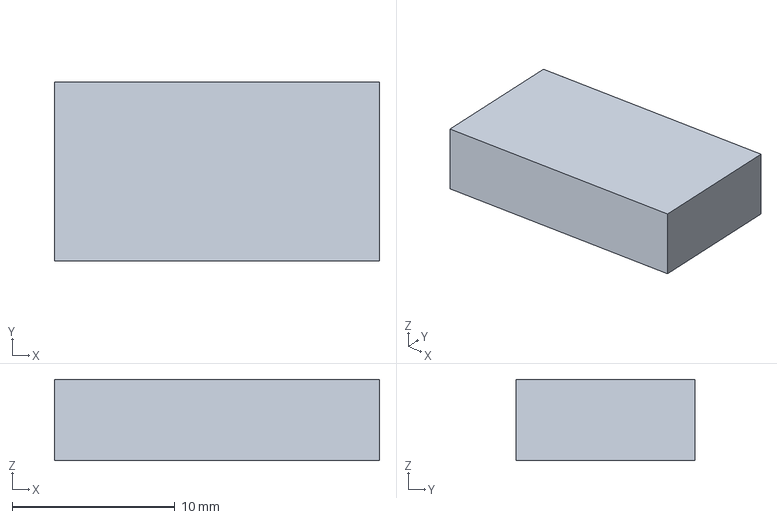
[picture p127: CAD file, 2026-10-25]
hardware/components/dc-dc-buck/DC-DC-buck-envelope.FCStd
20.0 x 11.0 x 5.00 mm
