miclle/cybertrack/hardware/components/L298N/L298N-envelope.FCStd

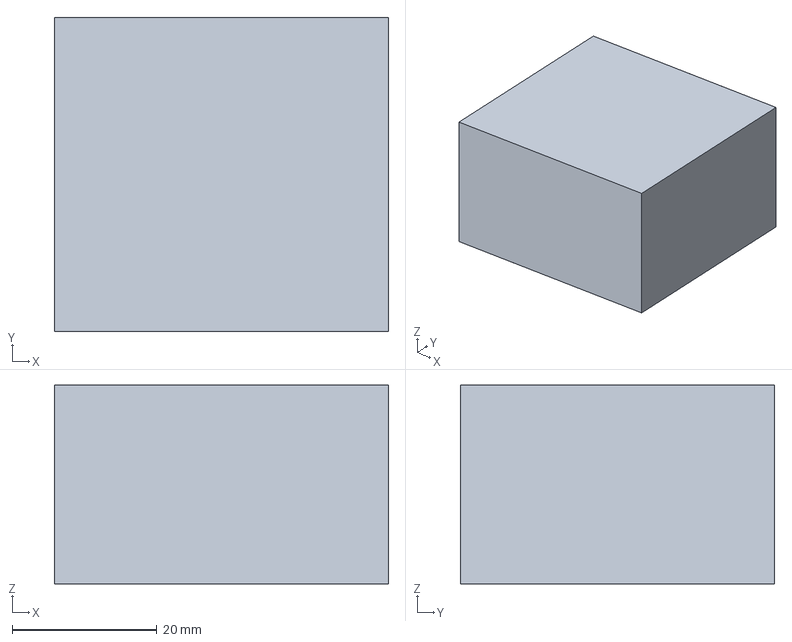
[picture p128: CAD file, 2026-10-25]
hardware/components/L298N/L298N-envelope.FCStd
46.2 x 43.5 x 27.5 mm
