miclle/cybertrack/hardware/components/MT3608/MT3608-envelope.FCStd

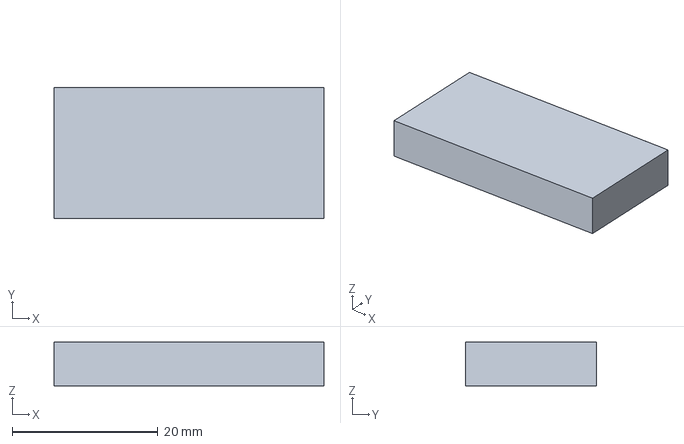
[picture p129: CAD file, 2026-10-25]
hardware/components/MT3608/MT3608-envelope.FCStd
37.0 x 18.0 x 6.00 mm
