miclle/cybertrack/hardware/components/power-switch/PowerSwitch-envelope.step

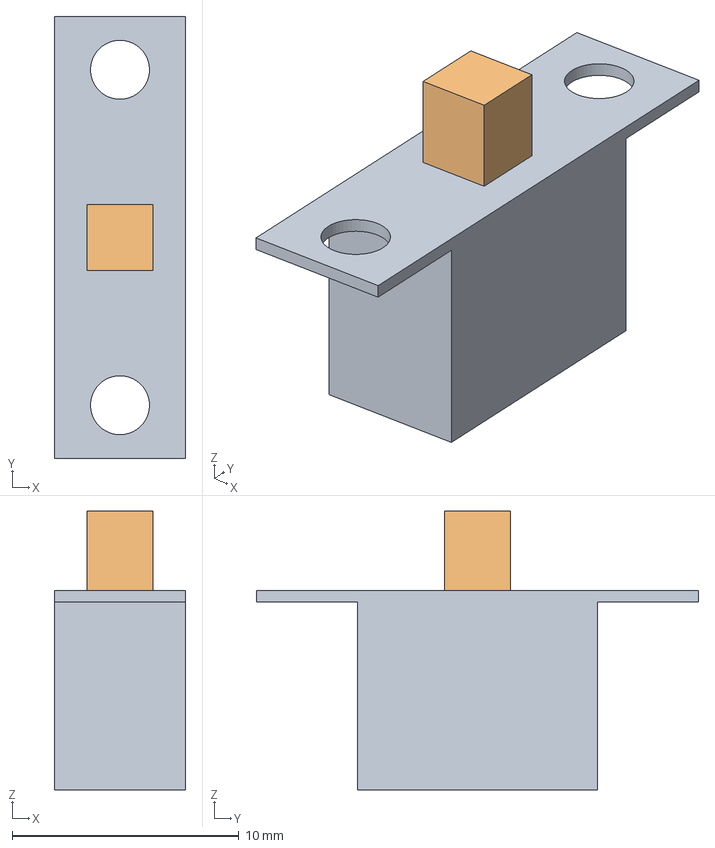
[picture p130: CAD file, 2026-10-25]
hardware/components/power-switch/PowerSwitch-envelope.step
5.80 x 19.5 x 12.3 mm
