miclle/cybertrack/hardware/components/pulse-water-gun/PulseWaterGun.step

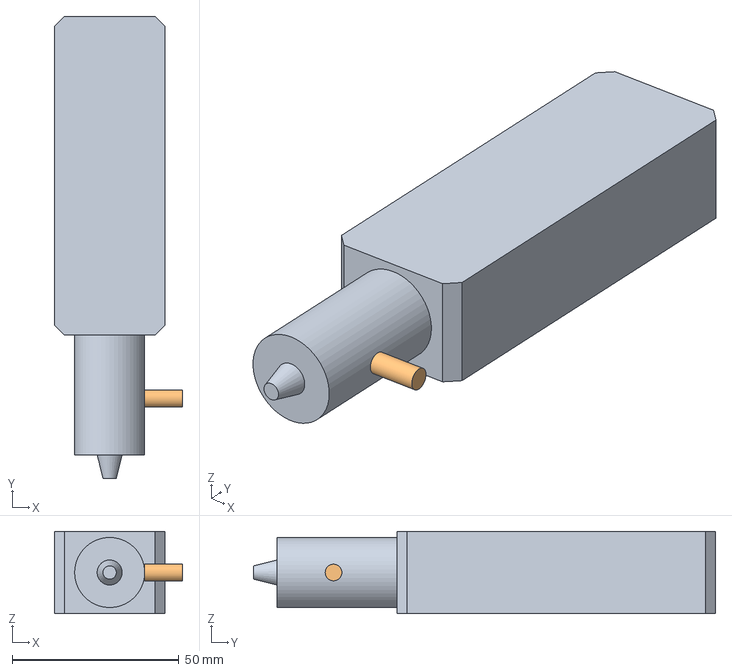
[picture p131: CAD file, 2026-10-24]
hardware/components/pulse-water-gun/PulseWaterGun.step
38.5 x 138.5 x 24.6 mm
