miclle/cybertrack/hardware/components/track-mount/TrackMount.step

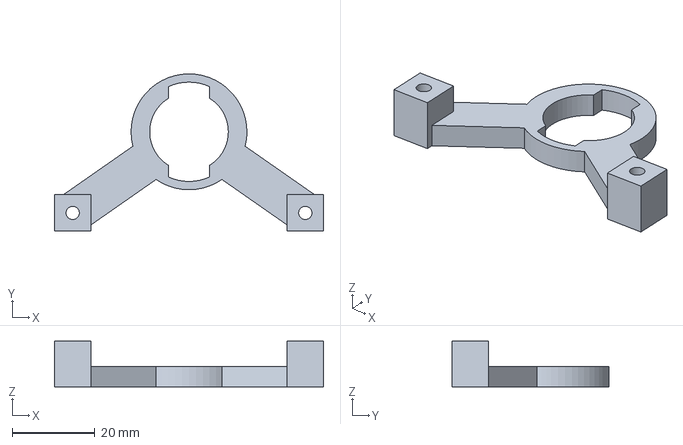
[picture p132: CAD file, 2026-10-23]
hardware/components/track-mount/TrackMount.step
65.0 x 38.0 x 11.0 mm
