miclle/cybertrack/hardware/model/completion-print/WaterLidMark.step

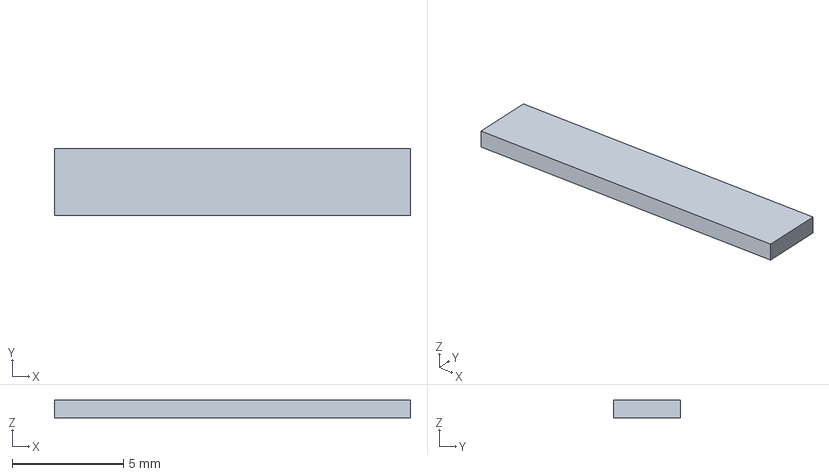
[picture p133: CAD file, 2026-10-26]
hardware/model/completion-print/WaterLidMark.step
16.0 x 3.00 x 0.8 mm
