miclle/cybertrack/hardware/model/container-garage/printed/parts/B02.stl

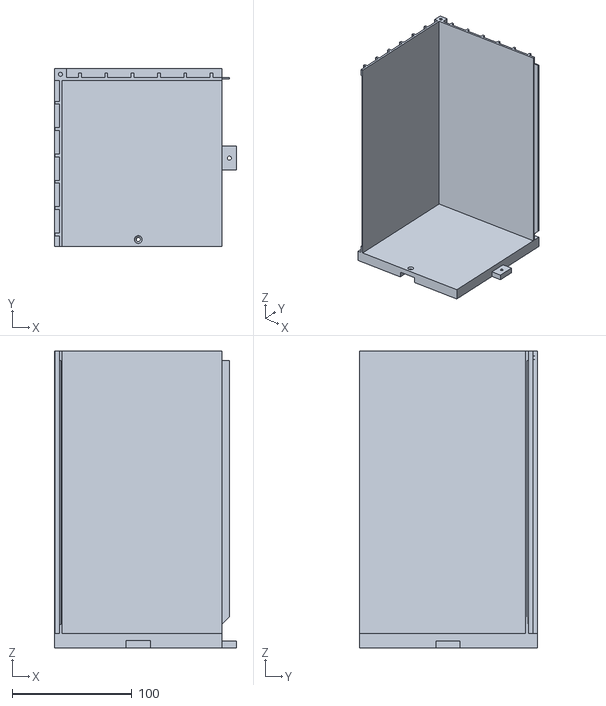
[picture p134: CAD file, 2026-10-28]
hardware/model/container-garage/printed/parts/B02.stl
152.0 x 149.0 x 248.0
