miclle/cybertrack/hardware/model/container-garage/printed/slicing/B01/B01.3mf

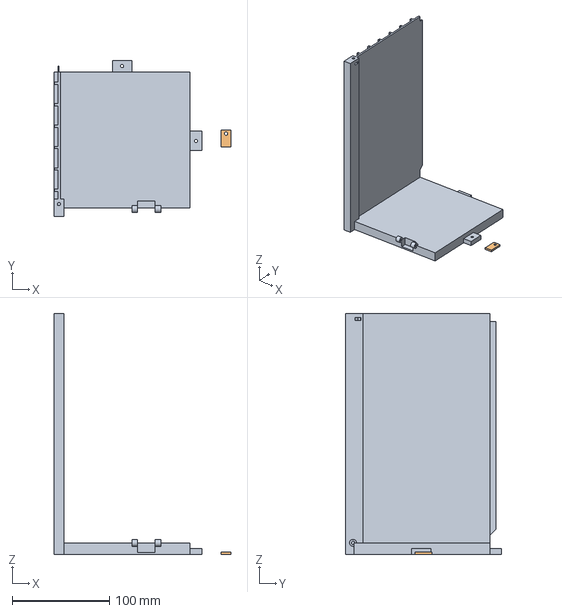
[picture p135: CAD file, 2026-10-28]
hardware/model/container-garage/printed/slicing/B01/B01.3mf
182.0 x 161.0 x 248.0 mm
B01
L01
