miclle/cybertrack/hardware/model/container-garage/printed/slicing/B04/B04.3mf

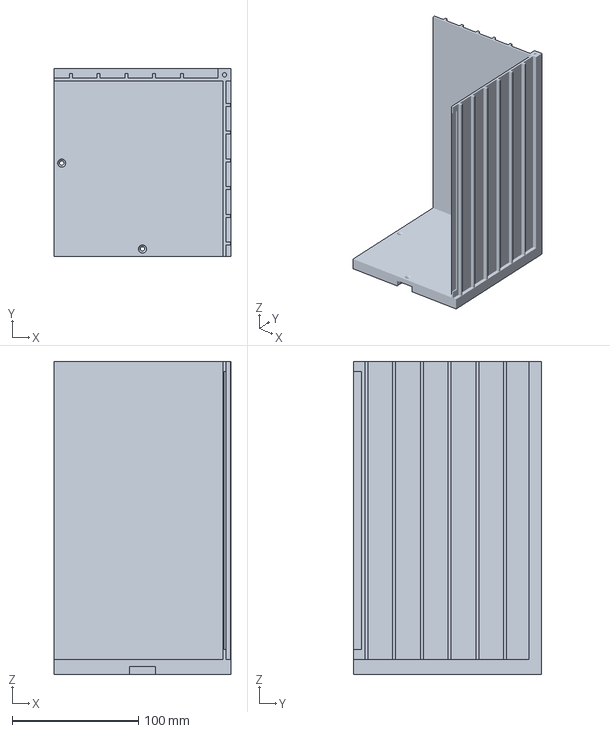
[picture p136: CAD file, 2026-10-28]
hardware/model/container-garage/printed/slicing/B04/B04.3mf
140.0 x 149.0 x 248.0 mm
