miclle/cybertrack/hardware/model/container-garage/printed/slicing/D02/input.3mf

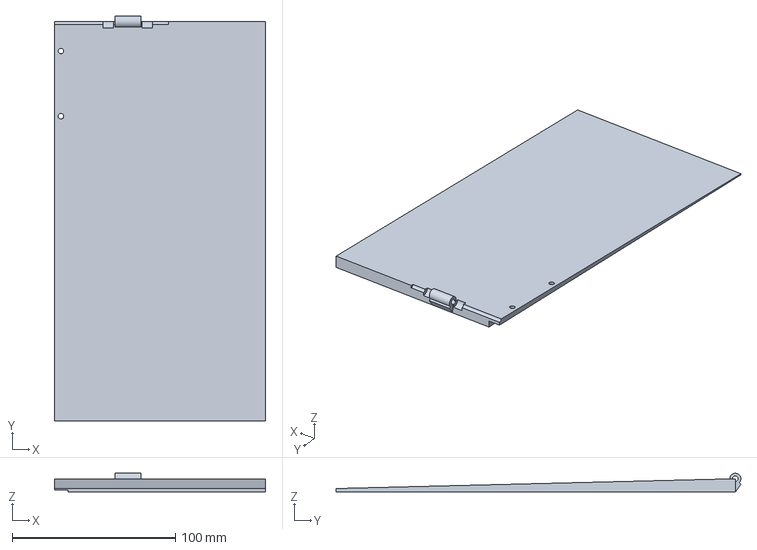
[picture p137: CAD file, 2026-10-28]
hardware/model/container-garage/printed/slicing/D02/input.3mf
129.5 x 248.4 x 11.4 mm
