miclle/cybertrack/hardware/model/container-garage/printed/slicing/R01/input.3mf

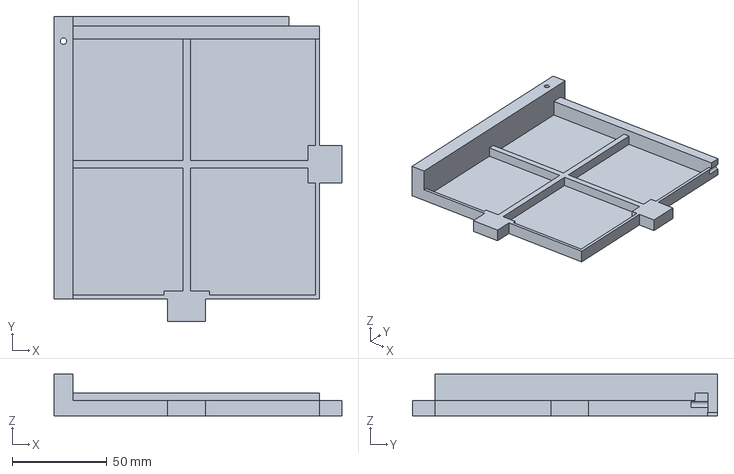
[picture p138: CAD file, 2026-10-28]
hardware/model/container-garage/printed/slicing/R01/input.3mf
152.0 x 161.0 x 22.0 mm
