miclle/cybertrack/hardware/model/container-garage/printed/slicing/R03/R03.3mf

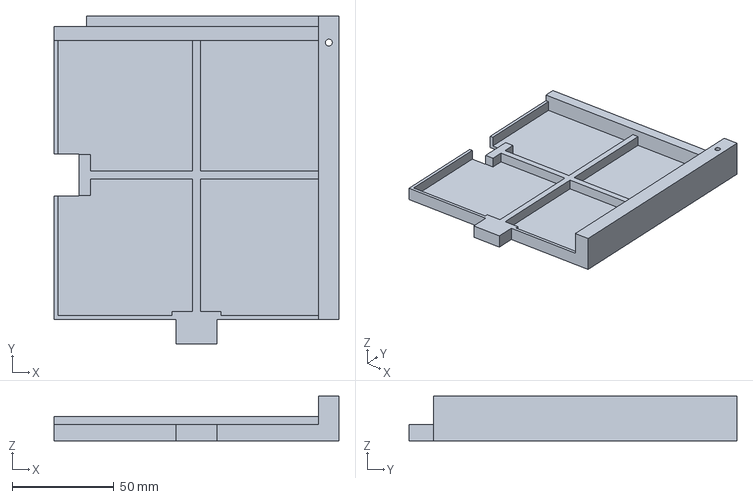
[picture p140: CAD file, 2026-10-28]
hardware/model/container-garage/printed/slicing/R03/R03.3mf
140.0 x 161.0 x 22.0 mm
