miclle/cybertrack/hardware/model/CyberTrack.step

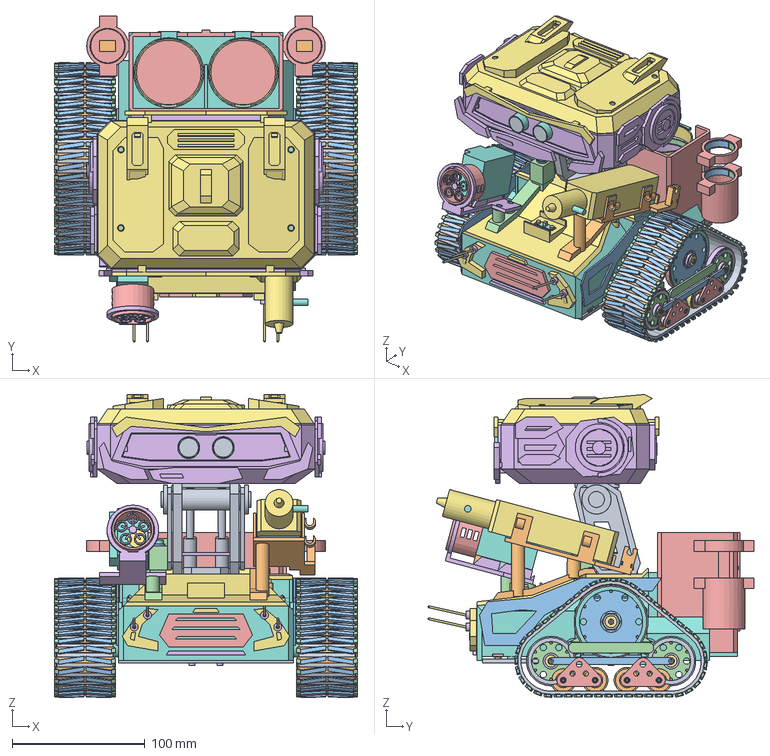
[picture p141: CAD file, 2026-10-26]
hardware/model/CyberTrack.step
228.0 x 245.2 x 228.0 mm
