miclle/cybertrack/hardware/model/drive-fit-fixture/l298n-gap-study/L298N-30mm-layout-study.FCStd

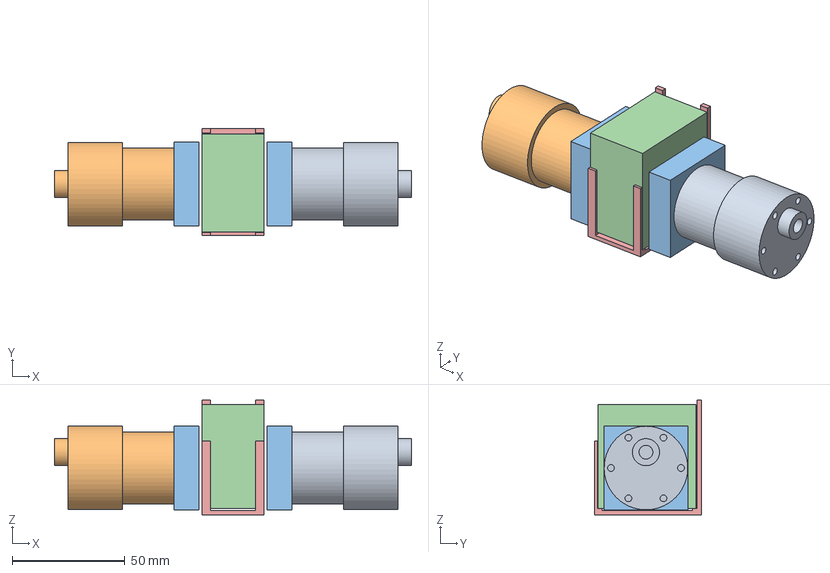
[picture p142: CAD file, 2026-10-26]
hardware/model/drive-fit-fixture/l298n-gap-study/L298N-30mm-layout-study.FCStd
158.0 x 47.2 x 50.7 mm
MotorL
MotorR
TailStudyKeepout
CandidateL298N
CandidateCradle
