miclle/cybertrack/hardware/model/drive-fit-fixture/VF01-DriveFitFrame.stl

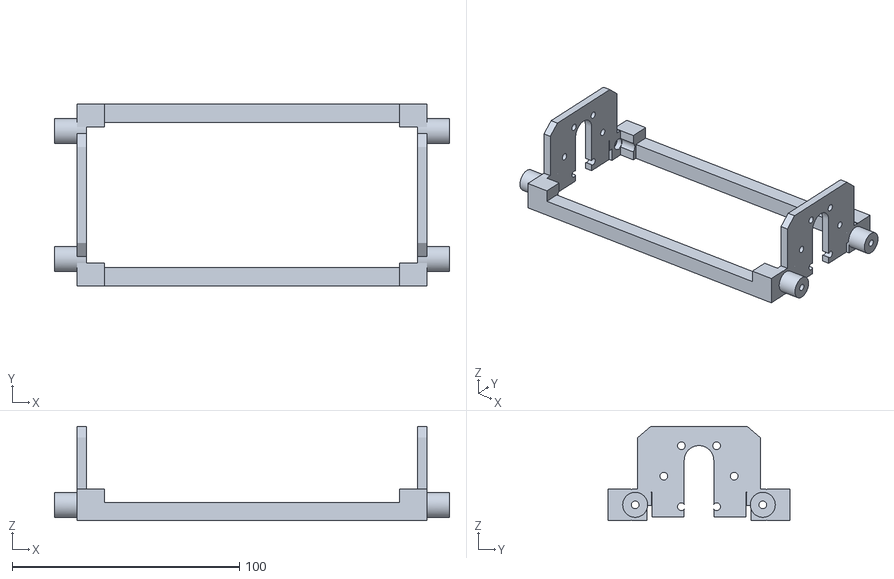
[picture p143: CAD file, 2026-10-26]
hardware/model/drive-fit-fixture/VF01-DriveFitFrame.stl
174.0 x 80.0 x 41.6
