miclle/cybertrack/hardware/model/l298n-compact/LC03-BottomServiceCover.step

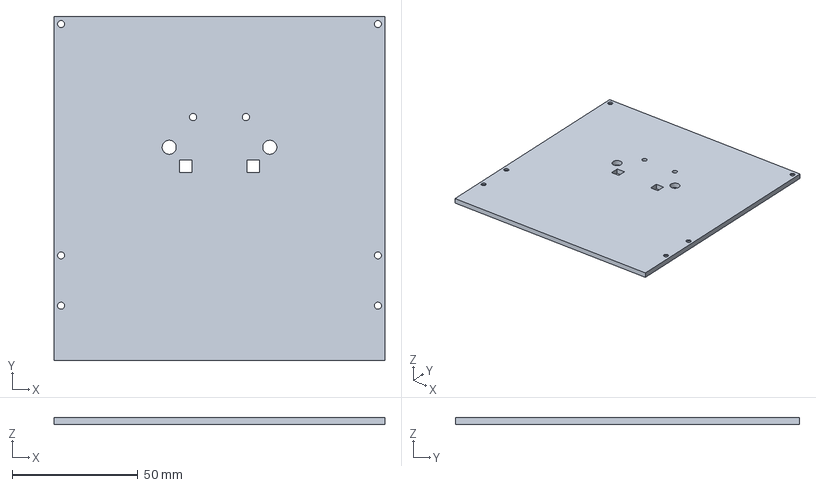
[picture p144: CAD file, 2026-10-26]
hardware/model/l298n-compact/LC03-BottomServiceCover.step
131.6 x 136.8 x 2.80 mm
