miclle/cybertrack/hardware/model/l298n-compact/slicing/print-stls/PrintNeck.stl

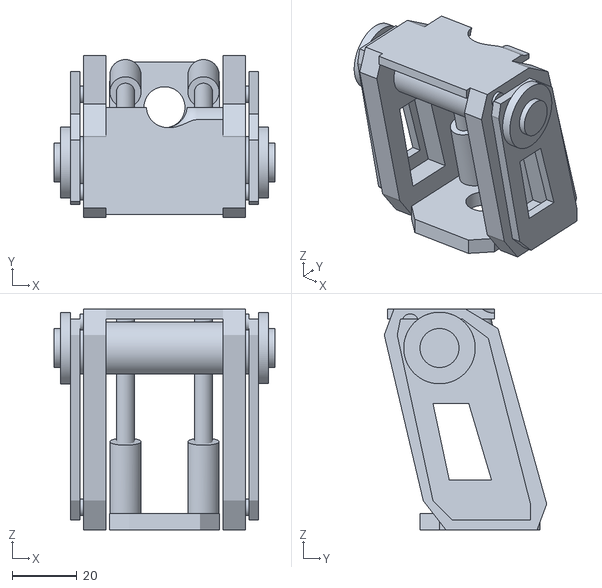
[picture p145: CAD file, 2026-10-26]
hardware/model/l298n-compact/slicing/print-stls/PrintNeck.stl
68.0 x 50.0 x 68.0
