miclle/cybertrack/hardware/model/lean-print/EffectTray.step

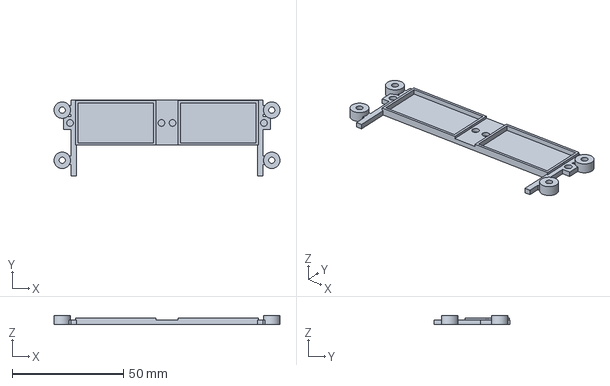
[picture p146: CAD file, 2026-10-26]
hardware/model/lean-print/EffectTray.step
101.4 x 34.0 x 4.00 mm
