miclle/cybertrack/hardware/model/parts/L298N-carrier-0.34.step

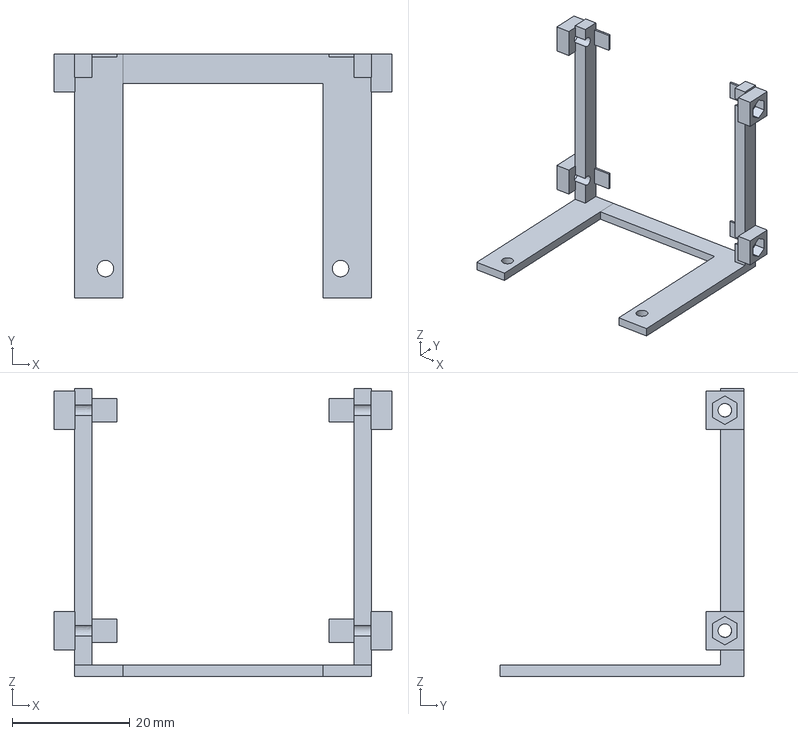
[picture p147: CAD file, 2026-10-26]
hardware/model/parts/L298N-carrier-0.34.step
57.5 x 41.5 x 49.0 mm
