miclle/cybertrack/hardware/model/print-ready/CyberTrack-Ready-6plates.3mf

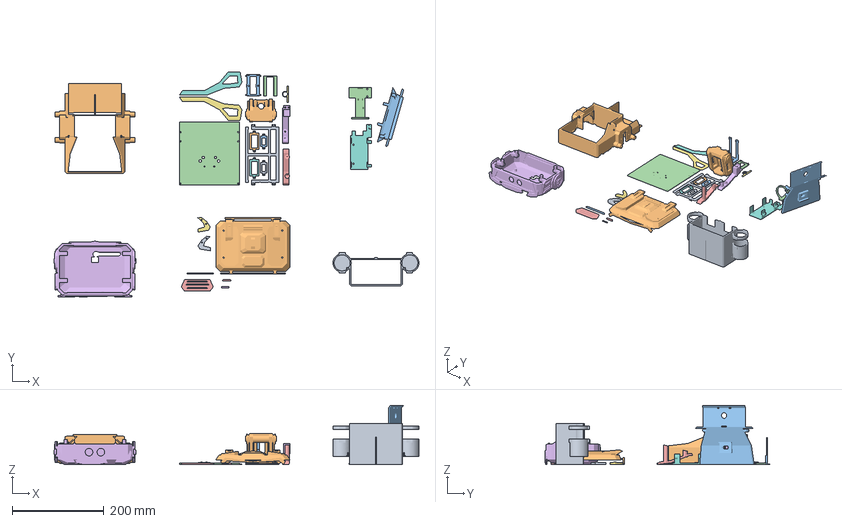
[picture p148: CAD file, 2026-10-28]
hardware/model/print-ready/CyberTrack-Ready-6plates.3mf
797.5 x 492.2 x 129.0 mm
PP03-base
PP07-Crown.stl
LC04-flipped
PP02-base
ChestAudioPanel
PP07-upright.stl
PrintChestGuardL
PP01-base
PrintChestGuardR
PP04-LowerTub.stl
LowerChin
LC03-BottomServiceCover-flipped
ChestBadge
WaterLidMark
KeelSideFrameL
KeelSideFrameR
BatteryHatch
PrintNeck
LC01-Carrier-upright
LC02-TopRetainer-flat
ShoulderRailL
ShoulderRailR
NeckCableBridge
EffectRetainerLMOS
EffectRetainerLBuck
EffectRetainerRMOS
EffectRetainerRBuck
