miclle/cybertrack/hardware/model/print-trials/gun-mounts-0.18/bubble-gun-bracket.stl

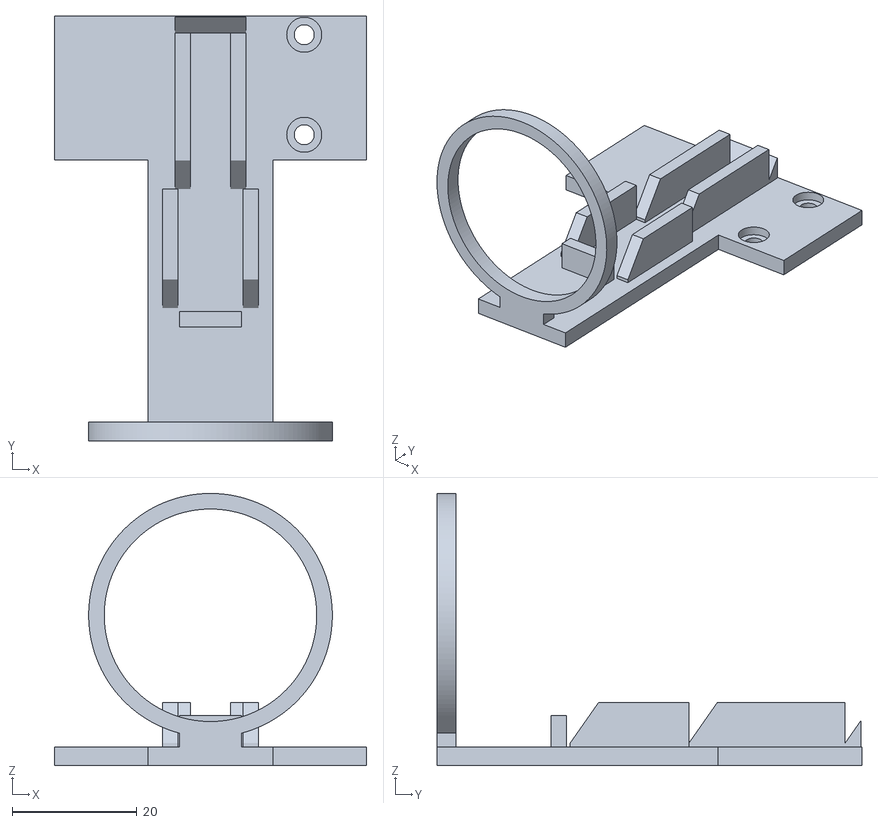
[picture p149: CAD file, 2026-10-24]
hardware/model/print-trials/gun-mounts-0.18/bubble-gun-bracket.stl
50.0 x 68.0 x 43.5
