miclle/cybertrack/hardware/model/remaining-print/PP03-back.step

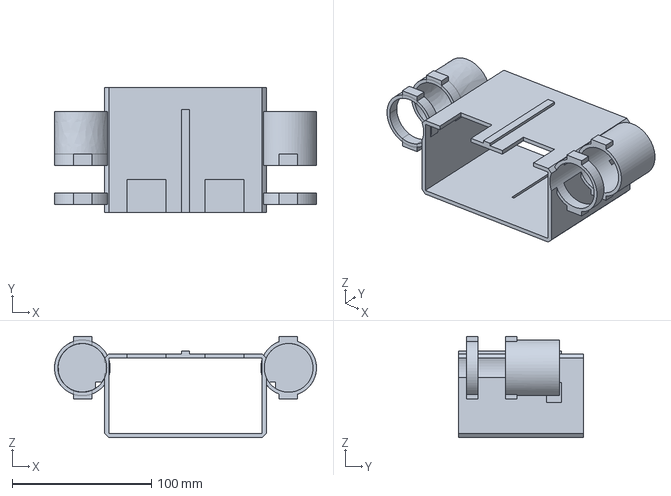
[picture p150: CAD file, 2026-10-28]
hardware/model/remaining-print/PP03-back.step
188.0 x 90.0 x 72.5 mm
