miclle/cybertrack/hardware/model/source/CyberTrack-design.FCStd

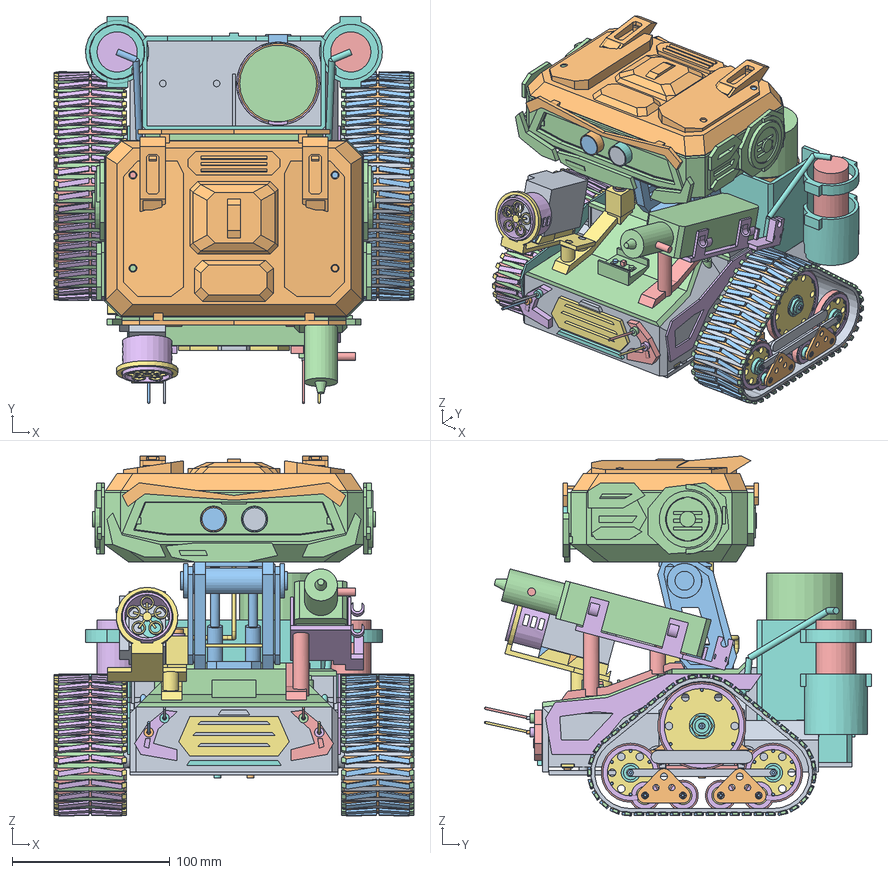
[picture p151: CAD file, 2026-10-28]
hardware/model/source/CyberTrack-design.FCStd
228.0 x 245.2 x 228.0 mm
左侧连续橡胶履带
左侧履带胎块底座（48节）
左侧人字形抓地块（96块）
左侧履带肩部胎块（96块）
左侧驱动轮与导向轮橡胶轮组
左侧金属轮圈
左侧镂空轮盘
左侧阶梯轮毂与垫圈
左侧悬挂支臂与轴套
左侧镂空承重轮摇臂板
左侧轮组及悬挂紧固件
右侧连续橡胶履带
右侧履带胎块底座（48节）
右侧人字形抓地块（96块）
右侧履带肩部胎块（96块）
右侧驱动轮与导向轮橡胶轮组
右侧金属轮圈
右侧镂空轮盘
右侧阶梯轮毂与垫圈
右侧悬挂支臂与轴套
右侧镂空承重轮摇臂板
右侧轮组及悬挂紧固件
左侧37R-520电机（尺寸占位）
左侧Ø6偏心D形输出轴
左侧黄铜六角联轴器（配合待测）
左侧履带安装件参考
右侧37R-520电机（尺寸占位）
右侧Ø6偏心D形输出轴
右侧黄铜六角联轴器（配合待测）
右侧履带安装件参考
独立内部电源承托架／开底盖时保留
电源底部承托垫
电源底部承托垫001
电源底部承托垫002
电源底部承托垫003
低鼻锥至颈架的折面顶盖
左斜面肩部承力梁
左镂空底座侧框
右斜面肩部承力梁
右镂空底座侧框
嵌件候选 BatteryInsertLFront
电源托盖下方沉头位紧固候选 LFront
嵌件候选 BatteryInsertLRear
电源托盖下方沉头位紧固候选 LRear
嵌件候选 BatteryInsertRFront
电源托盖下方沉头位紧固候选 RFront
嵌件候选 BatteryInsertRRear
电源托盖下方沉头位紧固候选 RRear
随电源托盖下取的柔性拉带占位
M2.5 级紧固件候选 CrownScrewLFront
M2.5 级紧固件候选 CrownScrewLRear
M2.5 级紧固件候选 CrownScrewRFront
M2.5 级紧固件候选 CrownScrewRRear
面包板浅托盘／105×90主体、122侧耳总宽
固定颈架线束限位桥
托架基座 M3 级嵌件候选 1
托架沉入式紧固候选 1
托架基座 M3 级嵌件候选 2
托架沉入式紧固候选 2
底部双面软胶候选／厚度未测 1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
