miclle/cybertrack/hardware/model/studies/bubble-ring-slot/FrontRing-candidate.step

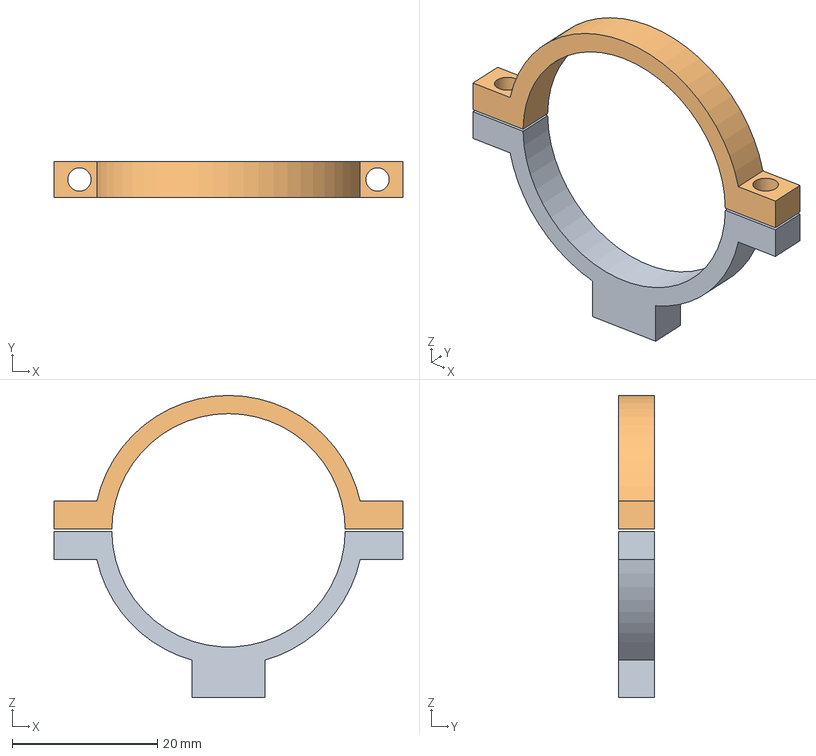
[picture p152: CAD file, 2026-10-24]
hardware/model/studies/bubble-ring-slot/FrontRing-candidate.step
48.0 x 5.00 x 41.5 mm
