miclle/cybertrack/hardware/model/completion-print/PrintChestGuardL.step

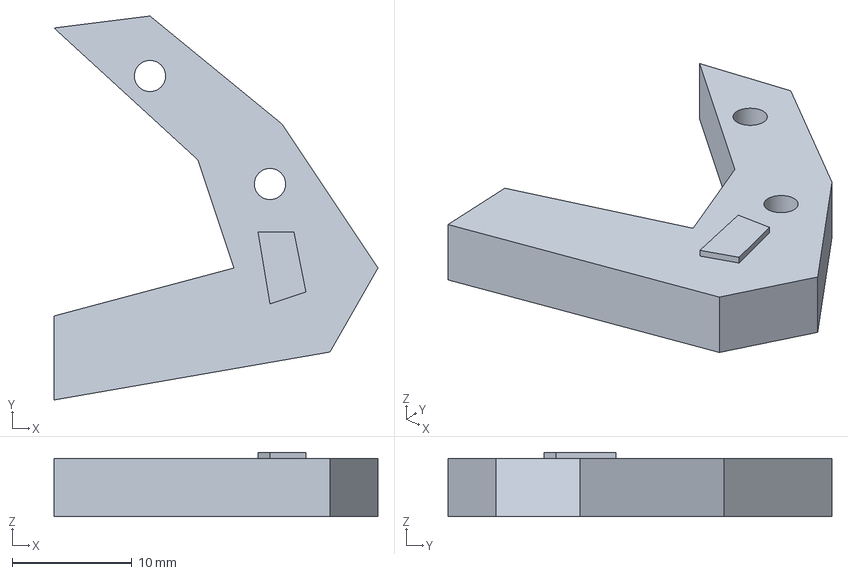
[picture p153: CAD file, 2026-10-26]
hardware/model/completion-print/PrintChestGuardL.step
27.0 x 32.0 x 5.35 mm
