miclle/cybertrack/hardware/model/container-garage/printed/parts/B03.stl

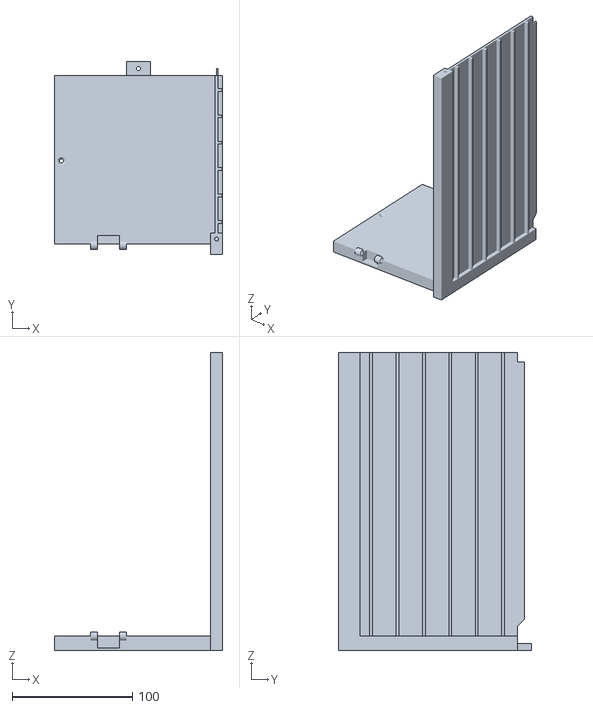
[picture p154: CAD file, 2026-10-28]
hardware/model/container-garage/printed/parts/B03.stl
140.0 x 161.0 x 248.0
