miclle/cybertrack/hardware/model/l298n-compact/LC04-KeelLid.step

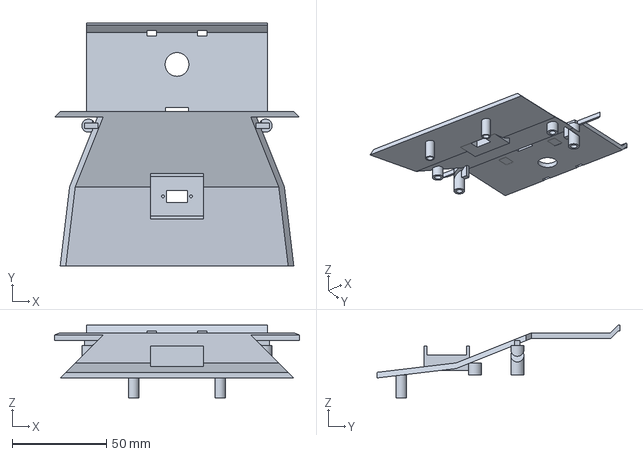
[picture p155: CAD file, 2026-10-26]
hardware/model/l298n-compact/LC04-KeelLid.step
130.0 x 129.0 x 38.5 mm
