miclle/cybertrack/hardware/model/l298n-compact/slicing/print-stls/KeelSideFrameL.stl

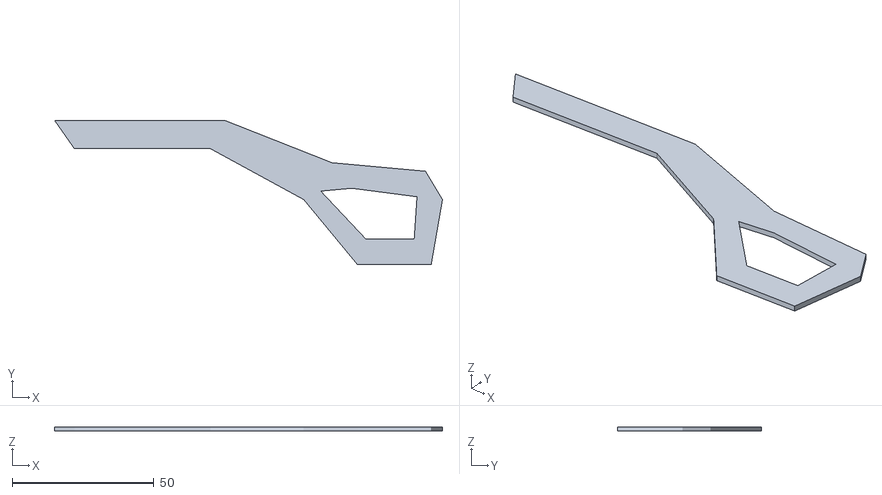
[picture p156: CAD file, 2026-10-26]
hardware/model/l298n-compact/slicing/print-stls/KeelSideFrameL.stl
137.0 x 51.0 x 1.50
