miclle/cybertrack/hardware/model/print-parts/PP05-Crown.step

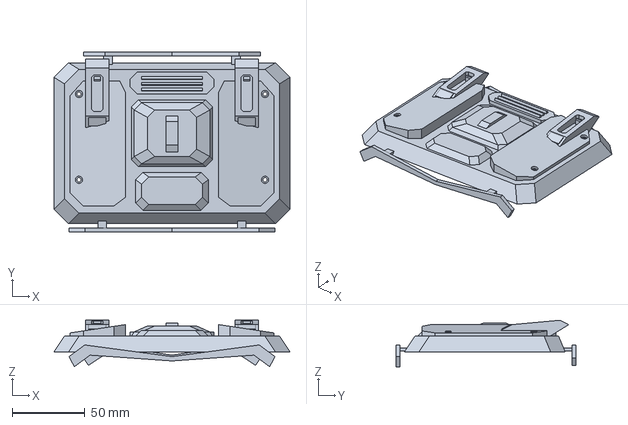
[picture p157: CAD file, 2026-10-26]
hardware/model/print-parts/PP05-Crown.step
162.3 x 124.0 x 32.0 mm
