miclle/cybertrack/hardware/model/print-ready/CyberTrack-Ready-4plates.3mf

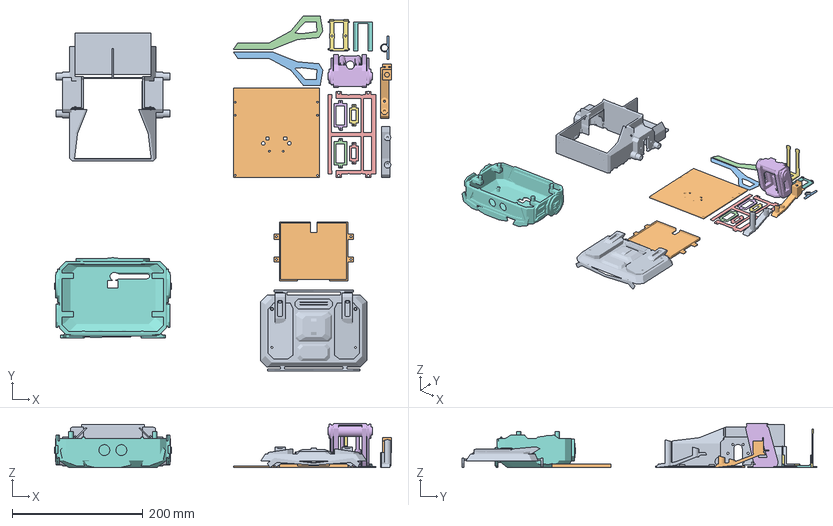
[picture p158: CAD file, 2026-10-26]
hardware/model/print-ready/CyberTrack-Ready-4plates.3mf
515.9 x 543.0 x 68.0 mm
PP04-LowerTub.stl
LC03-BottomServiceCover-flipped
KeelSideFrameL
KeelSideFrameR
BatteryHatch
PrintNeck
LC01-Carrier-upright
LC02-TopRetainer-flat
ShoulderRailL
ShoulderRailR
NeckCableBridge
EffectRetainerLMOS
EffectRetainerLBuck
EffectRetainerRMOS
EffectRetainerRBuck
PP07-upright.stl
PP07-Crown.stl
PP07-Tray.stl
