miclle/cybertrack/hardware/model/print-trials/gun-mounts-0.18/water-gun-rear-cap.stl

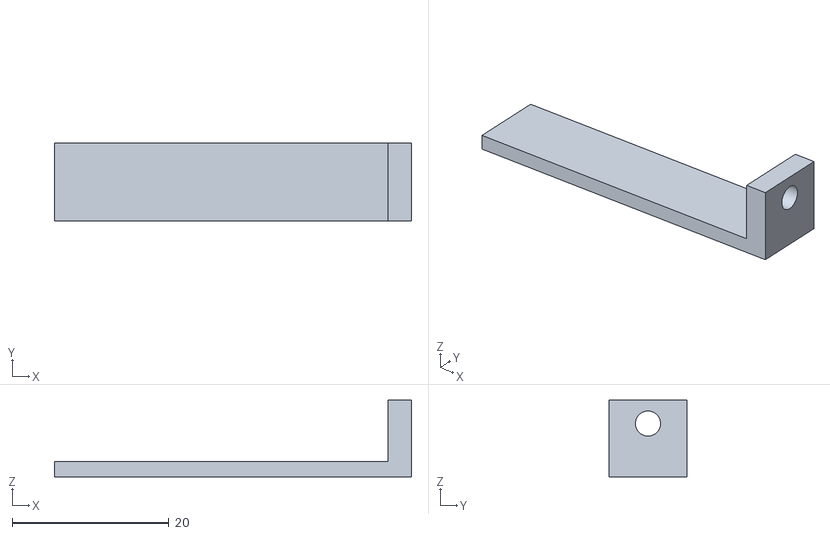
[picture p159: CAD file, 2026-10-24]
hardware/model/print-trials/gun-mounts-0.18/water-gun-rear-cap.stl
45.5 x 10.0 x 9.80
