miclle/cybertrack/hardware/model/remaining-print/PP01-base.step

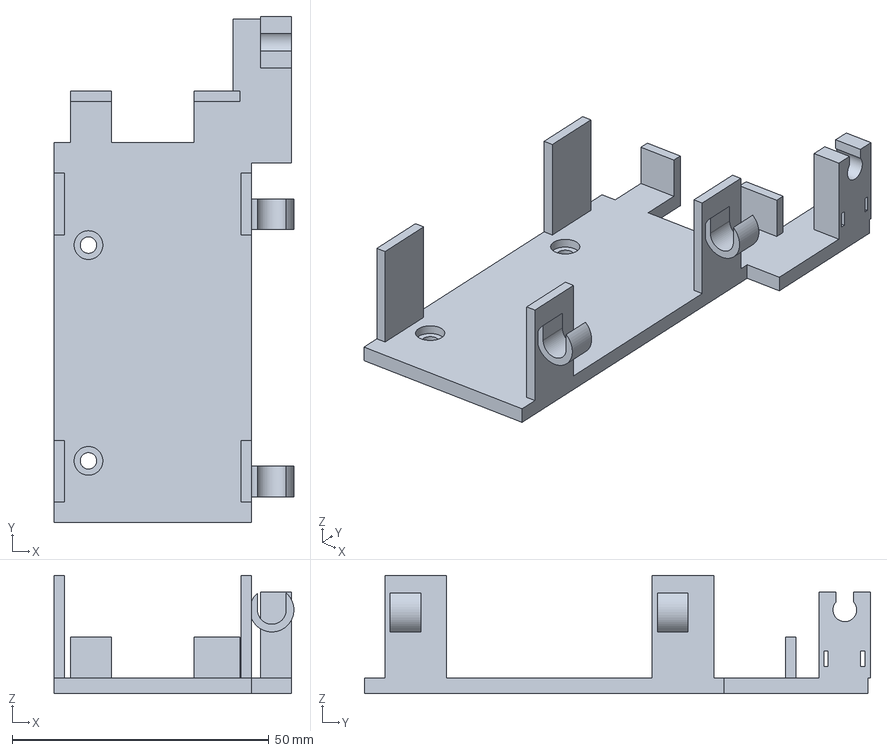
[picture p160: CAD file, 2026-10-26]
hardware/model/remaining-print/PP01-base.step
46.7 x 98.5 x 23.0 mm
