miclle/cybertrack/hardware/model/completion-print/LowerChin.step

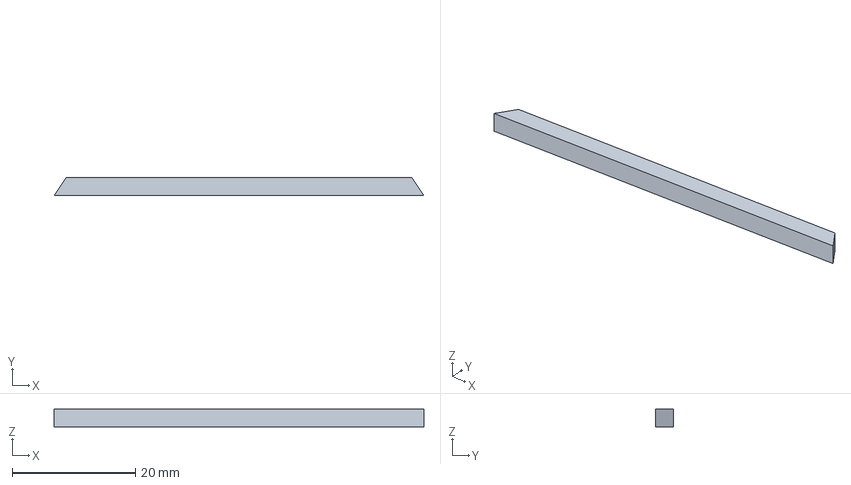
[picture p161: CAD file, 2026-10-26]
hardware/model/completion-print/LowerChin.step
60.0 x 3.00 x 2.85 mm
