miclle/cybertrack/hardware/model/l298n-compact/LC01-Carrier.step

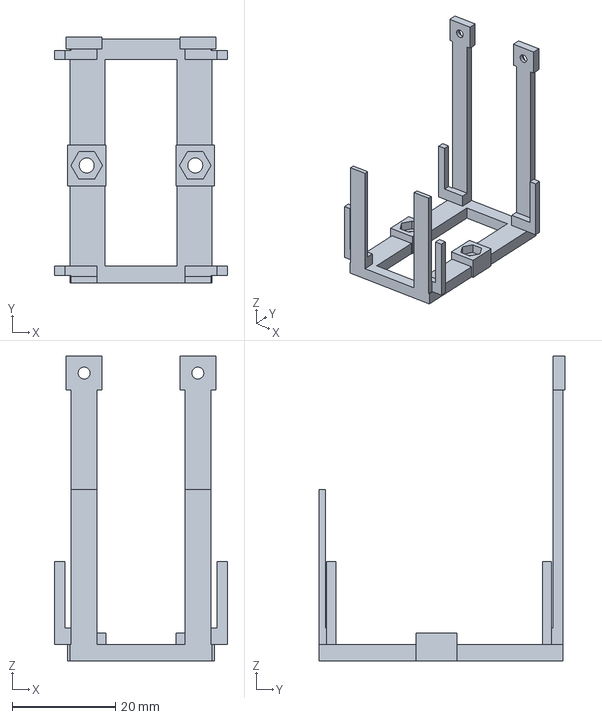
[picture p162: CAD file, 2026-10-26]
hardware/model/l298n-compact/LC01-Carrier.step
33.5 x 47.5 x 59.0 mm
