miclle/cybertrack/hardware/model/l298n-compact/slicing/print-stls/EffectRetainerLBuck.stl

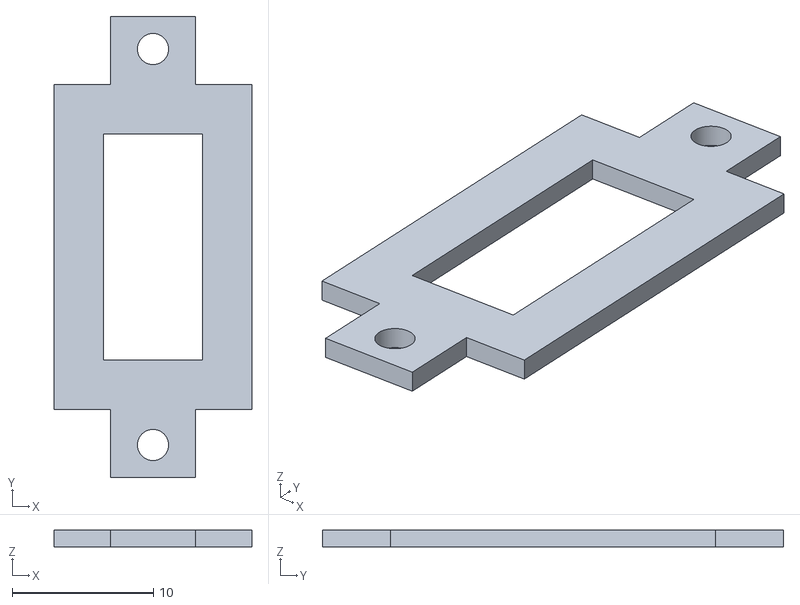
[picture p163: CAD file, 2026-10-26]
hardware/model/l298n-compact/slicing/print-stls/EffectRetainerLBuck.stl
14.0 x 32.6 x 1.20
