miclle/cybertrack/hardware/model/print-parts/PP07-HeadShell.FCStd

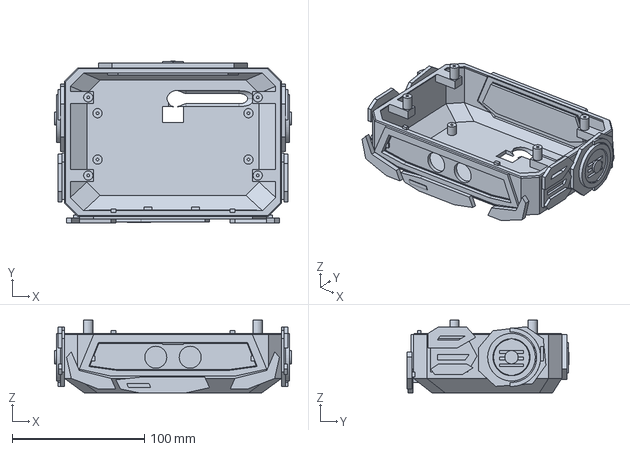
[picture p164: CAD file, 2026-10-26]
hardware/model/print-parts/PP07-HeadShell.FCStd
179.0 x 122.5 x 55.1 mm
