miclle/cybertrack/hardware/model/print-trials/gun-mounts-0.18/water-gun-bracket.stl

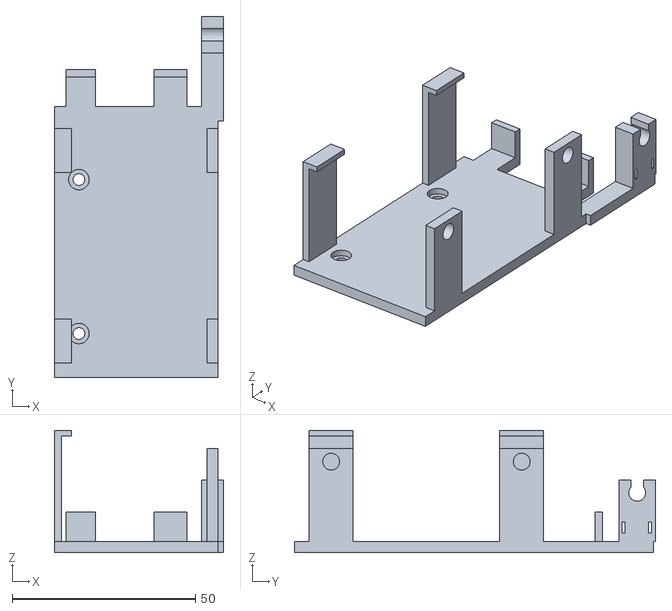
[picture p165: CAD file, 2026-10-24]
hardware/model/print-trials/gun-mounts-0.18/water-gun-bracket.stl
46.2 x 98.5 x 33.3
