miclle/cybertrack/hardware/model/remaining-print/PP03-base.step

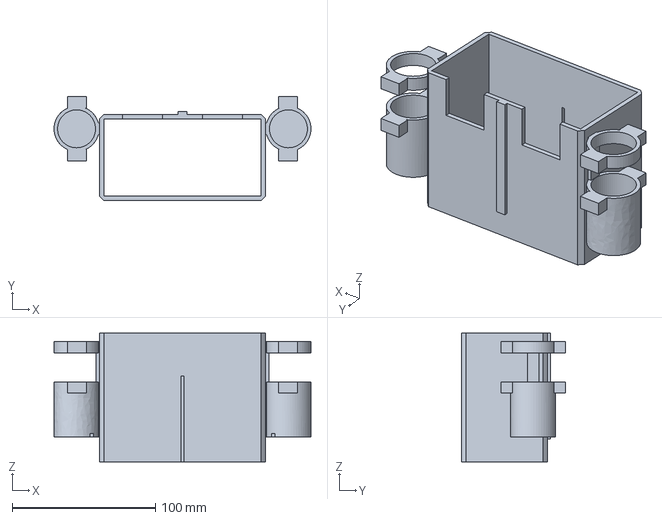
[picture p166: CAD file, 2026-10-26]
hardware/model/remaining-print/PP03-base.step
179.5 x 72.5 x 90.0 mm
