miclle/cybertrack/hardware/model/completion-print/IgnitionMOSCarrier.step

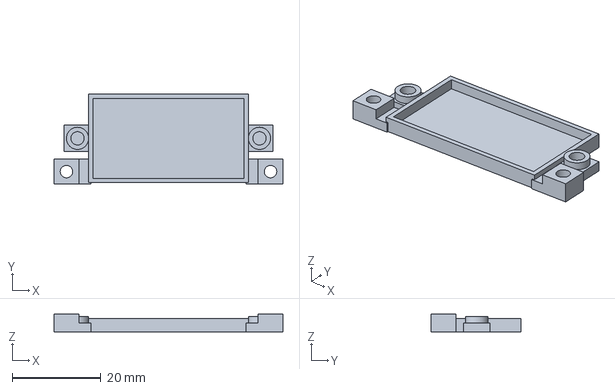
[picture p167: CAD file, 2026-10-26]
hardware/model/completion-print/IgnitionMOSCarrier.step
51.6 x 20.3 x 4.00 mm
