miclle/cybertrack/hardware/model/l298n-compact/LC02-TopRetainer.step

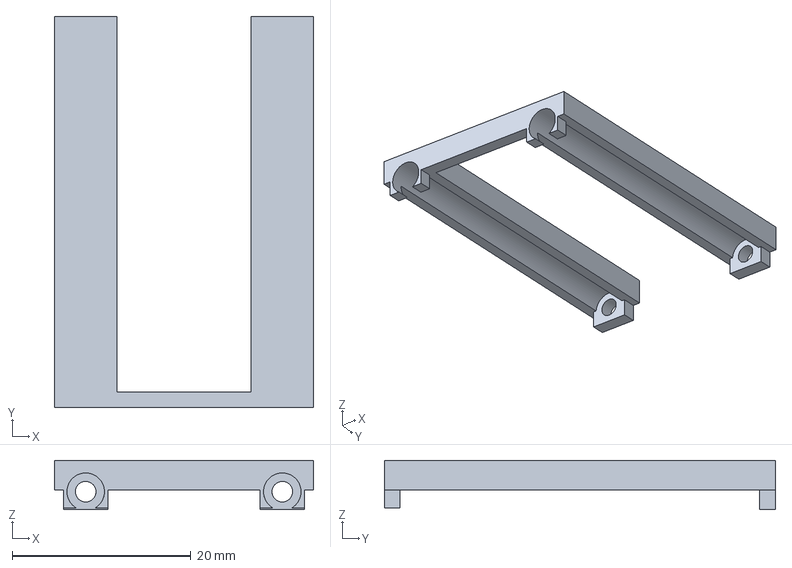
[picture p168: CAD file, 2026-10-26]
hardware/model/l298n-compact/LC02-TopRetainer.step
29.0 x 43.8 x 5.50 mm
