miclle/cybertrack/hardware/model/completion-print/BubblePod.step

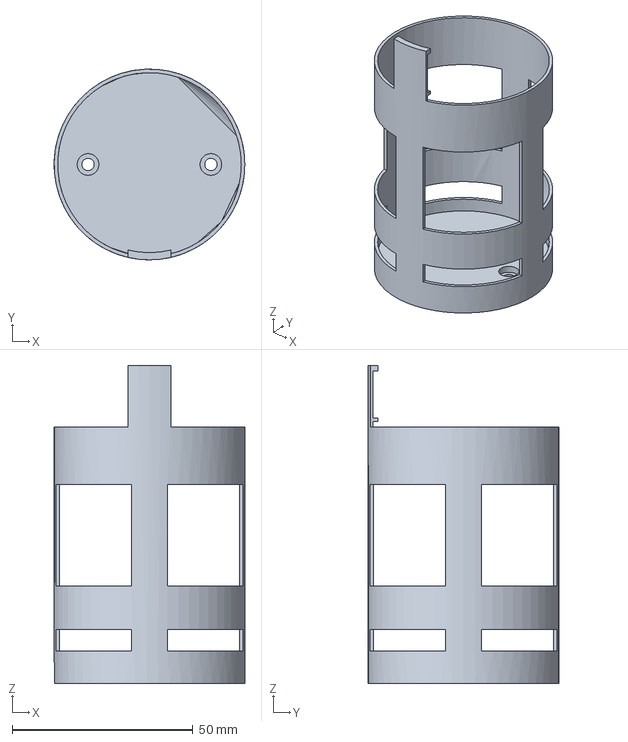
[picture p169: CAD file, 2026-10-26]
hardware/model/completion-print/BubblePod.step
52.8 x 52.8 x 88.0 mm
