miclle/cybertrack/hardware/model/l298n-compact/L298N-compact-review.FCStd

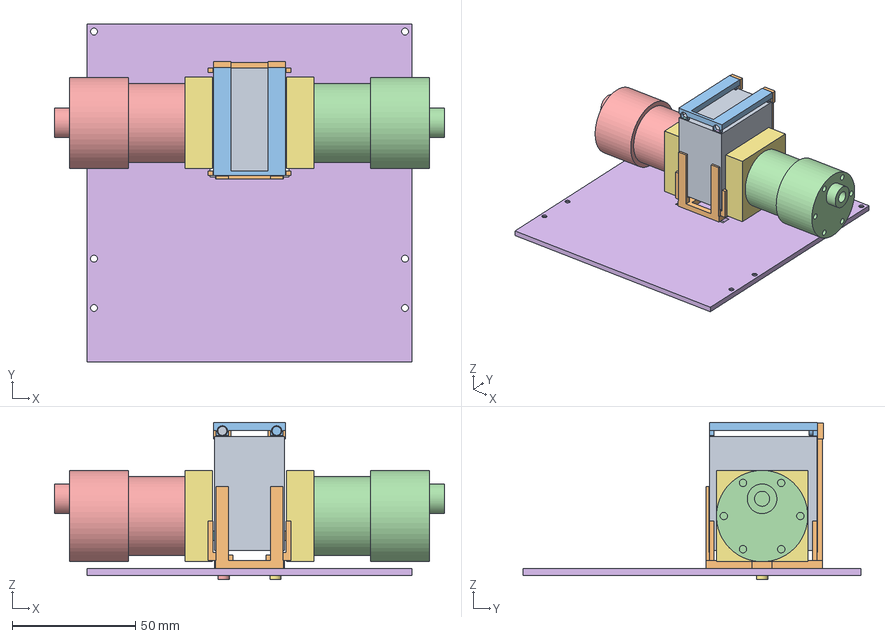
[picture p170: CAD file, 2026-10-26]
hardware/model/l298n-compact/L298N-compact-review.FCStd
158.0 x 136.8 x 63.8 mm
L298N · 插线包络46.2×43.5×28.5／转90°
L298N · 底盖承载托架／前后限位
L298N · 可拆上压框／两螺钉机外释放
L298N · 底部防转螺母 M2.5 · R
L298N · 底盖锁紧螺钉 M2.5×8 · R
L298N · 底部防转螺母 M2.5 · L
L298N · 底盖锁紧螺钉 M2.5×8 · L
L298N · 上压框薄螺母 M2×1.2 · R
L298N · 上压框螺钉 M2×4 · R
L298N · 上压框薄螺母 M2×1.2 · L
L298N · 上压框螺钉 M2×4 · L
L298N · 绝缘接触垫候选 · BottomPadRF
L298N · 绝缘接触垫候选 · BottomPadRB
L298N · 绝缘接触垫候选 · FrontPadR
L298N · 绝缘接触垫候选 · RearPadR
L298N · 绝缘接触垫候选 · TopPadRF
L298N · 绝缘接触垫候选 · TopPadRB
L298N · 绝缘接触垫候选 · BottomPadLF
L298N · 绝缘接触垫候选 · BottomPadLB
L298N · 绝缘接触垫候选 · FrontPadL
L298N · 绝缘接触垫候选 · RearPadL
L298N · 绝缘接触垫候选 · TopPadLF
L298N · 绝缘接触垫候选 · TopPadLB
L298N · 绝缘接触垫候选 · SidePadR1F
L298N · 绝缘接触垫候选 · SidePadR1B
L298N · 绝缘接触垫候选 · SidePad1F
L298N · 绝缘接触垫候选 · SidePad1B
左侧37R-520电机（尺寸占位）
右侧37R-520电机（尺寸占位）
一体底部检修盖／6颗螺钉
30 mm 尾部检查盒／Y-Z轮廓仍为假设
