miclle/cybertrack/hardware/model/l298n-compact/slicing/print-stls/BatteryHatch.stl

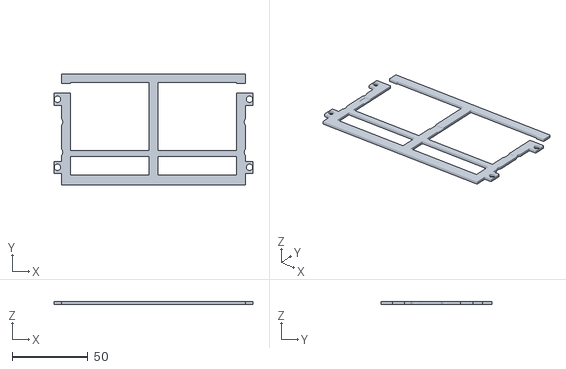
[picture p171: CAD file, 2026-10-26]
hardware/model/l298n-compact/slicing/print-stls/BatteryHatch.stl
131.6 x 73.6 x 1.80
