miclle/cybertrack/hardware/model/print-parts/PP02-BubbleCradle.step

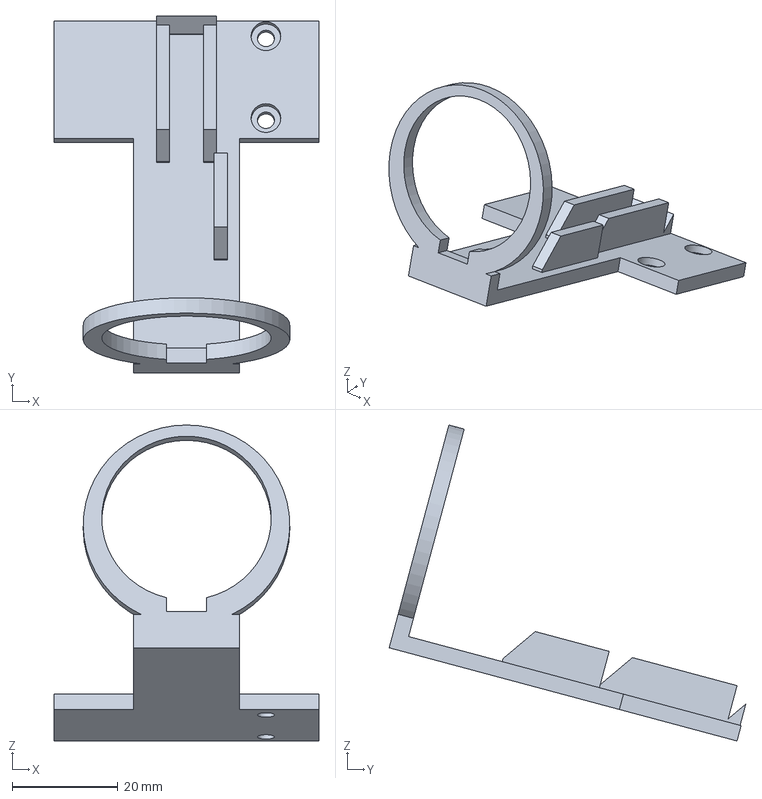
[picture p172: CAD file, 2026-10-26]
hardware/model/print-parts/PP02-BubbleCradle.step
50.0 x 67.3 x 59.7 mm
