miclle/cybertrack/hardware/model/completion-print/EffectTray.step

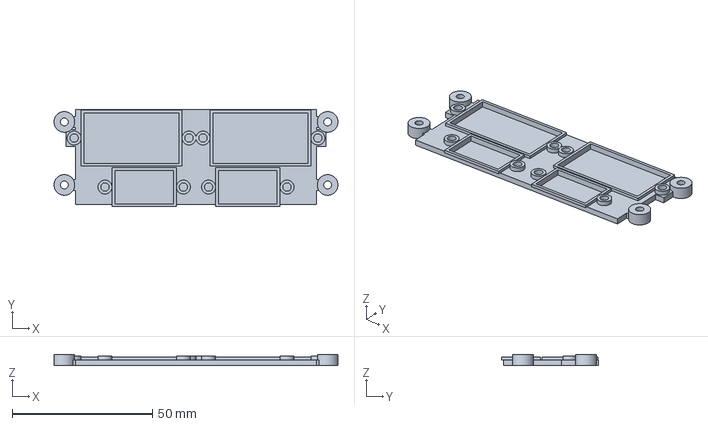
[picture p173: CAD file, 2026-10-26]
hardware/model/completion-print/EffectTray.step
101.4 x 34.8 x 4.00 mm
