miclle/cybertrack/hardware/model/l298n-compact/slicing/print-stls/NeckCableBridge.stl

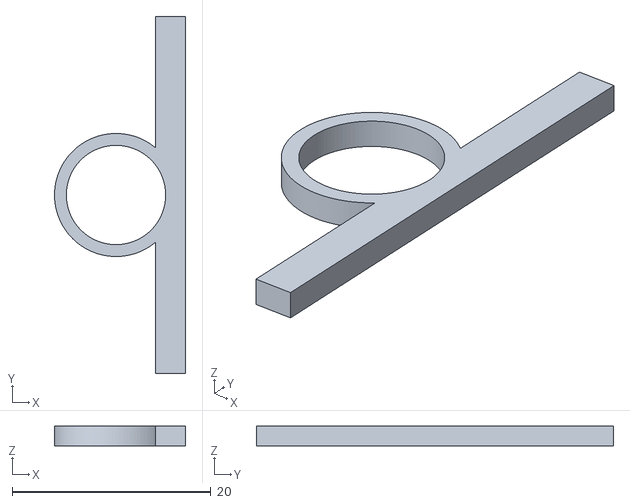
[picture p174: CAD file, 2026-10-26]
hardware/model/l298n-compact/slicing/print-stls/NeckCableBridge.stl
13.2 x 36.0 x 2.00
