miclle/cybertrack/hardware/model/print-parts/PP04-LowerTub.step

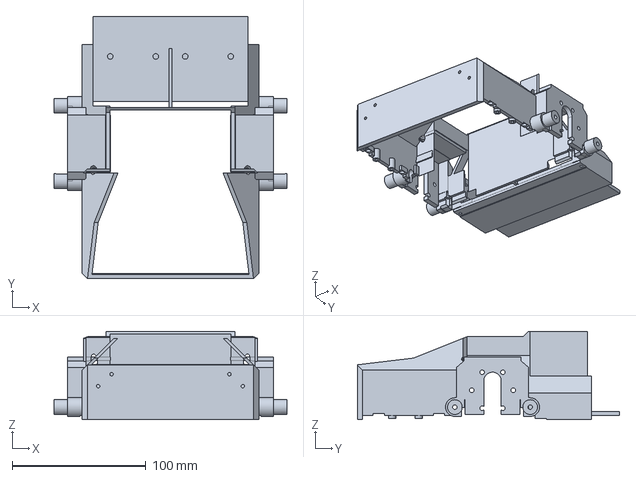
[picture p175: CAD file, 2026-10-26]
hardware/model/print-parts/PP04-LowerTub.step
174.0 x 196.0 x 66.0 mm
