miclle/cybertrack/hardware/model/completion-print/IgnitionMOSRetainer.stl

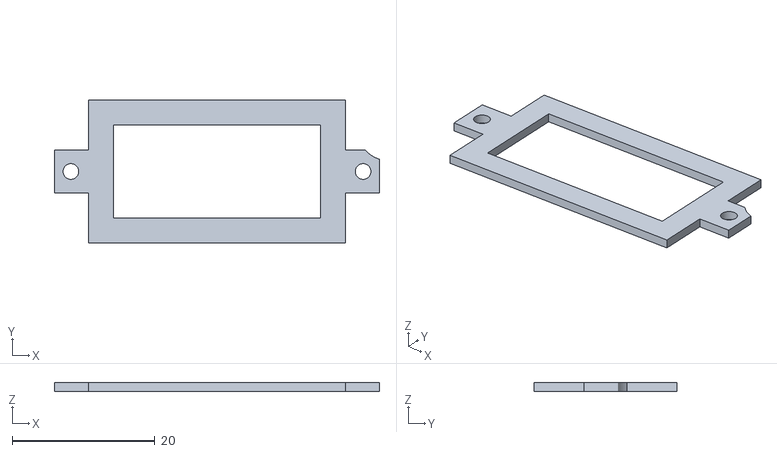
[picture p176: CAD file, 2026-10-26]
hardware/model/completion-print/IgnitionMOSRetainer.stl
45.6 x 20.0 x 1.20
