miclle/cybertrack/hardware/model/print-parts/PP01-WaterCradle.step

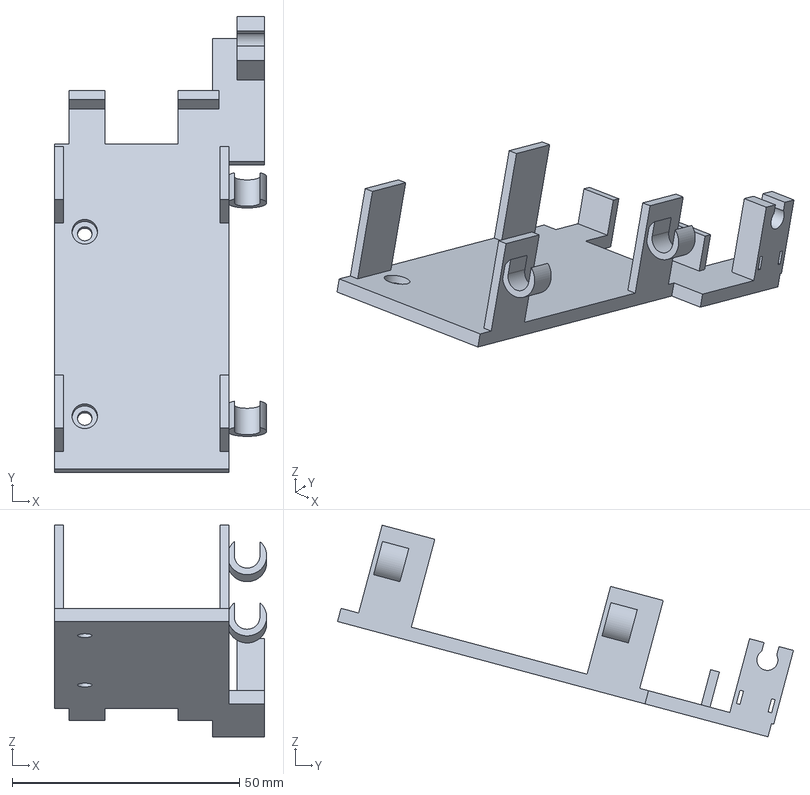
[picture p177: CAD file, 2026-10-25]
hardware/model/print-parts/PP01-WaterCradle.step
46.7 x 100.3 x 46.5 mm
