miclle/cybertrack/hardware/model/completion-print/ChestAudioPanel.stl

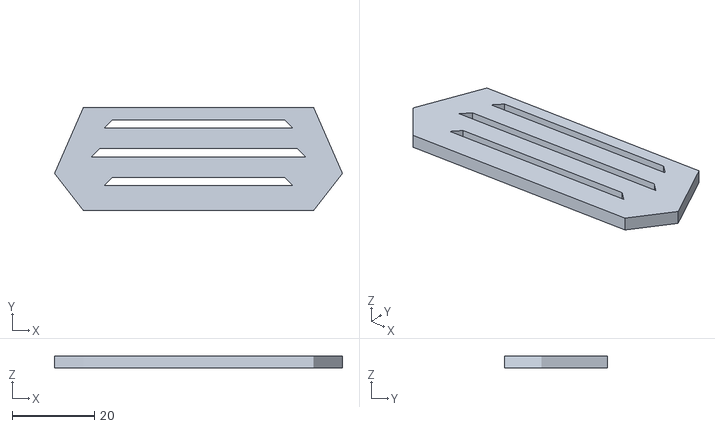
[picture p178: CAD file, 2026-10-26]
hardware/model/completion-print/ChestAudioPanel.stl
70.0 x 25.0 x 2.85
