miclle/cybertrack/hardware/model/completion-print/ChestBadge.step

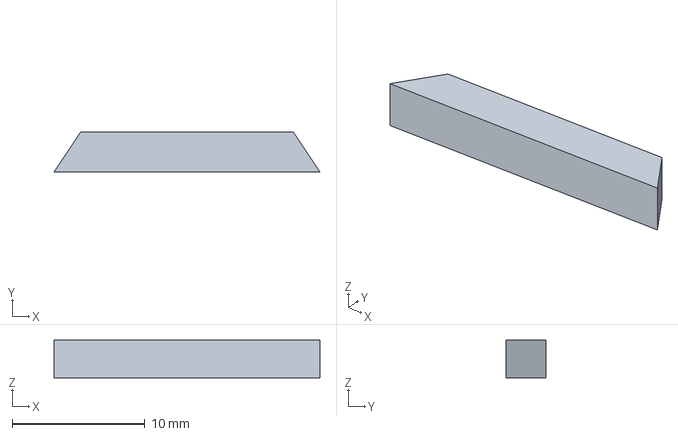
[picture p179: CAD file, 2026-10-26]
hardware/model/completion-print/ChestBadge.step
20.0 x 3.00 x 2.85 mm
