miclle/cybertrack/(list of files, cad)

Other CAD files:
hardware/model/container-garage/printed/slicing/B02-two-walls/B02-two-walls.3mf
hardware/model/container-garage/printed/slicing/B01/input.3mf
hardware/model/l298n-compact/slicing/print-stls/KeelSideFrameR.stl
hardware/model/print-parts/PP06-Neck.step
hardware/model/l298n-compact/slicing/print-stls/EffectRetainerRMOS.stl
hardware/model/print-parts/PP03-Backpack.step
hardware/model/completion-print/BubbleLidMark.step
hardware/model/completion-print/WaterPod.step
hardware/model/CyberTrack.FCStd
hardware/model/completion-print/BubblePod.stl
hardware/model/completion-print/IgnitionMOSCarrier.stl
hardware/model/completion-print/LowerChin.stl
hardware/model/completion-print/WaterPod.stl
hardware/model/l298n-compact/LC02-TopRetainer.stl
hardware/model/l298n-compact/LC04-KeelLid.stl
hardware/model/parts/L298N-carrier-0.34.FCStd
hardware/model/print-parts/Head-ScrewFitCoupon.stl
hardware/model/print-parts/PP01-WaterCradle.stl
hardware/model/print-parts/PP02-BubbleCradle.stl
hardware/model/print-parts/PP03-Backpack.stl
hardware/model/print-parts/PP04-LowerTub.stl
hardware/model/print-parts/PP05-Crown.stl
hardware/model/print-parts/PP06-Neck.stl
hardware/model/remaining-print/PP03-base.stl
hardware/model/studies/bubble-ring-slot/FrontRing-candidate.FCStd
