miclle/cybertrack/hardware/model/container-garage/printed/current-fit/README.md

# 当前整机与打印车库的 CAD 适配复核

2026-11-01：直接读取当前 [CyberTrack.FCStd](../../../CyberTrack.FCStd) 与既有 [11 件打印车库](../CyberTrack-garage-print-candidate.FCStd)，使用当前机器人几何重新检查空间。本次没有保存或修改两份 CAD，没有改变车库尺寸、停车位置、STL 或切片。

**本次 CAD 检查通过，实物适配仍未验收。** 车库文件内嵌的机器人仍是历史快照；本报告直接读取当前独立整机，不能把旧车库文件中的机器人视作已更新。历史报告与截图保留原适用版本。

## 输入与选择

| 输入 | SHA-256 |
|---|---|
| 当前整机 | `70e5c08a1e4dab9c48f8f4206f58be9370342f8f4a66495b8dccb4bb5cdd4c23` |
| 既有打印车库 | `3edadff198fff7e7f64426006c4d1055bf0496ddf373291884599634daee6517` |

FreeCAD 1.1.4 从磁盘读取 209 个当前整机几何对象，包含设备包络；不以是否可见筛选。排除容器、无形状对象、已并入打印件的重复源以及明确标为 `clearance` 的检修空间。每个选择与排除记录在 [inputs.json](inputs.json)，运行结束再次核对所有输入文件摘要未变。

车库旧快照为 229 件；当前少了 20 件已撤销的液瓶与软衬部件，没有新增名称。背包来自当前原生模型，其 X 包络为 −94…94 mm；不是从历史快照推定新版尺寸。检修空间不属于本次行驶包络，不能据此宣称在库内完成维护。

## 几何结果

沿用 X 向左、Y 向后、Z 向上，门在 −Y；停车平移保持 `(0, 155.123193, 12)` mm，未为取得通过结果调整位置。整机包络约为宽 228、深 245.25、高 228 mm。

| 检查项 | 结果 |
|---|---|
| 停车时左／右净余量 | 各 16.00 mm |
| 停车时前／后净余量 | 17.37／17.38 mm |
| 停车时前门框顶部净余量 | 18.00 mm |
| 横向额外偏移 ±5 mm 后的保守余量 | 11.00 mm |
| 既定直线俯仰范围的顶部保守余量 | 约 7.94 mm |
| 门板从关闭至约 92.340° 打开 | 94 个角度，无大于 0.01 mm³ 的体积交集 |
| 直线离库／沿同路径倒入 | 268 个姿态，Y 间距不超过 2 mm，无大于 0.01 mm³ 的体积交集 |
| 检查器反例 | 净宽缩为 220、净高缩为 220、净长缩为 240 mm 均检出干涉；等厚 8 mm 门板在末态检出接地穿透 |

详细交集、姿态及反例见 [spatial-validation.json](spatial-validation.json)。[宽相检查](cavity-broad-phase.json)先用真实箱体实体证明内部区域为空，再跳过完全处于该空腔内的包围盒；其余候选仍计算 OCCT 实体交集。不是仅比较两个外接盒就判定通过。

路径姿态使用下部履带三角网格与理想地面／坡道的刚性接触候选，保留 0.05 mm 接触抬升。顶部和横向解析界仅覆盖所述直线俯仰范围；铰链、地面与细部运动仍为离散检查，不是整个连续运动的无碰撞证明。

## 复现

需要完整仓库、两份原生模型和带 NumPy 的 FreeCAD Python 环境。macOS 已安装于下列位置时可执行本次使用的命令，输出目录须尚不存在：

```sh
PYTHONPATH=/Applications/FreeCAD.app/Contents/Resources/lib \
  /Applications/FreeCAD.app/Contents/Resources/bin/python \
  scripts/check_garage_current_fit.py --output output/garage-fit-new-run
```

[入口脚本](../../../../../scripts/check_garage_current_fit.py)复用既有车库运动检查，读取保存文件并输出独立报告，不依赖桌面文档或正在显示的姿态，不重建车库。模型或脚本更新后需新跑并核对新摘要，不能沿用本次数字。

未覆盖实际五金、打印误差、液体与软管运动、挠曲、承载、摩擦、履带变形、转向和重心稳定性。整机质量、实物试配及坡道进出仍未测；`manufacturing_released` 和 `physical_fit_verified` 均保持 `false`。没有因此授权打印或通电测试。
