miclle/cybertrack/docs/print-consolidation.md

# 合并打印件演进与当前入口

**现行交付：** [29 件 Lean 六盘项目](../hardware/model/lean-print/README.md)。已有[样机实拍与运行视频](../artifact/README.md)，当前处于联调与整机验证阶段。0.51 为六组合并历史基线，0.58 为头部局部修订；PP 编号数量不等于全机打印件数。下列历史合并、导出和检查记录保留原范围，实物验收项不变。

## 0.58：新增 PP07 头部下壳整体打印

头壳与固定装饰 34 个特征经 14 处背侧连接合为一个大件。传感器面板也合并，冠盖和面包板托盘独立；PP05 冠盖内侧配套新增短螺丝接收柱让位，旧 PP05 不直接用于新 PP07。当前共 7 个 PP 编号，原六件报告及图册保留历史状态。朝向、文件、螺丝与检查见[头部打印说明](head-shell-print.md)。底盘不改。

## 2026-10-26：剩余四件打印修正

后续用户授权为打印修复模型：PP02 增加同心 Ø32.8 下缘避让，与原 Ø32 偏心孔形成复合孔口，枪壳静态间隙 0.65 mm；缺口底面和安装孔位不动。LC04 增加两根 3 mm 内向连接筋，将三实体顶盖并为一体。PP01、PP03 几何不改。四件已完成方向、支撑及路径检查，当时共用第 5 盘，现已分入 Lean 第 3、6 盘；见[修正记录](../hardware/model/remaining-print/README.md)。以下 PP02 原始调整及冲突记录保留为历史，不再代表当前静态配合状态。

## 2026-10-26：PP02 原始局部调整

本节是 PP02 此前的几何要求，替代下文 0.51 对该件的八特征划分和原配合检查。删除截图选中的近侧前长槽壁 `BubbleGunSlotWall1` 与前横挡块 `BubbleGunSlotWall6`，保留对侧槽壁及其余四段槽壁／后止挡。PP02 现为六个源特征融合，六件打印候选合计 56 个源特征。

- 外环保持 Ø39 mm、轴向厚 3 mm，外环顶部及安装位置不变。
- 内孔改为 Ø32 mm，孔心沿未倾斜底座的局部 +Z 上移 1.3 mm；开缺口前的内孔最低点从 Z93 升至 Z95.3 mm，累计抬高 2.3 mm。
- 圆环底部支脚从 10 加宽至 20 mm，与底板前伸段同宽、居中；高度和轴向厚度保持。
- 内孔底部中央开宽 7.5 mm、深 2.3 mm 的矩形缺口，贯穿 3 mm 厚度。深度从圆孔最低点向下量，缺口底为局部 Z93 mm。整件继续沿用原 15° 装配倾角。

源档、主模型、PP02 STL／STEP 与预览同步更新，检查见 [PP02 调整报告](../hardware/model/pp02-adjustment-audit.json)。**几何与导出检查不等于装配通过：缺口两侧仍与原泡泡枪示意外壳相交，枪体位置未改；原穿环拆装结论不沿用。** 后续需单独处理实际枪体轮廓、安装偏置或孔形，并重新验证装拆。既有整机专项报告保留原文件哈希作为历史证据，不自动视为此次修改后的整机验收。

局部更新入口为 `scripts/update_pp02.py --render`（FreeCAD Python 环境）。常规整机生成的静态／维护检查仍保留；不能为通过本次指定孔形而忽略枪体碰撞。

## 0.51 合并基线

以下至补齐记录之前均描述 0.51 阶段，包括源特征数量、初次导出朝向和检查结果；后续头壳、分件与板卡固定变更以本页顶部专项为准。

0.53新增[电源开关安装](power-switch.md)，只改变六件合并范围之外的折面顶盖；PP01–PP06几何及58个源特征划分保持。

2026-10-26，按用户减少细碎打印零件的要求，先落实六组整合。原生 [CyberTrack.FCStd](../hardware/model/CyberTrack.FCStd) 是日常查看与打印几何依据；[检查报告](../hardware/model/print-consolidation-audit.json)记录连接、融合、STL与保存回读，尺寸与材料仍为候选。

## 打印划分

| 编号 | 合并后的打印件 | 来源设计特征数 | 保留的拆装边界 |
|---|---|---:|---|
| PP01 | 水枪底托、左右挡板、尾线导向与前后托管槽 | 3 | 与肩梁仍用原两颗基座螺钉连接；软胶和枪体独立 |
| PP02 | 泡泡枪底座、整体前环及六段槽壁 | 8 | 与肩梁仍可拆；枪体和软垫独立 |
| PP03 | 双瓶背包壳、点火桶座、下后护甲及后脊条 | 3 | 两只瓶底托、软垫、绑带和设备独立；顶部取瓶／取模块 |
| PP04 | 底盘、后湿舱隔板及中央湿舱分隔 | 3 | 一体底盖、电源内托架、外顶盖及电子托架仍独立 |
| PP05 | 冠盖、前后上护甲、脊翼、顶甲及随盖饰条 | 22 | 四颗冠盖螺钉；整体向上取盖，不与头部下壳合并 |
| PP06 | 基座、双侧颈架／加强板、连接柱、横梁／端盖、斜撑／套筒及头部鞍座 | 19 | 保留头部与底座连接边界、中央走线通道及独立限位桥；连接工艺仍待细化 |

合计 **58个设计特征归并为6个单实体打印候选**。58不是已定版的独立打印件数量，也不代表节省52颗紧固件；原本部分特征已计划一体制造。六件是本轮合并范围，不是全机打印BOM。

用户补充约束：合并时尽量保留当前造型，至少大体外观不明显变化。装甲台阶、凹槽、脊翼、轮廓与主要比例保持；连接材料优先放在背侧或内部配合间隙。检查同时比较修改前后外包络和新增材料位置。

## 必要的连接处理

- 冠盖：前侧X±48、后侧X±44 mm各布置两条连接筋，宽6、高2，Z207…209 mm。前筋跨Y−85.5…−80、后筋跨Y27…33.5，实际新增材料扣除原有冠盖饰件。将原先分离的前眉甲组、后上护甲组连接到冠盖；外部整体包络与盖缝保持。
- 固定颈架：横梁半径由7.5增至8 mm，长度64 mm及原轴线保持，填平与现有套孔的0.5 mm径向间隙。横梁与主架连接成一件；左右外层板的Ø18孔顶原与上缘相切，另在孔内侧Y−14…−8、Z157.6…158各补0.4 mm薄桥，消除两条非流形网格边且不改变外轮廓。这里没有可动关节，不能再按可转轴套装配。

- 底盘隔板：湿舱内侧Y25…25.4、Z37…37.8 mm，在X−37.5…−9.3与9.3…37.5各补一条接缝连接，消除网格中的两条非流形边；不向驱动板所在的干舱侧增加材料。底盘原有两处封闭内腔保留。

双枪底托与背包三组合并保持原有材料外形。新增连接材料检查同时包含实体、设备包络和预留空间，原冠盖上取、电子托盘上取及枪体／底盘维护检查继续适用。单实体不等于层向强度或抗冲击通过。

## 使用模型和导出文件

- 按用户2026-10-26要求，主模型只保留“01 双履带与动力参考”分组，其他零件直接位于一级。六个PP打印件已保存为独立实体，原58个重复输入件及59个隐藏检查空间从主模型移除；20个设备、线管和接头占位继续保留并默认隐藏。
- 零件名称统一为“部位 · 零件 · 方位/序号”，原说明保留在描述栏；相邻组件集中排列，组件整体从高到低，履带组内先左后右。命名及排序随生成流程自动执行，见[模型列表规则](../hardware/model/README.md)及[排序回读](../hardware/model/part-order-audit.json)。
- 可编辑融合关系、全部源特征及59个检修／工具／避让空间保存在独立[设计源档](../hardware/model/source/CyberTrack-design.FCStd)，供再生成、专项检查和旧图卡追溯；不将源档中的输入件重复打印。[树结构检查](../hardware/model/model-tree-audit.json)验证主模型与源档中保留实体的几何、分色和显示状态不变。
- [print-parts](../hardware/model/print-parts/README.md)提供每件独立STL及STEP。STL仅平移到XY居中、最低点Z=0，保留整机轴向，尚未指定最优打印朝向；平移量与网格检查写入报告。
- FCStd融合件按源特征表面保留分色显示；STL不携带颜色，如需实物保留配色，应在切片或后处理阶段安排。
- 整机STEP对六组使用融合件替换源特征，不重复导出两套材料。STEP仍仅用于布局交换；以FCStd为几何依据。
- [合并打印图册](../hardware/model/print-parts/print-parts.pdf)用于识别本轮六个打印件。[历史整机装配与维护图册](../hardware/model/CyberTrack-assembly-and-service.pdf)记录 0.56 阶段模型，并同时列出6个合并件与56个源特征的归属；源特征图卡仅供识别，不意味着逐件打印。现行 PP02 修正以本页顶部专项为准，图册第6–7页仅记录修正前冲突。

历史六组合并生成入口为 `scripts/build_tank.py --render`，连接与合并实现位于 `scripts/print_consolidation.py`。合并及主模型树整理都是生成流程的一部分，不靠手工导出后修改STL。`scripts/model_tree.py`在几何检查完成后保留设计源档、清除主模型重复输入及隐藏检查空间并展平分组。整机生成成功后执行 `python3 scripts/build_print_parts_pdf.py`刷新六件图册；`audit_print_consolidation.py <修改前FCStd>`核对五对象变更范围。

## 保留与后续验证

本节记录 0.51 当时未合并内容；头壳已由后续 PP07 合并，前舱外观件由补齐方案处理，5 个板卡压框在 Lean 中取消。以下未完成的实物验证不因此关闭。

头部下壳的侧甲／后脑饰件、前舱饰板和左右镂空侧框尚未并入本轮六件：它们需要另行设计连接及比较支撑代价。头壳与冠盖、电子浅托盘、板卡压框、电源内托架、底盖和驱动托框继续分别拆装。软垫、绑带、软管、护套、金属紧固件及采购设备不合入刚性打印件。

打印前仍需按实际打印机与材料确认摆放、支撑可清除性、冠盖薄筋和固定颈架层向、底盘翘曲、孔与嵌件配合；打印后验证拆装、保持力和承载。此次不改变电气方案，不构成密封、绝缘、液体共存或实物验收。

网格回读按封闭、无非流形边及与CAD边界壳数量一致判定。PP04虽然是一个连续实体，但包含原有两处封闭内腔，因此STL有3个闭合边界分量；这不表示3个独立打印件。

独立STEP的PP03与PP05体积比较未过0.01 mm³阈值（分别约34.687与4.358 mm³）；它们只作布局交换，不作为精确制造源。六件STL均直接从原生实体网格化，回读封闭且无非流形边。

## 本轮检查结果

[相对0.50的范围核对](../hardware/model/print-consolidation-change-audit.json)确认412个源对象中407个几何保持，仅5个源特征增加上述连接材料、无材料删减；独立重建后的五件几何与保存结果双向体积差均低于阈值，六组外包络变化均为0。整机基础静态与专项检查通过；接缝修正后回归维护路径、动力与L298N托框，颈架孔顶补桥后回归维护路径及头部支承检查。六个融合件保存回读与STL闭合、非流形边及边界壳计数检查通过。

## 0.55：PP06穿线通道局部更新

PP06基座/鞍座随净径10通道调整，其STEP/STL及PP06.png同步；其余PP01–PP05保留当前几何，尤其不覆盖PP02既有孔形和配合冲突。详见[通道专项](cable-passage.md)。

### 2026-10-26 遗漏件补齐

前舱左右侧甲与对应嵌条分别合为 PrintChestGuardL/R，各为单实体；其余遗漏件独立打印，共新增 12 件一盘。EffectTray 与 IgnitionMOSCarrier 的相切连接已补实，STL 闭合/连通与切片路径检查完成。用户取消两个线束护口。当时形成 34 件六盘基线，当前制造入口为[29 件 Lean 六盘项目](../hardware/model/lean-print/README.md)，本轮[详单](../hardware/model/completion-print/README.md)取代上述前舱饰件尚未处理的历史状态。
