miclle/cybertrack/hardware/model/print-ready/completeness-audit.md

# 五盘项目完整性复核 · 2026-10-26

后续状态：本报告记录的遗漏已补齐或按用户要求取消，详见[当前六盘闭环清单](completion-inventory.json)与[补齐说明](../completion-print/README.md)。以下为补齐前审计记录。

原结论：**尚未齐套**。当前五盘包含 22 个打印件（另有 4 个局部工艺修改体，不计件数）。逐项核对主模型 269 个非空几何对象、合并件 SourceFeatures 和 3MF 实际零件清单，发现下列未纳入项目的内容。

| 分类 | 未纳入内容 | 数量 | 处理状态 |
|---|---|---:|---|
| 装配结构件 | WaterPod 清水瓶底托、BubblePod 泡泡液瓶底托 | 2 | 独立于 PP03 背包，不在 PP01/PP02 枪座内；需导出及切片检查 |
| 装配结构件 | EffectTray 效果板承板 | 1 | 四个压框已在第 2 盘，但对应承板遗漏 |
| 装配结构件 | IgnitionMOSCarrier 点火 MOS 独立托架、IgnitionMOSRetainer 压框 | 2 | 低压控制板安装件，需导出及切片检查 |
| 外观件 | ChestAudioPanel、ChestGuardL/R、ChestAccentL/R、LowerChin、ChestBadge | 7 | 不在 PP04、PP07 或 LC04 合并范围；连接与制造方案未完成，不能仅导出就称可打印 |
| 外观标识 | WaterLidMark、BubbleLidMark | 2 | 独立的 0.6 mm 厚识别条；可单独制作或采用贴标，尚未确定 |
| 独立软护口 | BaseCableGrommet、HeadCableGrommet | 2 | 头壳打印说明明确排除软护口；需另备或确定柔性打印材料，不能默认为 PLA |

上述 5 个装配结构件在当前 FCStd 均为有效单实体；本次只核对清单，没有进行它们的打印朝向、支撑、薄壁、固定配合或切片验证，因此不标记为已可打印。9 个外观特征也均独立存在，不把它们误算为已合并。

成品履带、电机、瓶、电子板及开关等不打印。StopControl 是成品停止按钮按帽的候选外形，不是新增打印按钮。螺钉、螺母、嵌件、垫圈另备；软胶垫、板边垫、衬垫、绑带及魔术贴另备或按材料单独制作。线束与检修空间、前舱效果线及护套外观示意不作为已完成的制造件。已打印的 VF01 验证框架及可选导孔试件不重复计入整机装配清单。

主模型和当前五盘 3MF 本次未改；已有五盘无需因本次清单遗漏重打。建议优先补齐 5 个装配结构件，再处理外观及软护口。数量是当前模型范围，不代表尚未设计的固定接口已经完成。

证据：[逐对象分类](completeness-audit.json)、[原生模型与五盘清单](inventory-native.json)。原生模型有效性仅代表 CAD 检查，不代表实物或制造验收。
