miclle/cybertrack/hardware/model/container-garage/printed/slicing/B02-two-walls/preview.png

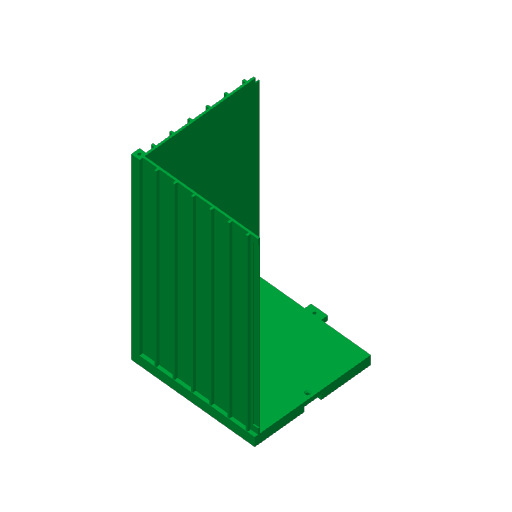
hardware/model/container-garage/printed/slicing/B02-two-walls/preview.png
