miclle/cybertrack/hardware/model/l298n-compact/installed.png

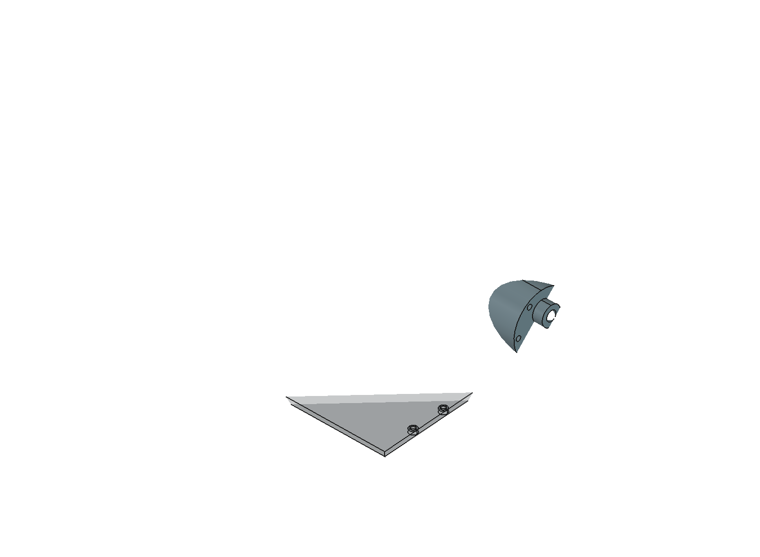
hardware/model/l298n-compact/installed.png
