miclle/cybertrack/hardware/model/lean-print/plate-2-preview.png

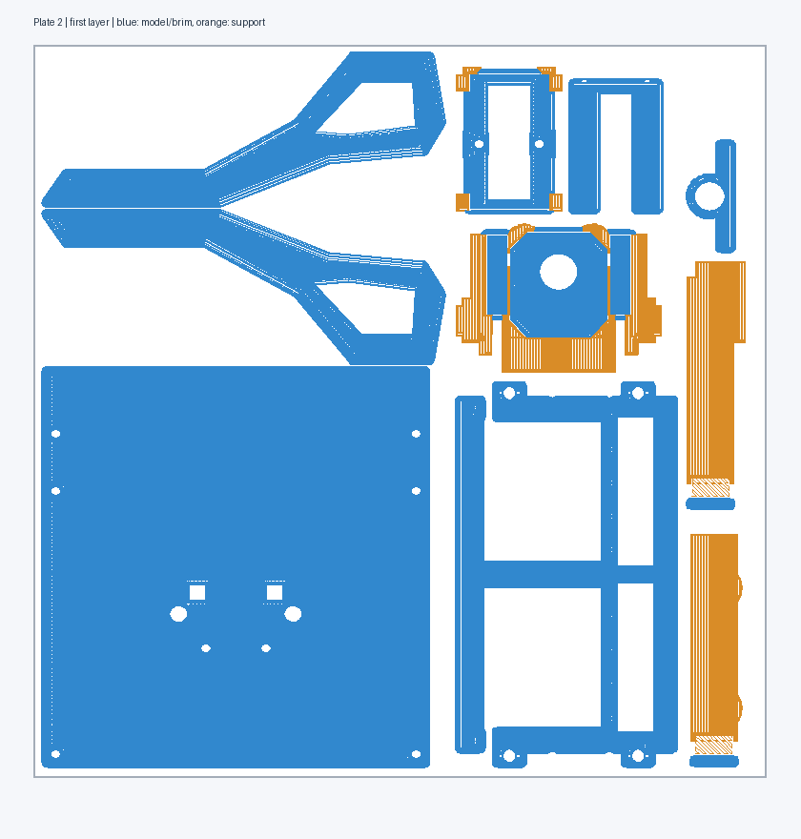
hardware/model/lean-print/plate-2-preview.png
