miclle/cybertrack/hardware/model/lean-print/plate-3-preview.png

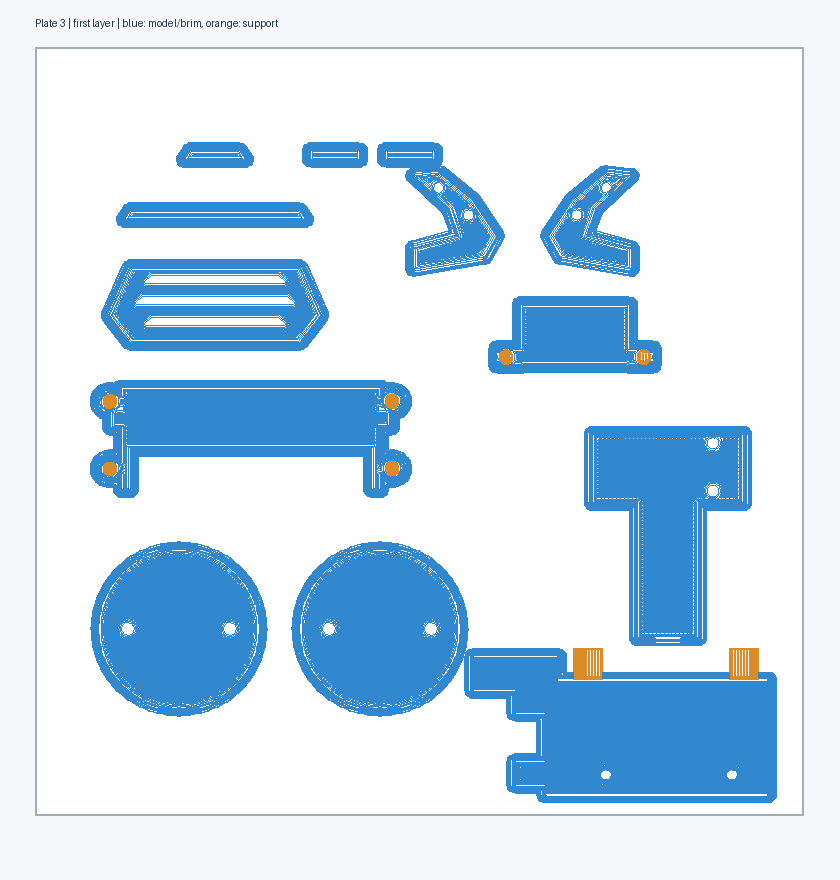
hardware/model/lean-print/plate-3-preview.png
