miclle/cybertrack/hardware/model/print-parts/Head-assembled.png

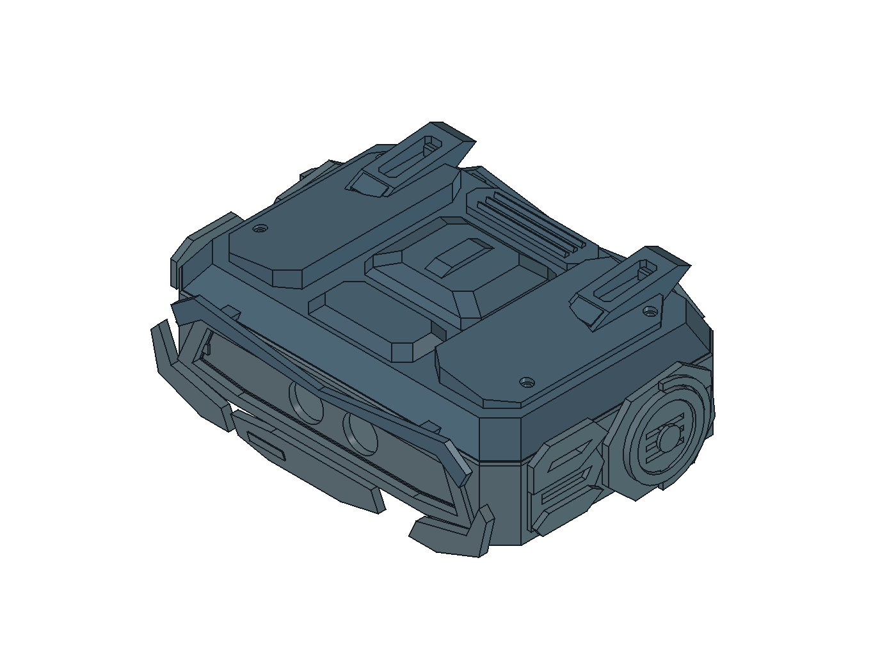
hardware/model/print-parts/Head-assembled.png
