miclle/cybertrack/hardware/model/print-ready/four-plates-first-layers.png

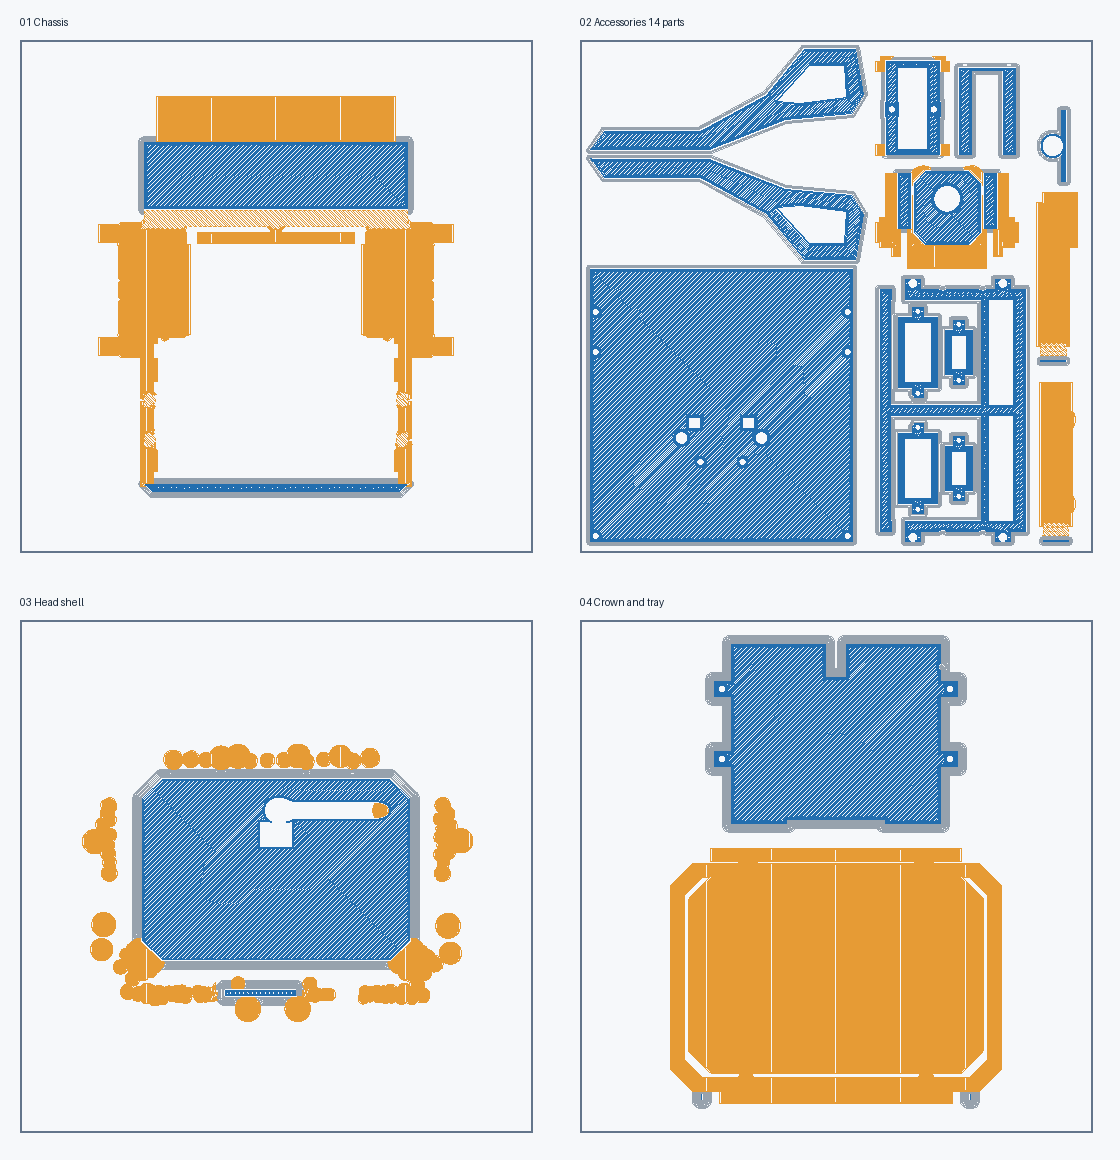
hardware/model/print-ready/four-plates-first-layers.png
