miclle/cybertrack/hardware/model/rear-assembly.png

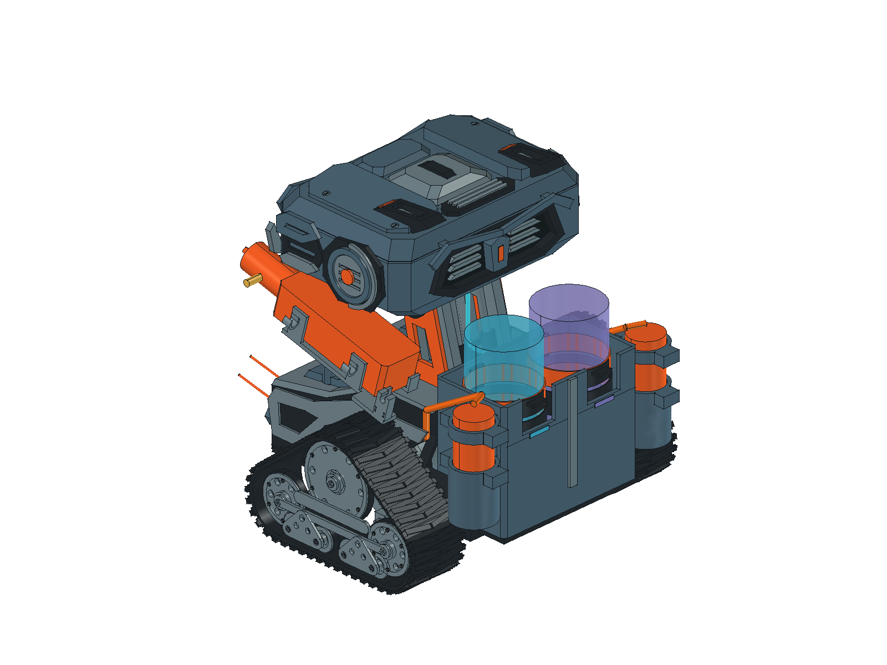
hardware/model/rear-assembly.png
