miclle/cybertrack/docs/audio-water-validation.md

# 面包板受限喷水接入

历史起点：2026-10-24。保留“小D”语音／屏幕及原智能体绑定，接入定时水枪输出与本地提前停止；ct4 为固定 5000 ms，后续 ct5 按用户指令时长执行、上限 30000 ms。本轮不开放行走、泡泡或通用 GPIO。

## 当前状态与剩余验证

核对日期：2026-10-27。当前面包板已部署 `2.0.3-ct21`，水枪仍用 GPIO18；电机 GPIO8–13、泡泡 GPIO17、共用点火低压 GPIO21 已加入同板控制。ct3 本地一次性授权、ct4 固定五秒和 ct5 初版缺时长询问均属历史，不能套作当前操作规则。

当前普通喷水参数为 `duration_ms`，范围 1–30000 整数毫秒；明确动作未说时长时由角色显式传 1000，固件不猜时长。喷水结束后间隔 200 ms；同路忙碌不续时，不自动重试。网页长按与语音定时分别受固件规则约束，BOOT 和统一停止关闭全部动作、松开不恢复；语音会话关闭只停止语音来源动作，Wi-Fi 断开全部停止。当前成功静默及别名规则见[角色维护](agent-role.md)，完整接口见[固件能力](../firmware/CAPABILITIES.md#当前面包板-ct21-接口)和[网页控制](lan-control.md)。

| 已完成分项 | 证据边界 |
|---|---|
| ct3 功率断开的授权／过期与控制电平观察 | ct3 带载未喷水的失败记录保留；不能用后续修正改写当次结果 |
| ct4 直接语音、控制线纠正后的喷水／到期停止、BOOT 提前停止与松开不恢复 | IO18 与控制 GND 接反已定位；日志输出时长不是实际水流时长或停止延迟 |
| ct5 的 1 秒、7 秒、超限为 30 秒调用 | 当时 MOS 功率断开，只支持语音转换与软件期限检查，不支持 30 秒连续喷水通过 |
| ct6／ct7 同板与并发 | [集成](breadboard-integration.md)及[并发](concurrent-actions.md)分项包括喷水、两种独立截止、BOOT 与语音停止；ct7 的 30 秒请求在软件约 12.7 秒时被停止 |
| 后续样机 | 已有基础装配、喷水台架和泡泡／行走[影像](../artifact/README.md)，ct21 四方向有用户反馈；不能从影像绑定完整版本或供电配置 |

当前供电基线为辰克 5 V 电池；水枪支路保持 **5 V→P01 MOS→枪体内 P12→3.7 V 水枪**。用户于 2026-10-26 确认两枪 P12 均已集成到枪体，完整端接、负载电压电流及温升待核。正确控制接法仍为 IO18→TRIG/PWM、主控 GND→控制 GND；MOS 输出侧负极不得额外接回系统地。现行[接线总表](wiring.md)和[电源方案](power-and-interfaces.md)优先于下方历史 USB 条件，旧电源观察不转移到辰克电池。

仍待验证：完整 30 秒连续带载、允许电压范围、启动／运行电流、瞬态／温升、P12 关断残余输出、滴液／倒流、重复性、精确停止、上电／复位／失电／欠压、真实断网与恢复、SW2 独立供能切断及最新角色的默认／别名／否定／静默回归。点火只完成低压固件，不能据喷水分项扩大高压验收。V04／V05、P2 及整机验收保持开放，见[验证计划](verification-plan.md)。

## ct3–ct5 历史记录说明

下文“本轮”“现改为”“下一步”“尚未”以及 USB／MOS 供电状态均指 2026-10-24 对应记录时刻。保留失败、纠线前后、参数变更与原始时间；后续完成项见各阶段收尾和文首，不将历史设备状态当作现场当前状态。本次仅同步文档，未重新接线、烧录、修改平台或触发动作。

## ct4 已完成结果

ct4 直接语音喷水、约五秒自动关闭、BOOT 提前停止与松开不恢复的本轮功能联调已完成；“小D”简短回复、音频与屏幕正常。接线问题已定位并纠正：IO18 应接 MOS TRIG/PWM，ESP32 GND 应接 MOS 控制 GND。软件测试、串口回执和用户现场观察分列如下，不扩展为完整电气或整机验收。最新用户反馈未明确 MOS 5 V 是否已拔断，因此结束功率状态不记为已确认断电。

## GPIO 与接线核对

**ct3／ct4 历史接线条件。** GPIO18 控制关系仍沿用，USB 与旧电源状态只属于当时测试；当前电源及新增通道见文首。

对应原镜像源码的 `bread-compact-wifi/config.h`：麦克风 4/5/6，扬声器 7/15/16，OLED 41/42，LED 48，触摸说话键 47，音量 40/39。GPIO18 原示例灯控在 ct2 已取消，现选作 MOS 输出；GPIO0 对应板载 BOOT。[乐鑫资料](https://docs.espressif.com/projects/esp-hardware-design-guidelines/en/latest/esp32s3/schematic-checklist.html)将 GPIO0/3/45/46 列为绑带引脚；GPIO18 不在其中。此芯片／源码核对不替代实物接线测量。

用户确认 MOS 功率供电断开、水枪尚未接入面包板、IO18 排针空闲，继续使用先前测试的 5 V→MOS→降压 3.7 V→水枪支路。该阶段控制接法（后续已纠正并验证）：IO18→TRIG/PWM，面包板 GND→MOS 控制 GND。负载电流不经过面包板；GPIO4 不可复用。按此前低侧开关拓扑，MOS 输出侧的降压板 GND／水枪负极不能额外接回输入负极或面包板 GND，否则可能绕过开关。具体操作顺序和证据沿用 [MOS 台架](mos-bench.md)。

| 面包板端 | MOS 端 | 本轮边界 |
|---|---|---|
| IO18 | TRIG/PWM | 只接控制信号，不接 VIN／VOUT |
| GND | 控制 GND | 不另接 MOS 输出侧 GND |
| USB | 原 USB 电源 | 不把外部 5 V／3.7 V 并入板上 3V3 |

功率保持断开完成改线／烧录／复位，主控确认关闭后才接功率。内部下拉不证明上电、复位或失电时实物关断；本轮保留手动切断 5 V 的手段。

## ct3 历史控制约束（已由 ct4 替代）

- GPIO18 专用控制任务，优先级 10，5 ms 轮询，tick 改为 1 ms；5000 ms 单调时钟截止不由云端或对话续期。活动输出期间该任务不做日志、显示、网络或堆分配。看门狗设置为 2 秒／panic，不作为独立硬件切断验收。
- BOOT 不再切换对话或重置 Wi-Fi；语音唤醒仍为“你好小智”，其他音量／说话按键及音频、OLED 引脚保持。
- 先唤醒建立会话，再长按 BOOT 至少 2 秒并松开；释放稳定 30 ms 后创建随机 128 位、30 秒有效的一次性授权。长按只授权，不触发输出。启动时一直按住 BOOT 不授权。
- 待用授权或喷水期间的 BOOT 按下立即撤销／停止；这次按下即使继续长按也不会重新授权。再次授权必须另一次完整的本地长按／松开。断线、停止、复位不恢复授权或输出。
- 用户明确口述喷水后，模型先查询状态取得本地 permit，再调用 `self.tank.water`。仅接受 permit 与整数 5000 ms；授权先消耗，重复／旧 permit 不启动、不续时。没有云端授权工具。平台可能保留短期已失效 permit，本机筛选日志不记录它。
- 复用原 `water_policy`；它是独立的受限台架通道，不宣称正式持久化动作链路或所有自然语言调用可靠性已验收。GPIO 输出回执不是水流反馈。

## ct3 验证记录

新增按键授权策略的 ASan／UBSan 检查通过，覆盖启动按住、单次授权、重复请求、5000 ms 截止、BOOT 取消与长按不重启、30 秒过期、云端停止打断按键、断线和时钟故障；原只读状态检查也通过。ESP-IDF v5.5.1 构建通过。真实接线、功率断开检查及带载语音结果在完成后追加，尚未认定通过。

`ct3` 应用 2,538,304 bytes，SHA-256 `e401e3a35e740b9183f5eda8c50cb0be4903c398f3985b0a80bc7620131ee2a3`。核对 MAC、原分区表及 ota_0 选择后仅写入 `0x20000`，烧录哈希通过；写入前后 `0x8000..0x1ffff` 的 98,304 bytes 完全一致。20:20:44 确认版本、OLED 和 GPIO18 LOW 工具启动，20:20:50 联网待机。小D角色规则已更新为本地授权→状态取 permit→用户明确要求后单次调用的流程，平台保存后重新加载核对通过，统一意图识别保留。此时功率仍断开，物理接线与电压等待现场反馈。

### 控制端接线与静态电压

按断电改线步骤后，用户报告 TRIG/PWM 对 MOS 控制 GND 为 0 V；MOS 5 V 仍按本轮要求保持断开。20:25:42 重新接入只读观察器后记录 ct3 启动，20:25:49 联网待机。下一项为无授权拒绝及单次本地授权的功率断开语音检查；尚未开始带载喷水。

### 功率断开的首次语音调用

20:26:59 用户口述喷水，状态回执显示 `local_permit_armed=false`、water=false、starts=0；平台未调用 water，提示需本地授权。20:27:44 记录 BOOT 本地授权 generation=1。20:27:52 状态返回 ARMED；20:27:54 平台调用 water、duration_ms=5000，一次性授权被消耗，starts=1。20:27:58.999 记录 `WATER_OFF reason=deadline software_on_ms=4996`，20:28:34 复查为 DISARMED、water=false、permit_used=true、授权未开启，starts 仍为 1。此软件输出区间略短于请求起算的 5000 ms，原因包括请求至控制任务置高的调度间隔；不是示波器脉宽测量。用户随后确认：未授权时拒绝，授权提示出现，输出电压升高再归零。该功率断开检查通过，尚不作为带载验收。

### 授权过期保护的真实观察

20:31:53 第二次本地授权 generation=2；用户先于 20:32:06 查询状态，模型只回答待命而未自动喷水。20:32:26 用户随后要求喷水时已超过 30 秒，工具返回 `permit_expired_or_revoked`，输出为 false，starts 仍为 1。没有因已取得旧 permit 而启动；平台如实说明未启动。随后明确提示下一次授权后直接口述喷水，不在中间先问状态；仍不自动重试。

### 带载自动停止候选记录

20:32:39 第三次本地授权 generation=3；20:32:46 状态确认 ARMED，20:32:48 一次 water 调用 accepted、starts=2。20:32:53 记录 `WATER_OFF reason=deadline software_on_ms=5000 outputs=OFF`。已提示不要重复该次自动停止测试；用户回复“没有喷水”，因此不能认定带载功能通过。需区分该反馈对应已过期请求还是随后 accepted 的请求，并核对 MOS 功率输入／指示灯；已要求断开 5 V、停止重复授权。软件输出回执不替代负载得电或喷水观察。

### 未喷水反馈确认

用户进一步确认：过期请求和之后 accepted 的请求均没有喷水，测试时 MOS 5 V 确实接回。MOS 指示灯、输入／输出电压尚未获得现场读数；不能把问题归因于授权过期，也不能认定功率支路正常。随后用户确认 MOS 5 V 已断开、面包板 USB 保持连接。

## ct4：直接语音与简洁角色

**历史版本。** 固定五秒后来由 ct5 可变时长替代；冷却及角色回复已继续演进，见文首。

用户要求取消逐次喷水授权，并让“小D”主要响应指令、简短报告状态。现改为明确语音指令直接调用 `water({"duration_ms":5000})`；BOOT 仅停止，释放不会自动恢复。保留五秒截止、1 秒冷却、按键稳定释放、断线关闭、重复 RPC 拒绝以及停止撤销排队请求；下一次新的明确指令可再次启动，不再声称停止后需要本地解锁。完整语义见音频适配 README。

ASan／UBSan 主机检查通过：直接启动、截止前后边界、忙碌／冷却拒绝、重复 RPC、BOOT 与云端停止取消排队、断线／新会话隔离、请求过期、表满关闭、时钟故障及启动不自激活。ESP-IDF 构建通过。主机检查不替代 GPIO 实测或带载验收。

角色介绍由 1873 字精简到 693 字，通常一句话报告结果；状态／停止／喷水均依据工具回执，失败不自动重试，不把输出开启说成实际水流。平台保存后重新打开核对一致，小D昵称、彩菊姐姐音色、deepseek-v4-flash 和统一意图识别保留。语音实际回复仍待新固件启动后核验。

ct4 应用 2,537,760 bytes，SHA-256 `858588cafecad29991dda00bf5fa2702679aba3fe2ef52fcd24baa52a94b35aa`。核对 MAC、分区表及 ota_0 选择后只写 `0x20000`；写入哈希校验通过，配置区 `0x8000..0x1ffff` 的 98,304 bytes 前后完全相同。20:47:24 观察到新版本、SSD1306 驱动及 `GPIO18=LOW BOOT=stop_only direct_voice=true max_ms=5000` 启动记录。MOS 5 V 在更新前由用户确认断开，未重新要求上电；下一步仅做功率断开的语音与电压核验。

### ct4 功率断开语音验证通过

20:48:59 状态工具返回输出关闭，`local_authorization_required=false`；20:49:11 单次 water 请求 accepted、starts=1，20:49:16 记录 `WATER_OFF reason=deadline software_on_ms=5000`；20:49:24 stop 返回成功、STOPPED、water=false，启动计数仍为 1。用户确认本轮没有要求授权，TRIG/PWM 对控制 GND 电压升高并约五秒后归零，回复简短且音频／屏幕正常。由设备回执与用户测量共同确认本轮功率断开检查通过；尚未进行 ct4 的 BOOT 实物提前停止或带载喷水，不据此认定此前功率支路问题已修复。

### ct4 功率断开 BOOT 提前停止通过

20:52:26 单次 water 请求 accepted，starts=2；20:52:28 记录 `WATER_OFF reason=BOOT software_on_ms=1820 outputs=OFF`，早于五秒期限。用户确认按下后电压提前归零，松开后保持 0 V。该结果验证本轮 BOOT 实物输入及控制电平关断；1820 ms 是启动至用户按键后软件关闭的区间，不是按键响应延迟。MOS 5 V 按本轮步骤保持断开，尚无 ct4 带载喷水结果。下一步测量 MOS VIN+／VIN− 实际输入供电，暂不再发喷水指令。

### MOS 输入电压核对

用户按静态输入检查步骤报告 MOS VIN+／VIN− 为 5 V。此读数确认测量时的输入电压，尚不是启动负载下的电压，也不证明 MOS 导通、降压输出或水枪供电正常。下一项为单次五秒指令期间测量 VOUT+／VOUT−，并观察指示灯及实际喷水；不改变接线或延长输出。

### 接线纠正后的现场反馈

用户报告“刚才是线接反了，测试是正常了”。记录为用户发现并纠正接线后功能恢复；尚未具体说明接反的端子，未补造 VOUT 电压或指示灯读数。20:57:30 至 20:59:07 设备收到四次新的 water 请求，各次到期关闭，软件输出区间依次为 5000、5001、5000、5000 ms；不将这一段写成只有一次请求，也不把软件轮询计时当成精密脉宽保证。ct4 带载 BOOT 提前停止及松开不恢复仍待单独验证。

平台记录核对：20:57:30、20:58:12、20:58:37、20:59:07 各次调用前均有新的“喷水5秒”语音，未见这四次由工具自动重试产生。纠正接线后的具体端子仍待用户说明。此后“再喷水”“接着喷水”也各自形成新的语音请求；这些记录不等于连续模式或原请求续时。平台对“一秒”请求回答固定五秒且未调用 water；没有因此擅自延长为五秒。只记录与验证有关的事件，不保存其他背景谈话。

### 接反端子已明确

用户明确说明原错误接法为 IO18→MOS GND、ESP32 GND→MOS TRIG/PWM；两根控制线对调。正确接法保持为 IO18→TRIG/PWM、ESP32 GND→MOS 控制 GND。结合用户前一条“测试正常”的反馈，将此前未喷水的问题记录为控制端接反、纠正后功能恢复；不再归因于授权策略。此前的电压变化反馈不证明当时极性和端子接线正确，VOUT 数值仍未提供。

截至本次查阅，日志最后一次 water 为 21:00:34，21:00:39 到期关闭；未见 20:52:28 功率断开 BOOT 测试之后的新 `reason=BOOT` 记录。最后一项带载 BOOT 结果与 MOS 5 V 当前断开状态仍待用户反馈，不把接线说明视为该项通过。

### ct4 带载 BOOT 提前停止通过

21:04:16 新会话内单次 water 请求 accepted，request_sequence=12、starts=10；21:04:17 记录 `WATER_OFF reason=BOOT software_on_ms=375 outputs=OFF`。用户明确确认“喷水时按 BOOT……会立即断开，断开后也保持断开”，对应现场停喷与松开不恢复。375 ms 是本次软件输出开启至按键关断的区间，不是按键至实际停水的响应延迟。

结合先前控制线纠正后“测试正常”的现场反馈、约五秒到期记录和本次带载 BOOT 结果，本轮受限喷水功能联调完成；无需重复喷水。MOS 输入静态 5 V 已测，MOS 输出／降压输出的带载数值、电流、精确时序、复位／失电、真实断网矩阵、重复性与整机电气验收仍未完成。用户本条未确认 5 V 物理断开，结束时提示拔断；不进行串口重连、复位或再次动作。

## ct5：按指令时长执行，单次最多 30 秒

**历史版本与现场记录。** 1–30000 ms 范围沿用；下文初版缺时长询问、1 秒冷却及成功确认话术不描述当前 ct21。

用户要求取消固定五秒，按指令秒数喷水，上限 30 s。新增工具范围 1–30000 整数毫秒，支持例如 1 秒、7 秒和半秒；未说明时长先询问，超过 30 秒由角色按 30 秒请求并说明。固件独立拒绝越界、非整数、缺失及额外参数，不通过多次调用拼接长时动作。BOOT、语音停止、断线关断、1 秒冷却、重复 RPC 及排队请求取消规则保留。状态回执新增 `last_duration_ms` 和 `remaining_ms`，按实际接受时长报告。

共用策略新增 `water_request_timed`，原水枪板 `water_request` 仍限定五秒。ASan／UBSan 检查通过：1、500、1000、7000、30000 ms 的截止前后边界，零／负数／30001／整数极值拒绝、活动中不续时、30 秒意图的 BOOT 与断线取消，以及原固定五秒策略回归。ESP-IDF 构建通过；应用 2,538,160 bytes，SHA-256 `3d7610e653f9cc7bcceddb43ba3cca414dfb87c361f8f55e3116593e9f1119f1`。

用户确认 MOS 5 V 已断开、面包板 USB 仍连接后开展更新。平台角色已保存并重新打开核对，昵称、音色、模型和统一意图识别保留。固件写入、功率断开的语音验证及 30 秒带载情况分别记录；ct4 的五秒带载结果不扩大为 ct5 的 30 秒带载验收。

ct5 写入记录：21:33:58 完成应用分区更新与哈希校验，写前／写后 `0x8000..0x1ffff` 的 98,304 bytes 完全一致。21:34:09 观察到 `2.0.3-ct5`、SSD1306 初始化及 `GPIO18=LOW BOOT=stop_only direct_voice=true max_ms=30000`。未覆盖引导、分区表、NVS、OTA 选择或 assets；功率仍按用户确认保持断开。

### ct5 功率断开的可变时长语音验证通过

| 用户指令 | 设备接受时长 | 到期关闭记录（软件） |
|---|---|---|
| 喷水一秒 | 1000 ms，21:35:17 接受 | 21:35:18，`reason=deadline software_on_ms=1000` |
| 喷水七秒 | 7000 ms，21:35:31 接受 | 21:35:38，`reason=deadline software_on_ms=7000` |
| 喷水四十秒 | 限为 30000 ms，21:36:01 接受 | 21:36:31，`reason=deadline software_on_ms=30000` |

三次请求均成功，各自只启动一次、到期关闭，累计 starts=3。用户确认一秒与七秒按指令执行，四十秒提示上限三十秒并自动停止，音频和屏幕正常，MOS 5 V 仍保持断开。本轮确认语音时长转换、上限说明和端侧软件期限；上述毫秒值是设备软件记录，不是示波器脉宽或实际水流时间。ct5 功率断开功能验证通过，30 秒带载未测试，不再触发输出。

### 小D 角色话术优化（平台配置）

**历史话术。** 2026-10-27 已改为动作成功静默；旧回复示例不作为当前要求或已验证行为。

用户要求去掉“已开启输出／已关闭输出”，让回答贴合项目角色。现将小D定位为机灵、友好、利落的 CyberTrack 机器人小助手：成功回执后使用“好，按X秒喷水”“收到，停止喷水”，无异常空闲状态用“待命中”，活动状态依据 remaining_ms 报告剩余计时。减少无关闲聊、背景接话和通用客服结尾，不虚构行走、泡泡或感知能力；30 秒上限、停止规则及真实回执要求保留。

本地 role-prompt.txt 与平台保存后重新打开的内容一致，昵称、音色、模型及统一意图识别保持。此次仅修改角色配置和说明，没有重新烧录、重启或发送动作。平台提示设备需重启加载新配置；新话术及背景谈话抑制尚未进行语音实测，不将提示词要求写成已验证行为。

### 未指定喷水时长默认一秒（角色配置）

用户要求减少来回询问：明确说“喷水”“喷一下”“再喷水”但未给时长时，角色直接请求 `duration_ms=1000`，不沿用上一轮时长；给出秒数时仍按指定值换算，单次上限 30000 ms。否定、状态查询、未听清或背景谈话不构成默认喷水授权。此规则替代 ct5 初版“缺少时长先询问”的角色约定。

只调整平台提示词与本地说明，不改固件参数校验：模型仍须显式传入 duration_ms。当前 ct5 工具描述中旧的询问建议由角色中的明确默认规则覆盖；没有省略参数或设备端猜测时长。默认一秒的端到端语音行为尚待重启加载后验证，未执行新喷水。
