miclle/cybertrack/docs/validation/ct78-deployment.md

# ct78 仅应用部署

2026-11-03 按用户“如果有最新的固件就烧录到 ESP32-S3 上”的授权，将此前 ct77 更新为 **2.0.3-ct78**。本次只烧录应用，未修改平台角色、未发送执行器启动命令；新角色的语音问题仍保留。[部署与启动记录](../../firmware/esp32-audio/startup-ct78.json)

## 写入与配置保持

- [预检](evidence/ct78-deployment/preflight.json)确认连接设备与历史部署一致，板内应用与 ct77 回退文件一致，分区表和 OTA 选择符合预期。新鲜的 128 KiB 配置备份与已核验的回退应用保存在本地忽略目录。
- 仅写入 `0x20000` 应用区，2,690,912 字节，SHA-256 `00c6204bdc1a3c04d171e04f0bbf0be83602769f57cca336272f19e0e270895c`。写后应用摘要通过，启动前配置逐字节一致，`0x410000` 以上非应用区摘要未变；没有覆盖引导、分区表、OTA 数据或 assets。
- 首启后[配置比较](evidence/ct78-deployment/nvs-review.json)确认 59 个逻辑配置项无新增／删除，Wi-Fi 和用户设置保持。唯一变化是运行时 `websocket/token`；非 NVS 区仍逐字节一致。没有全片备份，不将局部备份描述成全片恢复能力。

## 启动与无动作回读

两次启动均报告 ct78、OLED 初始化、控制输出初始化关闭、联网及 idle。READY 列表为 11 个工具，不再包含 compose。两次启动各十条[HTTP 状态回读](evidence/ct78-deployment/http-readback.json)均为零启动、逻辑输出全关、无活动序列；网页与当前源码逐字节一致，采集后释放网页会话。

以上只证明写入身份、启动和逻辑状态，没有测量实际电平、制动距离、声音或执行器效果，也没有更新物理验收结论。

## 角色与剩余问题

仓库 5999 字符角色仍待同步。平台最近一次记录为 2026-11-01 恢复的旧 5991 字符角色，本次未重新读取或保存平台配置，不把历史回读记为新观察。旧角色仍含已移除的编排语义，因此固件更新不等于固件／角色配套验收完成。

[语音回归](ct78-stop-duration.md)中的“快一点”漏调用、STT 丢失“先别执行”以及多余播报仍未解决。本次后续授权仅部署固件，没有把 33/35 的完整回归改记为通过。

[current.json](../../firmware/current.json)的最近应用记录已指向 ct78；`candidate_not_deployed` 与说明字段保留的是尚未同步和验收的固件／角色组合候选，不表示应用仍为 ct77。构建时的 [verification-ct78.json](../../firmware/esp32-audio/verification-ct78.json)保留原“未部署”历史状态。
