miclle/cybertrack/docs/validation/range-beep-confirmation.md

# ct77：普通测距滴声连续确认

2026-11-01 用户反馈测距偶发误判、滴声太吵，并选择“保留提示，连续多次近距才响，过滤偶发跳值”。随后用户明确授权刷入 ct77 试听，已完成仅应用部署，源码与最近记录部署均为 ct77；没有发送执行器动作。

普通提示须连续 3 个不同采样时刻的有效读数均小于 500 mm。约 100 ms 采样时，从第一个近距样本到确认约 200 ms；这是采样逻辑时间，不是实测扬声器延迟。5 ms 控制循环复用同一快照不重复计数。达到 500 mm、无效、未采样或过期时立即撤销提示资格，并取消尚在队列的普通事件；重新靠近须重新确认。相邻样本时间倒退或间隔超过 500 ms 也重新确认。

确认后沿用 400／800 ms 节拍，距离区间切换及重新确认不重置已有节拍，不补播错过的声音。对话期间继续暂缓普通滴声，语音播放队列与紧急停车告警沿用 ct74 路径。原始距离仍用于网页、语音查询和前进保护；不足 150 mm 的有效新鲜读数仍立即锁定／停止前进，至少 200 mm 解锁不续走，停车三连音不等待三个样本。角色源、工具参数、GPIO 和电源方案均未改。

## 软件验证

- [ASan／UBSan 主机回归](evidence/ct77-range-confirmation/host-tests.txt)通过：孤立及双样本跳值、同一快照重复读取、第三样本准入、400／500 mm 边界、远距／无效／过期后重新确认、采样间隔与时间倒退、无补播、各方向和开关状态；实际控制 tick 的网页／语音／序列停车、独立效果与不续走仍通过。
- [实际导出音频回归](evidence/ct77-range-confirmation/audio-tests.txt)通过：普通通知取消、对话闸门、语音数据保留、过期丢弃及停车告警优先。
- 完整 ESP-IDF 5.5.1 构建通过，导出工程中的过滤头文件与仓库逐字一致；应用大小、SHA-256 和源码摘要见 [ct77 构建记录](../../firmware/esp32-audio/verification-ct77.json)。

重跑主机与音频检查：

```sh
sh firmware/esp32-audio/test.sh
python3 firmware/esp32-audio/tests/run_audio_tests.py --source build/xiaozhi-ct77-src
python3 scripts/check_firmware_current.py --source-bin build/firmware-ct77/xiaozhi.bin --deployed-bin build/firmware-ct77/xiaozhi.bin
```

这次验证证明软件会过滤未连续三次出现的近距事件，没有复现或定位现场假回波原因；连续错误近距仍可能响。已刷写并完成启动回读，用户已确认偶发滴声明显减少、效果可以；这是本轮听感改善反馈，不证明完全消除误报或传感器准确。原 ct74 三项听感跳过决定继续保留，不因此记为通过。

## 仅应用部署与试听

2026-11-01 用户授权刷入 ct77 试听。设备身份和原 ct75 应用核对通过，私有目录保留新鲜配置备份与已核对回退应用；仅写入 `0x20000` 应用分区。写后应用摘要、启动前配置逐字节和非应用区域摘要均通过。两次启动读到 ct77、OLED 初始化、联网与 idle，二十条状态回读均为零启动、逻辑输出全关，采集后释放网页会话。首启后的配置差异与限制见[部署记录](../../firmware/esp32-audio/startup-ct77.json)及[NVS 核对](evidence/ct77-deployment/nvs-review.json)，角色源保持，沿用原平台回读时间，没有新平台保存或回读。

本轮没有动作测试；输出回读不等于物理电平测量。2026-11-01 用户试听后反馈：“听了一下，偶发滴滴声明显少了，效果可以，提交并推送。”本轮普通滴声改善已获接受；未量化误报率，也未补验原 ct74 跳过项目。构建记录保留构建当时的未部署状态，当前部署以 `firmware/current.json` 为准。
