miclle/cybertrack/docs/validation/ct74-deployment.md

# ct74 部署与听感验收

2026-11-01 用户明确确认切断电机、喷水、泡泡与点火支路功率，保留主控 USB 供电，同意仅更新 ct74 应用。实际供电状态为用户报告；本轮没有发送动作指令。

## 部署检查已通过

- [预检](evidence/ct74-deployment/preflight.json)确认同一设备、分区表及 OTA 选择；ct73 回退应用与芯片摘要一致。另存新鲜的 128 KiB 前应用配置区备份，未尝试全片备份；包含凭据的二进制仅保留于本地忽略目录。
- 仅写入 `ota_0` 的 `0x20000`，应用 2,721,328 字节、SHA-256 `28606ac3c771ca650faf4297d9353e86c05bd2efdc50e2b285df5817d8522cb5`。写后应用摘要、启动前配置逐字节、`0x410000` 以上非应用区摘要均通过。[部署记录](../../firmware/esp32-audio/startup-ct74.json)
- 首次启动后的 71 条有效 NVS 记录 CRC 通过，两个已存 Wi-Fi 与用户配置保持，仅 WebSocket token 更新。第二次启动另验版本及联网，没有冒充第二次 NVS 语义快照。
- 两次启动均读到 ct74、OLED 初始化、控制输出初始化关闭、联网与 idle。每次十条 HTTP 状态均为零启动、逻辑输出全关、无活动序列或草稿，网页与源码逐字节一致，采集后释放会话。[脱敏回读](evidence/ct74-deployment/http-readback.json)
- [灵矽角色回读](evidence/ct74-deployment/platform-role-readback.json)为 5991 字符，加回仓库末尾 LF 后摘要一致；未保存或修改平台配置。模型名称仅为界面可见标签，不证明后台模型身份。

构建时的 [verification-ct74.json](../../firmware/esp32-audio/verification-ct74.json)保留当时“未部署”的历史状态；当前部署以 [firmware/current.json](../../firmware/current.json)和本次启动记录为准。此前 ct73 架空转动、BOOT 停止及真人左转反馈不自动转算为 ct74 物理验收。

## 听感与后续现场项目

部署及无动作检查通过。第一轮[近距对话听感](evidence/ct74-deployment/listening-01.json)获用户确认：空闲有滴声，监听／回复时普通滴声暂缓，回复不卡顿。该记录是一次主观现场观察，未与距离、原始 STT 或音频波形同步；用户随后明确[跳过后三项检查](evidence/ct74-deployment/listening-followup.json)：结束恢复、移远不补播及再次靠近。本轮不再请求这三项，记录为 **skipped_by_user／未验收**，不计通过或失败。[原流程](dialogue-range-beeps.md#无动作听感验收顺序)仅作参考，用户重新选择继续前不执行。普通提示暂缓不关闭距离采样，也不改变前进保护阈值或紧急告警优先级。

空旷偶发滴声、远处／无效读数、codec／DMA 尾音与精确切换时延仍需单独记录。紧急停车及告警、完整停止矩阵、实际动作、负载和家庭体验没有由本次刷入或零输出检查代替。
