miclle/cybertrack/docs/validation/evidence/native-step-inputs/experimental-source.patch.txt

diff --git a/firmware/current.json b/firmware/current.json
index 69e2ac1..36323dd 100644
--- a/firmware/current.json
+++ b/firmware/current.json
@@ -1,9 +1,9 @@
 {
   "schema_version": 1,
-  "source_version": "2.0.3-ct68",
+  "source_version": "2.0.3-ct69",
   "last_recorded_deployment": "esp32-audio/startup-ct45.json",
-  "software_evidence": "esp32-audio/verification-ct68.json",
-  "role_sha256": "7f286df244df131de1271d1fcb0a82c5374998a2590cba7eb099645a4c4d9127",
+  "software_evidence": "esp32-audio/verification-ct69.json",
+  "role_sha256": "a2aba6185e20e13ca453ce6349330e920137584c90b5e352a2d9f5b8dee3dcdc",
   "deployment_relation": "candidate_not_deployed",
   "physical_acceptance": "incomplete",
   "last_recorded_role_sync": "esp32-audio/role-cancel-hold-ct45.json"
diff --git a/firmware/esp32-audio/action_plan_json.h b/firmware/esp32-audio/action_plan_json.h
index 6f60f6b..88974ea 100644
--- a/firmware/esp32-audio/action_plan_json.h
+++ b/firmware/esp32-audio/action_plan_json.h
@@ -3,13 +3,9 @@
 #include <cJSON.h>
 #include <string>
 
-// JSON is a string property because the upstream MCP schema supports scalar properties.
-// Require five action fields and optional speed_percent; reject unknown/duplicate keys.
-inline bool ParseActionPlan(const std::string& text, ActionPlan& plan) {
+// Both MCP arrays and the internal/web string format share the same bounds.
+inline bool ParseActionPlanArray(const cJSON* root, ActionPlan& plan) {
     plan = {};
-    if (text.empty() || text.size() > 4096 || text.find('\0') != std::string::npos ||
-        text.find("\\u0000") != std::string::npos) return false;
-    cJSON* root = cJSON_ParseWithOpts(text.c_str(), nullptr, true);
     bool valid = cJSON_IsArray(root);
     const int count = valid ? cJSON_GetArraySize(root) : 0;
     valid = valid && count > 0 && count <= static_cast<int>(ActionPlan::MaxSteps);
@@ -40,7 +36,15 @@ inline bool ParseActionPlan(const std::string& text, ActionPlan& plan) {
         }
         valid = valid && step.Valid();
     }
-    cJSON_Delete(root);
     if (valid) plan.count = count; else plan = {};
     return valid;
 }
+inline bool ParseActionPlan(const std::string& text, ActionPlan& plan) {
+    plan = {};
+    if (text.empty() || text.size() > 4096 || text.find('\0') != std::string::npos ||
+        text.find("\\u0000") != std::string::npos) return false;
+    cJSON* root = cJSON_ParseWithOpts(text.c_str(), nullptr, true);
+    const bool valid = ParseActionPlanArray(root, plan);
+    cJSON_Delete(root);
+    return valid;
+}
diff --git a/firmware/esp32-audio/apply_overlay.py b/firmware/esp32-audio/apply_overlay.py
index e9a91cc..c240b7f 100644
--- a/firmware/esp32-audio/apply_overlay.py
+++ b/firmware/esp32-audio/apply_overlay.py
@@ -10,6 +10,7 @@ from feedback_overlay import apply as apply_feedback_overlay
 from voice_turn_overlay import apply as apply_voice_turn_overlay
 from audio_overlay import apply as apply_audio_overlay
 from display_overlay import apply as apply_display_overlay
+from mcp_array_overlay import apply as apply_mcp_array_overlay
 
 HERE = Path(__file__).resolve().parent
 ROOT = HERE.parents[1]
@@ -114,7 +115,7 @@ def main():
         parser.error("source must be a disposable non-Git directory inside this project's build/")
     board = source / "main/boards/bread-compact-wifi"
     replace_once(source / "CMakeLists.txt", 'set(PROJECT_VER "2.0.3")',
-                 'set(PROJECT_VER "2.0.3-ct68")')
+                 'set(PROJECT_VER "2.0.3-ct69")')
     replace_once(board / "compact_wifi_board.cc", '#include "lamp_controller.h"',
                  '#include "cybertrack_tools.h"')
     replace_once(board / "compact_wifi_board.cc", 'static LampController lamp(LAMP_GPIO);',
@@ -182,7 +183,8 @@ def main():
     apply_voice_turn_overlay(source, replace_once)
     apply_audio_overlay(source, replace_once)
     apply_display_overlay(source, replace_once)
-    for name in ("vague_action_intent.h", "draft_duration_intent.h", "spoken_duration.h", "spoken_playback.h", "admission_result.h", "status_facts.h", "voice_feedback.h", "show_draft.h", "show_command_json.h", "recent_command.h", "proximity_guard.h", "proximity_audio.h", "proximity_audio.cc", "distance_reading.h", "ultrasonic.h", "ultrasonic.cc", "cybertrack_state.h", "cybertrack_tools.h", "cybertrack_tools.cc", "water_guard.h", "action_guard.h", "action_plan.h", "action_plan_json.h", "action_outputs.h", "control_sessions.h", "web_request.h", "web_server.h", "web_server.cc"):
+    apply_mcp_array_overlay(source, replace_once)
+    for name in ("mcp_steps_schema.h", "mcp_raw_json.h", "vague_action_intent.h", "draft_duration_intent.h", "spoken_duration.h", "spoken_playback.h", "admission_result.h", "status_facts.h", "voice_feedback.h", "show_draft.h", "show_command_json.h", "recent_command.h", "proximity_guard.h", "proximity_audio.h", "proximity_audio.cc", "distance_reading.h", "ultrasonic.h", "ultrasonic.cc", "cybertrack_state.h", "cybertrack_tools.h", "cybertrack_tools.cc", "water_guard.h", "action_guard.h", "action_plan.h", "action_plan_json.h", "action_outputs.h", "control_sessions.h", "web_request.h", "web_server.h", "web_server.cc"):
         shutil.copy2(HERE / name, board / name)
     sounds = '#pragma once\n'
     for key, filename in (("ProximityBeep", "range-beep.ogg"), ("ProximityStop", "range-stop.ogg")):
diff --git a/firmware/esp32-audio/cybertrack_tools.cc b/firmware/esp32-audio/cybertrack_tools.cc
index 13f21f8..87e73c0 100644
--- a/firmware/esp32-audio/cybertrack_tools.cc
+++ b/firmware/esp32-audio/cybertrack_tools.cc
@@ -5,6 +5,7 @@
 #include "status_facts.h"
 #include "draft_duration_intent.h"
 #include "vague_action_intent.h"
+#include "mcp_steps_schema.h"
 #include "web_server.h"
 #include "action_outputs.h"
 #include "ultrasonic.h"
@@ -501,26 +502,26 @@ void InitializeCyberTrackTools() {
             return Reply(p["_ct_turn"].value<int>(), "adjust_speed", p["_ct_ticket"].value<int>(), p["delta_percent"].value<int>());
         });
     server.AddTool("self.tank.compose",
-        "查询get_status只读取现状，绝不创建或保存草稿。用户明确要求新建或修改表演时，查完版本必须实际调用本工具，拿到本次result=draft_saved和新revision后才能说已保存；没有保存回执时说明尚未保存，不能凭计划或旧草稿宣称完成。取消也必须先实际查询，再调用cancel并收到draft_cancelled才说已取消。不要播报推理或操作计划。仅当用户明确编排、预览或修改泡泡表演草稿时使用；不执行动作。每次改稿前必须在本次会话调用get_status读取show_draft最新revision与steps，即使用户或上下文已经给出版本也要查。只允许行走和吹泡泡。喷水、点火、放电、护盾等不支持的效果只说明限制，不调用本工具，不提交空数组。用户说短一点等相对时长且没有明确新时长时，只问要改成几秒。参数edit为replace/replace_step/remove_step/cancel，revision为当前草稿版本，无草稿填0；step为从1开始的步骤索引，整单替换或取消填0；“同时／一边…一边”把行走和泡泡写进同一个步骤，各填各的时长；“先…再／然后”写为先后两步。回顾用户要求的先后关系再保存。steps_json沿用sequence步骤格式，首版仅行走与泡泡，water_ms/ignition_ms均0。replace传完整1到16步，replace_step只传单步数组，其余步骤由设备保留；remove_step/cancel传空字符串。draft_saved表示保存未执行，简短说明改动并请家长在网页预览后点开始；draft_changed先说明版本已变，不自动重试。不能用sequence/move等工具替代确认；没有语音确认执行工具。",
+        "查询get_status只读取现状，绝不创建或保存草稿。用户明确要求新建或修改表演时，查完版本必须实际调用本工具，拿到本次result=draft_saved和新revision后才能说已保存；没有保存回执时说明尚未保存，不能凭计划或旧草稿宣称完成。取消也必须先实际查询，再调用cancel并收到draft_cancelled才说已取消。不要播报推理或操作计划。仅当用户明确编排、预览或修改泡泡表演草稿时使用；不执行动作。每次改稿前必须在本次会话调用get_status读取show_draft最新revision与steps，即使用户或上下文已经给出版本也要查。只允许行走和吹泡泡。喷水、点火、放电、护盾等不支持的效果只说明限制，不调用本工具，不提交空数组。用户说短一点等相对时长且没有明确新时长时，只问要改成几秒。参数edit为replace/replace_step/remove_step/cancel，revision为当前草稿版本，无草稿填0；step为从1开始的步骤索引，整单替换或取消填0；“同时／一边…一边”把行走和泡泡写进同一个步骤，各填各的时长；“先…再／然后”写为先后两步。回顾用户要求的先后关系再保存。steps直接传步骤对象数组，不编码为字符串；格式同sequence，首版仅行走与泡泡，water_ms/ignition_ms均0。replace传完整1到16步，replace_step只传单步数组，其余步骤由设备保留；remove_step/cancel传空数组[]。draft_saved表示保存未执行，简短说明改动并请家长在网页预览后点开始；draft_changed先说明版本已变，不自动重试。不能用sequence/move等工具替代确认；没有语音确认执行工具。",
         PropertyList({Property("edit", kPropertyTypeString), Property("revision", kPropertyTypeInteger, 0, INT_MAX),
-                      Property("step", kPropertyTypeInteger, 0, 16), Property("steps_json", kPropertyTypeString)}),
+                      Property("step", kPropertyTypeInteger, 0, 16), Property::Array("steps", DraftStepsSchema)}),
         [](const PropertyList& p) -> ReturnValue {
             cJSON* root = cJSON_CreateObject();
             cJSON_AddStringToObject(root, "edit", p["edit"].value<std::string>().c_str());
             cJSON_AddNumberToObject(root, "revision", p["revision"].value<int>());
             cJSON_AddNumberToObject(root, "step", p["step"].value<int>());
-            cJSON_AddStringToObject(root, "steps_json", p["steps_json"].value<std::string>().c_str());
+            cJSON_AddItemToObject(root, "steps", cJSON_Parse(p["steps"].value<std::string>().c_str()));
             ShowDraft::Command edit;
-            const bool valid = ParseShowEdit(root, edit); cJSON_Delete(root);
+            const bool valid = ParseMcpShowEdit(root, edit); cJSON_Delete(root);
             if (!valid) return std::string("{\"result\":\"invalid_plan\"}");
             return Reply(p["_ct_turn"].value<int>(), "show_edit", p["_ct_ticket"].value<int>(), 0, nullptr, 0, 0, nullptr, nullptr, 100, &edit);
         });
     server.AddTool("self.tank.sequence",
-        "直接动作指令使用本工具；明确编排、预览或修改草稿用compose，不得用本工具代替草稿确认。明确请求多个先后步骤或多通道同时执行时，一次提交整个序列，不能拆成连续单项调用。steps_json是JSON数组的字符串，1到16步，每步必须包含direction、move_ms、water_ms、bubbles_ms、ignition_ms五字段，可选speed_percent为60到100整数、默认100；每步独立指定行走PWM，全句指定速度时应用到各行走步骤。direction为forward/backward/left/right；不行走用none且move_ms=0。各时长为整数毫秒，0表示不用该通道，每步至少一通道；move_ms最多2147483647，喷水/泡泡最多30000，点火最多5000。一步内各通道同时启动、独立停止；全部结束并满足冷却后下一步，无指定时长时，本步100%速度（含省略速度）的left/right行走默认880，其他动作1000；同时或在某动作时做另一动作且只给一个时长则共享，分别遵守效果上限。不用额外步骤绕过效果上限。整单验证且四路均空闲才启动，运行中保留四路；失败不重试，停止/BOOT/断线/故障或网页抢占取消整单，不能补做。accepted仅表示序列已开始，sequence_result查询完成或取消。",
-        PropertyList({Property("steps_json", kPropertyTypeString)}),
+        "直接动作指令使用本工具；明确编排、预览或修改草稿用compose，不得用本工具代替草稿确认。明确请求多个先后步骤或多通道同时执行时，一次提交整个序列，不能拆成连续单项调用。steps直接传步骤对象数组，不编码为字符串，1到16步，每步必须包含direction、move_ms、water_ms、bubbles_ms、ignition_ms五字段，可选speed_percent为60到100整数、默认100；每步独立指定行走PWM，全句指定速度时应用到各行走步骤。direction为forward/backward/left/right；不行走用none且move_ms=0。各时长为整数毫秒，0表示不用该通道，每步至少一通道；move_ms最多2147483647，喷水/泡泡最多30000，点火最多5000。一步内各通道同时启动、独立停止；全部结束并满足冷却后下一步，无指定时长时，本步100%速度（含省略速度）的left/right行走默认880，其他动作1000；同时或在某动作时做另一动作且只给一个时长则共享，分别遵守效果上限。不用额外步骤绕过效果上限。整单验证且四路均空闲才启动，运行中保留四路；失败不重试，停止/BOOT/断线/故障或网页抢占取消整单，不能补做。accepted仅表示序列已开始，sequence_result查询完成或取消。",
+        PropertyList({Property::Array("steps", SequenceStepsSchema)}),
         [](const PropertyList& p) -> ReturnValue {
             ActionPlan plan;
-            if (!ParseActionPlan(p["steps_json"].value<std::string>(), plan)) return std::string("{\"result\":\"invalid_plan\"}");
+            if (!ParseActionPlan(p["steps"].value<std::string>(), plan)) return std::string("{\"result\":\"invalid_plan\"}");
             return Reply(p["_ct_turn"].value<int>(), "sequence", p["_ct_ticket"].value<int>(), 0, nullptr, 0, 0, nullptr, &plan);
         });
     ESP_LOGI("CT_AUDIO", "READY tools=status,stop,water,bubbles,ignition,frenzy,move,move_and_water,sequence,compose,adjust_speed,set_speed concurrent=true motor_A=8/9/10 motor_B=11/12/13 GPIO18=LOW GPIO17=LOW GPIO21=LOW BOOT=stop_all move_max_ms=2147483647 water_max_ms=30000 bubbles_max_ms=30000 ignition_max_ms=5000");
diff --git a/firmware/esp32-audio/role-prompt.txt b/firmware/esp32-audio/role-prompt.txt
index 6e11319..11c9e0b 100644
--- a/firmware/esp32-audio/role-prompt.txt
+++ b/firmware/esp32-audio/role-prompt.txt
@@ -33,7 +33,7 @@
 
 顺序和同时：明确“然后”“再”“接着”等先后关系，用self.tank.sequence一次提交整条指令，不连续调用单项工具，不靠你等待、查询或重试来衔接。按先后拆步骤，同一步多路同时开始、独立截止；全步结束且满足间隔后，由固件进入下一步。行走／喷水／泡泡至少间隔200毫秒，点火至少等实际通电时长。后续步骤未说时长按默认规则，不继承前步时长；同一步明确同时且只给一个时长则共享。仅执行用户明确列出的步骤，不用序列拆分超限效果或擅自循环。
 
-sequence唯一参数steps_json，是JSON数组编码成的字符串，最多16步，不自动拆单。每步必须包含五字段：direction、move_ms、water_ms、bubbles_ms、ignition_ms，可选speed_percent，60到100整数、默认100；全句指定速度应用到各行走步骤，某一步单独指定则只覆盖该步。时长为整数毫秒；不用的通道填0，无行走时direction=none且move_ms=0，有行走时四方向之一且move_ms至少1；每步至少一项动作。行走最多2147483647，喷水／泡泡最多30000，点火最多5000。四路均空闲且间隔结束才接受整单；序列期间保留四路，新的独立启动动作会拒绝。停止、BOOT、语音连接关闭、断网、故障或网页抢占取消当前和全部后续步骤，绝不恢复或补做。
+sequence唯一参数steps，是步骤对象数组，直接传数组而非JSON字符串，最多16步，不自动拆单。每步必须包含五字段：direction、move_ms、water_ms、bubbles_ms、ignition_ms，可选speed_percent，60到100整数、默认100；全句指定速度应用到各行走步骤，某一步单独指定则只覆盖该步。时长为整数毫秒；不用的通道填0，无行走时direction=none且move_ms=0，有行走时四方向之一且move_ms至少1；每步至少一项动作。行走最多2147483647，喷水／泡泡最多30000，点火最多5000。四路均空闲且间隔结束才接受整单；序列期间保留四路，新的独立启动动作会拒绝。停止、BOOT、语音连接关闭、断网、故障或网页抢占取消当前和全部后续步骤，绝不恢复或补做。
 
 移动中调速：有目标数值如“减速到60%”“加速到80”“速度调到70”，调用self.tank.set_speed，唯一参数speed_percent为目标整数60到100；单独“全速”“最快”“最大速度”“调到全速”均调用set_speed({"speed_percent":100})，不是闲聊、狂暴模式或加10，不追问方向或时长。停止时按拒绝回执说明当前没有移动，不自行启动；已为100则接受后静默。有目标时不用adjust_speed叠加拼接，不用move重新启动。无目标数值而明确“加速”“加快速度”“快一点”调用self.tank.adjust_speed，唯一参数delta_percent=10；“减速”“减慢速度”“慢一点”传-10，每句一次。按百分点加减，不乘比例；固件将结果限在60到100。只改正在执行的移动或转向，包括序列当前步骤，不改方向、不续时、不影响其他通道或后续步骤。停止或步骤等待时拒绝，不能用move重新启动；网页移动也可语音加减速，网页速度随实际设置同步，长按租期不变。接受后静默，拒绝不重试。move_speed_percent是当前设置，0表示未移动；web_speed_percent仅是网页偏好，不影响语音指定速度。
 
diff --git a/firmware/esp32-audio/show_command_json.h b/firmware/esp32-audio/show_command_json.h
index 4d24802..c612fdf 100644
--- a/firmware/esp32-audio/show_command_json.h
+++ b/firmware/esp32-audio/show_command_json.h
@@ -10,24 +10,35 @@ inline bool ShowInteger(const cJSON* value, int low, int high) {
     return cJSON_IsNumber(value) && std::isfinite(value->valuedouble) &&
         value->valuedouble >= low && value->valuedouble <= high && value->valuedouble == value->valueint;
 }
-inline bool ParseShowEdit(const cJSON* root, ShowDraft::Command& command) {
-    if (!cJSON_IsObject(root) || cJSON_GetArraySize(root) != 4) return false;
+inline const cJSON* ParseShowEditFields(const cJSON* root, ShowDraft::Command& command, const char* payload) {
+    if (!cJSON_IsObject(root) || cJSON_GetArraySize(root) != 4) return nullptr;
     const auto edit=cJSON_GetObjectItemCaseSensitive(root,"edit"), revision=cJSON_GetObjectItemCaseSensitive(root,"revision"),
-        step=cJSON_GetObjectItemCaseSensitive(root,"step"), steps=cJSON_GetObjectItemCaseSensitive(root,"steps_json");
-    if (!cJSON_IsString(edit) || !cJSON_IsString(steps) || !ShowInteger(revision,0,INT_MAX) || !ShowInteger(step,0,16)) return false;
+        step=cJSON_GetObjectItemCaseSensitive(root,"step"), steps=cJSON_GetObjectItemCaseSensitive(root,payload);
+    if (!cJSON_IsString(edit) || !steps || !ShowInteger(revision,0,INT_MAX) || !ShowInteger(step,0,16)) return nullptr;
     command.revision=revision->valueint;command.step=step->valueint;
     if (!std::strcmp(edit->valuestring,"replace")) command.edit=ShowDraft::Replace;
     else if (!std::strcmp(edit->valuestring,"replace_step")) command.edit=ShowDraft::ReplaceStep;
     else if (!std::strcmp(edit->valuestring,"remove_step")) command.edit=ShowDraft::RemoveStep;
     else if (!std::strcmp(edit->valuestring,"cancel")) command.edit=ShowDraft::Cancel;
-    else return false;
+    else return nullptr;
     const bool single = command.edit==ShowDraft::ReplaceStep || command.edit==ShowDraft::RemoveStep;
-    if (single ? (!command.step || !command.revision) : command.step != 0) return false;
-    if (command.edit==ShowDraft::Cancel || command.edit==ShowDraft::RemoveStep)
-        return !steps->valuestring[0];
+    if (single ? (!command.step || !command.revision) : command.step != 0) return nullptr;
+    return steps;
+}
+inline bool ParseShowEdit(const cJSON* root, ShowDraft::Command& command) {
+    const auto steps = ParseShowEditFields(root, command, "steps_json");
+    if (!cJSON_IsString(steps)) return false;
+    if (command.edit==ShowDraft::Cancel || command.edit==ShowDraft::RemoveStep) return !steps->valuestring[0];
     return ParseActionPlan(steps->valuestring,command.plan) && ShowDraft::Valid(command.plan) &&
         (command.edit!=ShowDraft::ReplaceStep || command.plan.count==1);
 }
+inline bool ParseMcpShowEdit(const cJSON* root, ShowDraft::Command& command) {
+    const auto steps = ParseShowEditFields(root, command, "steps");
+    if (!cJSON_IsArray(steps)) return false;
+    if (command.edit==ShowDraft::Cancel || command.edit==ShowDraft::RemoveStep) return cJSON_GetArraySize(steps)==0;
+    return ParseActionPlanArray(steps,command.plan) && ShowDraft::Valid(command.plan) &&
+        (command.edit!=ShowDraft::ReplaceStep || command.plan.count==1);
+}
 inline std::string ShowDraftJson(const ShowDraft& draft, uint64_t now) {
     std::string result="{\"active\":";
     result+=draft.active?"true":"false";
diff --git a/firmware/esp32-audio/spoken_playback.h b/firmware/esp32-audio/spoken_playback.h
index c5f41b1..03401ab 100644
--- a/firmware/esp32-audio/spoken_playback.h
+++ b/firmware/esp32-audio/spoken_playback.h
@@ -123,9 +123,15 @@ struct SpokenPlayback {
         if (!std::strcmp(tool, "move_and_water"))
             return size == 3+has_speed && Text(args, "direction", first.direction) && Number(args, "move_duration_ms", first.ms[0]) &&
                    Number(args, "water_duration_ms", first.ms[1]) && DefaultSpeed(args);
-        const auto* encoded = cJSON_GetObjectItemCaseSensitive(args, "steps_json");
-        if (size != 1 || !cJSON_IsString(encoded) || std::strlen(encoded->valuestring) > 4096) return false;
-        auto* plan = cJSON_ParseWithOpts(encoded->valuestring, nullptr, true);
+        if (size != 1) return false;
+        const cJSON* plan = cJSON_GetObjectItemCaseSensitive(args,"steps");
+        cJSON* legacy = nullptr;
+        if (!plan) {
+            const auto* encoded = cJSON_GetObjectItemCaseSensitive(args, "steps_json");
+            if (!cJSON_IsString(encoded) || std::strlen(encoded->valuestring) > 4096) return false;
+            legacy = cJSON_ParseWithOpts(encoded->valuestring, nullptr, true);
+            plan = legacy;
+        }
         bool same = cJSON_IsArray(plan) && cJSON_GetArraySize(plan) == static_cast<int>(count);
         for (unsigned i = 0; same && i < count; ++i) {
             const auto* item = cJSON_GetArrayItem(plan, i);
@@ -134,7 +140,7 @@ struct SpokenPlayback {
                    Number(item, "water_ms", steps[i].ms[1]) && Number(item, "bubbles_ms", steps[i].ms[2]) &&
                    Number(item, "ignition_ms", 0) && DefaultSpeed(item);
         }
-        cJSON_Delete(plan);
+        cJSON_Delete(legacy);
         return same;
     }
     bool Receipt(const cJSON* receipt) const {
diff --git a/firmware/esp32-audio/tests/firmware_host.cc b/firmware/esp32-audio/tests/firmware_host.cc
index 55eb179..85cf3ff 100644
--- a/firmware/esp32-audio/tests/firmware_host.cc
+++ b/firmware/esp32-audio/tests/firmware_host.cc
@@ -5,6 +5,8 @@
 #include "draft_duration_intent.h"
 #include "vague_action_intent.h"
 #include "mcp_tool_types.h"
+#include "mcp_steps_schema.h"
+#include "mcp_raw_json.h"
 #include <functional>
 #include <iostream>
 #include <memory>
@@ -40,6 +42,15 @@ public:
         owned_.emplace_back(new McpTool(name, description, properties, callback));
         tools_.push_back(owned_.back().get());
     }
+    std::string Catalog() const {
+        std::string result="[";
+        for (const auto* tool : tools_) {
+            if (result.size()>1) result+=",";
+            result+=tool->to_json();
+        }
+        return result+"]";
+    }
+    void RejectRobotInput(int id);
     void ReplyResult(int, const std::string& result) {
         reply = "{\"result\":" + result + "}";
         responses.push_back(reply);
@@ -76,6 +87,12 @@ static bool Advance(unsigned elapsed) {
     return true;
 }
 int main(int argc, char** argv) {
+    if (argc==2 && std::string(argv[1])=="--catalog") {
+        McpServer server;
+#include "host_registration.inc"
+        std::cout << server.Catalog() << '\n';
+        return 0;
+    }
     if (argc != 2 && (argc != 3 || std::string(argv[2]) != "--await-stt")) return 2;
     sessions.WifiLink(clock_ms,true);
     sessions.VoiceLink(clock_ms,true);
@@ -168,7 +185,32 @@ int main(int argc, char** argv) {
         const auto* defer=cJSON_GetObjectItemCaseSensitive(call,"defer");
         if (defer && !cJSON_IsBool(defer)) return 2;
         Application::GetInstance().defer=cJSON_IsTrue(defer);
-        server.DoToolCall(rpc ? rpc->valueint : ++id,tool,args);
+        const int tool_id=rpc ? rpc->valueint : ++id;
+        std::unique_ptr<cJSON,decltype(&cJSON_Delete)> frame(nullptr,cJSON_Delete);
+        if (const auto* raw=cJSON_GetObjectItemCaseSensitive(call,"raw_params")) {
+            if (!cJSON_IsString(raw)) return 2;
+            const std::string transport="{\"type\":\"mcp\",\"payload\":{\"method\":\"tools/call\",\"id\":"+
+                std::to_string(tool_id)+",\"params\":"+raw->valuestring+"}}";
+            frame.reset(cJSON_ParseWithOpts(transport.c_str(),nullptr,true));
+            int invalid_id=0;
+            if (RejectZeroInRobotMcp(transport,frame.get(),invalid_id)) {
+                server.RejectRobotInput(invalid_id);
+                Application::GetInstance().defer=false;
+                continue;
+            }
+            const auto* params=cJSON_GetObjectItemCaseSensitive(cJSON_GetObjectItemCaseSensitive(frame.get(),"payload"),"params");
+            const auto* raw_name=cJSON_GetObjectItemCaseSensitive(params,"name");
+            const auto* raw_args=cJSON_GetObjectItemCaseSensitive(params,"arguments");
+            if (!cJSON_IsString(raw_name) || std::strcmp(raw_name->valuestring,name->valuestring) ||
+                !((!raw_args && !args) || cJSON_Compare(raw_args,args,true))) return 2;
+            args=raw_args;
+        } else return 2; // A parsed tree alone cannot prove the original string value.
+        // Match the network lifetime: incoming arguments are released as soon
+        // as dispatch returns, including when the callback is still queued.
+        std::unique_ptr<cJSON,decltype(&cJSON_Delete)> owned(args ? cJSON_Duplicate(args,true) : nullptr,cJSON_Delete);
+        if (args && !owned) return 2;
+        server.DoToolCall(tool_id,tool,owned.get());
+        owned.reset();
         Application::GetInstance().defer=false;
         if (server.reply.empty() && !cJSON_IsTrue(defer)) return 3;
     }
diff --git a/firmware/esp32-audio/tests/mcp_arguments_test.cc b/firmware/esp32-audio/tests/mcp_arguments_test.cc
index 6e1dcea..7c34f51 100644
--- a/firmware/esp32-audio/tests/mcp_arguments_test.cc
+++ b/firmware/esp32-audio/tests/mcp_arguments_test.cc
@@ -1,6 +1,7 @@
 #include <cJSON.h>
 #include "action_plan_json.h"
 #include "show_command_json.h"
+#include "mcp_raw_json.h"
 #include <cassert>
 #include <cstring>
 #include <string>
@@ -16,8 +17,12 @@ static void validate(const std::string& tool_name, cJSON* tool_arguments) {
 static void check(const char* tool, const char* json, bool valid) {
     rejected = false;
     cJSON* args = json ? cJSON_Parse(json) : nullptr;
-    if (json) assert(args);
-    validate(tool, args);
+    if (json && !args) { assert(!valid); return; } // Invalid wire JSON never reaches dispatch.
+    const std::string frame=std::string("{\"type\":\"mcp\",\"payload\":{\"id\":1,\"method\":\"tools/call\",\"params\":{\"name\":\"")+tool+"\",\"arguments\":"+(json?json:"null")+"}}}";
+    cJSON* wire=cJSON_Parse(frame.c_str());int invalid_id=0;
+    if (RejectZeroInRobotMcp(frame,wire,invalid_id)) rejected=true;
+    else validate(tool, args);
+    cJSON_Delete(wire);
     assert(rejected != valid);
     cJSON_Delete(args);
 }
@@ -43,11 +48,8 @@ int main() {
     for(const char* bad:{"{}","null",R"({"delta_percent":0})",R"({"delta_percent":20})",R"({"delta_percent":10.5})",R"({"delta_percent":"10"})",R"({"delta_percent":10,"delta_percent":10})"}) check("self.tank.adjust_speed",bad,false);
     const std::string step = R"({"direction":"left","move_ms":5000,"water_ms":5000,"bubbles_ms":0,"ignition_ms":0})";
     auto check_plan = [&](const std::string& text, bool valid) {
-        cJSON* obj = cJSON_CreateObject();
-        cJSON_AddStringToObject(obj, "steps_json", text.c_str());
-        char* json = cJSON_PrintUnformatted(obj);
-        check("self.tank.sequence", json, valid);
-        cJSON_free(json); cJSON_Delete(obj);
+        const std::string json="{\"steps\":"+text+"}";
+        check("self.tank.sequence", json.c_str(), valid);
     };
     check_plan(R"([{"direction":"left","move_ms":1000,"water_ms":0,"bubbles_ms":0,"ignition_ms":0,"speed_percent":60}])",true);
     for(const char* speed:{"0","101","1.5","true","50,\"speed_percent\":50"})
@@ -68,8 +70,10 @@ int main() {
     check_plan(R"([{"direction":"none","move_ms":0,"water_ms":30001,"bubbles_ms":0,"ignition_ms":0}])", false);
     check_plan(R"([{"direction":"none","move_ms":0,"water_ms":0,"bubbles_ms":0,"ignition_ms":5001}])", false);
     check_plan(R"([{"direction":"none","move_ms":0,"water_ms":0,"bubbles_ms":0,"ignition_ms":0}])", false);
-    check("self.tank.sequence", R"({"steps_json":[]})", false);
-    check("self.tank.sequence", R"({"steps_json":"[]","_ct_ticket":1})", false);
+    check("self.tank.sequence", R"({"steps":[]})", false);
+    check("self.tank.sequence", R"({"steps":"[]"})", false);
+    check("self.tank.sequence", R"({"steps_json":"[]"})", false);
+    check("self.tank.sequence", R"({"steps":[],"_ct_ticket":1})", false);
     check("self.tank.sequence", nullptr, false);
 
     for(const char* tool : {"self.tank.bubbles","self.tank.ignition","self.tank.frenzy"}) {
@@ -124,18 +128,18 @@ int main() {
         check(tool,"{}",true); check(tool,nullptr,true);
         for(const char* j : {"[]","null","{\"duration_ms\":1000}"}) check(tool,j,false);
     }
-    check("self.tank.compose",R"({"edit":"cancel","revision":0,"step":0,"steps_json":""})",true);
-    check("self.tank.compose",R"({"edit":"remove_step","revision":1,"step":2,"steps_json":""})",true);
-    for(const char* json:{"{}","null",R"({"edit":"cancel","revision":true,"step":0,"steps_json":""})",
-        R"({"edit":"remove_step","revision":0,"step":1,"steps_json":""})",
-        R"({"edit":"cancel","revision":1,"step":0,"steps_json":"[]"})",
-        R"({"edit":"cancel","revision":1,"step":0,"steps_json":"","extra":0})",
-        R"({"edit":"cancel","revision":1,"step":0,"step":0,"steps_json":""})"}) check("self.tank.compose",json,false);
+    check("self.tank.compose",R"({"edit":"cancel","revision":0,"step":0,"steps":[]})",true);
+    check("self.tank.compose",R"({"edit":"remove_step","revision":1,"step":2,"steps":[]})",true);
+    for(const char* json:{"{}","null",R"({"edit":"cancel","revision":true,"step":0,"steps":[]})",
+        R"({"edit":"remove_step","revision":0,"step":1,"steps":[]})",
+        R"({"edit":"cancel","revision":1,"step":0,"steps":"[]"})",
+        R"({"edit":"cancel","revision":1,"step":0,"steps":[],"extra":0})",
+        R"({"edit":"cancel","revision":1,"step":0,"step":0,"steps":[]})"}) check("self.tank.compose",json,false);
     cJSON* show=cJSON_CreateObject();cJSON_AddStringToObject(show,"edit","replace");
     cJSON_AddNumberToObject(show,"revision",0);cJSON_AddNumberToObject(show,"step",0);
-    cJSON_AddStringToObject(show,"steps_json",R"([{"direction":"none","move_ms":0,"water_ms":0,"bubbles_ms":1000,"ignition_ms":0}])");
+    cJSON_AddItemToObject(show,"steps",cJSON_Parse(R"([{"direction":"none","move_ms":0,"water_ms":0,"bubbles_ms":1000,"ignition_ms":0}])"));
     char* text=cJSON_PrintUnformatted(show);check("self.tank.compose",text,true);cJSON_free(text);
-    cJSON_ReplaceItemInObjectCaseSensitive(show,"steps_json",cJSON_CreateString(R"([{"direction":"none","move_ms":0,"water_ms":1,"bubbles_ms":1000,"ignition_ms":0}])"));
+    cJSON_ReplaceItemInObjectCaseSensitive(show,"steps",cJSON_Parse(R"([{"direction":"none","move_ms":0,"water_ms":1,"bubbles_ms":1000,"ignition_ms":0}])"));
     text=cJSON_PrintUnformatted(show);check("self.tank.compose",text,false);cJSON_free(text);cJSON_Delete(show);
     std::cout << "PASS: generated MCP argument checks, directions/ranges/types, missing/extra/duplicate keys, injected ticket, stop/status isolation\n";
 }
diff --git a/firmware/esp32-audio/tests/mcp_validation_replay.cc b/firmware/esp32-audio/tests/mcp_validation_replay.cc
index abfd2ed..476c1e7 100644
--- a/firmware/esp32-audio/tests/mcp_validation_replay.cc
+++ b/firmware/esp32-audio/tests/mcp_validation_replay.cc
@@ -1,6 +1,7 @@
 // Execute the prepared firmware's parameter gate without action callbacks or IO.
 #include "action_plan_json.h"
 #include "show_command_json.h"
+#include "mcp_raw_json.h"
 #include <cJSON.h>
 #include <cstring>
 #include <iostream>
@@ -20,7 +21,11 @@ int main() {
     auto* call = cJSON_ParseWithOpts(input.c_str(),nullptr,true);
     auto* name = cJSON_GetObjectItemCaseSensitive(call,"name");
     if (!cJSON_IsObject(call) || !cJSON_IsString(name)) { cJSON_Delete(call); return 1; }
-    Validate(name->valuestring,cJSON_GetObjectItemCaseSensitive(call,"arguments"));
+    const std::string frame="{\"type\":\"mcp\",\"payload\":{\"id\":1,\"method\":\"tools/call\",\"params\":"+input+"}}";
+    cJSON* wire=cJSON_Parse(frame.c_str());int invalid_id=0;
+    if (RejectZeroInRobotMcp(frame,wire,invalid_id)) error="Robot input contains an embedded zero";
+    else Validate(name->valuestring,cJSON_GetObjectItemCaseSensitive(call,"arguments"));
+    cJSON_Delete(wire);
     auto* result = cJSON_CreateObject();
     cJSON_AddBoolToObject(result,"valid",error == nullptr);
     cJSON_AddStringToObject(result,"error",error ? error : "");
diff --git a/firmware/esp32-audio/tests/run_mcp_tests.py b/firmware/esp32-audio/tests/run_mcp_tests.py
index 4a37626..23968f2 100644
--- a/firmware/esp32-audio/tests/run_mcp_tests.py
+++ b/firmware/esp32-audio/tests/run_mcp_tests.py
@@ -26,6 +26,15 @@ subprocess.run(['c++', '-std=c++17', *flags, '-I', str(cjson), '-I', str(build),
                 str(Path(__file__).with_name('mcp_arguments_test.cc')), str(build/'cJSON.o'),
                 '-o', str(build/'mcp_arguments_test')], check=True)
 subprocess.run([str(build/'mcp_arguments_test')], check=True)
+sdk=(args.source/'main/mcp_server.h').read_text()
+(build/'mcp_tool_types.h').write_text(sdk[:sdk.index('\nclass McpServer {')]+'\n#endif\n')
+(build/'mbedtls').mkdir(exist_ok=True)
+(build/'mbedtls/base64.h').write_text('#include <stddef.h>\nint mbedtls_base64_encode(unsigned char*,size_t,size_t*,const unsigned char*,size_t);\n')
+for suite in ('mcp_array_property_test','mcp_raw_json_test'):
+    subprocess.run(['c++','-std=c++17',*flags,'-I',str(build),'-I',str(cjson),
+                    '-I',str(root/'firmware/esp32-audio'),'-I',str(root/'firmware/esp32-linx/main'),
+                    str(Path(__file__).with_name(suite+'.cc')),str(build/'cJSON.o'),'-o',str(build/suite)],check=True)
+    subprocess.run([str(build/suite)],check=True)
 subprocess.run(['c++', '-std=c++17', *flags, '-I', str(cjson), '-I', str(build),
                 '-I', str(root/'firmware/esp32-audio'), '-I', str(root/'firmware/esp32-linx/main'),
                 str(Path(__file__).with_name('mcp_validation_replay.cc')), str(build/'cJSON.o'),
diff --git a/scripts/build_firmware_host.py b/scripts/build_firmware_host.py
index 0962256..fd18760 100644
--- a/scripts/build_firmware_host.py
+++ b/scripts/build_firmware_host.py
@@ -9,7 +9,7 @@ import subprocess
 ROOT = Path(__file__).resolve().parents[1]

-def build(source, idf, output):
+def build(source, idf, output, sanitize=False):
     source = source.resolve()
     output = output.resolve()
     output.mkdir(parents=True, exist_ok=True)
@@ -23,7 +23,9 @@ def build(source, idf, output):
     header = (source / "main/mcp_server.h").read_text()
     (output / "mcp_tool_types.h").write_text(header[:header.index("\nclass McpServer {")] + "\n#endif\n")
     server = (source / "main/mcp_server.cc").read_text()
-    (output / "host_dispatch.inc").write_text(server[server.index("void McpServer::DoToolCall("):])
+    start = server.find("void McpServer::RejectRobotInput(")
+    if start < 0: start = server.index("void McpServer::DoToolCall(")
+    (output / "host_dispatch.inc").write_text(server[start:])
     start = registration.index("    server.AddTool(")
     end = registration.index('    ESP_LOGI("CT_AUDIO", "READY', start)
     callbacks = registration[start:end]
@@ -37,21 +39,33 @@ def build(source, idf, output):
     end = registration.index("\n}\n}", start) + 2
     (output / "receipt_reply.inc").write_text(registration[start:end])
     cjson = idf / "components/json/cJSON"
+    debug_flags=["-g","-fsanitize=address,undefined"] if sanitize else []
     (output / "mbedtls").mkdir(exist_ok=True)
     (output / "mbedtls/base64.h").write_text(
         "#include <stddef.h>\nint mbedtls_base64_encode(unsigned char*,size_t,size_t*,const unsigned char*,size_t);\n")
-    subprocess.run(["cc", "-I", str(cjson), "-c", str(cjson/"cJSON.c"), "-o", str(output/"cJSON.o")], check=True)
-    subprocess.run(["cc", "-I", str(ROOT/"firmware/esp32-linx/main"), "-c",
+    subprocess.run(["cc", *debug_flags, "-I", str(cjson), "-c", str(cjson/"cJSON.c"), "-o", str(output/"cJSON.o")], check=True)
+    subprocess.run(["cc", *debug_flags, "-I", str(ROOT/"firmware/esp32-linx/main"), "-c",
                     str(ROOT/"firmware/esp32-linx/main/water_policy.c"), "-o", str(output/"water_policy.o")], check=True)
     executable = output / "firmware_host"
-    subprocess.run(["c++", "-std=c++17", "-Wall", "-Wextra", "-Werror", "-Wno-unused-variable",
+    subprocess.run(["c++", "-std=c++17", *debug_flags, "-Wall", "-Wextra", "-Werror", "-Wno-unused-variable",
                     "-I", str(output), "-I", str(cjson), "-I", str(board),
                     "-I", str(ROOT/"firmware/esp32-audio/tests"), "-I", str(ROOT/"firmware/esp32-linx/main"),
                     str(ROOT/"firmware/esp32-audio/tests/firmware_host.cc"),
                     str(output/"cJSON.o"), str(output/"water_policy.o"), "-o", str(executable)], check=True)
     paths = [board/name for name in names] + [ROOT/"firmware/esp32-audio/tests/receipt_host.h", source/"main/mcp_server.cc", source/"main/mcp_server.h", board/"cybertrack_tools.cc",
              ROOT/"firmware/esp32-audio/tests/firmware_host.cc", Path(__file__).resolve()]
+    catalog = json.loads(subprocess.check_output([str(executable),"--catalog"],text=True))
+    formats = []
+    for name in ("self.tank.sequence","self.tank.compose"):
+        properties = next(t for t in catalog if t["name"]==name)["inputSchema"]["properties"]
+        formats.append("native_array" if properties.get("steps",{}).get("type")=="array" else
+                       "legacy_string" if properties.get("steps_json",{}).get("type")=="string" else "unknown")
+    if formats[0]!=formats[1] or formats[0]=="unknown": raise ValueError("unknown/inconsistent step contract")
+    catalog_file=output/"tool-catalog.json"
+    catalog_file.write_text(json.dumps(catalog,ensure_ascii=False,indent=2)+"\n")
     manifest = dict(scope="Full MCP dispatcher and actual callbacks; immediate or explicitly deferred host schedule; simulated input/time/distance; zero board IO",
+                    step_argument_format=formats[0],tool_catalog_sha256=hashlib.sha256(catalog_file.read_bytes()).hexdigest(),
+                    sanitizers=sanitize,
                     executable_sha256=hashlib.sha256(executable.read_bytes()).hexdigest(),
                     sources={str(p.relative_to(ROOT)):hashlib.sha256(p.read_bytes()).hexdigest() for p in paths})
     (output/"manifest.json").write_text(json.dumps(manifest, indent=2)+"\n")
@@ -63,5 +77,6 @@ if __name__ == "__main__":
     parser.add_argument("--source", type=Path, required=True)
     parser.add_argument("--idf", type=Path, default=Path.home()/"esp/esp-idf")
     parser.add_argument("--output", type=Path, required=True)
+    parser.add_argument("--sanitize", action="store_true", help="instrument the entire host and C dependencies with ASan/UBSan")
     args = parser.parse_args()
-    build(args.source, args.idf, args.output)
+    build(args.source, args.idf, args.output,args.sanitize)
diff --git a/scripts/check_firmware_host.py b/scripts/check_firmware_host.py
index d8944e1..d0bd7ad 100644
--- a/scripts/check_firmware_host.py
+++ b/scripts/check_firmware_host.py
@@ -5,11 +5,14 @@ import json
 from pathlib import Path
 
 from capture_lingxi import firmware_profile, firmware_replay
+from firmware_corpus import expected_commands
 
 ROOT = Path(__file__).resolve().parents[1]

 def check(executable):
+    def expected_replay(profile, commands, **kwargs):
+        return firmware_replay(executable, profile, expected_commands(executable, commands), **kwargs)
     corpus = json.loads((ROOT/"docs/validation/voice-cases.json").read_bytes())
     assert len(corpus["cases"]) == 80 and {c["id"] for c in corpus["cases"]} == {f"V{i:03d}" for i in range(1,81)}
     for case in corpus["cases"]:
@@ -18,7 +21,7 @@ def check(executable):
                  for index, call in enumerate(case["expected_calls"])]
         if case["category"] == "stop":
             calls.append(dict(inspect_ms=60000))
-        rows = firmware_replay(executable, profile,
+        rows = expected_replay( profile,
                                [dict(input_text=case['text'],elapsed_ms=0), *calls], await_stt=True)
         for wire in rows[:-1]:
             assert "result" in wire, (case["id"], wire)
@@ -36,7 +39,7 @@ def check(executable):
     for case in compose["cases"]:
         calls = [dict(call, elapsed_ms=(index+1)*500, rpc_id=index+1)
                  for index, call in enumerate(case["expected_calls"])]
-        rows = firmware_replay(executable, firmware_profile(case["context"]),
+        rows = expected_replay( firmware_profile(case["context"]),
                                [dict(input_text=case['text'],elapsed_ms=0), *calls, dict(inspect_ms=6000)], await_stt=True)
         assert all("result" in wire for wire in rows[:-1])
         final = rows[-1]
@@ -51,11 +54,11 @@ def check(executable):
     edit = next(case for case in compose["cases"] if case["id"] == "C002")
     calls = [dict(call, elapsed_ms=(index+1)*500, rpc_id=index+1)
              for index, call in enumerate(edit["expected_calls"])]
-    no_read = firmware_replay(executable, "corpus_draft7", [
+    no_read = expected_replay( "corpus_draft7", [
         dict(edit["expected_calls"][1], elapsed_ms=500, rpc_id=1)])
     assert json.loads(no_read[0]["result"]["content"][0]["text"])["result"] == "draft_changed"
     assert no_read[-1]["show_draft"]["revision"] == 7
-    rows = firmware_replay(executable, "corpus_draft7_conflict", [*calls, dict(inspect_ms=60000)])
+    rows = expected_replay( "corpus_draft7_conflict", [*calls, dict(inspect_ms=60000)])
     rejected = json.loads(rows[1]["result"]["content"][0]["text"])
     assert rejected["result"] == "draft_changed"
     assert rows[-1]["show_draft"]["revision"] == 8
@@ -70,26 +73,26 @@ def check(executable):
         dict(name="self.tank.unknown", arguments={}),
     ]
     for call in invalid:
-        wire, final = firmware_replay(executable, "corpus_idle", [dict(call,elapsed_ms=0,rpc_id=1)])
+        wire, final = expected_replay( "corpus_idle", [dict(call,elapsed_ms=0,rpc_id=1)])
         assert "error" in wire and final["starts_this_boot"] == 0
         assert not any(final["logical_outputs"].values())
     calls = [
         dict(name="self.tank.water",arguments={"duration_ms":1000},elapsed_ms=0,rpc_id=17),
         dict(name="self.tank.water",arguments={"duration_ms":1000},elapsed_ms=50,rpc_id=17),
     ]
-    first, duplicate, final = firmware_replay(executable, "corpus_idle", calls)
+    first, duplicate, final = expected_replay( "corpus_idle", calls)
     assert "result" in first and "error" in duplicate
     assert final["starts_this_boot"] == 1 and final["water_remaining_ms"] == 950
     # Negative int32 IDs are valid platform requests, including setup's IDs.
     for profile in ("corpus_idle", "corpus_forward70", "corpus_sequence", "corpus_draft7"):
-        stopped, first, duplicate, final = firmware_replay(executable, profile, [
+        stopped, first, duplicate, final = expected_replay( profile, [
             dict(name="self.tank.stop", arguments={}, elapsed_ms=0, rpc_id=333),
             dict(name="self.tank.water", arguments={"duration_ms":1000}, elapsed_ms=0, rpc_id=-2147483648),
             dict(name="self.tank.water", arguments={"duration_ms":1000}, elapsed_ms=50, rpc_id=-2147483648),
         ])
         assert "result" in first and "error" in duplicate, (profile, first, duplicate)
         assert final["water_remaining_ms"] == 950
-    wire, final = firmware_replay(executable, "corpus_forward70", [
+    wire, final = expected_replay( "corpus_forward70", [
         dict(name="self.tank.stop",arguments={"unexpected":True},elapsed_ms=0,rpc_id=1)])
     assert "error" in wire and final["move_speed_percent"] == 70
     return dict(scope="Synthetic protocol requests, virtual timing and simulated range; no model or board IO",
diff --git a/scripts/check_relative_draft.py b/scripts/check_relative_draft.py
index fa4d410..f5251e2 100644
--- a/scripts/check_relative_draft.py
+++ b/scripts/check_relative_draft.py
@@ -7,6 +7,7 @@ import json
 from pathlib import Path
 
 from capture_lingxi import firmware_replay
+from firmware_corpus import expected_commands
 
 ROOT=Path(__file__).resolve().parents[1]
 
@@ -26,6 +27,7 @@ def check(executable):
 
     results=[]
     def run(name,commands,verify,profile='corpus_draft7'):
+        commands=expected_commands(executable,commands)
         wires=firmware_replay(executable,profile,commands,await_stt=True)
         replies=[receipt(w) for w in wires[:-1]]
         results.append(dict(name=name,passed=bool(verify(replies,wires[-1])),profile=profile,commands=commands,
diff --git a/scripts/check_vague_action.py b/scripts/check_vague_action.py
index bf38655..65bff37 100644
--- a/scripts/check_vague_action.py
+++ b/scripts/check_vague_action.py
@@ -7,6 +7,7 @@ import json
 from pathlib import Path
 
 from capture_lingxi import firmware_replay
+from firmware_corpus import expected_commands
 
 ROOT = Path(__file__).resolve().parents[1]
 
@@ -26,6 +27,7 @@ def check(executable):
     results = []
 
     def run(name, commands, verify, profile='corpus_idle'):
+        commands = expected_commands(executable,commands)
         wires = firmware_replay(executable, profile, commands, await_stt=True)
         replies = [receipt(w) for w in wires[:-1]]
         results.append(dict(name=name, passed=bool(verify(replies, wires[-1])), profile=profile,
diff --git a/scripts/check_voice_turn.py b/scripts/check_voice_turn.py
index b4faa68..6f7b09b 100644
--- a/scripts/check_voice_turn.py
+++ b/scripts/check_voice_turn.py
@@ -7,11 +7,14 @@ import json
 from pathlib import Path
 
 from capture_lingxi import firmware_replay
+from firmware_corpus import expected_commands
 
 ROOT = Path(__file__).resolve().parents[1]

 def check(executable):
+    def expected_replay(profile, commands, **kwargs):
+        return firmware_replay(executable, profile, expected_commands(executable, commands), **kwargs)
     def call(name, args, ms=0, rpc=1, **extra):
         return dict(name='self.tank.'+name, arguments=args, elapsed_ms=ms, rpc_id=rpc, **extra)
 
@@ -20,7 +23,7 @@ def check(executable):
 
     invalid = call('bubbles', {'duration_ms':60000})
     move = dict(direction='forward',duration_ms=1000)
-    rows = firmware_replay(executable, 'corpus_idle', [
+    rows = expected_replay( 'corpus_idle', [
         invalid, call('get_status',{},10,2), dict(input_text='  \t',elapsed_ms=15),
         call('move',move,20,3), call('stop',{},30,4), call('water',{'duration_ms':1000},300,5),
         dict(input_text='喷水',elapsed_ms=500), call('water',{'duration_ms':1000},500,6), dict(inspect_ms=600)])
@@ -30,13 +33,13 @@ def check(executable):
     assert result(rows[5])['result']=='accepted' and rows[-1]['starts_this_boot']==1
     assert rows[-1]['water_remaining_ms']==900
 
-    rows = firmware_replay(executable,'corpus_idle',[
+    rows = expected_replay('corpus_idle',[
         call('move',move,defer=True), call('bubbles',{'duration_ms':60000},1,2),
         dict(flush=True,elapsed_ms=2)])
     assert len(rows)==3 and all('error' in wire or result(wire)['result']!='accepted' for wire in rows[:-1])
     assert rows[-1]['starts_this_boot']==0
 
-    rows = firmware_replay(executable,'corpus_idle',[
+    rows = expected_replay('corpus_idle',[
         call('compose',dict(edit='cancel',revision=0,step=0,steps_json=''),defer=True),
         dict(input_text='吹泡泡',elapsed_ms=10),call('bubbles',{'duration_ms':1000},20,2),
         dict(flush=True,elapsed_ms=30),call('water',{'duration_ms':1000},40,3)])
@@ -45,20 +48,20 @@ def check(executable):
     assert rows[-1]['logical_outputs']['water'] and rows[-1]['logical_outputs']['bubbles']
 
     edit=dict(edit='replace_step',revision=7,step=2,steps_json='[{"direction":"none","move_ms":0,"water_ms":0,"bubbles_ms":2000,"ignition_ms":0}]')
-    rows=firmware_replay(executable,'corpus_draft7',[
+    rows=expected_replay('corpus_draft7',[
         call('get_status',{},defer=True),dict(input_text='修改第二步',elapsed_ms=10),
         dict(flush=True,elapsed_ms=20),call('compose',edit,30,2)])
     assert result(rows[0])['result']=='voice_input_changed' and result(rows[1])['result']=='draft_changed'
     assert rows[-1]['show_draft']['revision']==7 and rows[-1]['starts_this_boot']==0
 
-    rows=firmware_replay(executable,'corpus_idle',[
+    rows=expected_replay('corpus_idle',[
         call('move',move,defer=True),dict(input_text='新的指令',elapsed_ms=10),
         dict(flush=True,elapsed_ms=20),call('move',move,30,1),
         dict(input_text='前进',elapsed_ms=40),call('move',move,40,3)])
     assert result(rows[0])['result']=='voice_input_changed' and 'error' in rows[1]
     assert result(rows[2])['result']=='accepted' and rows[-1]['starts_this_boot']==1
 
-    rows=firmware_replay(executable,'corpus_idle',[
+    rows=expected_replay('corpus_idle',[
         call('water',{'duration_ms':1000}),call('get_status',{},1,2),call('stop',{},2,3),
         dict(input_text=' \t',elapsed_ms=3),call('water',{'duration_ms':1000},4,4),
         dict(input_text='喷水',elapsed_ms=5),call('water',{'duration_ms':1000},5,5)],await_stt=True)
@@ -67,18 +70,18 @@ def check(executable):
     assert 'error' in rows[3] and result(rows[4])['result']=='accepted'
     assert rows[-1]['starts_this_boot']==1
 
-    rows=firmware_replay(executable,'corpus_forward70',[
+    rows=expected_replay('corpus_forward70',[
         invalid,call('stop',{},10,2),dict(inspect_ms=60000)])
     assert result(rows[1])['result']=='ok' and not any(rows[-1]['logical_outputs'].values())
     assert rows[-1]['starts_this_boot']==1
 
-    rows=firmware_replay(executable,'corpus_idle',[
+    rows=expected_replay('corpus_idle',[
         dict(voice_online=False,elapsed_ms=0),dict(voice_online=True,elapsed_ms=1),
         call('water',{'duration_ms':1000},2),dict(input_text='喷水',elapsed_ms=3),
         call('water',{'duration_ms':1000},3,2)])
     assert 'error' in rows[0] and result(rows[1])['result']=='accepted'
 
-    rows=firmware_replay(executable,'corpus_idle',[
+    rows=expected_replay('corpus_idle',[
         call('water',{'duration_ms':1000,'_ct_turn':123}),call('water',{'duration_ms':1000},1,2),
         dict(input_text='喷水',elapsed_ms=2),call('water',{'duration_ms':1000},2,3)])
     assert 'error' in rows[0] and 'voice_input_failed' in rows[1]['error']['message']
@@ -88,7 +91,7 @@ def check(executable):
     trace=json.loads(gzip.decompress(raw)); replayed=[]
     for row in trace['results']:
         if row['id'] not in ('C002','C004','C005','C007'):continue
-        rows=firmware_replay(executable,row['initial_profile'],[*row['host_calls'],dict(inspect_ms=row['host_inspect_ms'])])
+        rows=expected_replay(row['initial_profile'],[*row['host_calls'],dict(inspect_ms=row['host_inspect_ms'])])
         assert rows[-1]['starts_this_boot']==0 and rows[-1]['show_draft']['revision']==7
         assert not any(rows[-1]['logical_outputs'].values())
         replayed.append(dict(id=row['id'],results=[wire.get('error',{}).get('message') if 'error' in wire else result(wire)['result'] for wire in rows[:-1]],final_revision=7,starts=0))
diff --git a/scripts/export_lingxi_tools.py b/scripts/export_lingxi_tools.py
index a5a0bf1..6051f53 100644
--- a/scripts/export_lingxi_tools.py
+++ b/scripts/export_lingxi_tools.py
@@ -33,12 +33,12 @@ def export(source, idf, output):
         if not declaration.lstrip().startswith('"self.tank.'):
             raise ValueError('unexpected registration')
         rows.append('emit(McpTool(' + declaration + ', [](const PropertyList&) -> ReturnValue { return std::string("capture only"); }));')
-    cpp = '#include <climits>\n#include <iostream>\n#include "mcp_server.h"\nint main(){bool first=true; std::cout<<"["; auto emit=[&](const McpTool& t){if(!first)std::cout<<",";first=false;std::cout<<t.to_json();};\n'
+    cpp = '#include <climits>\n#include <iostream>\n#include "mcp_server.h"\n#include "mcp_steps_schema.h"\nint main(){bool first=true; std::cout<<"["; auto emit=[&](const McpTool& t){if(!first)std::cout<<",";first=false;std::cout<<t.to_json();};\n'
     cpp += '\n'.join(rows) + '\nstd::cout<<"]\\n";}\n'
     (build / 'export.cc').write_text(cpp)
     cjson = idf / 'components/json/cJSON'
     subprocess.run(['cc', '-c', '-I', str(cjson), str(cjson/'cJSON.c'), '-o', str(build/'cJSON.o')], check=True, capture_output=True)
-    subprocess.run(['c++', '-std=c++17', '-I', str(build), '-I', str(header.parent), '-I', str(cjson), str(build/'export.cc'), str(build/'cJSON.o'), '-o', str(build/'export')], check=True, capture_output=True)
+    subprocess.run(['c++', '-std=c++17', '-I', str(build), '-I', str(header.parent), '-I', str(registration.parent), '-I', str(cjson), str(build/'export.cc'), str(build/'cJSON.o'), '-o', str(build/'export')], check=True, capture_output=True)
     subprocess.run(['c++', '-std=c++17', '-I', str(cjson), '-I', str(registration.parent),
                     str(ROOT/'scripts/lingxi_status_fixture.cc'), str(build/'cJSON.o'),
                     '-o', str(build/'status-fixture')], check=True)
@@ -46,7 +46,7 @@ def export(source, idf, output):
     if len({s['name'] for s in schemas}) != 12:
         raise ValueError('duplicate tool schemas')
     output.parent.mkdir(parents=True, exist_ok=True)
-    output.write_text(json.dumps({'scope':'host export, inert callbacks; not remote discovery', 'source_sha256':{str(p.relative_to(ROOT)):hashlib.sha256(p.read_bytes()).hexdigest() for p in [header,registration]}, 'tools':schemas}, ensure_ascii=False, indent=2)+'\n')
+    output.write_text(json.dumps({'scope':'host export, inert callbacks; not remote discovery', 'source_sha256':{str(p.relative_to(ROOT)):hashlib.sha256(p.read_bytes()).hexdigest() for p in [header,registration,registration.parent/"mcp_steps_schema.h"]}, 'tools':schemas}, ensure_ascii=False, indent=2)+'\n')
     return schemas

diff --git a/scripts/verify_improvements.py b/scripts/verify_improvements.py
index bce2210..0f6dbd9 100644
--- a/scripts/verify_improvements.py
+++ b/scripts/verify_improvements.py
@@ -48,7 +48,9 @@ def main():
             [sys.executable, "scripts/check_relative_draft.py", "--executable", str(host_build/"firmware_host"),
              "--output", str(out/"relative-draft.json")],
             [sys.executable, "scripts/check_vague_action.py", "--executable", str(host_build/"firmware_host"),
-             "--output", str(out/"vague-action.json")]])
+             "--output", str(out/"vague-action.json")],
+            [sys.executable, "scripts/check_native_steps.py", "--executable", str(host_build/"firmware_host"),
+             "--output", str(out/"native-steps.json")]])
     if args.model_design:
         commands.extend([["npm", "--prefix", "tools/model-design", "test"],
                          ["npm", "--prefix", "tools/model-design", "run", "test:bundle"],
diff --git a/tools/lingxi-solution/files.json b/tools/lingxi-solution/files.json
index acfa44c..c240004 100644
--- a/tools/lingxi-solution/files.json
+++ b/tools/lingxi-solution/files.json
@@ -286,5 +286,6 @@
   "docs/validation/evidence/capture-recognized-input/software-checks.json",
   "docs/validation/evidence/capture-recognized-input/stt-review.json",
   "docs/validation/evidence/capture-recognized-input/summary.json",
-  "docs/validation/evidence/capture-recognized-input/tools.json"
+  "docs/validation/evidence/capture-recognized-input/tools.json",
+  "firmware/esp32-audio/verification-ct69.json"
 ]
diff --git a/firmware/esp32-audio/mcp_array_overlay.py b/firmware/esp32-audio/mcp_array_overlay.py
new file mode 100644
index 0000000..52141e4
--- /dev/null
+++ b/firmware/esp32-audio/mcp_array_overlay.py
@@ -0,0 +1,85 @@
+"""Add owned array properties to the pinned SDK, with robot validation before admission."""
+
+
+def apply(source, replace):
+    header=source/'main/mcp_server.h'
+    server=source/'main/mcp_server.cc'
+    replace(header,'#include <string>', '#include <string>\n#include <cstring>\n#include <new>')
+    replace(header,'    kPropertyTypeString\n','    kPropertyTypeString,\n    kPropertyTypeArray\n')
+    replace(header,'    PropertyType type_;','    PropertyType type_;\n    std::string array_schema_;')
+    replace(header,'    inline const std::string& name() const { return name_; }\n    inline PropertyType type() const { return type_; }',r'''    static Property Array(const std::string& name, const std::string& schema) {
+        auto* parsed = cJSON_ParseWithOpts(schema.c_str(), nullptr, true);
+        const auto* type = cJSON_GetObjectItemCaseSensitive(parsed, "type");
+        const bool valid = cJSON_IsObject(parsed) && cJSON_IsString(type) && !std::strcmp(type->valuestring, "array");
+        cJSON_Delete(parsed);
+        if (!valid) throw std::invalid_argument("Array property requires an array schema");
+        Property property(name, kPropertyTypeArray);
+        property.array_schema_ = schema;
+        return property;
+    }
+    inline const std::string& name() const { return name_; }
+    inline PropertyType type() const { return type_; }''')
+    replace(header,'        if (type_ == kPropertyTypeBoolean) {',r'''        if (type_ == kPropertyTypeArray) {
+            cJSON_Delete(json);
+            json = cJSON_ParseWithOpts(array_schema_.c_str(), nullptr, true);
+            if (!json) throw std::bad_alloc();
+        } else if (type_ == kPropertyTypeBoolean) {''')
+    replace(header,'    void ParseMessage(const std::string& message);',
+            '    void ParseMessage(const std::string& message);\n    void RejectRobotInput(int id);')
+    replace(server,'void McpServer::DoToolCall(int id, const std::string& tool_name, const cJSON* tool_arguments) {',r'''void McpServer::RejectRobotInput(int id) {
+    CyberTrackVoiceFailure(CyberTrackVoiceTurn());
+    ReplyError(id, "Robot input contains an embedded zero");
+}
+
+void McpServer::DoToolCall(int id, const std::string& tool_name, const cJSON* tool_arguments) {''')
+    replace(server,'#include "mcp_server.h"', '#include "mcp_server.h"\n#include "boards/bread-compact-wifi/mcp_raw_json.h"')
+    replace(server,'    ParseMessage(json);',r'''    int invalid_robot_id = 0;
+    if (RejectZeroInRobotMcp(message, json, invalid_robot_id)) RejectRobotInput(invalid_robot_id);
+    else ParseMessage(json);''')
+    replace(server,'if (!ParseShowEdit(tool_arguments, edit))', 'if (!ParseMcpShowEdit(tool_arguments, edit))')
+    replace(server,'const cJSON* steps = cJSON_GetObjectItemCaseSensitive(tool_arguments, "steps_json");',
+            'const cJSON* steps = cJSON_GetObjectItemCaseSensitive(tool_arguments, "steps");')
+    replace(server,'!cJSON_IsString(steps) || !ParseActionPlan(steps->valuestring, plan)',
+            '!ParseActionPlanArray(steps, plan)')
+    replace(server,'Sequence requires exactly steps_json with 1..16 valid steps',
+            'Sequence requires exactly an array steps with 1..16 valid steps')
+    replace(server,r'''                } else if (argument.type() == kPropertyTypeString && cJSON_IsString(value)) {
+                    argument.set_value<std::string>(value->valuestring);
+                    found = true;
+                }''',r'''                } else if (argument.type() == kPropertyTypeString && cJSON_IsString(value)) {
+                    argument.set_value<std::string>(value->valuestring);
+                    found = true;
+                } else if (argument.type() == kPropertyTypeArray && cJSON_IsArray(value)) {
+                    // Own a canonical copy: the incoming tree is freed before
+                    // scheduled callbacks run. Never store its cJSON pointer.
+                    char* encoded = cJSON_PrintUnformatted(value);
+                    if (!encoded) throw std::bad_alloc();
+                    try { argument.set_value<std::string>(std::string(encoded)); }
+                    catch (...) { cJSON_free(encoded); throw; }
+                    cJSON_free(encoded);
+                    found = true;
+                }''')
+    protocol=source/'main/protocols/websocket_protocol.cc'
+    replace(protocol,'#include "websocket_protocol.h"',
+            '#include "websocket_protocol.h"\n#if CONFIG_ENABLE_MCP\n#include "mcp_server.h"\n#include "boards/bread-compact-wifi/mcp_raw_json.h"\n#endif')
+    replace(protocol,'            auto type = cJSON_GetObjectItem(root, "type");',r'''            auto type = cJSON_GetObjectItem(root, "type");
+#if CONFIG_ENABLE_MCP
+            int invalid_robot_id = 0;
+            if (RejectZeroInRobotMcp(std::string_view(data, len), root, invalid_robot_id)) {
+                McpServer::GetInstance().RejectRobotInput(invalid_robot_id);
+                cJSON_Delete(root);
+                return;
+            }
+#endif''')
+    mqtt=source/'main/protocols/mqtt_protocol.cc'
+    replace(mqtt,'#include "mqtt_protocol.h"',
+            '#include "mqtt_protocol.h"\n#if CONFIG_ENABLE_MCP\n#include "mcp_server.h"\n#include "boards/bread-compact-wifi/mcp_raw_json.h"\n#endif')
+    replace(mqtt,'        cJSON* type = cJSON_GetObjectItem(root, "type");',r'''        cJSON* type = cJSON_GetObjectItem(root, "type");
+#if CONFIG_ENABLE_MCP
+        int invalid_robot_id = 0;
+        if (RejectZeroInRobotMcp(payload, root, invalid_robot_id)) {
+            McpServer::GetInstance().RejectRobotInput(invalid_robot_id);
+            cJSON_Delete(root);
+            return;
+        }
+#endif''')
diff --git a/firmware/esp32-audio/mcp_raw_json.h b/firmware/esp32-audio/mcp_raw_json.h
new file mode 100644
index 0000000..f614f1b
--- /dev/null
+++ b/firmware/esp32-audio/mcp_raw_json.h
@@ -0,0 +1,32 @@
+#pragma once
+#include <cJSON.h>
+#include <string_view>
+#include <climits>
+#include <cstring>
+
+// cJSON strings cannot retain an embedded zero. Check the original frame
+// before a robot RPC can interpret a truncated enum as a valid command.
+inline bool McpJsonContainsZero(std::string_view raw) {
+    for (size_t i=0;i<raw.size();++i) {
+        if (!raw[i]) return true;
+        if (raw[i]!='\\' || i+1==raw.size()) continue;
+        if (raw[i+1]=='u' && raw.substr(i+2,4)=="0000") return true;
+        ++i; // A quoted backslash is not a Unicode escape.
+    }
+    return false;
+}
+inline bool RejectZeroInRobotMcp(std::string_view raw, const cJSON* root, int& id) {
+    const auto* type=cJSON_GetObjectItemCaseSensitive(root,"type");
+    if (!McpJsonContainsZero(raw)) return false;
+    if (type && (!cJSON_IsString(type) || std::strcmp(type->valuestring,"mcp"))) return false;
+    const auto* payload=type ? cJSON_GetObjectItemCaseSensitive(root,"payload") : root;
+    const auto* method=cJSON_GetObjectItemCaseSensitive(payload,"method");
+    const auto* rpc=cJSON_GetObjectItemCaseSensitive(payload,"id");
+    const auto* params=cJSON_GetObjectItemCaseSensitive(payload,"params");
+    const auto* name=cJSON_GetObjectItemCaseSensitive(params,"name");
+    if (!cJSON_IsString(method) || std::strcmp(method->valuestring,"tools/call") || !cJSON_IsString(name) ||
+        (std::strncmp(name->valuestring,"self.tank.",10) && std::strncmp(name->valuestring,"self_tank_",10)) ||
+        !cJSON_IsNumber(rpc) || !(rpc->valuedouble>=INT_MIN && rpc->valuedouble<=INT_MAX) || rpc->valuedouble!=rpc->valueint) return false;
+    id=rpc->valueint;
+    return true;
+}
diff --git a/firmware/esp32-audio/mcp_steps_schema.h b/firmware/esp32-audio/mcp_steps_schema.h
new file mode 100644
index 0000000..f3d5bbc
--- /dev/null
+++ b/firmware/esp32-audio/mcp_steps_schema.h
@@ -0,0 +1,5 @@
+#pragma once
+
+// Guidance for the model; the actual plan/draft parsers remain authoritative.
+inline constexpr const char* SequenceStepsSchema = R"json({"type":"array","minItems":1,"maxItems":16,"items":{"type":"object","additionalProperties":false,"required":["direction","move_ms","water_ms","bubbles_ms","ignition_ms"],"properties":{"direction":{"type":"string","enum":["none","forward","backward","left","right"]},"move_ms":{"type":"integer","minimum":0,"maximum":2147483647},"water_ms":{"type":"integer","minimum":0,"maximum":30000},"bubbles_ms":{"type":"integer","minimum":0,"maximum":30000},"ignition_ms":{"type":"integer","minimum":0,"maximum":5000},"speed_percent":{"type":"integer","minimum":60,"maximum":100,"default":100}}}})json";
+inline constexpr const char* DraftStepsSchema = R"json({"type":"array","minItems":0,"maxItems":16,"items":{"type":"object","additionalProperties":false,"required":["direction","move_ms","water_ms","bubbles_ms","ignition_ms"],"properties":{"direction":{"type":"string","enum":["none","forward","backward","left","right"]},"move_ms":{"type":"integer","minimum":0,"maximum":2147483647},"water_ms":{"type":"integer","const":0},"bubbles_ms":{"type":"integer","minimum":0,"maximum":30000},"ignition_ms":{"type":"integer","const":0},"speed_percent":{"type":"integer","minimum":60,"maximum":100,"default":100}}}})json";
diff --git a/firmware/esp32-audio/tests/mcp_array_property_test.cc b/firmware/esp32-audio/tests/mcp_array_property_test.cc
new file mode 100644
index 0000000..f9cd63c
--- /dev/null
+++ b/firmware/esp32-audio/tests/mcp_array_property_test.cc
@@ -0,0 +1,30 @@
+#include "mcp_tool_types.h"
+#include "mcp_steps_schema.h"
+#include "action_plan_json.h"
+#include <cassert>
+#include <iostream>
+
+int main() {
+    auto property=Property::Array("steps",SequenceStepsSchema);
+    assert(property.type()==kPropertyTypeArray && !property.has_default_value());
+    auto* schema=cJSON_Parse(property.to_json().c_str());
+    assert(cJSON_GetObjectItemCaseSensitive(schema,"maxItems")->valueint==16);
+    assert(!std::strcmp(cJSON_GetObjectItemCaseSensitive(schema,"type")->valuestring,"array"));
+    cJSON_Delete(schema);
+    auto* input=cJSON_Parse(R"([{"direction":"left","move_ms":880,"water_ms":0,"bubbles_ms":0,"ignition_ms":0}])");
+    char* encoded=cJSON_PrintUnformatted(input);
+    property.set_value<std::string>(std::string(encoded));
+    cJSON_free(encoded);cJSON_Delete(input);
+    auto scheduled_copy=property;
+    property.set_value<std::string>("[]");
+    ActionPlan plan;
+    assert(ParseActionPlan(scheduled_copy.value<std::string>(),plan));
+    assert(plan.count==1 && plan.steps[0].move_ms==880 && !std::strcmp(plan.steps[0].direction,"left"));
+    for (const char* invalid : {"null","[]","{}",R"({"type":"string"})"}) {
+        bool rejected=false;
+        try { (void)Property::Array("steps",invalid); }
+        catch(const std::invalid_argument&) { rejected=true; }
+        assert(rejected);
+    }
+    std::cout << "PASS: actual SDK array schema and owned value survive input release and copies\n";
+}
diff --git a/firmware/esp32-audio/tests/mcp_raw_json_test.cc b/firmware/esp32-audio/tests/mcp_raw_json_test.cc
new file mode 100644
index 0000000..b8b7ec5
--- /dev/null
+++ b/firmware/esp32-audio/tests/mcp_raw_json_test.cc
@@ -0,0 +1,30 @@
+#include "mcp_raw_json.h"
+#include "action_plan_json.h"
+#include <cassert>
+#include <iostream>
+
+int main() {
+    const std::string bad=R"({"steps":[{"direction":"left\u0000unexpected","move_ms":880,"water_ms":0,"bubbles_ms":0,"ignition_ms":0}]})";
+    auto* parsed=cJSON_Parse(bad.c_str());
+    ActionPlan plan;
+    assert(ParseActionPlanArray(cJSON_GetObjectItemCaseSensitive(parsed,"steps"),plan));
+    assert(!std::strcmp(plan.steps[0].direction,"left")); // Why the raw check is required.
+    cJSON_Delete(parsed);
+    const std::string params="{\"name\":\"self.tank.sequence\",\"arguments\":"+bad+"}";
+    const std::string payload="{\"method\":\"tools/call\",\"id\":7,\"params\":"+params+"}";
+    for(const auto& wire : {payload,"{\"type\":\"mcp\",\"payload\":"+payload+"}"}) {
+        auto* root=cJSON_Parse(wire.c_str());int id=0;
+        assert(RejectZeroInRobotMcp(wire,root,id) && id==7);
+        cJSON_Delete(root);
+    }
+    assert(McpJsonContainsZero(std::string("a\0b",3)));
+    assert(McpJsonContainsZero(R"("\u0000")"));
+    assert(!McpJsonContainsZero(R"("\\u0000")"));
+    assert(McpJsonContainsZero(R"("\\\u0000")"));
+    const std::string ordinary=R"({"type":"mcp","payload":{"method":"tools/call","id":8,"params":{"name":"self.tank.stop","arguments":{}}}})";
+    auto* root=cJSON_Parse(ordinary.c_str());int id=0;
+    assert(!RejectZeroInRobotMcp(ordinary,root,id));cJSON_Delete(root);
+    root=cJSON_Parse(R"({"type":"tts","text":"\u0000"})");
+    assert(!RejectZeroInRobotMcp(R"({"type":"tts","text":"\u0000"})",root,id));cJSON_Delete(root);
+    std::cout << "PASS: raw robot JSON rejects zero-prefix truncation without blocking ordinary stop or text frames\n";
+}
diff --git a/firmware/esp32-audio/verification-ct69.json b/firmware/esp32-audio/verification-ct69.json
new file mode 100644
index 0000000..58a0aa8
--- /dev/null
+++ b/firmware/esp32-audio/verification-ct69.json
@@ -0,0 +1,24 @@
+{
+  "version": "2.0.3-ct69",
+  "last_recorded_application": "2.0.3-ct45",
+  "flashed": false,
+  "scope": "Rejected native-array diagnostic, not current firmware or a deployment. Native MCP arrays, owned SDK values and raw JSON zero rejection; legacy web/internal format retained.",
+  "esp_idf_build": {
+    "version": "v5.5.1",
+    "bytes": 2718800,
+    "sha256": "305a9f08ffdcea465f55ed0eb4b1a2708bff83238cf43aa113da519bedcd5574"
+  },
+  "checks": [
+    "Complete ESP-IDF build passes.",
+    "Fifteen native array scenarios pass on plain and ASan/UBSan hosts, including deferred argument release, invalid shapes, zero-prefix refusal and semantic parity with ct68 on valid fixtures.",
+    "SDK array schema, owned copies, parameter and web/receipt sanitizer tests pass.",
+    "Eighty/eight expected intent requests and existing input/stop/relative/vague guards pass with explicit generated fixture wire-format projection.",
+    "Sixteen unified software check groups pass, including 98 Python improvement tests.",
+    "Both groups completed the original eighty/eight platform text suites once: baseline 77/80 and 5/8; candidate 75/80 and 4/8. All 176 complete RPC histories/final states reproduce through their pinned hosts.",
+    "Candidate violates the declared non-regression gate; not adopted. Platform baseline role and all original visible model parameters restored and reopened."
+  ],
+  "pending": [
+    "No device, speaker, actual motion or family acceptance.",
+    "Array input is not promoted to the main candidate; source is preserved as an experimental patch."
+  ]
+}
diff --git a/scripts/check_native_steps.py b/scripts/check_native_steps.py
new file mode 100644
index 0000000..62dd47e
--- /dev/null
+++ b/scripts/check_native_steps.py
@@ -0,0 +1,64 @@
+#!/usr/bin/env python3
+"""Exercise native array dispatch, queued ownership and raw input rejection; no IO."""
+import argparse
+import hashlib
+import json
+from pathlib import Path
+
+from capture_lingxi import firmware_replay
+from firmware_corpus import expected_commands
+
+
+def check(executable, baseline=None):
+    def text(value,ms=0):return dict(input_text=value,elapsed_ms=ms)
+    def call(name,args,ms=10,rpc=1,**extra):return dict(name='self.tank.'+name,arguments=args,elapsed_ms=ms,rpc_id=rpc,**extra)
+    step=dict(direction='left',move_ms=880,water_ms=0,bubbles_ms=1000,ignition_ms=0)
+    bubble=dict(direction='none',move_ms=0,water_ms=0,bubbles_ms=1000,ignition_ms=0)
+    rows=[]
+    def run(name,commands,verify,profile='corpus_idle',parity=False):
+        wire_commands=expected_commands(executable,commands) if parity else commands
+        wires=firmware_replay(executable,profile,wire_commands,await_stt=True)
+        replies=[json.loads(w['result']['content'][0]['text']) if 'result' in w else dict(result='rpc_error',message=w['error']['message']) for w in wires[:-1]]
+        row=dict(name=name,commands=wire_commands,profile=profile,passed=bool(verify(replies,wires[-1])),replies=replies,final_state=wires[-1])
+        if baseline and parity:
+            old=firmware_replay(baseline,profile,expected_commands(baseline,commands),await_stt=True)
+            row['baseline_full_reply_state_equal']=old==wires
+            row['passed'] &= row['baseline_full_reply_state_equal']
+        rows.append(row)
+    idle=lambda s:s['starts_this_boot']==0 and not any(s['logical_outputs'].values())
+    sequence=dict(steps_json=json.dumps([step,bubble]))
+    for defer in (False,True):
+        run('queued_array_owned' if defer else 'sequence_matches_legacy',[
+            text('左转并吹泡泡一秒，然后吹泡泡一秒'),call('sequence',sequence,defer=defer),
+            dict(flush=True,elapsed_ms=20),dict(inspect_ms=4000)],
+            lambda r,s:r[0]['result']=='accepted' and not s['sequence_active'] and s['starts_this_boot']>0 and not any(s['logical_outputs'].values()),parity=True)
+    for edit in ('replace_step','remove_step','cancel'):
+        args=dict(edit=edit,revision=7,step=2 if edit!='cancel' else 0,steps_json=json.dumps([bubble]) if edit=='replace_step' else '')
+        run('draft_'+edit,[text('把第二步改成泡泡一秒' if edit=='replace_step' else '删除第二步' if edit=='remove_step' else '取消草稿'),
+            call('get_status',{}),call('compose',args,20,2,defer=True),dict(flush=True,elapsed_ms=30)],
+            lambda r,s:r[1]['result'] in ('draft_saved','draft_cancelled') and idle(s),profile='corpus_draft7',parity=True)
+    invalid=[('encoded_array',dict(steps=json.dumps([step]))),('legacy_field',sequence),
+             ('both_fields',dict(steps=[step],steps_json=json.dumps([step]))),('empty',dict(steps=[])),
+             ('too_many',dict(steps=[step]*17)),('boolean_time',dict(steps=[dict(step,move_ms=True)])),
+             ('extra_key',dict(steps=[dict(step,unknown=1)])),('duplicate_representation',dict(steps=[step],_ct_ticket=1))]
+    for name,args in invalid:
+        run(name,[text('左转并吹泡泡一秒'),call('sequence',args)],lambda r,s:r[0]['result']=='rpc_error' and idle(s))
+    run('draft_disallows_water',[text('把第二步改成喷水'),call('get_status',{}),
+        call('compose',dict(edit='replace_step',revision=7,step=2,steps=[dict(bubble,water_ms=1)]),20,2)],
+        lambda r,s:r[1]['result']=='rpc_error' and s['show_draft']['revision']==7 and idle(s),profile='corpus_draft7')
+    run('raw_zero_refusal_and_failure_latch',[text('左转一秒'),call('sequence',dict(steps=[dict(step,direction='left\0unexpected')])),
+        call('move',dict(direction='left',duration_ms=880),20,2),call('stop',{},30,3)],
+        lambda r,s:r[0]['result']=='rpc_error' and 'embedded zero' in r[0]['message'] and r[1]['result']=='rpc_error'
+        and 'voice_input_failed' in r[1]['message'] and r[2]['result']=='ok' and idle(s))
+    return dict(scope='Actual native-array SDK/MCP with generated intent fixtures, virtual time and no board IO; wire-format projection is never applied to captured traces',
+        host_sha256=hashlib.sha256(executable.read_bytes()).hexdigest(),baseline_sha256=hashlib.sha256(baseline.read_bytes()).hexdigest() if baseline else None,
+        scenarios=len(rows),passed=all(r['passed'] for r in rows),failed=[r['name'] for r in rows if not r['passed']],results=rows)
+
+
+if __name__=='__main__':
+    p=argparse.ArgumentParser(description=__doc__);p.add_argument('--executable',type=Path,required=True)
+    p.add_argument('--baseline',type=Path);p.add_argument('--output',type=Path,required=True);a=p.parse_args()
+    result=check(a.executable,a.baseline);a.output.parent.mkdir(parents=True,exist_ok=True)
+    a.output.write_text(json.dumps(result,ensure_ascii=False,indent=2)+'\n')
+    print(json.dumps({k:v for k,v in result.items() if k!='results'},ensure_ascii=False))
+    raise SystemExit(0 if result['passed'] else 1)
