miclle/cybertrack/firmware/tests/README.md

# 主机控制、离线协议与通用运行层验证

日期：2026-10-24。范围：F0 C11 控制核心、F1 离线 MCP 适配及 F2a 通用运行层、逻辑输入处理及有界接收队列、接收边界与连接流程模拟，无 ESP-IDF、真实 GPIO／看门狗、网络、音频或物理负载。

环境：macOS arm64、Apple Clang 21.0.0、CMake 4.4.3、Python 3.14.7。执行：

```sh
cmake -S firmware -B build/firmware-host -DCMAKE_BUILD_TYPE=Debug \
  -DCMAKE_C_FLAGS='-fsanitize=address,undefined -fno-omit-frame-pointer'
cmake --build build/firmware-host
ctest --test-dir build/firmware-host --output-on-failure
```

结果：CTest 最终 23/23 通过，包含八组控制场景、24 个协议测试方法（含参数子用例及 500 次确定性消息变异）、16 组运行层、5 组输入处理和 4 组接收队列场景，以及解析器内存测试的 17 类逐次扫描与 3 组配置／恢复检查，另有 14 组连接场景、376 个穷举切分用例及 5 组长时会话压力场景。项目 C 代码开启 `-Wall -Wextra -Wpedantic -Werror`，AddressSanitizer 与 UndefinedBehaviorSanitizer 本次运行未报告错误。断言不依赖 `assert`／`NDEBUG`。源码哈希和执行记录见[验证记录](verification.json)。本次全量 23 项一次通过，总耗时 258.96 秒。

另以 `cmake -S firmware -B build/firmware-library -DBUILD_TESTING=OFF -DCMAKE_BUILD_TYPE=Release` 配置并构建通过，确认仅编译 C 库不依赖 Python 或测试传输。

## F0 控制核心

| 场景 | 已验证行为 |
|---|---|
| 上电／复位 | 初始输出为零，自检前不能使能，未使能拒绝动作，重新初始化不恢复输出 |
| 时限／互斥 | 期限前保留目标，期限时及延后 tick 撤销；活动期间其他动作拒绝、不排队、不延长；水枪和泡泡互不联动 |
| 停止／故障 | 停止撤销目标并锁定，持续按住无法使能；松开或故障解除不自行恢复；远程停止入口幂等 |
| 会话／重放 | 重复命令不重启；断线和活动中换会话撤销输出；新会话需重新本地使能；旧会话请求拒绝 |
| 非法参数 | 空请求、零序号、开始期限到达、零／超限时长、零／超限速度档、非法动作／方向拒绝 |
| 缺配置 | 全零限制时行走、水枪、泡泡全部不可用 |
| 计时异常 | 时钟回退进入故障并清零，仍回退时不能使能；结束时间加法溢出拒绝 |
| 方向／边界 | 四方向逻辑符号、速度档与时长上限，以及到时清零 |

## F1 协议与模拟传输

`protocol_host.c` 提供测试专用的行传输，`protocol_test.py` 驱动实际 C 实现，并用 Python 标准库独立解析每条响应。传输中的 `boot`／`enable`／`stop` 等是本地测试事件，不能暴露为云端工具。它不包含网络连接或硬件驱动。

| 场景 | 已验证行为 |
|---|---|
| 初始化与发现 | 协议版本、初始化门槛、工具 Schema、配置能力过滤、无分页、ping 与初始化通知 |
| 工具映射 | 四方向、行走／水枪／泡泡、配置边界、状态快照、动作互斥与到时撤销 |
| 参数与编码 | 缺参、额外字段、未知工具／方法／方向、负数／零／小数／指数／溢出／错误类型；非法 JSON、UTF-8、转义、重复键和深度限制 |
| 请求 ID | 字符串及正负安全整数回写，数字／字符串区分、Unicode／转义、长度与类型边界 |
| 去重 | 原响应回放；字段重排和等价转义不影响匹配；相同 ID 改参数拒绝；拒绝响应与旧状态快照也保留 |
| 缓存淘汰 | 16 槽 FIFO，命中不刷新；淘汰后旧动作／旧拒绝 ID 改成动作均拒绝；纯只读 ID 淘汰后可用于新意图，只读可重新计算，停止仍有效 |
| 时间与恢复 | 队列期限临界值、首次接收时间不刷新、无新鲜度依据拒绝、时钟回退和时间加法溢出；旧连接／跨本地使能代次的排队消息拒绝 |
| 停止与通知 | 停止在未初始化、缓存满、过期、无新鲜度依据、ID 冲突和缓存重试时仍撤销输出；动作通知不执行且不响应；停止通知执行且不响应 |
| 资源与防绕过 | 2048 字节帧边界、短响应缓冲与空指针拒绝；JSON 中伪造可信元数据拒绝；500 次确定性变异无非预期输出 |

可单独复跑协议测试：

```sh
python3 firmware/tests/protocol_test.py build/firmware-host/protocol_host -v
```

## F2a 运行层与假板卡

`runtime_test.c` 将真实运行层与控制／协议实现连接到可注入错误的假板卡，覆盖 16 组场景：

| 场景 | 已验证行为 |
|---|---|
| 启动顺序／缺配置 | 首个板级调用为关断；自检后保持禁止；缺失回调、零周期预算失败，零能力不启动负载 |
| 启动故障 | 自检、初始关断、时钟读取失败均禁止后续输出／喂狗 |
| 使能／停止优先 | 启动按住使能无效；释放停止后仍按住使能不能恢复；停止先于动作消息 |
| 空闲期限／远程停止 | 无消息也按期撤销输出；远程停止进入本地重新使能门槛 |
| 会话与使能代次 | 断线立即撤销目标，旧连接／跨使能的排队消息不能恢复动作 |
| 输入／时钟故障 | 输入读取失败、时钟回退或读取失败锁定，关闭会话并停喂；故障消失不自动恢复 |
| 调度／慢输出 | 超出周期预算、输出回调耗时超限锁定；不发送本轮接受响应 |
| 输出／关断失败 | 部分输出写入失败后独立关断；关断也失败时明确保留失败，不虚报输出为零 |
| 写入期间事件 | 写入期间停止或期限到达，返回后立即撤销目标；外部故障输入禁止动作 |
| 看门狗回调 | 喂狗失败锁定；回调期间到期或超预算后撤销输出，后续不继续喂狗 |
| 无效事件／异常消息 | 无效本地事件参数导致锁定；停止先于坏 JSON 解析，仍可返回协议错误 |
| 队列溢出／断线联测 | 当前输出撤销，排队动作丢弃；旧连接断线不影响新连接；重连不自动恢复使能 |
| 队列时效／使能联测 | 原始接收时间到期拒绝；跨重新使能的旧消息拒绝；两者均无输出调用 |
| 输入过滤器联测 | 两个运行周期之间捕获的短暂停止仍被处理；按住使能不恢复；稳定释放再按下恢复；过滤器失败进入 INPUT 运行层故障 |
| 解析内存失败联测 | 新解析／缓存重读内存失败后关断假输出；不再次写非零输出；缓存 accepted 不恢复动作；本地停止在持续耗尽时有效 |
| 内存与关断双重失败 | 关断失败锁定、停喂、清会话／缓存并抑制响应；保留仍有假输出的事实，后续可重试关断但不恢复运行 |

测试配置中的 1000／200／300 ms、速度档 3、50 ms 队列预算和 20 ms 周期预算仅用于分支验证。假板卡计时由用例推进，不证明真实调度、输出延迟或硬件关断。真实网络新鲜度、板上内存资源、真实流量下的长时容量、硬件看门狗、MCU 复位、物理停止、电源和液体均未验证；F2 整体及 V04、V08 尚未完成。

## 输入处理与接收队列

`inputs_test.c` 的 5 组场景覆盖：启动按住及按键抖动、停止／故障立即断言与释放抖动、已观察脉冲保留到读取、安全事件后的重新使能、零配置／空指针／时间回退／uint64 时间边界。

`inbox_test.c` 的 4 组场景覆盖：原缓冲复用后的消息副本、FIFO 与 100 轮环形下标循环、可信元数据原样保持、满队列关闭、断线清队列及优先通知、重连代次、旧连接回调、2048 字节／超长／空帧／嵌入 NUL／空指针边界。主机对象大小：inbox 8552 字节、消费 item 2128 字节；这不是 MCU 链接产物的内存测量。

全部输入与并发事件次序均由用例串行注入。真实 ISR 与跨任务竞争尚未测试；规范化 WebSocket 分片见下方传输联测，真实 SDK 事件映射尚未验证；不能据此认为未观察到的脉冲能被软件补获，或队列溢出在实际设备上有确定的关断延迟。

## 解析器内存故障注入

`protocol_memory_test.c` 连接实际协议库，使用测试专用 `fault_allocator.c` 注入失败。分配器逐块核对所有权、大小及释放，每次 handle 返回后要求存活块数和请求字节数均为零；失败的 realloc 保留旧块，由解析器释放。未拦截进程其他 malloc，也未修改 yyjson。

先对每类请求跑无故障基线，测得实际分配次数，再分别使第 1 至 N 次 allocate／resize 失败。每个位置运行一次单次失败和一次从该点开始持续失败，合计 **138 次注入**，其中缓存重读失败 36 次、resize 失败 50 次（两项可重叠）。17 类涵盖初始化、行走／水枪／泡泡、活动中状态和停止、停止／动作通知、重复／冲突动作、缓存停止、坏 JSON、无效封装、2048 字节紧凑／带缩进初始化及其缓存重读。

每次失败均验证 `-32603`、ID 是否可用、逻辑目标为零、需本地重新使能、原缓存／过滤器逐字节不变、FIFO 游标及序号／会话／初始化状态不变、无临时分配遗留。错误格式化没有后续分配。堆恢复后逐条重放旧缓存，要求原响应一致、无新动作。另有 3 组契约／恢复测试：启动期完整分配器配置与换会话保持；解析前门槛不申请内存及恢复后旧 ID 不重启；20 次连续耗尽后初始化恢复也不自动使能。

主机 ABI 下测得的请求字节统计：

| 样本 | allocate＋resize 调用数 | resize 次数 | 同时存活的 JSON 请求字节峰值 |
|---|---:|---:|---:|
| 普通行走 | 2 | 0 | 772 |
| 缓存行走重试 | 4 | 0 | 1544 |
| 2048 字节紧凑初始化 | 5 | 3 | 20868 |
| 上述请求缓存重读 | 10 | 6 | 41736 |
| 2048 字节带缩进初始化 | 7 | 5 | 18564 |
| 上述请求缓存重读 | 14 | 10 | 37128 |

这些数值只覆盖列明样本，排除 malloc 元数据／对齐开销、栈、输入／输出缓冲和静态缓存，不是所有输入的理论上限或 MCU 内存预算。当前 `ct_protocol` 对象为 137448 字节，包含 32 KiB 启动期过滤器及 FIFO 元数据，比加入窗口状态与接受序号前增加 56 字节；完整样本统计与源码哈希保存于 `verification.json`。AddressSanitizer／UndefinedBehaviorSanitizer 未报错；逐块台账用于明确检查注入路径释放，不把 macOS ASan 当成独立 LeakSanitizer 验证。

单独复跑：`ctest --test-dir build/firmware-host -R protocol_memory --output-on-failure`。Release 纯库构建不包含故障注入器。板上堆碎片、实际内存耗尽、任务栈和关断耗时仍待 F2b。

## 接收边界与连接流程

`link_test.c` 将实际 link、inbox、runtime、protocol 和 control 串联，使用假时钟、假板卡输出及模拟网络事件；没有真实 socket 或 SDK。14 组测试覆盖：

| 场景 | 验证结果 |
|---|---|
| 配置与握手门槛 | 非零预算、CONNECTING／HANDSHAKE 隔离、ready 后由 service 打开协议、提前数据无动作 |
| 分片／UTF-8 | 对含中文 ID 的消息穷举 376 个两段切分用例，分别模拟同帧回调和跨帧 CONT；另测逐字节和两层混合分片及穿插 Ping |
| 消息边界／通知 | 精确 2048 字节、空文本、NUL、空首帧、通知不产生响应 |
| 非法分片 | 孤立 CONT、重复／缺口／重叠、total／FIN／opcode 改写、空指针、零进度、SIZE_MAX、未知／二进制类型、控制帧违规和累计超长均关闭 |
| 分片期限 | 首片起固定期限，进度／Ping 不刷新；文本截断、CONT 未结束和控制帧未收齐在截止点失败 |
| 连接／握手期限 | 截止点到达即失败；迟到 connected／ready 不开放协议，周期控制继续运行 |
| 首片元数据 | 首片使能代次跨停止／重新使能后仍拒绝；首片空 proof 不能被末片新 proof 升级，接收时间保持不变 |
| 重连／迟到事件 | 新 attempt／session、半包丢弃、旧数据／关闭／发送确认不影响新连接，重复阶段回调不能回退时钟 |
| 断线清理 | 队列、待发响应及半包清除；必须应用断线、确认关闭并等待退避；跨重连按住使能不恢复 |
| 发送故障 | 显式失败、短写、超长报告、未取走即确认、无人取走／无确认／迟到确认均失败；不重发原响应 |
| 背压／本地停止 | 待发送时队列不消费，但本地停止仍关断；队列满导致断线；旧发送 ID 不能确认新响应 |
| 回调耗时／关断失败 | 运行层回调跨分片期限，本轮再关断并抑制响应；关断失败保留假输出事实、锁定并禁止重连 |
| 时钟／计数边界 | 回退锁定、UINT64_MAX 附近无期限加法溢出、attempt／发送 ID 耗尽不复用；已接受动作在 ID 耗尽后撤销 |

本测试连接／握手／分片／发送／退避预算为 30／30／15／12／5 ms，队列预算为 40 ms，控制周期预算为 20 ms，仅为合成用例。link 主机对象 21144 字节、发送副本 4120 字节，不含协议对象；没有新堆分配。单独复跑：`ctest --test-dir build/firmware-host -R '^link$' --output-on-failure`。

分片入口按规范化事件测试，不代表原始网络帧解析、真实 hello、TLS、二进制音频、跨任务同步、实际网络关闭延迟或端到端平台验收通过。尚无在线空闲心跳检测；未知断线仍由本地动作期限兜底。

## 长时会话与缓存压力

`protocol_stress_test.c` 用实际协议／控制库和所有权台账运行 5 组场景。累计 **163522 次协议调用**，虚拟时间推进 **120520500 ms**（约 33.48 小时）；实际测试在数秒内完成，不是实机连续运行或真实时间 soak。每次调用后核对缓存不超过 16 槽、游标合法、位数有界和所有临时分配释放。

| 场景 | 实测与断言 |
|---|---|
| 连续动作与淘汰 | 20000 个唯一 ID，轮流行走／水枪／泡泡，1 ms 合成时长；19593 个接受，407 个被过滤器保守拒绝。每个请求在完成后立即重试原响应，再从最早 ID 扫描全部旧请求，共 40000 次检查无新序号／输出 |
| 连续只读 | 同一启动期继续处理 100000 个状态 ID，包含 100 个 2048 字节帧；全部可读，输出为零；占用达到 120161／262144，且这 100000 次查询新增永久位为零 位。随后最早动作仍拒绝 |
| 会话恢复 | 500 次恢复，交替 close＋open 与直接 open；旧元数据丢弃。初始化和本地重新使能后，重新标记为当前元数据的旧 ID 仍拒绝；500 个新意图中接受 466 个、误拒绝 34 个 |
| 满缓存内存失败 | 注入首次分配持续失败，整个协议对象逐字节不变；输出撤销，堆恢复和本地使能后旧动作仍拒绝 |
| 过滤器饱和 | 测试专用注入全 1 位图，跨 close／open 保留；1000 个未缓存动作全部拒绝，1000 次状态查询及停止可用，无自动清空或恢复 |

累计 **40502 次重放检查**无动作再次执行。压力样本的临时 JSON 请求字节峰值为 7636；这是本组样本而非上限，解析内存故障测试的大帧缓存重读峰值仍为 41736。所有返回后的存活分配为零；固定协议对象 137448 字节，空间不随请求数增长。误拒绝次数是确定性测试语料的观测，不是任意输入的概率保证；过滤器高占用会损害动作可用性，实际容量仍须按板上预算和服务端流量评估。

Python 黑盒测试另验证 FIFO 命中不延寿、淘汰后只读快照重算、旧拒绝不恢复、驻留只读 ID 改动作冲突并退役，纯只读 ID 淘汰后不永久占用，以及跨重连的等价转义、UTF-8、空字符串与数字 `-0` 归一化。假传输测试新增四条丢响应恢复路径：显式失败、短写、无人取走、无确认；完成握手、本地重新使能后旧动作仍拒绝，新意图可执行。

单独复跑：`ctest --test-dir build/firmware-host -R '^protocol_stress$' --output-on-failure`。上述长时压力测试使用未绑定存储的 RAM 模式，保障限于同次启动的 RPC ID 和稳定意图；持久化绑定另由下方跨复位测试验证。换 RPC ID 与延迟首次到达由下方新鲜度集成测试覆盖；真实认证证据、SDK／平台重试兼容及 MCU 长时资源仍未验收。真实动作仍保持关闭。

## 持久化存储接口

独立 `replay_store_test.c` 的 4 组场景通过：278 次写入／建库中断、256 次单比特损坏、双槽恢复、会话与位图单调检查、空白介质显式建库、读取失败和不连续版本。假后端分别保存易失／持久字节；存储对象 65704 字节，两槽介质合计 65600 字节，无堆分配。协议接入与跨复位联测见下方；此独立测试只验证字节存储契约。见[持久化契约](../PERSISTENCE.md)。

## 跨复位协议与运行层联测

`persistence_test.c` 的 6 组场景通过：绑定／恢复、动作写入中断、介质与新会话写入失败、连续复位、拒绝意图与只读零占用、运行层写入顺序。依旧使用真实 C 库、假板卡和分离易失／持久字节的假存储，没有执行真实 Flash 或网络操作。

- **264 次动作写入故障**：六个回调位置 × 22 个字节边界 × 两种落盘模式。持久化失败不接受动作，锁定后停止／查询不再执行 I/O；复位后的旧已接受 ID 拒绝或因记录损坏继续锁定。
- **438 次跨启动重放检查**：包括旧会话元数据、当前会话重新标记、数据已完整落盘但 write／sync／read 返回失败、丢失响应与失败输出。没有旧动作再次执行；已落盘但未执行的意图也允许永久拒绝。
- **200 次连续复位**：100 个新动作，每个接受后重新构建控制器／协议／存储对象，再重试旧 ID；会话代次严格递增，动作序号、协议初始化、响应缓存、使能和输出不恢复。
- **6 条假板卡时序**：存储写入失败、两次 sync 共耗时 22 ms 超过 20 ms 合成周期、sync 期间观察到本地停止、物理输出回调返回失败、输出后未交付响应即复位。前三种没有非零输出写入；输出失败与丢响应后的旧 ID 在复位后拒绝；第六种是两次 sync 共 2 ms 耗尽剩余 1 ms 窗口，仍未超过运行周期预算，但输出前锁定，非零回调次数为零。每次非零输出回调前核对存储已保存当前过滤器，且易失／持久镜像一致。
- 缺失／空白／损坏／单槽丢失不能自动建库或回退 RAM；会话保留失败仅允许诊断连接。参数无效请求在持久化成功后也会消耗 ID；只读／停止 ID 仅缓存、不增加永久位；旧版本历史仍保留。

对象大小：协议 137448 字节，存储 65704 字节；每次写入固定槽大小，没有新堆分配。原 138 次解析分配故障及 163522 次 RAM 模式长时协议调用回归继续通过。ASan／UBSan 未报错；Release 纯库不含测试后端。重放断言和时序来自合成模型，不证明实际 Flash 可靠性、写入时延、磨损、物理停止或 OTA 迁移通过。

复跑：`ctest --test-dir build/firmware-host -R '^(persistence|replay_store)$' --output-on-failure`。必须由实际后端履行 sync 的持久化／顺序保证，此兼容模式不识别整体旧镜像；独立锚点绑定模式的回滚拒绝见下方新增联测。见[持久化契约](../PERSISTENCE.md)。

## 命令新鲜度与跨会话请求 ID

`freshness_test.c` 验证窗口签发、到期边界、会话／使能变化、窗口替换、缺失证据、时间倒退和计数溢出。`freshness_integration_test.c` 使用真实协议和双槽假存储，5 组共 **435 次协议调用、181 次拒绝断言、72 次写入中断**，无意外动作重放：

- 延迟首次到达、排队到截止点、旧窗口、原始会话或使能变化均拒绝；不能通过当前本地接收代次遮盖旧来源。
- 相同意图换 RPC ID、改参数、换窗口、缓存淘汰、重连或复位均拒绝；真正的新意图可重复相同参数。
- 已拒绝或驻留缓存命中附带的另一意图也保留历史；重启后不能更名恢复。已过期但从未执行的意图允许永久拒绝。
- 六个存储回调 × 六个切断边界 × 两种落盘模式；失败前已接受意图不能更换 RPC ID 重放。完整预留落盘但返回失败的意图，恢复后仍拒绝；不完整记录锁定动作。
- 当前会话停止通知不需要 proof，立即清除逻辑输出且不等待存储。

`link_test.c` 新增真实元数据保留场景：首片后续发窗口、末片提供新证据不能替换原证据；首次到达已晚于窗口拒绝。四种发送失败／丢响应路径均检查重连后新 RPC ID、同一稳定意图仍拒绝。`persistence_test.c` 补充输出前过期复核，见上一节。

旧回归用例通过测试专用 `synthetic_proof.h` 模拟新意图生产者；此便捷函数不得进入生产接收路径。长时压力生产者给同一动作保留稳定意图 ID。新鲜度集成测试独立保存创建时 proof，不在到达时刷新。真实网络认证、生产者生命周期和实际驱动延迟没有因此获得验收。

复跑：`ctest --test-dir build/firmware-host -R 'freshness|persistence|link' --output-on-failure`。包含四条换 ID 丢响应断言的最终完整 23/23 主机回归和 Release 纯库构建通过。纯库符号检查未发现测试分配器、假存储或合成生产者入口。

容量优化对照与迁移边界见 [CAPACITY.md](../CAPACITY.md)。新增断言验证只读流量不增加位数／写入、驻留读取 ID 被改成动作后永久退役；已有历史清位仍由存储层拒绝。

## 容量与离线迁移验证

`replay_migration_test.c` 的 4 组场景覆盖完整复制／清位拒绝、目标中断、连续迁移及不合法源／目标。**168 次目标回调故障**涵盖两次空白复核和两个槽各 6 次操作；每个位置测试 0、1、4、24、32796、32800 字节切断及两种落盘模式。失败不写源；该底层复制兼容测试仅在完整双槽可恢复时启动，其余保持动作锁定；实际 guarded 接入还要求目标已经由独立锚点选中。

**50 次连续迁移、441 次迁移相关重放检查**通过；每轮新目标接受新意图后，再次恢复仍拒绝旧意图，换 RPC ID 不能恢复。测试核对源未擦写、复制时会话与每个历史位保留；旧版只读位也原样保留。子集清理请求在写入前被拒绝，重新加载仍保留原记录。目标非空、介质在 EMPTY 加载后被占用、源读取失败、源快照过时、同一对象／context、版本加法溢出均拒绝。

迁移不改变双槽格式或介质大小；包含锚点字段与日志指针的当前存储对象为 65704 字节，无新增堆分配。主机 23/23 ASan／UBSan 回归与 Release 纯库构建通过；真实 Flash 和持久化分区选择尚未验收。单独复跑：`ctest --test-dir build/firmware-host -R '^replay_migration$' --output-on-failure`。

## 原子切换与回滚保护验证

`replay_switch_test.c` 的 6 组场景验证独立锚点契约：168 次目标复制中断、72 次受保护保存中断、22 次锚点失败；包含首次登记、提交结果不确定、回读失败、过时所有者、旧后端、旧快照、擦空替代介质、空锚点和 epoch 溢出。版本先由锚点预留；回归测试拒绝候选写完却报错后恢复旧介质并复用候选版本，以免产生不同内容的同版本快照。版本不一致不自动修复或回退；源介质不擦写，位图完整保留。

`switch_integration_test.c` 的 5 组场景通过锚点接入入口 `ct_protocol_attach_guarded_store`，拒绝普通未绑定存储；覆盖 176 次切换故障（168 次目标、6 次锚点、2 次源读取）、8 次动作锚点失败、8 次会话锚点失败、50 次连续切换与 6 种运行层顺序。732 次拒绝断言未出现旧动作恢复，包括换 RPC ID、丢响应、选择提交后返回失败、旧源重启及当前后端旧镜像。

非零输出回调断言历史已经持久、锚点身份／版本／会话与当前对象一致；锚点写入期间停止、周期超时、新鲜度耗尽或输出失败均不恢复旧动作。查询与停止在故障锁定后不访问锚点。接受动作前每次历史更新都提交锚点，不存在迁移后继续写入而锚点永久停在旧版本的空档。

复跑：`ctest --test-dir build/firmware-host -R '^(replay_switch|switch_integration)$' --output-on-failure`。完整 23/23 ASan／UBSan 回归、Release 纯库构建和测试符号排除通过。存储对象 65704 字节，其中锚点字段增加 56 字节、后续日志指针增加 8 字节；协议对象仍为 137448 字节。假锚点只模拟完整旧／新记录原子替换；实际防回滚、原子写、设备绑定、寿命、时延和固件降级保护未验收，见[切换契约](../ATOMIC-SWITCH.md)。

## 中断维护恢复验证

`replay_recovery_test.c` 的 5 组场景覆盖 168 次目标掉电／回调失败、8 次锚点失败、2 次源读取失败和 7 种历史缺失／冲突。正常启动拒绝单槽损坏；维护从当前锚点对应的完整快照恢复，逐字节保留位图且不擦写源。完整旧镜像、当前槽缺失／损坏、真实预留中断、有效未来历史、另一有效槽含额外位以及会话不符都拒绝，不写目标；空锚点、后端身份错误、非空目标和溢出也拒绝。

`recovery_integration_test.c` 的 4 组场景包括 176 次恢复故障（168 次目标、8 次锚点）、72 次原始动作写入中断、8 次原始锚点失败、50 次连续恢复；1239 次拒绝检查未恢复旧动作。覆盖选择已提交却报错、重启后旧源禁止使用、再次维护、旧 RPC ID／稳定意图、丢响应、显式新会话和本地使能。缺失当前快照时恢复失败，查询和停止不再访问故障存储。

单独运行：`ctest --test-dir build/firmware-host -R '^(replay_recovery|recovery_integration)$' --output-on-failure`。完整 23/23 ASan／UBSan 回归、Release 纯库构建与测试符号排除通过；56 项源文件 SHA-256 已更新。主介质与锚点布局未变；当前对象大小另含日志指针，无新增动态分配。本轮没有板级 Flash 驱动、实际维护授权入口或真实断电验收；证据不足时继续锁定动作，见[恢复契约](../RECOVERY.md)。

## 独立恢复日志验证

`replay_log_test.c` 的 8 组存储场景覆盖 **352 次日志中断**（过渡／候选两个阶段 × 每阶段 8 个操作 × 11 个头部／位图／CRC／标记边界 × 2 种落盘模式）、72 次主快照中断、12 次锚点失败、168 次恢复目标中断和 88 次单比特损坏。验证未选中候选不能在重试时复用 epoch／版本绑定、旧日志不能替代当前记录、主快照完全缺失时可从精确匹配日志恢复、源介质及原锚点精确匹配日志槽保持不变、计数耗尽不绕回；另有 100 次连续候选准备失败、日志换槽／兼容旧放置方式、重复匹配和未选中过渡记录拒绝。历史位丢失为 0。

`log_integration_test.c` 的 7 组协议／运行层场景使用 `ct_protocol_attach_logged_store`，缺少日志即锁定且不能降级。覆盖动作／会话各 352 次日志故障、72 次主快照故障、各 12 次动作／新会话锚点失败、176 次恢复故障，以及 **100 次原连续丢失主快照后恢复**。另有 **100 次候选准备中断后主快照丢失／恢复循环**，其中 25 次恢复目标再次中断后换空白介质重试；每次逐字节检查此前历史完整保留，重新握手后拒绝旧消息及换会话标签／换 RPC ID 重试，仅重新使能后的新意图可执行。共 5115 次拒绝断言未出现旧动作重放。已经被锚点选中的待处理动作身份也完整保留；旧 RPC ID、换 ID 后的旧意图、丢失原响应和退役后端均不能恢复动作。恢复后要重新初始化并本地使能，查询／停止在存储故障时仍有效。

6 种运行层场景检查日志 sync 失败、时延超预算、停止输入、输出应用失败、正常提交和输出前新鲜度过期；非零输出回调检查主介质、独立日志、锚点与协议历史均已一致且持久化。耗时来自假时钟，不表示板级时延。故障模型还覆盖“正文已持久化、旧 DONE 标记残留”形成完整快照的窗口，以及随后同步擦除标记导致快照不完整的窗口；正常启动仍以实际完整性与锚点一致性判断，不能只按失败操作名称推断。

完整 23/23 ASan／UBSan 回归、Release 纯库构建及四库测试符号排除通过。协议对象 137448 字节、存储对象 65704 字节、日志对象 32872 字节；双槽主介质 65600 字节、独立双槽日志 65632 字节。无新增动态分配，主快照与锚点布局不变，新增 CTLG v1 日志格式；锚点回调需支持 epoch-only 原子更新。每次历史更新写过渡与候选两个日志记录，合计四次日志 sync、两次锚点 CAS；主快照布局和双槽模式介质大小不变；当前日志对象因冗余指针增加 8 字节，四槽模式另见下节。56 项源码 SHA-256 与具体计数见 [verification.json](verification.json)。

复跑：`ctest --test-dir build/firmware-host -R '^(replay_log|log_integration)$' --output-on-failure`。真实 Flash、日志隔离、锚点耐久性／防回滚、维护授权、擦写预算与实物断电尚未验收。过渡记录先于尝试 epoch 提交，使候选准备阶段也保有精确匹配的完整日志；首次登记与带日志目标选择前已有完整目标日志，覆盖尚未产生首份过渡记录的窗口；旧的无日志存储在 attach 补种成功前仍依赖完整主历史。若主介质和精确匹配日志均不可用则锁定，不降版本，见[日志契约](../RECOVERY-LOG.md)。

## 首次接入与目标选择连续性验证

`replay_selection_test.c` 的 5 组场景覆盖首次登记日志、旧存储接入日志、切换目标日志各 **176 次故障**（8 个回调 × 11 个字节边界 × 2 种落盘模式），恢复日志 **220 次故障**（10 个回调，含源证据读取）、22 次锚点故障，以及 **100 次不经过会话开启或保存的连续恢复**。在选中后立即移除主快照，核验全位图不变；已有正确日志不重复写入，相同键的矛盾历史、重复匹配、错误 context、使用过的锚点和未选中候选均不能获准。

`selection_integration_test.c` 的 4 组场景覆盖首次登记／切换日志各 176 次故障、恢复日志 220 次故障、目标主快照 168 次故障和 22 次锚点故障。每次按实际锚点选择源或目标，并在任何 attach／open／save 之前移除选中主快照，再恢复到独立空白介质。另有 **100 次切换后立即连续两次恢复**：两个中间目标都在写首份过渡记录之前丢失主快照，最终仍可使用新会话和本地使能接受新意图，旧动作身份及上一轮新意图仍拒绝。

新增协议联测合计 **6987 次拒绝断言**，未恢复旧动作，历史位丢失为 0。测试逐字节核对完整历史；延迟会话消息和改写传输会话标签的旧证明分别检查，测试探测使用不同 RPC ID，避免被更早的 ID 防重放检查遮蔽。存储故障诊断中查询／停止不再访问存储。失败调用可能实际已提交，恢复始终以实际锚点为准，不按返回值猜测。新登记前的无日志历史必须经本地核验，测试不宣称能证明登记前没有回滚；旧存储接入日志未完成且主历史已丢失时仍锁定。

复跑：`ctest --test-dir build/firmware-host -R '^(replay_selection|selection_integration)$' --output-on-failure`。所有故障来自主机假介质／假锚点；本轮未接入板卡、实际 Flash、网络证据源或实物输出。

## 恢复日志冗余与损坏容错验证

`replay_redundancy_test.c` 使用显式四槽模式，覆盖两组交替副本的读取、写入和修复。6 组存储场景合计 **352 次单比特损坏、1056 次轮换中断叠加当前副本损坏、20 次容错读取失败、264 次补齐中断、264 次登记中断、528 次目标日志中断叠加损坏、34 次锚点故障叠加损坏，以及 100 次连续恢复**，历史位丢失为 0。单比特损坏覆盖四槽的头部、完整位图内部、CRC 与 DONE；轮换故障分别发生在过渡记录和新候选的两个副本中，随后再损坏实际选中组的任一副本并移除主快照。字节切点与原日志测试一致，部分落盘和未落盘两种模式分别验证。相同键有效 CRC 却不同历史、跨组重复键、两份当前记录失效、整体日志回滚均拒绝，不能回退另一组旧版本。

`redundancy_integration_test.c` 的 4 组场景覆盖 **动作／会话各 288 次轮换中断、144 次目标日志故障、24 次锚点故障、36 次主快照故障、8 种损坏场景及 100 次连续双重恢复**；7524 次拒绝断言未重放旧动作，历史位丢失为 0。包含后端切换与维护恢复目标日志中断、锚点不确定提交和主快照写入故障，再叠加单份日志损坏及当前主快照缺失。恢复后检查完整历史、新会话、本地重新使能、旧 RPC ID、换 ID 旧意图及延迟证明。循环测试在首次恢复后再次丢失一份日志和主快照，未打开会话就继续恢复，最后仅允许新意图执行。永久不可读槽可由剩余副本恢复到健康组，但随后轮换仍须双份写入；测试先确认动作锁定，再模拟本地修复介质后重新接入，不能静默接受单份提交。

既有 21 项回归继续保留，其中双槽模式仍严格拒绝重复记录／读取失败，四槽模式不替换这一兼容契约。冗余模式日志对象 32872 字节、比较缓冲 32768 字节、四槽介质 131264 字节；每次改变历史写四份日志、八次日志 sync、两次锚点 CAS。测试中的空白替换介质由夹具显式提供，不代表固件会自动擦除失败目标。这里的 CRC 与读故障模型用于意外损坏，不代表认证、真实磨损或共同故障域已验证。

复跑：`ctest --test-dir build/firmware-host -R '^(replay_redundancy|redundancy_integration)$' --output-on-failure`。完整数据及源码哈希见 [verification.json](verification.json)，板级 Flash、隔离、维护授权、时延和实物断电仍待验收。
