miclle/cybertrack/docs/audio-board-validation.md

# 面包板的源码核对与状态／停止联调

历史起点：2026-10-24。用户要求保留原彩菊绑定及已有音频、屏幕功能，添加 CyberTrack 状态和停止工具；不连接水枪，不开放执行器。

## 当前状态与证据范围

核对日期：2026-10-27。当前设备沿用 `bread-compact-wifi` 面包板，智能体管理名称已从“彩菊”改为“CyberTrack”，昵称“小D”。源码与最新有记录的部署为 **`2.0.3-ct21`**；本页 ct1／ct2 的两工具、无执行器和停止锁定语义属于历史阶段。

| 阶段 | 已完成记录 | 不代表的验收 |
|---|---|---|
| ct1／ct2 状态与停止 | ct1 两次工具回执崩溃已定位；ct2 修复后状态／停止、统一意图路由、扬声器和屏幕分项通过 | 不将 ct1 失败回填为通过，不等于所有语音表达或当前角色回归 |
| ct3–ct5 水枪接入 | GPIO18 控制端接反已纠正，ct4 喷水／BOOT 分项及 ct5 功率断开的可变时长调用通过，见[喷水记录](audio-water-validation.md) | 功率断开 30 秒记录不证明连续 30 秒带载 |
| ct6／ct7 集成 | 双电机迁线及四方向空载、行走／喷水并发、独立截止、BOOT 与语音停止分项完成 | 旧电源、约 60% PWM 和当时角色的结果不迁移为当前整机通过 |
| ct21 与样机 | 仅应用部署、配置保持、启动联网／输出全关；用户随后确认装车四方向正常，另有[运行影像](../artifact/README.md) | 部署检查未启动执行器；影像未绑定完整固件／供电配置，定量负载与停止仍未验 |
| 当前角色 | 2026-10-27 别名、纠错与动作成功静默规则已保存并回读，见[角色维护](agent-role.md) | 平台文本一致不等于设备已加载该文本或真人语音回归通过 |

当前八个工具、四路控制、网页与语音并用见[固件能力](../firmware/CAPABILITIES.md#当前面包板-ct21-接口)；部署与现场观察分别见[ct21 记录](../firmware/esp32-audio/startup-ct21.json)、[集成记录](breadboard-integration.md)及[并发记录](concurrent-actions.md)。执行回执仍无轮速、水流、出泡或火花传感反馈。

当前 GPIO 为电机 8–13、水枪 18、泡泡 17、共用点火低压 21，BOOT 为 0；麦克风 4／5／6、音频输出 7／15／16、OLED41／42 沿用原配置。照片位置及逐线核对边界见[接线总表](wiring.md)。辰克 5 V 电池已替代旧充电宝，USB 隔离／反灌、同源组合供电、真实断网／恢复、噪声／回声、最新角色语音回归、精确停止及复位／失电／独立切断继续待验，不以本页早期音频通过关闭整机验收。

## ct1／ct2 历史联调范围

以下备份、源码核对、语音和平台配置记录属于 2026-10-24。“当前”“本轮”“未连接执行器”及 USB／串口状态均按当时记录解释；旧角色文本和两工具能力不作为当前接口，原始哈希、失败和时间记录保留。本次仅同步文档，未查询平台、重启、烧录或触发动作。

## 设备与原始备份

实测 ESP32-S3 (QFN56) revision v0.2、16 MB Flash、8 MB 内置 PSRAM。平台“彩菊”设备页报告“面包板新版接线（WiFi）”和 `2.0.3`；其 MAC 与当前 USB 设备一致。设备标识、完整备份及校验清单仅存于本机 `secrets/caiju-30eda0a1977c-20261024/`，被 Git 忽略。

两次独立完整 16 MB 读取的 SHA-256 相同：`0d83e9d2dc783955af5dec75be8cb6052cc19f2e59e6f1ec0a18b12aa67e4165`。应用校验和及内置 validation hash 有效；原版本重新启动、联网并进入 idle。备份阶段未测试恢复写入。

## 源码与 GPIO

本机 `78/xiaozhi-esp32` 的源码提交为 `e8ed16bb42ed9b199cbc9376011653e5037de8d8`，原 ELF 哈希与备份应用描述一致，原应用二进制也与 Flash 对应区间完全一致。不是仅凭版本号选择一个近似固件。

原板型为 `bread-compact-wifi`，屏幕配置 SSD1306 128×32。GPIO、原按键行为、音频配置与重现方式见[适配说明](../firmware/esp32-audio/README.md)。麦克风使用 GPIO4，水枪台架 GPIO4 方案不适用于此板。配置核对不能替代实物接线测量。

## 本轮修改与验证边界

独立导出源码中新增两项端侧 MCP 工具，复用 CyberTrack 控制核心；没有 GPIO 执行器适配、使能入口或动作工具。移除上游 GPIO18 示例灯控工具的实例化，保留原有音频、屏幕与对话按键。`stop` 仅锁定本板逻辑状态，不宣称物理停止或跨设备控制成功。

原组件仓库中的 `image_player 1.1.0~1` 已不能重新解析；本轮使用本机原 48 项组件缓存的独立副本和本地路径覆盖，保留原版本。新旧有效 sdkconfig 比较无差异，板级 `config.h` 字节一致。

主机 ASan／UBSan 状态检查通过；ESP-IDF v5.5.1 构建通过，`2.0.3-ct1` 应用为 `0x26a590` bytes，小于原 `0x3f0000` 应用分区。新应用校验和及内置 validation hash 有效。以上均不是端到端语音联调完成证据。

真实上板结果见下文；`ct1` 失败，修正后的 `ct2` 已完成本轮无执行器状态／停止语音联调。

## 上板记录与修复

`ct1` 仅写入 `0x20000` 应用区并通过烧录哈希检查；写入前后 `0x8000..0x1ffff` 的 98,304 bytes 完全一致，覆盖分区表、NVS、OTA 数据与 PHY 配置。引导程序和 assets 未写入。平台仍显示原彩菊绑定及原绑定时间，固件变为 `2.0.3-ct1`。设备重新联网并进入 idle。

19:13:40 和 19:15:33，用户实际语音触发 `self.tank.get_status`，但设备在生成回执时发生 LoadProhibited 复位，未取得成功回执。用户观察到识别文字后显示扫描 Wi-Fi／检查更新，与重启日志一致。调用栈定位在 `CyberTrackAudioState::Call → snprintf → nano-vfprintf`；原配置开启 `CONFIG_LIBC_NEWLIB_NANO_FORMAT`，新增 `%llu` 与该精简格式化实现不兼容。主机标准库测试未覆盖此目标库差异。

修正版 `ct2` 使用整数 `std::to_chars` 转换 64 位计数／运行时间，再以字符串填入 JSON，保留原 sdkconfig；补充 UINT64_MAX 格式化检查。两次 `ct1` 复位不作为语音验收通过，不改 Wi-Fi 配置来掩盖此问题。自动下载模式握手失败后，用户按 BOOT＋复位手动进入下载模式，继续仅更新应用。

`ct2` 应用为 2,533,232 bytes，SHA-256：`9a9d312e57819450f6d83c0adfdfdac1b2d9e09073bfc72e0dac4b078879738c`。仅写入 `0x20000` 并通过烧录哈希校验；本次写入前后配置区 98,304 bytes 完全一致，SHA-256：`a5f6149f5c30c0ade8d13c8fea3e0df86bb0afc248605b94a5c9fe2f59418c14`。配置区允许在正常运行时由原固件更新，因此此处比较的是同一次写入前后，不要求与较早运行快照相同。

用户松开 BOOT 后单按 RST；重新连接只读串口观察器，19:24:07 记录 `2.0.3-ct2`、SSD1306 驱动及两项工具启动，19:24:14 进入 idle。平台设备页同步显示 `2.0.3-ct2`，仍为原设备和原绑定时间。语音三步重测结果如下。

## ct2 真实语音重测结果

同一次启动内，设备回执的启动标识一致、序号连续；灵矽“彩菊”聊天记录中三次工具名称及回执与只读串口观察一致。

| 本地时间 | 语音触发工具 | 序号 | 状态／原因 | 平台显示工具耗时 |
|---|---|---|---|---|
| 19:25:03 | `self.tank.get_status` | 1 | `DISARMED / none` | 70 ms |
| 19:25:42 | `self.tank.stop` | 2 | `FAULT / stopped` | 69 ms |
| 19:26:24 | `self.tank.get_status` | 3 | `FAULT / stopped` | 114 ms |

三次逻辑输出均为左右 0、水枪 false、泡泡 false；动作能力全部关闭，执行器后端未安装，无物理反馈。工具耗时为平台展示值，不是语音端到端延迟或实物停止时间。三次调用期间没有复位，停止后再次查询保持锁定。用户确认：三句已说完，扬声器回复与屏幕显示正常，没有再次出现扫描 Wi-Fi／检查更新。

本轮通过的是“音频 ESP32 → 灵矽自身会话 → 本板状态／停止工具 → 语音及屏幕回复”。Mac 仅烧录和只读记录串口，不参与语音／工具转发；未另行部署云端桥接服务。USB 本轮仍接 Mac，尚未进行改用独立电源的拔线运行测试。彩菊原绑定及现有配置保留，完整固件备份仍在本机私密目录。没有连接水枪或其他执行器，不代表整机音频、噪声环境、断网恢复、物理停止或喷水能力已验收。

已观察到的话术限制：原控制核心将主动停止表示为 `FAULT/stopped`，这是预期的停止锁定。彩菊回答中将它描述为设备故障／需要恢复，属于模型解释不准确；原角色提示词在该次 ct2 测试中保持不变，后续修正与实测见下文。没有新增远程解除锁定或使能工具，模型话术不会解除实际控制锁定。

## 平台角色调整

**ct2 历史角色。** 此处链接始终指向当前唯一维护源；历史文本和回复约定仅由当时记录／Git 版本追溯，不视为当前成功静默规则的验收。

完成上述语音测试后，用户授权按项目需要调整角色配置，并选择简单昵称“小D”。现有“彩菊”智能体的助手昵称设为“小D”，角色介绍替换为[项目角色规则](../firmware/esp32-audio/role-prompt.txt)：移除毒舌／指责要求，简短回答，查询和停止必须调用对应工具，正确解释 `FAULT/stopped`，无执行器时不声称物理动作成功。没有更改设备绑定、音色、模型或固件。旧配置仅备份到本机忽略目录。

平台保存和重新加载核对属于配置验证；此前旧提示词下的三次语音通过不替代新角色实测；后续实测结果见下文。固件唤醒词仍为“你好小智”。

## 小D角色重测与工具路由调整

用户重启设备后，19:33:41 观察到 `2.0.3-ct2` 启动，19:33:48 联网待机。本轮仍不接水枪。平台实际回复“我叫小D”，用户确认昵称、扬声器及屏幕正常，主动停止没有再被解释成设备损坏。

分离意图识别下的第一轮结果：

| 时间 | 平台转写／请求 | 实际工具及结果 |
|---|---|---|
| 19:34:23 | 你叫什么名字？ | 回复“我叫小D” |
| 19:34:36 | 小弟，查询一下你的状态。 | 调用 `self_get_device_status`，只读到网络／音量等信息；不是 CyberTrack 控制状态，不计为该项通过 |
| 19:34:52 | 小弟停止所有动作。 | `self_tank_stop`，本板序号 1，`FAULT/stopped`，所有逻辑输出关闭 |
| 19:35:19 | 再查一下，现在是不是还保持停止？ | `self_tank_get_status`，同次启动序号 2，仍为 `FAULT/stopped` |

停止后的实际回复为“所有动作输出都已关闭，目前处于停止锁定状态”，并说明未接执行器、只确认逻辑状态；复查回复“仍保持停止锁定”。这两项平台回执与串口一致，期间没有观察到复位。ASR 将口述“小D”转写成“小弟”，不影响这两项调用；昵称自称仍正确。通用设备工具返回的信息不足以证明音频／屏幕实物正常，这部分依据用户现场确认。

为修正首次泛称状态时的选错工具，按已授权配置范围将平台从“分离意图识别”切换为“统一意图识别”，保存后重新进入页面核对。昵称、角色介绍、聊天模型和音色保持不变。[官方配置说明](https://linx.qiniu.com/docs/xrobot/guide/agent-config)说明统一模式由聊天模型直接决定工具，分离模式使用另一意图模型且不再推荐。此调整经设备加载后重新实测，结果如下；不将单轮成功扩展为所有说法的可靠性保证。

### 统一意图识别重测通过

用户再次重启后，19:37:38 记录同一固件 `2.0.3-ct2` 启动，19:37:46 待机。本轮没有烧录、更改 GPIO 或接入执行器。

| 时间 | 工具 | 序号 | 状态／原因 | 平台显示耗时 |
|---|---|---|---|---|
| 19:38:18 | `self_tank_get_status` | 1 | `DISARMED / none` | 67 ms |
| 19:38:46 | `self_tank_get_status` | 2 | `DISARMED / none` | 131 ms |
| 19:39:44 | `self_tank_stop` | 3 | `FAULT / stopped` | 122 ms |
| 19:40:06 | `self_tank_get_status` | 4 | `FAULT / stopped` | 128 ms |

首次转写仍为“小弟，查询一下你的状态。”，这次正确选择 CyberTrack 状态工具。最初只收到两句查询，没有停止转写／调用，因此未将第二次查询误记为停止后验收；提示用户补测停止和复查后，收到表中序号 3、4。四次回执的设备及启动标识一致，序号连续，所有逻辑输出保持关闭，平台回执与板端记录匹配，观察窗口内无复位／panic。

停止后的实际话术为“停止指令已执行”“所有动作输出已关闭并保持锁定”“目前是正常停止状态，不是故障”；复查说明“仍保持停止锁定状态”“这是你刚才主动停止后的正常锁定”。没有继续将 `FAULT/stopped` 解释为硬件损坏，也没有建议重启或自动解除锁定。用户确认已说完、扬声器／屏幕／停止锁定表述正常，并确认补测完成。

结论：新昵称“小D”已在第一轮实际语音确认；统一模式下，相同泛称状态请求、停止和停止后的状态查询已通过本轮实测，原角色介绍与音色保持。当时平台配置为“小D＋统一意图识别”。这不是带载、实物停止、长时运行、所有自然语言说法或语音紧急停止可靠性验收；仍不接水枪。私密证据保存在 `build/audio-private/xiaod-role-session.jsonl`、`xiaod-unified-session.jsonl` 和对应平台记录中，不提交录音、凭据或原始设备配置。

## 2026-10-25 面包板供电针位照片

用户提供当前面包板主控的[正面原图](../hardware/components/breadboard/front-20261025.jpg)，原样保存，SHA-256：`c9e655b45ef52ec002579f7c48717ccaefce72f30182035489584614ed6861f4`。照片方向为元件面朝向观察者、天线在上、双 USB 在下；左排最下面为 `GND`，倒数第二针丝印为 `5Vin`。按此输入标识选用稳压 5 V 正极接 `5Vin`、负极接 `GND`，不沿用另一块独立台架板的实物验收。

该证据仅确认照片可见针位和布局；没有背面／逐网通断核对、稳压器完整型号确认、USB 隔离／反灌或供电能力测量。当时用户选择与电机升压模块共用旧充电宝 5 V 分支，见[历史方案](power-and-interfaces.md#面包板与电机共用充电宝2026-10-25)。后续电源已改为辰克 5 V 电池，A1 已确认 SW2 只切执行器、主控继续运行，见[当前电源方案](power-and-interfaces.md)。照片仍只支持针位辨识；当前端接、同源带载、保护、USB 隔离／反灌及恢复行为未完成验收，不沿用历史 USB 实测。
