miclle/cybertrack/docs/validation/ct78-voice-regression.md

# ct78 新角色与 11 个工具：无实物语音回归

2026-11-01 完成 30 个预先固定场景、35 轮语音，全部正常结束。严格工具、参数与顺序匹配 **33/35 轮、28/30 场景**；发现一次明确时长错误和一次漏调停止却声称已停，**当前候选不满足上线条件**。本轮不修改固件或角色内容，不补跑替换失败，不替代原固定 80 条成绩。

输入是 macOS Tingting 合成普通话，经 16 kHz 单声道 Opus 发送到灵矽真实 STT／模型；所有工具回执来自冻结的 ct78 实际 MCP 分发器、回调和控制守卫。时钟、距离与 IO 为主机模拟，没有设备转发、麦克风拾音、扬声器播放、串口操作或执行器动作。点火与狂暴模式只验证参数和逻辑状态。[预先计划](evidence/ct78-voice-regression/plan.json) · [语料](evidence/ct78-voice-regression/cases.json) · [主机来源](evidence/ct78-voice-regression/host-manifest.json)

## 分项结果

| 范围 | 严格工具匹配 | 观察 |
|---|---:|---|
| 同时组合 | 4/4 | 两路及四路组合均正确传递独立时长 |
| 顺序执行 | 3/4 | S01 把明确左转一秒写成默认 880 ms |
| 独立停止 | 3/4 | T04 未调用 stop，却回复动作已停 |
| 暂不执行／预览／否定 | 6/6 | 无工具调用、零启动；回复内容仍有问题 |
| 查询、单项、调速 | 8/8 | 覆盖其余工具；本轮全部 11 个工具均实际被模型调用 |
| 同连接连续恢复 | 4/4 场景、9/9 轮 | 保留同一 WSS 会话、连续主机时钟与实际 STT 输入代际 |

逐轮转写在保留顿号、数值及单位的归一规则下匹配 33/35。B04 的顿号被转成逗号；D01“调到”转为“掉到”，两例工具参数仍正确。不得将这个逐字统计直接称作真人语音识别准确率。

全部 STT、RPC 顺序、完整回执、各轮结束时状态和最终状态均由同一主机程序离线重放一致；没有工具先于该轮非空 STT。回执结果符合预期为 29/30 场景，但这不包含参数语义判定：S01 的错误时长也会得到 accepted。[完整评分与重放](evidence/ct78-voice-regression/review.json) · [原始压缩轨迹](evidence/ct78-voice-regression/capture.json.gz)

## 两条必须修复的失败

- **S01：明确时长被默认值覆盖。** 原话及识别均为“先左转一秒，再吹泡泡两秒”，模型提交两步 sequence，但第一步 `move_ms=880`，应为 `1000`；第二步泡泡 `2000` 正确。固件按传入参数执行并完成，因此设备拒绝门不能纠正这类合法但不符合原话的参数。
- **T04：无回执却宣称停止成功。** 原话正确识别为“停止”，没有任何工具调用，回复却为“动作都停下了，我在这儿等你。”该例主机初态为空闲，没有活动动作，也没有模拟输出残留；仍必须算漏调用和虚假确认。T01／T02 的活动序列及 T03 的活动行走均直接一次 stop，取消／关闭状态正确。R04 的第二轮停止也正确；不能用这些成功抵消 T04。

本轮没有原角色的同条件对照，不能断言两条失败由移除剧场引起，也不能用恢复原角色推定问题已经解决。

## 连续恢复的实际路径

| 场景 | 同一连接内的语音和回执 |
|---|---|
| R01 | 空闲“全速” → set_speed 返回 rejected；新语音“左转一秒” → move accepted，只有一次新启动 |
| R02 | 空闲“快一点” → adjust_speed 返回 rejected；新语音“吹泡泡一秒” → bubbles accepted，只有一次新启动 |
| R03 | “前进两秒，先别执行” → 无调用、零启动；新语音“现在前进一秒” → move accepted |
| R04 | 已有序列时“喷水一秒” → RPC 拒绝；新语音“停止” → stop ok、取消整单；再说“喷水一秒” → water accepted，旧序列后续泡泡未启动 |

拒绝后均没有自动重试、拆单补做或额外启动。R03 属于模型不调用后的新指令，不是设备拒绝后的恢复；与另外三组分别解释。每一轮等待实际 TTS stop 后才发送下一轮，未覆盖回复中抢话、多人交叉输入或失序网络。

## 回复与播放仍未通过

- B03 夹有英文过程描述；N01／N02 朗读规则分析。
- N01 说“这段我先记下了”，N03 继续询问如何编排，未清楚说明已无表演编辑／预览能力；没有实际保存工具调用。
- N05 朗读 `move`／`water` 工具名称；R01 拒绝后主动建议先走一段再调速。
- 普通动作成功仍有确认文字与远端音频。ct78 播放策略逐包回放共抑制 456 包、保留 1353 包；保留包同时包含应保留的查询／拒绝解释及未抑制的成功确认，不能把总数当作错误数或扬声器听感。[播放回放](evidence/ct78-voice-regression/playback.json)

下一步先针对“明确时长优先”和“停止必须取得真实回执”做可比较的修正，再以本轮失败及连续恢复场景复测；成功后再扩大直接动作固定集。独立评估播报与拒绝解释，不以工具匹配代替回复通过。

## 平台与部署边界

本轮临时保存仓库 5809 字符候选角色，并从列表重开逐字核对；采集后回读仍一致。可见模型为 `deepseek-v4-flash`，温度 0.7、Top P 1、频率惩罚 0、最长 500 token、thinking disabled、reasoning_effort low、usage 开启。模型名称是页面配置，不是服务端身份签名。

结束后已保存并重开核对原 5991 字符角色，模型参数逐项保持；没有设备重启、刷写或配置加载验收。设备最近记录仍是 ct77，仓库仍是 ct78 候选。[候选回读](evidence/ct78-voice-regression/platform-candidate.json) · [采集后回读](evidence/ct78-voice-regression/platform-after-capture.json) · [恢复回读](evidence/ct78-voice-regression/platform-restored.json)

## 复算与采集器验证

```sh
python3 scripts/review_voice_scenarios.py \
  --capture docs/validation/evidence/ct78-voice-regression/capture.json.gz \
  --corpus docs/validation/evidence/ct78-voice-regression/cases.json \
  --executable build/ct78-full-host/firmware_host \
  --output output/voice/ct78-regression/review.json
```

`capture_lingxi.py` 的可选 `followups` 只发送后续原话及合成音频，不发送预期工具、结果或评分规则。只支持真实 STT 与固件主机组合，等待前轮正常结束后继续；超时或中止不跳到下一轮。记录各轮边界及完整连续状态，保留失败且拒绝覆盖捕获文件。回归测试覆盖单连接、输入历史保留、中止不续发、逐轮状态被篡改、未完成不计通过、错误调用被设备拒绝仍计模型失败、查询后停止及缺 STT 等边界。

原始压缩轨迹与主机二进制复算需要完整 checkout；参考包仅附文本材料与审阅摘要。来源、文件摘要及本地检查见[实验清单](evidence/ct78-voice-regression/experiment.json)。原始轨迹只保存合成输入、转写、调用、回执及丢弃音频的大小，不含认证信息或录音。
