miclle/cybertrack/docs/validation/delivery-audit-20261031.md

# 产品改进交付与验收核对

> 本页为对应旧版本的历史验证；涉及的表演编辑已退役，不代表 ct78 能力。[当前退役说明](theatre-removal.md)

核对日期：2026-10-31。模型卡片交付基线 `b827cf7`，本次增加真实消息驱动验收，源码与最近记录部署均为 ct45，见[部署证据](../../firmware/esp32-audio/startup-ct45.json)。结论是**总体目标未完成，剩余关键路径包括平台语义修复、家庭与实物观察**。I11 已通过真实宿主消息独立触发、GUI 修改／保存重开／恢复与同卡片回执验收。本文没有缩小 [I01–I13 原目标](../improvement-plan.md)，也不把材料／软件交付改称现场通过。

## 按原完成条件核对

| 项目 | 已核对的交付依据 | 仍缺的完成证据／后续动作 |
|---|---|---|
| I01 亲子定位 | [五组体验流程](README.md)、匿名记录字段；家长陪同定位已明确 | `family_sessions` 为空；需五组实际体验，至少三组主动重复玩法，并形成定位判断 |
| I02 首次上手 | [上手卡](../quick-start.md)、ct45 内含网页帮助；[浏览器／构建记录](../../firmware/esp32-audio/verification-ct45.json) | ct45 已部署；真实手机检查与至少 4/5 家庭在约定网络下三分钟独立上手并停止 |
| I03 语义与语音 | [80 条文本集](voice-cases.json)、[20 条口述引用](spoken-cases.json)、[8 条编排增量](compose-cases.json)和独立评分器 | 角色修正后真实平台固定文本工具 77/80（96.25%），禁止样本无动作调用；[轨迹已交付](lingxi-ct45-20261031.md)，成功静默未通过，真人仍缺 |
| I04 停止与恢复 | [17 案例、每配置至少 85 次的采集与分析入口](stop-trials.md)；来源隔离、执行／间隔阶段分列 | [真实记录](stop-trials.json)中配置和试验均为 0；需原始输出／机械停止／距离证据、恢复观察及每条件五次记录 |
| I05 供电、续航、成本 | [电源预算与来源分类](../../hardware/architecture/README.md)、测量与成本字段 | 六场景均为 `insufficient_data`；`power_runs/cost_items` 为空；需额定资料、三次相同流程实测及有来源成本，不能从容量推验收 |
| I06 编排确认 | [设备契约、网页编辑及确认](theatre-removal.md)、ct44／ct45 主机与浏览器验证 | ct45 部署和角色同步、设备草稿编辑／取消／释放失效已通过；真实隔离工具发现已完成，编排 5/8 未达标；设备网页／五分钟到期／非法输入拒绝通过，有效确认执行与语音来源失效仍待验 |
| I07 泡泡剧场 | 登场／庆祝／谢幕三个行走与泡泡模板、逐步编辑及预览 | 五组家庭中至少三组主动重玩或修改；网页台词提示不等于机器人播报或表情联动 |
| I08 回执解释 | [最近回执与只读说明](../status-explanation.md)、实际适配代码与网页回归 | 真实平台合成状态 8/8 只查询，角色修正后完整解释要求仅 4/8；需修复未知原因猜测、恢复暗示和等待语义，真实故障／听感另验 |
| I09 维护性 | 补液、清洁、取瓶、换电池及线束维护采集流程 | `maintenance_trials` 为空；先取得基线、确定最慢两项，再实际改结构并验证耗时下降 ≥30% 与十次拆装，当前不能选两项随意修改替代 |
| I10 工程交付效率 | [版本真源](../current-status.md)、统一检查、[实际修改记录工具](engineering-log.md) | 本地已有四次修改记录绑定提交与验证证据；人工／等待／返工计数缺失，完整样本仍为 0/5，不能倒填历史或以提交数凑指标 |
| I11 模型辅助设计 | 0.9.2 已安装；[整机 GUI 验收](../../tools/solidcue/verification-gui-20261031.json)通过：198 件整机中的冠盖修改／保存重开／恢复，本地页面同步 r5 → r6 → r7，材质顺序回归修复及 README 实拍已交付 | [真实消息驱动链路](../../tools/solidcue/verification-message-20261031.json)已通过，I11 接入完成：新评论独立触发冠盖 Z=0 → 4 → 0 mm，原卡片 r9 → r10 → r11；其余 197 件和正式模型不变。单次验证不扩大为任意建模或物理验收 |
| I12 硬件架构 | [H01–H06 架构与参考矩阵](../../hardware/architecture/README.md)：电源树、管理／保护、回流、接口、部件造型、来源与取舍 | 需回填负载预算、冻结 U2/U3／保护／开关额定及真实针序，分别完成电气、噪声、装配和负载验收；CAD／规格不能代替实物 |
| I13 灵矽方案 | README 独立章节、[多方面解决方案](../lingxi-solution.md)、[可复现参考包](../../tools/lingxi-solution/README.md) | 真实平台隔离调用及失败反馈已交付；家庭与物理效果仍缺，不等于完整落地或官方认证 |

## 首次核对记录（历史基线 `8b1d64f`）

- `main` 与 `origin/main` 均为 `8b1d64f`，核对开始时工作区干净。
- ct45 验证记录列出的源码哈希全部一致，`build/firmware-ct45/xiaozhi.bin` 与记录 SHA-256 一致；记录明确 `flashed=false`、`platform_synced=false`。没有重新刷写或改线上角色。
- 家庭、故障、供电、成本、维护采集数组均为空；`output/voice`、`output/validation` 没有实际轨迹／观测文件。模板不是实际结果。
- 工程记录已绑定 `8b1d64f` 与实际插件协议检查；记录窗口约 241 秒，仅覆盖安装准备到提交，不包含此前实现和排查，也不是人工或模型净用时。
- 生产 `hardware/model/CyberTrack.FCStd` 哈希仍与原生研究件验证的来源一致；未以设计工具验收为名改正式模型。
- SolidCue 本地服务在 `127.0.0.1:9473` 监听。FreeCAD RPC 本次仍返回连接拒绝，桌面工具本次仍报告 Mac 锁屏；没有尝试绕过锁屏或重启带有未知未保存文档的 FreeCAD。

## 恢复顺序

1. **模型设计已收尾**：消息驱动的原生修改／回读／恢复及同卡片回执已通过，数据保持 r11；迟到 r7 评论已识别为完成并恢复，没有重复修改。
2. **候选与灵矽联调**：具备设备和可观察条件后，核对 ct45 应用、候选角色与 13 个 SolidCue 工具／12 个机器人工具各自所属链路。机器人先验证工具发现与无执行器轨迹，再逐项实物；SolidCue 工具不能混写为灵矽机器人运行工具。
3. **现场实测与家庭体验**：按既有停止、供电、维护和亲子脚本采集，不安排高压测试。维护结构改进由测得的最慢两项决定，电源器件定值由实际额定与负载决定。
4. **持续真实工程记录**：后续有实际修改时从开始采集，不制造额外提交或估填未知时间来凑五次样本。

当前 FreeCAD 与新版宿主插件均已连接；用户已明确暂时无法配合实机。家庭、停止、供电、成本与维护记录仍为空，ct45 已部署且角色已同步，平台模型调用已采集但语义未全部通过，见[联调记录](lingxi-ct45-20261031.md)。没有可用的真实观测可替代这些验收，目标保持未完成。README 继续呈现亮点与价值，进度与缺口从 TODO／执行计划进入。

## 整机模型设计补充核对

本轮已交付仓库内模型设计工具 0.9.2、198 件整机实际本地 UI 截图，以及冠盖 Z=0 → 8 → 0 mm 的原生保存回读证据。正式模型不变，其他 197 件不变，实际同一本地页面更新通过。见[整机验证记录](../../tools/solidcue/verification-assembly-20261031.json)。此前锁屏／连接限制是当时状态；本轮整机使用 FreeCAD 主机进程完成，桌面宿主消息自动触发和 GUI MCP 完整闭环仍待验收，总目标未完成。

## GUI 验收续记

用户解锁并确认独占 FreeCAD 后，已通过真实 GUI MCP 的冠盖修改／恢复、保存重开和 198 件指纹核对；197 件非目标不变，同一本地页面更新 r5 → r6 → r7。无界面材质归档顺序缺陷已修复，217 个显示状态回读一致，README 已更新为 GUI 修改后的实拍。见[GUI 验证记录](../../tools/solidcue/verification-gui-20261031.json)。此前锁屏与 RPC 断开已解除；此阶段的旧连接超时已在后续重启解除。后续真实宿主卡片的评论、AI 回执和同卡片更新／恢复通过，见[宿主记录](../../tools/solidcue/verification-host-20261031.json)；当时尚未验证独立 app 消息触发；后续已补齐，见下一节。

## 消息驱动验收完成

新评论 `3b7c4fb0-0f07-48ef-9a16-16d2335230d0` 在 r9 保存后，通过实际 `mcp_app` 消息独立触发处理；当时尚未修改原生模型。文档、版本、评论哈希与原生 UID／指纹核对后，完成冠盖 Z=0 → 4 → 0 mm、GUI 保存重开、原卡片 r9 → r10 → r11 及最终回执。198 个指纹与 217 个显示状态恢复，其他 197 件和正式 FCStd 不变。I11 接入验收完成；记录见[消息驱动验证](../../tools/solidcue/verification-message-20261031.json)。其余平台、家庭、实物和工程效率完整样本条件未因此改变。
