miclle/cybertrack/docs/validation/delivery-audit-current.md

# 产品改进交付核对

核对日期：2026-11-01。当前源码为 **ct78 未部署候选**，最近记录的设备应用为 **ct77**。I06／I07 已取消，其余验收条件保留；历史草稿成绩不代表当前能力。[退役与本地验证](theatre-removal.md) · [版本真源](../../firmware/current.json)

## 当前结论

- ct78 已删除独立剧场及相关接口和角色规则，保留直接组合、序列与停止保护。本地构建和回归见[验证记录](../../firmware/esp32-audio/verification-ct78.json)；尚未刷写或同步角色。以下 ct76 及更早结果为历史依据。

- 用户暂缓实机；[ct76 分句改稿门禁](history/draft-clause-duration.md)已完成反例复现、19 组实际 MCP 主机与完整构建。它阻止跨分句数字掩盖含糊修改，不证明模型语义或播报通过。[4000 字符角色对照](concise-role.md)首轮改善但复测漏停，已撤回并恢复原角色与参数；108 个比较槽位保留中断与超时，不提升原完整语音成绩。

- ct75 [HTTP 零转义校验](http-zero-admission.md)保留旧版失败，复用 MCP 原始扫描器；完整构建、实际 HTTP 原生回归及[十八组统一检查](evidence/ct75-http-zero/software-checks.json)通过，含 124 项 Python 测试；随后完成[仅应用部署及 22 次无动作 HTTP 检查](ct75-deployment.md)，五类非法请求拒绝、草稿保持与合法查询／取消／空闲停止通过。首启 NVS 的 PHY 校准及连接令牌变化已记录，Wi-Fi／用户设置保持；不增加模型／物理成绩。

- ct74 软件基线（提交 `fa88ec2`）的[十八组软件检查](evidence/ct74-dialogue-beeps/software-checks.json)全部通过，含 124 项 Python 测试；检查发生于提交前，以记录中的源码哈希对应最终实现。普通提示与语音共存的原生检查通过，已完成[仅应用部署和零动作检查](ct74-deployment.md)，首轮用户反馈对话中提示暂缓、回复不卡；结束恢复、移远不补播及再次靠近三项由用户选择跳过，本轮不再请求，不计验收通过。此前 `1698f28` 的[软件检查](evidence/delivery-audit-20261101/software-checks.json)作为历史记录保留。
- 最新一次原 80／8 全集的[合成普通话 → 实际 STT → 固件主机回归](full-stt-ct71.md)为严格工具 **77/80、编排 6/8**，八条明确停止正确；V064 的模型禁止调用仍计失败，即使设备拒绝。它不是真人拾音或机械停止验收。
- ct73 [四路组合播放匹配](four-lane-feedback.md)十二条定向实际 STT 为 **10/12**，五条匹配组合新增抑制 277 个确认音频包；F004 共享时长、F010 识别／漏调用和 F011 过程播报仍需处理。定向结果不替换原固定集成绩，包级抑制不等于扬声器听感通过。
- I11 模型辅助设计已在约定范围内完成：正式 FCStd 与既有宿主消息验收的来源哈希一致，三张历史截图文件均存在且哈希匹配。其余项目仍有模型、真人、实机或真实工程观察缺口。

2026-11-01 现场阶段更新：[ct73](../../firmware/esp32-audio/startup-ct73.json)已仅应用部署，配置／非应用区校验、两次启动联网及二十条零动作状态回读通过。软件和平台成绩仍按各自采集版本解释；随后新增的架空功能观察见下文，不等于地面负载、量化停止或完整真人语音验收。

现场首项结果补充：[ct73 架空行走](ct73-deployment.md#首项现场结果未通过)请求被接受，但用户明确反馈两侧履带都没转；用户随后反馈手机网页控制正常，用户确认手机为 100%；同样 500 ms 请求在 100% 下复核两侧转动并停止，60% 未转原因仍未定。电机或供电故障尚无依据。该诊断未通过，不关闭 I04，也不增加正式物理停止覆盖。

用户随后确认 BOOT 实际立即停止且松开未恢复；首条真人左转并停止、动作无播报获现场确认。三条后台问句已回查，保留状态未先查询等问题；测距滴声伴随卡顿引出的 [ct74 修正](dialogue-range-beeps.md)已部署，首轮对话听感符合预期；结束恢复、移远不补播及再次靠近三项由用户选择跳过，本轮不再请求，不计验收通过。

[设备草稿回归](history/device-drafts-20261101.md)另完成 27 次实际 LAN 请求，23 条控制状态零启动。单步修改隔离、旧版本／窗口／序号拒绝、释放及租期失效后的草稿清除符合预期；运行版本未独立读取，开机时刻与部署记录的偏移保留。未确认表演或发送动作，不关闭 I04／I06。

## I01–I13 验收表

| 项目 | 已交付及依据 | 尚未满足的完成条件 |
|---|---|---|
| I01 亲子定位 | [五组家庭观察流程与统计工具](README.md#从五份原始观察复核两项指标)、离线观察单 | 五组实际体验，至少三组主动重复同一玩法，形成定位判断 |
| I02 首次上手 | [上手卡](../quick-start.md)、ct45 网页帮助、断线与停止指引 | 至少四组家庭在约定网络下三分钟内独立使用并停止 |
| I03 工具选择与语音 | 固定语料、独立评分器、实际平台轨迹；[否定输入保护](negative-input-admission.md)及[完整语音回归](full-stt-ct71.md) | 收敛禁止调用、多余查询、无查询状态判断及过程播报；完成三种收音条件、20 条真人语音、成功静默与扬声器验证 |
| I04 停止与恢复 | [来源／时刻矩阵和固件回放](stop-trials.md)、现场采集与分析器；[同步停止回执](stop-dispatch.md) | 每条件至少五次现场记录；分别测输出关断与机械停止，核验旧动作不恢复及独立切断 |
| I05 供电、续航与成本 | [电源预算](../../hardware/architecture/README.md)、续航／成本分析、六盘打印估算 | 实际额定与采购来源、三次同流程续航、启动及组合负载测量 |
| I06／I07 独立剧场 | 已移除，见[退役记录](theatre-removal.md) | 用户取消，不再作为验收门槛；不记作通过 |
| I08 回执解释 | [明确拒绝解释](admission-envelope.md)、采样时刻说明、成功确认与限制提示分开回放 | 新表达、未知原因不猜测、定时播报时刻、限制提示与成功静默的真人／物理反馈 |
| I09 维护性 | [取瓶路径](../../hardware/model/water-bottle-service.json)、维护计时与拆装分析工具 | 实物基线确定最慢两项；结构修改后耗时降低至少 30%，完成十次拆装记录 |
| I10 工程交付 | 版本真源、源码／部署文件摘要、统一检查、分阶段提交与参考包；[离线配置复核](nvs-config-review.md)已复算 ct75 原快照；既有技术修改记录已绑定结束记录 | 五次完整真实效率样本仍为 0/5；人工用时、模型等待、返工与失败等未知字段须真实观察，不能从提交间隔推算 |
| I11 模型辅助设计 | [0.9.2 接入验收](../../tools/solidcue/verification-message-20261031.json)：198 件整机、宿主评论独立触发、GUI 修改／保存重开／恢复、同卡片 r9→r10→r11；README 截图已交付 | **既定接入条件已完成**。支持范围仍是零件位置研究及符合条件的单件参数修改，不代表任意 CAD 修改或制造验收 |
| I12 硬件架构 | [H01–H06 架构、回流／接口／保护与来源取舍](../../hardware/architecture/README.md)、A2 图纸、预算工具 | [实际器件与参数确认](../../hardware/schematic/parameter-confirmation.md)、U2/U3 与保护定值、真实针序、噪声／负载／温升、装配与电气验证 |
| I13 灵矽方案 | [独立方案章节](../lingxi-solution.md)、参考包、七组历史文本评分与完整 STT 评分离线复算、失败与复现边界 | 收敛当前模型失败，补齐家庭与实际执行效果；材料可复算不等于整机解决方案全部验收 |

## 已核对的外部条件

[本次观测](evidence/delivery-audit-20261101/observations.json)保留可复核的计数和哈希。

1. **现场配合已恢复，完整记录仍缺。** 家庭、故障、供电、成本、维护循环和维护计时的采集数组均为空，停止试验的 profiles／trials 也为空。此前分项台架和用户反馈仍有效，但不覆盖当前整机与新电池的指定验收。2026-11-01 用户提供设备地址并确认主控独立供电；已授权并完成 [ct73 部署与无动作检查](ct73-deployment.md)，进入实际动作与停止采集。
2. **平台可见模型没有新的已配置候选。** 本轮只读核对账号选择器，仍为 DeepSeek、豆包、通义千问极速版三项，自定义模型列表为空；没有保存或更改配置。[可见状态](evidence/delivery-audit-20261101/platform-availability.json)只证明此账号界面，不是供应商或后台请求身份认证。[现有模型／参数对照](model-parameters.md)已有失败记录，替代方案未采纳，原 5991 字符角色与原参数保持。
3. **播报出口还缺上游依据。** [协议观察](tts-protocol-observation.md)未获得可靠的最终回复阶段字段或上游错误记录，`action=thinking` 也出现在必要提示中，不能直接屏蔽。[工具轮中继原型](llm-tool-round-relay.md)尚未采纳：最终分析仍可能透传，工具轮必要限制可能丢失，整轮缓冲时延未测；真实模型和 HTTPS 接入未配置。
4. **工程效率观察仍缺。** 37 条技术记录已闭合，但完整效率样本为 0/5。ct71 全语音记录的 finish 是本轮补做的行政绑定；记录起止间隔不等于实际工作、人工用时或模型等待，不据此计算效率提升。

## 后续执行顺序与退出依据

- **模型／平台：** 取得可区分最终回复与过程文字的上游事件依据，或实际可用的不同模型接入条件后，对现存失败逐条对照，再重跑原 80／8 固定集。保持失败计分，不扩大词语纠错或静默匹配来掩盖模型错误。本地中继只有必要提示、最终回复、工具闭环和时延均验证后才可考虑采纳。
- **设备／现场：** 在部署条件及授权明确后核验新候选；依次采集首次连接与停止、三种收音条件、有效版本表演、断线与恢复、组合负载／温升／续航和维护基线。网页静默断线按现有两秒租期检测，租期内可能进入下一步；长按通道 600 ms 租期另列，均不能当作机械停止时间。
- **亲子与工程：** 由真实观察形成五组家庭记录和五次完整修改效率样本，再复算原定位、上手、重玩及效率指标。涉及电源与保护的定值须依据实际 SKU、针序和测量，不能用软件检查补足。

本表只维护当前结论。早期部署与桌面状态见[首次核对](delivery-audit-20261031.md)；ct57–ct73 的累计核对文本保留在[本次整理前的固定提交](https://github.com/miclle/cybertrack/blob/1698f28c47e07c7affcec5255682e9face6e4297/docs/validation/delivery-audit-current.md)，各专题原始证据继续保留。参考包的 98 项离线测试和评分重算只支撑包内材料复现，完整控制重放、真人和实物验收分别进行。
