miclle/cybertrack/docs/validation/lingxi-role-5991.md

# 取消正在执行的表演与删除草稿

> 本页为对应旧版本的历史验证；涉及的表演编辑已退役，不代表 ct78 能力。[当前退役说明](theatre-removal.md)

灵矽平台已保存 5991 字符角色，重新打开后的全文 SHA-256 与仓库一致。面包板重启后仍运行 ct45，八份回执均为零启动、所有逻辑输出关闭。[平台回读和重启依据](../../firmware/esp32-audio/role-cancel-hold-ct45.json)

## 新角色配 ct45 工具

三轮各使用七条不带前缀的原话，分别观察停止与长按。21 次会话全部结束，平台实际请求留在隔离环境。[逐轮调用与回复](evidence/role-5991/target-review.json) · [旧角色基线](status-role-focus.md)

| 原话或场景 | 三轮结果 |
|---|---|
| “取消序列”／“取消正在执行的表演” | 六次都只请求一次无参数全停。旧角色对两种说法都先操作草稿。新角色六次仍返回了口头确认。 |
| “取消这个还没开始的草稿” | 两次先读版本 7 再取消，一次用版本 0 直接取消，夹具拒绝。三次均未调用全停。 |
| “不要取消序列，让它继续” | 三次均未停止、改稿或发新动作。两次回执显示正在普通行走、没有活动序列；仍有回复说序列继续运行。 |
| 网页长按／定时动作均剩 400 ms | 对长按三次都预告即将停止。定时题三次说不足一秒；都未明确限定为采样时刻。 |
| 已经到期 | 三次均回答行走已结束；有一次读出了字段名，一次先播报查询意图。 |

为核对六个全停调用在固件里的效果，再把同一批调用送入 ct45 的离线控制守卫。此处单独创建一段真实的软件序列，第一步向前四秒，第二步吹泡泡一秒。按平台实测的请求到达间隔（1017–1326 ms）送入全停，六次在调用后和第 6000 ms 都是全路关闭、序列已取消，启动计数保持 1。没有发出全停的对照中，第二步正常启动。回放运行在受控时钟和无设备 I/O 的主机，不测机械停车或真人语音。[控制组及逐次回执](evidence/role-5991/stop-replay.json)

## 长按回执的固件对照

三轮使用相同角色、用户原话、捕获器和时钟偏移，第二轮调换候选顺序。给灵矽分别提供 ct49 与 ct50 导出的工具和实际固件代码生成的三份回执。十二个工具中只有状态工具说明改变；三个回执中只有长按状态的 `status_facts` 有差异。原有数值字段完全相同。18 次会话都正常结束，每次仅请求一次状态。

| 相同问题，不同工况 | ct49 | ct50 |
|---|---|---|
| 网页长按，续租剩 400 ms | 0/3 能解释总时长未知且不报倒计时；有一条同时说“看什么时候松手”和“还剩约 0.4 秒” | 3/3 说明取决于松手，没有预告停车秒数 |
| 四秒定时行走，剩 400 ms | 3/3 说明是刚查询时约 0.4 秒 | 三次均限定采样时刻，两次说约 0.4 秒、一次说不到一秒；三次都接着推测现在应该已停，缺少新的采样依据 |
| 已经到期 | 3/3 回答没有正在行走 | 3/3 回答没有正在行走 |

例如 ct50 第一轮长按回复为“当前行走是由网页长按控制的，什么时候结束要看松手，我没法给你报具体秒数。”这里测的是工具说明和回执解释共同起效的结果。喷水和泡泡的长按标识已在固件主机测试中核对，本组灵矽问答只测了行走。[逐轮回复及轨迹校验值](evidence/role-5991/hold-comparison.json) · [固件构建](../../firmware/esp32-audio/verification-ct50.json)

在对应固件源码下生成 `receipt_replay` 后，可以用以下命令导出三条冻结用例。给隔离捕获器传入同版工具描述，启用 `--raw-text` 并使用导出的用例；它们已有固件回执，无需再开启动态时钟模式。

```sh
python3 scripts/export_hold_cases.py build/audio-host/receipt_replay output/voice/ct50-hold-cases.json
```

## 已部署 ct45 工具的完整回归

同一个线上角色使用 ct45 工具定义，完成 80 条固定语义用例和 8 条编排用例。每条输入都按固定集约定附带场景上下文，平台的工具调用由隔离夹具应答。评分逐条核对工具、参数和调用顺序。[评分摘要](evidence/role-5991/full-suite-scores.json) · [80 条调用与回复](evidence/role-5991/full-voice.json.gz) · [8 条编排调用与回复](evidence/role-5991/full-compose.json.gz)

| 检查项 | 本轮结果 |
|---|---|
| 固定集工具调用 | 78/80（97.5%），达到 95% 目标。V040“全速”在正确设置速度前多查一次状态。V053“你现在在做什么”没有查询就回答待命。 |
| 停止与禁止动作 | 八条明确停止用例均直接全停。两组用例均未出现禁止的工具调用。 |
| 编排工具调用 | 7/8。C002 直接用版本 7 修改第二步，回复中说要查询，实际没有请求状态。 |
| 云端静默 | 45 条要求静默的用例均有云端回复。设备端是否播出需另验。 |

全部联调结束后对同一块 ct45 回读八份状态样本。设备仍处于角色同步后的同一次启动，各路逻辑输出均关闭，本次开机动作启动计数为零。真人拾音、扬声器和机械停车留待现场验收。

### C002 缺少查询时，草稿究竟有没有改

把上一轮 C002 的原始改稿调用按实测到达时间（输入后 2357 ms）分别交给两个版本的固件主机程序。两者初态相同，网页保持在线，草稿版本为 7。ct45 接受只带正确版本号的调用，把第二步泡泡从一秒改为两秒，版本升到 8。ct50 返回 `draft_changed`，版本仍为 7，第二步仍为一秒。给同一条调用补上前置查询后，两版均成功保存。四次对照中第一步左转 880 ms 完整保留，动作启动计数均为零。ct50 另测了读取时效边界，间隔 29999 ms 的编辑通过，恰好 30000 ms 的编辑被拒。[原始调用、对照及最终草稿](evidence/role-5991/draft-version-replay.json)

随后让同一线上角色重做 C002，交替使用 ct45 和 ct50 的工具描述及对应固件回执，各三轮。六次均先实际查询再改第二步，回执确认版本从 7 升到 8，其余步骤未变，家长仍需在网页确认开始。原来的失败仍计入固定集的 7/8。[逐轮文件及哈希](evidence/role-5991/draft-version-replay.json) · [复测方法](lingxi-capture.md#用固件回执验证只改第二步)

### 只给“你现在在做什么”时的回执

去掉固定集的场景前缀，对 ct50 候选分别设置正在按 70% 前进、当前空闲两种初态，各询问三次。六次平台都先查询一次，回复和到达时的固件采样一致。行走组三次查询时分别剩余 2682、2917、3038 ms，空闲组三次都答待命。固定集 V053 漏查的记录保留，当前证据覆盖这句原话和这两种工况。

同角色另测“前进！”“全部停止。”“吹泡泡！”和超限喷水，各三轮。十二次都有云端回复。用 ct50 播放策略回放每条的真实事件顺序，九条短指令的首个音频包均被抑制；三条超限请求的首包均保留。云端的限幅说明仍有重复。[逐轮状态、回复与播放结果](evidence/role-5991/status-audio-review.json)

### 亲子改稿的三种说法

再次从配置页读取角色全文，5991 字符与仓库吻合。使用 ct45 的 12 个工具和同版固件主机回执，在灵矽逐字发送[三条新原话](draft-edit-variants.json)。每条独立建会话，三轮均正常结束。家长网页中的初稿是左转 880 毫秒，再吹泡泡一秒。每次平台调用都按实际到达时间处理，另在主机读取本轮结束后的草稿和输出。

| 孩子怎么说 | 草稿回读 |
|---|---|
| 开头转圈留着，后面的泡泡吹三秒 | 3/3 先查后改，左转保留，只改第二步为三秒，版本从 7 升到 8。 |
| 删掉最后的泡泡，保留开头 | 3/3 先查后删，只留下左转，版本升到 8。 |
| 结尾泡泡短一点，还没想好几秒 | 3/3 只查草稿，追问具体秒数，原有两步和版本 7 保留。 |

九次固件主机回读均为零启动，全部逻辑输出关闭。六次完成编辑后，回复均请用户在网页预览并点开始。三次“改三秒”里有两次返回英文操作说明，第一次还读出 `replace_step`；删除时三次都先播报要查草稿。工具结果正确，面向孩子的回复仍需缩短。这里使用文本输入，测试没有连接执行器或记录音频。[逐条回读与回复](evidence/role-5991/edit-variants-review.json) · [第一轮轨迹](evidence/role-5991/edit-variants-1.json.gz) · [第二轮](evidence/role-5991/edit-variants-2.json.gz) · [第三轮](evidence/role-5991/edit-variants-3.json.gz)

[改稿旁白的工具说明对照](history/draft-narration.md)记录同一组用例的首个音频包、保存回执先后和逐次回复。
