miclle/cybertrack/docs/validation/model-parameters.md

# 平台模型参数的原话对照

> 本页为对应旧版本的历史验证；涉及的表演编辑已退役，不代表 ct78 能力。[当前退役说明](theatre-removal.md)

2026-10-31 解锁后，通过新建内置浏览器页面恢复配置访问，重新打开 CyberTrack 角色页与模型参数。此前已有页的连接不可用，不再作为当前阻塞。5991 字符角色逐字回读，含末尾换行的 SHA-256 与仓库一致：`7f286df244df131de1271d1fcb0a82c5374998a2590cba7eb099645a4c4d9127`。

## DeepSeek 温度对照

保存前回读的模型是 `deepseek-v4-flash`，温度 0.7、Top P 1、频率惩罚 0、最长回复 500 token。模型专属字段为 `thinking: {"type":"disabled"}`、`reasoning_effort: low` 和返回 usage。思考已关闭，不能把过程播报归因于“思考没关”。这些是页面配置；WSS 响应没有独立的模型身份或生成参数确认。

只将温度改为 0.2，保存后重新打开回读，再对 C005“开始这段表演”和 C008“第二步短一点”各做三次独立原话会话。工具定义、5991 字符角色、语料、完整 MCP 主机和捕获程序保持不变。没有修改固件或将工具调用转发给设备。[配置与捕获摘要](evidence/model-temperature/experiment.json) · [逐条回复及草稿](evidence/model-temperature/review.json)

| 观察项 | 结果 |
|---|---|
| 正常结束 | 6/6 |
| 严格工具匹配 | 0/6：六次均多查状态，其中一次还提交改稿 |
| 草稿误改 | 一次 C008 将第二步从 1000 ms 改为 500 ms，版本 7→8 |
| 启动与最终逻辑输出 | 全部零启动、输出关闭 |
| 从输入到结束中位数 | 26.7 秒 |
| 过程文字 | 六次均仍有规则分析或操作说明 |

**不保留低温度设置。** 此前原说明、温度 0.7 的[诊断基线](history/compose-routing.md)为 2/6 匹配、中位数 15.1 秒；两组分时采集，样本少，不能将数值差异确定归因于温度，也不声称设置在所有请求上更差。本轮已足以说明它没有解决这些用例的多余查询、误改和过程播报，不进入完整固定集成绩。

六次捕获均已按原 RPC 编号和时刻通过相同二进制重放，MCP 结果和终态逐项一致。结束后将温度恢复 0.7、保存并重新打开；Top P、惩罚、长度和高级字段均回读与原值一致。原值与实验值的本地截图摘要见实验清单，截图位于 `output/model-parameters/`，不随参考包分发。整个过程没有重启或刷写机器人，真人声音、扬声器和实物表现仍未验收。

完整 checkout 可查看六份原始轨迹，独立核对完成标记、调用与终态：

```sh
python3 - <<'PY'
import gzip, json
from pathlib import Path
root = Path('docs/validation/evidence/model-temperature')
for path in sorted(root.glob('temperature02-*.json.gz')):
    row = json.loads(gzip.decompress(path.read_bytes()))['results'][0]
    state = row['host_final_state']
    print(path.name, row['completed'], row['calls'],
          state['show_draft']['revision'], state['starts_this_boot'])
PY
```

模型对照另行记录：先保持角色、工具、主机及通用参数，再比较明确改稿、含糊追问、开始确认与停止。模型专属参数按实际页面回读，不将 DeepSeek 的参数结构复制到其他模型。定向结果不替代完整固定集或现场验收。

## 通义千问极速版对照

保存并重新打开模型配置，确认平台标签为“通义千问极速版”；通用参数仍为 0.7／1／0／500，联网搜索和 `enable_thinking` 均关闭。角色逐字回读与上文哈希一致。这是页面提供的名称，不推断具体底层模型版本。[六次定向配置与轨迹索引](evidence/model-qwen/targeted-experiment.json)

C005 和 C008 各三次均不调用工具、不改草稿，直接说明网页确认或询问秒数，未出现过程分析。随后完整运行原 80 条语义与八条编排，保留了定向测试没有发现的失败：[完整评分](evidence/model-qwen/full-suite-scores.json) · [逐条失败审阅](evidence/model-qwen/full-review.json) · [语义轨迹](evidence/model-qwen/full-voice.json.gz) · [编排轨迹](evidence/model-qwen/full-compose.json.gz)

| 检查 | 结果 |
|---|---|
| 正常结束 | 88/88 |
| 语义工具、参数与顺序 | 68/80，未达门槛 |
| 明确停止 | 7/8；V049“停止泡泡”没有调用 stop |
| 禁止动作样本 | V079“动一下那个东西”错误调用 move，模拟主机启动前进 |
| 编排工具与顺序 | 7/8；C002 的单步修改误传两步数组，被实际解析器拒绝 |

V049 回复“已停止泡泡”，但没有工具调用；其预置活动序列在结束时仍运行。V002、V013、V025、V039、V040 也有无调用却确认动作／调速的回复；V027、V038 则把伪工具表达式作为语音文字。V053、V058 未查询就回答状态／距离。编排 C006 虽未调用工具，却说“已取消”，原草稿仍在；工具分数不能替代这些回复语义审阅。

**不保留这版模型配置。** 六次定向成功没有覆盖完整指令范围，不能以较短回复抵消漏停、含糊请求启动和虚假确认。88 行完整 MCP 结果与终态已通过同一固定主机逐项重放；其中行走、点火等均为无执行器逻辑，不是实机动作或硬件验收。历史 DeepSeek 成绩保持原样，模型对照不替换原固定集。

## 豆包诊断与最终恢复

再选择页面现有“豆包”，保存后重新打开，核对通用参数为 0.7／1／0／500、`reasoning_effort` 为 minimal；两个标为“返回 usage”的页面字段均保持原样，未猜测其底层键名。角色哈希仍一致。先选取二十条语义用例，覆盖通义千问的失败、明确停止与含糊输入，再运行全部八条编排。[配置与恢复回读](evidence/model-doubao/experiment.json) · [评分](evidence/model-doubao/suite-scores.json) · [逐行回执与终态](evidence/model-doubao/review.json)

| 检查 | 结果 |
|---|---|
| 语义诊断 | 18/20；这是选定子集，未运行其余六十条，不是完整集成绩 |
| 八条明确停止 | 8/8 工具匹配；云端仍返回确认文字 |
| 含糊动作 V079 | 错误调用 move，主机启动前进 |
| 完整编排 | 3/8；C005、C006 出现禁止的直接动作／停止调用 |
| 畸形步骤参数 | C002、C007；另有失败后的多次自动重试 |

C005“开始这段表演”先请求取消草稿，被拒绝后又调用 sequence；两步在虚拟主机中运行，启动计数为 2，结束时输出虽已关闭，也不能算“未启动”。C006“不要编排表演”却调用全停并清掉草稿。C004 没查版本就取消，实际被拒绝，仍说“草稿已取消”。V038 的实际调速回执是 80%，云端却额外说 90%。这些结果均不符合既有约定。

**不采纳豆包配置，也不继续扩大该诊断的语义样本。** 二十八行原始 MCP 与终态已重放一致；模型名仍仅为平台标签。当前已恢复并保存原 `deepseek-v4-flash`、温度 0.7、Top P 1、频率惩罚 0、500 token、thinking disabled、reasoning_effort low 和 usage 设置。保存后重新打开模型与参数，角色仍为原 5991 字符哈希。恢复截图摘要见实验清单，内置页面保留供继续操作。

本轮新增 128 次独立平台会话：低温度六次，通义千问六次定向加 88 条完整集，豆包二十八次。均为原话文本与无执行器主机，未重启、刷写或下发真实设备动作。当前正式工具和角色源没有因此改变；声学、家庭与物理验收继续待办。

## 设备约束与评测器的后续工作

换模型不能替代设备约束。此次失败显示，同一次输入中，在改稿拒绝后转用直接动作，以及重试／补做，仍可能被另一个合法业务工具接受。后续 ct62 候选已按识别输入绑定请求代际，并阻止本轮失败后的动作、调速及改稿；停止与查询保留。八组边界与四条原请求回放通过，C005 的 sequence 补做被拒绝、启动数由旧记录两路变为零。这是离线控制回放，没有更新上述模型成绩；首次意图错误、真实 STT 时序和迟到网络请求的关联限制仍存在，见[失败隔离](voice-input-guard.md)。

评测器原来会因捕获的畸形 `steps_json` 抛错，无法输出整组成绩。现将这类实际请求记录为失败，并在 `invalid_tool_argument_cases` 与逐条错误中保留；语料自身错误、缺少调用名称或非对象 arguments 等记录结构问题继续报错。非法参数、禁止调用、漏停、缺例及未完成会话仍分别统计，评分门槛保持不变。加入对应回归后，完整项目测试 76 项通过。

## reasoning_effort none 的独立对照

[单参数定向试验](tts-protocol-observation.md)按当前 DeepSeek 官方文档尝试 `none`，其余设置不变，保存重开确认后八条均返回统一异常，明确停止也未调用工具。未采纳并恢复原 `low`；恢复后的独立实际 STT 停止检查正确。没有服务端请求／错误日志，不断定根因；不能把页面能保存等同于链路兼容。原模型、角色及部署保持，不将这一诊断算作完整评分。
