miclle/cybertrack/docs/validation/device-drafts-20261101.md

# 设备草稿的无动作回归

2026-11-01，通过设备现有 LAN HTTP 接口完成 27 次请求。初始草稿为空、无活动序列、逻辑输出全关，动作启动计数为 0；未覆盖已有用户草稿。最后释放本次网页会话。没有请求 `show_confirm` 或任何执行器动作，也没有重新安排用户已跳过的听感检查。

## 结果

[完整脱敏回读](evidence/device-drafts-20261101/http.json)与[独立摘要](evidence/device-drafts-20261101/summary.json)保留请求、结果和边界。23 条包含控制状态的响应均为零启动、逻辑输出全关、无活动序列。

| 检查 | 设备结果 |
|---|---|
| 保存两步草稿 | `draft_saved`，revision 1，内容与请求一致，零启动 |
| 仅替换第二步 | revision 2；第一步逐字段保持，第二步按请求更新 |
| 用 revision 1 取消新稿 | `draft_changed`，revision 2 与全部步骤保持 |
| 重用已消费窗口／重复序号 | 分别返回 `stale_request`／`duplicate_request`，新稿保持 |
| 删除第一步／取消当前版本 | 删除后仅留下原第二步；取消后草稿为空 |
| 另存草稿后释放会话 | 草稿清除，旧令牌查询返回 HTTP 401；重新配对后仍为空 |
| 另存草稿后不续租 | 主机等待约 2.3 秒，再查询返回 `session_expired`；重新配对后草稿未恢复 |

上述请求只涉及 `/api/pair`、`/api/state`、`/api/action` 的 `show_edit` 和 `/api/release`。每次正常编辑先读取新窗口，序号递增；拒绝案例故意使用旧 revision、已消费窗口或重复序号。实际窗口、令牌、设备标识和启动标识不导出；摘要未把拒绝案例计成动作成功。

## 版本与观察边界

最近独立核验的部署是 [ct74](ct74-deployment.md)，源码候选为 ct75。本组 HTTP 状态没有运行版本字段，未通过串口重新读取版本，也未重启或刷写设备。按主机 UTC 减设备 uptime 估算的开机时刻，相对部署记录偏移约 613 秒；可能涉及期间重启或时钟变化，原因未确认，不能把部署时的启动身份直接沿用到本轮。采集器在本组响应间比较内存中的启动标识及启动计数，未检测到变化。

本轮补充的是实际设备的**单网页草稿路径**，没有完成有效版本的表演确认与实际执行、语音／网页并发改稿、真实 Wi-Fi 断开或 300 秒草稿到期。2.3 秒是主机等待时长，不是输出关断或机械停止时延；逻辑零输出也不是物理电平测量。完整 I04／I06 与家庭体验仍有缺口，ct75 的 HTTP 零转义修复没有因本轮而获得部署验收。
