miclle/cybertrack/docs/validation/ct73-deployment.md

# ct73 部署与首轮实机验收

日期：2026-11-01。用户恢复现场配合，确认行走／喷水／泡泡供电正常、主控独立供电；随后明确授权在执行器功率断开的条件下部署 ct73。供电正常是用户报告，不是电压、电流或负载测量。

## 已完成的部署检查

[完整记录](../../firmware/esp32-audio/startup-ct73.json)与[版本入口](../../firmware/current.json)分别维护部署事实和当前指向。

- USB 设备身份与历史 ct45 一致，16 MB Flash、分区表及 OTA 选择核对通过；应用分区为 `ota_0`，起点 `0x20000`、大小 `0x3f0000`。
- 全片读取在 180 秒时超时，未形成完整备份，未用作恢复依据。另存的 ct45 回退应用经芯片摘要核对一致，前应用配置区单独备份；二进制及含凭据区域只保存在本地忽略目录，不入 Git。
- 仅写入 ct73 应用，2,718,640 字节，SHA-256 `a6414595cd933a815603ff5f543dbc5275faacfa90fcd4d783a52f89e3f8e1de`。写后应用摘要、配置区逐字节和 `0x410000` 以上非应用区摘要均通过。
- 首次启动后的 71 条有效 NVS 记录校验通过；两个已存网络及用户配置保持，只有 WebSocket token 更新。该语义比较对应首启后的快照；第二次启动另有启动与状态回读，不冒充第二次 NVS 对比。
- 两次启动均读到 ct73、OLED 初始化、控制输出初始化关闭、联网和 idle。每次十条 HTTP 状态均为 `starts_this_boot=0`、逻辑输出全关、无序列或草稿，最后释放网页会话；[完整脱敏回读](evidence/ct73-deployment/http-readback.json)保留。
- [灵矽角色](evidence/ct73-deployment/platform-role-readback.json)只读回读 5991 字符，与源文件一致，未修改或保存配置。仓库文本末尾有一个 LF，UI 文本框省略该 LF，记录同时保留原显示文本与规范文本摘要。

上述检查没有发送动作指令；执行器功率由用户保持断开。逻辑输出、初始化日志与设备接受回执不等于物理电平、机械停止、水流、出泡或儿童使用验收。既有完整模型成绩仍为 77/80、编排 6/8，部署不消除模型失败。

## 接下来的现场顺序

1. **恢复受测功率并核对场地。** 仅恢复行走／喷水／泡泡，点火支路保持断开。确认 BOOT 与独立断功率可触及，记录地面／架空状态、负载和供电版本；现场就绪前不发动作。
2. **短动作与停止。** 先以明确速度和短时长逐路检查方向、实际效果与到期停止，再测试松手、网页全停、本机 BOOT。异常立即全停并保留失败，不自动重试或补做。
3. **恢复与来源。** 分开验证网页断线、设备 Wi-Fi 断开及语音连接关闭；恢复后不发新启动，观察旧动作与后续步骤是否恢复。网页静默失联须等设备检测租期，不能把手机断线时刻当作设备已经关断。
4. **真人语音与剧场。** 先检查普通动作、停止、否定和状态问句，再验证草稿不启动、修改预览、网页明确确认、执行和中途停止。分别记录工具接受、实际动作和听到的回复；不测试点火／狂暴模式。
5. **完整覆盖与负载。** 首轮排查之后按[17 案例矩阵](stop-trials.md)每条件至少五次正式采集，再做组合负载／温升／续航和维护。缺仪器时只记录可观察现象，输出关断时间、机械停止时间、位移与误差未知保持 null，不填 0。

## 首项现场结果：未通过

[现场摘要](evidence/ct73-first-motion/summary.json)及[请求／回读](evidence/ct73-first-motion/raised-forward-500ms-60pct.json)保留单次短动作失败：用户确认履带架空、受测功率已恢复、点火保持断开。请求前进 500 ms、60% PWM，设备返回 accepted，逻辑左右输出均为 60、启动计数增加 1，后续状态在显式全停前已归零；用户明确反馈 **两侧履带都没转**。未测电气输出、母线或机械时间，不能宣称实际运行 500 ms 或停车通过。

此前还有一次[未启动的连接超时](evidence/ct73-first-motion/not-started-connection.json)：pair 请求超时，尚未发送动作；附加串口监听出现初始化日志，之后 HTTP 恢复。两轮启动时间轴表明期间发生过重启，但原因未确定。后续动作只用 HTTP，不重新打开串口，观测期间启动身份保持；不能把此前重启归因为电源或固件。

失败后的[状态回读](evidence/ct73-first-motion/post-failure-state.json)为全停、逻辑输出全关、无输出故障报告、启动计数仍为 1，网页偏好已恢复 100%。[输出驱动对比](evidence/ct73-first-motion/output-source-comparison.json)确认 ct45／ct73 的 `action_outputs.h` 摘要一致；控制会话和工具适配不同，因此该相同性不能排除其他软件路径或硬件问题。

随后用户补充“电机没有问题，我用手机打开网页测试是正常的”。该正常反馈与失败的 60%／500 ms 定时请求分列；用户随后确认速度为 100%、“时间很短也能转动”；准确按住时长未测，不推定电机或供电故障，也不据此把所有电气验收标为通过。

保持前进请求 500 ms 不变，改为 100% PWM 做对照。第一次 100% 请求有完整回读，但用户说“没注意”，只记[未观察](evidence/ct73-first-motion/first-motion-100pct-03.json)，不计物理通过或失败。用户明确要求再执行后，[另一次 100% 请求](evidence/ct73-first-motion/first-motion-100pct-04.json)被接受，用户确认“两侧都转动，随后停止”。这只证明该次架空条件下的基本功能；不证明精确运行时间、停车性能或低占空比启动阈值。

源码显示手机方向键使用 `drive_start`／`drive_renew`／`drive_stop` 长按租约，而本次使用 `move(duration_ms=500)` 定时路径，两者最终进入相同底层输出适配。后续先核对手机参数，再在相同架空条件下选择只改变一个因素的受控对照；不强制先测待机电压，也不自动改为更高占空比或更长时长。没有调整升压、更换接线或追加固件写入。本例不属于 17 类正式停止矩阵，完整物理覆盖仍未增加。

[本机 BOOT 诊断](evidence/ct73-first-motion/boot-stop-05.json)已发送一次 100%／3000 ms 前进。设备时间轴在原截止前读到 BOOT 按下及全关，松开后的 24 条状态样本覆盖约 3031 ms 且均全关。用户确认“立即停下，松开后未恢复”，本轮架空单路功能观察通过；“立即”是主观观察，未测精确按键边沿、电气输出或机械停止时延。本例只有网页行走，不冒充正式 `boot_mixed` 的网页行走＋语音泡泡双来源案例。

首条[真人语音功能观察](evidence/ct73-first-motion/voice-left-06.json)：预期口令“你好小智，左转一秒”，用户确认已唤醒、实际左转后停止且无播报。固定三十秒 HTTP 窗口内未捕获新启动或活动，用户稍后反馈成功，因此现场观察与设备窗口分列，未取得对齐的真实 STT／原始 MCP 调用轨迹；不更新原 80／8 成绩，也不声称二十条真人或三种收音条件已通过。

三条[真人非动作问句](evidence/ct73-first-motion/platform-human-nonaction.json)已在后台核对原转写与分句回复，对应[九十秒 HTTP 观察](evidence/ct73-first-motion/voice-nonaction-07.json)共 412 条样本、零新增启动、逻辑输出全关。否定句没有可见动作调用，但仍带多余客服结尾；“你现在在做什么”直接声称待命，未见先查机器人状态，不能关闭状态新鲜性要求；电量问题调用通用设备状态后承认缺少电量反馈，没有编造百分比。后台文本／可见工具、逻辑样本和真实听感分列，不据此更新原固定集成绩。

用户报告 ESP32-S3 播放卡顿，且伴随测距滴声。当前普通测距 Beep 与 Stop 都调用 `PlaySound(..., true)`；该路径清空解码／播放队列、重置解码器，并在本地提示期间拒收云端音频包，存在明确的语音截断机制。尚未改动设备：先做关闭控制页、无滴声的听感对照；候选修正方向是普通滴声混入 PCM、保留紧急停止优先，不通过取消测距提示或放宽停止规则掩盖问题。

当前状态：**部署与无动作检查通过；60% 架空短动作未转、100% 同时长复核转动并停止；本机 BOOT 架空单路停止获现场确认，首条真人语音左转／停止／动作静默获现场确认；完整停止矩阵、低占空比及完整真人语音仍待验；停止性能、收音／扬声器、供电负载及家庭体验仍未验收。** 本地原始资料写入 `output/field-20261101/` 或 `output/validation/`，不提交录音、凭据、个人信息或原始 Flash。
