miclle/cybertrack/docs/validation/plan-feedback.md

# 组合、序列与目标速度的成功确认

ct63 扩展端侧播放匹配，让已接受的普通动作少重复播报确认。它只决定是否播放远端音频，不创建动作、改写工具参数或绕过控制守卫。最近记录部署仍是 ct45，本页是候选构建和离线回放证据。

## 完整语句与成功回执同时匹配

播放白名单按完整原话识别前进、后退、左转、右转、喷水和吹泡泡，可用“先／然后／再／接着”表达先后，用“同时／并／和”表达同一步动作，最多 16 步。支持中文或英文逗号及已有时长写法；时长为 1–30000 ms。未说时长时，全速左右转 880 ms、其他动作 1000 ms；同一步只有一个明确时长时共享，后续步骤不继承前步时长。更长行走与其他语法沿用控制能力，播放判断保留音频。

同一步不能重复同一通道。否定、问句、引用、草稿要求、点火、超限或未完整消费的原话均不进入本白名单。它不承担自然语言动作执行，灵矽仍按角色及工具契约理解请求。

目标速度支持“调到百分之六十”“速度调到 80%”“减速到60%”等明确 60–100 整数目标。“掉到百分之六十”是本次真实 ASR 转写，仅用于播放匹配，并要求带百分比；不会新增或更改任何动作别名。

原话确定预期后，还须核对本次唯一工具、所有步骤的方向、时长、通道与默认速度，拒绝额外／重复字段、拆单、遗漏步骤和时长变化。回执必须 `accepted`、`fault=none`、操作匹配；组合核对各路接受时长与语音来源，序列还须为语音来源、第一步运行、步数一致，目标速度须与接受值一致。回复早于成功回执时保留音频；后续工具调用解除当前抑制，新输入或迟到回执不能授权旧一轮。

## 同一批事件的前后对照

重放[ct62 真实 STT 二十条](ct62-stt-host.md)的原始输入、实际工具回执及音频包顺序，未新增模型会话。

| 包级观察 | ct62 | ct63 |
|---|---:|---:|
| 既有短句确认抑制 | 248 | 248 |
| 四条组合／序列确认抑制 | 0 | 176 |
| 目标速度确认抑制 | 0 | 40 |
| 状态、否定与澄清回复保留 | 397 | 397 |

V017 喷水无音频、缺少结束事件，仍是未完成，不能计为策略抑制。另对五条新增匹配各注入六类不一致，共 30 条合成变体：错误参数、拒绝结果、缺故障字段、否定、过早播报与新输入。所有音频均保留。语法和回执边界另经 ASan／UBSan 测试，包括 16 步上限、共享时长、独立时长、丢步、重复字段、版本代际和目标范围。

[逐包与变体结果](evidence/ct63-plan-feedback/playback-review.json) · [构建记录](../../firmware/esp32-audio/verification-ct63.json) · [软件检查](evidence/ct63-plan-feedback/software-checks.json)

## 复现与限制

统一入口 `python3 scripts/verify_improvements.py --source build/xiaozhi-ct63-src` 会编译实际播放头文件与回放器，并运行此组检查。已有同版回放器时，也可单独运行：

```sh
python3 scripts/check_plan_feedback.py --executable build/audio-host/feedback_replay
```

十二组软件检查通过，含 81 项改进测试与实际 MCP／HTTP、音频、停止矩阵和完整固件主机。ESP-IDF 构建通过，公开工具和 5991 字符角色不变；未保存平台配置、重启或刷写。包数反映端侧策略，不证明扬声器听感；未知语法和其他成功回复仍需逐项扩展及现场验证。

后续 [ct72 效果别名与模式](effect-alias-feedback.md)单独扩展普通点火等效果；本页三通道组合／序列解析的范围不变，不支持点火组合匹配。

后续 [ct73 四路组合](four-lane-feedback.md)扩展点火与既有别名的组合／序列匹配；本页原三通道范围与计数继续作为历史证据，未知及超限表达仍保留音频。
