miclle/cybertrack/docs/validation/full-speed.md

# 同一句“全速”在移动和空闲时的表现

“全速”是向正在移动的机器人调速到 100%。它不提供方向，空闲时也不能启动履带。“全速前进”带有方向，仍沿用行走规则。固定口述集的 V040 中，灵矽正确识别了“全速”，却先查状态并返回英文旁白。[原始失败样本](synthetic-uplink.md)

## 如何分开验证工具说明和设备播放

保持线上 5991 字符角色、模型、语音和 12 个工具接口一致。每次新开会话，只发送 Tingting 合成的“全速”二进制音频。旧组使用 ct51 导出的工具描述，新组使用 ct54 导出。两份导出逐项比对，仅绝对调速工具的说明有变。两种主机初态分别为 70% 向前定时 30 秒，以及全路关闭。灵矽发起调用后，由同一份 ct54 固件主机程序按实际请求时刻应答。每种组合运行三次，第二轮交换新旧说明的测试顺序。

再把同一份调用、回执和音频包顺序分别送入 ct53 与 ct54 的播放策略。两版都核对返回音频总字节数。这样可以分别判断模型选了什么工具、设备控制层是否接受、以及确认音频会不会进入解码队列。未使用麦克风、扬声器或执行器。

## 三轮结果

12 次会话均正常结束，平台都将音频转写为“全速。”。以一次直接请求 `set_speed({"speed_percent":100})` 为调用合格条件。

| 初态 | 旧工具说明 | ct54 工具说明 | ct54 对新组回复的逐包回放 |
|---|---|---|---|
| 正在向前移动 | 0/3 直接请求。两次追问，一次先查状态再调速 | 3/3 直接请求并接受。速度从 70% 升到 100%，方向、原截止和启动计数保持 | 60/60 个确认音频包被抑制。同一批包在 ct53 均可播放 |
| 空闲 | 0/3 直接请求。两次追问，一次只查状态 | 3/3 直接请求并收到 RPC 拒绝。主机回读均为零启动、全路关闭 | 134/134 个拒绝说明音频包均可播放 |

新组六次均用中文回复，未出现上一轮的英文旁白。移动中三次都收到了云端确认文字，成功静默发生在设备播放策略这一层。空闲组三次都回答“没有正在移动”，与本轮设置的初态相符；但设备实际返回的是涵盖多种情形的通用拒绝，模型单凭这条错误无法区分未移动、忙碌或链路异常。后续[拒绝原因对照](speed-rejection.md)已提供明确设备错误，修正工具说明后六次离线样本不再误报未移动，但仍未说出具体原因。仍待真人收音与实机扬声器验收。

## 复核入口

[逐次回执、音频包计数与文件摘要](evidence/full-speed/review.json)按轮次列出结果。原始压缩轨迹位于同目录，保存文字、时序及字节数，音频内容已丢弃。按[采集和逐包回放步骤](lingxi-capture.md#移动中与空闲时说全速)可重复运行，固件构建身份见 [ct54 验证记录](../../firmware/esp32-audio/verification-ct54.json)。
