miclle/cybertrack/docs/validation/lingxi-ct48.md

# ct48 否定、停止与剧场动作顺序

ct46 曾把“不要前进”解释成全停，也曾将“往后走两秒，同时吹泡泡一秒”保存成先后两步。ct48 在灵矽的停止工具说明中区分否定和明确停止，在编排工具中说明同步动作共用一步。手机预览直接从载入的设备草稿计算各步的起止关系，家长可在确认前比对原意。[历史失败](lingxi-ct46.md) · [候选构建与浏览器验证](../../firmware/esp32-audio/verification-ct48.json)

使用相同的 5998 字符角色，从候选构建树导出工具描述。每轮按[八条原话](ct48-intent-cases.json)新建八个灵矽 WSS 会话，连续三轮，共 24 条，均正常结束。只发送原话，设备为空闲、无有效草稿的内存夹具。捕获器使用 ct47 的回执格式，设备固件没有刷写。

| 原话意图 | 三轮结果 |
|---|---|
| 否定前进，两种表达 | 6/6 无工具调用 |
| 明确停止，含“别再往前走了，马上停下” | 6/6 直接调用一次全停 |
| 后退与泡泡、左转与泡泡同时开始 | 6/6 先查版本，再保存一步。两路时长分别匹配 |
| 相同动作按先后进行，含泡泡先开始 | 6/6 先查版本，再保存两步，方向、顺序和时长匹配 |

工具名、顺序及参数按现有评分器的 `canonical` 比较。每个编排案例另与 `draft_saved` 回执中的步骤数组逐项核对，省略的速度按固件默认值 100% 处理。12 份草稿均保存为预期结构，未请求执行。第一轮“不要前进”仍播报了判断意图的内部说明。这里只评价这八条原话；ct48 未重跑固定 80 条，也未采集真人语音或扬声器输出。[逐例评分](evidence/ct48-intent/summary.json) · [原始轨迹](evidence/ct48-intent/)

复现时，按[隔离联调步骤](lingxi-capture.md)从 `build/xiaozhi-ct48-src` 导出 schema，使用 `--ct47 --raw-text --corpus docs/validation/ct48-intent-cases.json`，每轮使用新的输出文件。预览测试在真实 Chromium 中拦截全部设备请求，分别载入同动与分步草稿，检查顺序、预计时长、确认状态及窄屏布局。

## 已在行走时的转折与三步草稿

第二组实验继续使用原 ct48 工具描述和角色。每轮四条原话以“正以 70% 前进、还剩 4 秒”为夹具初态，四条三步草稿以空闲为初态。每次会话只发送原话。平台看到的是合成回执；之后将实际捕获的工具调用交给主机上的固件控制代码重放。重放使用的动作适配器、会话、动作保护和草稿解析源码已与 ct48 构建树逐文件比对。[用例](ct48-running-cases.json) · [主机重放方法](lingxi-capture.md)

| 验收项 | 三轮观察 |
|---|---|
| 严格匹配工具顺序和参数 | 每轮 7/8，共 21/24。三次差异均为 R001“照原来的速度往前走就行，别喷水，也别改速度”多查询一次状态。保留原评分 |
| 保持运动与只读查询 | 9/9 未请求改速、停止或启动其他通道。冻结时间的固件回读仍是前进、70%、剩余 4000 ms，原启动计数为 1 |
| 明确转为全停 | 3/3 直接请求一次全停，固件重放后所有逻辑输出和行走剩余时间归零，启动计数保持 1 |
| 三步混合草稿 | 12/12 的保存回读与预期逐步匹配。并发动作分别出现在第一、第二、第三步，另有全程串行对照。每次均只读版本、保存草稿，启动计数为 0 |

另将真实包的相对到达时间用于主机时钟，从输入时刻开始保留原动作的 4 秒期限。9 次只读查询均未延长期限，至 TTS 结束时原动作已到时；3 次明确停止的工具调用均早于原期限，在调用后的首个固件回执中已关断逻辑输出。该试验没有测量实机停止延迟或机械制动距离。

回复仍有局限。固定快照里的“还剩 4 秒”会在查询后被模型复述，而计时重放中原动作持续消耗时间。第一轮 R003 从输入到查询经过 1258 ms，对应的剩余量只有 2742 ms。听到描述时的状态还可能再次变化，剩余时间的语音表达仍待验证。[逐例调用、固件回读与时间点](evidence/ct48-running/review.json) · [三轮原始轨迹](evidence/ct48-running/)
