miclle/cybertrack/TODO.md

# CyberTrack 待办

README 聚焦产品亮点与使用价值；已实现、开发中、规划中及验收状态从本页进入：[当前可用能力](docs/current-status.md) · [I01–I13 改进进度](docs/improvement-plan.md)。

最新交付与待验缺口见 [I01–I13 验收核对](docs/validation/delivery-audit-20261031.md)。

## 产品改进目标（2026-10-31）

十项改进、SolidCue 接入、硬件架构专项及灵矽解决方案主线统一跟踪于[执行计划](docs/improvement-plan.md)。I01–I13 的状态、阶段和退出条件以该表为准；下方保留专项历史待办及证据。用户暂时无法配合实机测试，现场项目不以材料或主机检查完成替代。当前版本见[当前状态](docs/current-status.md)。

模型辅助设计 I11 已完成接入验收：整机 198 件展示，真实宿主评论独立触发处理，FreeCAD GUI 修改／保存重开／恢复，同一卡片 r9 → r10 → r11 与最终回执通过；README 已展示整机设计卡片和修改结果。证据和支持范围见 [I11](docs/improvement-plan.md#整机本地闭环与交付证据)；亲子与实机项目仍按原计划验收。

## ct45 部署与灵矽联调（2026-10-31）

- [x] 仅应用部署、配置保持、角色保存重开逐字核对、两次启动联网与设备网页回读；39 条回执零启动，草稿编辑／取消／失效通过，见[部署记录](firmware/esp32-audio/startup-ct45.json)。
- [x] 真实灵矽向隔离捕获器发现 12 个工具；固定 80＋8、无前缀诊断及只读状态解释已采集，见[联调结果](docs/validation/lingxi-ct45-20261031.md)。
- [x] 实际设备网页草稿编辑／取消、470 次心跳采样下五分钟到期、六类非法草稿拒绝；全程零启动，见[补充证据](firmware/esp32-audio/web-live-ct45.json)。
- [x] 根据首轮反馈修正角色，5998 字符保存回读并重启；固件应用保持 ct45，见[同步记录](firmware/esp32-audio/role-feedback-ct45.json)。
- [ ] 修复并复测平台语义：成功静默、喷水超限仍执行限幅、草稿不支持通道的正确拒绝、含糊时长澄清、故障／旧回执不猜测及不暗示自动恢复。首轮 76/80、编排 5/8、解释 2/8；[角色复测](docs/validation/lingxi-ct45-role-feedback-20261031.md)为 77/80、5/8、4/8，45 条静默均未达成。工具匹配不等于完整通过。
- [ ] 新表达与多轮泛化：本轮 8 条新表达仍有 2 次非法／无效草稿提交；单列禁止动作、确认绕过、错误恢复暗示与静默门槛，不能被固定集平均准确率抵消。
- [ ] 有效确认后的实际动作、真人语音、亲子体验及带载验收。

## ct42 距离提示音（2026-10-30）

- [x] 普通滴声仅依赖有效距离，覆盖开关两态、待机／后退／转向／锁定；停车三连音优先且不恢复动作。
- [x] 主机控制、音频队列／实际播放路径、MCP／HTTP 及完整构建通过；平台 5999 字符保存回读一致。
- [x] 已仅应用烧录、平台 5999 字符保存回读并重启联网；两组 Wi-Fi 和用户配置保持，启动仅刷新 WebSocket 会话令牌。两次开机均默认关闭，HTTP 开关两态通过；18 次有效测距、零驱动失败、零执行器启动，启动日志记录 2 次滴声播放事件。见[ct42 部署](firmware/esp32-audio/startup-ct42.json)。
- [ ] 实际听感、近距离对话并发、移动中提示和定量停车距离现场验证。

## ct41 网页自动避障开关（2026-10-30）

- [x] 新增默认关闭的设备端开关与网页控件，共用于网页、语音单项／组合及序列前进；保留测距／滴声和 15／20 cm 边界，关闭不恢复旧动作。
- [x] 主机控制、HTTP／MCP、网页回归及 ESP-IDF 完整编译通过；360 × 800 页面无横向溢出。覆盖关闭近距离行走、运行中开启停车、无效读数下关闭解锁、重复／过期请求、断线重连及全停竞态。
- [x] 仅应用烧录、平台 5998 字符保存回读与重启联网通过；开机默认关闭，HTTP／实机网页开关两态及最终关闭已核对。18 次有效测距、零驱动失败、零执行器启动；两组 Wi-Fi 和用户配置保持，启动仅刷新 WebSocket 会话令牌，见[部署记录](firmware/esp32-audio/startup-ct41.json)。
- [ ] 真人语音验证单项／组合／序列遵循开关，并测量实际带载停车距离。

## OLED 内网地址（2026-10-30，ct40）

- [x] 待机底行显示当前 `IPv4:8080`；对话字幕、待机恢复、断网清除、换网更新已实现，主机 OLED／HTTP／控制／Wi-Fi 顺序／网页回归通过。
- [x] 恢复 ESP-IDF 5.5.1 与锁定组件缓存，完整构建并仅应用烧录；完整 Flash 备份、应用及非应用区域校验、首次启动后全部 61 条 NVS 和两组 Wi-Fi 保持已核验，见[部署记录](firmware/esp32-audio/startup-ct40.json)。
- [x] 用户确认手机能打开控制页面、屏幕 IP 显示正常，测试符合预期；恢复原网络后重启，首次认证超时后自动重试连接第一组 Wi-Fi 并进入正常待机，串口状态为零启动／输出全关，见[现场与恢复记录](firmware/esp32-audio/startup-ct40.json)。
- [ ] 语音结束恢复地址、热点切换及反复重连稳定性；当前电脑仍无法直连设备网络，未执行动作。

- [x] 2026-10-30 A2 原理图补齐主控侧 3V3／GND、GPIO1／GPIO2 超声波接口；重新导出六页 PDF／网表、ERC 及 112 项连接／源码检查通过，A1 既有端子连接保持，见[当前记录](hardware/schematic/verification-current.json)。实物电平、3V3 余量、针序与装壳声学仍待验证。

## 普通多 Wi-Fi 配置（2026-10-30）

- [x] 本地 `secrets/wifi.json`、格式校验、可选构建导入与主机 NVS 行为测试；不输出凭据、不重复覆盖后续配网。
- [x] 两组实际配置通过校验；ct39-wifi 完整构建、应用刷写、NVS 回读匹配、重启联网和 22 次输出全关／零启动检查通过，见[部署记录](firmware/esp32-audio/startup-ct39-wifi.json)。
- [x] ct39-wifi-order3 按配置顺序连接，未扫描到的名称也定向尝试；主机顺序／回退测试及完整构建通过。修正配置后三次实机结果为第一组成功、认证超时回退第二组、第一组再次成功；两组配置回读匹配，见[部署记录](firmware/esp32-audio/startup-ct39-wifi-order3.json)。
- [ ] 第一组热点反复重连稳定性（已出现一次 AUTH_EXPIRE）、已连接后的断网切换和停止、物理断电保留、网页配网修改保留。
- [ ] 如后续需要，再实现企业账号认证。

## 全速左右转默认时长（2026-10-30）

- [x] 仓库角色及 move／move_and_water／sequence 工具描述：100% 速度下未说时长的左右转默认 880 ms（ct39；此前 ct37／ct38 为 800／900 ms），指定／共享时长优先；同步需求、规则和回归预期。
- [x] ct37 构建及接口回归通过；平台 5999 字符保存回读一致；仅应用更新、配置区保持、重启联网及 11 次输出全关／零启动检查通过，见[部署记录](firmware/esp32-audio/startup-ct37.json)。
- [x] ct38 将默认转向改为 900 ms；构建／接口回归、平台保存回读、仅应用更新、配置保持和重启检查通过，见[部署记录](firmware/esp32-audio/startup-ct38.json)。
- [x] ct39 将默认转向改为 880 ms；构建／接口回归、平台保存回读、仅应用更新、配置保持和重启检查通过，见[部署记录](firmware/esp32-audio/startup-ct39.json)。
- [x] 用户确认“880 ms 测试效果符合预期”，现场反馈已记录在 [ct39 部署记录](firmware/esp32-audio/startup-ct39.json)；不替代精确计时或完整语音回归。
- [ ] 完整语音回归逐项记录双方向、省略／显式全速、60–99% 速度、指定时长、组合、序列及运行中调速不改截止。见[角色维护](docs/agent-role.md)。

## ct36 停止距离调整（2026-10-30）

- [x] 停止阈值从 30 cm 调整为严格小于 15 cm，解锁改为至少 20 cm；15–40 cm 快滴声，40–50 cm 慢滴声。
- [x] 主机边界及动作回归、MCP／HTTP、网页检查和构建通过；已仅应用烧录并保持配置，平台角色保存回读一致后重启联网，11 次测距有效、无驱动失败，状态阈值为 150／200 mm，见[部署记录](firmware/esp32-audio/startup-ct36.json)。
- [x] 用户确认当前提示音和距离阈值调整“测试效果符合预期”，见[实测反馈](firmware/esp32-audio/startup-ct36.json)。
- [ ] 定量停车距离、对话并发听感及 ct36 冷启动按专项另行验证。

## ct35 前进距离提示音（2026-10-30）

- [x] 仅前进时按距离间隔 800／400 ms 发出滴声；小于 30 cm 立即停止、三连音一次，待机／后退／转向安静。
- [x] 取消待播普通声音、丢弃过期事件，停止保护与音频任务分离；角色源同步提示音语义。
- [x] 主机控制／动作序列、提示音队列、实际音频方法、MCP／HTTP、网页回归及 ESP-IDF 构建通过，见[验证记录](firmware/esp32-audio/verification-ct35.json)。
- [x] ct35 仅应用烧录、配置区保持，平台角色保存回读一致并重启联网；11 次有效测距、驱动失败数及执行器启动数均为 0，见[部署记录](firmware/esp32-audio/startup-ct35.json)。
- [ ] 实测提示音音量、节拍、停止后安静及对话并发听感；ct35 冷启动另行复测。

## ct34 测距冷启动恢复（2026-10-30）

- [x] 捕获 ct33 冷上电连续 `driver_error`；电池及电脑 USB 均复现、RST 恢复为用户反馈，具体 API／电气根因未定。
- [x] 1 秒首次等待、具体阶段／错误码、1–8 秒退避重建、旧回调清除及清理失败保护；主机、网页、MCP／HTTP、音频回归和 ESP-IDF 构建通过。
- [x] ct34 仅应用部署、配置区保持与复位启动检查：有效测距、驱动失败数 0、执行器启动数 0；见[记录](firmware/esp32-audio/startup-ct34.json)。
- [x] 一次用户确认断电再上电且未按 RST 的复测通过：启动标识变化，8 次有效测距、失败／重启计数均为 0，见[冷启动记录](firmware/esp32-audio/cold-start-ct34.json)。本次电源来源未注明，不能算两种供电均通过。
- [x] 用户随后确认电脑 USB 与独立电池均已多次重新上电，测距正常；次数未量化、未逐轮采集遥测，见冷启动记录中的 `user_followup`。
- [ ] 实机自动恢复路径及原故障具体原因仍未验证；已采集的 ct34 硬件测试没有触发驱动故障。

## ct33 距离提醒与前进保护（2026-10-29）

- [x] 小于 50 cm 本地提醒，小于 30 cm 本地提醒并撤销／阻止前进；35 cm 解锁、55 cm 重置提醒，各档 5 秒播报冷却。
- [x] 网页／语音／组合／序列统一限制；独立效果继续原截止，后退转向保留，恢复不续走；测试覆盖失效读数、重放、GPIO/PWM 停止和音频优先队列。
- [x] 构建、仅应用部署、配置保持、平台角色保存回读、启动检查；启动次数 0，观察到锁定／解锁和间歇 `echo_high`，见[记录](firmware/esp32-audio/startup-ct33.json)。
- [ ] 现场验证 50／30 cm 提醒听感、语音播放并发、真实前进停止距离和恢复后须新指令；无回波、临界抖动与后退／转向回归，见[规则](docs/ultrasonic-ranging.md#ct33本地距离提醒与前进保护)。

## ct32 间距、速度标签与底部停止栏（2026-10-29）

- [x] 加大功能组间距并按屏幕高度调整；“网页速度”改为“设定速度”；全停按钮与状态提示固定底部，动态预留底栏空间。
- [x] 五种窗口尺寸无滚动条／遮挡，网页回归、构建及仅应用部署通过，见[记录](firmware/esp32-audio/startup-ct32.json)。
- [x] 用户确认当前测距与网页整体测试效果符合预期，见[现场反馈](firmware/esp32-audio/startup-ct32.json)。
- [ ] 不同手机安全区、缩放及异常断线等边界分项回归；用户本次未提供逐项记录。

## ct31 页面高度与状态精简（2026-10-29）

- [x] 四路固定名称与单行必要状态，移除重复来源／动作名称；喷水／泡泡六键一排，测距置于方向键右上角。
- [x] 四种手机／桌面尺寸验证无滚动条，触控尺寸至少 44 px；网页回归、构建和仅应用部署通过。见[记录](firmware/esp32-audio/startup-ct31.json)。
- [ ] 用户实际手机完整显示、长按及多指操作复测。

## ct30 距离栏精简（2026-10-29）

- [x] 移除距离副文案和“约”；有效时显示整数厘米，无效／过期／断线统一 `-`，保留显示滞回。
- [x] 网页回归、构建及仅应用烧录通过；配置区保持，设备页面与源码一致，执行器启动次数为 0。见[部署记录](firmware/esp32-audio/startup-ct30.json)。

## ct29 网页交互优化（2026-10-29）

- [x] 全页禁选文字；实际速度固定在方向键左上角；测距小变化滞回与更及时轮询，异常／过期仍及时清空。
- [x] 网页回归、390×844／320×667 模拟布局、构建及仅应用部署通过；配置保持、网页一致、启动次数为 0。见[记录](firmware/esp32-audio/startup-ct29.json)。
- [ ] 用户手机长按、运行中速度变化和距离显示自然度复测。

## ct28 头部测距（2026-10-29）

- [x] 按 3.3 V、IO1/TRIG、IO2/ECHO 实现独立测距、网页距离、语音状态查询与无效／过期处理；不做自动避障，见[说明](docs/ultrasonic-ranging.md)。
- [x] 完成主机回归及 ESP-IDF 5.5.1 构建，证据见[ct28 验证](firmware/esp32-audio/verification-ct28.json)。
- [x] 按后续授权完成仅应用烧录、配置保持、平台 5966 字符保存回读及重启联网；实时有效回波、网页源码一致和执行器启动计数 0 已核对，见[部署记录](firmware/esp32-audio/startup-ct28.json)。
- [x] 用户确认本轮测距“测试效果符合预期”；未提供分项表达及回执，见[现场反馈](docs/ultrasonic-ranging.md#用户测试反馈2026-10-29)。
- [ ] 补齐具体语音表达、无回波／过期不报旧数及不自动避障边界回归。
- [ ] 核实模块版型、3.3 V 供电／ECHO 电平、固定与装壳声学，完成距离标定、无回波及音频／低压负载干扰验证。

2026-10-30 背包／排盘核对：已完成 Ø35 桶座及泡泡液瓶组在 CAD／打印清单中的同步移除；Lean 与 Ready 均为 27 件、6 盘，Ready 已移除托盘且背包直立独放第 6 盘，见[检查记录](docs/backpack-35mm.md)。待重切 Lean 第 3、6 盘及 Ready 全部六盘，待实物孔径、局部缺口强度和模块保持验证；替代泡泡液供液方案未指定。

## 紧凑集装箱车库

- [ ] 按 2026-10-28 合并后的背包模型更新车库内机器人快照并重验空间；现有车库报告仍对应 2026-10-27 的源模型，不代表新版背包已通过。

- [x] 2026-10-27 完成[关门／下翻门打开效果图及尺寸候选](hardware/model/container-garage/README.md)，按装好顶盖的模型高度设计。
- [x] 2026-10-27 建立独立车库及机器人快照，修正门根销轴孔后 94 个门角检查通过；272 个进出姿态无体积碰撞，连续侧向／顶部保守界及负例检查见[空间报告](hardware/model/container-garage/spatial-validation.json)。304 个几何对象保存回读通过；离散检查不替代全路径连续证明及实物验收。
- [x] 2026-10-27 按用户要求建立[11 件全打印制作候选](hardware/model/container-garage/printed/README.md)，细化壁厚、搭接胶合、M3 铰链轴与手转门闩；全部打印件适配 256³，10 盘完成切片估算；94 个门角、269 个进出姿态及门闩解锁检查通过，240 个对象保存回读通过。
- [ ] 称量含电池／液瓶的整机；先试配铰链、螺母槽和拼缝，验证打印件／胶缝承载、门板挠度、2 mm 前缘通过性、低速进出和门闩保持。

更新：**2026-10-27，样机联调与整机验证阶段**。当前打印入口为 [27 件 Lean 六盘项目](hardware/model/lean-print/README.md)；已打印并完成基础装配的样机见[实拍与视频](artifact/README.md)。27 件是当前打印包清单，不代表每件都已有独立实物验收记录。

带日期／修订号的已完成项保留当时的模型、固件及工况；旧盘号、对象数量、图册页数和“本轮未验证”均按历史范围解释。未勾选项按下列现行方案继续验证，不沿用已取消的压框、护口或旧电源。

## 已完成：打印交付、基础装配与运行展示

- [x] 完成历史 29 件、6 盘打印交付及几何／切片检查；现行 27 件文件一致性检查通过，受背包修改影响的盘仍待重切；历史 34 件基线与 Ready 用户排盘快照分别保留，见[打印入口](hardware/model/lean-print/README.md)。
- [x] 完成样机所用零件的打印与基础装配，已有底盘、双枪、头部面包板和双瓶背包的制作过程及多角度实拍；另有 [VF01 打印与静态试配反馈](hardware/model/drive-fit-fixture/README.md#实物反馈2026-10-26)。
- [x] 归档并展示 33 张照片及两段视频；6 分钟样机视频展示地面移动、转向和泡泡效果。影像不绑定未经核实的固件版本或供电工况。
- [ ] 补齐各打印件实际材料／工艺、尺寸与修整记录，完成紧固保持、拆装、承载、持续运行与整机验收；基础装配和运行展示不关闭这些项目。

## ct21 装车方向确认

- [x] 2026-10-27 根据装车左右转相反的反馈，完成 ct21 输出层 A／右、B／左映射候选，保留前后和速度；验证见[记录](firmware/esp32-audio/verification-ct21.json)。
- [x] 2026-10-27 仅应用烧录 ct21，配置区保持、启动联网、网页与源码一致、全关及零动作启动核对通过，见[部署记录](firmware/esp32-audio/startup-ct21.json)。
- [x] 2026-10-27 用户实测确认 ct21 左转、右转均正常，前进、后退也正常；证据为用户现场反馈。
- [ ] 继续核验带载停止与停止距离、电流和温升；四方向正常不扩展为完整整机验收。

2026-10-26 打印精简：已按用户变更移除底盘两块降压板占位与 5 个压框；MOS 改胶固，两件承托结构减料，29 件按功能优先分盘，背包／顶盖最后。现行入口为[精简打印说明](hardware/model/lean-print/README.md)。待实物检查三块 MOS 的胶固保持、端子操作余量与带载温升。

## 15芯净径10穿线通道

- [x] 0.55局部调整上下护口、颈架桥、头部路线与PP06；连续通道、局部静态、托盘/BOOT回归及保存回读见[专项](docs/cable-passage.md)。
- [ ] 确认实际15芯束径、接头、孔缘防磨/固定、弯曲半径和应力释放；完成实物穿线、拆装及薄壁强度验证。PP02 名义静态冲突已由后续修正消除，实际枪体与完整线束拆装仍待验证。

## 原理图与 PCB 打板

- [x] 2026-10-26 整理[原理图设计与 PCB 打板文档](docs/schematic-and-pcb.md)：以当前面包板和外置模块为依据，定义低压转接板候选、接口、布局与生产交付要求；仅文档完成。
- [x] 2026-10-26 完成保留 ESP32-S3 开发板的[五页 A1 模块级原理图](hardware/schematic/README.md)、KiCad 可编辑工程与同源 PDF；KiCad 10.0.7 ERC 0 条违规，92 项关键网表／源码核对通过。已补 23 个引脚的照片位置、R1–R6 10 kΩ 定值及 SW2 只切执行器的确认；保护电路、保险、MOS 下拉及实物验收仍未完成，不是制造定版。
- [ ] 补齐新电池及并发负载电流预算、总开关与独立切断、模块电气参数、实物针序和 PCB 安装尺寸，冻结首版范围、器件 BOM 与板厂规则；缺口与回填表见[参数清单 E01–E10](hardware/schematic/parameter-confirmation.md)。
- [ ] 在 A1 模块级图上完成保护／主电源电路、元件定值与实际连接器／封装映射；重新核对 ERC，完成 PCB 布线及 DRC、封装／机械核对，再生成并回读 Gerber／钻孔与制造说明；当前没有可下单生产包。
- [ ] 首板按专题第 8 节完成低压分阶段检查并记录修订，点火模块不进入该通电流程；软件、CAD 与文档检查不替代实板验收。

## 已完成：资料初始化

- [x] 明确双履带机器人、喷水、泡泡及语音交互需求；0.15 已改为正面看左泡泡、右水枪。
- [x] 记录火花模块输入 3–6 V、单次 5 秒以内与未验证边界。
- [x] 历史资料初始化：记录充电宝 → DC-DC 升压 → 12 V 驱动母线；现已改用辰克 5 V 电池包，保留电机升压支路。
- [x] 整理电机、驱动板和 track-mount 部件资料。
- [x] 查阅灵矽官方协议，区分平台能力与本项目拟定工具。
- [x] 建立 BOM、资料冲突、待补信息、阶段与验收矩阵。
- [x] 单独记录十项硬件采购名称及商品链接，含 ESP32-S3 N16R8、履带、水枪和泡泡机，同步 BOM 与待确认项。

- [x] 0.37头舱整体上移25 mm，颈架／斜撑与中央电源线束同步调整；328对象回读、889对静态、16组200姿态及各专项通过，两瓶至头舱18.62 mm，连续取瓶扫掠至头舱4.60 mm；50张视图、同尺度对比及30页PDF更新，见[记录](docs/mechanical.md#037-头舱整体上移25-mm)。
- [x] 0.36双瓶背包降为90 mm低位护舱，上部包络外露30 mm；取消打印上盖，增加可释放绑带与同侧供液，支持只移开目标管／绑带后的单瓶上取；328对象回读、909对静态、16组维护及专项检查通过，50张视图和29页PDF已同步，见[记录](docs/mechanical.md#036-低位开放双瓶护舱)。
- [x] 0.35按两只150 mL、Ø48.8×114 mm含盖成品瓶调整背包，补底托、软垫、上盖、指槽与顶部管路；静态、整瓶／盖组连续上取、螺钉与工具、原维护路径回归及保存回读通过，见[历史专项报告](hardware/model/archive/reports/bottle-backpack-0.35-audit.json)。

## 面包板共用5 V电源

- [x] 2026-10-25 保存当前主控正面原图与哈希，确认可见 `5Vin/GND` 针位，记录同一充电宝 5 V 分支供主控及电机升压的[方案](docs/power-and-interfaces.md#面包板与电机共用充电宝2026-10-25)。仅资料完成，未改线验收。
- [ ] 核对分线器件、极性、独立功率断电及输入预算；完成主控独立启动／语音与同源电机启动、组合负载、温升和故障验证，详见[专项](docs/verification-plan.md#面包板共用-5-v-电源专项2026-10-25)。

## 下一步：补实物资料

- [ ] 双150 mL成品瓶：P14商品图及链接已补录（下直径48.8、含盖高114、瓶口内径30±0.2 mm）；继续实测整瓶／盖最大外径、公差、瓶肩／瓶口螺纹和材料；试配侧垫／底垫、可释放绑带保持力与M3底托固定，测满／空／单侧空瓶稳定性、实际抽管取瓶、吸程／通气防溅和密封。CAD候选见[0.36记录](docs/mechanical.md#036-低位开放双瓶护舱)。

- [x] 记录充电宝实测外形 120 × 73 × 31.5 mm，并替换 CAD 电源包络。
- [x] 记录充电宝购买链接（P11）及产品净重 373 g，关联已有尺寸资料和 BOM H12。
- [x] 读取十项采购商品页，保存参数原图、P11 说明书及来源哈希；核对选项和资料冲突，见[网页核对记录](hardware/procurement-web-review.md)。P08 详情被站点策略拦截，仍未取得。
- [ ] Q01–Q02：核对辰克 5 V 电池包的输出电流、保护、端接与分线能力，补齐并发负载预算；旧 A110M 多端 15 W 限制仅作历史，不迁移到新电源；MT3608 已有实测37×18×6 mm；核对接头与安装接口，并测12 V功率与散热。
- [x] 0.23 按用户选择改为底部双面软胶固定，移除压盖、高夹壁和横向紧固；保留底托、后挡及尾线导向，重新检查脱胶后的抬起／前抽与整机干涉。胶材、厚度、保持力及脱胶操作待实测。
- [x] 0.22 按裸枪 33.2 × 24.6 mm 调整水枪支架，外侧壁／压盖收进 5.3 mm，补外侧垫；带管宽独立检查，材料公差与夹紧保持力待验证。
- [x] 记录 P09 拆出发射枪实测长 138.5 × 最粗处宽 33.2 × 厚 24.6 mm、带管宽 38.5 mm 及[实物照片](hardware/components/pulse-water-gun/README.md)；前端较细，具体轮廓未测。
- [x] 记录用户于 2026-10-24 确认的水枪／泡泡机工作电压：均为 3.7 V；同步供电接口、需求与 BOM，尚未进行带载验收。
- [x] 记录 2026-10-24 用户提供的[泡泡枪主体尺寸与 4 张原图](hardware/components/bubble-gun/README.md)：枪口最外端 Ø31.5 mm、总高 35.8 mm、总长 67 mm；新增结构化尺寸与图片 SHA-256。
- [ ] Q03–Q04：水枪总尺寸已补，继续测前段、喷嘴、接头、孔位及储水区，泡泡枪主体三项尺寸已记录，继续补最大宽度、测量端点／凸起范围、固定与管线空间；两者工作电压已确认均为 3.7 V，继续核实允许电压范围、电流、扳机／按键依赖、液体与安装接口；0.12 包络、软管候选及抽出路径已检查，0.13 已补托架、压盖、尾线及工具空间候选；继续核实夹持接触面、真实管径与弯曲半径、连接器、软垫压缩、材料与固定强度。
- [x] 2026-10-25 [L298N 台架](firmware/esp32-motor-bench/README.md)完成三线控制及说明；用户已确认静态电压、200 ms 正转及两次 40%／10 秒反转正常停止，第二次反转母线基本保持 12 V。单路 0.2.2 提至约 60% PWM、10 秒；60% 反转对比已获用户正常反馈（母线约 12 V、转动更快更顺畅、正常停止），完整物理验收仍归 Q05。
- [x] 0.33 按用户 46.2 × 43.5 × 27.5 mm 建立 L298N 独立包络，竖装于下部两电机之间并调整示意电源线绕行；保存回读、静态／预留空间、裸包络下取及原维护流程见[专项](hardware/model/l298n-fit-audit.json)。后续支架候选见下一项；真实接口与热验证仍归 Q05。
- [x] 0.34 按正反面照片确认器件分布，保存两张原图及哈希，完成 L298N 开口托框、顶盖一体吊架、四点可调边缘夹持及接线／通风空间；[支架检查](hardware/model/l298n-mount-audit.json)涵盖整组下取、螺钉／批头、接口入口及通风开口。未根据照片补定孔距，实际 PCB 接触、公差、温升及制造未验收。
- [x] 2026-10-25 将 H03 替换为[何健弓 L298N](hardware/components/L298N/README.md)，新增 P13；旧 DF-MD 退出选型，资料／故障记录留档，新板未验收。
- [x] 历史：2026-10-24 用户确认 DF-MD V1.3 和 37R-520 已到货；首轮电源选择充电宝＋MT3608，见[电机台架准备](docs/motor-bench.md)。
- [x] 用户报告有万用表，MT3608 已调至 12 V，电机已试转；负载、电流和测试接法未提供，不等于 DF-MD 或整机供电通过。
- [x] 按用户要求新增[单电机 GPIO 台架程序](firmware/esp32-motor-bench/README.md)：本地串口单次使能／限时、BOOT 停止及主机策略测试；已烧录并读到 BENCH READY，实体输出与电机尚未验证。
- [ ] Q05：补 P13 L298N 数量、尺寸包含范围／孔位及额定条件；用户已提供长 46.2 × 宽 43.5 × 高 27.5 mm，已有照片、用户静态电压、200 ms 正转和 40%／10 秒反转与母线观察。0.2.2 的 60% 空载反转对比已获用户正常反馈；双路 0.3.2 已增加 GPIO7／8／9 和 A／B／AB 选择，约 60%／10 秒软件回归／编译通过；B 路接线及六脚上电前后静态关闭已获用户确认；此前 0.3.1 的 3 秒版 8 组组合命令均收到关闭回执，用户确认 A／B 隔离、8 组方向与正常停止均符合预期，无异响或异常发热；双路空载 BOOT 提前停止及松开不恢复已获用户确认；用户已确认双路 60%／10 秒空载正转正常启停，启动、运行中及临近停止母线均约 12 V，电机和 L298N 无明显发热、无异响或其他异常；这是万用表读数与主观发热观察，电流和定量温升仍未测；继续电流／定量温升、机械带载停止测试，补编码器、履带和联轴器实物证据。旧 DF-MD 台架停用。
- [x] 更新 P07 天猫 SKU，读取 ESP32-S3 N16R8 原始资料，补齐 COREBOARD 原理图、44 针连接、尺寸、存储限制与文件校验。
- [x] 记录 ESP32-S3 正反面与实测 63.6 × 28.2 × 13.2 mm，完成 USB／COM 枚举、ROM 芯片和 16 MB Flash／8 MB PSRAM 识别。
- [ ] Q06：核对 PCB 版本、器件／焊装差异、射频通路及 COM 接触／方向问题；核对固定与线缆空间，补本地停止和音频器件。
- [ ] Q07–Q08：尺寸／速度／续航／使用环境目标及头舱／喷水口自由度。
- [x] 记录 P12 降压板原图、选压说明及用户报告的 5 V 输入／3.7 V 输出；工况未提供，非带载验收。
- [x] 新增[ESP32 MOS 台架工程](firmware/esp32-mos-bench/README.md)，GPIO4 单次高电平（当前按用户要求改为 5 秒），主机策略测试与 ESP-IDF 编译通过；已完成烧录与关闭回执检查，控制电平及一次水枪启停已取得用户观察，见下项。
- [x] 完成一次水枪 5 秒喷水／到期自动停止功能检查：2026-10-24 用户确认正常喷水、5 秒结束后自动停止；实际顺序 5 V→MOS→降压板 3.7 V→水枪，见[MOS 台架记录](docs/mos-bench.md)。
- [x] 完成一次水枪 BOOT 带载提前停止／松开不恢复检查：2026-10-24 用户确认按下立即停喷、松开没有恢复；串口取得 BOOT held 关闭回执，精确停止延迟未测，见[MOS 台架记录](docs/mos-bench.md#2026-10-24-boot-带载提前停止)。
- [ ] MOS／水枪剩余验证：保护、带载电流／电压、降压启动与关断残余输出、温升、重复性、滴液、精确停止延迟、BOOT 停止重复性及 s 带载提前停止、复位／失电／独立切断；V05、P2 和 F2b 整体未完成。
- [x] 记录超声波模块双圆柱 Ø16、总宽 42、离面板高 10.3 mm；中心距 26 mm／净距 10 mm 为条件推导，见[部件记录](hardware/components/ultrasonic/README.md)。
- [ ] Q10 机械适配：0.26 已按双圆柱尺寸替换 CAD；继续核对实物面板基准，补 PCB／孔位／背部／接头包络、整板固定与实物试配。
- [ ] Q08、Q10–Q11：MG90S 的用途／数量／规格、超声波实物数量／规格／电平，以及 MOS 管与继电器的负载额定条件；测距用途及 ct28 接入方案已定，见上方专项。

- [x] 0.12 建立独立水枪模型并放入颈架左侧；完整最大包络、静态、USB／天线、14 组 192 姿态、水枪前抽连续扫掠及其他维护组对水枪的整段包围盒检查通过；更新 22 张视图与 16 页总装图纸。固定与实物适配待验证。

- [x] 0.13 细化水枪托架及双侧拆压盖、4 处 M3 级候选紧固、线管与工具预留；603 对静态、17 组 224 姿态、8 项服务空间与专项连续扫掠通过；更新 25 张视图及 18 页图纸。

## 固件并行开发

- [x] ct6 面包板统一控制候选：四方向、受限时长、GPIO8–13 双路 L298N 与 GPIO18 水枪互斥、统一停止；软件验证见[集成记录](docs/breadboard-integration.md)。
- [x] ct6 软件部署：用户确认两路断电及六脚空闲；面包板身份与 OTA0 备份核对、仅应用刷写／哈希、配置区前后一致、启动联网和平台角色同步已完成，见[部署记录](firmware/esp32-audio/startup-ct6.json)。
- [x] ct6 本轮基本台架联调：迁线、功率断开信号／语音、四方向空载、水枪实喷、两类 BOOT 提前停止，以及双路供电分别动作已记录；收尾全关、starts=5，两路功率已断开，见[结果汇总](docs/breadboard-integration.md)。
- [ ] ct6 后续验收：断网／重连按用户要求延期；ct7 核心并发及带电语音提前停止已完成（见下文）；同路拒绝现场回归、剩余语音边界、复位／欠压／失电与独立切断、定量电源／温升及履带持续带载仍待测；装车四方向已由 ct21 用户反馈确认，不以短时台架通过替代。

- [x] F0：实现不依赖硬件的 C11 控制核心、默认关闭、限时／互斥、停止锁定、会话与重复／过期请求检查，通过主机测试。
- [x] F1：完成离线 MCP 工具适配、严格 JSON 校验、有界原响应缓存、会话／使能代次及模拟传输测试，见[协议契约](firmware/PROTOCOL.md)。
- [x] F2a：实现通用启动／运行层、板级回调契约、周期控制与故障锁定，通过假板卡测试。
- [x] F2a 扩展：实现逻辑输入去抖、已观察短暂停止／故障锁存，以及有界接收队列、溢出关闭和原始元数据保持，通过单元与运行层联测。
- [x] 解析资源故障：完成新解析／缓存重读的分配与扩容失败注入、撤销输出、原缓存保持、内存释放及假板卡关断联测。
- [x] 接收边界／连接模拟：完成两层分片、连接／握手／分片／发送超时、退避重连、旧事件隔离及发送失败处理，通过假传输联测；真实 WSS／hello 尚未接入。
- [x] 长时会话与缓存：16 槽 FIFO 原响应、启动期防重放过滤器、淘汰／恢复／饱和压力测试；同启动期旧 ID 不重放，误拒绝与跨复位边界已记录。
- [x] 跨复位防重放：双槽持久化接口、会话代次与动作接受前写入、掉电／损坏和恢复联测；残缺记录锁定，真实后端与维修迁移仍待验证。
- [x] 命令新鲜度与跨会话意图：设备限时窗口、稳定意图 ID、双身份持久化与输出前复核；延迟／换 RPC ID／重连／复位及掉电模拟通过，见[契约](firmware/FRESHNESS.md)。
- [x] 防重放容量与迁移：只读零永久开销，动作历史不删除；168 次迁移中断、50 次连续迁移及重放测试通过，真实后端切换另验收，见[容量策略](firmware/CAPACITY.md)。
- [x] 持久化原子切换与回滚保护：独立锚点、精确版本绑定、掉电恢复、旧后端拒绝与 50 次连续切换联测完成；真实锚点／防降级另验收，见[契约](firmware/ATOMIC-SWITCH.md)。
- [x] 当前快照缺失的独立恢复证据：领取尝试前完整过渡日志、唯一尝试 epoch、日志恢复与强制绑定；动作／会话各 352 次日志故障、100 次准备中断后主快照丢失／恢复、25 次恢复再次中断及原连续恢复／运行层联测通过，见[日志契约](firmware/RECOVERY-LOG.md)。
- [x] 首次接入与选择后恢复连续性：初始日志先于登记、目标日志先于切换／恢复选择，attach 核验或补种；覆盖日志／锚点中断和选中后立即丢失主快照，5 组存储与 4 组协议联测通过，见[验证记录](firmware/tests/README.md#首次接入与目标选择连续性验证)。
- [x] 恢复日志冗余与损坏容错：显式四槽双副本、单槽损坏／不可读、轮换／补齐中断和主快照缺失恢复；冲突和缺少当前证据仍锁定，真实介质另验收，见[冗余契约](firmware/REDUNDANCY.md)。
- [x] 中断维护恢复：只从当前锚点对应完整快照重建空白后端，缺失／矛盾历史继续锁定；176 次恢复故障、50 次连续恢复及协议联测通过，见[恢复契约](firmware/RECOVERY.md)。
- [ ] 后续离线输入：对接服务端认证与稳定意图映射、真实存储与升级迁移契约和音频／升级方案，见[离线工作清单](firmware/PLAN.md#不依赖实物的后续工作)。
- [x] F2b 无负载子项：建立 ESP-IDF v5.5.1 工程，实测启动、8 MB PSRAM 初始化、6 MiB 六模式读写及未使能逻辑输出，见[实物记录](hardware/components/ESP32-S3-N16R8/physical-verification.md)。
- [x] F2b BOOT 停止子项：无电机条件下，实测两次按下锁定、松开不恢复及 RST 后未使能，见[按键记录](hardware/components/ESP32-S3-N16R8/boot-stop-verification.md)。
- [ ] F2b 剩余：补齐[开发板资料](firmware/BOARD-INFO.md)，验证实体输出默认关闭、专用停止／使能与独立供能切断、调度时限和看门狗；F2 整体尚未完成。
- [ ] F3–F5：单模块台架、平台与音频、整机故障及组合负载验收。

阶段依赖与退出条件见[固件独立实施计划](firmware/PLAN.md)。主机逻辑测试不代表板卡或执行器验收通过。

## 后续实现

- [ ] 低压供电与停止台架，先单模块后组合负载。
- [x] 生成独立坦克初步布局草模及正／侧／后三视图，剔除原参考底盘与检修盖。
- [x] 根据四张造型参考重做楔形机舱、短喷水头和后掠侧护甲，并更新视图。
- [x] 按最新要求取消传统坦克约束，建立大头舱／外露颈架／双履带机器人造型 0.3。
- [x] 按机甲感反馈深化 0.4：切面分层头盔、偏置喷水口、开窗双层固定颈架与分体底座护甲，更新 CAD、八张视图和回读报告。
- [x] 深化 0.5 后脑、背包与底座后护甲，并按实测重充电宝重做低位平放电源舱、外移两侧动力各 14 mm。
- [x] 0.6 保留充电宝原位，降低并内收前舱上半部，加宽前伸头盔、下沉头颈，并将音频分配移入头舱。
- [x] 0.7 保留头身比例与电源原位，深化隆起顶甲、左右下倾分片、太阳穴叠层与耳部外护弧，更新视图和保存回读。
- [ ] 继续用 Q02–Q06 实测包络替换剩余占位，补齐 Q01 端口与线缆，收敛整机比例和接口。
- [x] 0.8 建立电源托盖／插头检修口、整体冠盖／电子托板、独立补液盖及电线／软管候选路径，并执行保存回读与离散拆卸姿态检查。
- [x] 0.9 按用户暂定的 2 × Ø20 × 80 mm 增加电弧模块被动包络，主托板两侧各收窄 1 mm 保留原孔位；通过静态及八组共 112 个离散拆卸姿态检查，未实施电极、引线或高压集成。
- [x] 0.10 将顶部脊翼细化为双效果护框、封闭凹槽与橙色标识，保留外形包络、电源及内部模块位置；同步模型、视图和图纸，未增加电极、高压接线或驱动。
- [x] 0.11 将实测 ESP32-S3 放入独立小托架，增加排母承接区、防脱压架、直头 USB 开盖检修、线束路径与天线审查区；保留外观和低位电源，更新模型、18 张视图与 15 页图纸。
- [x] 0.11.1 将两个电弧模块包络更新为用户给定的 Ø25.5 × 70 mm，同步模型、视图、图纸及尺寸记录；保留原位置并记录头壳干涉。
- [x] 0.11.2 模块各内移 3 mm、下移 1.5 mm，托板宽 104、四孔 X±49.5；静态、USB 审查及 13 组 184 姿态通过，双模块各三段裸圆柱连续平移扫掠通过，外轮廓保持不变。
- [ ] 面包板整组安装：样机已有头部安装照片；继续补 PCB 层高、排针及接头／线尾实测，核对托盘固定与防脱、反复拔插、天线及装壳无线性能。旧独立裸板排母／托架方案已被整组托盘替代。
- [ ] 实测电源端口 X/Z 和插头、器件安装孔及工具空间；完成连续拆装扫掠、紧固试块、密封、排液及带液隔离验证。
- [ ] 在已有 ESP-IDF 无负载工程、真实时钟与 BOOT 停止输入上，完成完整运行层、专用输入和执行器输出驱动。
- [x] 灵矽设备绑定、WSS／MCP 能力发现及状态／停止真实联调：2026-10-24 新建独立 CyberTrack 智能体，查询、停止及停止后状态返回均通过，见[实测记录](docs/linx-validation.md)。
- [x] 灵矽受限喷水联调：0.2.0 本机单次授权、5000 ms 期限和独立 BOOT 停止任务；1 次功率断开调用及 2 次带载调用完成，用户确认自动停止正常、BOOT 提前停止及松开不恢复，见[实测记录](docs/linx-validation.md)。结束时 MOS 5 V 已断开。
- [ ] 灵矽音频、其他执行器及真实断网／重复命令完整验证；早期单次授权水枪台架仅作历史；面包板已部署 ct21 并有四方向反馈，通用持久化动作通道的验收独立保留。
- [x] 面包板保留“彩菊”绑定、原音频及 OLED，以 `2.0.3-ct2` 完成设备端语音状态→停止→状态联调；无 Mac／USB 数据转发或专用云桥接，见[实测记录](docs/audio-board-validation.md)。本轮 USB 仍用于供电／观察，独立电源拔线运行另测；未接执行器。网页语音跨设备路由尚未确认。
- [x] 面包板 GPIO18 水枪台架：ct4 直接语音五秒输出、BOOT 仅停止；用户纠正控制线接反后测试正常，带载 BOOT 提前停止及松开不恢复已获现场确认。完整供电、失电／复位和故障矩阵另验，见[联调记录](docs/audio-water-validation.md)。
- [x] 面包板 ct5 按指令时长喷水（单次最多 30 秒）：实现、主机检查及功率断开语音时长核验通过，1／7 秒按指令执行，40 秒请求限为 30 秒并到期关闭，音频／屏幕正常；30 秒带载未验证，见[联调记录](docs/audio-water-validation.md)。
- [x] 低压样机基础装配已有用户反馈与照片记录，见页首。
- [ ] 完成整机供电、停止、故障、线束维护、机械承载与液体共存的完整验收。
- [x] 2026-10-25记录底盘前方左右各伸出两根线、共四根的双火花效果需求，替代顶部效果位置；本体仍在背包两侧。
- [x] 0.45按用户要求在模型加入左右各两根封闭端前伸效果线与根部护套，共8个外观对象；尺寸均为造型假设，不含内部高压路径、电极或驱动。
- [x] 0.46前方四根效果线前伸由18增至28 mm，根部、护套和上翘方向保持；仍为外观假设。
- [x] 0.48取代0.47外沿候选：更新116×70.5×19.5电池包、前肩入壳与前脸穿孔，新增两线圈共用的第三块P01可拆托架；见[机械候选](docs/ignition-routing.md)。
- [ ] 点火线：确认真实出线端、线长与最小弯曲半径；设计护盖、固定、防磨、前端接口和底托检修前的线束释放方式，核实液体共存及电气边界。
- [x] 历史装配 PDF 已更新至 0.56 阶段的 69 页评审快照，包含新电源、前方走线、第三块 MOS、电源开关及 BOOT，见[图册范围](docs/assembly.md#全对象装配图纸2026-10-26)。
- [ ] 后续重出装配 PDF 时同步 0.57 支架、0.58 头壳、PP02／LC04 修正与 Lean 精简，并重新核对对象清单和来源哈希；现存 PDF 保留历史标识。
- [ ] 独立评估底盘前方双火花效果：具体出线位置、伸出范围、防触碰与液体共存条件待评估；未满足条件前不实施高压接线、电极或驱动。

当前已完成 CAD 与打印交付迭代、样机基础装配和运行展示；逐项制造质量、电气、语音及完整实物验收仍未完成。完整定义见 [实施及验收计划](docs/verification-plan.md)。

- [x] 0.14 建立独立泡泡枪主体并外置尾部；三项尺寸遵循用户输入、宽35.8为假设；静态、后抽100连续扫掠及其他17组路径对主体检查通过；整机18组232姿态通过，未设计固定与线管。
- [ ] 泡泡枪：实测最大宽度、端点、固定面与接管／线尾，按现行 PP02 复合孔口、阶梯槽和辅助胶核对实物配合，并补齐历史0.4高度差的测量基准及前槽长度，验证现行15°安装倾角下的出泡／喷水、滴液倒流、胶粘保持、管径／弯曲半径、紧固和操作空间；补后护甲管口密封、排液、夹紧力及结构强度验证。

- [x] 0.15 按正面视角改为左泡泡、右水枪；保留水枪原位，新增泡泡枪托架／双压盖、线管及工具预留（前框已由0.16简化方案替代）。732对静态、21组280姿态、泡泡11项空间及11项连续扫掠／通道检查通过；固定面、材料、真实线管及实物装配待验。

- [x] 0.16 按用户要求简化泡泡枪支架：取消前方框，前端20 mm宽托舌与弧形下垫、后部单压盖；紧固件6→4颗。719对静态、21组280姿态、9项泡泡服务空间及8项连续扫掠／通道检查通过；单后夹持的抗俯仰／抗扭、防滑和实物强度待验。

- [x] 按用户2026-10-24新增的后端底部薄片6×25×6.8 mm改为前圆环＋后槽；已明确薄片不额外向下凸出；新增4.7支承间距和前10宽槽，0.17已完成整机候选及CAD检查，前槽长／薄片偏置／0.4高度差待核对。

- [x] 0.17 前圆环＋阶梯槽及后底部轮廓修订：按4.7支承面间距，后槽名义6×25、前宽10，前长19为假设；745对静态、21组280姿态、9项空间与8项连续扫掠／通道通过。旧部件保留，新版本单独回读；0.4高度差、前槽长度／偏置和实物夹持仍待核对。

- [x] 0.18 双枪上仰5°候选，水枪旋转后前移10、下移4 mm；整体前环无分缝，阶梯槽加导入斜面与前后止挡，胶辅助固定。775对静态、18组240姿态、主控／水枪及泡泡专项通过；泡泡7项服务空间、102个主体装拆采样姿态、3项基座连续扫掠及1项出泡通道检查通过；模型、32张视图与20页PDF同步，倾斜带液工作和实物固定未验收。
- [x] 0.19 移除旧后部滴液唇并补回护甲切槽；逐对象比较确认其余306个几何对象保持。773对静态、18组240个维护姿态及主控／两枪专项通过，模型、32张视图与20页PDF同步；前部滴液／倒流和后部湿舱排液仍待验证。
- [x] 0.20 补回后部旧Ø31出口孔，仅留同轴Ø9液管穿板孔候选；其余306个几何对象不变。Ø4管路／Ø8预留到孔壁最小距离2.5／0.5 mm；773对静态、18组240姿态及主控／两枪专项通过，模型、32张视图和20页图纸同步；护套与密封适配待验。
- [x] 0.21 液舱旧Ø25孔收为Ø9候选，移除后底座单侧饰板／三条盲槽并恢复对称切面；清理旧出口生成与删除逻辑。逐对象确认仅两件补形、四件删除，其余301件保持；763对静态、18组240姿态和专项检查通过，模型、32张视图及20页图纸同步；接头／密封／实物验证仍待完成。

- [x] 0.24 保留水枪左右定位挡板与底部双面软胶，外侧挡板新增Ø5.6上开口托管座，按用户实测Ø5更新喷水管；730对静态、16组232维护姿态、双枪专项与局部管段上提连续扫掠通过，模型、视图、图纸同步。
- [ ] 试配Ø5喷水管与Ø5.6托槽，核实R8弯曲抗折、胶厚／保持力和脱胶方法；验证实际接头位置、完整软管取出与带液运行。

- [x] 0.25 外侧前后挡板各加Ø5.6上开口托槽，Ø5喷水管改为沿外侧向后接液舱，取消底部横穿；尾线导向鞍／扎带槽并入底托同一实体。695对静态、16组232姿态及专项检查通过，模型、34张视图及20页图纸同步；实物管线抗折／固定与胶粘保持待验。

- [x] 0.26 按超声波双圆柱 Ø16、总宽42、离面板高10.3 mm更新前脸；中心距26，面板基准暂定Y−81，双孔Ø16.6、状态条上移。完整圆柱无干涉，整机691对静态、16组232维护姿态及相关专项通过；PCB／背部／接头未建模，整板安装待验。
- [x] 0.27 后护甲本体以X=0为镜像面，除单侧液管孔外轮廓／斜面／脊甲座统一由镜像截面生成；保存回读实体差0、16面面积差0，单侧切除反例可检出。292件几何与0.26一致；691对静态、16组232姿态及专项通过，36张视图与22页图纸同步，新增单体对称核对页。

- [x] 0.28按用户确认的双枪自吸能力统一顶部插管；封回后护甲和舱侧管孔，后护甲无例外镜像。292件保存回读、827对静态、16组232维护姿态和专项通过；模型、36张视图及23页PDF同步。开任一补液盖前需先抽出两路吸管。
- [ ] 顶部供液试配：核实真实储液底面／5 mm离底候选、泡泡管径、吸程与首次引液、低液位／漏气／倒流、通气防溅、护口固定、R8抗折和开盖前两路柔性抽管。

- [x] 0.29：按原动力固定接口重建一体底盘，左右各外移14不变；下部前后132等宽、上缘收腰，新增独立电机检修盖；完成模型、接口／路径报告、39张视图和26页图纸同步。935对静态、28项接口、24段连续扫掠、两侧各61个履带姿态、20项工具杆及6个反例检查通过。
- [ ] 0.29实物试配：确认四座电机固定的螺钉长度／有效牙深、TrackMount接收螺纹、底盖紧固工艺、工具与电机尾线空间；补承载、防松、疲劳和打印公差验证。

- [x] 0.30：完成一体底盖、独立电源内托架与内退电机托座，保持动力接口位置；312件回读、982对静态、30项动力接口、15段连续扫掠、10项工具杆及6个反例检查通过。同步模型、39张视图、26页图纸和验证报告；真实联轴器释放、线缆与编码器尾部仍待实测。
- [ ] 0.32实物动力维护：验证打印方向／变形、四座电机承载、螺纹牙深与防松、联轴器解锁、编码器尾部和实际工具；按先拆电源内托架及本侧履带的新顺序试装。

- [x] 0.31：取消细长托座，将承力侧壁、顶梁和台阶并入底盘，保留紧凑端板与一体底盖；完成模型、41张视图、27页图纸及范围审计；968对静态、40项固定、27段连续扫掠、两侧各61履带姿态、22项工具杆和12个反例通过。

- [x] 0.32：一体电机座与底盘，取消独立端板及4颗锁紧件、前干舱隔板、电源上内隔板及跨舱横梁；保留后湿舱隔板、电源承托与一体盖。304件回读、911对静态、22项固定、21段连续扫掠、两侧各61履带姿态、18项工具杆及14个反例通过；41张视图、27页图纸及范围审计同步。真实装拆、打印强度及密封仍待验。

- [x] 2026-10-25 记录用户提供的电机输出端 Ø11.9 mm；保留 13 mm 开口，并在图纸及机械／装配文档同步总名义间隙 1.1 mm、居中单边 0.55 mm。
- [ ] 试配打印后的 13 mm 电机开口与实物输出端，核对实际槽宽、圆弧、偏心和下取过程；0.55 mm 名义单边间隙不代替打印公差验收。

- [x] ct7 并发实现与部署：独立计时／冷却、组合工具、故障关闭和主机／MCP 测试通过；应用刷写、配置保留、平台角色回读与启动联网已核对，见[说明](docs/concurrent-actions.md)。
- [x] ct7 首次组合语音回执：两路功率断开，前进 1 秒／喷水 3 秒接受；行走 1003 ms 关闭时喷水仍开启，喷水 3003 ms 独立关闭，用户确认声音／屏幕正常。仅软件回执，未测 GPIO 连续性或同时负载。
- [x] ct7 相反截止顺序回执：两路功率断开，前进 3 秒／喷水 1 秒接受；喷水 1001 ms 关闭时行走仍开启，行走 3002 ms 独立关闭，同一启动标识，启动计数 4。
- [x] ct7 首次同时通电动作：两台电机＋水枪同时运行约 1 秒，软件两路 deadline=1002 ms，启动计数 6、启动标识未变；用户确认待机无动作、到期全部停止、声音／屏幕正常且无重启。
- [x] ct7 同时带载 BOOT 全停：组合三秒请求接受，两路均记录 BOOT 关闭、软件动作持续 388 ms；用户确认全部提前停止、松开及原期限后不恢复，声音／屏幕正常，启动计数 8、启动标识未变。388 ms 不代表停止响应时延。
- [x] ct7 带载行走先停：前进 1 秒／喷水 3 秒，用户确认电机先停、喷水继续；回执分别 deadline=1002／3002 ms，启动计数 10、启动标识未变，声音／屏幕正常。
- [x] ct7 带载喷水先停：前进 3 秒／喷水 1 秒，用户确认喷水先停、两台电机继续；回执分别 deadline=1000／3000 ms，启动计数 12、启动标识未变，声音／屏幕正常。
- [x] ct7 分开下令与语音停止：三轮十秒喷水期间分别加入前进一秒；三十秒喷水请求期间再加入前进一秒，随后语音 stop 在喷水约 12.7 秒时关闭，最终输出全关、启动计数 20，启动标识未变。三十秒不是实际持续时间。
- [x] ct7 收尾：用户确认两路功率断开、USB 保留；15:16:46 状态回执输出全关、各路剩余为零、启动计数仍为 20、启动标识未变、日志丢弃 0。
- [ ] ct7 剩余现场回归：同路拒绝；电流、温升、反复带载与落地行走另验。按用户要求跳过重复断电测量，未将电压连续性记为通过；断网仍延期。

- [ ] 0.37加高颈架：实物核对侧板／鞍座／斜撑连接和线束余量，验证材料、紧固、振动、强度及满／空／单侧空瓶稳定性；CAD名义间隙不替代实际瓶盖、抽管和手部操作试验。

- [x] 0.38双枪由5°上仰至10°候选，肩梁与管路同步；水枪取消旧下移4 mm、泡泡外侧管段下绕，保留头舱加高25 mm。328对象、897对静态、16组200离散姿态及专项通过；46枪组随动、276范围外对象保持，模型、50张预览、对比及31页PDF同步。
- [ ] 0.38实物对比5°／10°的水流射程、出泡与飘行、滴液倒流、胶粘保持和软管弯曲；核对水枪底托至顶盖2.49 mm及泡泡插头旁管路空间，完成脱胶后取枪、空底托和单瓶补液试装。

- [x] ct8 局域网网页软件：设备内嵌手机页面、定时动作、500 ms 状态刷新、全部停止、独占网页会话与语音入口协调；主机 ASan／UBSan、实际 HTTP 处理函数测试及 ESP-IDF 编译通过，见[实现记录](docs/lan-control.md)。
- [ ] ct8 部署／验收：两路功率断开时备份并仅应用刷写，平台角色同步与回读；核验手机配对、语音保留、双入口停止、心跳／后台／Wi-Fi 断连、重连不恢复、内部堆／栈与音频并行；带载及真实停止时延另验。

- [x] 0.39双枪10°→15°候选，水枪基准再抬3 mm、泡泡外侧管段下绕2 mm；保持头舱加高25 mm。328对象、899对静态、16组200离散姿态及专项通过，取瓶与水枪另用完整圆柱连续扫掠及阻挡／非轴向反例核对；模型、50张视图、对比及31页PDF同步。
- [ ] 0.39实物试配：重点检查泡泡软管旁Ø8预留仅0.59 mm的余量、真实接头／手部和柔性管路；对比10°／15°的实际水流射程、出泡、滴液倒流、胶粘保持与拆装。

- [x] ct9 网页按住持续行走／松开停止，600 ms 短租期与回执串行续租；单独／组合喷水仍定时，语音限时保留，软件测试见[局域网控制](docs/lan-control.md)。
- [x] ct9 仅应用分区烧录、配置保留、平台角色回读；修复 newlib-nano 许可编号格式化问题，实机无负载 HTTP／桌面长按、松开、600 ms 失租和全停通过，见[部署记录](firmware/esp32-audio/startup-ct9.json)。
- [ ] ct9 真实手机长按／滑出／后台／断网和停止时延、声音并行、持续电流／温升及整机行走验收。

## 0.40 面包板浅托盘

- [x] 完成[0.41 超声波共存集成](docs/ultrasonic-head.md)，明确PCB／背面／接头／线束候选与冲突反例；已合入主总装与图纸，独立副本清理。
- [ ] 核实超声波PCB与探头基准、板后高度、针座和线缆，设计模块固定件；核实已合入的向上出线与托盘前缘让位候选的实物适配。

- [x] 完成0.40整组100×85×36浅托盘：305对象回读、815对静态、9组96姿态、整盘／4螺钉连续扫掠、4工具杆及3反例通过；289保留对象不变，头部外形差异0；31页图纸同步，见[记录](docs/breadboard-tray.md)。
- [ ] 实测组内最高元件与线束总高、USB接头／天线位置、屏幕观察与收音／出声通道。
- [ ] 确认面包板塑料底座可接触边缘，细化向上防脱；完成托盘、柱根、嵌件、振动及真实线束／手部拆装验证。

- [x] ct10 自动连接／重连、不重放动作，移除接管及组合开关；网页／语音按通道并用，网页优先，主机策略及真实页面脚本回归通过。
- [ ] ct10 手机多指独立操作、真实语音并用／网页抢占、后台及带载回归；按[部署记录](firmware/esp32-audio/startup-ct10.json)逐项核对。

- [x] ct10 仅应用烧录、配置字节保持、平台角色回读；实际 HTTP 两路独立启动／停止与桌面网页自动连接、长按／全停通过（功率断开）。

- [x] ct10 手机自动连接、网页在线时语音行走、语音喷水与网页长按并行、松开仅停行走、网页全停：用户反馈及实机逻辑日志一致，两路功率断开。

- [x] ct10 实机网页优先停止同通道语音喷水，回执 voice_preempted 并保留一秒冷却；用户确认提示，第二次手动重启未报告。
- [x] ct11 网页长按计时及松开保留，单调时钟／后台／全停／失联回归通过，后端保持 ct10。

- [x] 0.41保存回读309对象、827静态对、9组96姿态及超声波／托盘连续扫掠通过；头壳完整几何不变，32页图纸同步，清理19个被替代文件。

- [x] ct12：面包板两路停止间隔统一为 200 ms；主机边界／停止路径与网页短间隔刷新测试通过，平台角色保存回读一致。部署证据见 `firmware/esp32-audio/startup-ct12.json`；带载启停／温升仍未验收。

## 底盘与背包效果模块（0.42）

- [x] 记录降压板用户尺寸20×11×5 mm，生成独立包络并保存回读。
- [x] 完成中央抬高独立候选：新增占位／前抽路径及原有电机、L298N、双枪检修回归通过；保存回读308个原对象不变，变化限制在底盘中央区域，主总装与图纸仍为0.41。
- [ ] 核实MOS含端子总高及两种板可固定位置；确认两套数量、真实出线和连接器。
- [x] 用户否定[中央抬高候选](docs/effects-mount.md#方案沿革与清理)外观，A02停止作为集成方向，关键决策保留于正式记录，重复候选文件清理。
- [x] A03背包外侧竖放本体＋底盘薄承板候选完成：7个新增对象无静态干涉，液瓶／本体／承板拆装及既有机构回归通过，原309对象保存回读不变。
- [x] 0.42两侧分体夹环、底托／上限位及薄承板四点固定合入主模型，图纸与清理见[正式记录](docs/effects-mount.md)。
- [ ] 实测本体可夹区与端部、MOS总高、板卡固定位置；完成实际线束、衬垫压缩、紧固、强度和公差试配。
- [ ] 点火模块完整引线／封装、绝缘、温升、EMC及液体共存评估；不据裸本体容纳结果进行通电集成。

## 0.43 效果板固定与公差

- [x] 补充四板浅凹座、开窗防脱压框和局部接线预算；承板沉台将电源上方最小名义间隙增加到2 mm。
- [ ] 实测PCB厚度、四边空白及无焊脚区、MOS总高、端子与接线方向；按现行 Lean 胶固方案核对板边接触、保持力及接线预算；已取消的 5 个压框不再安排试制。
- [ ] 量测新电池包最大厚度、打印／加工偏差、翘曲、沉台和螺钉头，完成最不利尺寸叠加与实物拆装；核对减料承托的座底、保留安装接口及胶固防脱保持；已取消压框对应的短嵌件不再验证。

- [x] 0.44：MT3608按用户实测37×18×6 mm补入整机，建立独立包络与静态／下取检查，见[布局](hardware/model/README.md#044-mt3608-升压板包络)。
- [ ] MT3608：核对接头、焊脚及电位器位置，完善固定结构与便捷检修；当前裸板下取需先拆L298N托框及左电机，仍需实物／热验证。

- [ ] 0.48：实测新电池引线／接头与固定、点火MOS完整外形／焊脚／端子、输出线长度和弯曲；完成护口与线夹、实物拆装和公差验证。新电源带载与点火电气评估仍未通过。

## ct13 泡泡与双点火接入（2026-10-25）

- [x] 按用户确认实现泡泡与点火低压 MOS 控制候选，点火一块 MOS 同时控制两只模块；四路不互斥，独立计时与全停。见[效果控制](docs/effects-control.md)。
- [x] 增加网页／语音接口、角色源、参数边界与四路软件回归。
- [ ] 整机接线 SVG／HTML 同步 ct13 新通道，目前文字已补充、图示仍为旧基线。
- [x] ct13 仅应用刷写、配置保留、平台角色保存回读与 USB 无负载 HTTP／串口回归；见[部署记录](firmware/esp32-audio/startup-ct13.json)。
- [ ] GPIO17／21 实物引出与空闲核对、无负载电平及复位／故障关断验证；ct13 实体 BOOT 和真人语音回归。
- [ ] 点火严格 5 秒硬件截止待验证：本轮 5000 ms 请求的软件日志为 5002 ms，不视为物理时限验收。
- [ ] 泡泡 3.7 V 支路、电流、真实出泡／停止与组合供电验证。
- [ ] 两只点火模块具体参数、单 MOS 适配／保护、操作间隔依据、绝缘／液体共存／EMC 和独立切断评估；不以软件限时替代通电验收。

- [x] 0.49左右镂空侧框后端对称后伸30 mm，保留前段、镂空及厚度；见[机械记录](docs/mechanical.md#049-左右镂空底座侧框后伸)。

## ct14 喷水／泡泡持续控制（2026-10-25）

- [x] 每路六按钮，泡泡 30 秒定时上限；三路长按并行、单路松开／失租停止、晚到与重放拒绝。
- [x] 主机 sanitizer、HTTP／MCP 参数及网页交互回归；45 秒三路连续软件模拟。
- [x] ct14 实机 USB 无负载仅应用刷录、配置保留、双路持续超过 30 秒／松开／失租／全停、实际网页 1.2 秒长按及十秒定时按钮；平台角色保存回读，见[部署记录](firmware/esp32-audio/startup-ct14.json)。
- [ ] 实体按键、手机多点触控和连续负载／温升验收。

## 0.50 双瓶背包一体桶座

- [x] 0.50按用户要求将点火模块下桶座和完整环带合入双瓶背包，撤销顶部倒L件及分体夹环紧固件；见[机械说明](docs/effects-mount.md)。
- [ ] 0.50一体桶座：核对本体实测外形、软衬材料／插入力与摩擦防脱；验证颠簸／倾倒、温升及实物装拆。

- [x] ct15 手机紧凑布局、仅应用刷写与五种视口无溢出检查；全部控制及全停可见、按钮至少 44 px，见[记录](firmware/esp32-audio/startup-ct15.json)。
- [ ] 用户一加 11 刷新后的实际单屏显示确认（已做浏览器视口模拟）。

- [x] ct16 点火标题与 1／3／5 秒快捷按钮、加大全停间距；网页交互回归、应用刷录及五种手机视口检查通过，见[记录](firmware/esp32-audio/startup-ct16.json)。

## ct17 狂暴模式（2026-10-25）

- [x] 网页 5／10／30 秒按钮与倒计时；固件固定总截止、四路整体开始、单次 1 秒点火和等长关闭间隔，普通点火间隔同步。
- [x] 主机验证时限／循环／提前停止／故障／失联／重放／来源占用；网页按钮、能力识别、失焦释放和五种手机视口布局检查。
- [ ] 真人语音状态／停止及等长间隔回归、手机实机操作、持续负载／电源／温升／EMC 和真实停止时延验收；软件结果不替代硬件验收。

- [x] ct17 ESP-IDF 构建、仅应用刷写与配置保留、平台角色保存回读、实际页面与关闭状态检查；未执行实机动作，见[部署记录](firmware/esp32-audio/startup-ct17.json)。

## 0.51 合并打印

- [x] 58个设计特征归并为6个候选打印件；在独立设计源档保留源特征，主模型展平且清除重复输入；保留主要检修边界和独立STL／STEP，见[说明](docs/print-consolidation.md)。
- [x] 按用户要求将59个隐藏检查空间移出主模型并保存在设计源档；20个设备／线管占位保留默认隐藏，保持单一履带动力分组。
- [x] 统一零件名称，按相邻组件及整体高度排列模型树；FreeCAD 实际显示顺序回读通过，几何及外观保持。
- [x] 后续已完成 P2S／0.4 mm／PLA Basic 的方向、支撑与切片比较，并纳入现行 Lean 项目；0.51 六件仅为历史合并范围。
- [ ] 补齐实物支撑清理、材料／层向、底盘翘曲、孔与紧固件配合记录，并完成拆装及承载验证。
- [x] 头壳与固定饰件已合入 PP07；前舱左右侧甲各与嵌条合并，其他饰件按薄胶固定方案交付；左右镂空底座侧框保持独立并纳入 Lean 第 2 盘。实物粘接保持与强度另验。

## ct18 语音狂暴模式（2026-10-26）

- [x] 专用语音工具、默认五秒／最多三十秒、严格参数与内部票据；复用模式调度、按来源断连和停止。
- [x] ct18 完整构建／参数校验、仅应用刷写／配置保留、平台角色保存回读、工具注册及关闭状态核验，见[记录](firmware/esp32-audio/startup-ct18.json)。
- [x] 主机测试语音 5／10／30 秒模式、票据取消／重放／过期、网页来源隔离、模式间隔占用、网页抢占和统一停止。
- [ ] 真人语音默认／指定／超限／否定／状态／停止及双入口回归；不把提示词同步或主机测试当作现场语音验收。

## ct19 网页动作提示（2026-10-26）

- [x] 修复动作结束后“正在……”残留；设备回执驱动提示、并行动作、狂暴间歇、过期回执和错误／停止提示回归通过。
- [x] ct19 完整构建、仅应用刷写及配置保留、设备页面一致／最终全关核验，见[部署记录](firmware/esp32-audio/startup-ct19.json)。
- [x] 本地模拟设备浏览器逐项确认喷水／泡泡／点火／狂暴模式从运行提示变为“动作已结束。”；不触发实机执行器。

## 电源开关（2026-10-26）

- [x] 保存[开关原图与全部用户实测尺寸](hardware/components/power-switch/README.md)，同步H15／需求／接口及位置约束。
- [x] 完成0.53折面顶盖中央外装：本体由外部放入，两颗自攻螺丝从上方固定；取消内部螺母，保留电池检查向上拆卸，见[安装说明](docs/power-switch.md)。
- [ ] 试配挂耳厚度、长槽／孔位／打印公差、紧固与真实手指操作；核对焊后绝缘、线尾和工具空间。
- [ ] 核实型号、直流额定能力、触点关系及整机启动／运行电流，确定接法；完成供能切断与温升验证。

## BOOT实体按钮（2026-10-26）

- [x] 完成0.54右肩一体座、后插螺母、护边、出线固定及到头舱后槽的GPIO0/GND路线，保存回读与整机维护路径回归，见[说明](docs/boot-button.md)。
- [ ] 确定常开自复位按钮型号，补杆径、螺纹、法兰、螺母、端子、行程和低电流触点规格；据实测调整候选孔位。
- [ ] 核对真实焊线与绝缘、线径／接头、板内GPIO0/GND末段、净径10 mm通道的实际线束填充、弯曲／应力释放、托盘拆卸余量和整手可达性；完成打印试装。
- [ ] 外接按钮的实际停止、松开不恢复、启动绑带行为及电气干扰验证；独立断电验收仍单列，不以CAD代替。

## PP02 圆环底座调整（2026-10-26）

- [x] 删除指定两处凸起；完成 Ø32 mm 偏心孔、孔底抬高 2.3 mm、20 mm 宽支脚及底部 7.5 × 2.3 mm 缺口，见[说明](docs/print-consolidation.md)。
- [x] PP02 增加 Ø32.8 下缘避让，消除当前 CAD 枪壳干涉；完成枪体相对底座的 102 个离散拆装姿态检查，见[记录](hardware/model/remaining-print/README.md)。
- [ ] 以实际枪体验证复合孔口、穿环／取枪、打印公差及固定保持；完整线束／手部拆装与强度尚未验收。

### 2026-10-26 泡泡枪尾壳

- [x] 按用户确认更新正式尾壳35.9 mm，保持底部薄片6.8 mm及现有安装位置；源档、交付模型、STEP和独立部件新修订同步，见[检查](hardware/model/bubble-tail-height-audit.json)。
- [ ] 补测尾壳最大宽度及内侧轮廓，复核BOOT指端空间；PP02 名义静态干涉已修正，继续验证实际枪体、线束和手部的完整拆装路径。

- [x] 30 mm 电机尾距布局与固定候选：用户已补两台电机安装面至尾部均 57 mm，支持居中候选；名义面距推导 32 mm 与实测 30 mm 相差 2 mm，仍按 30 mm 检查；按[独立布局检查](hardware/model/drive-fit-fixture/l298n-gap-study/README.md)已按后续 28.5 mm 插线厚度完成底盖承载支架和接线候选，并同步正式 CAD；详见下方 0.57，实物验收未关闭。

## 0.58 头部整体打印

- [x] 头部三件完成快速切片：头壳4小时9分，冠盖＋托盘共盘3小时24分；冠盖螺丝座局部加密、托盘安装耳截面检查通过，见[交付记录](hardware/model/print-parts/PP07-slicing/head-set-speed/README.md)。实物验证仍未关闭。

- [x] 34个头壳／固定装饰特征通过14处连接归并PP07，前脸面板合并，冠盖和托盘独立；底盘不改，见[打印说明](docs/head-shell-print.md)。
- [x] 按已确认Ø2.5／含帽8.6／帽Ø3.9×1 mm螺丝适配头部8处固定点，检查局部干涉、拆装、网格与切片朝向。
- [ ] 补齐 Ø2.1 候选导孔的坐实、开裂、顶底及重复拆装保持力记录；如缺少试拧证据，补打导孔试件。核对已装样机的大壳支撑清理、冠盖与托盘配合，不由整机照片推定这 8 处紧固验收通过。

## 0.57 L298N 固定与接线候选

- [x] 按电机 57／57 mm、30 mm 尾距及 L298N 插线厚 28.5 mm 完成转向支架、底盖承载、压框紧固和前后接线空间；同步正式 CAD、独立接线包络和试配导出，见[记录](hardware/model/l298n-compact/README.md)。
- [ ] 实物核对软垫接触、紧固件和装配余量，确认实际线径、弯曲、快拆／检修余线；完成底盖承载及温升验证。局部几何通过不关闭整机机械或电气验收。

## 剩余四件共盘（2026-10-26）

历史五盘阶段：PP01／PP02 现位于 Lean 第 3 盘，PP03／LC04 位于第 6 盘；以下旧盘号及耗时保留原范围。

- [x] 修正 PP02 静态干涉、连接 LC04 悬空安装柱；保留其他零件，导出四件 STL／STEP。
- [x] 完成方向／支撑／墙线比较，新增第 5 盘；0.28 mm、3 墙，33 个截面路径检查通过，预计 5 小时 24 分、264.39 g。见[交付](hardware/model/remaining-print/README.md)。
- [ ] 补齐枪座、顶盖柱及背包的实际孔位、支撑清理和拆装记录，验证承载与层向强度；样机基础装配不等于这些项目通过。

### 2026-10-26 遗漏件补齐

历史 34 件六盘阶段，后续先精简为 Lean 29 件，再经背包调整为现行 27 件；取消的压框及减料前承托不再作为补打入口。

- [x] 补齐 5 个装配件和 9 个外观特征；两组侧甲/嵌条合并后新增 12 个打印件，共用第 6 盘。
- [x] 修正承板/托架相切连接并完成闭合网格、独立 STEP、56 个关键截面与 GUI 回读检查；原五盘 22 件及 G-code 保持。
- [x] 按用户要求移除上下两个线束护口，同步模型与清单。
- [ ] 实物核对瓶托、减料后 MOS 承托、保留的 L298N 压框及紧固件配合；验证 MOS 热熔胶固定、外观件薄胶配合及粘接保持力。交付见[补齐说明](hardware/model/completion-print/README.md)。

## ct20 电机 PWM 调整（2026-10-26）

- [x] 按移动偏慢反馈，将面包板电机 PWM 从 154 提高为 204（8 bit，约 80%），同步逻辑状态、工具描述和既有测试预期。
- [x] 主机 ASan／UBSan、输出与故障矩阵、网页／MCP／HTTP 回归及 ESP-IDF 完整编译通过，见[验证记录](firmware/esp32-audio/verification-ct20.json)。
- [x] ct20 仅应用刷写、原应用备份、配置区保持、启动联网、网页一致和最终逻辑输出全关核验，见[部署记录](firmware/esp32-audio/startup-ct20.json)。检查未发送动作请求；该启动已记录 2 次动作，来源与实际效果未由本轮核实。
- [ ] 验证新档位的实际移动速度、停止、电流、母线与温升。

## 2026-10-27 语音别名与静默执行

- [x] 更新唯一角色源：扩展点火／喷水别名、限定“饭店→放电”纠错，动作及停止成功静默；同步[回归预期](docs/agent-role.md#2026-10-27-扩展别名饭店纠错与静默执行)。
- [ ] 重启设备加载后执行真人语音回归：新别名、同义词去重、默认／指定／上限、停止／否定／状态、饭店纠错及餐饮反例、静默成功与异常说明。功率断开核验工具回执，文本回读不代替现场验收。

## ct22 指定时长、PWM 与动作序列（2026-10-28）

- [x] 仓库实现行走取消三秒截断、230/255 PWM、最多 16 步顺序及四路同时动作；同步角色源、接口和状态。
- [x] 主机 sanitizer、序列取消／抢占／重放、MCP／HTTP 参数、网页状态及 ESP-IDF 编译；见[记录](firmware/esp32-audio/verification-ct22.json)。
- [x] ct22 仅应用烧录、配置字节保持、5401 字符角色保存回读、随后重启联网与九工具／输出全关闭核对；见[部署记录](firmware/esp32-audio/startup-ct22.json)。未执行动作回归。
- [ ] 解决电机运行时不喷水：单独喷水一秒正常；左转一秒＋喷水一秒仅转向；左转一秒＋喷水三秒在停转后才出水。串口确认两路同时接受、分别 deadline 关闭，停转后未重新启动水路。优先测并发负载下的供电／回流及控制端电平，尚未确定根因或修复；主机四方向 × 15 通道组合通过不替代实测。见[现场反馈](docs/action-sequences.md#2026-10-28-并发喷水现场反馈未解决)。
- [ ] 真人语音验证三条用户示例、默认左转时长（当前 ct39 的 100% 速度为 880 ms）、长时行走、否定／停止／状态、步骤间取消和静默成功。
- [ ] 90% PWM 的实际速度、停止距离、电流／母线及温升；软件通过不关闭带载验收。

## ct23 网页同时启动对照（2026-10-28）

- [x] 网页新增“左转＋喷水，各 3 秒”，单次原子请求；检查忙碌／冷却／能力、状态刷新及停止竞态，不重试、不拆单。
- [x] 主机、网页、MCP／HTTP、ESP-IDF 编译通过；仅写应用、配置保持、ct23 启动联网、设备网页按钮可用且未触发动作。见[部署记录](firmware/esp32-audio/startup-ct23.json)。
- [x] 用户点击网页组合按钮：两路各接受 3000 ms、在 3004 ms 到期关闭，但实物只左转、未喷水；复现与语音组合相同症状。此入口不是喷水故障修复。
- [ ] 区分组合输出路径与同时启动电气扰动：补板端 GPIO18 控制脚读回或供电测量，不能以逻辑 ON 宣称硬件通电，也不能仅据共用电池认定根因。

## ct24 GPIO18 数字读回诊断（2026-10-28）

- [x] 保留喷水输出并启用 GPIO18 输入；按次记录高低样本、电机重叠样本及关闭电平，独立日志输出，不自动补做或改时长。
- [x] 主机故障注入、MCP／HTTP 与 ESP-IDF 编译通过；仅写应用，配置保持，启动 GPIO18 为低、无输出故障、动作计数为 0，见[部署记录](firmware/esp32-audio/startup-ct24.json)。
- [x] 用户连续两次复测网页组合：喷水略慢启动，随后持续与左转并发；每次 606 个 GPIO18 运行样本均高、关闭后低，两路约 3 秒到期。见[现场记录](docs/action-sequences.md#ct24-首次实物复测2026-10-28-至-29-日)。
- [x] ct24 两条语音复测出现喷水：直接左转＋喷水及前进后左转＋喷水；GPIO18 分别 601／600 个高样本、0 个低样本，各路按约定时长结束，见[现场记录](firmware/esp32-audio/field-ct24.json)。
- [ ] 确认跨场景稳定性与喷水启动滞后：用户反馈直接语音组合略慢于网页，后续并发步骤接近网页。延迟未量化、此前失败根因和改善原因未确定。

- [x] ct24 独立截止现场通过：左转一秒＋喷水三秒，行走在 1001 ms 停止、水路在 3001 ms 停止。
- [x] ct24 运行中语音停止与取消后续步骤：更长首步复测请求前进 15000 ms，6082 ms 时以 stop 提前关闭；序列停在第 1／2 步且 cancelled，输出全关、动作数不再增加，用户确认后续左转和喷水未执行。先前到期后才收到停止的尝试保留为历史，不计入本项通过。
- [ ] 脱离 USB 后按日常供电方式复测组合动作；继续观察轻微出水滞后，保留 ct24，不将本轮通过扩大为电气／温升验收。

## ct25 恢复常规网页（2026-10-29）

- [x] 移除临时“左转＋喷水，各 3 秒”按钮及专用逻辑，保留同时执行接口、语音序列与 GPIO18 诊断。
- [x] 网页回归、ESP-IDF 构建、仅应用烧录、配置保持、设备网页与源码一致及启动全关核对通过，见[部署记录](firmware/esp32-audio/startup-ct25.json)；未发送动作请求。

## ct26 默认全速、指定速度与动态调速（2026-10-29）

- [x] 默认 PWM 255，指定 1–100%，网页实时滑块、语音 ±10 个百分点及序列分步速度；不续时或重启其他通道，停止后调速不启动。
- [x] 主机、接口、网页竞态及构建通过；手机布局核对，5987 字符角色保存回读，见[速度控制](docs/speed-control.md)。
- [x] ct26 仅应用部署、配置区保持、启动联网与网页一致；闲置速度 80／50／100% 回执通过、最终默认 100%，执行器启动计数为 0，见[部署记录](firmware/esp32-audio/startup-ct26.json)。
- [x] 用户反馈网页滑块与语音加／减速正常；对应时段串口已断开，没有调速日志佐证。
- [ ] 指定绝对目标、独立截止与停止等按 ct27 回归；电流与温升仍待测。

## ct27 60% 下限与目标速度（2026-10-29）

- [x] 固件、MCP、网页与序列统一 60–100%；默认 100%，相对加减 10 个百分点限幅。
- [x] 新增 `self.tank.set_speed`；“减速到 60%”直接调速，“全速＋方向”按 100% 启动；不改变方向、截止、租期和其他通道，停止或跨步骤迟到请求拒绝。
- [x] 主机、导出接口、网页回归与构建通过；角色 5974 字符保存回读一致；应用烧录、配置保持、闲置速度与启动全关核对通过，见[速度控制](docs/speed-control.md)。
- [ ] ct27 用户实测 60% 下限、绝对目标、全速四方向及停止后不启动；定量电气与温升另行验收。

- [x] ct27 后续：用户确认速度测试符合预期，明确单独“全速”未生效；补齐短句目标 100 与同向调速规则，提示词保存回读、重启联网，固件不变。
- [x] 用户复测移动中单独“全速”成功；08:54 串口确认 60% → 100%、forward 与启动计数 1 保持、原截止不变，10003 ms 后到期停止。
- [ ] 单独“全速”的停止／否定／查询不误启动回归；原失败语句没有对应串口调速记录，不宣称失败根因已完整复现。
