miclle/cybertrack/firmware/esp32-motor-bench/df-md-history.md

# DF-MD 电机台架历史记录

2026-10-25：DF-MD 已退出选型。本文件原样保留旧 0.1.x 方案与失败记录，以下“当前源码／本轮／后续”均指当时的旧板测试；不适用于 L298N。目录中的现行源码已迁移至 [L298N 独立台架](README.md)（当前源码为 `0.3.2-l298n-dual-10s`，样机 ct21 另见[面包板工程](../esp32-audio/README.md)），历史源码可从 Git 中对应的旧版本查阅，旧测试结果不继承为新板通过证据。

版本 `0.1.2-motor-bench`，ESP-IDF **v5.5.1**，ESP32-S3 N16R8。这是用户授权的本地串口台架工具，与原来的无负载／PSRAM 工程并列；不接网络，不接平台协议，不改变正式固件能力或认证门槛。主机测试和交叉编译结果不代表电机实测通过。

## 接线

先断开 MT3608／驱动供电和 USB。拆除此前拟定的 E1 按钮／3V3 接法；本次用户没有按钮、10 kΩ 电阻，改由 GPIO 控制。只接一台固定的空载电机，暂不装履带，编码器四根线分别绝缘、不接电。

| 来源 | 接到 |
|---|---|
| ESP32 **GPIO4**（左排 J1-4） | DF-MD 控制排针 **E1** |
| ESP32 **GPIO5**（左排 J1-5） | DF-MD 控制排针 **M1** |
| ESP32 **GND**（例如左排 J1-22） | DF-MD **GND** |
| DF-MD **E2、控制排针 M2** | **GND**，第二路保持关闭 |
| 已试转电机的两根动力线 | DF-MD 第一通道的两个电机输出螺丝端子 |
| MT3608 **OUT+，实测 12 V且不超过12 V** | 从同一输出分两支接 **VS、VD**；取下 VD／VS 供电选择跳帽 |
| MT3608 **OUT−** | DF-MD 电源 **GND**，单独承担电机电流回路 |
| 电脑 USB | ESP32 背标 **COM** 的 USB 口；115200 baud |

J1 方位按[已归档板卡图](../../hardware/components/ESP32-S3-N16R8/README.md)：元件面朝自己、天线向上、USB 向下；按 GPIO 丝印定位，J1-4 是连接器针号，GPIO4 才是信号名。控制排针 M1 不是电机输出端子。不将 12 V、VD、VS 接入主控的 3V3、5Vin 或 GPIO。动力回线不经 ESP32 或面包板。

[DFRobot 官方文档](https://wiki.dfrobot.com/dri0002)说明 E 为 PWM 使能、M 为方向、E 低停止，控制高电平从 2.3 V 起；本测试用 3.3 V GPIO，VD 是板上逻辑电源输入。供电跳帽取下后，VS 与 VD 均由同一个已调好的 12 V 输出供电，不是两路电源并联。实物丝印不符时先解决端子对应，不凭图片位置猜测。

**没有外部下拉，本程序不能保证 MCU 失电、复位、下载或启动前的 GPIO 电平。**内部下拉只在应用配置后生效。因此本轮必须主控先启动并确认关闭，再接驱动 12 V；驱动 12 V 最先断开，再拔 USB、复位或烧录。保持可直接拔断的驱动供电连接在手边；软件／BOOT 不替代该切断。若主控意外复位、USB 掉线或状态不明，立即断驱动电源。本轮不做驱动带电时的复位／拔 USB 测试，不声称已实现硬件默认关闭。

## 编译、烧录和串口

在仓库根目录执行。**烧录和打开串口监视器前先断开驱动 12 V**；这些操作可能自动复位。仅保留主控 COM USB。新镜像会替换原无负载检查应用；沿用现有分区布局，不执行全片擦除。

```sh
export IDF_PYTHON_ENV_PATH=/Users/miclle/.espressif/python_env/idf5.5_py3.14_env
. /Users/miclle/esp/esp-idf/export.sh
idf.py -C firmware/esp32-motor-bench -B "$PWD/build/firmware-motor-bench" build
idf.py -C firmware/esp32-motor-bench -B "$PWD/build/firmware-motor-bench" -p <COM_PORT> -b 115200 flash monitor
```

用实际串口路径替换 `<COM_PORT>`（尖括号不保留）。如使用此前已验证的独立 esptool 5.6.0 低速 ROM 通路，应用更新命令为：

```sh
esptool --chip esp32s3 --port <COM_PORT> --baud 115200 --no-stub \
  write-flash --flash-mode dio --flash-size 16MB --flash-freq 40m \
  0x10000 build/firmware-motor-bench/cybertrack_motor_bench.bin
idf.py -C firmware/esp32-motor-bench -B "$PWD/build/firmware-motor-bench" -p <COM_PORT> monitor
```

后一方式要求已保留本项目既有 bootloader／分区表。2026-10-24 用户确认驱动 12 V 已断开并明确授权烧录、打开串口；已完成应用烧录和启动日志检查，详见文末。

## 操作

1. 驱动 12 V 保持断开。打开串口，看到 `BENCH READY 0.1.2`；先不连接电机，接通驱动 12 V，万用表确认 E1、E2 对 GND 均约 0 V，VS／VD 约 12 V。尚未使能时不能有输出驱动。
2. 断开驱动电源，电机接入第一通道；固定电机并确认输出轴空载。主控保持运行，再接通驱动电源，电机应不转。
3. 在串口监视器**单独按小写 `a`**（无需回车），等到 `ARMED`。随后 **3 秒内单独按 `f`**：GPIO5=0，GPIO4 输出一次 **1 kHz、8 位 duty 102／256（约 40%）、10000 ms** 的 PWM，然后输出关闭并打印 `DISARMED`。这不等于 40% 实际转速。
4. 等至少 **1 秒且轴完全停稳**，重新按 `a`，收到 `ARMED` 后按 `r`，GPIO5=1，反向点动一次。两种符号只代表控制方向，是否对应车体前进另行标定。
5. `s` 或 **板载 BOOT** 中止动作并撤销使能；松开 BOOT 不会恢复，需释放稳定 30 ms 后再次人工 `a`。不要按住 BOOT 上电／复位，它仍是下载绑带。
6. 完成后先断驱动 12 V，再退出串口（Ctrl+]）或拔 USB。换测第二路时全部断电，将 GPIO4／5 与电机换接到 E2／M2 和第二路输出，原 E1／M1 接地；仍只接一台电机。

每个动作都消耗一次使能；没有循环、动作队列或自动重试。`a` 超过 3 秒失效；动作后冷却 1 秒。运行中收到新的非换行字符会停止，不能直接换向。未知字符或同一接收批次中的多条命令会撤销使能；不要粘贴 `af`、发送宏或使用自动重复工具，始终等待上一个状态回复。UART 错误／溢出会关闭并清空接收。UART 无法可靠识别电脑断开，不能把关闭串口当作即时停止；正常调度下剩余脉冲仍受 10000 ms 限制。

10 秒测试用于观察电压；若电机堵转、异响、供电掉压或发热，立即按 s／BOOT 或切断驱动供电，不必等待到期。40% 不能保证克服减速电机启动阻力；如果只响不转、升压掉压／重启或发热，不连续点动，先断电检查电压、动力接线和机械状态。程序没有电流、欠压或温度传感器，不会自动检测这些情况。万用表不能验证 PWM／启动瞬态或毫秒停止延迟。

## 实现与验证边界

- `main/bench_policy.c`：单次使能、到期、冷却、停止、输入批次和时钟回退处理；不接正式网络协议。
- `main/motor_bench.c`：单任务拥有 GPIO／LEDC，5 ms 轮询 BOOT 和本地串口；到期／BOOT 优先撤销输出，电机活动期间不打印日志。程序初始化时设置 GPIO 低和内部下拉，LEDC 初始 duty 为零。
- 1 秒任务看门狗为异常检测后备，不能保证任务卡死时仍在 10000 ms 内关闭，也不能补上复位高阻阶段的硬件缺口。软件 10000 ms 期限仅在正常调度与驱动调用下成立；实际电气延迟与滑行未测。
- GPIO／驱动 API 错误会尝试关断并停留错误状态，不自动恢复；软件失败时仍须人工切断 12 V。

主机策略测试命令（不需要 ESP-IDF）：

```sh
mkdir -p build/motor-bench-host
cc -std=c11 -Wall -Wextra -Werror -fsanitize=address,undefined -g \
  -I firmware/esp32-motor-bench/main \
  firmware/esp32-motor-bench/main/bench_policy.c \
  firmware/esp32-motor-bench/tests/policy_test.c \
  -o build/motor-bench-host/policy_test
build/motor-bench-host/policy_test
```

2026-10-24 主机 ASan／UBSan 策略测试通过，覆盖无使能拒绝、到期边界、单次时限、冷却、禁止运行中换向、停止与松开、批量／异常输入、时间回退／溢出及重建状态。板上 GPIO 电平、PWM 波形、BOOT 带载停止及 DF-MD 转动仍未测；原无负载工程及其报告保持原有范围。

0.1.0 的 ESP-IDF v5.5.1 交叉编译已通过，应用大小 245184 bytes；产物 `build/firmware-motor-bench/cybertrack_motor_bench.bin`。编译日志存于本机 `build/motor-bench-host/idf-build.log`；随后已按用户授权烧录。

## 2026-10-24 烧录与启动记录

用户确认 DF-MD 的 12 V 已断开，主控 COM USB 已接电脑。使用 esptool 5.6.0、115200 baud、no-stub，只将应用 245184 bytes 写至 0x10000，写入哈希校验通过；保留既有 bootloader、分区表和其余 Flash。未改写 eFuse。

应用 SHA-256：`71af07bd34041729831da15993bab9f5d457fef8f1626c5e6fc3bd26b2e454ee`。

串口实际读到项目名 `cybertrack_motor_bench`、版本 `0.1.0-motor-bench`、ESP-IDF v5.5.1、8 MB PSRAM 初始化与内置测试通过，以及：

```text
BENCH READY 0.1.0 GPIO4=E1 GPIO5=M1 PWM=1000Hz/40% pulse=200ms
Driver power LAST ON / FIRST OFF. Keys: a=arm(3s), f/r=one pulse, s=stop.
BOOT stops; no auto-repeat. Wait >=1s AND shaft stopped between pulses.
```

此次未发送 a／f／r，没有执行点动。该证据只证明镜像烧录和程序启动，GPIO 实测电平、DF-MD、电机启停与换向仍待验证。本机日志为 `build/motor-bench-private/flash.log`、`serial.log`；端口设备标识不写入公开记录。串口工具曾因禁用地址解码选项触发自身异常，改用默认解码后成功读取上述日志；不将此前工具异常当作固件验收结果。

## 2026-10-24 首次点动请求：重连后中止

用户报告已按接线表连接、E1／E2 对地均测得 0 V，并已接通驱动 12 V，授权一次点动。执行前发现上一轮串口进程已结束；本次使用 pyserial 3.5，打开前设置 DTR=False、RTS=False，未主动调用复位序列，但打开后读到了 `ESP-ROM`、`rst:0x1 (POWERON)` 及完整应用启动日志。不能据此认定串口重连没有触发复位，也未确定触发原因。

脚本在使能前中止，发送 a／f／r 的次数均为零，只尝试发送 s；此时仍在启动，未取得该 s 的 DISARMED 回执。之后读到 BENCH READY，但这不替代实际使能引脚测量。已要求先断开驱动 12 V，未自动重试动作。

本地 pyserial 实现先 `os.open()`，再分别应用 DTR／RTS 状态；预设两者为 False 无法证明整个打开过程无控制线瞬态。后续必须在驱动断电时建立稳定串口连接，取得未使能回复，再由用户接通驱动电源；若连接丢失，回到驱动断电步骤。用户提供的静态 0 V 测量单独保留，不作为启动／重连瞬态或电机测试通过。

## 2026-10-24 驱动断电后恢复持久串口

用户明确确认驱动 12 V 已断开、主控 USB 保持连接。已使用独立的 GNU Screen 会话 `cybertrack-dfmd` 保持 pyserial miniterm（115200 baud）运行，不依赖某一次工具调用的 PTY。建立连接后读到启动日志与 BENCH READY，再只发送 s，收到 `BENCH DISARMED outputs=OFF`；未发送 a／f／r。持久会话信息和串口画面存于本机忽略目录 `build/motor-bench-private/`。

下一步先复核使能脚低电平，再由用户接通驱动电源；动作必须复用这条现有连接。若进程／串口丢失，先断驱动电源再恢复连接，不能在 12 V 带电时自动重连。需要手动查看时可在终端运行 `/opt/homebrew/bin/screen -r cybertrack-dfmd`，这是附着已有会话，不重新打开串口；Ctrl+A 后按 D 仅脱离画面、保留连接。不要按 Ctrl+]，它会退出 miniterm 并关闭串口。

## 2026-10-24 首次串口单次点动命令

用户再次确认 E1／E2 对地均为 0 V、驱动 12 V 已接通，并授权点动一次。13:05:58（Asia/Shanghai）确认持久串口进程仍在，复用原连接，未重新打开串口或调用复位。依次发送 s → 收到 DISARMED；a → 收到 ARMED；只发送一次 f → 收到 DISARMED；最后追加 s 并再次收到 `BENCH DISARMED outputs=OFF`。

配置为第一通道、GPIO5=0 方向、1 kHz、约 40% PWM、200 ms 软件期限。电脑从发送 f 到观察到关闭回复约 260.43 ms，包含串口与画面读取开销，不作为电气脉冲宽度或机械停止延迟。原始命令／回执记录见本机 `build/motor-bench-private/pulse-20261024-130558.json`。没有重试或发送反向动作；连接继续保留。电机是否实际转动、停下及有无异常仍等待用户观察，不据回执认定 DF-MD 或电机实测通过。

首次点动后的用户反馈：电机没有转动；手动转动电机时 DF-MD 指示灯会亮。仅据此记录“本次未观察到转动”，不能把串口关闭回执当成驱动测试通过。手转发电导致输出指示灯发亮是一种解释，尚未测量确认；仍需先测驱动板 VS／VD 对 GND 的实际电压，再排查控制端对应、负载输出和启动占空比。暂不自动加大占空比、延长脉冲或重复点动。

用户希望在命令行查看串口。持久 Screen 会话仍在，可用 `/opt/homebrew/bin/screen -x cybertrack-dfmd` 共享附着，不重新打开串口；读取历史可按 Ctrl+A 后按 Esc，上下翻阅，Esc 退出回看；Ctrl+A 后按 D 脱离但保持连接。驱动带电时不要启动另一个串口程序或退出 miniterm。

## 2026-10-24 用户确认供电后重试

用户报告 VS／VD 对 GND 均为 12 V，并认为此前可能断供，要求按原参数重试。静态测量不代表起动时电压稳定。源码核对：ESP-IDF v5.5.1 的 ledc_update_duty 会重新开启 sig_out_en，未发现 ledc_stop 后无法恢复输出的调用错误；此项是源码证据，不证明实物波形。

13:12:48 的检查在使能前中止，未发送 f：终端 hardcopy 文件异步写入／重排导致旧启动内容计数变化，被脚本误判为新启动；原始串口日志没有新增启动记录。13:13:44 改读原始日志，但日志缓冲导致回执等待超时，同样未使能或点动。已将辅助脚本改为每次生成独立画面文件，等待内容稳定后检查回执，避免读到被截断／正在改写的内容。

13:14:10（Asia/Shanghai）复用既有串口，s→DISARMED、a→ARMED 后只发送一次 f，随后观察到 DISARMED，追加 s 也得到关闭确认。参数仍为约 40%、200 ms、第一通道同一方向，没有重新烧录／打开串口或主动复位。电脑发送至观察关闭回复约 381.13 ms，含画面抓取等待，不作为实际 PWM 宽度。记录位于本机 `build/motor-bench-private/pulse-20261024-131410.json`；这次电机实际转动情况等待用户反馈。

13:17:58（2026-10-24，Asia/Shanghai），用户报告此前充电宝反复自动断开，现换了输出口并重新供电，授权再次测试。复用原串口按同参数发送一次 f（约 40%／200 ms），收到 DISARMED，并追加 s 获得关闭确认；没有复位或重新打开串口。原始记录为本机 `build/motor-bench-private/pulse-20261024-131758.json`。电脑观察关闭回复约 392.13 ms，含串口／画面读取开销，不是硬件脉宽。换口后电机表现和供电持续性等待用户反馈；不将此前不转直接归因于低负载自动关断，尚未区分端口策略、保护及接触等原因。

## 0.1.1：按用户要求延长点动

用户反馈供电正常但电机仍未转动，要求延长观察时间。单次时限由 200 ms 调整为 1000 ms，PWM 仍约 40%，保留单次使能、BOOT／s 停止、冷却与禁止动作排队。主机测试增加旧 200 ms 边界后继续活动、新 1000 ms 边界关闭及延长期中途停止检查。用户已确认驱动 12 V 断开、USB 保持连接，允许执行本轮固件更新；更新与启动结果另记。延长时限不能保证解决启动问题。

0.1.1 更新结果：ASan／UBSan 策略测试及 ESP-IDF v5.5.1 编译通过。由于此前临时 esptool 5.6.0 环境已不在，使用 IDF 环境的 esptool 4.12.dev2、115200 baud、no-stub 更新 0x10000 应用；镜像 245184 bytes，工具按块填充写入 245760 bytes，哈希校验通过。镜像 SHA-256：`88fa73246de76611c8aa9d78a1db5731012f9b0232c4e2b29de01401fcc4142f`。保留既有 bootloader／分区表，未改写 eFuse。

驱动断电下重新建立持久串口，实际读到 `BENCH READY 0.1.1 ... pulse=1000ms`；只发送 s 并收到 `BENCH DISARMED outputs=OFF`，未在新版本执行动作。烧录日志 `build/motor-bench-private/flash-0.1.1.log`、启动与关闭回执 `ready-0.1.1.txt` 保留在本机。用户下一步复测 E1／E2 为低、接通驱动后才能进行一次 1 秒试转；此前 200 ms 试转不成功的记录继续保留。

2026-10-24 13:26:02（Asia/Shanghai），用户确认 E1／E2 对地均为 0 V、驱动 12 V 已接通，授权一次 1 秒点动。复用现有持久串口，s→DISARMED、a→ARMED 后只发送一次 f；固件配置为第一通道同一方向、约 40% PWM、1000 ms。收到 `BENCH DISARMED outputs=OFF`，追加 s 也获得关闭确认。电脑发送 f 至观察到关闭回复约 1207.74 ms，包含串口与画面读取延迟，不是实测电气脉宽或机械停止时间。原始记录：本机 `build/motor-bench-private/pulse-20261024-132602.json`。未重新打开串口、复位或重复点动；实际转动及停止情况等待用户观察反馈。

1 秒点动后的用户反馈：电机仍未转动，无嗡声或抖动。保持未通过状态，不从串口回执推定实际 GPIO 波形。串口查看失败已定位到两个 Screen 版本使用不同套接字目录：系统 `/usr/bin/screen` 4.00.03 查找临时目录，Homebrew `/opt/homebrew/bin/screen` 5.0.2 查找 `~/.screen`，后者可见现有会话且 miniterm 仍占用 COM。查看时使用 Homebrew 完整路径附着原会话，不重新打开串口。下一步先确认驱动电源指示灯和实物通道对应，再安排控制端／输出端测量；本次排查未发送额外动作。

## 0.1.2：10 秒电压测量窗口

用户报告电源灯正常、串口可见；1 秒测试时 E1 对 GND 短暂上升至约 1.3 V，电机未转。下一次在电机两端测得仍为 0 V，用户要求延长到 10 秒以方便读数。记录是万用表观察，不等同波形或板卡故障判定。单次软件时限调整为 10000 ms，PWM 保持约 40%，保留 s／BOOT 提前停止、单次使能和到期自动关闭；不自动连续运行。延长时限后同步修正时间溢出保护，覆盖较长脉冲期限。用户已确认驱动 12 V 断开、USB 保持连接；编译、烧录与启动结果待记录。

0.1.2 更新完成：ASan／UBSan 策略测试和 ESP-IDF v5.5.1 编译通过。驱动断电下使用 esptool 4.12.dev2、115200 baud、no-stub 仅更新 0x10000 应用，镜像 245184 bytes，填充写入 245760 bytes，哈希校验通过；SHA-256：`7a8f3ebb8e17dd68d1665a917ec52073b573e14a5f2464b15306ee05f8f23687`。串口实际读到 `BENCH READY 0.1.2 ... pulse=10000ms`；只发送 s，收到 `BENCH DISARMED outputs=OFF`，未执行 10 秒动作。新持久会话可用 `/opt/homebrew/bin/screen -x cybertrack-dfmd` 查看。烧录日志与启动回执：本机 `build/motor-bench-private/flash-0.1.2.log`、`ready-0.1.2.txt`。接回驱动供电及实测仍待用户确认。

2026-10-24 13:38:44（Asia/Shanghai），用户确认 E1／E2 对地均为 0 V、驱动 12 V 接通、表笔已跨接电机两端，授权一次 10 秒测试。复用既有串口，s→DISARMED、a→ARMED 后仅发送一次 f；约 40% PWM、10000 ms 配置，随后收到 DISARMED，追加 s 也得到关闭确认。电脑发送至观察关闭回执为 10227.33 ms，含串口与读取延迟，不是实测电气脉宽。原始记录为本机 `build/motor-bench-private/pulse-20261024-133844.json`；实际电机端电压和转动情况待用户反馈。

用户随后更正：13:38:44 测试时驱动 12 V 实际未接，不能用于判断驱动板输出或电机响应。用户重新接通并要求重测，13:40:05（2026-10-24，Asia/Shanghai）复用现有串口执行一次同参数 10 秒测试，收到 DISARMED 并追加 s 确认关闭。电脑观察关闭回执约 10156.98 ms，包含通信／画面读取延迟，不是电气脉宽；本机记录 `build/motor-bench-private/pulse-20261024-134005.json`。此次电压和实物响应待用户反馈。

13:40:05 供电重测后的用户反馈：电机两端全程仍为 0 V，没有转动或声音。10 秒观察仍未见输出，不再仅以万用表刷新慢解释；尚不能据此判定驱动板损坏。下一步核对实物 E1／M1 控制端与第一路电机输出端对应，再检查有效控制信号及动作期间供电；本轮未追加动作。

2026-10-24 13:50:28（Asia/Shanghai），用户要求对比第二通道并确认已按说明换接：GPIO4→E2、GPIO5→控制 M2，E1／控制 M1 接地，同一电机与表笔接第二路输出，E1／E2 静态均为 0 V、驱动 12 V 已接通。未改固件，启动日志中的 E1／M1 名称仍是原始接线标记，不表示本次实际通道。复用串口执行一次约 40%、10 秒动作，收到 DISARMED，再发送 s 确认关闭；电脑观察关闭回执约 10108.69 ms，非实测电气脉宽。本机记录 `build/motor-bench-private/pulse-20261024-135028.json`；第二路电压和电机表现待用户反馈。

第二路 10 秒测试后用户报告输出仍为 0 V、无转动／声音／抖动；在板上复测 VS／VD 均为 12 V。随后按静态诊断接法断开电机及 GPIO4／5 控制线，将 E2 接 ESP32 3V3、控制 M2 接 GND，第一路保持接地。用户实测 E2=3.3 V、M2=0 V、第二路差分输出仍为 0 V，并确认随后已断开驱动 12 V。该结果不支持仅以 PWM 时长或电机启动负载解释；待核对实物 V1.3 板内逻辑电源和内部信号，不能直接认定 L298 损坏。当前为静态接线，串口 s 无法撤销 E2 的固定高电平；不得据原串口记录自动恢复电机测试。

用户上传 V1.3 正面实物照片，可见三脚稳压器标记 AMS1117／5.0。按该器件 SOT-223 引脚定义，上侧宽焊片与中间脚为输出。用户报告宽焊片对板上 GND 测得 12 V，并已断开驱动电源。该值显著偏离预期约 5 V；尚需核对测点、稳压器接地及输入输出通断，不能直接确定稳压器内部短路或其他器件已损坏。停止带电驱动测试，建议断开 DF-MD 与 ESP32 的连接后进行断电检查；未执行额外串口动作。

断电回读：用户确认整板全部断线、断电；稳压器宽焊片 T 至中脚 C 为 0 Ω，左脚 L 至板上 GND 为 0 Ω，中脚 C 至右脚 R 为 0.9～1 Ω，交换表笔后仍相同，单位明确为 Ω。结合此前输出焊片对地 12 V，稳压通路存在异常低阻，但未隔离器件，不能区分稳压器内部故障、焊桥或板上其他路径，也不能确认下游器件是否受损。保持停止上电，后续仅断电检查输出／输入对地电阻与焊点。

用户再次确认全部线已拔除，重新报告 T-C=0、L-G=0～0.2、C-R=0.9～1、C-G=1、R-G=1。尽管此前用户说明单位为 Ω，尚未核实仪表型号、量程及屏幕显示；部分仪表单独显示 1 表示超量程，不能直接按 1 Ω 解释。此前“确认异常低阻”的表述需暂缓，先核对悬空／短接表笔显示与原始测量画面。稳压输出曾报 12 V 的异常仍待核实，整板保持断电，不进行动作或通电复测。

仪表显示澄清：用户确认 C-G、R-G 的单独 1 与表笔悬空显示一致，是超量程提示，不能记录成 1 Ω 或据此判对地短路。C-R 则显示有效数字 00.9～01.0，与悬空不同；结合此前用户确认的 Ω 单位及双向相同读数，支持输入输出之间异常低阻。T-C=0、L-G=0～0.2。原有“所有测点均约 1 Ω”的解释撤销；稳压通路故障仍是重点，但需焊桥检查或拆件隔离才能确定具体故障器件。保持整板断线、断电。
