miclle/cybertrack/docs/TODO.md

# CyberTrack 待办

2026-11-01 已取消独立泡泡剧场及 I06／I07 门槛。ct78 移除实现与入口；2026-11-03 已仅应用部署，角色同步仍待完成。历史编排成绩只作旧版本记录，不纳入当前验收。[变更与验证](validation/theatre-removal.md)

## 项目进展与下一步

截至 **2026-11-03**，源码与最近记录的面包板应用均为 **2.0.3-ct78**；5999 字符角色候选尚未同步，平台最近回读为旧 5991 字符角色。项目已从部件台架推进到整机样机、语音组合动作与模型辅助设计阶段；下面按实际证据说明成熟度。

<table>
  <thead><tr><th width="132">范围</th><th>已有结果与仍需完成的工作</th></tr></thead>
  <tbody>
    <tr><td><strong>基础互动</strong></td><td>已有语音、网页、行走、调速、喷水与泡泡的部署及分项现场反馈，另有运行影像。当前整机持续负载、定量停止与完整语音回归待验。</td></tr>
    <tr><td><strong>模型辅助设计</strong></td><td>已完成真实宿主消息触发、FreeCAD GUI 修改／保存重开／恢复和同卡片更新。支持范围是受限位置研究及符合条件的单件参数修改。</td></tr>
    <tr><td><strong>机械与电气</strong></td><td>已有整机 CAD、打印项目、BOM、A2 六页原理图与预算工具。保护器件定值、电源／温升、反复拆装及儿童使用验收仍未完成。</td></tr>
    <tr><td><strong>配套与商业探索</strong></td><td>车库试制候选、参考材料包、用户体验与成本记录工具已提供；车库新版 CAD 适配已复核，实物进出、真实用户研究、量产成本与购买意愿尚未验证。</td></tr>
  </tbody>
</table>

下一阶段沿四条主线推进：

1. **更容易上手：** 完成真人语音与家庭体验，观察第一次使用、主动重复玩法的过程。
2. **更准确地表达：** 修复冗余播报、含糊动作与状态解释；台词自动播报和表情联动作为后续体验方向。
3. **更可靠地运行：** 补齐停止、组合负载、电源、温升、续航及维护数据，再据实测收敛器件和结构。
4. **更方便地复现：** 核对打印与配套版本，积累制作、成本和工程修改记录，完善参考方案交付。

最新原 80／8 合成普通话全链路回归为严格工具 **77/80、编排 6/8**，存在模型禁止调用，未关闭语义门槛；ct73 十二条定向集 **10/12** 不替换原成绩。ct75 的历史十八组软件检查全部通过，含 124 项 Python 测试；ct78 的本地检查见退役验证；ct73 已完成仅应用部署与无动作回读，带载、真人语音及停止另验。现场观察与五次完整工程效率样本尚缺，不能从软件通过或提交次数推定完成。

[改进计划](improvement-plan.md)记录各项任务的验收条件，[交付核对表](validation/delivery-audit-current.md)逐项列出已有依据和缺口；[当前状态](current-status.md)和 [firmware/current.json](../firmware/current.json)维护版本依据。未完成项不会因文档、模拟或局部演示通过而自动关闭。

2026-11-01 用户已恢复现场配合。首轮从[ct73 部署与现场流程](validation/ct73-deployment.md)进入，先验证短动作、停止与不恢复，再补齐语音组合和负载；保持高压点火测试不在范围内。

## 当前待办

- [ ] 2026-11-01 按用户要求暂缓实机测试，优先收敛灵矽多余播报与直接动作语义。[精简角色对照](validation/concise-role.md)首轮 29/36→34/36，候选复测 32/36 且出现漏停及虚假停止回复，未采纳；原角色与参数已保存重开恢复。多余播报仍存在，原 80／8 失败、跳过的听感项和物理门槛保留。

- [x] 2026-11-01 完成 ct74 仅应用部署、ct73 回退核对、配置保持、两次启动和二十条零输出回读；角色只读核对一致。[部署与听感入口](validation/ct74-deployment.md)

- [x] 2026-11-01 完成 ct73 仅应用部署、配置保持、两次启动联网及二十条零动作回读。[部署与后续现场流程](validation/ct73-deployment.md)

按主题维护未完成的工作。I01–I13 的目标和退出条件见[产品改进计划](improvement-plan.md)，硬件资料编号 Q01–Q11 见[决策表](decisions.md)，整机验收编号见[验证计划](verification-plan.md)。

### 交互与网络

- [x] 针对 ct78 S01 明确时长偏差与 T04 停止漏调用修正角色；[两轮定向集](validation/ct78-stop-duration.md)均 16/16，原 S01／T04 复测通过。仅为合成语音与无输出主机证据，未上线。
- [ ] 收敛新角色完整回归保留的两项失败：R02“快一点”漏调 adjust_speed；R03 相同合成音频被 STT 丢失“先别执行”，导致主机接受前进。完整集 33/35 不算通过；先定位否定尾句识别稳定性，再复核调速分流。多余确认、规则旁白及“我先记下了”仍独立跟进，候选不部署。

- [x] ct78 完整移除独立剧场；[实现与验证](validation/theatre-removal.md)覆盖旧入口拒绝、直接组合／序列及停止保护。
- [x] 2026-11-03 按用户后续授权完成 [ct78 仅应用部署](validation/ct78-deployment.md)，配置保持、两次启动和二十条零输出回读通过；未同步角色。
- [ ] 收敛语音阻塞并同步新角色后，验证 ct78 实际语音的组合动作、否定／暂不执行、停止和新输入恢复。

- [x] [ct75 HTTP 零转义拒绝](validation/http-zero-admission.md)已完成原生回归、完整构建和十八组统一检查，并完成[仅应用部署与 22 次无动作协议检查](validation/ct75-deployment.md)。五类非法输入拒绝、草稿保持及合法查询／取消／空闲停止通过；畸形行走／效果请求未发往实机，不扩大覆盖。首启 NVS 的 PHY 校准与连接令牌变化已单独记录，Wi-Fi／用户设置保持。

- [ ] 修复测距滴声与语音并发的卡顿。用户实机听到两者同时出现；ct73 普通滴声曾抢占并清空语音队列。用户确认减少滴声后播报不卡，并明确选择“对话期间暂缓，结束按实时距离恢复”。[ct74 修正](validation/dialogue-range-beeps.md)已实现独立 PCM 与对话入队闸门，完整构建和音频原生通过；补齐参考包后最终十八组检查全部通过（含 124 项 Python），已完成[仅应用部署与两次零动作检查](validation/ct74-deployment.md)，第一轮用户确认空闲有滴声、监听／回复暂缓且回复不卡；结束恢复、移远不补播及再次靠近三项由用户选择跳过，本轮不再请求，不计验收通过。空旷偶发滴声尚未复现，不能据此关闭测距稳定性。

- [ ] 实机验收 ct62 的单次识别失败隔离（已随 ct73 部署）。候选已完成输入代际、失败后禁止重试／补做及排队回调隔离；八组合成边界与四条历史请求回放通过，含改稿拒绝后转用 sequence 被拦截。现另有等待真实 STT 的主机模式及事件复核，[二十条合成上行](validation/ct62-stt-host.md)完成 19 条，另一条缺少结束事件，完整回执与终态均复算一致；仍需真实设备时序及停止，新输入之后才到达的网络请求没有原话编号可关联。[软件证据与边界](validation/voice-input-guard.md)
- [ ] 实机验证 ct63 组合／序列与目标速度的成功确认播放匹配（已随 ct73 部署）。候选回放已抑制原先 216 个确认包、保留 397 个状态／否定／澄清包；30 条合成不一致均不静默。继续核验未知语法、提前旁白及实际扬声器，喷水缺结束事件不算静默通过。[匹配范围与证据](validation/plan-feedback.md)
- [ ] 在约定场地记录 5 组家庭的首次连接、停止、组合动作和主动重玩情况。用[离线观察单](../tools/family-study/observer.html)记录哪些步骤需要帮助，以及自由环节主动重复了哪个玩法。
- [ ] 收敛含糊动作、否定句的禁止调用与过程播报。ct65 停止说明对照语义 77/80、编排 6/8，V064 误停、V079 擅自前进；说明未采纳，当时恢复 ct63。补充集 11/12 不代表固定集通过；C007／C008 仍有分析播报。[完整失败与下一步](validation/stop-negation.md)；此前[回执试验](validation/compact-model-receipts.md)也保留。
- [ ] 完成真人语音回归与新表达复测。首条“你好小智，左转一秒”已有唤醒、实际左转后停止、无播报的现场反馈，原始 STT／MCP 未对齐，不替代完整二十条或三种收音条件。覆盖否定、查询、速度、时长、喷水限幅、异常回执、成功静默及禁止动作。记录冗余播报与错误恢复暗示。[联调与失败样例](validation/lingxi-ct45-role-feedback-20261031.md)
- [ ] 复测手机长按、多指、后台、缩放与断线，覆盖热点回退、两种来源争用、重连不续走及音频并行。[网络配置](wifi-configuration.md) · [网页控制](lan-control.md)

### 行走、测距与停止

- [x] 验收 [ct77 普通滴声连续确认](validation/range-beep-confirmation.md)：用户选择连续多次近距才响；已实现三样本准入，孤立／双样本跳值静音，原始前进停车不等待。已仅应用部署并完成配置保持、两次启动及二十条零输出回读；用户试听确认“偶发滴滴声明显少了，效果可以”；本轮听感改善获接受，空旷误判原因及量化误报率仍未验证。

- [ ] 排查 [ct73 首项架空行走失败](validation/ct73-deployment.md#首项现场结果未通过)：60% PWM／500 ms 前进被接受但用户确认两侧均不转，已全停；用户随后确认手机为 100% 且短按可转；相同 500 ms 请求在 100% 下复核转动并停止。低占空比原因待同条件复测，不推定电机或供电故障；BOOT 架空单路提前停止已获“立即停下、松开不恢复”反馈；完整矩阵与量化指标另验。不能将 accepted 或逻辑归零记为物理通过。

- [ ] 实机核验 ct66 即时停止回执（已随 ct73 部署）：已完成八组无设备 MCP 调度和回执分配失败测试，十三组检查通过；需实机调度、关断延迟和机械停止证据。[修复与边界](validation/stop-dispatch.md)

- [ ] 在实际地面记录不同方向和速度的转向时间、制动距离、电流与温升。复测序列中调速、分别截止、提前停止和喷水启动滞后。[动作与速度](action-sequences.md)
- [ ] 核实超声波版型、ECHO 电平、针序和装壳误差，分别在 USB／电池冷启动、无回波及阈值附近观察恢复。按 15 cm 停前进、20 cm 解锁检查实际停车与新指令要求，测量提示音和对话同时发生时的听感。
- [ ] 对照 [17 类停止场景](validation/stop-trials.md)采集现场记录。区分断网、设备检测失联、输出关断和机械停止的时刻，记录恢复观察窗口。另测失电与独立供能切断。
- [ ] 通用 C11 核心另按 [F2b 与后续固件计划](../firmware/PLAN.md)核对真实输出、调度与看门狗、认证、存储和升级恢复。

### 供电与电气

- [ ] Q01–Q06、Q10–Q11 按实际电池、升降压板、电机／L298N、面包板、超声波和 MOS 回填接口、额定条件及启动／持续电流。测同源噪声、欠压复位、负载温升，按[同工况三次流程](validation/README.md#电源续航与成本)记录续航和中断原因。[电源预算](../hardware/architecture/README.md)
- [ ] 核定主电源保护和独立切断器件、连接器针序、线径及封装。按 E01–E10 逐项关闭 A2 设计缺口后，再推进布板、DRC、制造文件回读和首板验证。[参数确认表](../hardware/schematic/parameter-confirmation.md)
- [ ] 记录 3.7 V 水枪与泡泡支路启动、截止、余液和重复性。核实点火低压接口的关断电平、复位状态与时间边界。Q09 双线圈仍缺额定、绝缘、残余储能、液体共存与 EMC 依据，A2 保持预留支路禁用装配。

### 打印、装配与维护

- [ ] 按所选排盘重切受影响盘。记录材料、耗材、耗时、修整和报废成本，试配 PP05／PP07、枪座、背包、底盖与驱动支架；复测孔、螺纹、胶固、负载及反复拆装。[装配顺序](assembly.md)
- [ ] 核对 15 根线的实际束径、插头、孔缘、弯曲及应力释放。试配面包板托盘、外接 BOOT、总开关及电池线尾，记录听音、屏幕观察、射频和手部检修空间。
- [ ] 核实电机四座、联轴器锁紧、13 mm 开口、编码器针序和带线下取路径。验证 MT3608、底盖、电源托板与本侧履带的拆装顺序。
- [ ] 实测双枪固定面、宽度、软管和接头，检查 15° 倾角下的喷水／出泡、滴液、倒流、吸程、通气、开盖抽管与电子舱隔离。选定泡泡供液容器后重验维护和满／空液稳定性。
- [x] [当前整机与车库 CAD 净空间复核](../hardware/model/container-garage/printed/current-fit/README.md)：209 件当前几何、94 个门板角度、268 个直线姿态无体积碰撞，缩窄／降低／缩短反例检出；文件内嵌机器人仍是历史快照，实物未验。
- [ ] 称量整机，试配车库铰链、门闩、拼缝及坡道，记录承载、挠度、门前缘通过性和进出表现。[车库制作候选](../hardware/model/container-garage/printed/README.md)

### 产品与交付

- [x] 将 ct75 的配置比较整理为[可复现离线工具](validation/nvs-config-review.md)：真实 SDK 二进制夹具与原快照复核，默认不放行运行时变化；不新增设备或完整效率验收。

- [ ] 与体验者核实年龄、场地、使用时长、速度及预算目标（Q07），再决定是否需要头舱或喷口自由度（Q08）。
- [ ] 按[工程记录方法](validation/engineering-log.md)积累可比较的维护、返工与设计耗时样本，结合实际体验和成本评估套件、课程及展示用途。

历史模型与固件主机成绩见[完整固件主机](validation/firmware-host.md)和[模型参数对照](validation/model-parameters.md)。这些结果不替代 ct78 的新角色回归。

[20 条合成普通话](validation/synthetic-uplink.md)均走完灵矽语音识别。[“全速”三轮对照](validation/full-speed.md)中，ct54 工具说明下六次均直接调速，成功确认与拒绝提示已分开回放。[ct55/ct56 拒绝原因对照](validation/speed-rejection.md)已完成 18 次：设备给出明确状态，ct56 仍统一说未确认成功。[ct57 返回格式对照](validation/admission-envelope.md)已完成 22 次：结构化结果组三轮均说出正确原因，实际主机拒绝提示保留、成功确认抑制。[ct61 明确时长反馈](validation/effect-feedback.md)已用十条合成语音轨迹回放：190 个匹配确认包抑制，348 个提示包保留；半秒被误改一秒的失败与三次修正复测分列。仍需真人验证三种收音条件及扬声器听感。

历史停止、状态与播放回归见 [ct48](validation/lingxi-ct48.md)、[ct49](validation/lingxi-ct49.md)、[ct51](validation/lingxi-ct51-playback.md)及[固定集](validation/lingxi-ct57-full.md)。已退役的草稿项目不再跟进；保留直接动作、停止、查询和播报问题。

[历史状态话术对照](validation/stop-role-qualifier.md)未采纳；现继续跟进直接动作的停止确认和过程播报，退役的相对改稿问题不再列为任务。

- [ ] 实机核验 [ct68 含糊动作门禁](validation/vague-action-admission.md)（已随 ct73 部署）。二十六组原生、十五组软件检查通过；二十条定向语音真实 STT 和终态均匹配，三次猜测执行被拒绝，严格调用 16/20。继续处理未知表达、词语／否定／引用归属、误调停止、过程播报和固定集回归。

- [ ] 改善误停、含糊动作和过程播报。[意图分流角色对照](validation/intent-routing-role.md)72 次完成，两组 29/36，候选仍猜半秒且停止静默 0/6，未采纳并恢复。后续诊断须明确占位输入、模拟原话和真实 STT；优先检查工具输入结构和平台播报出口，不用重复排列这段角色代替产品改进。

- [x] 文本诊断默认注入模拟识别原话，分别标识占位、模拟文本和真实 STT，避免遗漏设备语义标记。二十四条会话复核一致、严格调用 20/24；仍需修模型语义与过程播报，不将两次拦截算为模型正确。[证据](validation/capture-recognized-input.md)
- [x] 完成[原生数组步骤对照](validation/native-step-inputs.md)：两组各 80／8 条，基线 77/80、5/8，候选 75/80、4/8，全部 176 条回执／终态重放一致。候选有误停、误取消及猜测动作，未采纳；主线 ct68 和平台原角色已恢复，当前继续使用 `steps_json` 字符串。
- [x] 独立完成 [ct70 原始 JSON 准入](validation/mcp-raw-json.md)：普通／消毒器 16 组、原 SDK 字符串入口及 88 条历史请求兼容回放通过；公开工具和角色不变，完整构建及十六组软件检查通过。
- [ ] 部署后验证 ct70 原始 JSON 拒绝的设备时序、合法停止与网络恢复；已随 ct73 部署，软件回放不代替设备验收。

- [x] [ct71 否定输入保护](validation/negative-input-admission.md)：最终 46 组普通／消毒器通过，24 次真实 STT 严格 23/24、控制状态 24/24；拒绝一次空闲误停。活动停止拒绝初版因迟到／等待反例撤回，最终回执重放一致。
- [ ] 部署后验证 ct71 否定输入保护、真实输入时序与所有停止入口。运行中否定停机的误选、未知表达和可信原始语句关联继续未解决；不能用当前 STT 标记拒绝活动全停。

- [x] 完成原 80／8 语料的[真实 STT 全链路回归](validation/full-stt-ct71.md)，88 条结束并逐次重放一致；严格 77/80、6/8，失败保留。
- [x] [ct72 效果别名与模式播放匹配](validation/effect-alias-feedback.md)：原 88 条回放仅新增抑制普通点火的 64 包，超限 91 包保留；81 条不一致变体保留音频，原生别名／模式与并发时长夹具通过。
- [ ] 实机核验 ct72 的实际扬声器与设备时序（已随 ct73 部署）；继续处理 V033／V075 多查、V064 禁止调用和 C005 规则分析，不能以本地拒绝计为模型成功。

- [x] 参考包增加完整原 80／8 实际 STT 的独立离线评分，保留禁止调用、额外查询及逐字差异；附 ct72 播放摘要，80 项包内测试通过。

- [x] [协议字段／none 对照](validation/tts-protocol-observation.md)完成 8+8 条实际 STT，原参数恢复后另验停止；保留未完成、错误序列及候选漏停。
- [ ] 在模型返回与 TTS 合成之间确认可靠的最终回复出口，核对真实模型及参数转发；不得用 `action=thinking` 丢弃有效限幅提示。none 未采纳，原固定集与物理门槛保留。

- [x] 交付[模型工具轮中继本地原型](validation/llm-tool-round-relay.md)：17 项 HTTP／SSE 及两轮结果闭环测试，保留已知反例，未接入平台。
- [ ] 取得已有模型与正式 HTTPS 环境后，验证中继中的提示保留、消息完整性、工具与停止时延和原 80／8 语料；继续解决工具后最终分析、仅在工具轮出现的必要限制及思考工具历史。原型当前不具备采纳条件。

- [x] 参考包纳入中继原型、配置样例、17 项回环 HTTP／SSE 测试及未采纳反例；包内 98 项测试通过，不增加模型评分组。

- [x] [ct73 四路组合／别名播放匹配](validation/four-lane-feedback.md)：70 次匹配／87 次保留原生夹具，十二条定向实际 STT 严格 10/12，五条新增抑制 277 包；50 条不一致及原 88 条播放计数保持。
- [ ] 实机验证 ct73 真实扬声器、四路动作时序和全部停止入口；继续修复 F004 共享时长、F010 识别／漏调用及 F011 过程文字，不扩大“饭店”纠错范围。
