miclle/cybertrack/hardware/schematic/drive.kicad_sch

## KiCad design hardware/schematic/drive.kicad_sch (2026-10-26)

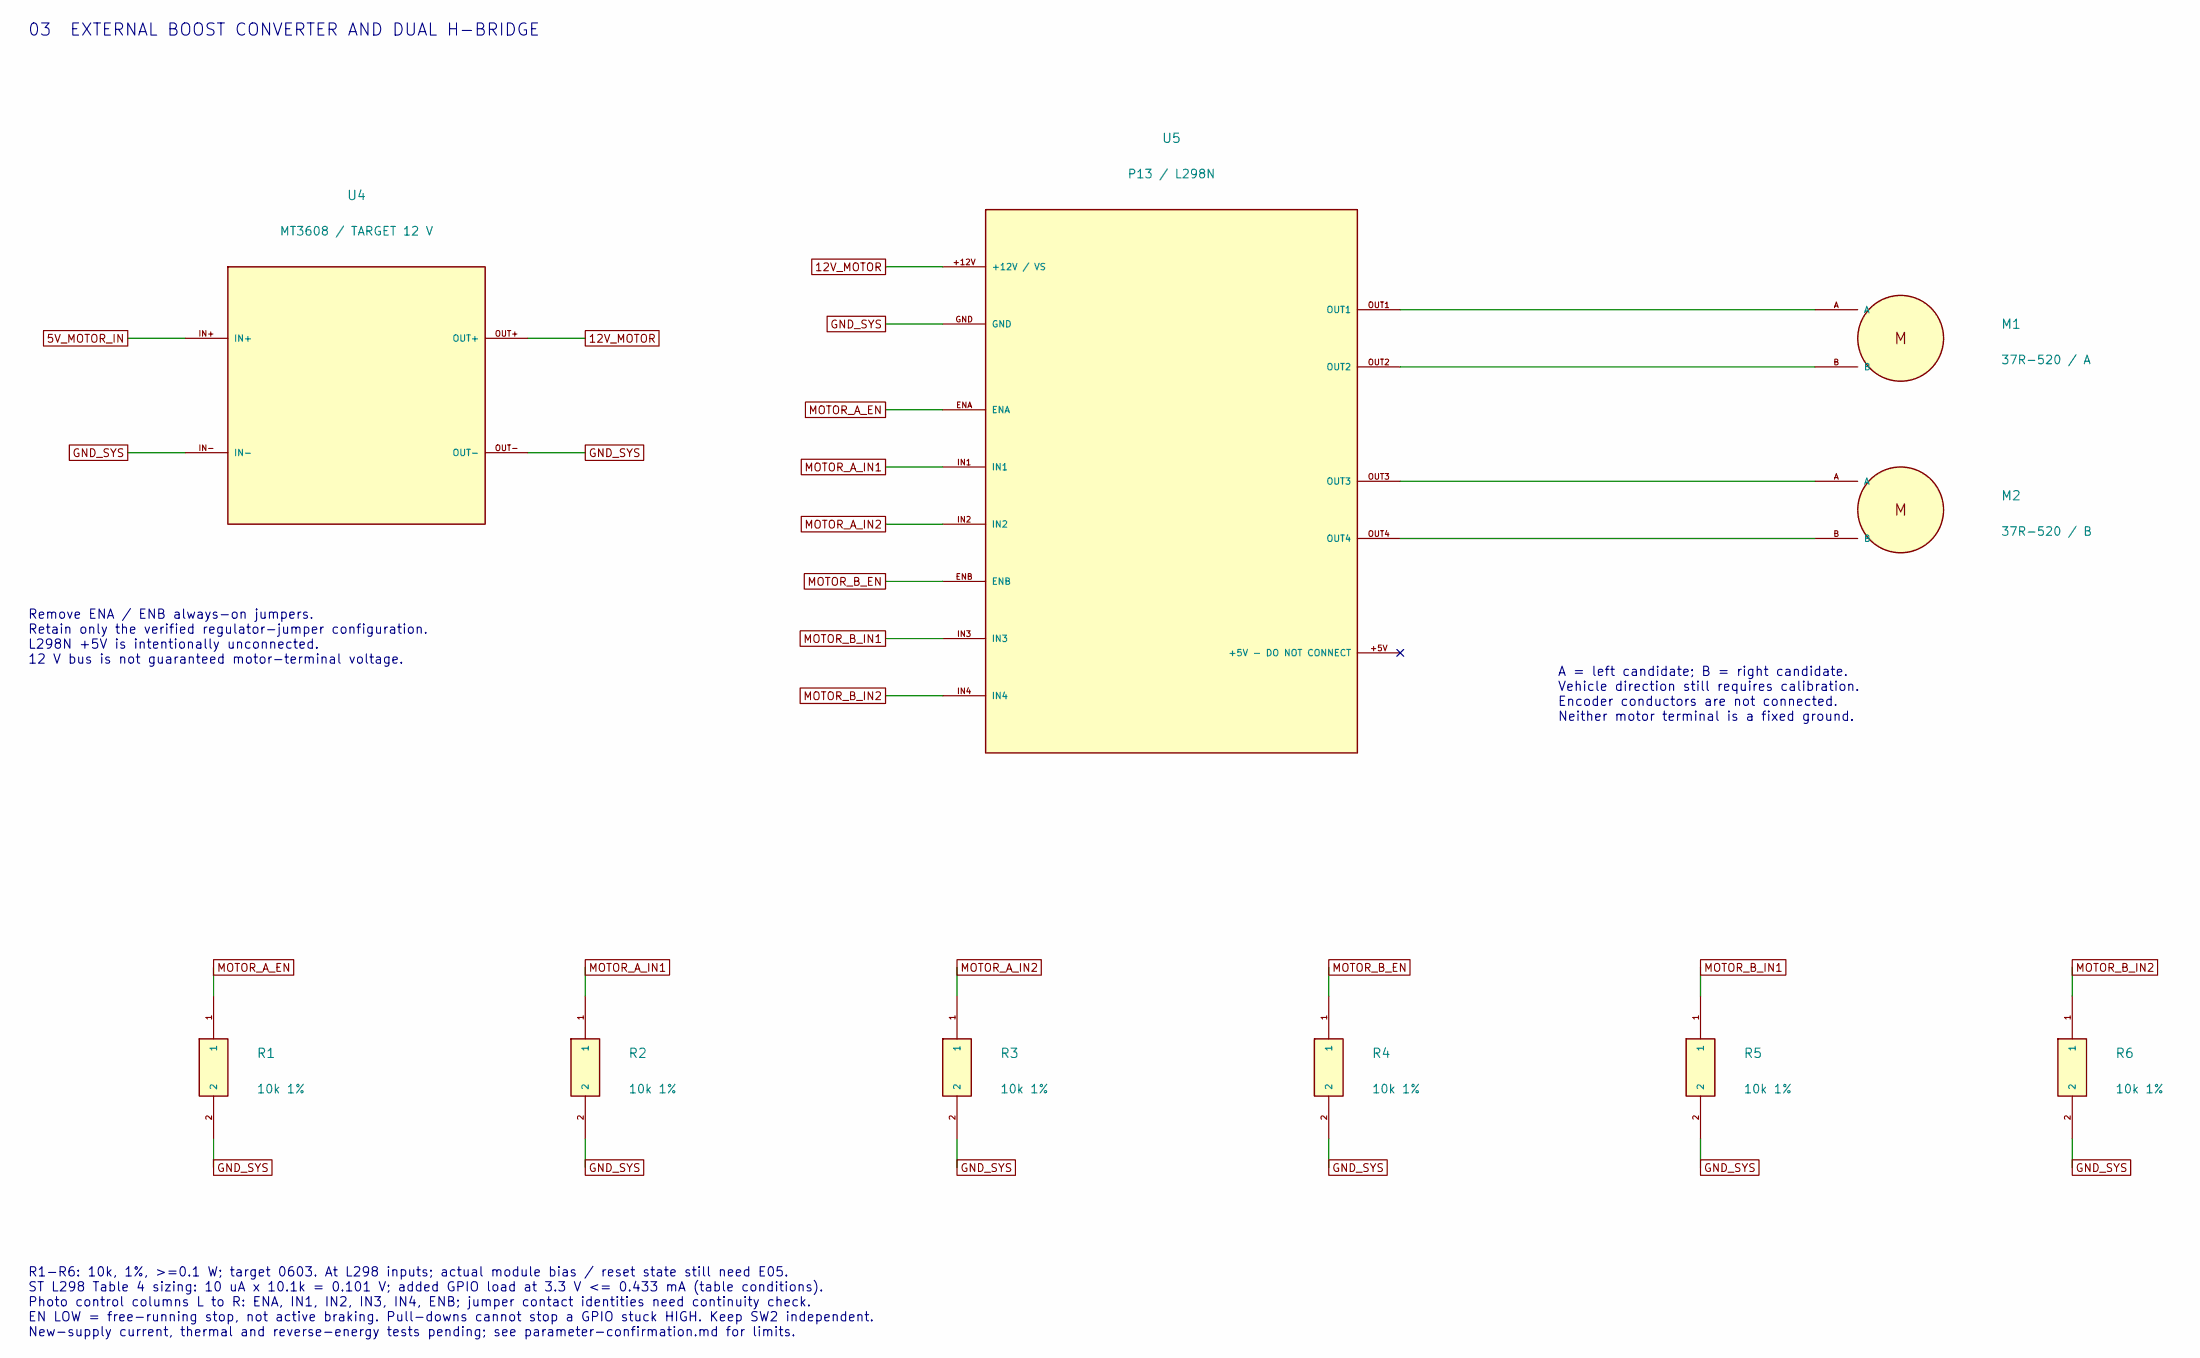
[picture p227: schematic drive.kicad_sch]

Parts:
M1: 37R-520 / A
M2: 37R-520 / B
R1, R2, R3, R4, R5, R6: 10k 1%
U4: MT3608 / TARGET 12 V
U5: P13 / L298N

Connections:
5V_MOTOR_IN: U4.IN+
12V_MOTOR: U4.OUT+, U5.+12V (+12V / VS)
GND_SYS: R1.2, R2.2, R3.2, R4.2, R5.2, R6.2, U4.IN-, U4.OUT-, U5.GND
MOTOR_A_EN: R1.1, U5.ENA
MOTOR_A_IN1: R2.1, U5.IN1
MOTOR_A_IN2: R3.1, U5.IN2
MOTOR_B_EN: R4.1, U5.ENB
MOTOR_B_IN1: R5.1, U5.IN3
MOTOR_B_IN2: R6.1, U5.IN4
unnamed: M1.A, U5.OUT1
unnamed: M1.B, U5.OUT2
unnamed: M2.A, U5.OUT3
unnamed: M2.B, U5.OUT4

Notes on the sheet:
03 EXTERNAL BOOST CONVERTER AND DUAL H-BRIDGE
Remove ENA / ENB always-on jumpers. Retain only the verified regulator-jumper configuration. L298N +5V is intentionally unconnected. 12 V bus is not guaranteed motor-terminal voltage.
A = left candidate; B = right candidate. Vehicle direction still requires calibration. Encoder conductors are not connected. Neither motor terminal is a fixed ground.
R1-R6: 10k, 1%, >=0.1 W; target 0603. At L298 inputs; actual module bias / reset state still need E05. ST L298 Table 4 sizing: 10 uA x 10.1k = 0.101 V; added GPIO load at 3.3 V <= 0.433 mA (table conditions). Photo control columns L to R: ENA, IN1, IN2, IN3, IN4, ENB; jumper contact identities need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
