miclle/cybertrack/hardware/schematic/effects.kicad_sch

## KiCad design hardware/schematic/effects.kicad_sch (2026-10-26)

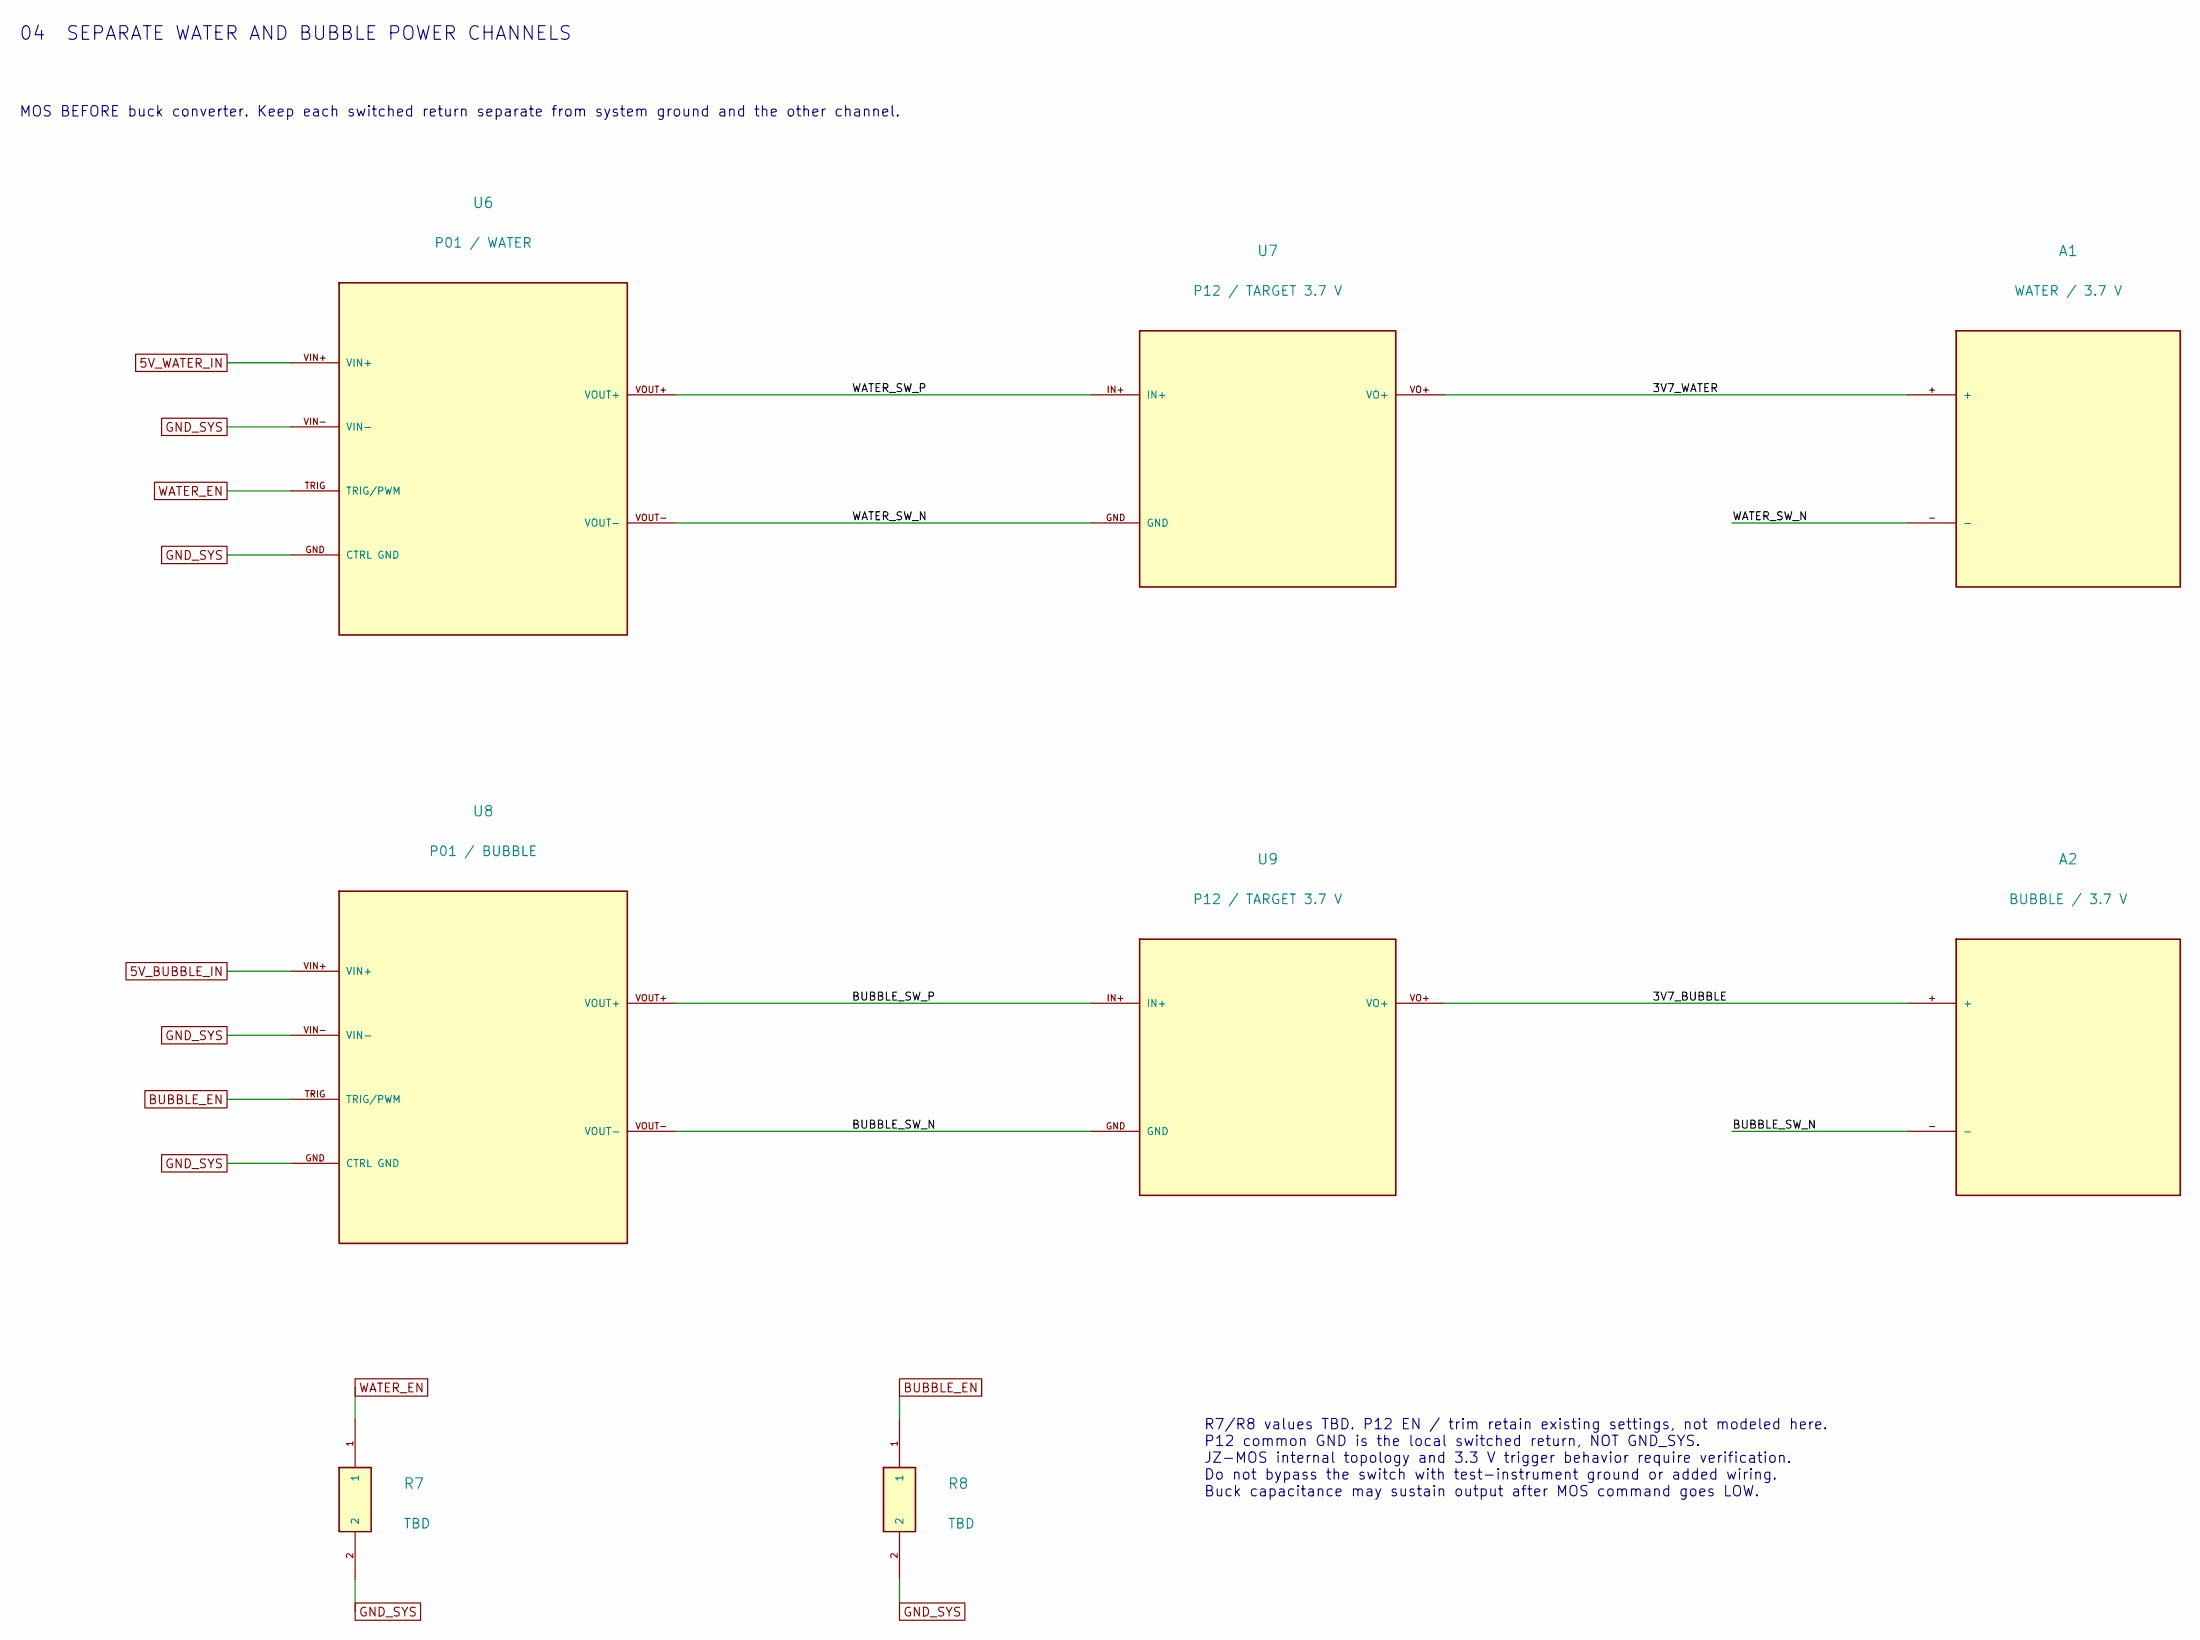
[picture p228: schematic effects.kicad_sch]

Parts:
A1: WATER / 3.7 V
A2: BUBBLE / 3.7 V
R7, R8: TBD
U6: P01 / WATER
U7, U9: P12 / TARGET 3.7 V
U8: P01 / BUBBLE

Connections:
3V7_BUBBLE: A2.+, U9.VO+
3V7_WATER: A1.+, U7.VO+
5V_BUBBLE_IN: U8.VIN+
5V_WATER_IN: U6.VIN+
BUBBLE_EN: R8.1, U8.TRIG (TRIG/PWM)
BUBBLE_SW_N: A2.-, U8.VOUT-, U9.GND
BUBBLE_SW_P: U8.VOUT+, U9.IN+
GND_SYS: R7.2, R8.2, U6.GND (CTRL GND), U6.VIN-, U8.GND (CTRL GND), U8.VIN-
WATER_EN: R7.1, U6.TRIG (TRIG/PWM)
WATER_SW_N: A1.-, U6.VOUT-, U7.GND
WATER_SW_P: U6.VOUT+, U7.IN+

Notes on the sheet:
04 SEPARATE WATER AND BUBBLE POWER CHANNELS
MOS BEFORE buck converter. Keep each switched return separate from system ground and the other channel.
R7/R8 values TBD. P12 EN / trim retain existing settings, not modeled here. P12 common GND is the local switched return, NOT GND_SYS. JZ-MOS internal topology and 3.3 V trigger behavior require verification. Do not bypass the switch with test-instrument ground or added wiring. Buck capacitance may 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
