miclle/cybertrack/scripts/capture_lingxi.py

#!/usr/bin/env python3
"""Capture real Lingxi calls against simulated receipts, without any device transport.

Requires websockets==15.0.1. Connection secrets stay in an ignored, mode-0600
file. The only network destination is the official Lingxi WSS endpoint.
"""
import argparse
import asyncio
import copy
import datetime
import hashlib
import json
import os
import subprocess
from pathlib import Path
import re
import time
import uuid

ENDPOINT = 'wss://xrobo-io.qiniuapi.com/v1/ws/'
ROOT = Path(__file__).resolve().parents[1]


def fixture(context):
    """Provide declared test preconditions, never expected calls or answers."""
    status = dict(result='ok', fault='none', state='STOPPED', boot_held=False,
                  logical_outputs=dict(left=0,right=0,water=False,bubbles=False,ignition=False),
                  starts_this_boot=0, physical_feedback=False, actuator_backend='capture_fixture',
                  sequence_active=False, sequence_result='idle', frenzy_remaining_ms=0,
                  distance=dict(valid=True,error='none',distance_mm=600,age_ms=0),
                  proximity=dict(auto_avoidance_enabled=False,forward_blocked=False),
                  recent_command=dict(valid=False,age_ms=None),
                  move_direction='none',move_speed_percent=0,web_speed_percent=100,
                  drive_hold_id=0,water_hold_id=0,bubbles_hold_id=0)
    for channel in ('move','water','bubbles','ignition'):
        status[channel+'_remaining_ms']=0
        status[channel+'_cooldown_ms']=0
        status[channel+'_source']='none'
    if '当前速度70%' in context:
        status.update(state='ACTIVE',starts_this_boot=1,move_direction='forward',move_speed_percent=70,move_remaining_ms=4000,move_source='voice')
        status['logical_outputs'].update(left=70,right=70)
    return status


def simulated_reply(status, name, args):
    """Only in-memory fixtures. No callback or device address can be supplied."""
    name=name.replace('self_tank_','self.tank.',1)
    if name=='self.tank.get_status':
        return copy.deepcopy(status)
    if name not in {'self.tank.'+n for n in ('get_status','stop','move','water','move_and_water','bubbles','ignition','frenzy','sequence','set_speed','adjust_speed')}:
        return dict(rpc_error='Unknown tool')
    result=copy.deepcopy(status)
    result['operation']=name.removeprefix('self.tank.')
    if name=='self.tank.stop':
        result.update(result='ok',fault='stopped',state='STOPPED')
        result.update(move_direction='none',move_speed_percent=0,drive_hold_id=0,water_hold_id=0,
                      bubbles_hold_id=0,frenzy_remaining_ms=0,sequence_active=False)
        if status['sequence_active']:result['sequence_result']='cancelled'
        for channel in ('move','water','bubbles','ignition'):
            result[channel+'_remaining_ms']=0
            result[channel+'_source']='none'
        result['recent_command']=dict(valid=True,operation='stop',result='ok',source='voice',age_ms=0)
        result['logical_outputs']=dict(left=0,right=0,water=False,bubbles=False,ignition=False)
    else:
        # This is a simulated acceptance used to observe the model's subsequent
        # response, never evidence that firmware accepted or executed a request.
        result['result']='accepted'
        if 'duration_ms' in args:result['last_duration_ms']=args['duration_ms']
        if name=='self.tank.frenzy':result['frenzy_last_duration_ms']=args.get('duration_ms')
    return result


def tools_page(tools, cursor=''):
    start=0 if not cursor else next(i for i,t in enumerate(tools) if t['name']==cursor)
    page=[];size=len('{"tools":[')
    for tool in tools[start:]:
        length=len((json.dumps(tool,ensure_ascii=False,separators=(',',':'))+',').encode())
        if size+length+30>8000:
            if not page:raise ValueError('tool exceeds firmware page limit')
            return dict(tools=page,nextCursor=tool['name'])
        page.append(tool);size+=length
    return dict(tools=page)


def timed_status(profile, elapsed_ms, name, args):
    """A frozen host image can evaluate a pure status read at any sampled offset."""
    if name.replace('self_tank_','self.tank.',1) != 'self.tank.get_status' or args != {}:
        raise ValueError('timed status evaluation accepts read-only queries')
    if profile not in ('forward70','short_forward70','idle') or not 0 <= elapsed_ms <= 300000:
        raise ValueError('invalid timed status input')
    call = dict(name='self.tank.get_status', arguments={}, elapsed_ms=elapsed_ms)
    output = subprocess.check_output([str(ROOT/'build/audio-host/receipt_replay'),profile],
                                     input=json.dumps([call]),text=True,timeout=10)
    receipt = json.loads(output.splitlines()[0])
    # All board identifiers in this binary are fixed stubs.
    receipt.update(actuator_backend='host_stub',source='host_firmware_replay')
    return receipt


def host_reply(executable, profile, history, name, args, elapsed_ms):
    """Re-run this conversation's valid RPC prefix from the same initial firmware state."""
    tool = name.replace('self_tank_', 'self.tank.', 1)
    allowed = ('get_status', 'set_speed')
    if tool.removeprefix('self.tank.') not in allowed:
        raise ValueError('RPC outside host replay')
    call = dict(name=tool, arguments=args, elapsed_ms=elapsed_ms)
    calls = [*history, call]
    process = subprocess.run([str(executable), profile], input=json.dumps(calls),
                             text=True, capture_output=True, timeout=10)
    if process.returncode == 3:
        raise ValueError('invalid host RPC arguments')
    process.check_returncode()
    lines = process.stdout.splitlines()
    if len(lines) != len(calls) + 1:
        raise RuntimeError('incomplete firmware replay')
    receipt = json.loads(lines[-2])  # The last line is a separate inspection read.
    history.append(call)
    return receipt


def firmware_profile(context):
    profiles = {
        '设备在线、空闲，四路关闭且不在冷却；网页未占用；距离有效且未锁定': 'corpus_idle',
        '语音来源前进正在运行，原截止尚未到；当前速度70%，在线且无故障': 'corpus_forward70',
        '当前动作或序列可能正在运行，停止无需查询前置': 'corpus_sequence',
    }
    if context not in profiles:
        raise ValueError('no firmware host profile for this precondition')
    return profiles[context]


def firmware_replay(executable, profile, calls, *, await_stt=False):
    command = [str(executable), profile]
    if await_stt: command.append('--await-stt')
    # Test-transport metadata retains escaped zero characters for the same raw
    # frame check used by the device. Historical hosts ignore this extra field;
    # actual tool names/arguments and captured histories are never rewritten.
    transport = [dict(call,raw_params=json.dumps({key:call[key] for key in ('name','arguments') if key in call},ensure_ascii=False))
                 if 'name' in call else call for call in calls]
    lines = subprocess.check_output(command,input=json.dumps(transport),text=True,timeout=10).splitlines()
    rpc_count = sum('name' in call for call in calls)
    if len(lines) != rpc_count + 1:
        raise RuntimeError('incomplete firmware dispatch replay')
    return list(map(json.loads,lines))


def protocol_observation(message):
    """Record JSON field types and bounded phase enums, never arbitrary values."""
    allowed = {'type': {'hello','stt','tts','llm','mcp','error','goodbye','notify'},
               'state': {'start','stop','sentence_start'},
               'phase': {'analysis','reasoning','tool','final','answer'},
               'stage': {'analysis','reasoning','tool','final','answer'},
               'channel': {'analysis','reasoning','final','commentary'},
               'action': {'thinking','speaking','listening','idle'},
               'role': {'assistant','tool','system','user'}}
    def shape(value):
        if value is None: return 'null'
        if type(value) is bool: return 'boolean'
        if isinstance(value, str): return 'string'
        if isinstance(value, (int,float)): return 'number'
        if isinstance(value, list): return 'array'
        if isinstance(value, dict): return 'object'
        raise ValueError('not JSON')
    def fields(obj):
        return {key:shape(value) for key,value in sorted(obj.items()) if re.fullmatch(r'[A-Za-z_][A-Za-z0-9_]{0,63}',key)}
    observed = dict(fields=fields(message), signals={key:value for key,value in message.items()
        if key in allowed and isinstance(value,str) and value in allowed[key]})
    # These are field/type observations, not evidence of provider reasoning.
    observed['nested'] = {key:fields(message[key]) for key in ('metadata','data','payload') if isinstance(message.get(key),dict)}
    return observed


async def capture_case(connection,tools,case,timeout=45):
    from websockets.asyncio.client import connect
    status=copy.deepcopy(case['fixture_status']) if 'fixture_status' in case else fixture(case['context'])
    version = case.get('fixture_version','ct46' if case.get('ct46') else 'ct45')
    host_await_input = bool(case.get('host_stt_events') or case.get('host_text_input'))
    host_input_mode = ('platform_stt_events' if case.get('host_stt_events') else
                       'simulated_recognized_text' if case.get('host_text_input') else 'simulated_initial_input')
    if case.get('host_text_input') and (case.get('host_stt_events') or case.get('opus_frames') is not None
                                      or version != 'firmware_host' or not case.get('raw_text')):
        raise ValueError('simulated recognition requires raw-text firmware host without audio/STT injection')
    row=dict(id=case['id'],calls=[],replies=[],events=[],completed=False,input_text=case['text'],context=case['context'])
    headers={'Authorization':'Bearer '+connection['token'].removeprefix('Bearer '),
             'Device-Id':connection['device_id'],'Client-Id':connection['client_id'],'Protocol-Version':'1'}
    opened = time.monotonic()
    timeline = row['timeline'] = []
    if case.get('protocol_events'): row['protocol_observations'] = []
    def mark(event, **details):
        timeline.append(dict(ms=round((time.monotonic()-opened)*1000), event=event, **details))
    followups = case.get('followups', [])
    if followups and (version != 'firmware_host' or not case.get('host_stt_events')):
        raise ValueError('followups require actual STT-gated firmware host')
    inputs = [case, *followups]
    turn_index = 0
    if followups: row['turns'] = []
    input_ms=None
    call_history=[]
    session=None;sent=False;deadline=opened+timeout;audio_bytes=0
    async with connect(ENDPOINT,additional_headers=headers,proxy=None,open_timeout=15,max_size=2**20) as ws:
        async def send(message):await ws.send(json.dumps(message,ensure_ascii=False))
        async def send_input(item):
            nonlocal input_ms, sent, deadline
            mark('input_sent')
            if input_ms is None: input_ms = timeline[-1]['ms']
            deadline = time.monotonic() + timeout
            if followups:
                row['turns'].append(dict(text=item['text'], input_ms=timeline[-1]['ms'],
                    call_start=len(row['calls']), reply_start=len(row['replies']), completed=False,
                    uplink=item['uplink']))
            if case.get('host_text_input'):
                mark('simulated_input', text=item['text'])
                call_history.append(dict(input_text=item['text'],elapsed_ms=timeline[-1]['ms']-input_ms))
            uplink = item.get('opus_frames')
            if uplink is not None:
                await send(dict(session_id=session,type='listen',state='start',mode='manual'))
                for frame in uplink:
                    await ws.send(frame)
                    await asyncio.sleep(.060)
                await send(dict(session_id=session,type='listen',state='stop'))
                mark('uplink_end')
            else:
                text=item['text'] if case.get('raw_text') else '本轮为无执行器的文本评测，以下仅是模拟前置状态，不是动作指令：'+case['context']+'。请只处理这条用户原话：'+item['text']
                await send(dict(session_id=session,type='listen',state='detect',text=text))
            sent=True;row['events'].append('test_input_sent')

        await send(dict(type='hello',version=1,transport='websocket',features={'mcp':True},audio_params=dict(format='opus',sample_rate=16000,channels=1,frame_duration=60)))
        while time.monotonic()<deadline:
            try:raw=await asyncio.wait_for(ws.recv(),min(5,max(.01,deadline-time.monotonic())))
            except asyncio.TimeoutError:continue
            if isinstance(raw,bytes):
                if not audio_bytes:mark('first_audio')
                if case.get('audio_packets'):mark('audio_packet', size=len(raw))
                audio_bytes+=len(raw)
                continue
            msg=json.loads(raw);kind=msg.get('type')
            if case.get('protocol_events'):
                row['protocol_observations'].append(dict(ms=round((time.monotonic()-opened)*1000), **protocol_observation(msg)))
            if kind=='hello':session=msg.get('session_id');row['events'].append('hello')
            elif kind=='mcp':
                payload=msg.get('payload',{});method=payload.get('method');params=payload.get('params') or {}
                row['events'].append(method)
                result=None
                rpc_error=None
                wire_reply=None
                if method=='initialize':result=dict(protocolVersion='2024-11-05',capabilities={'tools':{}},serverInfo=dict(name='CyberTrack capture only',version=version))
                elif method=='tools/list':result=tools_page(tools,params.get('cursor',''))
                elif method=='tools/call':
                    name=params['name'];args=params.get('arguments',{})
                    mark('tool_call', name=name)
                    row['calls'].append(dict(name=name,arguments=args))
                    try:
                        if name.replace('self_tank_','self.tank.',1) not in {t['name'] for t in tools}:raise ValueError('unknown tool')
                        validation = None
                        if case.get('argument_validator'):
                            validation = json.loads(subprocess.check_output([str(case['argument_validator'])],
                                input=json.dumps(dict(name=name.replace('self_tank_','self.tank.',1),arguments=args)),
                                text=True, timeout=10))
                            if type(validation.get('valid')) is not bool or not isinstance(validation.get('error'),str):
                                raise ValueError('invalid argument checker output')
                            row.setdefault('argument_checks',[]).append(dict(name=name, **validation))
                        if version == 'firmware_host':
                            if input_ms is None:raise ValueError('missing evaluation input')
                            call_history.append(dict(name=name,arguments=args,rpc_id=payload['id'],
                                elapsed_ms=timeline[-1]['ms']-input_ms))
                            wire_reply=firmware_replay(case['host_binary'],case['initial_profile'],call_history,
                                await_stt=host_await_input)[-2]
                            row.setdefault('host_rpc_replies',[]).append(wire_reply)
                            if 'error' in wire_reply:
                                receipt=dict(rpc_error=wire_reply['error']['message'])
                            else:
                                receipt=json.loads(wire_reply['result']['content'][0]['text'])
                        elif validation is not None and not validation['valid']:
                            receipt=dict(rpc_error=validation['error'])
                        elif version == 'speed_host':
                            if input_ms is None:raise ValueError('missing evaluation input')
                            receipt=host_reply(case['host_binary'],case['initial_profile'],call_history,name,args,timeline[-1]['ms']-input_ms)
                        elif version == 'timed_host':
                            if input_ms is None:raise ValueError('missing evaluation input')
                            receipt=timed_status(case['initial_motion'],timeline[-1]['ms']-input_ms,name,args)
                        else:
                            receipt=simulated_reply(status,name,args)
                        if 'rpc_error' not in receipt and (version == 'ct47' or (version == 'ct46' and name.endswith('get_status'))):
                            helper = Path(__file__).resolve().parents[1] / 'build/lingxi-schema-export/status-fixture'
                            output = subprocess.run([str(helper), version], input=json.dumps(receipt),
                                text=True, capture_output=True, check=True).stdout.strip()
                            if version == 'ct47':
                                fields = json.loads(output)
                                if name.endswith('get_status'): receipt.update(fields)
                            else: receipt['status_facts'] = output
                        if name.endswith('stop') and 'rpc_error' not in receipt:status=copy.deepcopy(receipt);status['result']='ok'
                        if 'rpc_error' in receipt and case.get('admission_result_fixture'):
                            row.setdefault('original_admission_errors',[]).append(receipt['rpc_error'])
                            receipt = dict(operation=name.removeprefix('self.tank.'), result='rejected',
                                           rejection_reason=receipt['rpc_error'], physical_feedback=False)
                        if 'rpc_error' in receipt:
                            rpc_error=dict(message=receipt['rpc_error'])
                            row.setdefault('rpc_errors',[]).append(dict(name=name, **rpc_error))
                        else:
                            row.setdefault('simulated_receipts',[]).append(receipt)
                            result=wire_reply['result'] if wire_reply is not None else {'content':[{'type':'text','text':json.dumps(receipt,ensure_ascii=False)}],'isError':False}
                    except (ValueError,KeyError,TypeError,IndexError):result={'content':[{'type':'text','text':'capture fixture rejected invalid arguments'}],'isError':True}
                if rpc_error is not None:
                    await send(dict(type='mcp',payload=dict(jsonrpc='2.0',id=payload['id'],error=rpc_error)))
                elif result is not None:
                    await send(dict(type='mcp',payload=dict(jsonrpc='2.0',id=payload['id'],result=result)))
                if method=='tools/call':
                    mark('tool_reply_sent', name=name, is_error=rpc_error is not None or result['isError'])
                if method=='tools/list' and not result.get('nextCursor') and not sent:
                    await send_input(case)
            elif kind=='tts':
                state=msg.get('state')
                if state in ('start','sentence_start','stop'):
                    mark('tts_'+state, reply_index=len(row['replies']))
                if msg.get('state')=='sentence_start':row['replies'].append(msg.get('text',''))
                if msg.get('state')=='stop' and sent:
                    complete=msg.get('is_aborted') is not True
                    if followups:
                        row['turns'][-1].update(completed=complete, end_ms=timeline[-1]['ms'],
                            call_end=len(row['calls']), reply_end=len(row['replies']))
                        row['turns'][-1]['host_state'] = firmware_replay(case['host_binary'], case['initial_profile'],
                            [*call_history, dict(inspect_ms=timeline[-1]['ms']-input_ms)], await_stt=True)[-1]
                    if not complete:
                        row['completion']='tts_aborted'
                        break
                    if turn_index + 1 < len(inputs):
                        turn_index += 1
                        await send_input(inputs[turn_index])
                        continue
                    row['completed']=True
                    break
            elif kind=='stt':
                row['echoed_text']=msg.get('text','');mark('stt', text=row['echoed_text'])
                if case.get('host_stt_events') and input_ms is not None:
                    if not isinstance(row['echoed_text'],str):raise ValueError('invalid platform STT text')
                    call_history.append(dict(input_text=row['echoed_text'],elapsed_ms=timeline[-1]['ms']-input_ms))
            elif kind in ('error','goodbye'):row['events'].append(kind);break
    if version == 'firmware_host':
        row['initial_profile']=case['initial_profile']
        row['host_input_mode']=host_input_mode
        row['host_calls']=call_history
        row['host_inspect_ms']=round((time.monotonic()-opened)*1000)-input_ms if input_ms is not None else 0
        row['host_final_state']=firmware_replay(case['host_binary'],case['initial_profile'],
            [*call_history,dict(inspect_ms=row['host_inspect_ms'])],await_stt=host_await_input)[-1]
    row['received_audio_bytes_discarded']=audio_bytes
    row.setdefault('completion','tts_stop' if row['completed'] else 'incomplete_or_timeout')
    return row


async def run(args):
    os.umask(0o077)
    if args.connection.stat().st_mode&0o077:raise ValueError('connection file must be private (0600)')
    if args.output.exists():raise ValueError('refusing to overwrite an existing capture')
    connection=json.loads(args.connection.read_text())
    tools=json.loads(args.tools.read_text())['tools']
    if len(tools)!=11 or any(not t['name'].startswith('self.tank.') for t in tools):raise ValueError('expected 11 robot-only schemas')
    cases=json.loads(args.corpus.read_text())['cases']
    if args.ids:
        requested=set(args.ids.split(','));cases=[c for c in cases if c['id'] in requested]
        if {c['id'] for c in cases}!=requested:raise ValueError('unknown case id')
    # Deliberately discard all oracle fields before entering the capture loop.
    fields=('id','text','context','fixture_status')
    timed=getattr(args,'timed_host',False)
    if timed:
        if not args.raw_text or any(c.get('initial_motion') not in ('forward70','short_forward70','idle') for c in cases):
            raise ValueError('timed host requires raw input and a known motion profile')
        fields=('id','text','context','initial_motion')
    cases=[dict({k:c[k] for k in fields if k in c}, **(
        {'followups':[{'text':item['text']} for item in c['followups']]} if c.get('followups') else {})) for c in cases]
    if any(c.get('followups') for c in cases) and not (getattr(args,'synthetic_speech',False) and getattr(args,'firmware_host',None)):
        raise ValueError('followups require synthetic speech and firmware host')
    if getattr(args, 'raw_text', False):
        for case in cases: case['raw_text']=True
    version = 'timed_host' if timed else 'ct47' if getattr(args,'ct47',False) else 'ct46' if getattr(args,'ct46',False) else 'ct45'
    speed_host=getattr(args,'speed_host',None)
    if getattr(args,'admission_result_fixture',False) and not speed_host:
        raise ValueError('admission result fixture requires speed host')
    if speed_host and not getattr(args,'synthetic_speech',False):
        raise ValueError('speed host requires synthetic speech')
    if speed_host:
        version='speed_host'
        binary=ROOT/'build/audio-host/receipt_replay'
        for case in cases:
            case.update(host_binary=binary.resolve(), initial_profile=speed_host)
    firmware_host=getattr(args,'firmware_host',None)
    if firmware_host:
        if not (getattr(args,'raw_text',False) or getattr(args,'synthetic_speech',False)):
            raise ValueError('full firmware host requires raw text or synthetic speech')
        if getattr(args,'argument_validator',None):
            raise ValueError('full firmware host includes its own validation and status facts')
        version='firmware_host'
        for case in cases:
            case.update(host_binary=firmware_host.resolve(),initial_profile=firmware_profile(case['context']))
            if getattr(args,'synthetic_speech',False):case['host_stt_events']=True
            else:case['host_text_input']=True
    for case in cases:
        case['fixture_version']=version
        if getattr(args,'argument_validator',None):
            case['argument_validator']=args.argument_validator.resolve()
        if getattr(args,'admission_result_fixture',False):
            case['admission_result_fixture']=True
        if getattr(args,'audio_packets',False): case['audio_packets']=True
        if getattr(args,'protocol_events',False): case['protocol_events']=True
    trace=dict(fixture_version=version,kind='captured_tool_calls',run_id=str(uuid.uuid4()),date=datetime.datetime.now(datetime.timezone.utc).isoformat(),model=args.model,
               model_source='visible platform configuration; no model identity in WSS response',role_sha256=hashlib.sha256(args.role.read_bytes()).hexdigest(),
               transport=ENDPOINT,tool_schema_sha256=hashlib.sha256(args.tools.read_bytes()).hexdigest(),corpus_sha256=hashlib.sha256(args.corpus.read_bytes()).hexdigest(),
               input_mode='raw_text_diagnostic' if getattr(args,'raw_text',False) else 'context_prefixed',
               capture_source_sha256=hashlib.sha256(Path(__file__).read_bytes()).hexdigest(),
               scope='Real platform calls; synthetic receipt/context fixtures; zero device forwarding; text not microphone ASR',results=[])
    trace['continue_incomplete']=getattr(args,'continue_incomplete',False)
    if getattr(args,'argument_validator',None):
        trace['argument_validator_sha256']=hashlib.sha256(args.argument_validator.read_bytes()).hexdigest()
    synthetic = getattr(args, 'synthetic_speech', False)
    if synthetic:
        if timed:
            raise ValueError('synthetic speech currently uses static isolated receipts')
        import synthetic_speech
        trace['input_mode'] = 'synthetic_opus'
        trace['synthesis_source_sha256'] = hashlib.sha256(Path(synthetic_speech.__file__).read_bytes()).hexdigest()
        trace['scope'] = 'Synthesized speech over real platform ASR; isolated fixture receipts; no microphone, speaker or device IO'
    if timed or speed_host or firmware_host:
        binary=firmware_host or ROOT/'build/audio-host/receipt_replay'
        trace['host_replay_sha256']=hashlib.sha256(binary.read_bytes()).hexdigest()
    if getattr(args,'audio_packets',False):trace['audio_packet_sizes_recorded']=True
    if getattr(args,'protocol_events',False):trace['protocol_observations_recorded']=True
    if speed_host:
        trace['initial_profile']=speed_host
    trace['admission_result_fixture']=getattr(args,'admission_result_fixture',False)
    if firmware_host:
        trace['scope']='Real platform with raw input; actual MCP dispatch, callbacks and guard on host; virtual clock, 600 mm simulated range, immediate schedule; zero board IO'
        formats=[]
        for name in ('self.tank.sequence',):
            schema=next((tool for tool in tools if tool['name']==name),{}).get('inputSchema',{}).get('properties',{})
            formats.append('native_array' if schema.get('steps',{}).get('type')=='array' else
                           'legacy_string' if schema.get('steps_json',{}).get('type')=='string' else 'unknown')
        if formats[0]=='unknown':raise ValueError('unknown or mixed step schemas')
        trace['step_argument_format']=formats[0]
        manifest_file=firmware_host.resolve().parent/'manifest.json'
        if manifest_file.exists():
            manifest=json.loads(manifest_file.read_bytes())
            if manifest.get('tool_catalog_sha256'):
                catalog=firmware_host.resolve().parent/'tool-catalog.json'
                if (hashlib.sha256(catalog.read_bytes()).hexdigest()!=manifest['tool_catalog_sha256'] or
                    json.loads(catalog.read_bytes())!=tools or
                    hashlib.sha256(firmware_host.read_bytes()).hexdigest()!=manifest['executable_sha256']):
                    raise ValueError('advertised tools differ from the frozen host catalog')
        trace['host_input_mode']='platform_stt_events' if synthetic else 'simulated_recognized_text'
        if not synthetic:
            trace['scope']='Real platform with raw text; known utterance injected as simulated recognition before actual host MCP; virtual clock/range; no ASR, microphone/speaker/board IO'
        if synthetic:
            trace['scope']='Synthesized speech over real platform ASR; observed STT events open host input generations; actual MCP dispatcher/callbacks/guard; virtual clock and 600 mm range; zero microphone/speaker/board IO'
    if speed_host:
        trace['scope']='Synthesized speech over platform ASR; timed firmware host receipts; zero device IO'
    args.output.parent.mkdir(parents=True,exist_ok=True)
    for case in cases:
        if synthetic:
            case['opus_frames'], metadata = synthetic_speech.synthesize(case['text'])
            case['uplink'] = metadata
            for item in case.get('followups', []):
                item['opus_frames'], item['uplink'] = synthetic_speech.synthesize(item['text'])
        row=await capture_case(connection,tools,case,args.timeout)
        if synthetic:
            row['uplink'] = metadata
        trace['results'].append(row);args.output.write_text(json.dumps(trace,ensure_ascii=False,indent=2)+'\n')
        print(case['id'],row['completion'],','.join(c['name'] for c in row['calls']) or '(no tools)',flush=True)
        if not row['completed'] and not trace['continue_incomplete']:
            raise RuntimeError('incomplete case; capture retained, not counted as a successful no-call result')


if __name__=='__main__':
    p=argparse.ArgumentParser(description=__doc__)
    for name in ('connection','tools','corpus','role','output'):p.add_argument('--'+name,type=Path,required=True)
    p.add_argument('--model',required=True);p.add_argument('--ids');p.add_argument('--timeout',type=float,default=45)
    p.add_argument('--continue-incomplete',action='store_true',help='Retain incomplete cases as failures and continue only to the next unrun case; never retry')
    p.add_argument('--admission-result-fixture',action='store_true',help='Experiment only: expose host admission errors as structured rejected tool results')
    p.add_argument('--argument-validator',type=Path,help='Use the prepared firmware parameter gate before any isolated receipt')
    p.add_argument('--audio-packets',action='store_true',help='Record arrival and size of every remote audio packet; discard its content')
    p.add_argument('--protocol-events',action='store_true',help='Record JSON field types and bounded stage enums only; never raw identifiers or arbitrary extra values')
    inputs=p.add_mutually_exclusive_group()
    inputs.add_argument('--synthetic-speech',action='store_true',help='Send synthesized Mandarin as Opus frames, without input text or a microphone')
    inputs.add_argument('--raw-text',action='store_true',help='Diagnostic only: omit the context prefix; not equivalent to the fixed contextual suite')
    versions=p.add_mutually_exclusive_group()
    versions.add_argument('--firmware-host',type=Path,help='Use actual MCP dispatch and guard for the fixed corpus preconditions')
    versions.add_argument('--speed-host',choices=('idle','thirty_second_forward70','voice_offline','wifi_offline'),help='Use timed firmware speed/status receipts for a synthetic utterance')
    versions.add_argument('--timed-host',action='store_true',help='Use read-only host firmware receipts at observed RPC offsets')
    versions.add_argument('--ct47', action='store_true', help='Include fault recovery in candidate receipts')
    versions.add_argument('--ct46', action='store_true', help='Use candidate status facts compiled from status_facts.h')
    args=p.parse_args()
    try:asyncio.run(run(args))
    except Exception as error:
        # Connection errors can contain headers or tokens. Keep values private.
        raise SystemExit('Capture stopped: '+type(error).__name__+'; inspect local evidence, no device requests were forwarded') from None
