miclle/cybertrack/(commit log)

2026-10-23 docs(hardware): add project bill of materials
    List required components, quantities, and open specifications alongside the procurement records.
2026-10-23 docs(hardware): restore procurement BOM link
2026-10-23 docs(hardware): add component reference assets
    Document the motor, driver, and track mount with vendor references and measured geometry records. Preserve original asset bytes and distinguish reference data from physical validation.
2026-10-23 docs(hardware): plan layout and power interfaces
    Document component constraints, power estimates and unresolved interfaces to guide physical measurements and layout work.
2026-10-23 docs(firmware): plan control and voice integration
    Define local action limits, failure handling and the proposed Linx integration before board-specific firmware implementation.
2026-10-23 docs: add iteration and verification workflow
    Add project navigation, staged milestones and a scoped documentation check record to support the next hardware iteration.
2026-10-23 feat(firmware): add offline control and transport
    Implement bounded control, MCP parsing, runtime and connection simulation before board integration. Include host regressions, allocator fault injection and verification records.
2026-10-23 feat(firmware): prevent replay after cache eviction
    Keep a bounded FIFO of original responses and retain a monotone replay filter across reconnects. Reject retired or colliding action IDs while preserving read-only queries and stop.
    Validate 163522 protocol calls, 500 recoveries and 40502 replay checks with ASan/UBSan; all eight CTest targets and the Release library build pass. Document conservative rejection rates and the nonpersistent boot boundary.
2026-10-23 docs(hardware): record power bank procurement
2026-10-23 feat(firmware): add durable replay store interface
    Add versioned dual-slot snapshots with ordered sync, readback and conservative recovery. Validate power cuts and corruption with a volatile/durable fake backend; no board storage driver is selected.
2026-10-23 docs(hardware): document ESP32-S3 board interfaces
    Archive supplied schematics and dimension references, map headers and reserved GPIOs, and record source checksums. Update procurement and board readiness while keeping physical revision and assembly checks open.
2026-10-23 feat(firmware): reject stale intent retries
    Bind commands to device-issued windows and stable intent identities. Reserve both IDs before dispatch and recheck freshness before applying outputs.
    Cover delayed ingress, changed RPC IDs, reconnect, reset and storage faults with host simulations; record capacity limits and pending authentication integration.
2026-10-23 feat(hardware): add serviceable assembly candidate
2026-10-23 docs(hardware): verify procurement sources
    Archive product-page evidence and power bank specifications, and update procurement, BOM, interface, mechanical and verification documents. Record conflicting seller data and remaining physical checks without claiming hardware acceptance.
2026-10-23 feat(firmware): verify no-load boot and PSRAM
    Add a pinned ESP-IDF board check with zero actuator capabilities. Record three physical boot and PSRAM passes, board measurements, source hashes, and remaining validation limits.
2026-10-23 feat(firmware): migrate replay history intact
    Copy both durable slots to a verified empty backend while retaining every replay bit and the session watermark. Reject stale sources, occupied targets and destructive cleanup.
    Exercise interrupted and repeated migration with host fault simulation; document capacity gains and the required offline cutover boundary.
2026-10-23 docs(hardware): add assembly and service drawings
    Add a nine-page A3 drawing pack with six orthographic views, dimensions, service details and exploded views. Keep the PDF beside the native model and include reproducible projection and PDF generation scripts.
2026-10-23 feat(firmware): anchor replay backend switches
2026-10-23 feat(firmware): enforce anchored action history
    Reserve non-reusable versions before media writes to prevent snapshot forks. Require guarded protocol attachment and verify interrupted selection, rollback, and output ordering. Synchronize the firmware plan and host validation evidence.
2026-10-23 feat(firmware): verify BOOT button stop locking
    Read the physical BOOT input through the shared input filter while all actuator capabilities remain zero. Record press, release and manual reset evidence without claiming load or power-cutoff acceptance.
2026-10-23 test(firmware): verify maintenance recovery
    Exercise repeated recovery, uncertain selection, original write interruption and post-recovery local gates. Record lossless snapshot requirements and refuse recovery when current history is unavailable.
2026-10-23 feat(hardware): add passive arc effect locations
    Preserve revision 0.10 with twin module envelopes and recessed crown
    effect housings while retaining the approved proportions and battery layout.
    Update model exports, 15 previews, the 13-page drawing pack and related
    requirements, assembly and validation records. No high-voltage wiring
    or drive implementation is included.
2026-10-23 docs: align hardware and control evidence
    Retain board inspection, ROM and no-load validation evidence alongside procurement records. Align the usage flow with session initialization and local enable requirements.
2026-10-23 feat(firmware): journal replay recovery evidence
    Persist complete history before reserving a data revision. Allocate a unique attempt epoch so failed candidates cannot be reused, and recover only evidence selected by the current anchor.
2026-10-23 test(firmware): verify logged recovery end to end
    Require anchor and log configuration at the logged protocol entry. Exercise interrupted saves and maintenance, repeated primary loss, replay rejection and output ordering; synchronize firmware plans and measured validation records.
2026-10-23 feat(hardware): add removable controller carrier
    Fit the measured ESP32-S3 envelope with candidate sockets, a removable retainer, straight USB service spaces, wiring and antenna clearance. Preserve the exterior and low battery layout.
    Synchronize native CAD, STEP, 18 views, 15-page drawings and assembly documentation. Validate saved artifacts and 13 service scenarios across 168 discrete poses; physical interfaces remain provisional.
2026-10-24 feat(firmware): seed evidence before selection
    Persist full replay evidence before initial enrollment and logged backend selection. Preserve the selected source record through interrupted target preparation and verify exact history during attachment.
    Add selection power-loss sweeps and immediate missing-primary recovery checks; retain legacy unlogged compatibility paths.
2026-10-24 feat(firmware): add redundant recovery journals
    Keep two identical current records while preparing two successor records in isolated slots. Recover only exact anchored history and reject readable conflicts without falling back to older records.
    Add explicit workspace-backed configuration and corruption, rotation, repair and selection power-loss simulations. Preserve legacy two-slot behavior.
2026-10-24 feat(firmware): add MOS water-gun bench
    Add a local ESP32-S3 one-shot bench with explicit arming,
    a five-second limit and stop handling for MOS load testing.
    Record the buck module, MOS pinout and observed water-gun
    spray and automatic stop. Keep full electrical acceptance open.
    Validate the policy with ASan/UBSan and the ESP-IDF build.
2026-10-24 feat(firmware): integrate Linx water bench
    Add device binding and WSS MCP status, stop, and locally authorized single-use water control. Keep the five-second deadline and independent BOOT stop while production action gates remain closed.
    Record host sanitizer tests, firmware build, and observed loaded auto-stop and BOOT-stop checks; keep credentials and private logs out of Git.
2026-10-24 feat(firmware): add local motor bench
2026-10-24 feat(hardware): fit water gun and service mounts
2026-10-24 feat(firmware): add audio-board voice tools
    Add status/stop tools to the pinned audio-board firmware while preserving the existing binding, audio and display. Keep all actuator capabilities disabled and avoid unsupported newlib-nano integer formatting.
    Record the XiaoD role prompt, unified intent routing and device voice validation. Include reproducible build inputs and GPIO boundaries without private backups or credentials.
2026-10-24 feat(hardware): fit elevated front gun mounts
    Move the bubble gun to the opposite front side and use a one-piece ring with a stepped bottom slot. Elevate both guns by five degrees, update supports and routes, and retain the scoped CAD and service-path evidence.
    Validation: 775 static pairs, 18 maintenance groups with 240 poses, and 102 sampled bubble-body removal poses pass. Physical fit, adhesive retention and tilted liquid operation remain unverified.
2026-10-24 docs(hardware): label exploded assembly views
    Sync the front gun layout, mount assumptions, BOM and verification boundaries. Add named leaders to the assembly, controller and gun exploded views, retain the fill-cap labels, and correct the obsolete bubble clamp fastener count.
    Validate the 20-page PDF visually, check the five exploded-view pages and 265 local documentation links, and exclude the separately committed audio-board work.
2026-10-24 feat(firmware): add audio-board water control
    Add direct five-second voice water output with BOOT stop, cooldown,
    disconnect shutdown and queued-request/replay protection. Preserve the
    existing audio, display and device binding.
    Shorten Xiao D responses and record GPIO wiring correction plus loaded
    voice and BOOT validation. Keep full electrical qualification separate.
2026-10-24 feat(firmware): support timed water up to 30s
    Accept voice-selected durations with a 30-second device limit while
    preserving BOOT stop, disconnect shutdown, cooldown and replay checks.
    Keep the original water-board entry fixed at five seconds.
    Update Xiao D instructions and record power-disconnected voice checks
    for one, seven and capped thirty seconds; loaded 30-second testing
    remains outstanding.
2026-10-24 feat: refine hardware layout and voice defaults
    Update gun mounts to adhesive retention, dual hose saddles and an
    integrated tail guide, with rearward hose routing and speaker sizing.
    Refresh CAD, drawings and audits; retain revision 0.18 fit-trial STLs.
    Refine the voice role and default explicit untimed water requests to
    one second while preserving stop rules and the 30-second limit.
2026-10-24 feat(hardware): fit measured ultrasonic probes
    Replace the front probe placeholders with 16 mm cylinders at 26 mm spacing and a provisional 10.3 mm projection from the front panel. Adjust the panel holes and status strip; refresh CAD, drawings and measurement records.
    Verify 691 static pairs and 232 service poses, with all 286 unrelated part geometries unchanged. PCB, rear components and physical fit remain unverified.
2026-10-24 feat(hardware): route suction hoses from above
    Use top-entry suction hoses for both self-priming guns and close the rear and reservoir side passages. Keep the rear armor fully mirror-symmetric.
    Sync native CAD, STEP, 36 views, the 23-page drawing pack and interface documentation. Saved-model checks cover 827 static pairs and 232 service poses; physical fluid performance remains unverified.
2026-10-24 docs(firmware): add capability and API reference
    Document current firmware variants, tool inputs and outputs, internal APIs, and validation boundaries. Add README entry links and clarify current integration status.
2026-10-25 feat(hardware): integrate chassis motor mounts
    Merge motor mounting faces into the chassis, simplify the dry bay,
    and retain the rear wet bulkhead, unified cover and drive interfaces.
    Document track-first motor removal and keep the 14 mm lateral offsets.
    Record the user-provided 11.9 mm output end with the unchanged 13 mm
    opening: 1.1 mm total and 0.55 mm centred clearance. Update drawings,
    mechanical documents, saved geometry checks and service-path evidence.
2026-10-25 feat(firmware): add L298N dual-motor bench
    Replace the DF-MD selection and wiring with L298N A/B control.
    Add explicit channel selection, bounded PWM and both-channel stop handling.
    Cover isolation, direction combinations, deadlines and injected failures.
    Record single/dual no-load runs, BOOT stop and the 60% 10-second check;
    keep current, quantitative thermal and loaded acceptance open.
2026-10-25 feat(hardware): fit low-profile twin-bottle pack
    Integrate the removable L298N carrier and two 150 mL bottle mounts.
    Lower the pack shell to 90 mm, use releasable bands, and route each
    hose to its own side so either bottle can be removed independently.
    Record supplier images and dimensions; update the CAD, 29-page drawing
    pack, service instructions, audits, and equal-scale before/after views.
    Validate 328 objects, 909 static pairs, and 16 service scenarios.
    Keep STEP as layout exchange only; physical fit and retention remain open.
2026-10-25 feat(firmware): integrate motor and water control
    Unify bounded L298N motion and water commands on the voice controller, with shared exclusion, stop handling and driver fault shutdown.
    Add host and MCP validation plus ct6 deployment and bench evidence. Keep deferred network, loaded-motion and electrical qualification explicit.
2026-10-25 feat(hardware): raise head assembly by 25 mm
    Increase bottle clearance with a rigid head lift, extended neck supports
    and an updated power cable route. Refresh CAD, drawings and mechanical docs.
    Verify 328 saved objects, 889 static pairs, 200 service poses and bottle
    removal sweeps; preserve unrelated geometry and physical validation limits.
2026-10-25 feat(firmware): allow concurrent move and spray
    Give movement and spraying independent deadlines and add an atomic combined action while preserving shared stop behavior.
    Sync the role prompt and record host checks, firmware deployment, powered concurrency tests, and final all-off status.
2026-10-25 feat(hardware): set gun elevation to 15 degrees
    Retain the approved gun angle and 25 mm head lift. Update shoulder
    supports, hoses, CAD exports, 31-page drawings and design records.
    Verify 328 saved objects, 899 static pairs and 200 service poses.
    Use exact axial bottle sweeps to avoid tilted-frame AABB false positives.
    Physical fit, spray range and manufacturing acceptance remain open.
2026-10-25 docs: document shared power and breadboard naming
    Record the shared 5 V supply wiring, photographed input pins,
    and outstanding validation. Standardize hardware references
    as breadboard while preserving historical platform names.
2026-10-25 docs: add consolidated wiring reference
2026-10-25 feat(firmware): add shared LAN and voice control
    Add automatic browser connection, held movement with elapsed time, independent timed water, live status, and stop controls. Prioritize web commands per channel while retaining voice and disconnect stopping.
    Use 200 ms restart intervals and preserve configuration during app-only flashing. Include host, browser, and no-load device verification records through ct12.
2026-10-25 docs: illustrate current and proposed wiring
2026-10-25 docs(drawings): detail assembly annotations
    Cover 309 CAD objects in a 57-page assembly review PDF, consolidate repeated sheets, and document object IDs and source boundaries.
    Publish the verified 0.41 drawing snapshot and scoped documentation only; leave concurrent CAD and generator changes outside this commit.
2026-10-25 feat(drawings): add assembly catalog generation
    Export per-object hidden-line projections and assembly metadata, add indexed assembly cards and bookmarks, and remove redundant drawing sheets.
    Integrate with the committed 0.39 drawing baseline while preserving the 0.41 catalog annotations. Keep concurrent mechanical layout changes outside this commit.
    Validate full export and PDF generation for 328 baseline objects, compare all 309 snapshot annotations, and reject stale geometry and unassigned objects.
2026-10-25 feat(hardware): record buck converter envelope
    Record the user-provided 20 x 11 x 5 mm dimensions and the saved envelope readback. Mounting holes, terminals and lead clearances remain unverified.
2026-10-25 feat(hardware): integrate serviceable module mounts
    Integrate the 100 x 85 x 36 mm breadboard tray and ultrasonic clearance, backpack body clamps, and four-point chassis electronics tray in revision 0.42. Preserve the head exterior and front slope; remove superseded previews and record candidate cleanup.
    Saved readback covers 366 objects and 1008 static pairs. Model service checks pass; clamp release is sampled, while body, tray and screw removal use continuous sweeps. Physical fit, board fastening and high-voltage integration remain unverified.
2026-10-25 docs(hardware): sync revision 0.42 assembly pack
    Update the 61-page drawing pack and its generation scripts for breadboard and ultrasonic coexistence, backpack clamps, and the chassis tray. Synchronize requirements, assembly instructions, BOM, candidate limits and cleanup records.
    Verify source and preview hashes, all page revision labels, 366 object annotations and document file links. Keep the 0.5 mm screw-head clearance and unmeasured interfaces explicit.
2026-10-25 feat(hardware): mount effect boards in chassis
    Add candidate board retainers and local wiring spaces while recessing tray fasteners to increase battery clearance. Preserve the head and exterior geometry, and record static and service checks without claiming physical fit.
2026-10-25 docs(hardware): sync revision 0.43 drawings
    Document four-board mounting, off-machine service and candidate wiring spaces. Update the 70-page assembly pack, BOM and verification records, retaining explicit clearance and physical-fit limits.
2026-10-25 docs: add 13-wire head-to-chassis diagram
2026-10-25 docs: refresh overview and LAN power notes
    Restructure the README around current capabilities, model previews and development entry points. Record LAN control and sustained-drive power validation boundaries.
2026-10-25 chore(hardware): remove superseded gun assets
    Remove the split-ring study, revision 0.18 print trials and exporter, and original bubble-gun models. Update related documentation with historical recovery references while retaining current models, measurements and photographs.
2026-10-25 chore(hardware): archive historical CAD reports
    Group 23 unchanged CAD reports under an indexed archive and update documentation links. Remove four obsolete comparison sets and their dedicated renderer while retaining reports used by current generation workflows.
2026-10-25 feat(hardware): add measured MT3608 envelope
    Place the 37 x 18 x 6 mm booster above the left motor for the L298N power branch. Add wiring budgets, scoped geometry checks and revision 0.44 drawings while preserving all 409 existing objects.
    CAD readback and service checks pass. Mounting, physical fit and thermal validation remain open.
2026-10-25 feat(hardware): add front effect lead mockups
    Place two passive lead mockups on each front chassis guard, with
    28 mm forward projection and root sleeves. Update revision 0.46
    CAD, previews, scope audits and related requirements.
    Validate saved geometry, static overlaps and existing service paths.
    Keep electrical integration unverified, STEP for layout exchange
    and the unchanged revision 0.44 PDF explicitly marked as outdated.
2026-10-25 feat(firmware): add bubble and ignition controls
    Add independent web and voice control for bubbles and paired ignition
    modules alongside movement and water. Limit both effects to five seconds
    and require a three-second interval after ignition stops.
    Cover concurrent expiry, source isolation, stop paths and driver faults.
    Document candidate pins and verification; deployment, platform prompt
    sync and wiring diagram updates remain pending.
2026-10-25 feat(hardware): add measured battery envelope
    Record the replacement 116 x 70.5 x 19.5 mm battery, original photo, independent CAD envelope and readback checks.
2026-10-25 feat(hardware): refine chassis wiring and mounts
    Integrate the replacement battery, inboard front ignition routes and shared P01 MOS carrier. Keep route volumes visible and extend both open side frames rearward by 30 mm.
    Update revision 0.49 models, views, documentation and CAD audits. Native geometry remains authoritative; STEP equivalence and physical acceptance are not established.
2026-10-25 feat(hardware): integrate ignition module pockets
    Merge the lower cups and complete guide rings into the twin-bottle backpack, preserving the band silhouette while removing the top stops and split-clamp hardware.
    Update revision 0.50 CAD, previews and documentation. Native readback, 1,076 static pairs and service checks pass; STEP remains for layout exchange and physical retention is unverified.
2026-10-25 feat(firmware): improve mobile effect controls
    Add independent held water and bubble controls with expiring leases and shared duration presets. Fit phone viewports, expose three ignition buttons, and separate the all-stop control.
    Update role guidance and retain ct13-ct16 build, host-test, and USB-only bench evidence; powered-load acceptance remains pending.
2026-10-25 feat(firmware): add bounded frenzy mode
    Add web and voice frenzy controls capped at 30 seconds, with equal elapsed ignition cooldowns and source-aware cancellation. Refresh web activity notices when actions finish.
    Record ct17-ct19 builds, host and browser checks, role synchronization, and application-only deployments. Spoken and powered-load acceptance remains pending.
2026-10-25 feat(hardware): consolidate and organize parts
    Combine 58 source features into six printable candidates while preserving the overall appearance and service boundaries.
    Archive editable inputs and hidden check spaces, flatten the delivery tree, normalize labels, and order nearby assemblies from top to bottom. Include native CAD, print exports, documentation, and readback evidence.
2026-10-25 feat(hardware): add external power switch
    Fit the measured slide switch to the central foredeck using
    an external opening and two top-access self-tapping screws.
    Update component evidence, native assembly, previews and CAD
    fit/service checks. Keep physical fit and electrical ratings open.
    Avoid redundant Boolean readback for display-mesh-only changes.
2026-10-26 feat(hardware): add external BOOT button layout
    Replace the shoulder placeholder with an integrated candidate seat and route the GPIO0/GND pair into the head compartment. Update the CAD exports, views, BOM and installation notes.
    Validate 1094 static pairs, service paths and scoped geometry changes. Button dimensions remain provisional; native FCStd remains authoritative and physical/electrical acceptance is pending.
2026-10-26 feat(hardware): add editable schematic and checks
    Retain the existing ESP32-S3 board and document the actuator-only power cut. Add five KiCad sheets, matching PDF, design inputs and outstanding measurements, with ERC and netlist checks.
2026-10-26 feat(hardware): adjust PP02 ring cradle
    Revise the eccentric 32 mm bore, bottom notch and wider foot, and remove the two selected walls. Sync native models, exports, previews and documentation.
    Solid and export checks pass; retain the documented gun-shell interference and unverified assembly fit.
2026-10-26 docs(hardware): refresh assembly drawing pack
    Rebuild all views and object cards from the current native model, including merged print parts, the replacement battery, power switch, BOOT button and revised PP02.
    Verify 69 pages, 260 cards covering 422 objects, bookmarks and index links. Preserve the documented PP02 fit conflict and unverified service paths.
2026-10-26 feat(hardware): widen 15-wire passage to 10 mm
    Update grommets, neck bridge and head routing with native models, PP06 exports, wiring diagram and scoped clearance evidence. Preserve the existing PP02 fit conflict and unrelated work.
2026-10-26 feat(hardware): update bubble tail and drawings
    Set the tail shell to 35.9 mm while retaining the 6.8 mm bottom tab,
    mounting position, and original component assets. Update native CAD, STEP,
    measurement records, and scoped geometry audits.
    Restore native part colors and transparency in the 69-page assembly PDF.
    Verify saved geometry, export checks, document coverage, and navigation;
    retain the existing PP02 fit conflict and unverified removal paths.
2026-10-26 feat(hardware): deliver six-plate print package
    Prepare the complete 34-part PLA set from measured motor and L298N clearances, with consolidated head and exterior parts and repaired cradle, lid and carrier geometry.
    Preserve the first five plates, add the remaining parts on plate six, and remove the two unwanted cable grommets. Retain CAD, slice and inventory evidence while cleaning redundant local print intermediates.
    Validate the release inventory, cached G-code hashes, existing plate preservation and 56 sampled sections; check Python syntax and documentation links.
2026-10-26 fix(firmware): raise motor PWM to 80 percent
    Increase fixed drive duty from 154 to 204 after slow-motion feedback.
    Align logical outputs, tool text, tests and ct20 deployment records.
    Host regression and ESP-IDF build passed; application-only flashing
    preserved configuration and verified startup with final outputs off.
    Physical speed and load validation remain open.
2026-10-26 perf(hardware): simplify print parts and archives
    Remove gun buck mounts and five retainers, reduce MOS carriers, and deliver the validated 29-part print package. Preserve the user's renamed Ready layout separately from the immutable slicing baseline and remove obsolete exports and backups.
2026-10-26 fix(firmware): correct reversed chassis turns
    Map left track to bridge B and right track to A while preserving forward polarity and motor duty. Record ct21 regression checks, application-only deployment, and user-confirmed four-direction operation.
2026-10-26 docs: showcase prototype video and build photos
    Organize fabrication photos and original videos with a checksum manifest. Embed the six-minute demo as a playable GitHub attachment in the project README.
2026-10-26 docs: add inline build and prototype galleries
    Show six representative photos on the project homepage and all 33 photos with both playable videos in the artifact README. Use linked lightweight previews and an H.264 bench-video attachment while preserving original media.
2026-10-26 docs: update prototype integration status
    Reflect the assembled prototype, ground-running footage and recorded ct21 direction feedback. Retain open mechanical, power, stopping and fault validation items.
2026-10-26 docs: refresh README build and assembly guidance
    Point printing guidance to the current 29-part Lean project and clarify historical CAD and assembly references. Align firmware guidance with ct21 while retaining outstanding physical and electrical validation.
2026-10-26 docs: sync model and print assembly status
    Point model and print guides to the 29-part Lean project and prototype validation stage. Mark earlier layouts, slicing projects and assembly drawings as historical while retaining unverified physical checks.
2026-10-26 docs: sync prototype progress and open checks
    Update TODO, requirements and decisions with print delivery, basic assembly and observed prototype operation. Label superseded layouts and print stages as historical while preserving physical acceptance targets and open checks.
2026-10-26 docs: update prototype verification progress
    Record print delivery, basic assembly and observed prototype operation separately from full-system acceptance. Preserve phase exit criteria and required evidence while marking superseded layouts and test records as historical.
2026-10-26 docs: sync firmware deployment and validation
    Update firmware entry points with ct21 deployment, bench evidence and prototype progress. Separate historical results and generic core work from pending whole-system acceptance.
2026-10-26 docs: refresh firmware capabilities and history
    Document ct21 tools, deployment and prototype evidence. Mark superseded interfaces and validation records as historical while retaining open hardware and fault checks.
2026-10-26 docs: refresh LAN and effects control status
    Align current controls and HTTP interfaces with ct21. Preserve historical deployment evidence and outstanding physical acceptance checks.
2026-10-26 fix(cad): restore colors and assembly visibility
    Restore missing GUI appearance without changing the original document or geometry data. Add four current model views to the README with source and image checksums.
2026-10-26 docs: sync power and wiring baselines
    Align power and wiring records with the CK battery, ct21 deployment and A1 design. Mark legacy diagrams and bench results as historical while retaining open electrical and full-system verification items.
2026-10-26 docs: sync BOM and procurement status
    Align the BOM and procurement records with the current battery, prototype parts and A1 design. Preserve historical selections and distinguish physical evidence from unknown orders and pending acceptance.
2026-10-26 docs: sync motor and MOS bench status
    Separate current breadboard wiring and prototype progress from legacy bench procedures. Preserve original observations and keep power, fault-stop and full-system acceptance gaps open.
2026-10-26 docs: refresh audio and related validation status
    Align audio, integration and board docs with ct21 deployment and prototype evidence. Mark earlier firmware and wiring as history while retaining unverified acceptance items.
2026-10-27 feat(cad): add compact container garage
    Add a 298 x 280 x 270 mm garage with a drop-down ramp and an independent robot snapshot. Include appearance references, pose macros and reproducible geometry generation.
    Record 94 door-angle checks, 272 entry/exit poses, negative controls and saved-model readback. Synchronize requirements, decisions, BOM and remaining physical validation tasks.
2026-10-27 feat(cad): detail printable container garage
    Split the compact garage into 11 printed parts for a 256 mm build volume, with integrated joints, hinges and a manual latch.
    Include FreeCAD and STL files, slicing projects, fabrication instructions and saved geometry checks. Physical load and fit validation remain pending.
2026-10-28 fix(cad): revise backpack and print layout
    Remove the bubble bottle assembly and enlarge both coil bores to 35 mm. Preserve CAD visibility and synchronize native models, exports and print projects.
    Place the Ready backpack upright on a dedicated seventh plate. Include migration scripts, saved-artifact checks and slice comparison evidence.
2026-10-28 feat(firmware): add timed action sequences
    Honor requested movement durations, raise motor PWM to 230/255, and schedule concurrent lanes across ordered steps with cancellation.
    Add GPIO18 pad diagnostics and regression coverage; retain the regular web controls in ct25.
2026-10-28 docs: sync action prompts and field validation
    Document ordered and simultaneous voice commands, ct22-ct25 deployments, and the observed independent deadlines and sequence cancellation.
    Keep startup lag and electrical acceptance open; record removal of the temporary web test button.
2026-10-28 chore(cad): save updated six-plate project
    Preserve the local Ready 3MF model and print configuration changes separately from firmware work. Archive and XML/JSON structure checks pass; no new print or physical acceptance is claimed.
2026-10-29 feat(firmware): add live motor speed control
    Default movement to full PWM with a 60–100% range. Support web slider updates, absolute voice targets and 10-point adjustments without changing direction, deadlines or hold leases.
    Validate speed boundaries, stale requests, source isolation and output faults in host, MCP, HTTP and browser tests.
2026-10-29 fix(tools): report serial observer disconnects
    Write a filtered disconnect event when USB disappears so a frozen log is not mistaken for a live observer. Keep reconnection explicit.
2026-10-29 feat(firmware): add ranging and compact controls
    Expose head ultrasonic distance through status, voice queries and the
    control page, with freshness checks and no automatic obstacle avoidance.
    Refine range display, responsive spacing, speed labels and the fixed stop
    bar; record ct28-ct32 validation, deployment and user acceptance.
2026-10-29 feat(firmware): add proximity voice and stop guard
    Warn below 50 cm and stop or block forward motion below 30 cm across voice, web and sequences. Require a fresh command after clearance returns.
    Include local speech assets, regression tests, role updates and ct33 deployment evidence; retain pending physical validation.
2026-10-29 fix(firmware): recover ultrasonic cold starts
    Keep the ranging task alive after setup or capture failures, with startup settling, bounded retry backoff and driver diagnostics. Preserve receiver resources when cleanup fails.
    Add fault-injection coverage and ct34 deployment evidence. Record successful repeated cold starts with USB and battery power reported by the user.
2026-10-30 feat(firmware): add radar tones and 15 cm stop
    Replace repeated proximity speech with forward-only radar tones and a one-shot stop tone. Stop below 15 cm and release at 20 cm without automatically resuming motion.
    Cover tone cadence, cancellation, queue expiry and threshold boundaries. Synchronize role instructions and record ct35/ct36 deployment checks plus user acceptance.
2026-10-30 feat(wifi): add ordered network configuration
    Import private Wi-Fi profiles once and connect in saved order, including directed attempts for hidden networks. Record phone-hotspot success, failure fallback, and the remaining intermittent authentication timeout.
    Validate with generated NVS and exported station tests, ESP-IDF builds, device readback, and three final connection trials. Keep credentials and firmware artifacts untracked.
2026-10-30 fix(cad): sync Ready snapshot audit
    Refresh the saved 27-part, six-plate snapshot hash, inventory and documentation while retaining the previous audit. Check plate membership, part counts and archive integrity; record geometry and process comparisons without changing CAD or 3MF files.
2026-10-30 fix(audit): reconcile current evidence and docs
    Correct current Lean and Ready inventory references while preserving dated print history. Add reproducible L298N export and A1 source rechecks without rewriting the original JSON audits or design assets.
    Validate current file hashes, STL counts and bounds, 92 netlist/source assertions, print inventory and changed documentation links. Keep slicing, ERC, PDF review and physical acceptance scoped to their recorded evidence.
2026-10-30 fix(schematic): add ultrasonic interface
    Add controller 3V3, GPIO1 TRIG and GPIO2 ECHO on A2 sheet 6, and synchronize the current motor-side annotation and documentation.
    Preserve A1 history and record fresh six-page exports, zero ERC violations, 112 connectivity checks and five regression tests.
2026-10-30 feat(display): show LAN address on idle OLED
    Keep the current IP and web port visible while idle, restore chat during conversation, and clear stale addresses on disconnect.
    Preserve saved Wi-Fi order without reseeding configuration. Add host regressions and record ct40 build, deployment, configuration retention, and user phone/screen acceptance.
2026-10-30 feat(control): add optional obstacle stopping
    Add a default-off web switch shared by web and voice movement, with request validation and regression coverage.
    Record ct41 deployment and role synchronization with preserved user settings, and show the live control page in README.
2026-10-30 fix(audio): decouple proximity beeps from motion
    Drive proximity beeps from valid distance independently of movement and the automatic obstacle-stop switch. Preserve protected forward stopping and its priority alert.
    Update regression coverage, role guidance, and ct42 validation and deployment records.
2026-10-30 docs: frame Lingxi robot solution delivery
2026-10-30 feat: integrate pinned SolidCue native CAD workflow
2026-10-30 feat: document hardware architecture and power budget
2026-10-30 feat: package Lingxi solution reference materials
2026-10-30 feat: explain device receipts without retrying
2026-10-31 feat: add whole-model design studies
    Bundle the model design tool with native assembly previews, versioned placement edits and verified restoration. Preserve upstream attribution and isolate studies from production CAD.
2026-10-31 docs: show whole-model design workflow
    Show real assembly adjustment screenshots in the README and record native save-readback evidence. Keep local UI validation separate from pending desktop host message acceptance.
2026-10-31 fix: preserve CAD snapshot material order
2026-10-31 docs: complete message-driven CAD acceptance
2026-10-31 docs: save Cad Comments sidebar screenshot
2026-10-31 docs: add software and hardware architecture
    Explain device control and power domains with README diagrams. Align linked architecture notes with the current composition tools and CAD workflow.
2026-10-31 docs: showcase robot capabilities and use cases
    Explain how to play, build, and adapt CyberTrack from the README. Align the linked control guides with the recorded deployment and distinguish prototype evidence from future applications.
2026-10-31 docs: consolidate project guides and move TODO
    Group current assembly, control, and validation guidance by task. Preserve links to historical evidence and collect next steps in docs/TODO.md.
2026-10-31 chore(cad): remove superseded model exports
    Retire obsolete print layouts and part exports. Document how to recover historical inputs and locate the current Ready and Lean projects.
2026-10-31 docs: illustrate CAD comments and edit history
2026-10-31 test(voice): trace tool receipts and remote speech timing
2026-10-31 feat(voice): explain device state from bounded receipt facts
2026-10-31 feat(voice): expose draft limits and fault recovery in device receipts
2026-10-31 fix(voice): qualify remaining time by the status sample instant
2026-10-31 test(voice): publish paired evaluations of status sample timing
2026-10-31 feat(cost): estimate material and machine time from current Lean plates
2026-10-31 feat(power): summarize comparable observed runtime trials
2026-10-31 feat(cost): separate receipted prototype costs from quote scenarios
2026-10-31 fix(voice): answer the requested motion status without an unsolicited timer
2026-10-31 test(voice): exercise direction queries and distinguish web holds from timers
2026-10-31 docs(voice): verify revised role on the platform and restarted ct45 board
2026-10-31 test(voice): compare renewable and fixed timers across three platform trials
2026-10-31 fix(validation): separate field maintenance timings from CAD trials
2026-10-31 feat(web): show the revised device draft before loading it
2026-10-31 fix(voice): ground speed refusals in device errors
2026-10-31 docs: reconcile current improvement acceptance gates
2026-10-31 test(lingxi): verify eighty actual firmware traces
2026-10-31 test(lingxi): reject low temperature tuning
2026-10-31 fix(control): block retries after input failure
    Bind robot MCP requests to recognized input generations and invalidate pending work after failures. Keep stop and status available, preserve RPC replay protection, and verify archived fallback requests without board IO.
2026-10-31 test(lingxi): gate speech host on observed STT
    Start synthesized-speech host sessions without a simulated input. Replay observed STT events with actual MCP requests and verify every returned receipt and final state without board IO.
2026-10-31 feat(reference): include plan playback evidence
    Ship ct63 build and playback evidence while preserving recorded speech scores. Refuse bundles that omit the declared current candidate build record.
2026-10-31 feat(validation): retain incomplete batch cases
    Allow explicit continuation to the next unrun case while keeping incomplete sessions unchanged and scored as failures. Preserve default fail-fast behavior and never retry captured cases.
2026-10-31 test(lingxi): reject compact receipt regression
    Retain the eight-session failure and exact diagnostic source patch, restore ct63 control code, and replay the unadopted result separately in reference materials. Keep payload savings distinct from semantic acceptance.
2026-10-31 fix(control): reject vague first action guesses
    Use observed STT to reject generic actuator and speed guesses while preserving draft editing, explicit commands, stop and trusted web control. Retain native contrasts and twenty platform ASR sessions, including model failures; keep the candidate unflashed.
2026-10-31 test(lingxi): retain intent routing role trial
    Reject the role change after seventy-two text sessions show no tool accuracy gain and an unauthorized duration edit. Preserve complete traces, speech review and exact platform restoration; distinguish placeholder host input from STT guard coverage.
2026-10-31 docs(solution): include capture input provenance
    Ship the three input modes, targeted text results and provenance tests without overwriting existing model scores. Verify the reference archive independently and keep device, ASR and physical acceptance boundaries explicit.
2026-10-31 test(mcp): distinguish step wire contracts
    Attest advertised step schemas and reject wire-format mismatches before semantic score normalization. Preserve raw zero escapes in local host transport metadata and project only generated intent fixtures; existing captured wire data remains unchanged.
2026-10-31 feat(tools): prototype tool-round speech relay
2026-10-31 docs(solution): include local relay prototype
2026-10-31 docs(delivery): reconcile current acceptance gaps
2026-11-01 docs(firmware): record ct73 device deployment
2026-11-01 docs(validation): clarify audio field checks
    Align current summaries with ct73 field observations and ct74 software evidence. Define the pending no-motion listening sequence without claiming physical acceptance.
2026-11-01 docs(firmware): record ct74 device deployment
    Record application-only flash, verified ct73 rollback, configuration preservation and two no-action startup checks. Link current metadata and reference materials to the deployed image; keep listening acceptance separate.
2026-11-01 docs(validation): record device draft checks
    Capture single-web draft editing, stale-request rejection and owner-expiry behavior with zero starts. Preserve runtime-version attribution limits and keep performance and physical acceptance separate.
2026-11-01 test(cad): verify current robot garage clearance
2026-11-01 docs: add latest prototype demo video
    Archive the latest demo with its original checksum and link it before the earlier video in the README.
2026-11-01 fix(audio): filter transient range beeps
    Require three distinct near samples before ordinary beeps while keeping obstacle stops immediate. Record ct77 deployment checks and accepted listening feedback.
2026-11-01 chore(cad): reference external SolidCue source
    Keep SolidCue source in its own repository and use a pinned, ignored checkout.
    Preserve screenshots and historical evidence; isolate external-version data.
2026-11-01 chore(cad): pin migrated SolidCue 0.9.3
    Reference the independent assembly-study implementation and document migration tests, legacy compatibility and desktop acceptance limits. Keep source code and source tests outside CyberTrack history.
2026-11-04 docs: show both prototype demos in README
